never-die-cold/FPGA-Alittle-Design/data/logs/2026-10-09-collaboration-summary/README.md

# 2026-10-09 分模块协作记录来源与分支转移证据

- Codex来源：VS Code会话 `01a0bf1a-b25d-7093-a8ac-23aaf2c22a47`，项目cwd为本WSL仓库；当日模型元数据为gpt-6.1-sol。
- OpenCode来源：只读查询Windows `opencode.db` 的project／session／message／part，仅选择本项目会话，不复制数据库或auth。
- OpenCode原会话最后更新2026-10-06T12:36:33.449Z；[10条文本摘录](opencode-project-session.json)是Git使用讨论，不是本日RTL实现。
- [Codex理解题完整原答](codex-understanding-answers.json)包含已纠正的旧答；最终判定以SoC协作记录为准。
- 两份摘录的SHA256位于同名 `.sha256`；指纹针对归档文本，不承诺仍在更新的原始数据库／会话文件不变。
- [转移前状态](pre-switch-status.txt)、[读取HEAD](pre-switch-head.txt)、[WIP内容指纹](wip-file-hashes.json)、[恢复核对](branch-transfer.log)：191个原WIP文件恢复一致。
- 分支操作：stash -u→switch已有dev/rtl→merge --ff-only main→stash apply；main未改，未新建分支。
- 本地dev/rtl携带main已合入团队历史；原收口报告的main／未提交描述为前一阶段历史快照，不冒充当前分支状态。
- 本次用户另行授权本地提交代码＋记录；不自动push，上传见[指南](../../../docs/upload-rtl-code-and-logs.md)。
- 审核／验证结果追加到此目录；本次新增内容为文档与来源记录，未改变此前验证的RTL／tb／hex。
- [暂存区首次检查](staged-whitespace-first-check.json)发现两份raw diff空白上下文；[改名映射](diff-archive-renames.json)保留SHA，仅改为已有空白规则支持的.patch，不改.gitattributes或历史内容。
- [提交前验证](pre-commit-validation.json)：44项输入不变、all／arch证据保留、静态编译与语法exit=0、暂存区／工作区diff检查零输出；Windows待验证。
