never-die-cold/FPGA-Alittle-Design/report/llm_log/2026-10-20-cop-sim-driver.md

# 2026-10-20 COP_SIM PS 驱动、服务接入与异常矩阵

## 任务

用户本轮分工：WC 负责把计算能力接到服务和 EXE；先与 JL 对齐“怎么提交、怎么知道完成、
怎么拿结果、出错怎么恢复”；硬件未就绪时用模拟硬件跑通软件流程；确保超时、重复请求、
旧结果、运行失败不会在 UI 上显示成 CHECK_PASS；完成一轮服务+EXE 的展示/保存/追溯。

## 主要决策

1. **不另造协议**：PS 使用档只冻结 C03 §4/§5 的用法，寄存器语义、权限和固件判定
   仍以 C03 与 `cop_work_order.h` 为准；模拟硬件按 J04 读 0 的 VERSION/CAPABILITY/
   ERROR_CODE 建模（OPEN-9），不臆造错误码。
2. **模拟硬件的 seam**：驱动只依赖 `read32/write32` + DMA 面；`CopSim`/`SimDmaPlane`
   只用于离板。真实 `PynqDmaPlane` 故意 `NotImplementedError`，避免把占位实现说成已接入。
3. **安全闸**：结果必须通过 `RESULT_SEQ` 递增、索引窗双读、`FW_DECISION` 复算；
   PS verdict 严格度必须 ≥ 固件，计数必须相等。旧的 sticky 结果、不递增的 seq、
   更宽松的 PS 判定都直接 503，不生成报文。
4. **touch_border 是 PS 侧更严格 gate**：J04 固件 `cop_judge` 不读描述符；PS 仍提交
   border 目标，但在最终判定加 `touches_border`，并把它作为“允许 PS 更严格”的唯一理由。
5. **预启动门本地短路**：`ROI_COUNT=0`（OPEN-11）与 >10 不提交，避免固件只写
   `FW_DECISION` 而不置 DONE 导致的等待歧义；同时把“固件缺完成通知”登记为 JL 阻断项。
6. **重试语义**：服务按 C04 §2.4 草案保留 16 条 `trigger_ref→packet`；EXE 手动失败后
   复用同一 ref，失败期间 `manual_failed` 立即撤旧 PASS，不等 max_age。
7. **追溯链**：`cop_trace.json` 写帧像素哈希 + ROI 字节哈希 + cfg/result seq + FW/PS 判定；
   `round_artifacts` 能验证 capture→trace→ROI 的哈希链，ROI 篡改被拒。

## 证据

- `sim/scripts/run_inspection_python.sh`：19 组，exit 0；
- `sim/scripts/run_cop_sim_round.sh`：一轮 `CHECK_PASS`（1/1/1，3 target，cfg/result seq=1），
  截图、records、packet、trace、ROI 哈希链齐全；
- `data/logs/2026-10-20-cop-sim-round/README.md` 汇总命令、结果、异常矩阵与边界；
- 异常：stale 轮 503 且无 packet；同 ref 重试新 check 但只记一条；重复 ref 同 check；
  超时/CRC/ABORT/软复位/重复 JOB_ID 均 PASS。

## K1/K2 拉取与对齐（同日）

- 拉取 JL `5d2f867`（K1 `docs/coprocessor-wc-interface.md`、K2 `docs/coprocessor-storage-plan.md`），
  合并为 `f540a38`；K1 是 C03 摘录，K2 是 PLAN/UNVERIFIED，不改 WC 数据面接口。
- 按 K1/C03 §3.2 修正：正常轮 PS **不写 `CTRL`**，成功 DONE/RESULT_VALID 留给固件下一轮
  START 前清；PS 只在 ERROR/TIMEOUT/ABORT/进程重启遗留终态时写 `CTRL=0x18`。
- `PynqMmio` 移除 `0x8001_0000` 默认值，强制 Address Editor 的 PS AXI base（K1 mock 约束）。
- 补“旧 DONE 还在”的竞态：终态轮询只接受 `RESULT_SEQ` 已变化的 DONE；旧 DONE 持续
  超过宽限即报错，不把上一轮结果贴到新 bbox。
- 新增测试：正常第二笔任务无 `CTRL` 写；PynqMmio 缺 base 拒绝。两套 gate 仍为 exit 0。
- 两项待 JL 确认：K1 的 `CFG_APPLIED && READY` 窗口（PS 以 `CFG_APPLIED` 为硬回执）；
  “消费后 RISC-V 清 DONE”缺少 PS→FW 消费回执（当前固件在下一轮 START 前清）。

## 2026-10-21 拉取 JL A1/A2 并实现

- 合并 `origin/dev/riscv` `4a57ef4`（C03 §14 A1/A2、K1 新版、固件回执看门狗、K3 BRAM），
  合并提交 `17427ce`。
- A1：READY=`!BUSY` 仅建议；配置回执只认 `CFG_APPLIED`。A2：`CTRL[6]=CONSUME`、
  `STATUS[11]=ACCEPTED`、`[12]=UNCONSUMED`；终态互斥；`RESULT_SEQ` 每轮 +1；
  PS 两个软件看门狗（NO_ACK/HW_TIMEOUT）；落盘成功后才 CONSUME。
- 实现：sim 重写 ACCEPTED/UNCONSUMED/CONSUME/ERROR_CODE；driver 增加 ACCEPTED 等待、
  CONSUME、期望序号、STALE_RESULT；engine 在服务落盘后 `consume()` 并把 consume
  状态写回 trace；service 在 packet/latest 写成功后调用 consume。
- 验证：inspection 19 组、vision 21 组 exit 0；`decision_ab` T1–T7、`cop_top`、
  `bram_network` exit 0；新证据 `data/logs/2026-10-21-cop-a2-round/`。
- 发现：本机 MSYS 无 host `gcc`，`run_coprocessor_iverilog.sh firmware` 的主机规则测试
  无法执行（RISC-V ELF 构建成功）；A2 改了 `cop_job.c` 但 `cop_job.hex/dis` 仍是旧产物，
  需 JL 重建。固件重复作业/预启动完成通知仍是阻断项。

## 2026-10-21 board-gate 同步（K4/K5 + 固件 E2E）

- 合并 `origin/dev/riscv` `af53fe2`（合并 `d677c7a`）：K4 Vivado 门禁/检查清单、K5 NC 打包/
  交接、固件 E2E、`cop_job.hex` 按 A2 重建、K3 BRAM 延迟边界、工具链/Python 路径修复。
- 修正 `PynqMmio`：PYNQ `MMIO(base, len)` 的 read/write 参数是相对 offset，不再二次加 base；
  新增 `probe(transport)` / `CopDriver.probe()` 与 `sim/scripts/cop_board_preflight.py`
  只读板上预检；新增 `test_pynq_transport_round` 证明基址/offset 接缝。
- 验证：inspection 19、vision 21 exit 0；`firmware_e2e`、`decision_ab`(T1–T7)、`cop_top`、
  `bram_network`(K3-LATENCY) 均 exit 0；证据 `data/logs/2026-10-21-board-gate-sync/`。
- 仍缺：host gcc（firmware 主机规则测试未跑）、Vivado 40MHz/bitstream、物理 bank/结果 DMA、
  板上预检执行；数据面 `PynqDmaPlane` 仍故意未实现。

## 2026-10-22 board-top 同步（整机门禁/bit/hwh/NC 包）

- 合并 `origin/dev/riscv` `7c6cc40`（合并 `a315537`）：production PL top、AXI-Lite CDC、
  AXIS FIFO、payload adapter、shadow bank、16 ROI slots、manifest v1、Windows 整机
  40 MHz 门禁 PASS、bit/hwh 与 NC 包（`dist/cop-board-gate-f856d5861db0`，未入库）。
- WC 两套门禁仍 19/21 exit 0；新 JL 离板门禁复跑：
  `payload_adapter`/`activation_storage`/`axis_fifo_random`/`firmware_e2e` PASS；
  `manifest_v1`/`payload_network` 在 Windows 因 manifest CRLF/sidecar LF 哈希失败；
  `pynq_top`/`axi_lite_cdc` 在 Icarus 13 因 `w_ack/r_ack` 先用后声明失败。
- 未改 JL 的 `src/coprocessor/`、`src/riscv/`、`sim/coprocessor/` 文件；在
  `data/logs/2026-10-22-board-top-sync/` 留了原始日志、哈希对比和建议修复。
- 板上仍 UNVERIFIED：bit/hwh 已备但 NC 未下载；WC 的只读预检与数据面替换仍等实板/J08。

## 2026-10-23 跨平台门禁修复复验

- 合并 `origin/dev/riscv` `94af6f6`（合并 `a87610c`）：`23e8aef` 把 manifest 改为
  `write_bytes`、CDC 声明前移；NC 包从 `21c4e75` 重打（bit `7e1e3430…`）。
- 复跑 `manifest_v1/payload_adapter/payload_network/activation_storage/pynq_top/
  axi_lite_cdc/axis_fifo_random/firmware_e2e` → **8/8 exit 0**；WC 19/21 exit 0。
- 证据 `data/logs/2026-10-23-cross-platform-fix-verify/`；上轮两个缺口关闭。
- 本机仍无交接 tar 与板卡；board bring-up 仍 BLOCKED，硬件清单写进该记录。

## 2026-10-23 首次上板（包已到）

- 包 `cop-board-gate-21c4e751bbe8`：tar `d74189…e76046`、106/106、bit `7e1e3430…aa0b6c`、
  hwh `cba4d12c…d799d`；`VERSION` 与 EXPECTED 相符。
- JTAG（`xc7z020_1`）`PROGRAM PASSED` 两次；HWH 确认 `0x40000000=pl/S_AXI`。
- 只读预检：`IP_ID=0x434F5030`、`STATUS=0x1`（每组新命令首读偶发 `0x0`）、
  `ERROR_CODE=0`、`RESULT_SEQ=0`、无 UNCONSUMED；XADC 约 53.5–53.8 °C。
- 首次烧写后未复位就读 AXI，命令不返回、串口无响应；用 `xsdb rst -system` 恢复，
  重新 boot 后烧写再预检才成功。
- 关键阻塞：板卡 boot FSBL 给 **FCLK1=142.857 MHz**（设计门禁 40 MHz），JTAG 不应用
  bitstream 内 PS7 配置；包内无 PS payload/ROI loader，`PynqDmaPlane` 未实现。
  因此只有只读预检，没有 pattern/zero 推理，`BOARD=UNVERIFIED`。
- 证据：`data/logs/2026-10-23-board-bringup/`。

## 明确未做

- 未上板；未验证真实 MMIO/AXI/DataMover/CDC；未实现 `PynqDmaPlane`；
- 未使用正式 INT8 模型；`S_input=1/127` 是 sim-only，分类器为脚本/图像派生；
- 固件重复作业与预启动完成通知仍缺（JL 阻断项）；
- 真实 UVC/HDMI、整机时序/bitstream、PYNQ 服务部署仍由 NC/JL 接手。
