never-die-cold/FPGA-Alittle-Design/report/llm_log/2026-10-12-source-return-and-real-frame.md

# 2026-10-12 断源恢复与真实原图软件诊断

用户要求继续，保持“本次仅测试，距离/背景/光照不作最终标准”的约束。开工核对 workflow、主计划、核计划/契约、返场清单和 `dev/model@3e2e1c9`。保留原有改动，不修改代码、提交或推送；新增范围仅 data/logs 与本记录。

树莓派 SSH 可达但无免交互凭据。用户在自己 PowerShell 私密登录，代理先启动 PYNQ watch 并确认 VIDEO_OK 后，用户执行 Pi 的 sudo reboot，采集卡/HDMI 保持连接。监视记录两次断源与恢复，最后应答恢复至窗口结束，240.4 秒正常退出；PYNQ boot_id 未变，UVC 真画面恢复。Pi 自身 boot_id/服务日志未读取，不推断第二次短断源原因。完整原始结果见 [N02 本例](../../data/logs/2026-10-12-source-recovery-prep/README.md)。

等待用户登录期间，对前轮已经双哈希确认的四件测试原图运行现有 inspection_run 与文件回放。定位产生 36 候选、触发 target_limit，RECHECK，actual=null，没有执行分类推理。保存候选坐标和离线原型回放，不放宽上限、不改变阈值凑结果。四角背景估计对当前木纹/角落物体的适配仍须对照验证。见 [真实图失败证据](../../data/logs/2026-10-12-real-frame-prototype/README.md)。

后续恢复图已更换零件布局，与四件软件测试图分别保留。没有冻结采集参数、写正式数据或报告分类精度。完整 N02/N03、冷启动、物理拔插、真实定位/模型精度仍未验收；安全 custom DDR、CNN、核工业固件和真实 LIVE 闭环仍未实现/未接入。
