never-die-cold/FPGA-Alittle-Design/report/llm_log/2026-09-20-board-arrival-doc-sync.md

# [2026-09-20] 协作记录：PYNQ-Z2 到货并上板验证通过——全库"顺延"标记解除与共用板约定

> 标签：#hardware #仓库合规 #文档
> 平台：OpenCode ｜ 模型：opencode-go/deepseek-v4.1-flash
> 相关 commit：本条记录本身
> 用途：issue #1 闭环后的全库状态扫描与同步；全队共用 1 块板的排期约定；上板时钟方案新缺口记录

## 1. 任务与初始提示词

> "我们现在板子全部到货了，有什么事可以上板子去做的呢"
> "大家共用一块板子。这个issue可以去掉了，到货并上板验证完毕"

背景：issue #1（PYNQ-Z2 板子落实与到货跟踪）此前已 closed，但验收项与全库多处"顺延"标记仍停留在"等板"口径；板卡到货且上板验证完毕后需要一次全库状态同步。

## 2. 模型第一版方案

先盘点板卡到位解锁的上板任务（PYNQ 启动验证 / JTAG LED 冒烟 / HDMI base overlay 排雷 / v0 核上板冒烟 / ARM 软件基线 / pynq_host 骨架），并按优先级给到三人分工建议；同时追问板卡数量与 `board/` 归属。

## 3. 失败现象（真实偏差）

无仿真/上板失败——本条为阻塞解除类记录。但全库扫描发现 **7 处文档仍写"未到货 / 顺延（issue #1）"**，与实况不符：

| 文件 | 残留表述 |
|:---|:---|
| `src/riscv/plan.md` | §1.3 "上板类任务全部顺延"、§3.2 "⏸ 上板项待板卡到货回补"、§3.6 9/19 行、§4.1 验收与依赖 |
| `docs/prep_checklist.md` | 唯一🔴项"PYNQ 镜像烧录验证"未勾 |
| `docs/tasks/rtl_libjiang.md` | 状态图例含"⏸ 顺延"、SoC 外壳行 |
| `src/riscv/design_v0.md` | §10 "最小 SoC 外壳 + 上板（待 PYNQ-Z2 到货）" |
| `sim/README.md` | `soc_top` 观察点"空壳，待 PYNQ-Z2" |
| `docs/repo_structure.md` | `board/` 现状"到货前无实物" |
| `docs/resources.md` | §10 野火节"等板"状态、10.3 清单未勾 |

若不同步，9/27 出口检查会按旧口径误判，且新队员会以为上板仍被阻塞。

## 4. 纠错轨迹

| 轮次 | 喂回的信息 | 模型诊断 | 修改内容 | 验证结果 |
|:---|:---|:---|:---|:---|
| 1 | "到货并上板验证完毕，issue 可以去掉" | issue #1 已 closed；prep_checklist 唯一🔴项可按验收标准闭环 | 勾选镜像烧录验证项；7 处文件逐一改为"✅ 2026-09-20 到货并验证"口径（历史记录不改写，只加更新指针） | ✅ 全库 grep 无残留"未到货/顺延" |
| 2 | "大家共用一块板子" | 资源稀缺（1 块 3 人）需要显式使用约定，避免撞车；board/ 是约定落库位置 | `board/README.md` 增"板卡信息 + 共用约定"（上板前群内报备时段）；plan.md §1.3/§3.6 注明错峰 | ✅ |
| 3 | （模型自查：板载 PL 时钟 125 MHz vs v0 Fmax 86.8 MHz） | 原 `design_v0.md` §5.8"clk 来自板载晶振"与实际冲突；上板时钟方案是新待拍板项 | `design_v0.md` §10 增待办：MMCM 分频冒烟 或 Part B 提频后按 100 MHz 重测 | 🟡 待团队拍板 |

## 5. 最终结论

- issue #1 验收项（镜像 / 联网 / Jupyter / base overlay / 点灯）全部闭环；全库"等板/顺延"引用已同步，历史 llm_log 只加指针不改写
- 板卡 1 块全队共用：上板前群内报备时段；每次实测按 `board/README.md` 约定留记录（日期 / 接线 / bitstream commit hash / 结果，只追加）
- 上板任务恢复执行：JTAG LED 冒烟 → `soc_top` 上板冒烟（9/27 Part A 顺延项回补）→ HDMI base overlay 排雷；均需先过仿真
- 新待办：上板时钟方案（125 MHz 板载时钟 vs 86.8 MHz 当前 Fmax），写入 `design_v0.md` §10 待拍板

> 2026-09-20 补充：SD 卡烧录完毕，已建立校园网 SSH 远程访问（`ssh xilinx@10.50.216.93`，22 端口连通性实测可达），同步至 `board/README.md` / `README.md` / `src/pynq_host/README.md` / `docs/prep_checklist.md`

## 6. 经验沉淀

- 触发条件：长期阻塞项（缺件 / issue）解除后，仓库仍残留"顺延 / 等待"表述 #skill候选
- 排查步骤：
  1. 全库 grep 阻塞项编号与关键词（"未到货 / 顺延 / 待 XXX"），逐条判断是否仍成立
  2. 状态类文档（清单 / 排期 / 任务卡）改现状；历史记录（llm_log）只追加更新指针，不改写
  3. 资源稀缺（如 1 块板 3 人共用）时，把使用约定写进资源所属目录（`board/README.md`），不靠口头约定
- 适用范围（换题目 / 换板卡是否成立）：成立；任何"阻塞解除"类事件都适用

---

**审注（2026-10-10）**：文中"v0 Fmax 86.8 MHz / 86.8 MHz 当前 Fmax"均为外推值（非约束通过点），口径见 2026-09-14-vivado-2026-1-acceptance 审注。原文保留不改。
