never-die-cold/FPGA-Alittle-Design/report/llm_log/2026-10-09-exe-export-cjk.md

# 2026-10-09 协作记录：自主推进批次——CSV 记录导出 + 中文渲染能力（字体子集化）

> 标签：#vision #工具链 #skill候选
> 平台：ZCode ｜ 模型：GLM-5.3-Flash
> 相关 commit：本批（dev/exe：export_records + CJK 子集字体 + selftest 中文断言）

## 1. 任务与初始提示词

用户定稿 HUD v4 后指示："现在做不了实测、NC 也不在，你一路推进，把能做到的都做了。"
盘点可行项 → **CSV 记录导出**（M4「记录导出」）与**中文渲染**（M3 类别名/工单判定预置）。

## 2. 实现要点与决策

- CSV：UTF-8-**BOM**（Python csv 默认无 BOM，中文在 Excel 会乱码——显式 `utf-8-sig`）；
  targets 保留 JSON 单列（bbox 数组不适合摊进固定列）；记录文件缺失显式报错。
- CJK 字体：Noto Sans SC 变量字体全量 17.3MB 不适合入库 → **子集化**（fontTools
  pyftsubset）：GB2312 全集（一/二级汉字 6763）+ ASCII + 常用符号（× ≈ ≤ 等），
  17.3MB → **4.0MB**；生成脚本入库（下载源/字符集/命令全可复现，缺字补 EXTRA 重跑）。
- 引擎选字规则：文本含 CJK 码点（> 0x2E7F）→ 整串用 CJK 字体（混合文本如"螺栓 ×3"同字体，
  Noto 自带拉丁字形）；纯拉丁用 Inter。selftest 增加"字体在包内 + 中文渲染"断言
  （等效于每次构建做一次资源打包体检）。

## 3. 失败现象

无运行期失败；设计期拦截两点：① 全量 CJK 字体直入仓库（17MB）→ 子集化；② Excel
中文乱码是导出功能高频坑 → BOM 显式处理并在测试中断言 BOM 字节。

## 4. 纠错轨迹

| 轮次 | 喂回的信息 | 诊断 | 修改 | 验证 |
|:---|:---|:---|:---|:---|
| 1 | 全量字体 17.3MB | 仓库/打包体积不可接受 | pyftsubset 子集化至 4.0MB + 生成脚本入库 | ✅ 渲染样本无缺字（5 组中文文本） |
| 2 | 生成脚本 SyntaxWarning（文档串含 Windows 路径 `\s`） | 非 raw 文档串转义 | 改写避免反斜杠 | ✅ 无告警 |

## 5. 最终结论

CSV 导出（测试 + 真实样本）与中文渲染（引擎 + 子集字体 + 打包断言 + 渲染样本）全部落地；
打包三关 + 回归 **8/8 PASS**；证据 `data/logs/2026-10-09-exe-export-cjk/`。

## 6. 经验沉淀

#skill候选
- **Excel 中文 CSV 必须 UTF-8-BOM**（`utf-8-sig`）；导出功能的测试要断言 BOM 字节。
- **CJK 字体的工程做法是子集化**：按目标字符集（此例 GB2312 全集）裁剪变量字体，体积
  降 4 倍以上；生成脚本入库保证可复现；缺字时补字符重跑即可（可预测的维护路径）。
- 把"资源存在性 + 最小渲染"写进 selftest —— 每次构建自动完成一次打包资源体检，
  比人工核对目录可靠。
