never-die-cold/FPGA-Alittle-Design/docs/contracts/coprocessor-handoff-v0.md

# CNN 协处理器 v0 交接索引

> 2026-10-28 更新：板上验证已推进——10-26 edge-fix/trained 包、10-27 cdc/MMCM 共存包四例黄金、10-28 r6 多目标 12 轮/85 结果逐项一致（见 [plan §3.1](../../plan.md) 与 data/logs/2026-10-28-multitarget-board-r6/）。下文「BOARD UNVERIFIED」为 10-26 时点口径；结果 DMA/连续作业仍未验收。
> 给 JL、WC、NC 查找离板计算链的唯一入口；交接或复现前阅读。  
> 本页只指向权威契约和证据，不复制寄存器表、payload offset 或历史日志正文。

## 当前状态

- J03 离板计算链已收口：诊断整数参考、算子、Conv→GAP→FC 控制器和逐元素 TB 可复现。
- J04a（JL 侧实现/冒烟）已交接：`cop_top`、MMIO/CDC、AXI4-Lite、DMA loader、核接入门和工单固件均有仓库内 TB；J04b：manifest v1→影子 bank、16 ROI 槽与生产板顶（`pynq_cop_top`）已落地，整机 40 MHz 综合实现门禁 PASS；任务描述表、结果 DMA、CDC/AXI 深测收尾与板验未完成。详见[实现交接单](../runbooks/coprocessor-j04-handoff.md)；模块说明见 [src/coprocessor/README.md](../../src/coprocessor/README.md)。
- WC 侧 PS 驱动/模拟硬件/服务引擎已按 C03 §13 落库并跑通离板一轮（mock/脚本分类器，非板上）；提交/完成/取结果/恢复口径与 JL 待办见 [PS 驱动使用档](coprocessor-ps-driver-v0.md)。
- JL K1/K2 已并入；C03 §14 A1/A2（READY=!BUSY、ACCEPTED/UNCONSUMED/CONSUME、终态互斥、RESULT_SEQ 每轮递增、NO_ACK/HW_TIMEOUT 软件看门狗）已同步到 PS 驱动/mock/服务：有效结果落盘后 PS CONSUME，错误/超时读码后消费。固件重复作业与预启动完成通知仍是阻断项。
- JL K4/K5 与固件 E2E 已并入（`af53fe2`）：`firmware_e2e` 用真实 CPU/固件/MMIO 跑通 START→ACCEPTED→终态→结果/PSCONSUME；K3 BRAM 增加延迟边界。Vivado 40 MHz 门禁、bitstream、`.hwh` 与板上仍 UNVERIFIED（af53fe2 时点口径；后续门禁与上板进展见下方 10-22/10-23/10-25 条目）；WC 已加只读板上预检 `sim/scripts/cop_board_preflight.py`，数据面等 J08。
- JL 2026-10-22 board-top（`7c6cc40`）：Windows Vivado 2026.1 整机 40 MHz 门禁 **PASS**（WNS +2.498 ns），bit/hwh 与 NC 包已备；`BOARD` 仍 `UNVERIFIED_NEEDS_NC`。WC 复跑发现 Windows/Icarus 两个可复现性缺口：manifest CRLF/sidecar 哈希、`cop_axi_lite_cdc` 先用后声明；已登记给 JL，未改其 RTL/生成器。详见 [board-top 同步证据](../../data/logs/2026-10-22-board-top-sync/README.md)。
- 2026-10-23 首次上板：包 `21c4e751bbe8` tar/106/bit/hwh 全验，JTAG 烧写 **PROGRAM PASSED**；只读预检 `IP_ID=0x434F5030`、`ERROR_CODE=0`、`RESULT_SEQ=0`、无 UNCONSUMED。**阻塞**：板卡 boot FSBL 给 FCLK1=142.857 MHz（设计 40 MHz），且包内无 payload/ROI loader；未做推理，`BOARD` 仍 UNVERIFIED。详见 [首次上板记录](../../data/logs/2026-10-23-board-bringup/README.md)。
- 2026-10-25 DMA16 上板：新包 `759744b99891`（111/111、bit/hwh/xsa 全对）；**40 MHz 时钟门禁板上 PASS**（`measured_fclk1_mhz=40.000000` + 20 次首读 `0x1`；前提是改钟后重新配置 PL）；loader 预检/DMA 全过但 `NO_ACK`——时间序列证明 **CPU 未执行固件**（疑 IMEM `$readmemh` 相对路径在 Vivado 综合未命中），已交 JL。`BOARD` 仍 UNVERIFIED。详见 [DMA16 上板记录](../../data/logs/2026-10-25-dma16-board/README.md)。
- J05/J06 未完成：没有真实审计 ROI 上的正式 INT8 模型、阈值和发布黄金。
- J07/J08 未完成：J07 视频集成的综合实现与整机回归未做；J08 正式三批交付包未发布。已有核＋协处理器整机门禁位流与包（10-22 board-top；10-26 edge-fix bit `9341F7FA…` 与 trained 包，见 `data/logs/2026-10-26-build/`、`docs/coprocessor-nc-handoff.md`），BOARD 推理与连续作业 UNVERIFIED。

## 权威来源

| 内容 | 唯一来源 |
| --- | --- |
| 网络、整数算术、张量排布、payload | [C02](../../src/coprocessor/design_v0.md) |
| MMIO、状态、DMA、结果与 PS/核分工 | [C03](coprocessor-integration-v0.md) |
| PS 一页纸接口（K1 摘录，非契约） | WC 接口约定（git 历史 88ac1c4 前 docs/coprocessor-wc-interface.md） |
| 片上存储方案（K2 PLAN/UNVERIFIED） | 存储方案要点（git 历史 88ac1c4 前 docs/coprocessor-storage-plan.md） |
| 生产 payload manifest v1（PROVISIONAL） | [coprocessor-manifest-v1](coprocessor-manifest-v1.md) |
| K4 Windows Vivado 门禁清单（UNVERIFIED） | Vivado 检查单（git 历史 88ac1c4 前 docs/coprocessor-vivado-checklist.md） |
| K5 NC 下载/交接与失败恢复 | NC _OFFLINE 交接要点（git 历史 88ac1c4 前 docs/coprocessor-nc-handoff.md） |
| PS 提交/完成/取结果/恢复与 JL 待办 | [PS 驱动使用档](coprocessor-ps-driver-v0.md) |
| 核现役语义与待确认 SoC 回写 | [design_v1 §17](../../src/riscv/design_v1.md) |
| J 状态与收口边界 | 本单「当前状态」与[实现交接单](../runbooks/coprocessor-j04-handoff.md) |
| J04 实现交接与 OPEN-1..12 | [实现交接单](../runbooks/coprocessor-j04-handoff.md) |
| J03 本轮离板复验 | [验收索引](../../data/logs/2026-10-18-j03-closeout/README.md) |
| 10/13 CNN/DDR 历史接口与失败边界 | git 历史（88ac1c4 前）docs/archive/cnn-ddr-offline-handoff-2026-10-13.md |
| 交付签收 | 证据目录逐项核对，未验证项写入交付记录 |

若计划、README 或本页与 C02/C03 冲突，以 C02/C03 为准，并修正文档；不得反向改契约。

## JL 当前可交付给开发的内容

- 现役数据通路：`mac_array_pipeline` → `conv_engine` → `cnn_sequencer`；
- 两组诊断整网逐元素黄金，每组 73,795 个有效元素、472,593 个控制周期；
- 独立 runner、协处理器 `all` 与全仓 `all`；最终夜间复验均退出 0；
- 控制器 OOC 历史证据，但不包含实体 BRAM、DMA、SoC 或视频链。

J04a 控制面已在此基础上完成离板冒烟；J04b 完整验证仍未完成，这批内容仍不是正式模型包、整机包或板端验收包。

## WC 对接边界

- 驱动字段、权限、状态、目标结果和工单语义只按 C03；协议仍按 v1.2 决策单；
- 硬件能力 16 目标，检查 V0 策略最多 10 件；11–16 必须 RECHECK，不截断；
- J04a 寄存器/CDC/DMA/顶层层已离板冒烟，可开始驱动 review；J04b 完整验证、实体 BRAM/SoC/板端未完成，不能把离板 PASS 当硬件联调通过。

## NC 对接边界

- 片上存储需求与 10/13 历史 word 级接口可供规划，但正式 payload 字节数以模型 manifest 为准；
- OOC 正时序不代表完整 SoC 100 MHz；整机 40 MHz 综合实现门禁已 PASS（见本页「当前状态」最新条目与NC _OFFLINE 交接要点（git 历史 88ac1c4 前 docs/coprocessor-nc-handoff.md）），板上整网推理与连续作业 UNVERIFIED；
- J08 顺序保持“算子诊断包 → 首网包 → 整机包”，当前三包均未正式发布。

## 复现入口

```text
bash sim/scripts/run_coprocessor_python.sh manifests
bash sim/scripts/run_coprocessor_python.sh all
bash sim/scripts/run_coprocessor_iverilog.sh all
bash sim/scripts/run_iverilog.sh all
```

Linux 全仓 Python 回归需通过 `VISION_PYTHON`/`COPROCESSOR_PYTHON` 指向包含冻结依赖的解释器。
原始夜间执行、环境失败和最终退出码见[夜间日志](../../report/llm_log/2026-10-18-night-autonomous.md)。

## 下一门槛

J04a 已交接；J04b 的任务描述表/结果 DMA/CDC/AXI 深测收尾/板验、J05/J06 的真实审计 ROI 与正式 INT8 模型/阈值/黄金，以及 J07 视频集成的综合实现与整机回归仍是下一门槛。
