never-die-cold/FPGA-Alittle-Design/data/README.md

# data —— 测试数据、黄金参考与指标汇总

对齐指南 §3.3.5.4：`data/` 承载"测试数据与参考结果"；原顶层 `metrics/` 已于 2026-09-14 并入本目录。

## 内容

- `metrics.csv`：指标汇总表（指标名称 / 类别 / 数值 / 单位 / 测量条件 / 测试次数 / 证据文件）
- `logs/`：原始日志（一次运行一个目录；索引见 [`logs/README.md`](logs/README.md)）
- `scripts/`：可重跑的测试脚本（须可在提交环境中重跑）
- `evidence/`：源码/构建输入快照、bit 溯源、黄金参考（索引见 [`evidence/README.md`](evidence/README.md)）
- 测试图样：随 `golden/` 和相应 `evidence/` 归档；独立 `data/images/` 未建立
- 模型资料：见根目录 `models/` 及训练证据；独立 `data/models/` 未建立，演练不代表正式模型或网络硬件输出
- 结构例外：根目录 `models/`、`results/` 是外包交付拆分入口，并被 `evidence/2026-10-10-fastener-handoff/installed.csv` 的完整性校验引用；不要移动。
- `golden/`：已有核／视觉／定位软件黄金参考与生成入口

## 约定

- 「测量条件」必须写明：硬件型号、模型及数值精度、输入规格、软件版本、FPGA 时钟频率与功耗模式
- 禁止先写目标后凑数据：先测基线，再谈优化；数值与证据文件一一对应
- `metrics.csv` 使用 UTF-8 编码（Excel 打开时选 UTF-8 或走导入）
- 延迟与抖动报告分位数与最大值；吞吐采用持续运行结果，不用瞬时峰值
- 大文件（模型权重、视频）用下载脚本替代直接入库；报告中所有数据必须能追溯到本目录原始文件
- 演示级指标（直通对比/端到端帧延迟/动效帧率）随演示脚本一次采集，不单开测试轮次

> 模块一核＋最小 SoC 已完成收口，见[核报告](../report/module1-closure.md)；模块二 RTL＋已验证视频链路已完成（RTL／链路级），见[视频](logs/2026-10-03-vision-onboard/README.md)、[相机](logs/2026-10-07-pi-pynq/README.md)。全项目 M2 未完成。
> metrics 已有数值与证据；旧 25% FAIL／8.14%／失败 WNS 继续保留。本轮文档整理不改历史指标；仿真复跑日志另存 `logs/2026-10-09-module1-2-closeout/`，不新增硬件测量行。
