never-die-cold/FPGA-Alittle-Design/sim/README.md

# sim —— 仿真脚本与结果

各模块 testbench、仿真脚本与波形结果。**所有 RTL 模块必须先过仿真再上板。**

> 当前（2026-10-09）：模块一核＋最小 SoC 已完成收口，见[模块一报告](../report/module1-closure.md)。
> 模块二 HDMI RTL＋已验证视频链路已完成（RTL／链路级），见[视频证据](../data/logs/2026-10-03-vision-onboard/README.md)
> 与[真实相机链路](../data/logs/2026-10-07-pi-pynq/README.md)；全项目 M2 未完成。
> 原验收使用 Icarus 13.0；本轮本机为 11.0。XSim/Vivado 结论仅引用历史证据，本机不能复跑。

## 当前一键入口（同 RTL／tb／hex，只切参数）

```bash
bash sim/scripts/run_iverilog.sh all
bash sim/scripts/run_iverilog.sh v1_nofwd
bash sim/scripts/run_iverilog.sh v1_fwd
bash sim/scripts/run_iverilog.sh v1_fwd_bht1
bash sim/scripts/run_iverilog.sh v1_fwd_bht2
bash sim/scripts/run_arch_test_matrix.sh
```

四档默认负载为 CoreMark；benchmark、单元和边界专项由 `all` 纳入，完整入口见脚本。
arch 矩阵独立编译 11 项声明子集×4 档，不纳入源码 tb 的 `all`，也不代表上游全套认证。
v1 判据以[design_v1.md](../src/riscv/design_v1.md)为准；下方 v0 观察表和早期记录仅供历史对照。

## 规划结构

```
sim/
├── riscv/           # RISC-V 核各级、整核与 SoC 外壳 testbench
├── coprocessor/     # 协处理器 testbench
├── vision/          # 预处理流水线 testbench（含测试图样生成）
├── scripts/         # Icarus/XSim/arch-test/OOC 批处理入口
└── tools/           # 辅助工具（RV32I 编解码自测等）
```

辅助工具用法：`python sim/tools/verify_rv32i.py`（阶段 0 指令编码自测：22 组汇编→机器码 + 10 组反汇编双向校验，输出 `ALL OK` 即通过）

## 仿真工具（双工具复核对拍，2026-09-14 更新）

- **主力回归**：Icarus Verilog 13.0（MSYS2 ucrt64 包 `mingw-w64-ucrt-x86_64-iverilog`）——一键跑全部 tb
- **XSim 复核**（Vivado 2026.1 已装，issue #2）：同一套 tb 已复核对拍，**两工具结论一致**（2026-09-14；`xvlog → xelab → xsim -R`，从 `sim/` 目录运行以保证 `$readmemh` 相对路径正确）
- 用法（MSYS2 UCRT64 shell 中，产物在 `sim/build/`）：
  - 一键跑全部：`bash sim/scripts/run_iverilog.sh all`（含 CoreMark，约 2,100 万周期）；单档另含 `soc` / `soc_check` / `bench` / `coremark`
  - `tb_core_smoke.v`：加载 `src/riscv_fw/hello_v0.hex`，检查 `tohost==13 && tohost_exit==0`（程序级冒烟）
  - `tb_core_test.v`：加载 `src/riscv_fw/hello_test.hex`，检查 `tohost_exit==0`（RV32I 逐指令自检 38 用例；失败值为用例编号）
  - `tb_core_fwd.v`：加载 `riscv/fwd/fwd_test.hex`（转发专项，Part B 测试先行）——数据冒险零气泡 + taken 分支 1 拍契约，气泡/结果双自检
- v0 历史接口以 [`design_v0.md`](../src/riscv/design_v0.md) 为准；当前 v1 使用 [`design_v1.md`](../src/riscv/design_v1.md)

> 当前状态：v0 核（RV32I）两个 tb 均 PASS（2026-09-11 iverilog；2026-09-14 XSim 复核对拍一致），见 `report/llm_log/2026-09-14-vivado-2026-1-acceptance.md`

## v0 八模块验证观察点（仿真时看什么、怎么判对错）

**历史表适用边界**：下面 NOP 数据要求、load 当拍写回和气泡数是 v0 判据。
当前 v1 flush 只清 valid（不要求 instr=NOP）；load 在 MEM+WB 写回、load-use 停 1 拍；
BHT 正确预测零冲刷、误预测或 JAL/JALR 冲刷 1 槽。当前 SoC 实机证据见[模块一报告 §6](../report/module1-closure.md)。

> 这是给写 testbench 的人用的「看对错清单」：每个模块在仿真里**要看什么、什么算对、什么算错**。
> 判据以 [`src/riscv/design_v0.md`](../src/riscv/design_v0.md) 为唯一权威；已有整核级及 imem/dmem/muldiv 模块级 tb。
> `soc_top` 已接入 32KB IMEM/DMEM 双预载、计时计数器和 LED；`tb_soc_top` 与 `tb_soc_check` 分别覆盖复位重跑/分层检查和真实固件端到端路径。

| 模块 | 出处 | 观察点（看什么、怎么判对错） | 现有覆盖 |
|:---|:---|:---|:---|
| `pc` | §5.1 | 复位后 PC 从 `0x8000_0000` 起步；没跳转时每拍 +4，跳转时下一拍变成目标地址；`stall=1` 时即使来了跳转 PC 也保持不动。**判错**：跳转后停着不走，或一次跳两格（+8） | 整核 tb 间接覆盖 |
| `if_stage` | §5.2 | 复位后第一拍只输出空指令（`instr=NOP`）且 `instr_valid=0`，保证第一条指令不被执行两次；分支/跳转生效后，下一拍必须**恰好是 1 拍 NOP**——这就是从波形数气泡的锚点。**判错**：气泡 0 拍或 2 拍 | 整核 tb 间接覆盖 |
| `decode` | §5.3 / §6 | 拿各类代表指令对照真值表逐条查控制信号；重点：B/J 型立即数最低位有没有补 0、`lui` 时 ALU 的 a 端是不是固定为 0、`jal/jalr` 写回的是不是 PC+4、load 的符号/零扩展对不对、`fence/ecall/ebreak` 这类系统指令有没有被当 NOP。**判错**：`funct7[5]` 区分不出 ADD/SUB 或 SRL/SRA。RV32M 译码按 `funct3` 输出 3 位 `muldiv_op` | 整核 tb + `tb_muldiv` |
| `regfile` | §5.4 | 往 `x0` 写东西再读出来必须还是 0；寄存器堆是「组合读、时钟沿写」，所以一条指令在拍末写回，下一条紧跟着的指令当拍就能读到新值——这正是 v0 没有数据停顿的原因。注意：同一拍写读同一个寄存器读到的是旧值；寄存器没有复位，上电是未知值 X，测试程序必须先写后读 | 整核 tb 间接覆盖 |
| `alu` | §5.5 / §6.1 | 每种运算抽边界值查：负数的算术右移（SRA）、有符号与无符号比较（SLT vs SLTU）、移位只认 b 的低 5 位。`zero/lt/ltu` 三个标志由 a、b 直接比较得出，和结果同拍。**判错**：没定义的运算编码会被当 ADD 处理，而不是报错 | 整核 tb 间接覆盖 |
| `muldiv` | §5.6 | 8 种 RV32M 运算及除零、`INT_MIN/-1` 边界；检查 `start/busy/done` 握手、忙时停顿、完成拍单次写回 | `tb_muldiv` 模块级 + `tb_core_muldiv` 整核级 PASS |
| `core_top` | §5.7 / §2 | 第 k 拍给出的指令地址，第 k+1 拍才拿到对应指令（指令存储器延迟恰好 1 拍）；分支目标是「本指令的 PC + 立即数」；`jal/jalr` 无条件跳转、每次都**恰好 1 拍气泡**；`jalr` 目标地址末位清 0；`lw` 当拍就能写回、字节使能只在写的时候有效。**判错**：跳转没清气泡、`jalr` 末位没清、`lw` 多等一拍 | `tb_core_smoke` / `tb_core_test` / `tb_core_muldiv` / `tb_core_coremark` |
| `soc_top` | §5.8 | hex 双预载、同步 IMEM、异步读/字节写 DMEM、计时器读写屏蔽、软复位重跑与 LED | `tb_soc_top` + `tb_soc_check`；现行 BHT2/40 MHz 上板证据见上方报告 |

> `muldiv` 的接口缺口（`op` 只有 2 位、装不下 RV32IM 的 8 种运算等）详见 [`report/llm_log/2026-09-15-muldiv-interface-gap.md`](../report/llm_log/2026-09-15-muldiv-interface-gap.md)。

## 转发专项测试（Part B 测试先行，2026-09-20 建立）

- 被测程序：`riscv/fwd/fwd_test.S`（生成 `fwd_test.hex/.dis` 入库）；构建：`bash sim/scripts/build_fwd.sh`
- 判据（v0 对照档）：阶段 A（R 型连读）气泡 0、阶段 B（lw→运算）气泡 0、阶段 C（taken 分支/跳转）气泡 = 5、阶段 D（not-taken 分支）气泡 0；各阶段结果与期望常数逐一比对
- v1 接入：用 `+exp_a/+exp_b/+exp_c/+exp_d` 覆盖期望（如 v1 无预测档 `+exp_b=4`），机制演示见 `data/logs/2026-09-20-fwd-baseline/plusarg_override_demo.log`
- 证据与对照数据：`data/logs/2026-09-20-fwd-baseline/`；口径决策：`report/llm_log/2026-09-20-v0-no-stall-cpi-reframe.md`

## riscv-arch-test 接入（第三方「优化不改语义」判据，2026-09-20 建立）

- 套件：`riscv-non-isa/riscv-arch-test` `old-framework-2.x`（自带 `references/*.reference_output` 参考签名）；获取：`bash sim/scripts/fetch_arch_test.sh`（克隆到 `sim/arch_test/suite/`，不入库）
- 目标配置：`sim/arch_test/target/pynq_z2_v0/`（`model_test.h` + `env/link.ld` + 框架 Makefile 配置），编译经套件的 `make` 流程驱动
- 跑法：`bash sim/scripts/run_arch_test.sh <测试名>`（默认 `add-01`）——编译 → 统一镜像双预载 → 逐字签名比对 → PASS/FAIL；签名输出兼容框架 `make verify` 的文件约定
- 已纳入回归：`add-01` / `addi-01` / `and-01` 全 PASS；证据与边界：`data/logs/2026-09-20-arch-test/`
- 说明：arch-test 需要 ELF 编译流程，不并入 `run_iverilog.sh`（后者只跑源码级 tb）

## CoreMark 基准 tb（契约先行，2026-09-23 建立）

- 契约（判据/观测/接口唯一入口）：[`docs/contracts/coremark.md`](../docs/contracts/coremark.md)（§1–§7 契约主体 + 附录 A 计划；SoC 计时器与预载已于 2026-09-28 收口）
- 通用 tb：`riscv/tb_core_coremark.v`——8192×32 存储模型 + plusargs；`+hex` 默认 `../src/riscv_fw/coremark.hex`，支持 `+timer_addr` 计数器仿真
- 历史 v0：32 迭代 CoreMark/MHz=1.506，见 `data/logs/2026-09-23-coremark/`；当前 tb 按 `mem_valid` 退休，窗口止于首次 `tohost_exit`，四档 CRC/retired 与周期证据见[模块一报告 §2](../report/module1-closure.md)。
- 单档复跑：`bash sim/scripts/run_iverilog.sh coremark`（固定 2K/32 迭代、50M 看门狗与 golden 判据；约 2,100 万周期）
- 全档回归：`bash sim/scripts/run_iverilog.sh all`（同样含 CoreMark 长测）
- 记录：tb 落地 `report/llm_log/2026-09-23-coremark-tb.md`；契约起草 `report/llm_log/2026-09-23-coremark-tb-contract.md`

## SoC 收口与 benchmark v0.1（2026-09-28）

- `soc`：首跑 `tohost=13`/LED=`1101`，软复位后重跑 `tohost=65`/LED=`0001`，并检查计时器清零、递增和写屏蔽。
- `soc_check`：真实 RV32I 固件验证非零 `.data` 预载、计时器 `lw/sw` 路径及 DMEM[0] 不被别名写污染。
- `bench`：固定种子整数混合负载，golden checksum `0x1385CBD1`；`data/scripts/cpi_harness.py` 从日志提取 CPI。

## 约定

- 每个 testbench 输出 PASS/FAIL 自检结果，禁止只靠肉眼看波形
- 关键波形截图归档到 `report/`，供设计报告引用
- 黄金参考数据放 `data/`，仿真比对脚本引用相对路径

> 上述 9 月单项数据是历史基线；当前核与最小 SoC 收口见[模块一报告](../report/module1-closure.md)，CNN／工业应用仍未完成。
