never-die-cold/FPGA-Alittle-Design/src/vision/README.md

# 模块二：彩色视频直通与分析快照

正式目标为 PYNQ-Z2、1280×720@60、RGB888；224×224 是模块三输入的占位尺寸。
当前接口见 [design_v0.md](design_v0.md)，离板证据见
[本轮记录](../../data/logs/2026-10-02-vision-offboard/README.md)。

模块二 HDMI 视觉预处理 RTL＋已验证视频链路已完成（RTL／链路级），见[10/03 视频](../../data/logs/2026-10-03-vision-onboard/README.md)
和[10/07 真实相机恢复](../../data/logs/2026-10-07-pi-pynq/README.md)；全项目 M2 尚缺网络硬件输出，CNN／工业闭环未完成。

```text
HDMI IN → dvi2rgb → 彩色原图直通 → rgb2dvi → HDMI OUT → USB 采集卡 → 网页端
                   └→ 归一化 → 灰度 → 高斯/边缘 → 缩放 → 双帧缓冲 → cop_* / 调试 ILA
PS AXI-Lite → 暂存参数 → R11 提交 → 帧首整组生效 → R12 配置号确认
```

PYNQ-Z2 HDMI 直接连 PL，没有 ADV7611。物理工程固定 Digilent IP 提交
`f4613fff005b098065fd5d619a2b88e55720a423`，官方 PYNQ v3.0.1 引脚和 PS 配置经 SHA256 核对。
Digilent 并行视频字节顺序是 R,B,G，`vision_axi.v` 双向转换为内部 R,G,B。

## 已实现与验证

- 原 22 个 RTL tb 有 Icarus／XSim 同判据记录；增加 `tb_axi_lock_reset` 和两个 capture tb 后当前为25个，见[整合回归](../../data/logs/2026-10-12-pr-review/README.md)。历史视频 tb 含真实 720p 两帧，
  1,843,200 显示像素、100,352 快照像素、448 行及帧/配置号精确核对。
- AXI AW/W 独立握手、响应反压；整组配置请求/确认；不同频率时钟测试。
- 显示 RGB/原始同步波形恒延迟直通；分析使用内部单拍行尾/帧首标记。
- 双帧缓冲争用修复：读启动与写完成同拍也保护读银行；拥塞、覆盖、排空、复位测试。
- Sobel 增加一级流水；单元首像素延迟 gray=1、gauss=25、gray+sobel=26、gauss+sobel=50 拍。
  灰度诊断口延迟不能当作彩色 HDMI 延迟。
- `video_pipeline` 内部 post-route：WNS +0.330 ns / WHS +0.027 ns，像素周期13.468ns、
  AXI周期10ns；1985 LUT、1515 寄存器、38 BRAM tile、0 DSP。
- PS 配置绑定、定位/逐目标裁剪黄金参考；MOCK 与 FILE/LIVE HTTP 骨架、Windows LIVE 展示和记录已离板验证，替身/FILE 恒标来源。
- C01 增加原彩色捕获支路与状态监测，候选 bit/hwh/XSA、显示/状态实机诊断已有；DDR BGR 完整副本与帧槽所有权尚未实现/验收，见[C01 基线](../../docs/contracts/c01-capture-implementation-baseline.md)。

## 一键入口

在仓库根目录、MSYS2 UCRT64 shell 中运行：

```bash
bash sim/scripts/run_iverilog.sh all          # 核、CoreMark、门禁、视觉、Python 检查
bash sim/scripts/run_iverilog.sh vision all   # 当前25个视觉tb
bash sim/scripts/run_iverilog.sh vision_python
bash sim/scripts/run_vision_xsim.sh all
bash sim/scripts/run_vivado_vision_impl.sh    # 并行边界 OOC 布线
bash sim/scripts/fetch_hdmi_ip.sh             # 固定第三方源，首次需要网络
bash sim/scripts/run_vivado_hdmi.sh           # 全物理 HDMI 工程，离板生成 bitstream
```

`VISION_PYTHON` 可指定 Python 路径；`VISION_VIVADO_BIN` 可指定 Vivado bin 目录。
默认 Vivado 路径为 `/d/Vivado_downloads/2026.1/Vivado/bin`。
物理输出在 `sim/build/hdmi-project/`；脚本不会打开 Hardware Manager 或下载板卡。
网页端见 [src/web_client](../web_client/README.md)；记录/CSV 参考实现在 `src/pynq_host/`（`records.py`、`export_records.py`）。

## 验收边界

内部 OOC 正余量不证明 TMDS 引脚、电缆、相机和采集卡闭环。全物理工程状态与余量
以本轮证据记录为准，不能沿用历史综合值。

上板实测（2026-10-03，证据 [../../data/logs/2026-10-03-vision-onboard/README.md](../../data/logs/2026-10-03-vision-onboard/README.md)）：
实机 bit 下载、真实源锁定（笔记本 720p）、HDMI OUT→采集卡闭环彩色直通（色彩无
通道错乱）、PS 真实 MMIO 原子配置（65 次 commit 全帧首确认）、经采集卡端到端
延迟上界 125 ms（含采集卡缓冲，不计指标口径）经真实采集卡源验证——**已成立**。

断连实测暴露并修复一个真 bug：`video_locked` 曾连带复位 AXI 从机，源断开瞬间
PS 总线挂死（串口/网口同死）。修复为双复位拓扑（axi_rst_n 只随 s_axi_aresetn，
见 design_v0 §vision_axi 条目），tb_axi_lock_reset 定向覆盖，全量回归 48 PASS，
重建 bit 布线后 WNS +0.956。**该次修复配置的拔插复测已过**（[记录](../../data/logs/2026-10-03-vision-onboard/README.md)）：NO_VIDEO 干净检测 → pending
提交恢复后首帧应用 → 全程串口/网口在线零挂死。后续真实相机画面已有[10/07 证据](../../data/logs/2026-10-07-pi-pynq/README.md)；
不能写成相机从未验证。EDID 换源、DDR 对照与现用位流长期复验仍待补。

版本边界：10/06–10/07 记录的位流差异是历史事实；10/10 已把原板端 bit/hwh 与归档 XSA 配对，但未锚定构建源码，见[追溯记录](../../data/evidence/2026-10-10-onboard-bit-provenance/README.md)。C01 候选是另一套产物，不能混用验收结果。

灰度 `out_*` 的 OSD 是诊断能力；HDMI 主显示保留彩色原图。前端模拟框不是物体检测；
单独 UVC 预览标为 `UNASSOCIATED`；[轮次协议](../../docs/contracts/vision-sync-protocol-decisions.md) v1.2 支持 MOCK/LIVE，FILE/LIVE 原型恒标 PROTOTYPE，按年龄窗叠加不代表逐帧精确关联或硬件分类。

未实现 / 未接入：正式 INT8 模型与生产黄金、真实识别结果与采集卡画面关联、整机验收；实时全链（真实取帧定位误检）未闭环。
已接入：C01 原帧捕获 + PS 定位/ROI + 硬件 CNN（`cop_product_service`，10/27 真实帧，RECHECK 为实际判定）。整帧快照不代表逐目标硬件裁剪已经完成。
