never-die-cold/FPGA-Alittle-Design/data/logs/2026-10-08-exe-ui-design/README.md

# EXE HUD 设计提案（2026-10-08，草案待评审，未提交）

用户反馈：现有界面美观不足（比赛场景，第一印象重要）；方向 = 科技感 + 贴合工业检查实际
+ 关键信息醒目 + 不花哨（矫枉过正）。

## 调研结论（两路来源一致）

- **NASA HUD 军标 declutter 原则**："没有一个像素可以白亮——每个元素必须证明它值得出现在
  屏幕上"；关键信息大而持续，装饰性内容一律砍掉（正对应"不要花里胡哨"）。
- **硬科幻视觉设计参考**点名批评"小黑条 + 绿色等宽字体 + 孤立数字"的默认公式——正是现状
  （01_current.png）；推荐角括号、一致的字体层级（1 字体 × 3 号）、受控调色板。
- **工业视觉检测 UI 行业惯例**（多家检测软件界面拆解）：深色底 + 青/蓝主色 + 绿 OK / 红 NG；
  大字号适合远观；运行时界面少文字、高对比。
- **冗余编码**：关键状态不能只靠颜色（色差/色盲），需"颜色 + 形状 + 文字"多通道。

## 三张图（py render_ui_mockups.py 生成，1280×720）

| 文件 | 内容 |
|:---|:---|
| `01_current.png` | 现状（对照）：黑条一行字 + 实线绿框 + 小字 |
| `02_proposal_ok.png` | 提案-结果有效：徽标 + 四格指标面板 + 角括号框 |
| `03_proposal_waiting.png` | 提案-等待/过期：琥珀状态 + 红色新鲜度条 + 数值置 "--" |

## 设计要点

1. **模式徽标（左上，实心琥珀"MOCK ONLY"）**：任何界面状态下对比度最高——"mock 不得当板端
   识别"红线在视觉上不可忽视；LIVE 模式下换绿色徽标。
2. **信息框 = 半透明衬底 + 细边框**（v2 加边框，v3 去四角刻线）：左上状态框与右上指标面板
   都有明确边界；科技感来自"结构"（边框、留白）而非特效。
3. **指标面板（右上）**：ROUND / TARGETS / REC / AGE 四格大数字；面板下沿**新鲜度条**
   （青色按年龄收缩、过期转红）——仪表感 + 把"结果新鲜度"变成一眼可见的量。
4. **目标框 = 实线绿方框 + 序号片**（v3 定稿：实线方框比角括号"更有感觉"）：颜色 + 形状 +
   文字三重编码。
5. **状态语义色**：绿=有效 / 琥珀=等待 / 红=故障；等待状态同时"撤框 + 数值置 -- + 状态文字"
   （三重冗余）。
6. **等待文字用深琥珀 #F09600 且置于深色衬底框内**（用户反馈"亮琥珀落在浅底发虚"）：
   只调深文字在深色视频背景下会反向失效；衬底框保证亮底/暗底都可读。
7. **REC 常驻计数**保留（工程仪表化，操作反馈可见）。

## 实现映射（OpenCV，全部可落地，无新依赖）

- 半透明面板：仅面板 ROI 内 `addWeighted(base, α, roi, 1-α)`——不全屏混合，性能可控
- 角括号：每角两条 `cv2.line`
- 文字：`FONT_HERSHEY_DUPLEX` + `LINE_AA`；**仅支持 ASCII**
- ⚠ 字形陷阱（本次已踩）：`·` `×` `—` 等非 ASCII 字形在 Hershey 字体渲染为问号框
- 中文类别名（M3：螺栓/螺母/垫圈）：需 Pillow 用系统字体预渲染贴图（列为 M3 项，
  新增轻依赖 + 打包带字体文件）

## M3 预留（本提案不实现，留位置）

- 画面中上方：工单判定大徽标 PASS / FAIL / RECHECK（绿/红/琥珀）
- 目标序号片扩展为"类别 + 置信度"（T0 → 螺栓 0.98）

## 状态

**v3 定稿并已实装（2026-10-08 定稿 / 2026-10-09 实装）**：实线绿方框 + 信息框细边框
（无刻线）+ 深琥珀等待文字。实装证据与四模式出图见
`data/logs/2026-10-09-exe-hud-implementation/`；UVC-only 模式隐藏指标面板（用户拍板，2026-10-09）。
**v3.1（2026-10-09，实装后用户评审）**：AGE 数字格删除（与条信息重复、逐帧跳动抢注意力）；
新鲜度条移入面板下沿并加 `FRESHNESS` 小标签（方案 A），取消面板下方浮动条。
**已被 v4 取代（2026-10-09 定稿）**：应用外壳形态见 `data/logs/2026-10-09-exe-hud-v4/`。
01_current.png 仅为现状对照图（黑横幅即旧实现，已整体替换）。
