never-die-cold/FPGA-Alittle-Design/data/logs/2026-10-11-c01-hdmi-1791710185764742/README.md

# 2026-10-11-c01-hdmi-1791710185764742

> 状态：**PROVENANCE GAP**（整理时未找到该目录的原始 README；以下仅写可核实的目录事实，用途/结论/负责人待原执行人补充）。
> 日期：未知

## 目录事实

- 文件数：8
- 大小：744.9 KB
- 顶层条目（前 8 个）：
- `cdc.rpt`
- `drc.rpt`
- `timing.rpt`
- `utilization.rpt`

## 待补

- [ ] 这次运行要回答的问题
- [ ] 完整命令与工具版本
- [ ] 结论（PASS/FAIL/部分完成）与关键数字
- [ ] 能证明什么、不能证明什么
- [ ] 产物是否可重建、如何重建

> 补全后删除本目录的 `PROVENANCE GAP` 标记，并运行 `python sim/scripts/index_runs.py --write` 刷新索引。
