never-die-cold/FPGA-Alittle-Design/data/logs/c01-capture-e2a602d6e0da49a2b6da072abca47c70/README.md

# c01-capture-e2a602d6e0da49a2b6da072abca47c70

> 状态：**PROVENANCE GAP**（整理时未找到该目录的原始 README；以下仅写可核实的目录事实，用途/结论/负责人待原执行人补充）。
> 日期：未知
> 目录名中的 hash 是构建/运行标识，不是 commit；对应源码/输入清单见本目录 `manifest.json`。

## 目录事实

- 文件数：108
- 大小：4.2 MB
- 顶层条目（前 8 个）：
- `console.txt`
- `exit.txt`
- `inputs/`
- `manifest.json`
- `vivado.jou`
- `vivado.log`

- 基线 commit：`c292038b627a46becf7baa83008b1db7126509dc`
- 工作区是否含未提交输入：是
- manifest 记录文件：98 个

## 待补

- [ ] 这次运行要回答的问题
- [ ] 完整命令与工具版本
- [ ] 结论（PASS/FAIL/部分完成）与关键数字
- [ ] 能证明什么、不能证明什么
- [ ] 产物是否可重建、如何重建

> 补全后删除本目录的 `PROVENANCE GAP` 标记，并运行 `python sim/scripts/index_runs.py --write` 刷新索引。
