never-die-cold/FPGA-Alittle-Design/data/logs/cnn-ooc-106904d01e0045089b9d1688ddce6e85/README.md

# cnn-ooc-106904d01e0045089b9d1688ddce6e85

> 状态：**PROVENANCE GAP**（整理时未找到该目录的原始 README；以下仅写可核实的目录事实，用途/结论/负责人待原执行人补充）。
> 日期：未知
> 目录名中的 hash 是构建/运行标识，不是 commit；对应源码/输入清单见本目录 `manifest.json`。

## 目录事实

- 文件数：19
- 大小：33.9 KB
- 顶层条目（前 8 个）：
- `.gitattributes`
- `console.txt`
- `exit.txt`
- `inputs/`
- `manifest.json`

- 类型：CONTROLLER_ONLY_OOC_EXTERNAL_MEMORY_PORTS
- 时钟约束：10 ns
- 基线 commit：`891cba26bc294f157227e7dcd158d8ec81830f2e`
- 工作区是否含未提交输入：是
- manifest 记录文件：11 个

## 待补

- [ ] 这次运行要回答的问题
- [ ] 完整命令与工具版本
- [ ] 结论（PASS/FAIL/部分完成）与关键数字
- [ ] 能证明什么、不能证明什么
- [ ] 产物是否可重建、如何重建

> 补全后删除本目录的 `PROVENANCE GAP` 标记，并运行 `python sim/scripts/index_runs.py --write` 刷新索引。
