never-die-cold/FPGA-Alittle-Design/docs/project-overview.md

# 项目总览：边缘慧眼（EdgeSight）——RTL 组成与数据流

> 本文回答两个问题：这个项目是什么？RTL 代码怎么组织、数据怎么流动？
> **写作口径（ASD-STE100）**：本文按 ASD-STE100 简明技术英语规则的中文对应口径书写——
> 每句只写一个信息点；句子要短；用主动语态；用一般现在时；一个术语只指一个事物；
> 不用比喻和口语。模块名、信号名、寄存器名按代码原名写（STE 允许技术名）。
> **配图**：7 幅图由 [img/make_project_diagrams.py](img/make_project_diagrams.py) 生成，2026-10-28 已按网页端口径重绘；BHT 细节仍未入图。
> **状态口径**：2026-11-03；当前实现以正文、冻结契约和收口证据为准，逐项核对见git 历史（88ac1c4 前）docs/archive/implementation-document-audit-2026-10-12.md。更细的契约见 [design_v0.md](../src/riscv/design_v0.md)、
> [design_v1.md](../src/riscv/design_v1.md)、[vision design_v0.md](../src/vision/design_v0.md)。

---

## 1. 系统是什么（目标架构，未全链实现）

本项目做一台桌面紧固件检查仪。相机拍摄螺栓、螺母和垫圈。零件自由摆放，互不遮挡。
视频进入 PYNQ-Z2 板卡。板卡完成三件事：图像预处理、物体定位、CNN 分类。
板上的 RISC-V 核调度检查、汇总数量、对照工单做判定。
识别结果发给 HTML 网页端。网页端显示视频、矩形框、类别标签和工单判定结果。
有效检查结果为 CHECK_PASS、CHECK_FAIL 或 RECHECK；缺件、多余件、错料是差额原因。无结果/断联时等待新结果。异常时前端保存事件与截图，批次仅记录有效手动轮次。

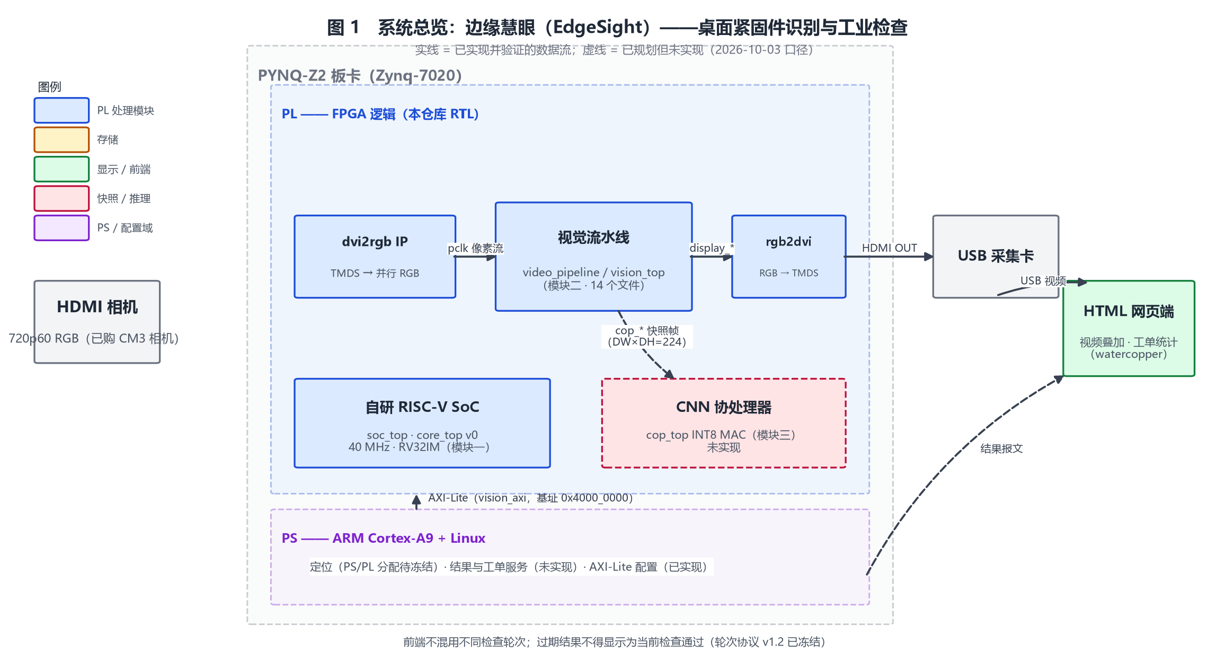
[picture p2: docs/img/fig1_system.png]
图 1 系统总览


数据走两条物理路径。视频路径：板卡 HDMI OUT → USB 采集卡 → 网页端。
结果路径：板卡 PS → 网口 → 网页端。[轮次级同步契约](contracts/vision-sync-protocol-decisions.md)已冻结；mock v1.1 有[落码证据](../data/logs/2026-10-06-vision-sync-schema/README.md)。
网页端已接入真实结果和本轮板端快照，并能在 UVC 视频上作轮次级叠加；过期结果撤框，逐帧精确对齐仍未实现。

## 2. 三个模块与当前状态

| 模块 | 内容 | 负责人 | 状态 |
|:---|:---|:---|:---|
| 模块一 | RISC-V 核＋最小 SoC | jianglibo | 已完成收口。[核收口报告](../report/module1-closure.md) |
| 模块二 | HDMI 视觉预处理 RTL＋已验证视频链路 | never-die-cold | 已完成（RTL／链路级）。[视频记录](../data/logs/2026-10-03-vision-onboard/README.md)、[真实相机记录](../data/logs/2026-10-07-pi-pynq/README.md) |
| 模块三 | INT8 CNN 推理协处理器 | jianglibo | r6 已有实板整数数值对照；正式精度及连续应用稳定性未完成，见主计划 |
| 网页端前端 | 视频/轮次、LIVE 展示、记录与回放 | — | 真实 API、UVC 和本轮快照已联调；本页手动记录和 CSV 已核对；持久记录及长期运行未完成 |

提交节点见根目录 [plan.md](../plan.md) §1.2（最终复验 11/3、作品提交 11/4 18:00 前）。

全项目工业整机验收未完成。CNN r6 有实板整数数值对照，但不等于分类精度与长期运行通过；验收范围以[主计划 §1.4](../plan.md)为准。

- ✅ **已实现并验证**
  - v0 保留 `partA-v0` 锚点；v1 三级、转发、Radix-4、BHT 三档及四档入口已收口。[核收口报告](../report/module1-closure.md)
  - v1：arch-test子集11个测试（3个I类+8个M类）×4档配置共44次签名运行、四档XSim对拍；不代表完整ISA认证。BHT2核OOC 11.520 ns实点WNS +0.538，40 MHz主档真实下载并观察LED，均见核收口报告。
  - 视觉：当前入口含 25 个 RTL tb，新增捕获几何/状态测试；[10/12 整合证据](../data/logs/2026-10-12-pr-review/README.md)与[10/03 特定配置实机记录](../data/logs/2026-10-03-vision-onboard/README.md)分开引用，原视频物理实现 WNS +0.956。
  - 相机：CM3 经 PYNQ 到采集卡取得真实画面，720p 连续 24 帧；[10/07 记录](../data/logs/2026-10-07-pi-pynq/README.md)保留原黑屏、恢复过程与用户确认。
  - v0/PicoRV32 OOC 对比已入档；83.8 MHz 等是 Slack 外推，不是该频率实点通过，见[对比记录](../data/logs/2026-10-03-picorv32-compare/README.md)。
- 🟡 **已实现但仍有验证／追溯缺口**
  - C01取帧、PS定位/ROI、PL CNN、核侧工单固件和真实LIVE均已有实板证据；10/28 r6整数数值对照、10/30网页联调的范围见[主计划](../plan.md#31-当前状态)。分类误差、纸边误检与连续检查TASK_ERROR/DMA故障仍未闭环。
  - 原 vision 的 bit/hwh 已与归档 XSA 配对，构建源码锚定仍缺；C01 捕获候选有独立构建输入和显示/状态实机诊断。完整 DDR 取帧、长测/冷启动/断源恢复未验收，见[C01 基线](contracts/c01-capture-implementation-baseline.md)。
  - 采集卡观测延迟上界 125 ms 已记录，不能当作 PL 本体延迟；PL／识别端到端延迟仍缺同口径实测。
- ⬜ **未实现 / 未接入**
  - 正式独立数据集与精度验收、网页工单下发、持久批次/异常截图、完整工业整机与目标环境发布验收。最新共存包的冷启动/长测/断源恢复仍待验证。

## 3. RTL 代码组成

RTL 有两棵树，加一处预留。核树在 `src/riscv/`，视觉树在 `src/vision/`。
`src/coprocessor/` 已有冻结的 C02 文档、INT8 标量/张量/卷积软件参考，以及 MAC/卷积/requant/GAP/FC、整网控制器和 J04 控制面 RTL（`cop_top`/MMIO/CDC/DMA/工单固件）；实体BRAM和SoC/视频共存已有实板数值对照，仍不等于整机稳定性与精度验收。旧图中的行数和实现标记只对应历史快照。

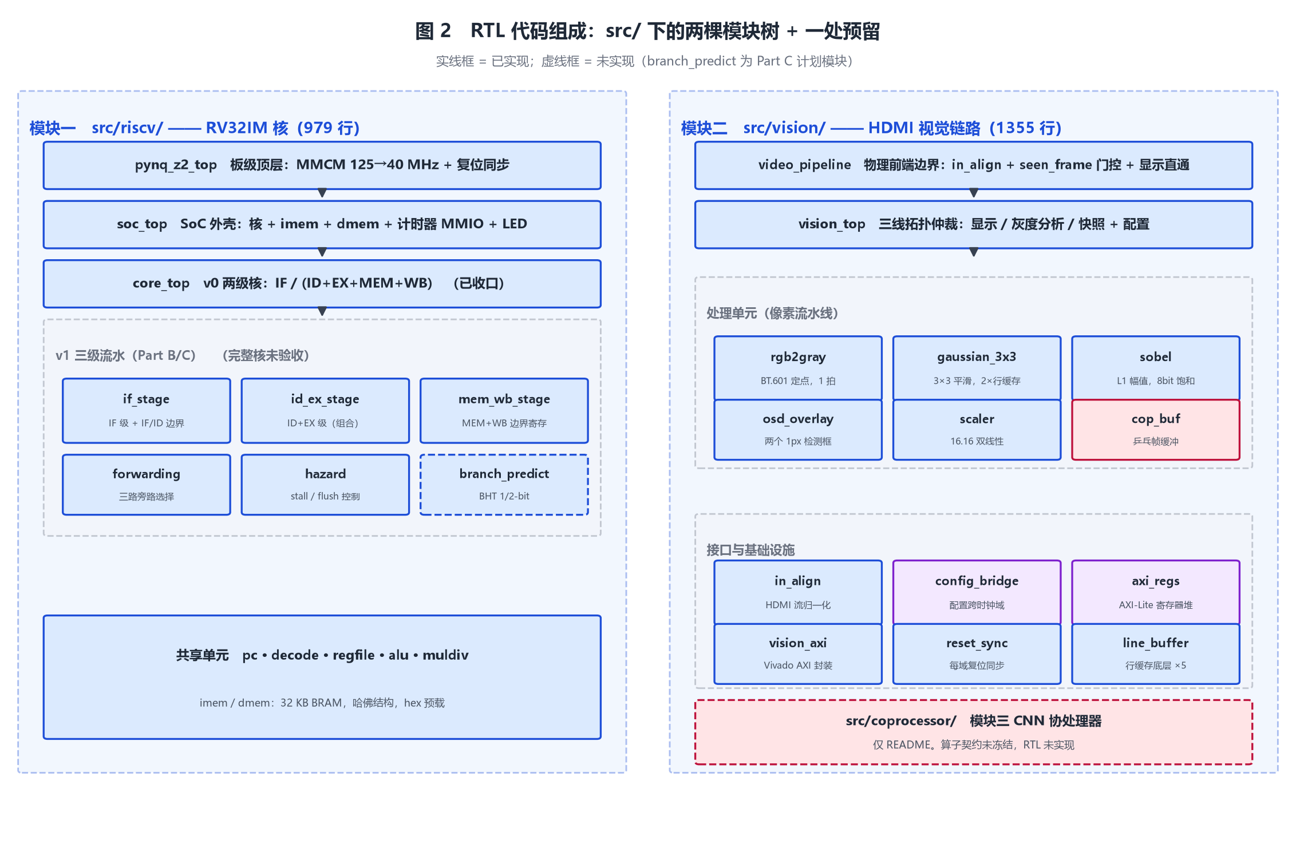
[picture p3: docs/img/fig2_rtl_tree.png]
图 2 RTL 组成树


核树分四层，从下往上集成：

- `pynq_z2_top`：板级顶层。它把 125 MHz 板钟降到 40 MHz。它同步释放复位。
- `soc_top`：SoC 外壳。它例化核、指令 BRAM、数据 RAM、计时器和 LED。
- `core_top`：当前 v1 三级核；v0 两级基线留存在 `partA-v0`。
- v1 模块组：`if_stage`、`id_ex_stage`、`mem_wb_stage`、`forwarding`、`hazard`、`branch_predict`。
  它们服务 v1 核的三级流水与分支预测。共享单元是 `pc`、`decode`、`regfile`、`alu`、`muldiv`、`imem`、`dmem`。

视觉树分四组：

- 顶层：`video_pipeline` 是物理前端边界。`vision_top` 仲裁三条像素通路。
- 处理单元：`rgb2gray`、`gaussian_3x3`、`sobel`、`osd_overlay`、`scaler`、`cop_buf`。
- 接口与基础设施：`in_align`、`config_bridge`、`axi_regs`、`vision_axi`、
  `reset_sync`、`line_buffer`（被窗口级和 scaler 复用，共 5 片）。
- C01 捕获旁路：`capture_stream_monitor`、`capture_fault_cdc`、`capture_status_axi`；与 Video In/VDMA 构成候选捕获支路。`stream_seq` 只证实 AXIS 完整几何，不能授权 PS 复制 DDR 槽。

## 4. 模块一：核的数据流

### 4.1 v0 两级核（图 3）

v0 只有两级。第一级是 IF。第二级把译码、执行、访存、写回合在同一拍组合完成。

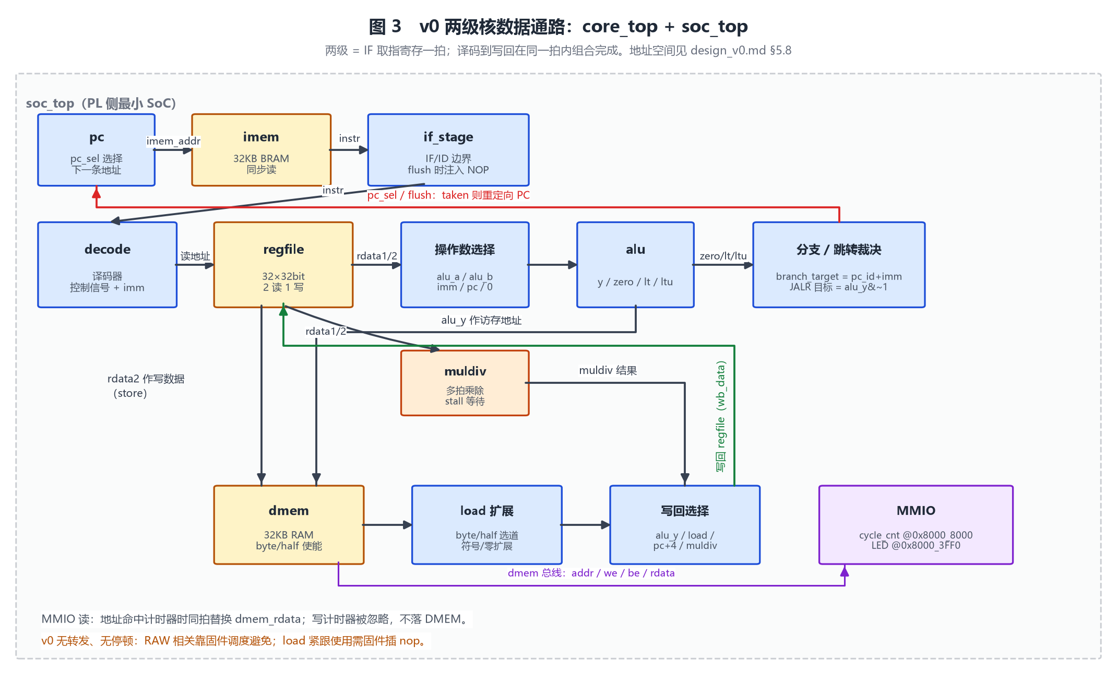
[picture p4: docs/img/fig3_core_v0.png]
图 3 v0 核数据通路


数据这样流动：

1. `pc` 给出取指地址。`imem` 同步读出一 条指令。
2. `if_stage` 锁存指令和 `pc_id`。遇到 flush 时，它下一拍注入 NOP。
3. `decode` 产出控制信号和立即数。`regfile` 读出两个源操作数。
4. 操作数选择器把立即数、`pc_id` 或 0 送给 `alu`。
5. `alu` 输出结果 `alu_y` 和三个标志：`zero`、`lt`、`ltu`。
6. 分支裁决用标志决定 taken。taken 时 `pc_sel` 切换 PC，并冲刷 IF。
7. 访存用 `alu_y` 作地址。store 数据来自 `rdata2`。字节/半字写有 lane 使能。
8. load 数据做符号扩展或零扩展。写回选择器四选一：`alu_y`、load 数据、`pc_id+4`、乘除结果。
9. `muldiv` 是多拍单元。核在它算完之前保持 stall。结果经写回选择器进寄存器堆。

v0 不设独立转发和 load-use interlock，异步 DMEM 支持同拍 load 写回；普通相关指令下一拍读取已更新的寄存器堆。
M 指令仍按 [v0 握手契约](../src/riscv/design_v0.md)停顿，不能把“无数据停顿”解释为所有指令都不停顿。

SoC 侧有两个 MMIO 地址。读 `0x8000_8000` 得到周期计数器。写 `0x8000_3FF0` 驱动 LED。
写计时器地址被忽略，不落 DMEM。

### 4.2 v1 三级流水（图 4）

v1 把两级拆成三级：IF、ID+EX、MEM+WB。无停顿的稳态路径每拍提交一条。

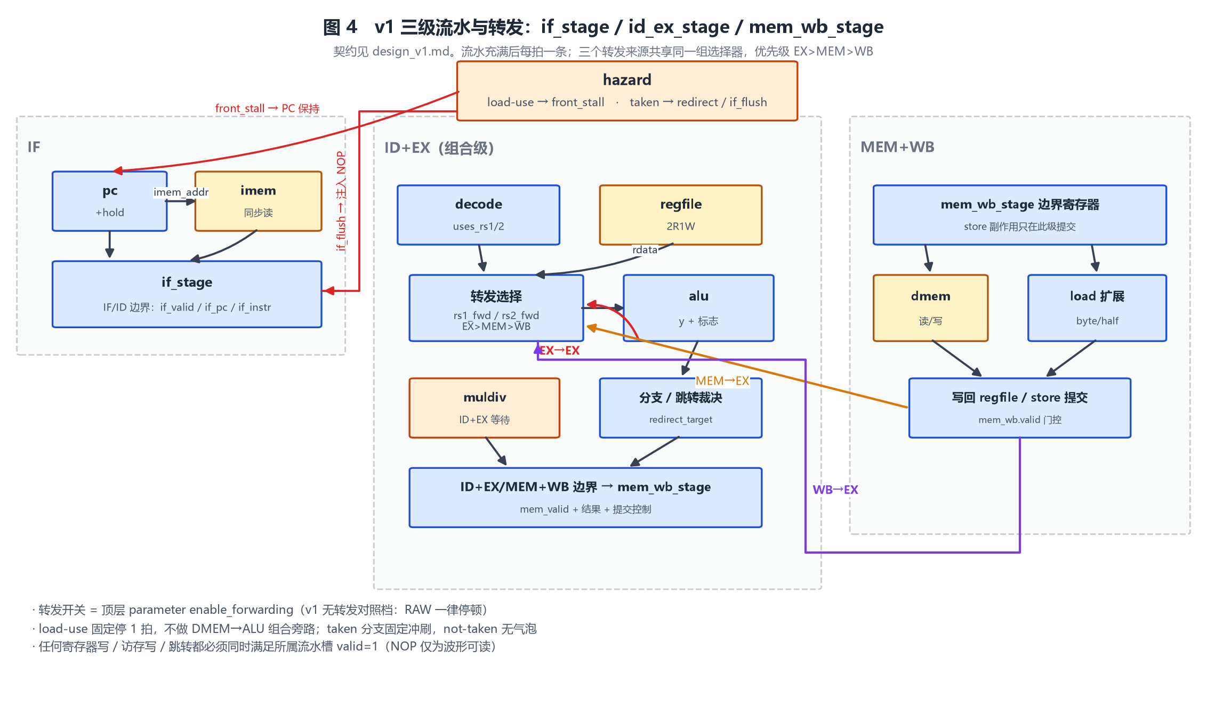
[picture p5: docs/img/fig4_core_v1.png]
图 4 v1 三级流水与转发


两个流水边界：

- IF/ID 边界由 `if_stage` 拥有。它携带 `if_valid`、`if_pc`、`if_instr`。
- ID+EX/MEM+WB 边界由 `mem_wb_stage` 拥有。store 副作用只在这一级提交。

通用 `forwarding` 的来源优先级为 EX > MEM > WB，来源类别不代表额外流水级。
当前核只启用来自 MEM+WB 的非 load `mem_result`，接到 EX 候选；MEM/WB 候选无效。
ALU、PC+4 和 M 结果均可旁路；load 先提交，消费者停 1 拍后重读寄存器堆。

冒险与控制处理包括以下动作：

- load-use：前一条是 load 且本条用它的目的寄存器。固定停 1 拍。没有 DMEM→ALU 组合旁路。
- 控制裁决以 `ex_accept` 门控；BHT 关闭时 taken 分支冲刷 1 槽，开启时预测正确零冲刷、误预测冲刷 1 槽；JAL/JALR 仍冲刷 1 槽。

顶层参数 `ENABLE_FORWARDING` 切转发，`BHT_MODE=0/1/2` 切关闭／1-bit／2-bit；同 RTL 四档由脚本传参。
所有副作用由槽位 `valid` 门控；当前 IF flush 只清有效位，不要求把指令 payload 改成 NOP。

## 5. 模块二：视觉流水线的数据流

### 5.1 像素流约定

全链在同一个像素时钟 `pclk` 域逐拍推进。没有 ready 反压。
`de=1` 表示当前像素有效。`vs` 是帧首单拍标记。`hs` 是行尾单拍标记。
像素是 24 位 RGB。灰度级是 8 位 Y。
`in_align` 负责把 dvi2rgb 的原始波形归一化到这套约定。

### 5.2 三条通路（图 5）

`vision_top` 把像素流分成三条。开关来自 `active_cfg`，帧内恒定。

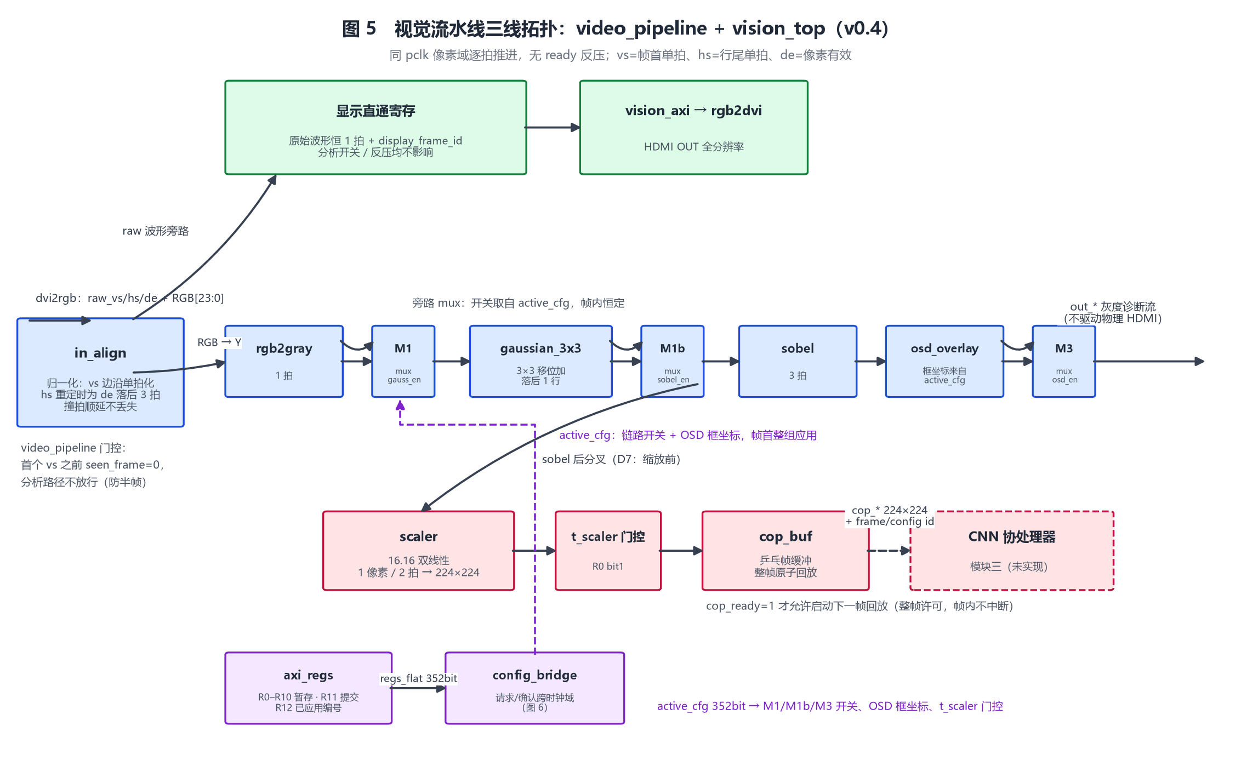
[picture p6: docs/img/fig5_vision_pipeline.png]
图 5 视觉三线拓扑


- **显示通路**：原始 RGB 波形恒 1 拍直通，附带 `display_frame_id`。
  分析开关、缩放和消费反压都不影响它。这是上屏的唯一来源。
- **分析通路**：`rgb2gray` → [gaussian] → [sobel] → [osd] → `out_*`。
  `out_*` 是灰度诊断流，不驱动物理 HDMI。OSD 的两个框坐标来自配置寄存器。
- **快照通路**：在 sobel 之后分叉（D7 决策：全分辨率上做边缘，缩放后信息已损失）。
  `scaler` 缩到 CNN 输入尺寸，`cop_buf` 存整帧，`cop_*` 交给模块三。

`video_pipeline` 还有一个门控：首个 `vs` 到来之前，分析路径不放行。这防止半帧进入流水线。

### 5.3 每一级做什么

- `rgb2gray`：BT.601 定点，`Y = (77R + 150G + 29B) >> 8`。延迟 1 拍。
- `gaussian_3x3`：核 `[1 2 1; 2 4 2; 1 2 1]/16`，全移位加，无乘除。
  双行缓存轮替，输出落后输入 1 行。末行在消隐期冲刷补出。
- `sobel`：Gx、Gy 取 L1 幅值 `|Gx|+|Gy|`，8 位饱和。窗口装配与冲刷和 gaussian 同构。
- `scaler`：16.16 定点双线性。1 像素 / 2 拍。目标尺寸即 CNN 输入尺寸（real 档 224×224）。
- `osd_overlay`：两个 1 像素描边框。参数帧首锁存，帧内改参数不影响当前帧。

### 5.4 配置如何跨时钟域生效（图 6）

PS 的配置时钟和像素时钟异步。直接写寄存器会撕裂配置。所以配置走整组原子提交。

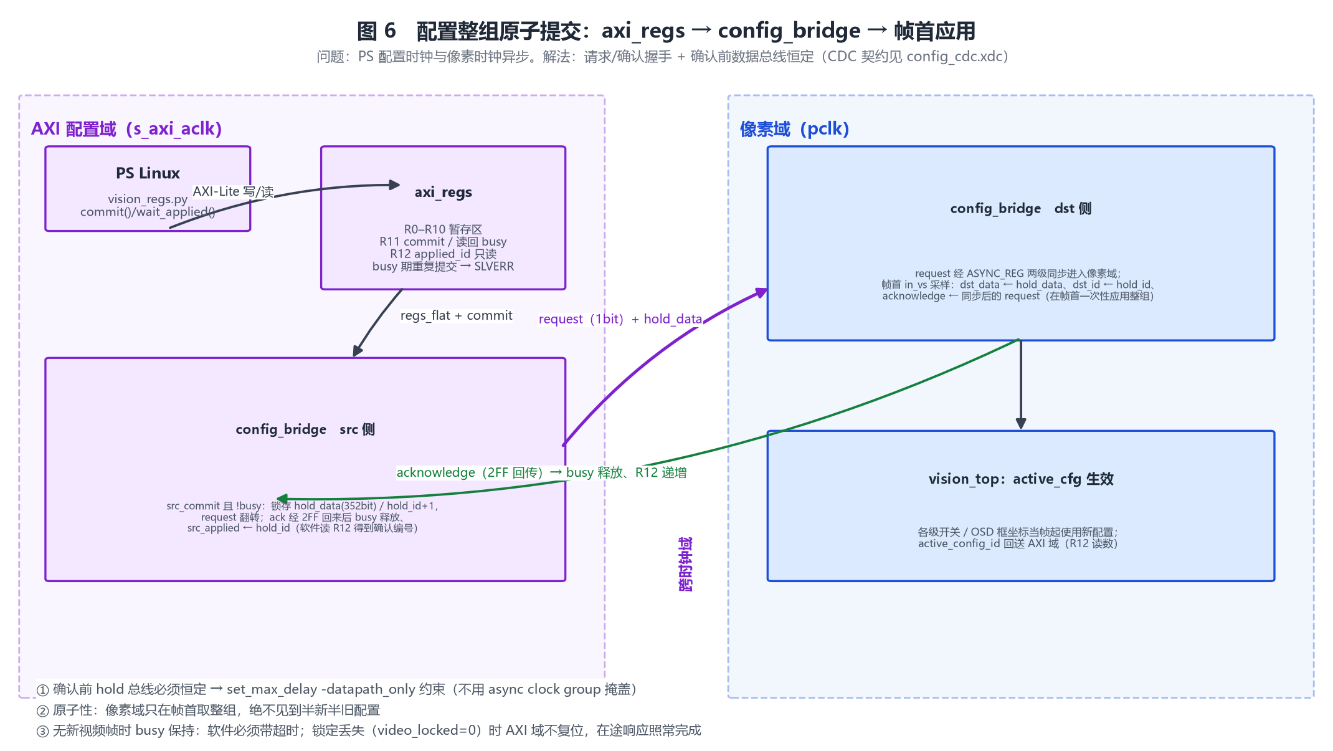
[picture p7: docs/img/fig6_config_cdc.png]
图 6 配置原子提交


流程有五步：

1. 软件写 R0–R10。这些写进暂存区，不立即生效。
2. 软件写 R11 提交。`config_bridge` 锁存整组 352 位数据和配置编号，翻转 request。
3. 像素域在帧首 `in_vs` 采样 request。整组落地为 `active_cfg`，当帧生效。
4. 像素域回送 acknowledge。AXI 域释放 busy。软件读 R12 得到确认编号。
5. busy 期间重复提交返回 SLVERR。无新帧时 busy 保持，软件必须带超时。

三条 CDC 纪律：确认前数据总线恒定（用 `set_max_delay -datapath_only` 约束，
不用异步 clock group 掩盖）；两级同步器全部加 `ASYNC_REG`；
锁定丢失时 AXI 域不复位，在途响应照常完成（2026-10-03 上板挂死 bug 的教训）。

### 5.5 分析快照回放接口（图 7）

`cop_buf`是已有的分析快照回放接口，目前仅作快照/诊断，未接CNN。它用两个存储银行做乒乓帧缓冲；银行数不等于BRAM块数。C02/C03的首网输入来自原图逐目标ROI，不能直接以整帧224×224快照替代。

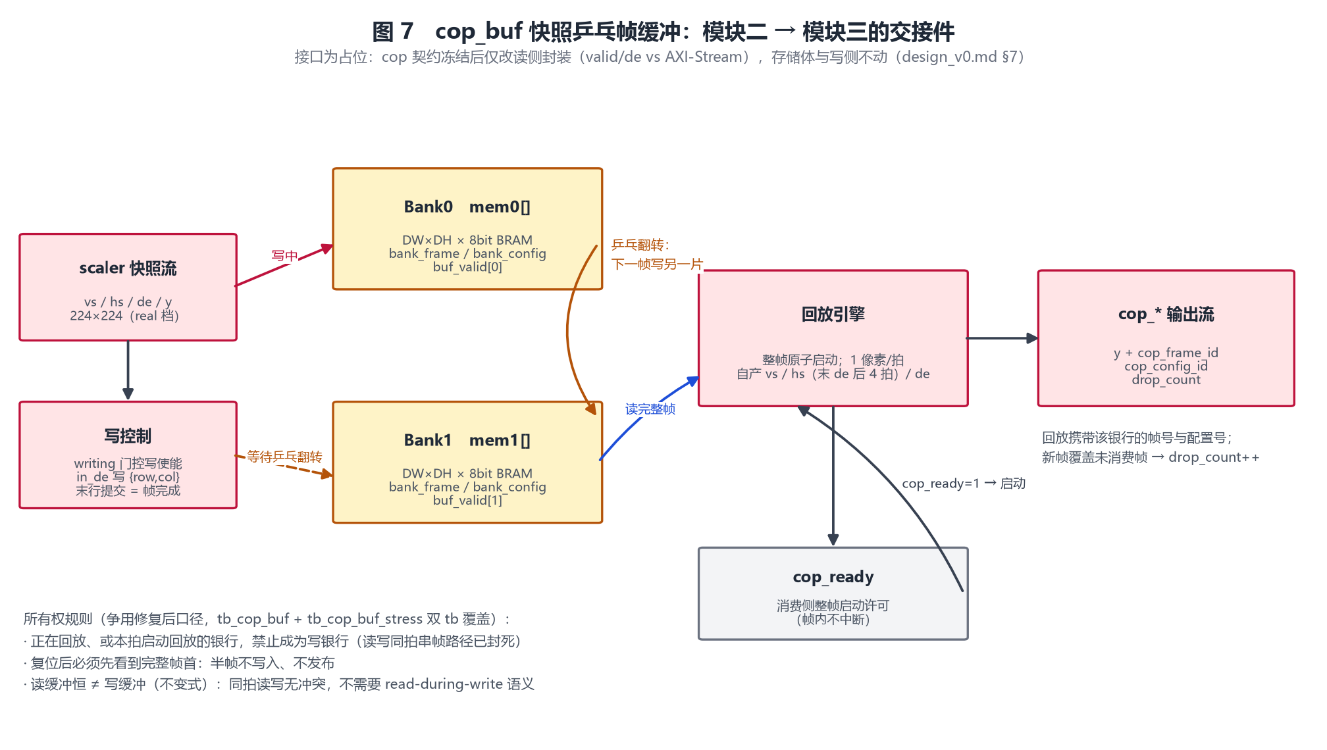
[picture p8: docs/img/fig7_copbuf.png]
图 7 cop_buf 乒乓帧缓冲


工作方式：

- 写侧逐像素写入当前银行。末行提交即帧完成。
- 读侧等 `cop_ready`。`cop_ready` 是整帧启动许可，不是逐像素反压。
  启动后以 1 像素/拍整帧原子回放，帧内不中断。
- 回放携带该银行的帧号和配置号。消费侧据此建立帧对应关系。

所有权规则有四条：正在回放或本拍启动回放的银行禁止当写银行；
复位后必须先看到完整帧首，半帧不写入也不发布；
新帧覆盖未消费帧时 `drop_count` 加一；
读缓冲恒不等于写缓冲，同拍读写无冲突。

接口保留现有快照语义；将来用途调整须明确版本并验证。C03已选DMA搬运PS生成的ROI，不据此假定只改读侧封装即可接入CNN。

## 6. 一帧数据的完整旅程

以一个真实像素为例，它走过这些站：

1. 相机发出 TMDS 串行信号。
2. `dvi2rgb` 把它转成并行 RGB 和 `vs/hs/de`。
3. `in_align` 归一化标记。`video_pipeline` 用 `seen_frame` 挡住半帧。
4. 显示通路：原始波形寄存 1 拍，`rgb2dvi` 串化，HDMI OUT 出图。
5. 分析通路：灰度化、平滑、边缘、OSD 叠加，出灰度诊断流。
6. 快照通路：缩放到 224×224，`cop_buf` 存成整帧。
7. 当前共存包由原彩色捕获支路写DDR，PS经C01 park后端取副本、定位、裁剪64×64灰度ROI并量化；DMA把小ROI送入`cop_top`。
8. `cop_top`返回INT8分类结果，RISC-V汇总数量/对照工单判定，PS合并本轮bbox并发报文；已有实板数值对照。
9. 前端按session/config/接收后年龄叠框、标签和判定；不校验采集卡帧号，不能称“对应帧精确叠加”。

第5–6步描述原视觉RTL的分析/快照诊断路径，当前共存包以原彩色捕获→PS定位/ROI→PL CNN作为应用路径；不能将诊断链全部算作当前推理输入。FILE原型用文件副本，C01/COP_HW真实后端执行第7–8步。显示与结果延迟不同，来源capture/check关联和轮次标识必须显式保存。

## 7. 验证体系

最终离板汇总入口：`bash sim/scripts/run_offboard.sh all`，环境与范围见[最终检查说明](runbooks/final-offboard-check.md)。它调用原 `run_iverilog.sh all`，补齐arch-test、检查链、网页、N03与发布工具检查；XSim与Vivado仍为专项入口。
测试集合以汇总脚本及其调用列表为准，避免在多份说明重复维护组数；历史全量结果与当前定向回归分别留痕。门禁故意注入的FAIL由自检判据处理，真正测试失败使整体失败。

- 每个视觉单元都有黄金参考。Python 生成输入和期望，tb 逐像素比对。数据在 `data/golden/vision/`。
- iverilog 全 PASS 后，XSim 用同一判据复跑（`bash sim/scripts/run_vision_xsim.sh all`）。
- 时序证据来自 Vivado OOC post-route 报告。关键数字见第 2 节状态清单。
- 原始日志在 `data/logs/`。每个结论都能靠仓库内脚本重放。

## 8. 未实现清单（明确标注）

- C01/PS 定位与 ROI、PL CNN、核侧工单固件及视频共存已有实板记录；连续检查的 TASK_ERROR/DMA 故障恢复仍待修复，最新结论见[主计划](../plan.md#31-当前状态)。
- 正式紧固件数据集与模型：未完成。采集规程已入库。
- 前端真实 API、UVC 和检查快照已接入；持久批次、异常截图、网页工单下发和目标环境完整发布未完成。本页记录不等于已退役 EXE 的记录 v2 持久存储。
- FILE 后端保持 PROTOTYPE；真实 C01/COP_HW 后端已接入。轮次级叠加不代表逐帧精确关联。
- PL 本体及识别闭环延迟、当前相机配置的长期运行／冷启动／断连恢复：待验证；已有采集卡观测上界不能替代。

## 9. 文档关系与复现入口

| 想了解 | 去哪里 |
|:---|:---|
| 全项目目标、分工、里程碑 | 根目录 [plan.md](../plan.md) |
| 核验收与演进 | [report/module1-closure.md](../report/module1-closure.md) |
| v0 核接口契约 | [src/riscv/design_v0.md](../src/riscv/design_v0.md) |
| v1 流水契约 | [src/riscv/design_v1.md](../src/riscv/design_v1.md) |
| 视觉接口与寄存器映射 | [src/vision/design_v0.md](../src/vision/design_v0.md) |
| 开工清单与理解门槛 | [docs/workflow.md](workflow.md) |

复现命令：

```bash
python docs/img/make_project_diagrams.py      # 旧图生成器；重绘须另批授权，本轮不执行
bash sim/scripts/run_iverilog.sh all          # 全量回归（核四档 + 视觉 25 tb）
bash sim/scripts/run_vision_xsim.sh all       # XSim 同判据复跑
bash sim/scripts/run_offboard.sh software    # 本次软件修复回归；不重跑RTL
bash sim/scripts/run_vision_python.sh        # VISION_PYTHON可指定真实解释器
bash sim/scripts/run_inspection_python.sh     # 检查链
bash sim/scripts/run_coprocessor_python.sh all # 10组INT8参考（含 manifests），需python3与NumPy
```

## 自测题（理解门槛演练）

1. v0 为什么不需要转发单元也能跑对？v1 打开转发后，哪一类相关仍然必须停顿？为什么？
2. 配置写入 R0 后为什么画面不立刻变？软件要怎么确认这组配置已经生效？
3. `cop_ready` 拉高期间，快照写侧正在写 Bank0。此刻 Bank1 刚好写完一帧。回放引擎会怎么选？

## 变更记录

| 日期 | 变更 |
|:---|:---|
| 2026-10-19 | 合并 dev/riscv：J04 控制面/`cop_top`/MMIO/CDC/DMA/工单固件纳入现状；INT8 入口更新为 10 组；实体 BRAM/SoC/视频/板端输出仍未验收 |
| 2026-10-19 | 按脚本校正 Python 组数（视觉 21 / 检查链 14 / INT8 9），校正模块三 RTL 现状；历史配图保持原样 |
| 2026-10-12 | 校正25 tb、捕获旁路、C02/C03、软件参考/服务/EXE实现及验收边界；历史配图保持原样 |
| 2026-10-09 | B02：同步三层状态与证据、当前核/转发/BHT 说明及 23 tb 入口；配图保留历史快照，未重绘。 |
