never-die-cold/FPGA-Alittle-Design/docs/proposal_upgrade.md

# 命题升级方案：借鉴往届国一/国二作品

> 当前执行以根目录 [项目主计划](../plan.md) 为准：自由分散且互不遮挡的紧固件，传统视觉定位 + CNN 分类，采集卡视频 + 网口结果进入 Windows EXE，前端由 watercopper 负责。本文保留早期升级依据；下文旧排期、Jupyter 主界面和板端 OSD 叠加方案不作为当前执行要求，跨帧跟踪仍为增强功能。
> 历史状态：📌 已采纳（2026-09-11），档位 = 组合阶梯 A+B；**2026-09-20 更新：报名未截止、题目可改，注册名定为《边缘慧眼（EdgeSight）——基于自研 RISC-V 的边缘智能视觉 SoC》，README 标题同步（决策见 `report/llm_log/2026-09-20-registration-rename.md`）；2026-09-21 裁撤原 C 档（EdgePilot 云台，赛后扩展，不进比赛范围）**
> 决策记录：`report/llm_log/2026-09-11-proposal-upgrade.md`、`report/llm_log/2026-09-20-registration-rename.md`
> 往届作品调研底稿：[`docs/track_research.md`](track_research.md)

---

## 1. 红线（先立规矩）

1. **注册名以最新提交为准**：原 2026-09-11 记录的"名称已提交锁定"作废——报名未截止、题目可改（2026-09-20 确认）；注册名定为《边缘慧眼（EdgeSight）——基于自研 RISC-V 的边缘智能视觉 SoC》，README 标题已同步；此后升级仍只发生在叙事、模块表述、指标与演示层。
2. **M1 主线技术内容零改动**：RISC-V 主线（三级流水 + 转发 + 分支预测）技术范围一字不动；2026-09-21 排期压缩后窗口为 9/21–10/1（日期前移，决策见 `report/llm_log/2026-09-21-schedule-compression.md`），升级内容一律不进 M1–M3 关键路径。
3. **阶梯可砍**：每一层升级都有明确的"砍法"，砍掉任何一层都仍有完整可交的下层作品。
4. 决赛 Verilog 上机考核与上述内容无关，照常每周刷题。

## 2. 升级依据（对着评分权重找缺口）

2026 AMD 自主选题赛道评分权重：**创新性与应用价值 30** / 性能与资源优化效果 20 / 功能正确性与设计完整性 20 / 大模型协作与技能包 15 / 文档质量与可复现性 15。

原命题（三模块并列）的短板：模块"拼盘感"偏强、应用故事泛化、演示形态偏静态。往届获奖作品验证的高分范式：**单点打透 + 全部指标可测 + 演示动效 + 闭环故事**。

## 3. 借鉴映射表（获奖作品 → 升级点）

| 获奖作品 | 被验证有效的元素 | 本项目升级点 |
|:---|:---|:---|
| [Ultra-Vision](https://github.com/Floatkyun/Ultra-Vision)（2024 易灵思 国一+创新杯） | 单点打透：1 像素步长无极缩放；全部指标可测（延时 16.7ms = 1 帧） | A1 参数化链路、A5 演示级指标 |
| 同上 | 架构级创新：算法直出 HDMI、免 DDR 回写 | A2 "行缓存直通 vs 帧缓存回写"架构对比 |
| 同上 | 演示动效（预设缩放动画、GUI 实时调参） | A4 OSD/ROI 动效 + Jupyter 调参面板 |
| [国一 hlstrack2025_40562](https://github.com/hongpengWu/hlstrack2025_40562)（2025 AMD） | 决赛延伸：算子 → YOLO+UKF **检测-跟踪闭环** | B 档（检测 → 轻量跟踪 → OSD 闭环） |
| 同上 | **软/硬件双版本同界面对比**（soft/hardware 双 notebook） | A3 软/硬推理一键切换同屏对比 |
| [国二 频谱仪 / 音频分析仪](https://github.com/VincentttWang/FPGA_SocChina_2025)（2025 AMD） | "仪器化"形态：PS 统一控制+显示+实时曲线 | A4 的 Jupyter 控制中心；协处理器补吞吐率指标 |
| [肺结节检测（国三）](https://github.com/paulgeorge66/fpgachina2025_49257) | 应用领域具体化 | README 应用场景收敛为一个具体场景 + 演示剧本 |

## 4. 升级后的命题定位（注册名 = 边缘慧眼，内部叙事 v2）

> EdgeSight：一颗把"看清 → 看懂 → 跟踪"装进片内的边缘视觉智能 SoC——
> **自研三级流水 RISC-V 核**统一调度，**参数化视觉直通流水线**零帧缓存依赖（逐像素延迟固定可测），**INT8 推理协处理器**与 ARM 软件基线**同屏一键切换对比**；
> PS 侧 Jupyter 作为控制中心：实时调参、指标实时曲线、OSD 动效演示——作品形态是"片上可交互视觉分析仪"，而不是三个模块的拼盘。

## 5. 组合阶梯

### A 档：叙事 + 演示级（必做，随 M2/M3 内嵌，复用既有硬件）

| 项 | 内容 | 借鉴来源 |
|:---:|:---|:---|
| A1 | 预处理链路**参数化**：AXI-Lite 动态组合灰度/滤波/缩放/边缘（含开关与参数） | Ultra-Vision"一套算法统一三种插值" |
| A2 | **直通 vs 帧缓存**架构对比：给延迟/带宽/资源三列实测数据 | Ultra-Vision 创新点 1（免 DDR 直出） |
| A3 | **软/硬推理一键切换**：同一网络 ARM 软件版 vs 协处理器版，同屏对比延迟 | 国一 40562 soft/hardware 双 notebook |
| A4 | **演示动效**：OSD/ROI 框动画、Jupyter 调参面板实时曲线 | Ultra-Vision 动画 + 国二 PyQt/Web 可视化 |
| A5 | 指标表补**演示级指标**：逐像素固定延迟、端到端帧延迟、动效帧率 | Ultra-Vision 指标颗粒度 |

### B 档：检测-跟踪闭环（stretch，10/27–11/3 窗口）

- 内容：CNN 检测 → **自研 RISC-V 核跑轻量跟踪**（质心/简化定点滤波）→ OSD 闭环显示
- 前提：L3 保底验收完成；**无新硬件**；随时可砍（issue 跟踪）
- 对标：国一 40562 的"检测→跟踪"决赛延伸结构
- 版本阶梯（在原 L1/L2/L3 之上扩展）：

| 版本 | 内容 | 状态 |
|:---|:---|:---|
| L1/L2/L3 | EdgeSight 原版三级降级策略（README） | 不变 |
| **L3.5（stretch）** | L3 + 检测-跟踪闭环演示 | B 档 |

## 6. 演示剧本（现场 3 分钟流程草案）

1. 开场：Jupyter 控制中心，指标实时曲线已在跑（先亮"仪器"形态）
2. 直通链路：面板实时调参（滤波核/缩放/ROI），画面即时响应 + OSD 动效
3. 软硬切换：同一网络"ARM 软件推理 ↔ 协处理器推理"一键切换，同屏延迟对比
4. 闭环（若 B 完成）：检测框 → 跟踪轨迹 → OSD 动效
5. 收尾：metrics 汇总表 + "先测基线再谈优化"的对照数据

## 7. 排期归属（红线对照）

| 任务 | 归属 | 是否关键路径 |
|:---|:---|:---|
| A1–A5 | M2/M3 内嵌（演示层，复用既有硬件） | 否 |
| B 检测-跟踪闭环 | 10/27–11/3 stretch 窗口 | 否 |
| M1 RISC-V 主线 | 9/21–10/1（2026-09-21 压缩前移，原 10/4） | **技术内容零改动** |

## 8. 风险与砍法

- **B 砍法**：退回 A（OSD 静态叠加），演示剧本第 4 步删去。
- **指标采集增量风险**：演示级指标随演示脚本一次性自动采集（`data/scripts/`），不单开测试轮次。
- 若 M3 进度滞后：先砍 B，A 档的 A2/A3 优先级最高（对应创新性与性能两项评分）。
