never-die-cold/FPGA-Alittle-Design/report/llm_log/2026-10-27-coprocessor-closeout-findings.md

# [2026-10-27] 协作记录：全仓只读收尾审计与 5 条 P0 阻断

> 标签：#coprocessor #审计 #收尾 #证据链 #OPEN
> 平台：Codex（VS Code 扩展）｜ 模型：GPT-5
> 相关产物：`report/llm_log/2026-10-27-closeout-audit.md`（审计基线 `dev/riscv@0430257`）

## 1. 任务与初始提示词

只读审计整个仓库（排除 `.git`、`sim/build`、`dist`、`build/run`），找出“收尾遗漏”和
“文档与事实不一致”：逐项核对 J04b/J05/J06/J07/J08/J09 状态、证据链、包与哈希、OPEN 台账、
runner 覆盖、测试强度、RTL 卫生、可复现性、文档索引与硬编码环境依赖。禁止改代码/文档、
禁止运行 Vivado、禁止“建议重构”这类不可验收意见。

## 2. 模型第一版方案

按 10 个维度逐项取证（文件:行或命令输出）；输出问题表（编号/类别/严重度/事实/证据/建议/责任人）、
文档错误原句清单、无证据结论清单、孤儿/死链清单，最后给 ≤5 条 P0 阻断。
写入口固定为 `report/llm_log/2026-10-27-closeout-audit.md`，不触碰其它文件。

## 3. 失败现象（审计发现）

1. 旧 J04 交接仍称由核写 CLEAR 位清终态，直接违反 A2（真阻断）。
2. A 变体整机门禁 2.078 ns 的原始 timing/util/CDC/DRC 报告未入 Git；干净 checkout 只有二手摘要。
3. 当前唯一有效 A 包 tar/sidecar 未跟踪，也没有 Release URL/上传回执，NC 无法取得对应产物。
4. `run_iverilog.sh` wrapper 先 `cd sim`，相对 venv 路径失效，最终 `python: command not found`。
5. 裸 `all` 仍因系统 Python 缺 NumPy 退出 1；OPEN-ENV-1 未关闭。
6. 20 个 Markdown 未挂 `docs/README.md` 或子索引；路径死链为 0。
7. Vivado 默认路径在文档与两个脚本间不一致（`D:\vivado\...` vs `D:\Vivado_downloads\...`）。

## 4. 纠错轨迹

| 轮次 | 喂回的信息 | 模型诊断 | 修改内容 | 验证结果 |
|:---|:---|:---|:---|:---|
| 1 | 只读边界 | 不能改代码/文档 | 只写一份审计报告 | 工作区仅新增该文件 |
| 2 | 回归重建 `cop_job.hex/.dis` | 测试副作用 | 恢复到 HEAD | 工作区干净 |
| 3 | 统计严重度 | 需可复核 | 问题表 24 条：阻断 5/高 9/中 7/低 3 | 计数一致 |
| 4 | 文档/源码冲突 | 以证据为准 | 逐句引用错误原句 | 可定位 |

## 5. 最终结论

审计报告共 238 行、24 个问题。关键结论：
- runner 26 个 TB 全部有入口，35 个模式无空模式，无孤儿 Verilog TB；
- 492 个本地链接 0 死链，但有 20 个未挂索引的 Markdown；
- BRAM pattern/zero 各 73,795 元素、472,594 cycles，CRC 与包表一致，不存在只比 argmax；
- P0 5 条：①修旧 CLEAR/W1C 语义；②归档 A 门禁原始报告与退出码；③上传 A tar+sidecar 并登记
  Release URL；④NC 验收当前 A 包；⑤完成 J05/J06 真实 ROI→RELEASE 模型/黄金链。

## 6. 经验沉淀

- 触发条件：准备收尾/答辩，文档与实现经过多轮并行修改。
- 排查步骤：先对齐权威计划，再逐条追“提交 + 产物哈希 + 命令/日志”；把“无证据结论”
  与“未验证”分开；审计只写证据，不给重构建议。
- 适用范围：任何多 Agent 并行仓库的收尾审计；换分支需重定基线。
#skill候选
