never-die-cold/FPGA-Alittle-Design/report/llm_log/2026-10-27-coprocessor-summary-poster.md

# [2026-10-27] 协作记录：≤500 字项目简介与成果海报溯源

> 标签：#docs #对外表达 #海报 #可追溯
> 平台：Codex（VS Code 扩展）｜ 模型：GPT-5
> 相关产物：`docs/project-summary-2026-10-27.md`、`docs/poster-content-map.md`

## 1. 任务与初始提示词

从 `origin/dev/riscv@0430257` 的事实写一份 ≤500 字中文简介：五段（是什么/到哪/证据/还差什么/
下一步），开头三行 TL;DR；必须写成“仿真 PASS / 整机综合实现 PASS(40MHz) / 板上 UNVERIFIED”，
模型是 PROVISIONAL，`score_q15` 不是概率，禁止“已完成/性能达标/实测识别率”。
随后用桌面模板做成果海报，只替换文字，产出“文案 ↔ 仓库来源”溯源表。

## 2. 模型第一版方案

简介：先读 `plan.md`、NC 交接、build variants、C03 §14、manifest v1、IMEM 门禁与审计报告，
压缩成 5 段 + 3 行 TL;DR，并用脚本统计汉字数与段落数。
海报：用 python-pptx 逐页体检模板，按“页 ↔ 内容”方案替换文字，保留版式/字号/颜色，
只新增 `docs/poster-content-map.md` 记录每段文案的来源路径:行。

## 3. 失败现象

1. 指定的只读 worktree `/home/jianglibo/cop-readonly` 起初不存在，第一轮无法取证。
2. 系统无 `python-pptx`；`python3 -m venv` 因缺 `ensurepip` 失败。
3. 桌面有三个 `.pptx`（含 Office 锁文件 `~$`），不能自动猜模板。
4. 海报若写精度百分比/板上时延/训练规模，仓库没有证据，必须禁止。

## 4. 纠错轨迹

| 轮次 | 喂回的信息 | 模型诊断 | 修改内容 | 验证结果 |
|:---|:---|:---|:---|:---|
| 1 | `cop-readonly` 不存在 | 不能读主仓库旧快照 | 等 worktree 恢复后重读 | 取证成功 |
| 2 | venv 缺 ensurepip | 系统环境不完整 | 用 `pip3 --target` 装到独立目录 | python-pptx 可用 |
| 3 | 三个 pptx | 不能猜模板 | 用户确认用 `嵌入式海报.pptx` | 模板锁定 |
| 4 | 可能写出无证据指标 | 口径越界 | 只写仿真/综合实现/板验三态与 2.078 ns | 文案可溯源 |

## 5. 最终结论

- `docs/project-summary-2026-10-27.md`：正文 308 个汉字，6 个段落（3 行 TL;DR + 5 段），
  明确板级未验证、正式模型未发布、视频整机未验证；当前唯一包哈希前 12 位 `e2eb5bd340f0`。
- `docs/poster-content-map.md`：海报每段文案对应仓库路径与行号；成品
  `嵌入式海报-FINAL.pptx` 保存在桌面，仅替换文字，不改版式。
- 海报不写精度百分比、板上时延、训练规模、量产/客户交付等无证据内容。

## 6. 经验沉淀

- 触发条件：需要把工程事实转成对外简介/海报。
- 排查步骤：先锁定唯一事实源与三态口径；数字必须能追到路径:行；无证据的指标直接省略；
  模板只替换文字，产物另存不覆盖。
- 适用范围：答辩/海报/汇报材料；换项目仍需重新建立溯源表。
#skill候选
