never-die-cold/FPGA-Alittle-Design/report/llm_log/2026-10-27-pynq-integration-handoff.md

# 2026-10-27 PYNQ 集成提交说明

## 用户范围与授权

用户要求快速模式、阻塞自行解决、答题最后进行；随后明确要求“分多个commit,push，开PR合并之后同步各个分支”。
本轮按该最新直接指令提交、推送和合并；未将理解门槛记为已经通过，未代答。
`skill/understand-gate/SKILL.md` 已阅读，逐段理解核验仍留后，不虚构人工复核人。

## 改动设计意图

1. AXI-Lite CDC：payload 两级采样，请求/ACK 三级，给并行数据一拍稳定余量；held bus 与 Gray 指针加明确延迟/偏斜约束，避免全异步时钟例外掩盖真实路径。
2. 多目标结果：消费者在下一时钟沿看到寄存的 result_write；COMMIT_RESULT 保持旧槽号到该沿，再推进下一 ROI，避免第 0 槽漏写及后续错位。
3. 固件：按新的 CFG_APPLIED 连续接单，等待上一单 PS CONSUME；同配置不重复执行，空闲不因软件等待预算退出。
4. 时钟/打包：从 HWH 判定直连或 MMCM，保持 142.857 MHz 输入并核对；包目录拒绝覆盖，记录完整哈希。
5. PS 驱动：硬件提交配置后重新装载模型，恢复被硬件清除的有效标志；等当前序号的固件判定再读取计数。真实捕获、模拟计算与硬件计算在 trace 中区分。
6. 启动：systemd 依赖 bootpy，不再依赖两个固定 sleep 的并发脚本抢 PL。EXE 连接和输出记录有证据，但手动按钮核验和 CSV 未完成。

## 留后的理解题（未作答、未判定通过）

1. 如果请求/ACK 与并行 payload 同拍到达，为什么可能读到上一个地址的数据？
2. 为什么不能在拉高 result_write 的同拍立即切换 result_index？
3. 每次 CFG_COMMIT 后，为什么缓存“权重上次已装载”会导致下一单不启动？

## 验证与缺口

验证入口见 data/logs/2026-10-27-git-integration/README.md；旧共存包与多目标修复版本的实板边界见
docs/runbooks/pynq-coexist-handoff-2026-10-27.md。新包构建失败没有改写成 PASS。
本地生成包、Vivado 中间文件和临时探针保留本地；精选源码、运行结果及必要原图可用于后续复现。
