never-die-cold/FPGA-Alittle-Design/report/llm_log/2026-10-17-exe-scope-table-redesign.md

# 2026-10-17 协作记录：EXE 识别范围表改版与两轮布局评审

> 标签：#vision #架构决策
> 平台：ZCode（DeepSeek Flash） ｜ 相关 commit：`7335008` `9ceb7e6`
> 上下文：owner 板端联调后反馈两个前端问题；明确要求表格形态与"美观很重要"；评审图定稿后归档。

## 1. 任务与初始提示词

「1) 右下角 RUN INSPECTION 按钮无法交互（按了没反应）且放置意义不明；
2) 右上角状态显示栏遮挡画面——改成可交互表格：左类别 / 中勾选框（勾选 = 希望识别该类工件）/
右数目，FRESHNESS 在下；设计要考虑美观。」

## 2. 模型第一版方案

- 先诊断按钮：点击链路实际可用，"没反应"是反馈缺失（板端一轮约 2 分钟 + 零反馈 + 孤悬位置）；
- 表格落地：三行类别 + 勾选框 + 计数、行悬停高亮、RUN 三态反馈、勾选=本地显示过滤、
  T 序号保留原始编号、面板收窄并轻透明以减遮挡；勾选态用品牌青（绿色专属目标框，防测试污染）。

## 3. 失败现象

1. 第一轮评审（面板浮动视频右上、340px、轻透明）：owner 回复"这样的话右上角不还是遮挡画面吗？
   把它移到右侧边栏"——收窄/透明只是缓解，未解决；
2. 窄栏适配暴露具体问题：侧栏 264px 下按钮文字上限 236px（QUEUED · WAITING SLOT 放不下）、
   ROUND/REC 注记与标题同排放不下。

## 4. 纠错轨迹

| 轮次 | 喂回的信息 | 模型诊断 | 修改内容 | 验证结果 |
|:---|:---|:---|:---|:---|
| 1 | "按了没反应" | 逻辑可用、反馈缺失 | 按钮并入表内三态反馈 + 行悬停 + `manual_in_flight` 数据源 | 六关 PASS |
| 2 | "移到右侧边栏" | 浮动面板遮挡内容区，移出才是解决 | SCOPE→侧栏顶部 (264×246)；列表压缩 3 卡 + `+N more`；注记移第二行；按钮文案缩短为 QUEUED · WAITING / RUNNING | 六关 PASS，画面零遮挡（原先被盖的 T3 框可见） |

## 5. 最终结论

识别范围表落位右侧栏顶部，交互（勾选过滤/悬停/按钮三态）与布局均经 owner 两轮评审定稿；
打包六关全 PASS；设计记录与一键复现脚本归档 `data/logs/2026-10-17-exe-scope-redesign/`。

## 6. 经验沉淀

- 触发条件：用户说"按了没反应"；UI 元素遮挡关键内容；固定版式搬进窄容器。
- 排查步骤：先分"逻辑坏"还是"反馈坏"（bug-fix-playbook 第 1 条的交互版）；浮动面板遮挡
  → **移出内容区**（收窄/透明只是缓解）；窄容器适配逐项核文案宽度与换行。
- 适用范围：换题目/换板卡仍成立（交互三态反馈、绿色专属内容标记防断言污染、版式评审收敛）。
- #skill候选：**"按了没反应 = 先分逻辑坏/反馈坏（交互版）"** 与 **"面板不进内容区"**
  （可并入 big-rewrite-playbook 的视觉评审条）。
