never-die-cold/FPGA-Alittle-Design/report/llm_log/2026-10-14-c04-nc-review.md

# 2026-10-14 协作记录：C04离板评审准备

> 标签：#vision #架构决策；平台：Codex；基线：`dev/model@5654eb5`。

## 1. 任务与初始提示词

NC处于离板状态，盘点待办后要求continue；本步推进C04的Q1/Q3/Q5评审准备。

## 2. 方案与核对

对照C03 §8、服务/FILE引擎/EXE/记录源码及既有tb，交付可审阅建议和责任人缺口；纯文档，无代码理解门槛或提交动作。

## 3. 发现与纠正

C04仍将10件策略写成候选，但C03已冻结；仅同步事实，不代签应用确认。FILE默认策略16且超限空targets被映射为零计数，EXE据此显示缺件差额；登记WC待修项，不称已解决。

## 4. 验证与最终结论

四项专项PASS且退出0。前两项本机回环被沙箱拦截，保留失败后重跑通过；原始输出和源码指纹见[证据](../../data/logs/2026-10-14-c04-nc-review/README.md)。
改动：C04主文档、新[评审单](../../docs/c04-nc-review-2026-10-14.md)及本记录；Q1/Q3/Q5待确认，C04整体/真实LIVE/实机验收保持未完成。

后续NC本人明确确认Q1软件采集序号、不承诺UVC同帧；Q3本轮capture权威原帧；Q5超10统一复检、未完整计数标注、映射零值不计实测，并要求继续与JL对齐及修复后验收。原话保存在评审单；Q1/Q3确认完成，Q5保留JL待对齐/实现待验收。
用户明确授权与JL对齐后，经Git提交作者及仓库权限核对，以GitHub issue [#75](https://github.com/never-die-cold/FPGA-Alittle-Design/issues/75)指派LibJiang；实际请求/返回见证据issue-75.json，尚无JL答复。未向身份不明的本地chat发送消息。

## 5. 经验沉淀

最新冻结契约与实际默认参数必须分别核对；RECHECK不使未知数量自动成为实测零件数。文档准备与continue授权不替代本人决定或实机验收。
