never-die-cold/FPGA-Alittle-Design/report/llm_log/2026-10-17-exe-ring.md

# 2026-10-17 EXE 环接通（PC↔PYNQ 网络上 LIVE 服务全链）

> 板子重启后 owner 授权代工。一天内连过三环：C01 park 驱动（10-16）、CNN 上板（10-16）、
> 今天 PS→EXE 环经真实以太网接通。RISC-V 环仍 **未接入**（C03 J02）。

## 网络层

板端 eth0 重启后 UP（cron 配 169.254.87.99 + 192.168.2.99），但 PC 在 192.168.50.1/24
（原树莓派段）。方案：板端加 192.168.50.99/24（sudo 重认证后一条命令）→ PC ping 0% 丢包。
PC 侧坑：4 个 link-local 虚拟接口 + sing-tun tun0 干扰路由（用户已关 tun）。

## 服务层（W05 骨架 + park 后端）

`park_live_server.py`（v1→v7）：ParkCaptures 真实采集后端（每轮 flock→候选位流→
保护复制→capture.png→恢复 vision）+ numpy 引擎（locate→crop 64×64→折叠 FP32 CNN→
judge）。C04 §2.2 超限映射（>16 截断+counts=None）、v1.2 字段严格化（touches_border
只进 reasons）、pynq HTTP 线程 asyncio loop、pkill 自匹配（字符类技巧）——七版迭代
日志全留 `data/logs/2026-10-17-exe-ring/`。

联调：GET /v1/status 秒回；POST /v1/check **121.6 s 返回合法 v1.2 LIVE 包**
（16 目标 class/score、decision 完整、RECHECK reasons=[target_limit, touches_border]）。
EXE REQUEST_TIMEOUT 2→300 s（owner 授权过渡，`src/vision_client/rounds.py` 注明）。

## EXE 代工验收（owner 执行）

```powershell
C:/Users/ASUS/AppData/Local/Programs/Python/Python312/python.exe src/vision_client/preview.py --source 1 --endpoint http://192.168.50.99:8765
```

预期：UVC 画面 + 每轮 ~2 min 叠加 LIVE 框/标签/判定。RECHECK 属实（场景未构图）。

## 全链状态

真实相机→采集→定位/ROI→CNN（板上 numpy，对拍 torch 一致）→判定（PS 侧 judge，
prototype 口径）→**PS→EXE（HTTP，经网）** ✓。剩：**RISC-V 环 = C03 J02 SoC 集成 +
工业固件**（未实现）；prototype=false 需正式 N03 盖章；场景构图与工单定标属 M3。
