never-die-cold/FPGA-Alittle-Design/report/llm_log/2026-10-12-collection-readiness.md

# 采集规程与模板续步

2026-10-12，dev/model@3e2e1c9；用户要求continue，沿用离板范围。

## 设计与范围

- 先读workflow/技能、核对Git与计划/接口；上一轮全量PASS有效，当前主线缺口仍是安全取帧、真实数据与硬件网络。
- 本步将前轮审查的采集旧口径同步到执行件：分工、64×64、base/custom、session/light、示例实物及A3工具边界。
- 不改变实测门限或报文字段；示例仍要求交付前删除，不把文档同步当N04/N05或W01验收。
- Spreadsheets技能用于CSV：bundled Artifact Tool、操作标记、原样导入、两单元格修改、检查/渲染及CSV导出；复核15列及其余值保持一致。
- bundled Python缺cv2，保留失败日志；仓库既有校验器/测试用上一轮已验证的本机环境通过。

## 验证与门槛

命令、原始结果及生成前后记录见[证据](../../data/logs/2026-10-12-collection-readiness/README.md)。
纯文档/示例CSV记录改动适用古法编程豁免；未新增生产代码或产品测试，不进行新的代码理解题，未提交/推送。
未实现：custom DDR适配、正式INT8整网/CNN、核工业固件、真实硬件LIVE；未验收：真实工位定标/采集、完整N02–N05、C04及工业闭环。
