never-die-cold/FPGA-Alittle-Design/report/llm_log/2026-10-12-nc-offline-readiness.md

# 2026-10-12 协作记录：NC离板准备、C01复位与构建证据恢复

> 标签：#vision #build #bug修复 #证据 #NC
> 平台：Codex；基线dev/model@3e2e1c9。当前未提交。

## 1. 任务与初始提示词

用户：“现在是离板状态，continue执行我的应做事项”。按最新三人分工，NC管实机与最终验收；离板优先C01缺陷/证据、返板N02–N05准备及C04审查。
用户选择：“本轮快速模式，免逐步出题；提交前仍确认理解”。不把该选择当作提交前理解门槛豁免。
先读AGENTS/workflow、主计划/核计划与契约、三人清单、交接及相关技能，核对分支/最近5提交/干净状态后开工。

## 2. 设计与小步

1. Tcl复位检查/负例与两行接线修复，约55行代码；真实Vivado BD验证，不模拟Vivado API。
2. 构建输入审计与精确CRLF恢复，单文件少于100行；默认严格拒绝，显式新目录恢复，SHA/长度双重匹配。
3. 证据工具负例tb与统一Python入口，单步少于100行；docs/data/日志按记录类豁免，不实现JL/WC负责的整网/真实驱动。

## 3. 失败与纠错

| 轮次 | 原始现象 | 修正/判断 | 证据 |
|---|---|---|---|
| 1 | 早期子系统aux_reset_in接low，旧BD验证可PASS | 加实际极性/常量/四路接线检查后正确拒绝 | reset-before exit=1 |
| 2 | 修好接线，负例把C_EXT_RESET_HIGH改1；IP报只读，注入未生效 | 不算负例通过；改实际外部复位错误接线 | reset-after exit=1保留 |
| 3 | 正常/辅助极性/高低常量/外部辅助调试错误网 | 六例均拒绝、正确连线复查PASS并保存BD | reset-final exit=0 |
| 4 | 构建输入严格核对报PS配置SHA/大小不符 | 查到原37925与归档37064差861CR，Git原归档已规范化 | build-input-audit exit=1与diagnostic |
| 5 | 显式恢复到新目录，每条必须匹配原清单SHA/长度 | 98条精确一致，其中68条恢复CRLF；旧归档不改 | recovery exit=0 |
| 6 | 对恢复包再次默认严格核对 | 98条全部通过，无再次恢复；当前96相同/2包装脚本改变 | strict-recheck exit=0 |

所有输出在data/logs/2026-10-12-nc-offline；完整恢复包在data/evidence/2026-10-12-c01-exact-build-inputs，定向-text保护原字节。

## 4. 逐段讲解

check_capture_reset_release.tcl先从实际BD读取外部/辅助低有效极性，检查high=1/low=0，再比较外部PS复位、辅助high、dcm_locked high、调试low的实际网络。只有存在且匹配的网络才通过。负例修改实际IP属性或连线，捕获预期拒绝后恢复；最后复查正确设计。外部极性只读，不能假装改值成功。

validate_capture_subsystem.tcl把辅助复位从low移到high，调试复位仍接low；BD基础验证之后再跑上述检查。reset_tests参数执行矩阵并保存恢复正确的BD，不打开硬件目标或生成bit。

audit_c01_build_inputs.py逐条校验归档路径、去重、字节数和SHA256。默认任何不匹配都失败。--recover-to只接受仓库内新目录，尝试CRLF恢复，但候选必须同时满足原清单SHA与大小；否则失败，不覆写旧证据。全部输入成功后才复制清单；失败的部分目录不能当完整包。当前源码漂移和归档完整性分别报告，不能把新包装器归因给旧构建。该工具不证明bit/源码映射或板上功能。

test_c01_build_inputs.py在sim/build内新夹具目录造已知CRLF/LF、篡改和路径负例，断言默认拒绝、显式恢复逐字节等于原文、再严格通过、旧目录拒覆盖、旧归档不改、当前漂移如实列出。接入run_vision_python.sh后14组通过。

所有权候选文档要求完成事件与稳定槽对应、写事务完成和复制窗口保护、cache同步、独立副本、唯一租约/幂等释放及代次失效。软件锁只能阻止软件竞争，不能阻止硬件环绕写槽。没有真实实现/实测之前不冻结或勾选N03。

## 5. 提交前理解题（待用户回答）

① aux_reset_in低有效时接0为何会持续复位？为什么检查必须读取实际BD的极性、常量和连线？
② 68个文件恢复CRLF后，必须同时满足哪些条件才能纳入证据包？这能否证明bit来自当前源码？
③ stream_seq增长、UVC画面正常为何都不能证明某个DDR槽可供PS安全复制？软件锁能否阻止VDMA环绕覆盖？

### 用户回答（2026-10-13）

**① 低有效复位接 0 会持续复位：** “低有效”就是 0 表示请求复位，1 才表示撤销复位；因此接常量 0 相当于一直按住复位键，时钟正常也不能解除这个请求。检查必须同时读取实际 BD 的三件事：极性（该输入究竟是低有效还是高有效）、常量值（连接的常量块实际输出多少）、连线（复位引脚实际连到了哪个输出）；只检查脚本文字或信号名字，可能漏掉工程参数或接线偏差。仓库记录的失败组合正是 C_AUX_RESET_HIGH=0、低有效输入接 0。

**② CRLF 恢复纳入证据包的条件：** 不能仅凭“恢复了 CRLF”纳入。必须满足：每个恢复文件的 SHA256 和字节数同时匹配原始构建清单；全部 98/98 项通过、命令正常结束，失败留下的部分目录不能算完整包；原清单逐字节保留，旧归档和失败记录保留，恢复写入新目录；无路径越界、重复条目或其他内容变化，并用定向 -text 防止 Git 再次转换行尾。这只能证明归档输入与原清单的字节一致，不能独立证明 bit 来自当前源码。当前记录中 96 项一致，两个构建包装脚本已有后续变化；还需要把实际构建输入、构建过程和产出的 bit 建立可追溯关联，bit/hwh/XSA 配对也不能单独替代这条关联。

**③ stream_seq / UVC 不能授权 PS 复制 DDR 槽：** stream_seq 说明监控到几何完整的流握手，没有证明 DDR 写事务完成，也没有原子绑定完成槽号；DMA 停止时仍可能握手后丢弃数据。UVC 正常说明显示支路工作，而显示支路独立于 DDR 捕获。PS 安全复制需要证明：确定的槽已完整写完、相关写事务已完成、整个缓存同步和复制期间不会再次被 DMA 写入；随后才能 invalidate 缓存，复制到独立 PS 内存供下游使用。软件锁不能阻止 VDMA 环绕覆盖——锁只约束遵守它的软件线程，VDMA 不读取 Python 锁；复制慢于一圈时可能前半帧来自旧图、后半帧来自新图，必须建立实际有效的 DMA 停写或槽保护机制。

### 判定（2026-10-13）

三题回答与仓库证据一致，引用复核通过：① 对应 c01-capture-implementation-baseline 的 C_AUX_RESET_HIGH=0、低有效接 0 记录；② 对应恢复包 README 的 98/98 严格复算与“不独立证明 bit 来源”边界；③ 对应 c01-ddr-frame-ownership-v0.md“Python 锁不能阻止 DMA 覆盖、先证明槽再复制”。判定 **3/3 通过**，理解门槛完成，解除“禁止 commit”；本轮离板内容于 2026-10-13 提交入库。

## 6. 结论与经验

实际复位缺陷已离板修复；正常+6负例、14组Python、98条输入严格复算、现存候选artifact配对通过。未改RTL，未重跑未变化核的CoreMark，未操作硬件。
状态/准备文档已更新；N02–N05实机、custom DDR/真实颜色动态长测、CNN/正式INT8/核工业固件/真实硬件LIVE均未完成。
证据文本的Git行尾策略必须与哈希承诺一致；恢复只能匹配既有摘要并写新副本，不能通过重算清单把损坏证据“变正确”。
