never-die-cold/FPGA-Alittle-Design/data/evidence/2026-10-10-offline-inspection/viewer-exe.png

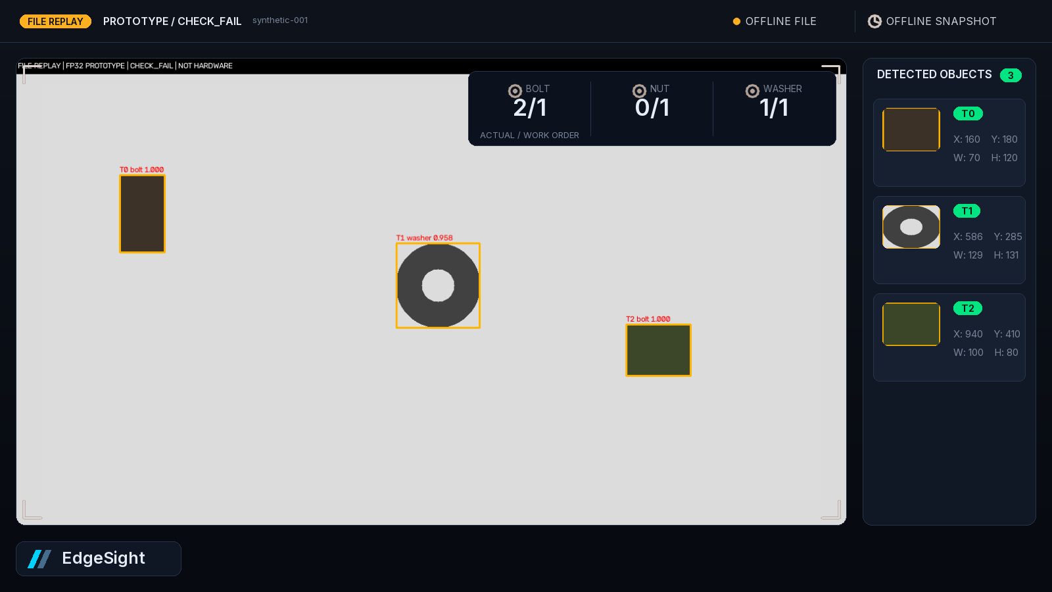
data/evidence/2026-10-10-offline-inspection/viewer-exe.png
