never-die-cold/FPGA-Alittle-Design/data/evidence/2026-10-28-web-hud-shots/02-run-queued.png

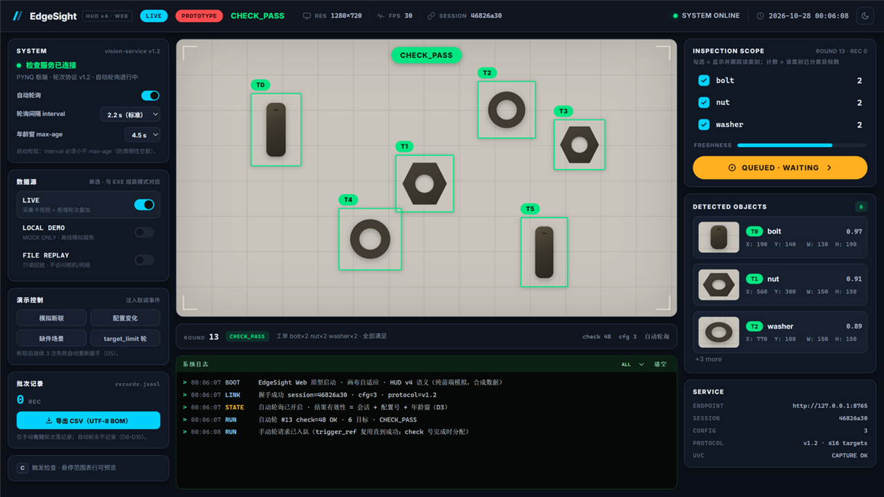
data/evidence/2026-10-28-web-hud-shots/02-run-queued.png
