never-die-cold/FPGA-Alittle-Design/data/evidence/2026-10-28-web-hud-shots/09-responsive-1366.png

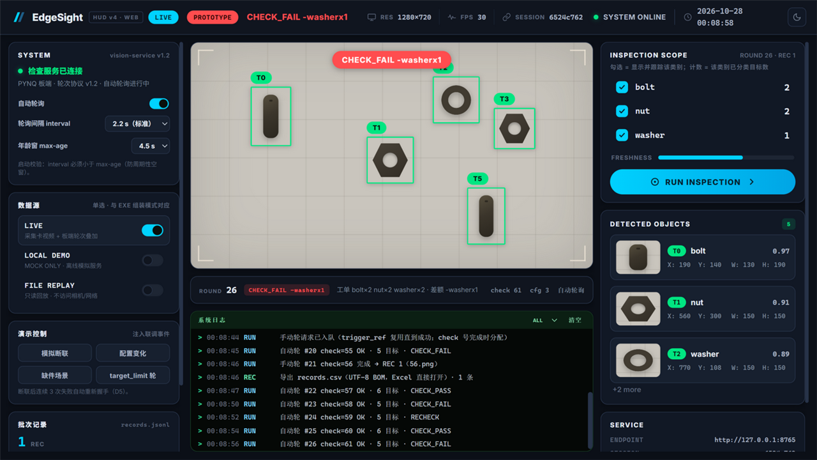
data/evidence/2026-10-28-web-hud-shots/09-responsive-1366.png
