never-die-cold/FPGA-Alittle-Design/data/logs/2026-10-02-vision-offboard/preview-mock.png

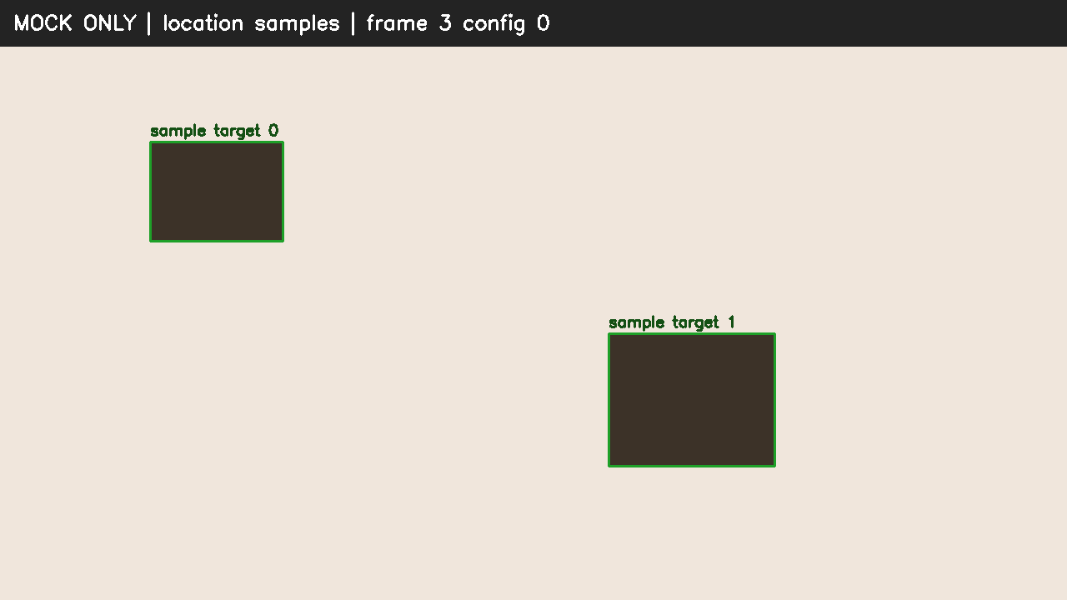
data/logs/2026-10-02-vision-offboard/preview-mock.png
