never-die-cold/FPGA-Alittle-Design/data/logs/2026-10-03-vision-onboard/capture_idx1_1.png

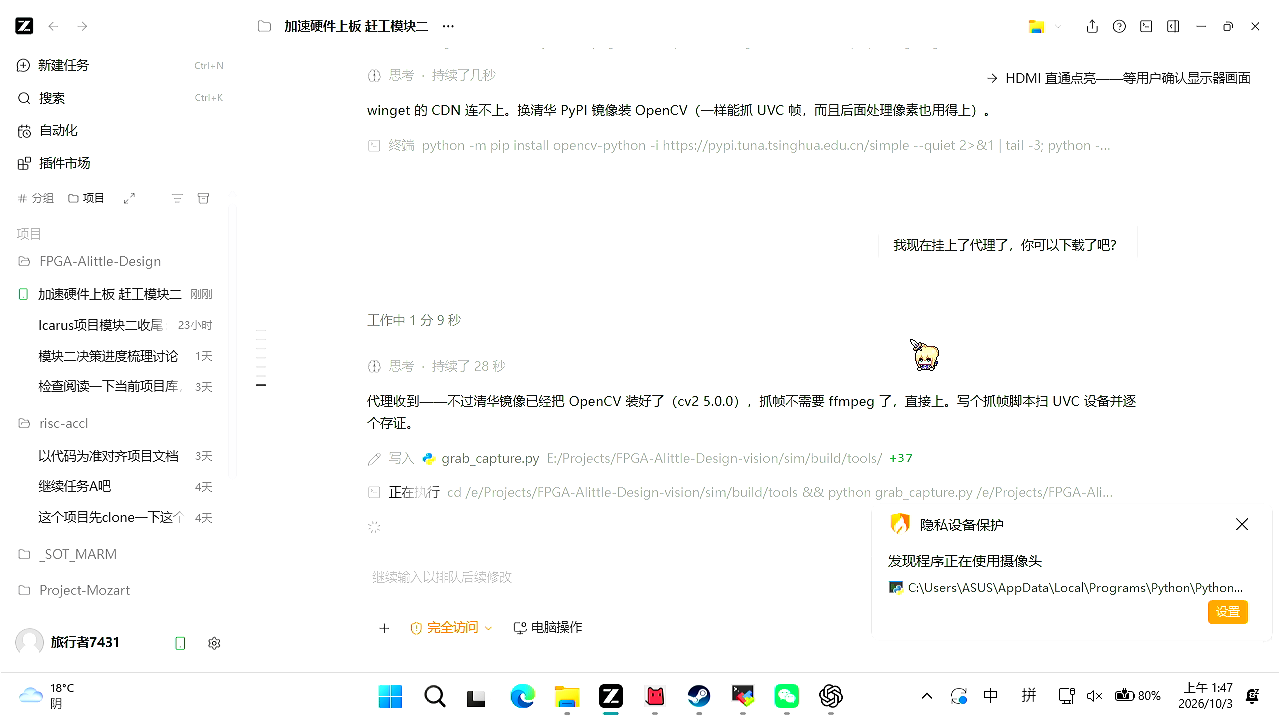
data/logs/2026-10-03-vision-onboard/capture_idx1_1.png
