never-die-cold/FPGA-Alittle-Design/data/logs/2026-10-03-vision-onboard/capture_postfix_0.png

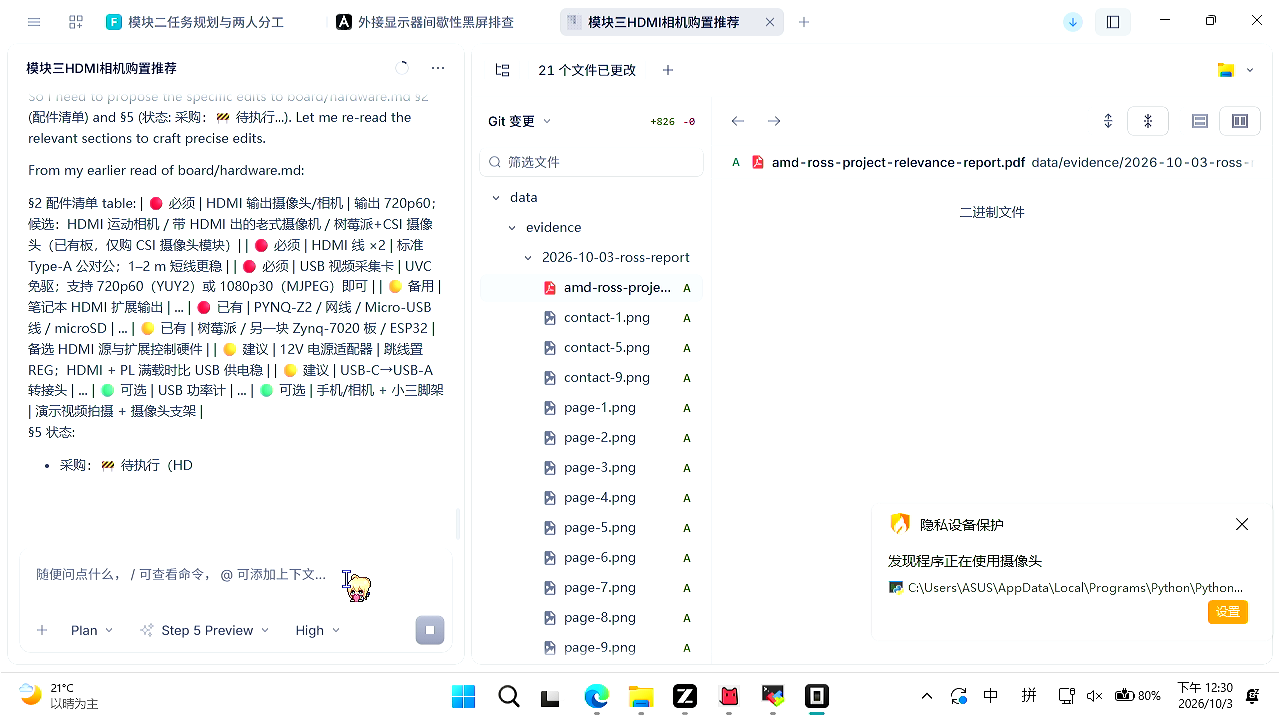
data/logs/2026-10-03-vision-onboard/capture_postfix_0.png
