never-die-cold/FPGA-Alittle-Design/data/logs/2026-10-03-vision-onboard/exe_preview.png

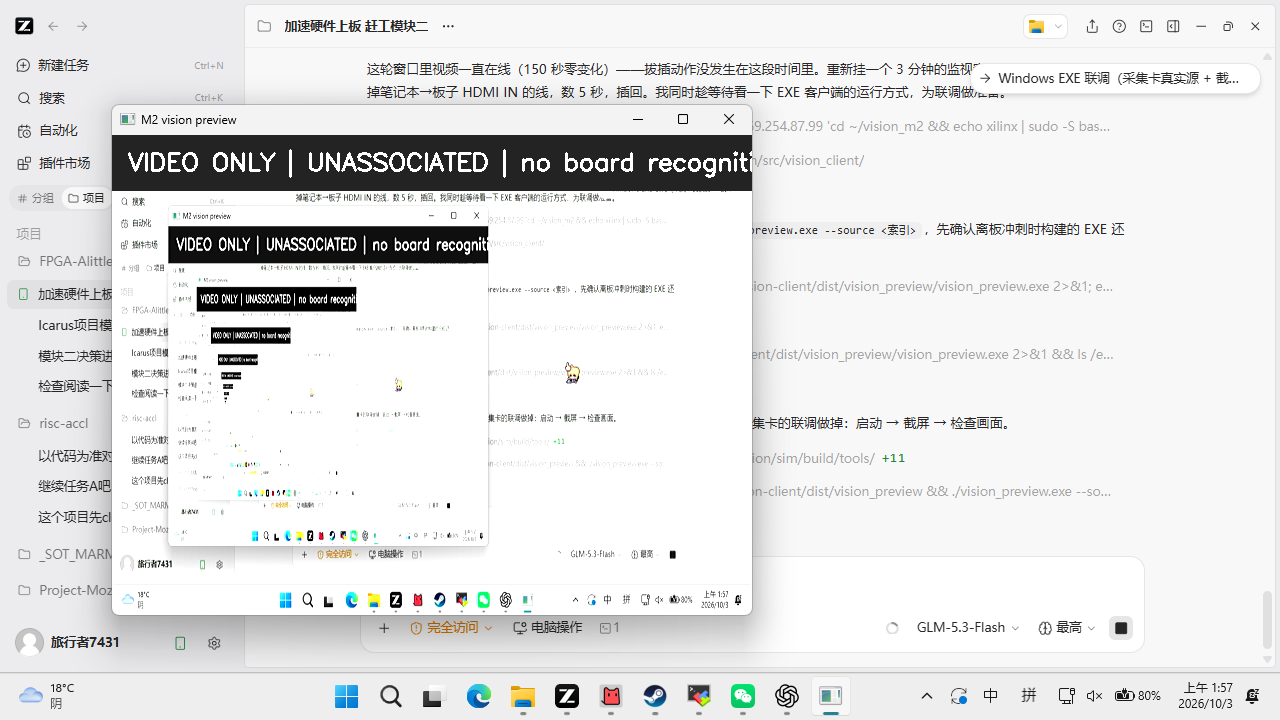
data/logs/2026-10-03-vision-onboard/exe_preview.png
