never-die-cold/FPGA-Alittle-Design/data/logs/2026-10-03-vision-onboard/probe/probe_0003.png

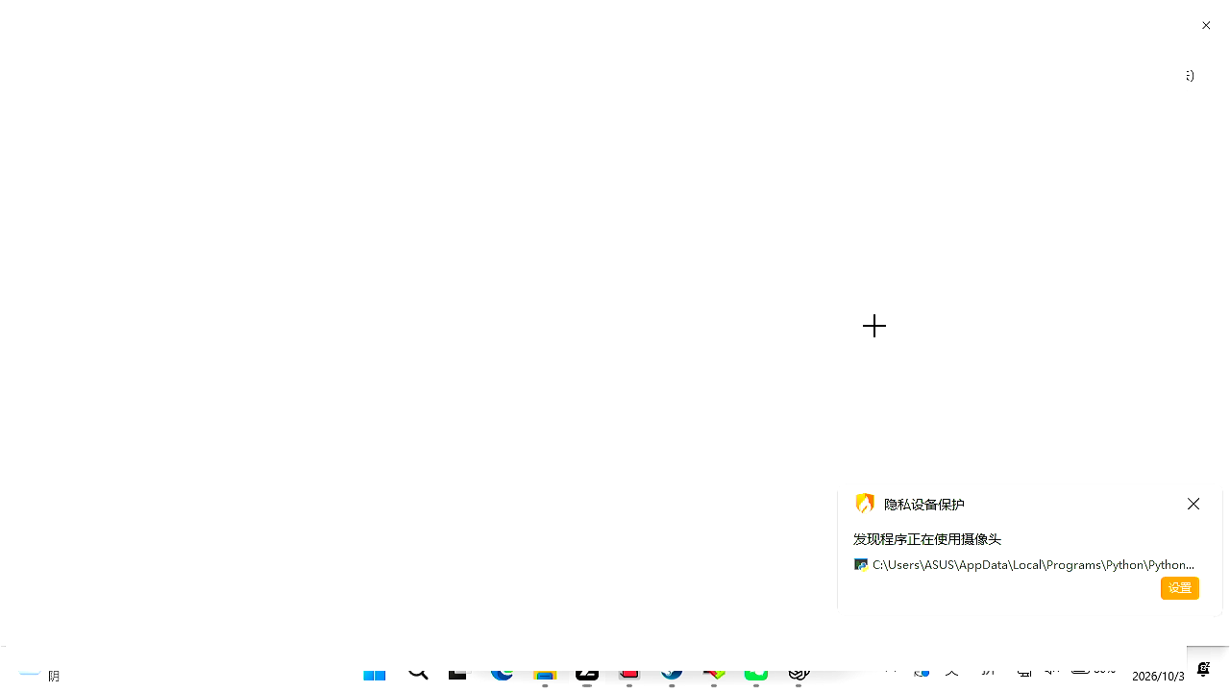
data/logs/2026-10-03-vision-onboard/probe/probe_0003.png
