never-die-cold/FPGA-Alittle-Design/data/logs/2026-10-06-pi-boot/camera-720p-corruption.png

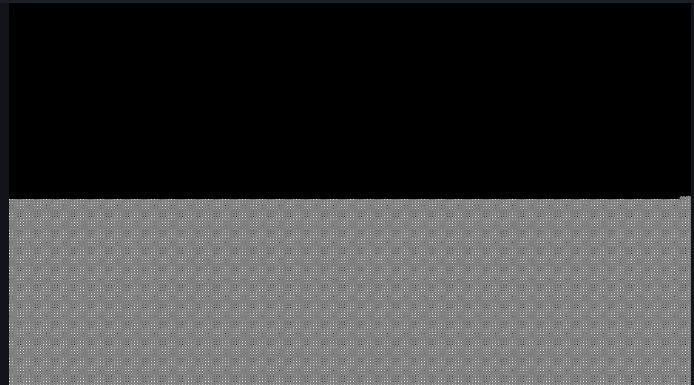
data/logs/2026-10-06-pi-boot/camera-720p-corruption.png
