never-die-cold/FPGA-Alittle-Design/data/logs/2026-10-06-pi-boot/camera-check-source0.png

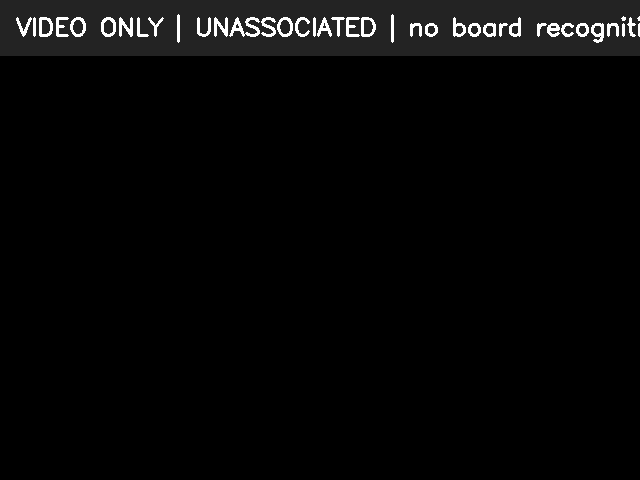
data/logs/2026-10-06-pi-boot/camera-check-source0.png
