never-die-cold/FPGA-Alittle-Design/data/logs/2026-10-06-pi-boot/hdmi-live-native.png

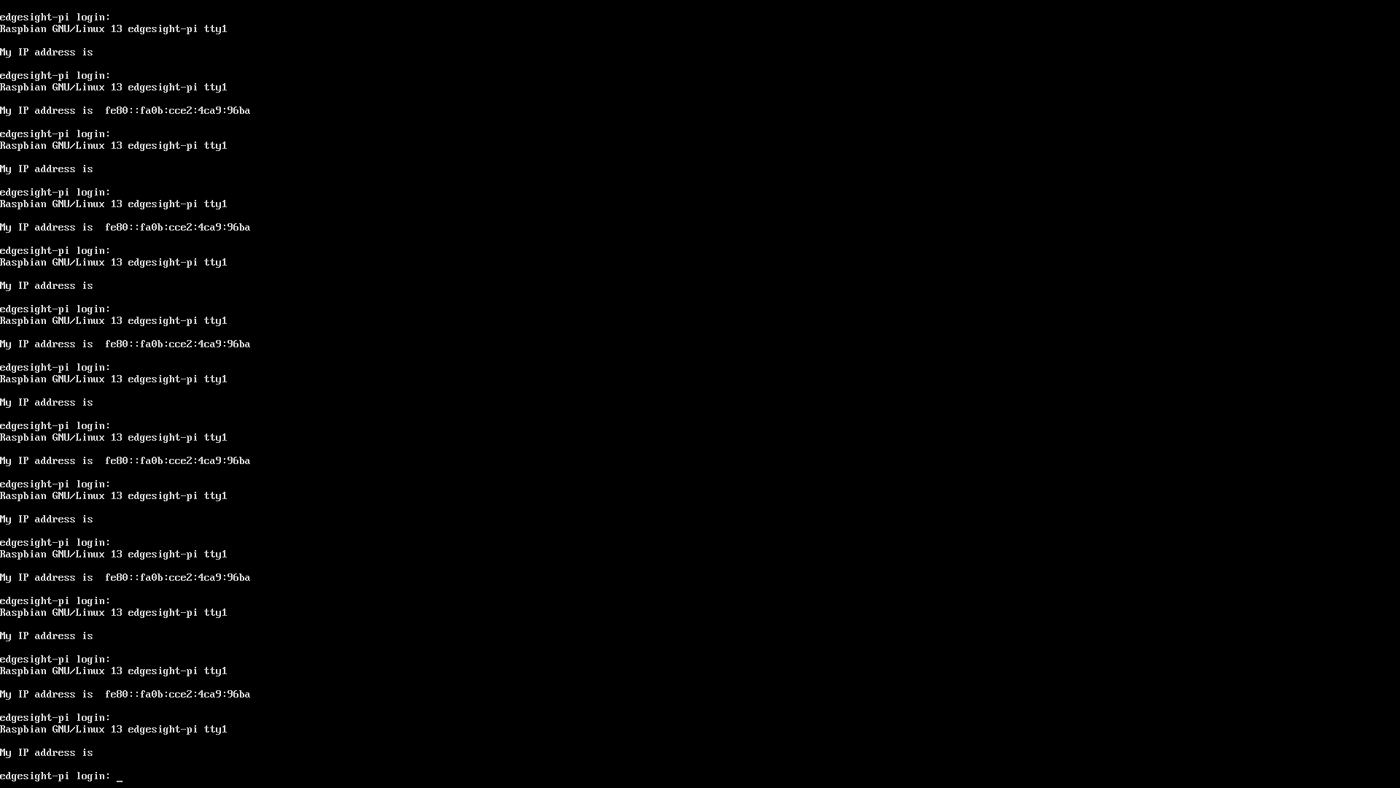
data/logs/2026-10-06-pi-boot/hdmi-live-native.png
