never-die-cold/FPGA-Alittle-Design/data/logs/2026-10-07-pi-pynq/capture-exclusive-720p-first.png

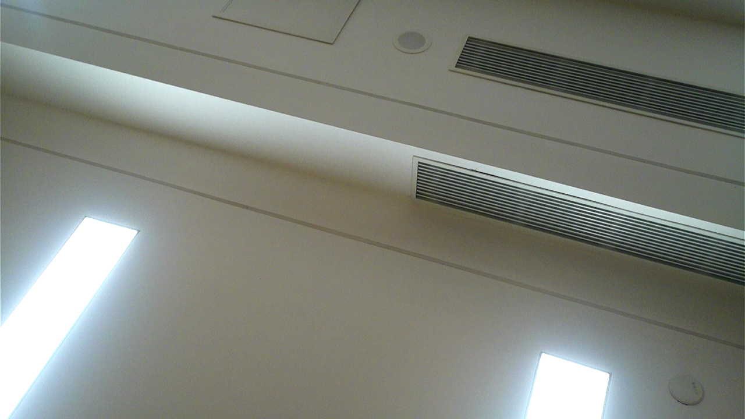
data/logs/2026-10-07-pi-pynq/capture-exclusive-720p-first.png
