never-die-cold/FPGA-Alittle-Design/data/logs/2026-10-08-exe-ui-design/03_proposal_waiting.png

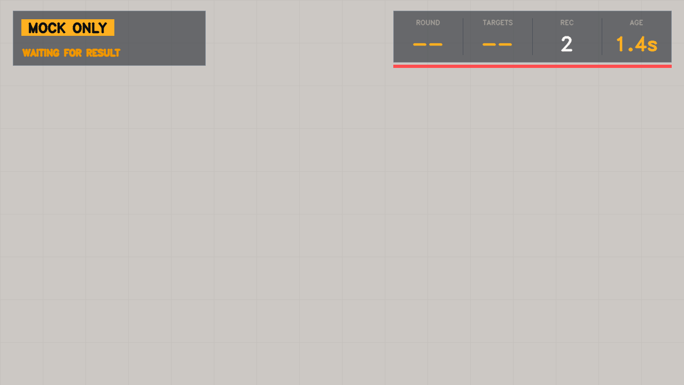
data/logs/2026-10-08-exe-ui-design/03_proposal_waiting.png
