never-die-cold/FPGA-Alittle-Design/data/logs/2026-10-09-exe-export-cjk/cjk_sample.png

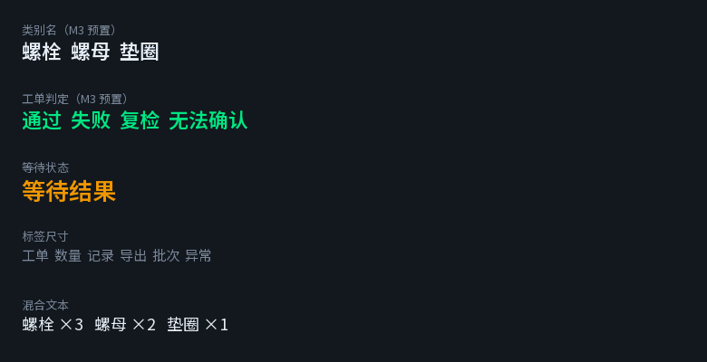
data/logs/2026-10-09-exe-export-cjk/cjk_sample.png
