never-die-cold/FPGA-Alittle-Design/data/logs/2026-10-09-exe-hud-implementation/04_waiting_state.png

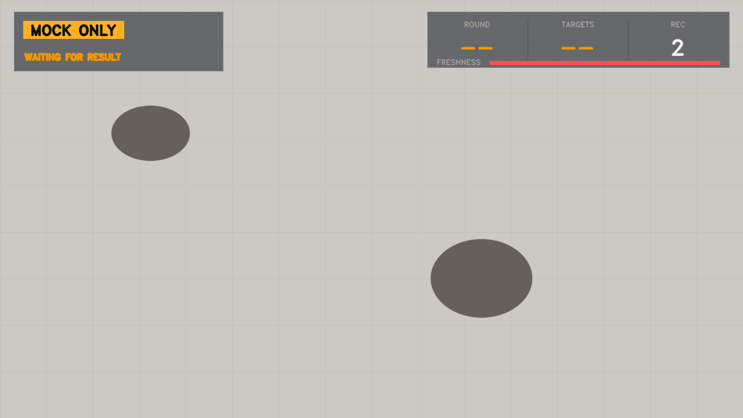
data/logs/2026-10-09-exe-hud-implementation/04_waiting_state.png
