never-die-cold/FPGA-Alittle-Design/data/logs/2026-10-09-exe-hud-v4/02_endpoint_ok.png

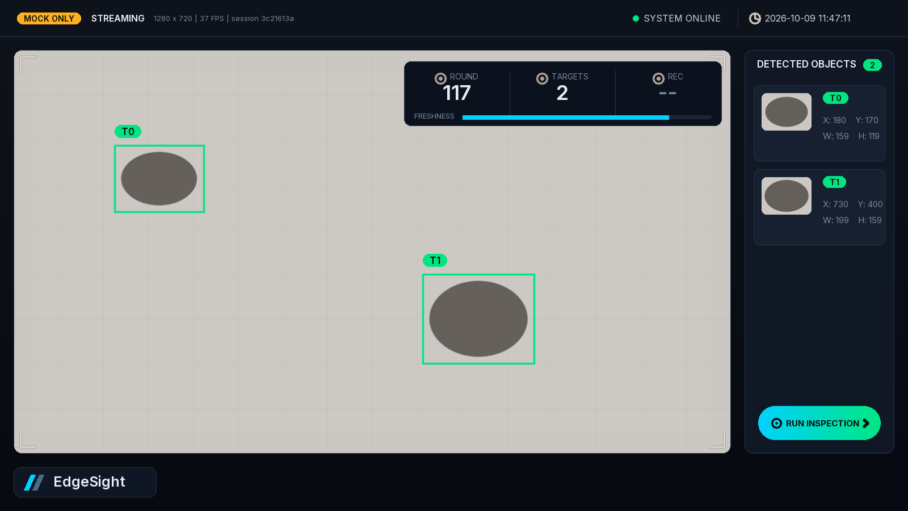
data/logs/2026-10-09-exe-hud-v4/02_endpoint_ok.png
