never-die-cold/FPGA-Alittle-Design/data/logs/2026-10-09-exe-hud-v4/05_uvc_only.png

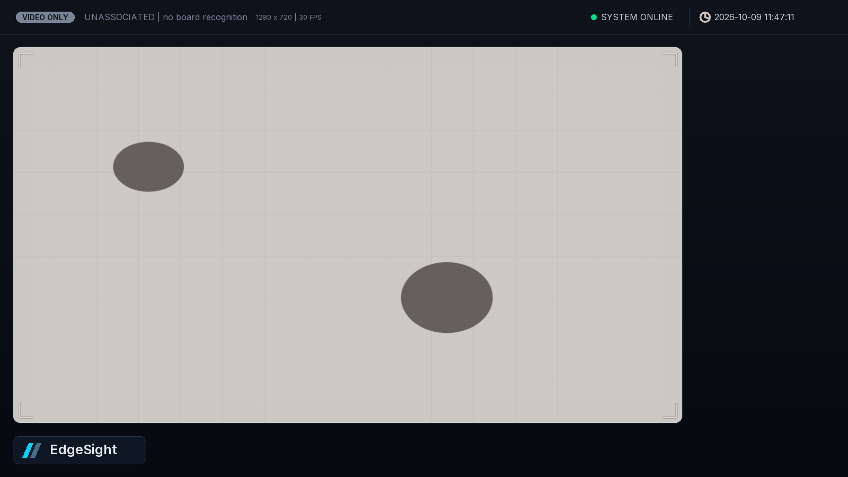
data/logs/2026-10-09-exe-hud-v4/05_uvc_only.png
