never-die-cold/FPGA-Alittle-Design/data/logs/2026-10-11-c01-capture-rtl/uvc-final-original-restored/raw.png

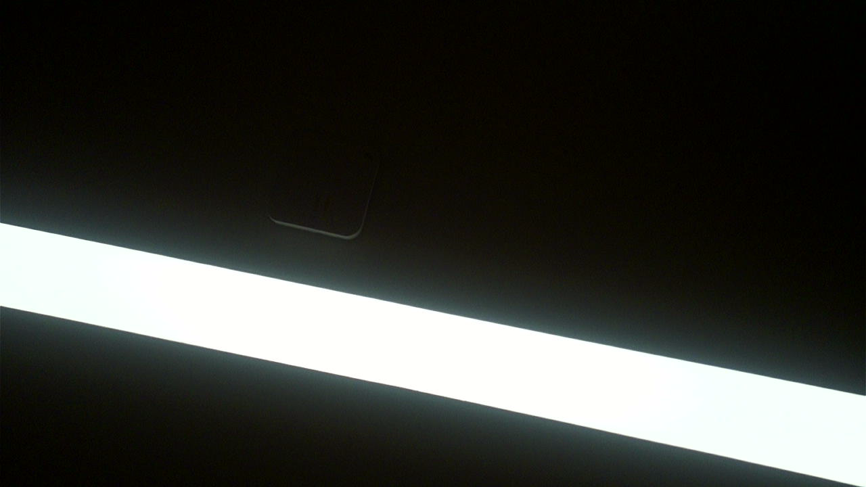
data/logs/2026-10-11-c01-capture-rtl/uvc-final-original-restored/raw.png
