never-die-cold/FPGA-Alittle-Design/data/logs/2026-10-11-c01-capture-rtl/uvc-recovery-original/raw.png

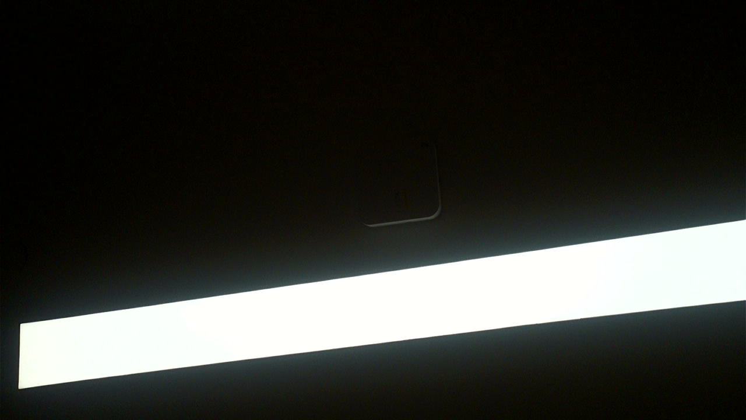
data/logs/2026-10-11-c01-capture-rtl/uvc-recovery-original/raw.png
