never-die-cold/FPGA-Alittle-Design/data/logs/2026-10-12-n02-extended/uvc-01/raw.png

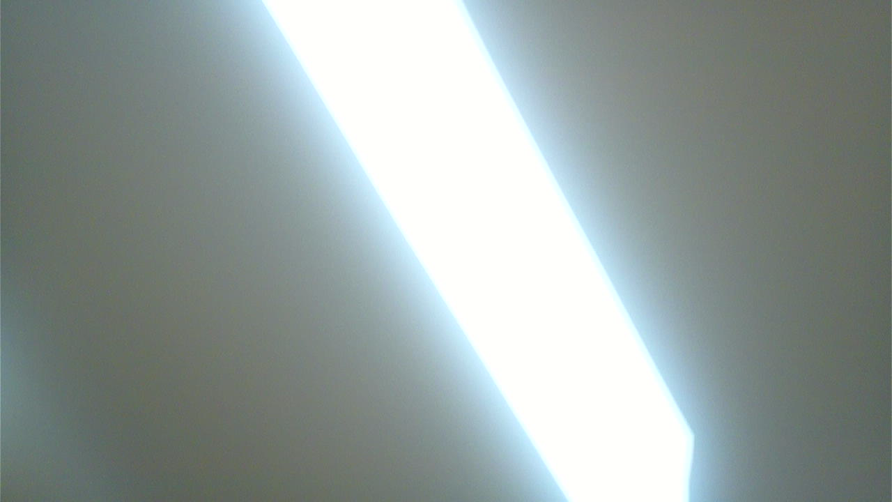
data/logs/2026-10-12-n02-extended/uvc-01/raw.png
