never-die-cold/FPGA-Alittle-Design/data/logs/2026-10-12-n03-base-return/board-raw.png

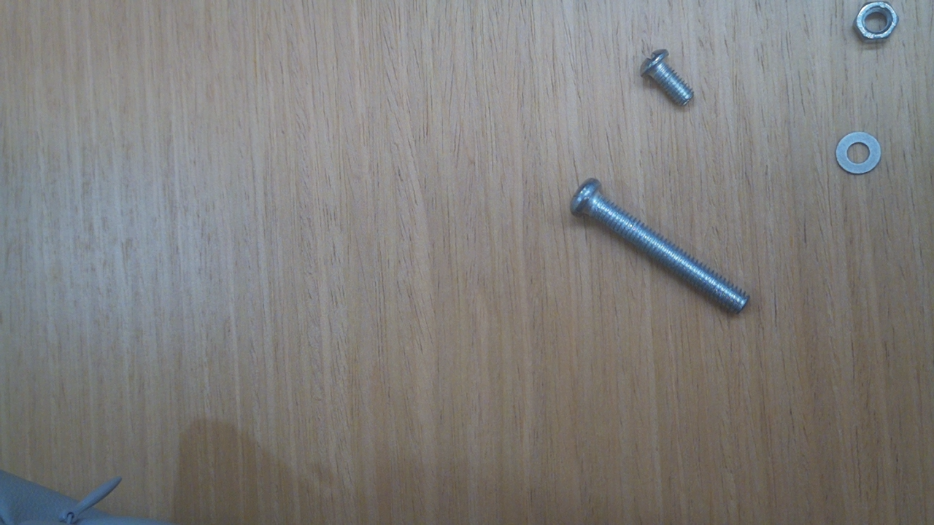
data/logs/2026-10-12-n03-base-return/board-raw.png
