never-die-cold/FPGA-Alittle-Design/data/logs/2026-10-12-real-frame-prototype/viewer.png

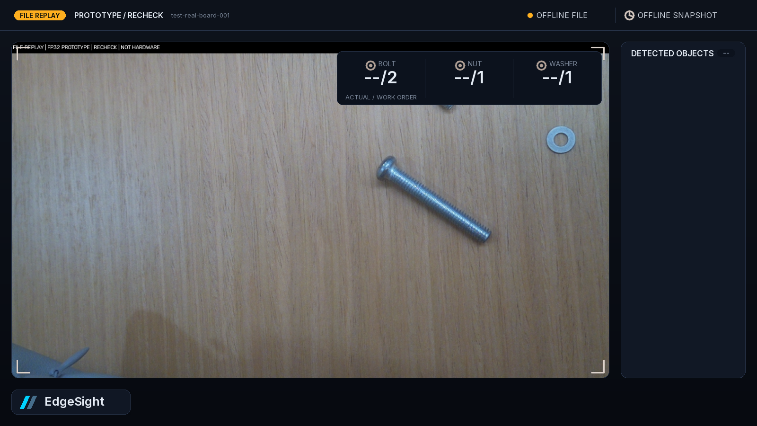
data/logs/2026-10-12-real-frame-prototype/viewer.png
