never-die-cold/FPGA-Alittle-Design/data/logs/2026-10-15-c01-direct-capture-stage/uvc-final-original/raw.png

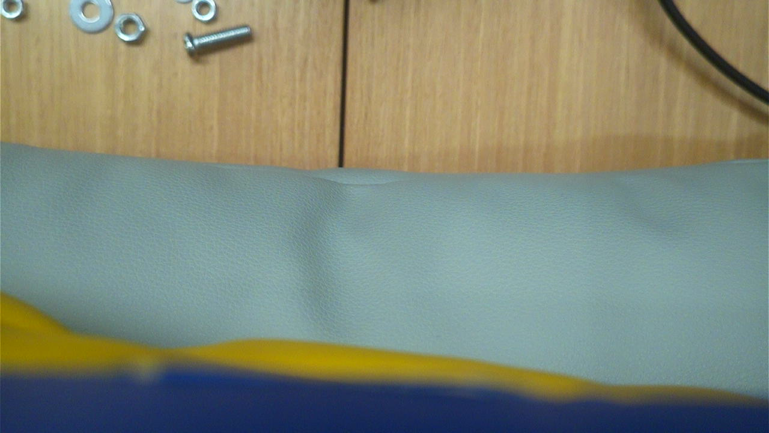
data/logs/2026-10-15-c01-direct-capture-stage/uvc-final-original/raw.png
