never-die-cold/FPGA-Alittle-Design/data/logs/2026-10-15-onboard-n02-n03/uvc-watch/raw.png

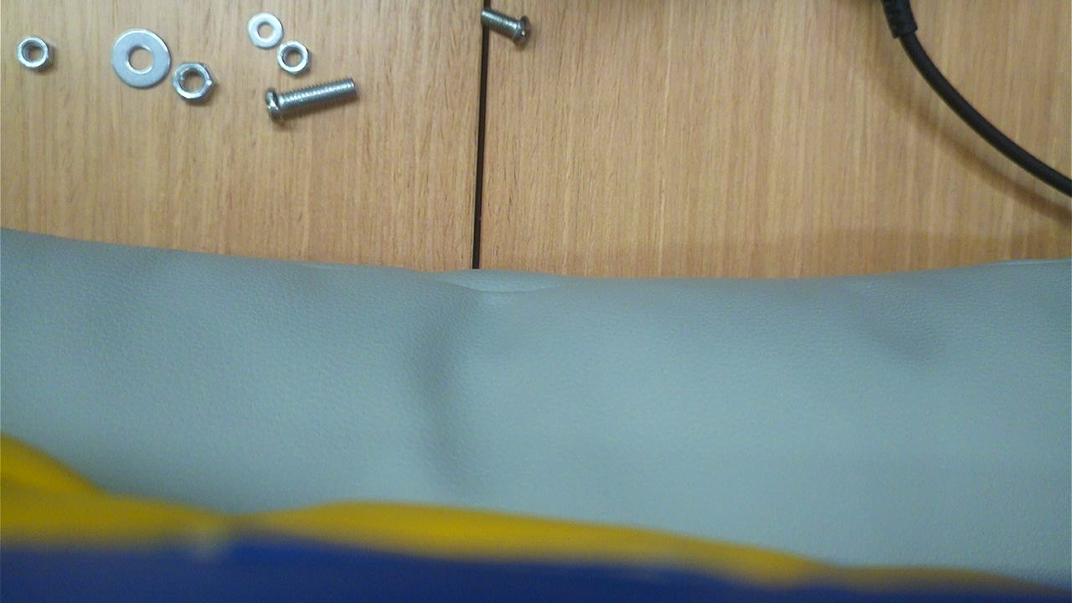
data/logs/2026-10-15-onboard-n02-n03/uvc-watch/raw.png
