never-die-cold/FPGA-Alittle-Design/data/logs/2026-10-16-c01-park-first-board/uvc-final-original/raw.png

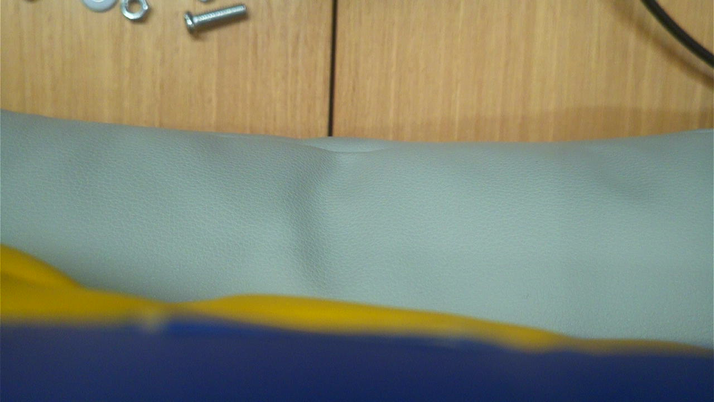
data/logs/2026-10-16-c01-park-first-board/uvc-final-original/raw.png
