never-die-cold/FPGA-Alittle-Design/data/logs/2026-10-17-exe-scope-redesign/scope-live-all.png

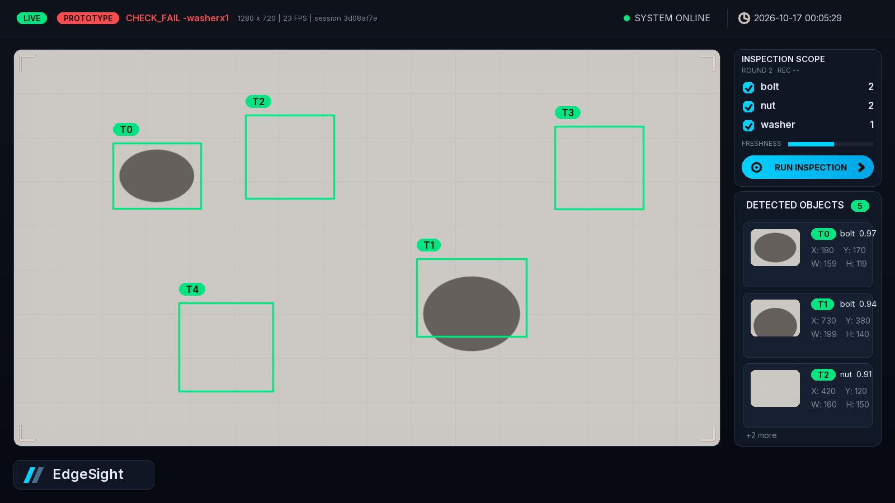
data/logs/2026-10-17-exe-scope-redesign/scope-live-all.png
