never-die-cold/FPGA-Alittle-Design/data/logs/2026-10-27-concurrent-agent-audit/uvc-pi-direct/raw.png

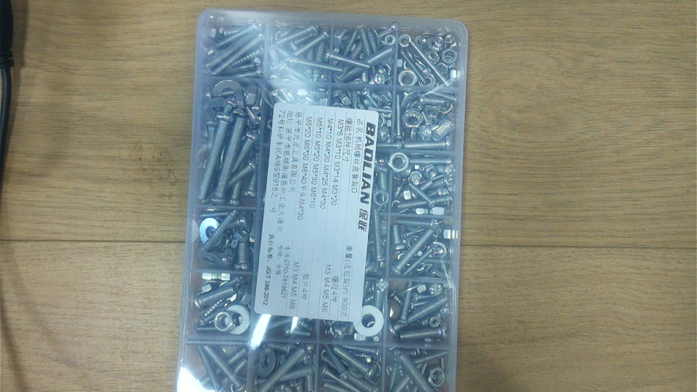
data/logs/2026-10-27-concurrent-agent-audit/uvc-pi-direct/raw.png
