never-die-cold/FPGA-Alittle-Design/data/logs/2026-10-27-fresh-board-start/model-comparison-r1/roi-grid.png

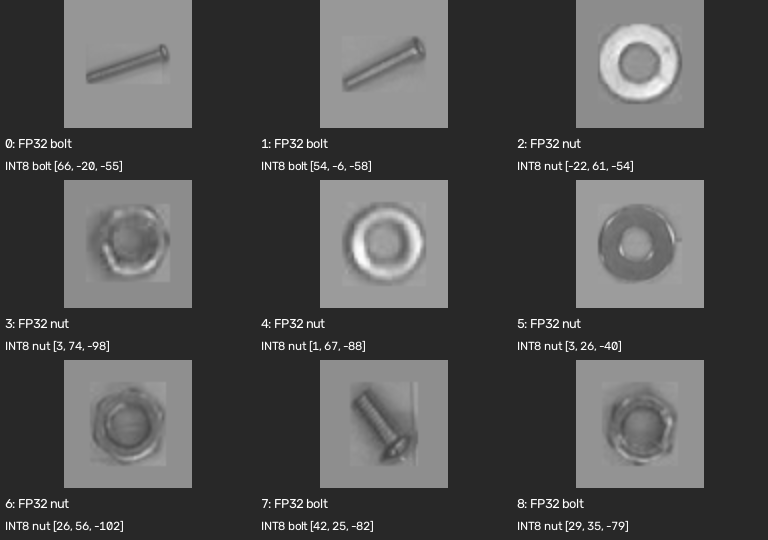
data/logs/2026-10-27-fresh-board-start/model-comparison-r1/roi-grid.png
