never-die-cold/FPGA-Alittle-Design/data/logs/2026-10-27-fresh-board-start/uvc-counts-333/raw.png

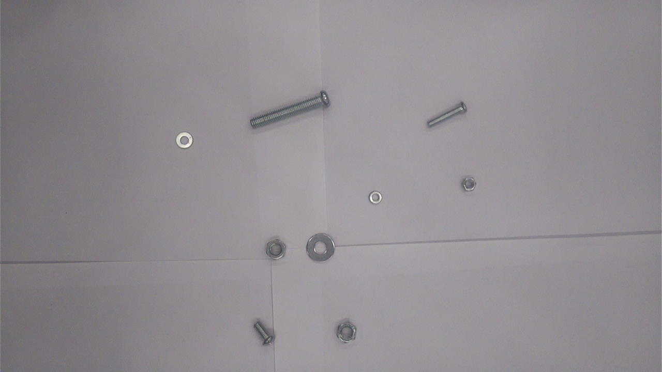
data/logs/2026-10-27-fresh-board-start/uvc-counts-333/raw.png
