never-die-cold/FPGA-Alittle-Design/data/logs/2026-10-27-product-coexist/board-rounds-r1/check-000001/capture.png

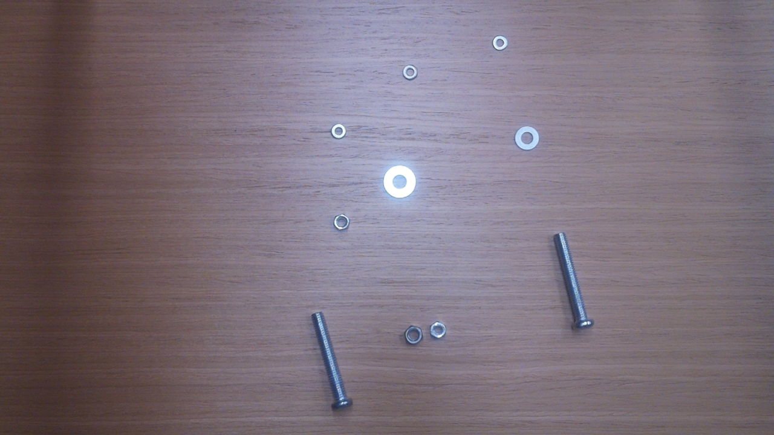
data/logs/2026-10-27-product-coexist/board-rounds-r1/check-000001/capture.png
