never-die-cold/FPGA-Alittle-Design/data/logs/2026-10-27-product-coexist/exe-r1-records/screenshots/anomaly_0001.png

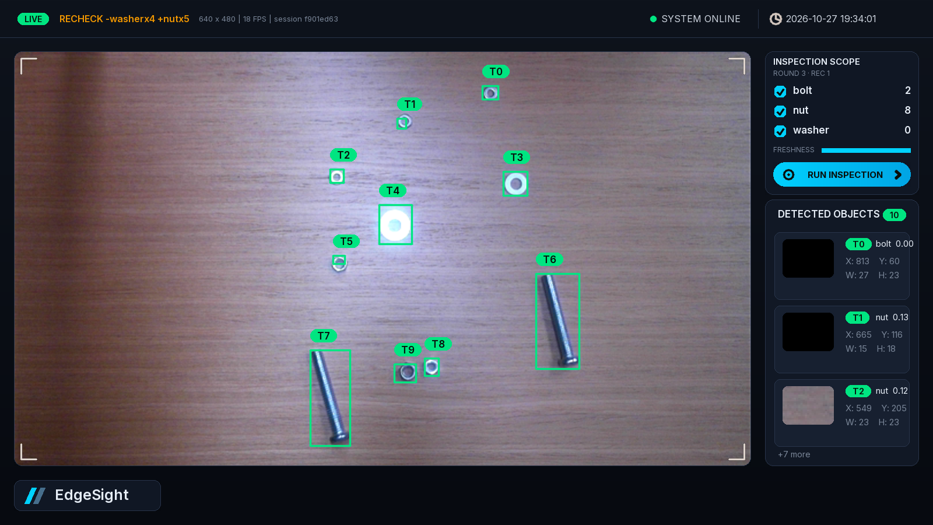
data/logs/2026-10-27-product-coexist/exe-r1-records/screenshots/anomaly_0001.png
