never-die-cold/FPGA-Alittle-Design/data/logs/2026-10-27-product-coexist/exe-r1-screen.png

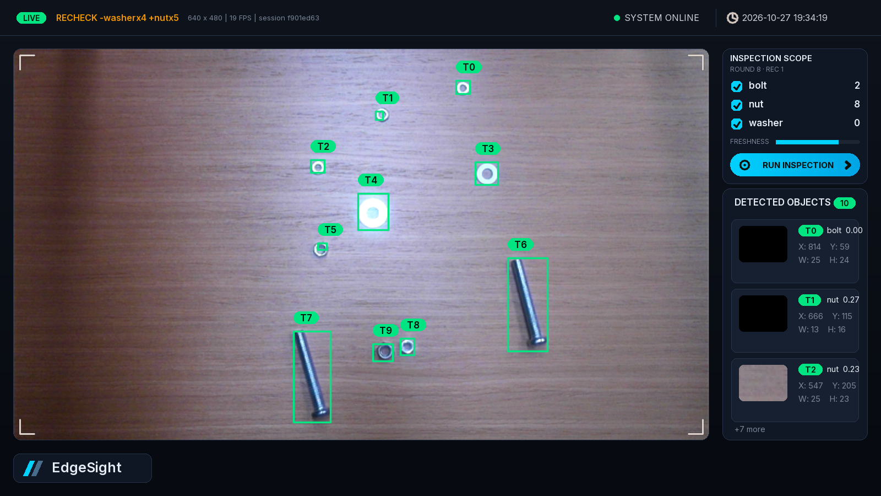
data/logs/2026-10-27-product-coexist/exe-r1-screen.png
