never-die-cold/FPGA-Alittle-Design/data/logs/2026-10-27-product-coexist/exe-r2-records/screenshots/anomaly_0002.png

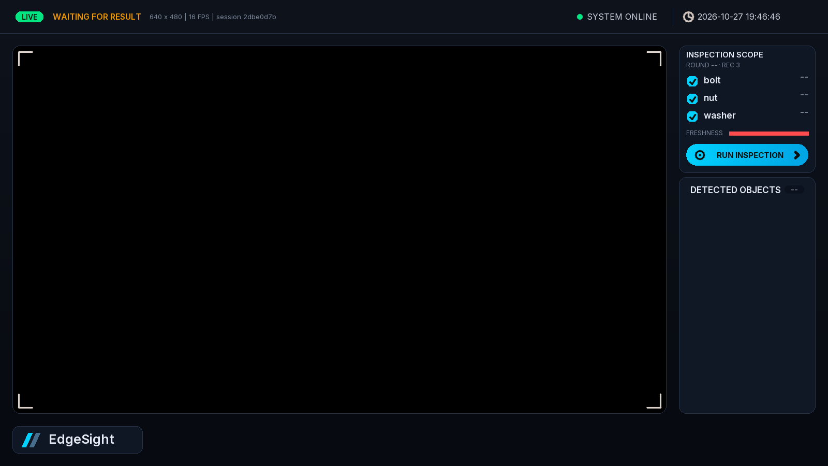
data/logs/2026-10-27-product-coexist/exe-r2-records/screenshots/anomaly_0002.png
