never-die-cold/FPGA-Alittle-Design/data/logs/2026-10-27-real-data-layout-03/adapted-complete/roi-grid.png

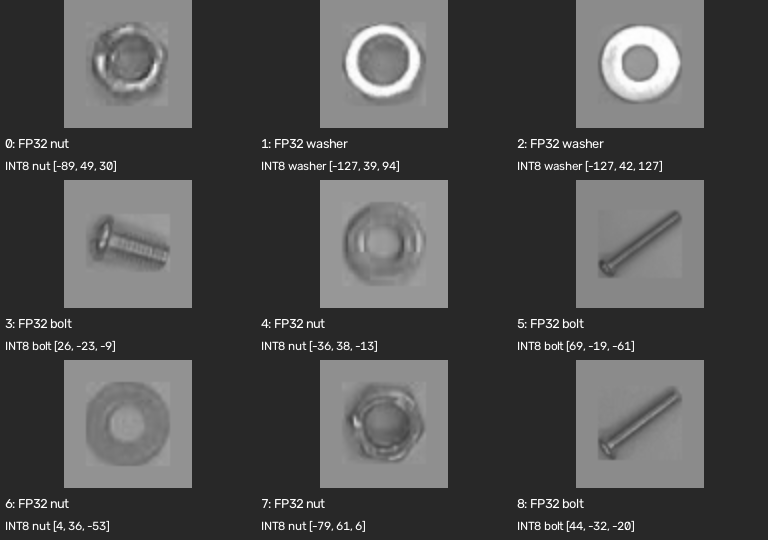
data/logs/2026-10-27-real-data-layout-03/adapted-complete/roi-grid.png
