never-die-cold/FPGA-Alittle-Design/data/logs/2026-10-27-real-data-layout-03/original-model/roi-grid.png

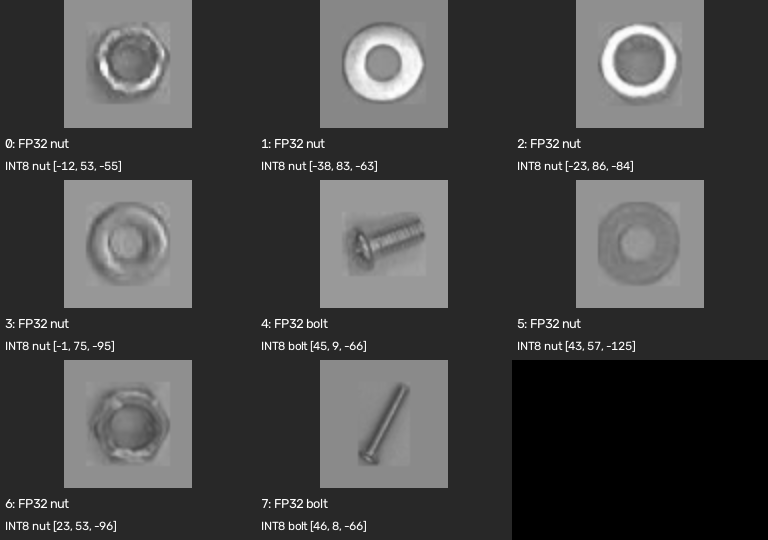
data/logs/2026-10-27-real-data-layout-03/original-model/roi-grid.png
