never-die-cold/FPGA-Alittle-Design/data/logs/2026-10-27-real-data-layout-03/uvc-complete/raw.png

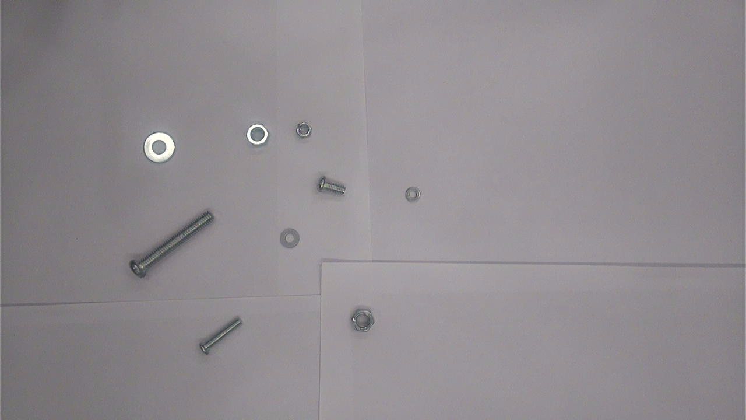
data/logs/2026-10-27-real-data-layout-03/uvc-complete/raw.png
