never-die-cold/FPGA-Alittle-Design/data/logs/2026-10-28-mixed-standing-r6/comparison/roi-grid.png

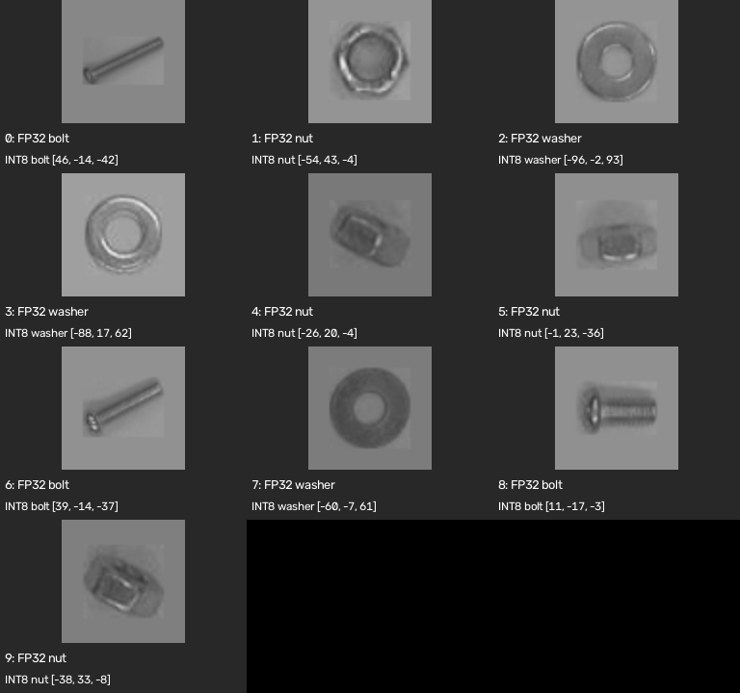
data/logs/2026-10-28-mixed-standing-r6/comparison/roi-grid.png
