never-die-cold/FPGA-Alittle-Design/data/logs/2026-10-28-multitarget-board-r6/board-evidence/live/1960f427/check-000002/capture.png

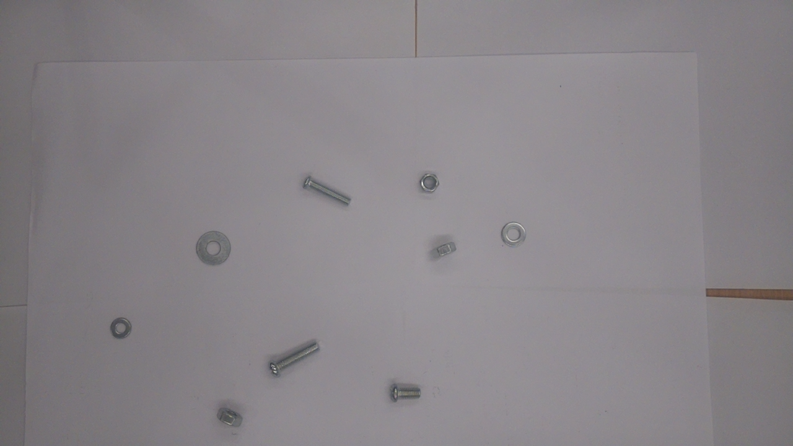
data/logs/2026-10-28-multitarget-board-r6/board-evidence/live/1960f427/check-000002/capture.png
