never-die-cold/FPGA-Alittle-Design/data/logs/2026-10-28-standing-nut/before-training/numbered.png

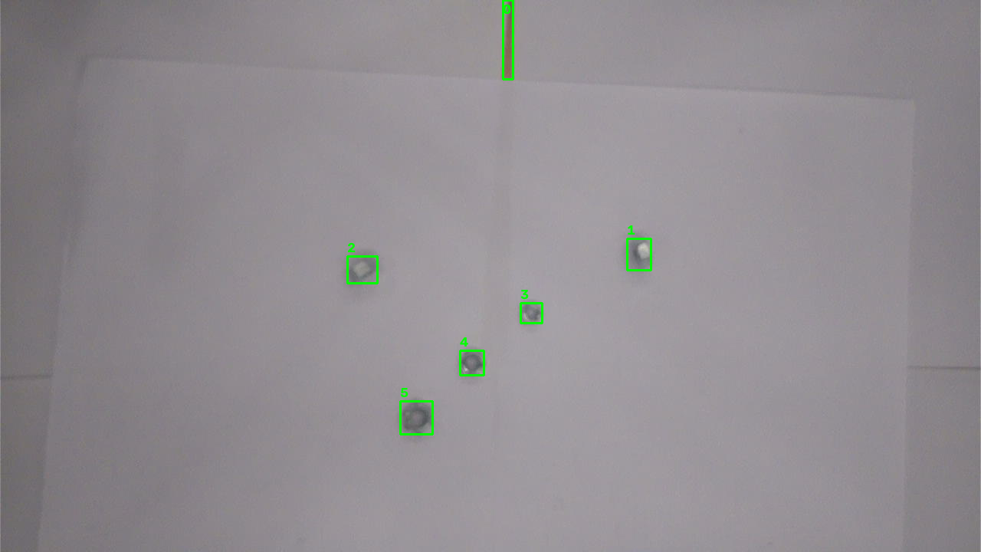
data/logs/2026-10-28-standing-nut/before-training/numbered.png
