never-die-cold/FPGA-Alittle-Design/data/logs/2026-10-28-standing-nut/focused-after-r5/roi-grid.png

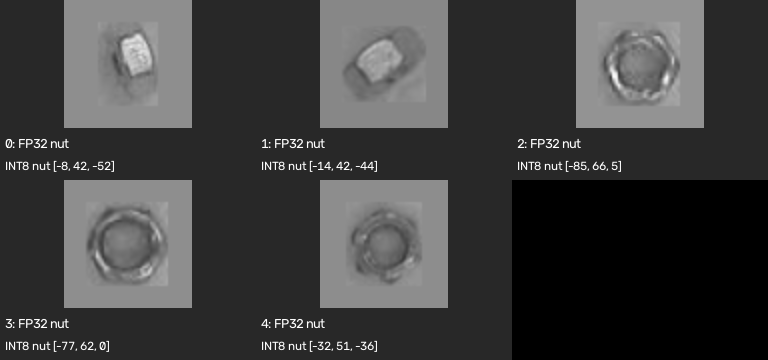
data/logs/2026-10-28-standing-nut/focused-after-r5/roi-grid.png
