never-die-cold/FPGA-Alittle-Design/data/logs/2026-10-30-web-live/capture.png

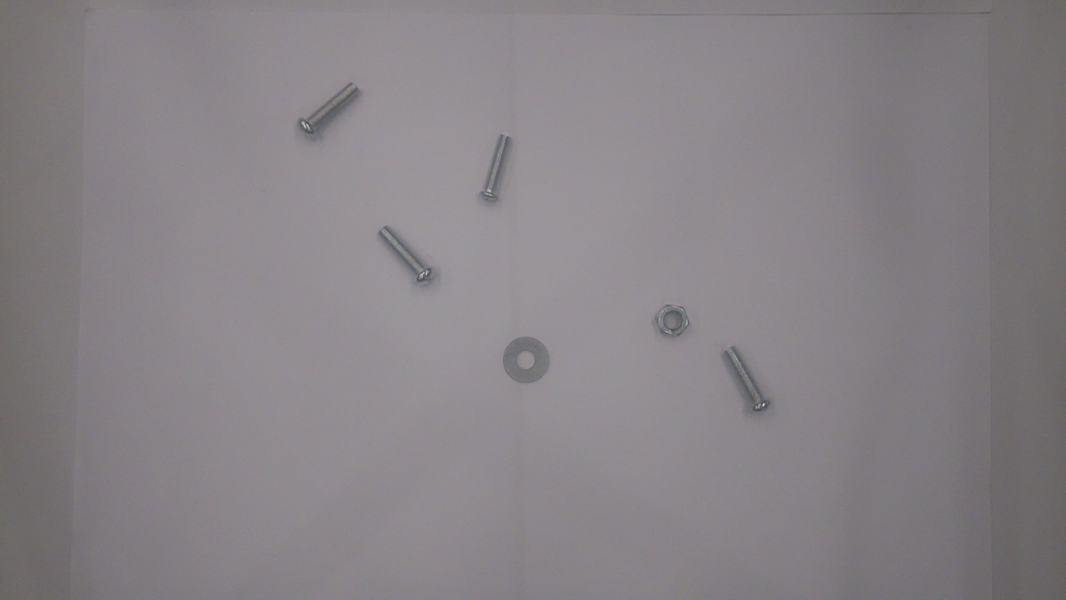
data/logs/2026-10-30-web-live/capture.png
