never-die-cold/FPGA-Alittle-Design/data/logs/2026-11-03-onboard-final/uvc-initial/raw.png

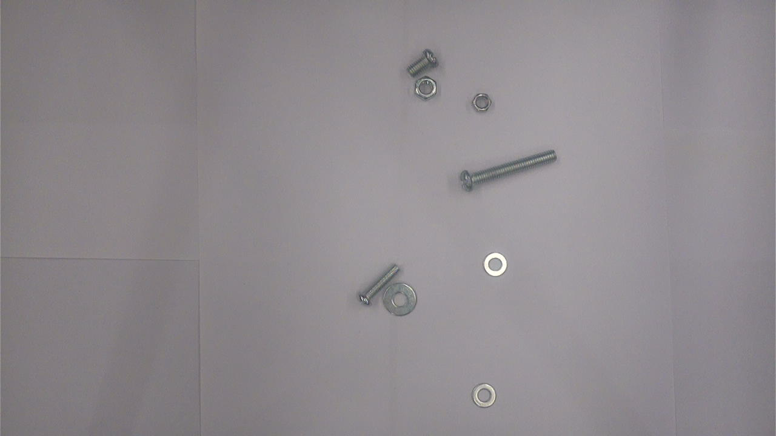
data/logs/2026-11-03-onboard-final/uvc-initial/raw.png
