never-die-cold/FPGA-Alittle-Design/docs/exe-web-hud/shots/06-theme-light.png

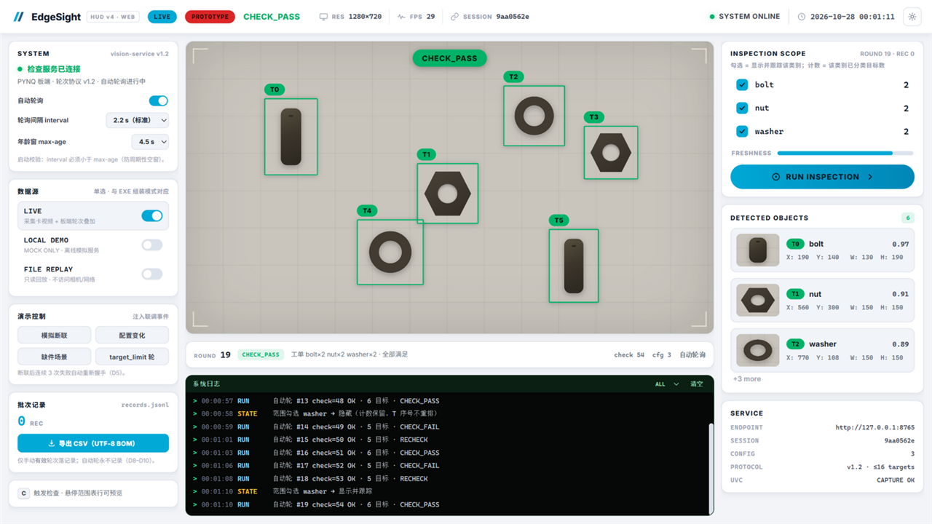
docs/exe-web-hud/shots/06-theme-light.png
