never-die-cold/FPGA-Alittle-Design/docs/poster/poster-preview.png

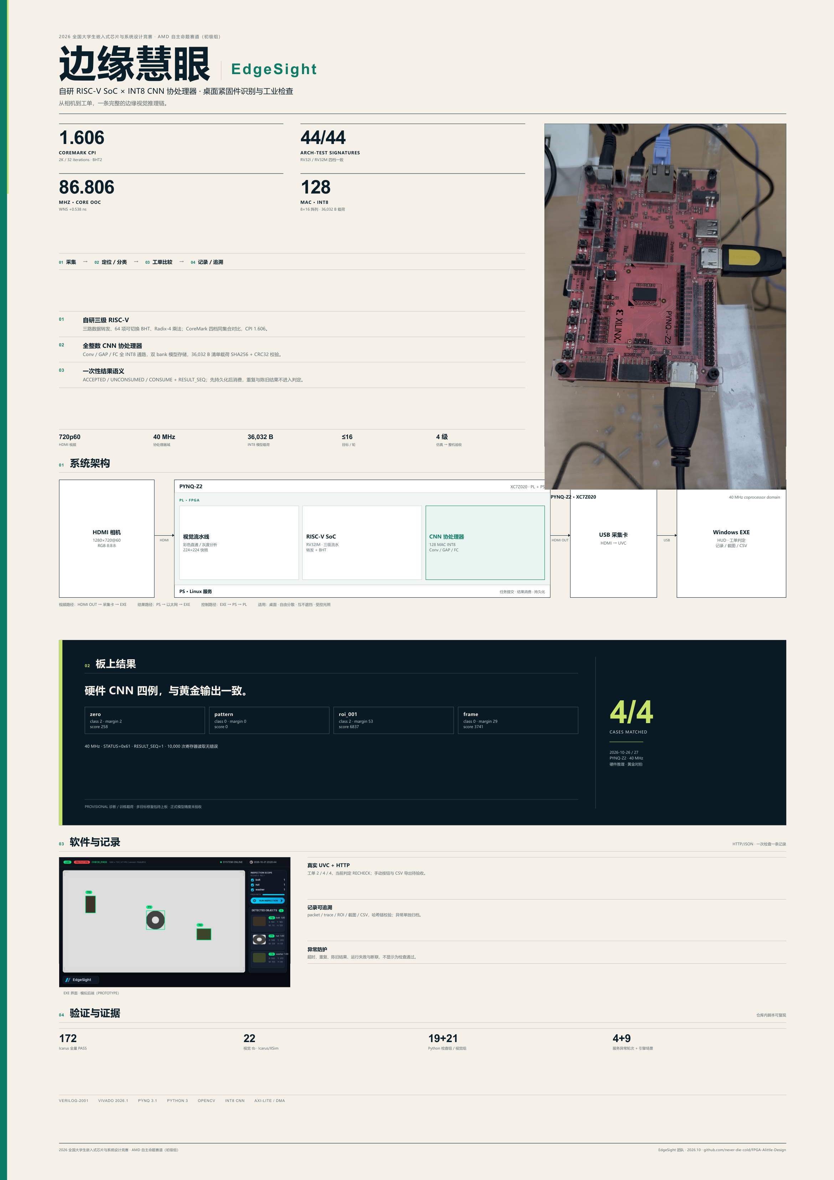
docs/poster/poster-preview.png
