never-die-cold/FPGA-Alittle-Design/docs/tech-report/figures/fig_sw.png

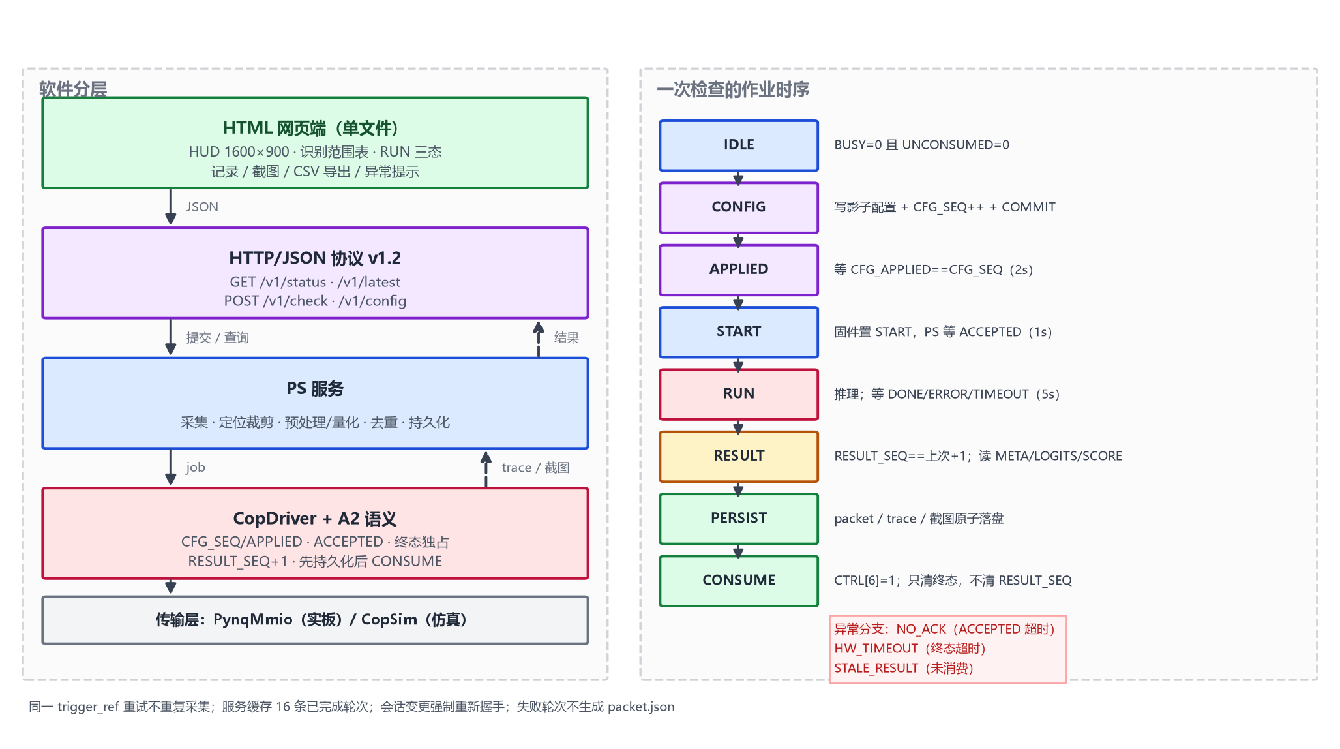
docs/tech-report/figures/fig_sw.png
