never-die-cold/FPGA-Alittle-Design/docs/tech-report/figures/fig_video.png

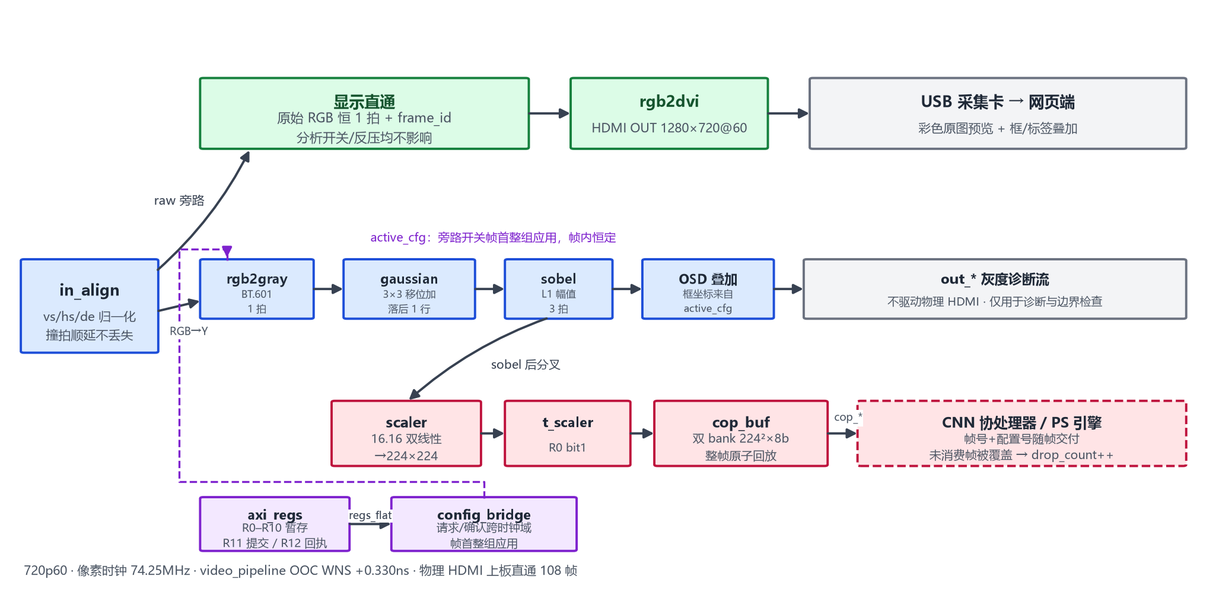
docs/tech-report/figures/fig_video.png
