never-die-cold/FPGA-Alittle-Design/docs/tech-report/figures/photo_board_pi.jpg

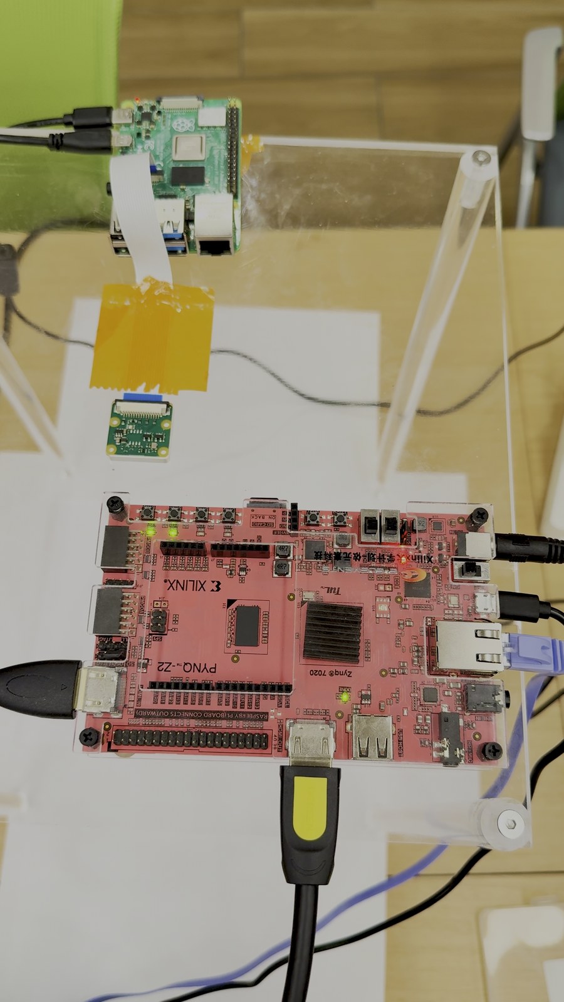
docs/tech-report/figures/photo_board_pi.jpg
