never-die-cold/FPGA-Alittle-Design/docs/tech-report/figures/photo_plate.jpg

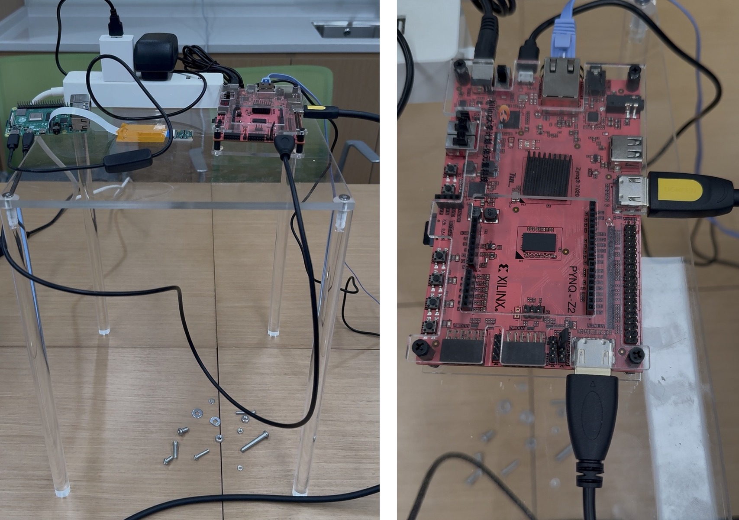
docs/tech-report/figures/photo_plate.jpg
