never-die-cold/FPGA-Alittle-Design/docs/tech-report/figures/photo_workstation.jpg

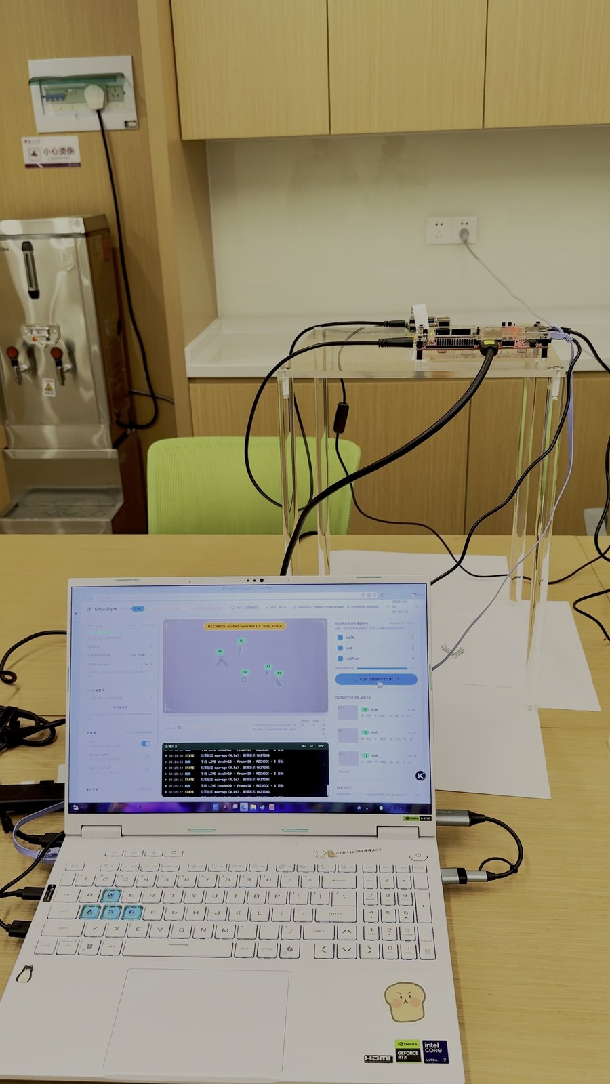
docs/tech-report/figures/photo_workstation.jpg
