never-die-cold/FPGA-Alittle-Design/docs/enclosure/enclosure-v1-measure-and-material-sheet.md

# 工位壳实测与物料检查单 v0

2026-10-17。配套[概念图 v1](acrylic-three-tier-concept-v1.md)；本单只列"量什么、怎么算、买什么"，
**全部数值留空待实测**，不预设尺寸。电气链路以 `board/hardware.md` 为准（[../../board/hardware.md](../../board/hardware.md)）。

## 1．先量实物（每个量一行，实测后回填）

| 项 | 量什么 | 实测值 |
|---|---|---|
| PYNQ-Z2 占地 | 长 × 宽（含最外突出件） | ____ × ____ mm |
| PYNQ-Z2 总高 | 底面到最高器件/跳线帽 | ____ mm |
| PYNQ 接口纵深 | 以太网/USB/SD/HDMI ×2 插上后向后伸出量 | ____ mm |
| Pi 4B 占地与总高 | 长 × 宽 × 高（含 GPIO 最高点） | ____ × ____ × ____ mm |
| CM3 镜头组件 | 镜筒外径、镜筒前端到承物面所需工作距离 D（对焦清晰且目标满幅） | 外径 ____ ；D ____ mm |
| CM3 FOV | 距离 D 处视野宽 × 高（标尺横竖各拍一张） | ____ × ____ mm |
| HDMI 线最小弯曲半径 | 按线材规格表或实测不能硬折的半径 | ____ mm |
| 电源插头空间 | 两个电源插头插入后占的深度 | ____ mm |
| 元件最大高度 | 三类垫圈/螺母/螺栓中最高的叠放口径 | ____ mm |

## 2．尺寸推导链（实测后代入，先算再下单）

- 中层高 H_mid = D（镜头工作距离）＋ 元件最大高度 ＋ 5 mm 裕量 ＝ ____ mm
- 识别区最小边距：FOV 除以 16 目标上限与最小间距档（档位见[采集规程](../fastener-data-collection-protocol.md)），
  取两者较严者反推承物板可用面积 ≥ ____ × ____ mm
- 上层高 = Pi 总高 ＋ CSI 排线弯折余量 ＋ 顶盖间隙 ＝ ____ mm
- 下层高 = PYNQ 总高 ＋ 绝缘支柱高 ＋ 插头纵深 ＝ ____ mm
- 承物板开孔 = 镜筒外径 ＋ 2×1 mm 定位公差 ＝ ____ mm
- 整壳总高 = 三层之和 ＋ 板厚（板厚 t 未选型，候选 3/5 mm，等刚度实测）＝ ____ mm

## 3．采购清单（数量可定，尺寸留空）

| 物料 | 数量 | 规格/口径 |
|---|---|---|
| 亚克力板（顶盖/上层隔板/承物板/底板/侧板） | 各 1，侧板按需 | 尺寸按 §2；板厚 3 或 5 mm 二选一待定 |
| M3 绝缘支柱＋螺丝螺母 | 底层 4 套（PYNQ）；如有需另配上层 | 支柱高 = 下层高实测值 |
| 可移除哑光底衬 | 1–2 张 | 颜色按背景候选（dark/gray/wood）各裁一块试 |
| 走线孔垫圈/护套 | 按孔数 | HDMI、网线、两路电源、CSI 排线各 1 孔起 |
| 激光切割 CAD | v2 才出 | 尺寸回填并复核后再画，不提前 |

## 4．风险与边界

- **壳内工作距离可能与采集规程的 40–80 cm 档位不符**：若 D 低于 40 cm，属采集条件变更，
  先报 WC/JL 评审再定标，不改既有契约；采集表的距离列填实测值。
- 概念图为随机生成示意，加工一律以回填后的 §1/§2 数值与 v2 图为据，不用概念图直接下料。
- 散热、结构刚度、插拔间隙是 §2 回填后的复核项，未验证前不认定工位可用。
