never-die-cold/FPGA-Alittle-Design/docs/file-guide/sections/board.md

# board：逐文件说明

19个文件；返回[主页](../README.md)，完整关系见[搜索页](../index.html)或[JSON](../files.json)。

| 文件 | 一两句话说明 | 关联文件（最多展示5项） |
| --- | --- | --- |
| **board** | | |
| [board/README.md](../../../board/README.md)<br>说明/计划/契约 · 已纳入Git（含暂存） | 说明《board —— 上板工程与实测输出》的规则、过程或结果；其引用文件见关联栏，日期/候选/冻结边界按正文保留。 | 所在目录说明：[README.md](../../../README.md)<br>文本引用：[data/logs/2026-10-03-vision-onboard/README.md](../../../data/logs/2026-10-03-vision-onboard/README.md)<br>文档链接：[data/logs/2026-10-03-vision-onboard/README.md](../../../data/logs/2026-10-03-vision-onboard/README.md)<br>文本引用：[data/logs/2026-10-07-pi-pynq/README.md](../../../data/logs/2026-10-07-pi-pynq/README.md)<br>文档链接：[data/logs/2026-10-07-pi-pynq/README.md](../../../data/logs/2026-10-07-pi-pynq/README.md)<br>另4项见搜索页 |
| [board/adv7611_init.py](../../../board/adv7611_init.py)<br>软件/脚本/项目入口 · 已纳入Git（含暂存） | 外接ADV7611接收器初始化示例；PYNQ-Z2本板HDMI直接接PL，不使用这份驱动。 | 所在目录说明：[board/README.md](../../../board/README.md)<br>文本引用：[docs/track_research.md](../../../docs/track_research.md) |
| [board/hardware.md](../../../board/hardware.md)<br>说明/计划/契约 · 已纳入Git（含暂存） | 说明《board/hardware —— 演示硬件与 HDMI 接线》的规则、过程或结果；其引用文件见关联栏，日期/候选/冻结边界按正文保留。 | 所在目录说明：[board/README.md](../../../board/README.md)<br>文档链接：[board/logs/README.md](../../../board/logs/README.md)<br>文档链接：[board/setup.md](../../../board/setup.md)<br>文本引用：[data/logs/2026-10-03-vision-onboard/README.md](../../../data/logs/2026-10-03-vision-onboard/README.md)<br>文档链接：[data/logs/2026-10-03-vision-onboard/README.md](../../../data/logs/2026-10-03-vision-onboard/README.md)<br>另9项见搜索页 |
| **board/logs/2026-09-20-pynq-z2-smoke** | | |
| [board/logs/2026-09-20-pynq-z2-smoke/README.md](../../../board/logs/2026-09-20-pynq-z2-smoke/README.md)<br>说明/计划/契约 · 已纳入Git（含暂存） | 说明《PYNQ-Z2 LED smoke test 上板实测记录（2026-09-20）》的规则、过程或结果；其引用文件见关联栏，日期/候选/冻结边界按正文保留。 | 文本引用：[board/README.md](../../../board/README.md)<br>所在目录说明：[board/logs/README.md](../../../board/logs/README.md)<br>文本引用：[board/smoke_test/README.md](../../../board/smoke_test/README.md)<br>文本引用：[board/smoke_test/scripts/build.tcl](../../../board/smoke_test/scripts/build.tcl)<br>文本引用：[data/logs/2026-09-20-pynq-z2-smoke-vivado/README.md](../../../data/logs/2026-09-20-pynq-z2-smoke-vivado/README.md)<br>另3项见搜索页 |
| **board/logs/2026-09-26-soc-onboard** | | |
| [board/logs/2026-09-26-soc-onboard/README.md](../../../board/logs/2026-09-26-soc-onboard/README.md)<br>说明/计划/契约 · 已纳入Git（含暂存） | 说明《Part A SoC 真实上板记录（2026-09-26）》的规则、过程或结果；其引用文件见关联栏，日期/候选/冻结边界按正文保留。 | 文本引用：[board/README.md](../../../board/README.md)<br>所在目录说明：[board/logs/README.md](../../../board/logs/README.md)<br>文本引用：[board/scripts/program_soc.tcl](../../../board/scripts/program_soc.tcl)<br>文本引用：[data/logs/2026-09-26-soc-onboard/README.md](../../../data/logs/2026-09-26-soc-onboard/README.md)<br>文档链接：[data/logs/2026-09-26-soc-onboard/README.md](../../../data/logs/2026-09-26-soc-onboard/README.md)<br>另4项见搜索页 |
| **board/logs/2026-10-05-partB-v1-onboard** | | |
| [board/logs/2026-10-05-partB-v1-onboard/README.md](../../../board/logs/2026-10-05-partB-v1-onboard/README.md)<br>说明/计划/契约 · 已纳入Git（含暂存） | 说明《Part B v1（三级流水 + 转发）真实上板记录（2026-10-05）》的规则、过程或结果；其引用文件见关联栏，日期/候选/冻结边界按正文保留。 | 文本引用：[board/README.md](../../../board/README.md)<br>所在目录说明：[board/logs/README.md](../../../board/logs/README.md)<br>文本引用：[board/scripts/program_soc.bat](../../../board/scripts/program_soc.bat)<br>文本引用：[data/logs/2026-10-05-partB-v1-onboard/README.md](../../../data/logs/2026-10-05-partB-v1-onboard/README.md)<br>文档链接：[data/logs/2026-10-05-partB-v1-onboard/README.md](../../../data/logs/2026-10-05-partB-v1-onboard/README.md)<br>另2项见搜索页 |
| **board/logs/2026-10-06-partB-t2-board** | | |
| [board/logs/2026-10-06-partB-t2-board/README.md](../../../board/logs/2026-10-06-partB-t2-board/README.md)<br>说明/计划/契约 · 已纳入Git（含暂存） | 说明《Part B T2 SoC 真实上板记录（2026-10-06）》的规则、过程或结果；其引用文件见关联栏，日期/候选/冻结边界按正文保留。 | 文本引用：[board/README.md](../../../board/README.md)<br>所在目录说明：[board/logs/README.md](../../../board/logs/README.md)<br>文本引用：[board/scripts/program_soc.bat](../../../board/scripts/program_soc.bat)<br>文本引用：[data/logs/2026-10-06-partB-t2-board/README.md](../../../data/logs/2026-10-06-partB-t2-board/README.md)<br>文档链接：[data/logs/2026-10-06-partB-t2-board/README.md](../../../data/logs/2026-10-06-partB-t2-board/README.md)<br>另1项见搜索页 |
| **board/logs/2026-10-06-partC-bht2-board** | | |
| [board/logs/2026-10-06-partC-bht2-board/README.md](../../../board/logs/2026-10-06-partC-bht2-board/README.md)<br>说明/计划/契约 · 已纳入Git（含暂存） | 说明《Part C 主档（v1_fwd+BHT2）真实上板记录（2026-10-06）》的规则、过程或结果；其引用文件见关联栏，日期/候选/冻结边界按正文保留。 | 文本引用：[board/README.md](../../../board/README.md)<br>所在目录说明：[board/logs/README.md](../../../board/logs/README.md)<br>文本引用：[board/scripts/program_soc.bat](../../../board/scripts/program_soc.bat)<br>文本引用：[data/logs/2026-10-06-partC-verify/README.md](../../../data/logs/2026-10-06-partC-verify/README.md)<br>文档链接：[data/logs/2026-10-06-partC-verify/README.md](../../../data/logs/2026-10-06-partC-verify/README.md)<br>另1项见搜索页 |
| **board/logs** | | |
| [board/logs/README.md](../../../board/logs/README.md)<br>说明/计划/契约 · 已纳入Git（含暂存） | 说明《board/logs —— 上板实测记录（只追加，不删改）》的规则、过程或结果；其引用文件见关联栏，日期/候选/冻结边界按正文保留。 | 所在目录说明：[board/README.md](../../../board/README.md)<br>文本引用：[board/README.md](../../../board/README.md) |
| **board/scripts** | | |
| [board/scripts/program_soc.bat](../../../board/scripts/program_soc.bat)<br>软件/脚本/项目入口 · 已纳入Git（含暂存） | Windows包装SoC位流下载Tcl；上板操作从它派发。 | 所在目录说明：[board/README.md](../../../board/README.md) |
| [board/scripts/program_soc.tcl](../../../board/scripts/program_soc.tcl)<br>软件/脚本/项目入口 · 已纳入Git（含暂存） | 使用Vivado Hardware Manager下载指定SoC位流；它是上板入口，需与对应固件和时序报告配对。 | 所在目录说明：[board/README.md](../../../board/README.md) |
| **board** | | |
| [board/setup.md](../../../board/setup.md)<br>说明/计划/契约 · 已纳入Git（含暂存） | 说明《PYNQ-Z2 从零复现指南（setup）》的规则、过程或结果；其引用文件见关联栏，日期/候选/冻结边界按正文保留。 | 所在目录说明：[board/README.md](../../../board/README.md)<br>文本引用：[board/README.md](../../../board/README.md)<br>文档链接：[board/hardware.md](../../../board/hardware.md)<br>文本引用：[board/logs/README.md](../../../board/logs/README.md) |
| **board/smoke_test** | | |
| [board/smoke_test/.gitignore](../../../board/smoke_test/.gitignore)<br>Git配置 · 已纳入Git（含暂存） | 规定本目录生成物的忽略范围；它与根.gitignore共同决定哪些文件进入项目版本库。 | 所在目录说明：[board/smoke_test/README.md](../../../board/smoke_test/README.md) |
| [board/smoke_test/README.md](../../../board/smoke_test/README.md)<br>说明/计划/契约 · 已纳入Git（含暂存） | 说明《PYNQ-Z2 最小流水灯上板测试》的规则、过程或结果；其引用文件见关联栏，日期/候选/冻结边界按正文保留。 | 所在目录说明：[board/README.md](../../../board/README.md)<br>文本引用：[board/smoke_test/scripts/build.tcl](../../../board/smoke_test/scripts/build.tcl)<br>文本引用：[board/smoke_test/sim/run_iverilog.sh](../../../board/smoke_test/sim/run_iverilog.sh) |
| **board/smoke_test/constraints** | | |
| [board/smoke_test/constraints/pynq_z2_smoke.xdc](../../../board/smoke_test/constraints/pynq_z2_smoke.xdc)<br>软件/脚本/项目入口 · 已纳入Git（含暂存） | 绑定早期LED冒烟顶层的板钟、复位和LED管脚；由该目录build.tcl加载。 | 所在目录说明：[board/smoke_test/README.md](../../../board/smoke_test/README.md) |
| **board/smoke_test/rtl** | | |
| [board/smoke_test/rtl/pynq_z2_smoke_top.v](../../../board/smoke_test/rtl/pynq_z2_smoke_top.v)<br>RTL实现 · 已纳入Git（含暂存） | 板卡最早期时钟/复位/LED冒烟顶层；不含后续自研核或视觉识别。 | 所在目录说明：[board/smoke_test/README.md](../../../board/smoke_test/README.md) |
| **board/smoke_test/scripts** | | |
| [board/smoke_test/scripts/build.tcl](../../../board/smoke_test/scripts/build.tcl)<br>软件/脚本/项目入口 · 已纳入Git（含暂存） | 构建早期PYNQ-Z2 LED冒烟工程并检查端口/时序；不同于完整SoC或HDMI位流构建。 | 所在目录说明：[board/smoke_test/README.md](../../../board/smoke_test/README.md) |
| **board/smoke_test/sim** | | |
| [board/smoke_test/sim/pynq_z2_smoke_tb.v](../../../board/smoke_test/sim/pynq_z2_smoke_tb.v)<br>RTL实现 · 已纳入Git（含暂存） | 验证早期板卡LED冒烟逻辑的测试台；与该目录顶层和Icarus入口配套。 | 所在目录说明：[board/smoke_test/README.md](../../../board/smoke_test/README.md) |
| [board/smoke_test/sim/run_iverilog.sh](../../../board/smoke_test/sim/run_iverilog.sh)<br>软件/脚本/项目入口 · 已纳入Git（含暂存） | 编译并运行该目录的最早期LED冒烟测试台；只验证板卡冒烟逻辑，不是全项目核回归入口。 | 所在目录说明：[board/smoke_test/README.md](../../../board/smoke_test/README.md) |
