never-die-cold/FPGA-Alittle-Design/docs/file-guide/sections/data-evidence.md

# data-evidence：逐文件说明

858个文件；返回[主页](../README.md)，完整关系见[搜索页](../index.html)或[JSON](../files.json)。

| 文件 | 一两句话说明 | 关联文件（最多展示5项） |
| --- | --- | --- |
| **data/evidence** | | |
| [data/evidence/.gitkeep](../../../data/evidence/.gitkeep)<br>目录占位 · 已纳入Git（含暂存） | 让Git保留尚无正式内容的目录；它不包含设计、数据或验收结果。 | 所在目录说明：[data/README.md](../../../data/README.md) |
| [data/evidence/2026-09-23-coremark-main-hook.patch](../../../data/evidence/2026-09-23-coremark-main-hook.patch)<br>源码补丁 · 已纳入Git（含暂存） | 保存2026-09-23-coremark-main-hook相关的源码补丁；使用方式和来源应与data/README.md及同目录文件对照。 | 所在目录说明：[data/README.md](../../../data/README.md)<br>文本引用：[src/riscv_fw/coremark/core_main.c](../../../src/riscv_fw/coremark/core_main.c)<br>文本引用：[src/riscv_fw/coremark/vendor/core_main.c](../../../src/riscv_fw/coremark/vendor/core_main.c) |
| [data/evidence/2026-09-23-coremark-source.md](../../../data/evidence/2026-09-23-coremark-source.md)<br>说明/计划/契约 · 已纳入Git（含暂存） | 说明《CoreMark 官方源码入库证据》的规则、过程或结果；其引用文件见关联栏，日期/候选/冻结边界按正文保留。 | 所在目录说明：[data/README.md](../../../data/README.md)<br>文本引用：[docs/coremark.md](../../../docs/coremark.md) |
| **data/evidence/2026-10-03-arm-localize-baseline** | | |
| [data/evidence/2026-10-03-arm-localize-baseline/.gitattributes](../../../data/evidence/2026-10-03-arm-localize-baseline/.gitattributes)<br>Git配置 · 已纳入Git（含暂存） | 对本目录证据的行尾/二进制和差异检查作局部约定；用于保留归档字节，与根Git属性叠加。 | 所在目录说明：[data/evidence/2026-10-03-arm-localize-baseline/README.md](../../../data/evidence/2026-10-03-arm-localize-baseline/README.md) |
| [data/evidence/2026-10-03-arm-localize-baseline/README.md](../../../data/evidence/2026-10-03-arm-localize-baseline/README.md)<br>说明/计划/契约 · 已纳入Git（含暂存） | 说明《ARM 文件输入定位/裁剪：证据索引》的规则、过程或结果；其引用文件见关联栏，日期/候选/冻结边界按正文保留。 | 所在目录说明：[data/README.md](../../../data/README.md)<br>文本引用：[docs/arm-localize-baseline-plan.md](../../../docs/arm-localize-baseline-plan.md)<br>文本引用：[docs/arm-localize-results.md](../../../docs/arm-localize-results.md) |
| **data/evidence/2026-10-03-arm-localize-baseline/arm-board-final/arm_localize** | | |
| [data/evidence/2026-10-03-arm-localize-baseline/arm-board-final/arm_localize/README.md](../../../data/evidence/2026-10-03-arm-localize-baseline/arm-board-final/arm_localize/README.md)<br>说明/计划/契约 · 已纳入Git（含暂存） | 说明《ARM 文件定位/裁剪便携包》的规则、过程或结果；其引用文件见关联栏，日期/候选/冻结边界按正文保留。 | 所在目录说明：[data/evidence/2026-10-03-arm-localize-baseline/README.md](../../../data/evidence/2026-10-03-arm-localize-baseline/README.md)<br>同目录输入/元数据：[data/evidence/2026-10-03-arm-localize-baseline/arm-board-final/arm_localize/manifest.json](../../../data/evidence/2026-10-03-arm-localize-baseline/arm-board-final/arm_localize/manifest.json)<br>文本引用：[sim/scripts/make_arm_localize_pkg.py](../../../sim/scripts/make_arm_localize_pkg.py) |
| [data/evidence/2026-10-03-arm-localize-baseline/arm-board-final/arm_localize/arm_localize.py](../../../data/evidence/2026-10-03-arm-localize-baseline/arm-board-final/arm_localize/arm_localize.py)<br>归档源码/输入副本 · 已纳入Git（含暂存） | 这是该轮保存的源码/配置副本：标准库文件定位/裁剪运行器，记录纯计算耗时；它不从实时HDMI取帧；所属实验与当前入口以关联栏区分。 | 所在目录说明：[data/evidence/2026-10-03-arm-localize-baseline/arm-board-final/arm_localize/README.md](../../../data/evidence/2026-10-03-arm-localize-baseline/arm-board-final/arm_localize/README.md)<br>同目录输入/元数据：[data/evidence/2026-10-03-arm-localize-baseline/arm-board-final/arm_localize/manifest.json](../../../data/evidence/2026-10-03-arm-localize-baseline/arm-board-final/arm_localize/manifest.json)<br>Python导入：[data/evidence/2026-10-03-arm-localize-baseline/arm-board-final/arm_localize/reference.py](../../../data/evidence/2026-10-03-arm-localize-baseline/arm-board-final/arm_localize/reference.py) |
| [data/evidence/2026-10-03-arm-localize-baseline/arm-board-final/arm_localize/arm_localize_bench.py](../../../data/evidence/2026-10-03-arm-localize-baseline/arm-board-final/arm_localize/arm_localize_bench.py)<br>归档源码/输入副本 · 已纳入Git（含暂存） | 这是该轮保存的源码/配置副本：在固定合成场景上重复测定位性能并保存每次结果；用于ARM与本机同负载对比；所属实验与当前入口以关联栏区分。 | 所在目录说明：[data/evidence/2026-10-03-arm-localize-baseline/arm-board-final/arm_localize/README.md](../../../data/evidence/2026-10-03-arm-localize-baseline/arm-board-final/arm_localize/README.md)<br>Python导入：[data/evidence/2026-10-03-arm-localize-baseline/arm-board-final/arm_localize/arm_localize.py](../../../data/evidence/2026-10-03-arm-localize-baseline/arm-board-final/arm_localize/arm_localize.py)<br>同目录输入/元数据：[data/evidence/2026-10-03-arm-localize-baseline/arm-board-final/arm_localize/manifest.json](../../../data/evidence/2026-10-03-arm-localize-baseline/arm-board-final/arm_localize/manifest.json)<br>文本引用：[data/evidence/2026-10-03-arm-localize-baseline/two_targets.json](../../../data/evidence/2026-10-03-arm-localize-baseline/two_targets.json) |
| [data/evidence/2026-10-03-arm-localize-baseline/arm-board-final/arm_localize/arm_localize_selftest.py](../../../data/evidence/2026-10-03-arm-localize-baseline/arm-board-final/arm_localize/arm_localize_selftest.py)<br>归档源码/输入副本 · 已纳入Git（含暂存） | 这是该轮保存的源码/配置副本：便携定位包自检，覆盖固定答案、非法输入、CLI和哈希；供打包/移交检查；所属实验与当前入口以关联栏区分。 | 所在目录说明：[data/evidence/2026-10-03-arm-localize-baseline/arm-board-final/arm_localize/README.md](../../../data/evidence/2026-10-03-arm-localize-baseline/arm-board-final/arm_localize/README.md)<br>Python导入：[data/evidence/2026-10-03-arm-localize-baseline/arm-board-final/arm_localize/arm_localize.py](../../../data/evidence/2026-10-03-arm-localize-baseline/arm-board-final/arm_localize/arm_localize.py)<br>同目录输入/元数据：[data/evidence/2026-10-03-arm-localize-baseline/arm-board-final/arm_localize/manifest.json](../../../data/evidence/2026-10-03-arm-localize-baseline/arm-board-final/arm_localize/manifest.json) |
| **data/evidence/2026-10-03-arm-localize-baseline/arm-board-final/arm_localize/benchmark/run-1p9nq39b/720p_empty** | | |
| [data/evidence/2026-10-03-arm-localize-baseline/arm-board-final/arm_localize/benchmark/run-1p9nq39b/720p_empty/input.json](../../../data/evidence/2026-10-03-arm-localize-baseline/arm-board-final/arm_localize/benchmark/run-1p9nq39b/720p_empty/input.json)<br>结构化结果/元数据 · 已纳入Git（含暂存） | 保存input的输入/设备/运行元数据，字段包括具体字段；与data/evidence/2026-10-03-arm-localize-baseline/arm-board-final/arm_localize/README.md中的生成/校验流程一起使用。 | 所在目录说明：[data/evidence/2026-10-03-arm-localize-baseline/arm-board-final/arm_localize/README.md](../../../data/evidence/2026-10-03-arm-localize-baseline/arm-board-final/arm_localize/README.md) |
| [data/evidence/2026-10-03-arm-localize-baseline/arm-board-final/arm_localize/benchmark/run-1p9nq39b/720p_empty/sample-00.json](../../../data/evidence/2026-10-03-arm-localize-baseline/arm-board-final/arm_localize/benchmark/run-1p9nq39b/720p_empty/sample-00.json)<br>结构化结果/元数据 · 已纳入Git（含暂存） | 保存sample-00的实验结果或检查产物，字段包括frame_id、config_id、width、height、status、targets、schema_version；与data/evidence/2026-10-03-arm-localize-baseline/arm-board-final/arm_localize/README.md中的生成/校验流程一起使用。 | 所在目录说明：[data/evidence/2026-10-03-arm-localize-baseline/arm-board-final/arm_localize/README.md](../../../data/evidence/2026-10-03-arm-localize-baseline/arm-board-final/arm_localize/README.md)<br>同目录输入/元数据：[data/evidence/2026-10-03-arm-localize-baseline/arm-board-final/arm_localize/benchmark/run-1p9nq39b/720p_empty/input.json](../../../data/evidence/2026-10-03-arm-localize-baseline/arm-board-final/arm_localize/benchmark/run-1p9nq39b/720p_empty/input.json) |
| [data/evidence/2026-10-03-arm-localize-baseline/arm-board-final/arm_localize/benchmark/run-1p9nq39b/720p_empty/sample-01.json](../../../data/evidence/2026-10-03-arm-localize-baseline/arm-board-final/arm_localize/benchmark/run-1p9nq39b/720p_empty/sample-01.json)<br>结构化结果/元数据 · 已纳入Git（含暂存） | 保存sample-01的实验结果或检查产物，字段包括frame_id、config_id、width、height、status、targets、schema_version；与data/evidence/2026-10-03-arm-localize-baseline/arm-board-final/arm_localize/README.md中的生成/校验流程一起使用。 | 所在目录说明：[data/evidence/2026-10-03-arm-localize-baseline/arm-board-final/arm_localize/README.md](../../../data/evidence/2026-10-03-arm-localize-baseline/arm-board-final/arm_localize/README.md)<br>同目录输入/元数据：[data/evidence/2026-10-03-arm-localize-baseline/arm-board-final/arm_localize/benchmark/run-1p9nq39b/720p_empty/input.json](../../../data/evidence/2026-10-03-arm-localize-baseline/arm-board-final/arm_localize/benchmark/run-1p9nq39b/720p_empty/input.json) |
| [data/evidence/2026-10-03-arm-localize-baseline/arm-board-final/arm_localize/benchmark/run-1p9nq39b/720p_empty/sample-02.json](../../../data/evidence/2026-10-03-arm-localize-baseline/arm-board-final/arm_localize/benchmark/run-1p9nq39b/720p_empty/sample-02.json)<br>结构化结果/元数据 · 已纳入Git（含暂存） | 保存sample-02的实验结果或检查产物，字段包括frame_id、config_id、width、height、status、targets、schema_version；与data/evidence/2026-10-03-arm-localize-baseline/arm-board-final/arm_localize/README.md中的生成/校验流程一起使用。 | 所在目录说明：[data/evidence/2026-10-03-arm-localize-baseline/arm-board-final/arm_localize/README.md](../../../data/evidence/2026-10-03-arm-localize-baseline/arm-board-final/arm_localize/README.md)<br>同目录输入/元数据：[data/evidence/2026-10-03-arm-localize-baseline/arm-board-final/arm_localize/benchmark/run-1p9nq39b/720p_empty/input.json](../../../data/evidence/2026-10-03-arm-localize-baseline/arm-board-final/arm_localize/benchmark/run-1p9nq39b/720p_empty/input.json) |
| [data/evidence/2026-10-03-arm-localize-baseline/arm-board-final/arm_localize/benchmark/run-1p9nq39b/720p_empty/sample-03.json](../../../data/evidence/2026-10-03-arm-localize-baseline/arm-board-final/arm_localize/benchmark/run-1p9nq39b/720p_empty/sample-03.json)<br>结构化结果/元数据 · 已纳入Git（含暂存） | 保存sample-03的实验结果或检查产物，字段包括frame_id、config_id、width、height、status、targets、schema_version；与data/evidence/2026-10-03-arm-localize-baseline/arm-board-final/arm_localize/README.md中的生成/校验流程一起使用。 | 所在目录说明：[data/evidence/2026-10-03-arm-localize-baseline/arm-board-final/arm_localize/README.md](../../../data/evidence/2026-10-03-arm-localize-baseline/arm-board-final/arm_localize/README.md)<br>同目录输入/元数据：[data/evidence/2026-10-03-arm-localize-baseline/arm-board-final/arm_localize/benchmark/run-1p9nq39b/720p_empty/input.json](../../../data/evidence/2026-10-03-arm-localize-baseline/arm-board-final/arm_localize/benchmark/run-1p9nq39b/720p_empty/input.json) |
| [data/evidence/2026-10-03-arm-localize-baseline/arm-board-final/arm_localize/benchmark/run-1p9nq39b/720p_empty/sample-04.json](../../../data/evidence/2026-10-03-arm-localize-baseline/arm-board-final/arm_localize/benchmark/run-1p9nq39b/720p_empty/sample-04.json)<br>结构化结果/元数据 · 已纳入Git（含暂存） | 保存sample-04的实验结果或检查产物，字段包括frame_id、config_id、width、height、status、targets、schema_version；与data/evidence/2026-10-03-arm-localize-baseline/arm-board-final/arm_localize/README.md中的生成/校验流程一起使用。 | 所在目录说明：[data/evidence/2026-10-03-arm-localize-baseline/arm-board-final/arm_localize/README.md](../../../data/evidence/2026-10-03-arm-localize-baseline/arm-board-final/arm_localize/README.md)<br>同目录输入/元数据：[data/evidence/2026-10-03-arm-localize-baseline/arm-board-final/arm_localize/benchmark/run-1p9nq39b/720p_empty/input.json](../../../data/evidence/2026-10-03-arm-localize-baseline/arm-board-final/arm_localize/benchmark/run-1p9nq39b/720p_empty/input.json) |
| [data/evidence/2026-10-03-arm-localize-baseline/arm-board-final/arm_localize/benchmark/run-1p9nq39b/720p_empty/warmup-00.json](../../../data/evidence/2026-10-03-arm-localize-baseline/arm-board-final/arm_localize/benchmark/run-1p9nq39b/720p_empty/warmup-00.json)<br>结构化结果/元数据 · 已纳入Git（含暂存） | 保存warmup-00的实验结果或检查产物，字段包括frame_id、config_id、width、height、status、targets、schema_version；与data/evidence/2026-10-03-arm-localize-baseline/arm-board-final/arm_localize/README.md中的生成/校验流程一起使用。 | 所在目录说明：[data/evidence/2026-10-03-arm-localize-baseline/arm-board-final/arm_localize/README.md](../../../data/evidence/2026-10-03-arm-localize-baseline/arm-board-final/arm_localize/README.md)<br>同目录输入/元数据：[data/evidence/2026-10-03-arm-localize-baseline/arm-board-final/arm_localize/benchmark/run-1p9nq39b/720p_empty/input.json](../../../data/evidence/2026-10-03-arm-localize-baseline/arm-board-final/arm_localize/benchmark/run-1p9nq39b/720p_empty/input.json) |
| **data/evidence/2026-10-03-arm-localize-baseline/arm-board-final/arm_localize/benchmark/run-1p9nq39b/720p_six** | | |
| [data/evidence/2026-10-03-arm-localize-baseline/arm-board-final/arm_localize/benchmark/run-1p9nq39b/720p_six/input.json](../../../data/evidence/2026-10-03-arm-localize-baseline/arm-board-final/arm_localize/benchmark/run-1p9nq39b/720p_six/input.json)<br>结构化结果/元数据 · 已纳入Git（含暂存） | 保存input的输入/设备/运行元数据，字段包括具体字段；与data/evidence/2026-10-03-arm-localize-baseline/arm-board-final/arm_localize/README.md中的生成/校验流程一起使用。 | 所在目录说明：[data/evidence/2026-10-03-arm-localize-baseline/arm-board-final/arm_localize/README.md](../../../data/evidence/2026-10-03-arm-localize-baseline/arm-board-final/arm_localize/README.md) |
| **data/evidence/2026-10-03-arm-localize-baseline/arm-board-final/arm_localize/benchmark/run-1p9nq39b/720p_six/sample-00-crops-wqxs0nc_** | | |
| [data/evidence/2026-10-03-arm-localize-baseline/arm-board-final/arm_localize/benchmark/run-1p9nq39b/720p_six/sample-00-crops-wqxs0nc_/target_000.hex](../../../data/evidence/2026-10-03-arm-localize-baseline/arm-board-final/arm_localize/benchmark/run-1p9nq39b/720p_six/sample-00-crops-wqxs0nc_/target_000.hex)<br>十六进制数据 · 已纳入Git（含暂存） | 以十六进制数据形式保存target_000的目标ROI像素；由对应加载器/testbench读取，位宽、排布和端序按data/evidence/2026-10-03-arm-localize-baseline/arm-board-final/arm_localize/README.md核对。 | 所在目录说明：[data/evidence/2026-10-03-arm-localize-baseline/arm-board-final/arm_localize/README.md](../../../data/evidence/2026-10-03-arm-localize-baseline/arm-board-final/arm_localize/README.md)<br>同名配套文件：[data/evidence/2026-10-03-arm-localize-baseline/arm-board-final/arm_localize/benchmark/run-1p9nq39b/720p_six/sample-00-crops-wqxs0nc_/target_000.pgm](../../../data/evidence/2026-10-03-arm-localize-baseline/arm-board-final/arm_localize/benchmark/run-1p9nq39b/720p_six/sample-00-crops-wqxs0nc_/target_000.pgm) |
| [data/evidence/2026-10-03-arm-localize-baseline/arm-board-final/arm_localize/benchmark/run-1p9nq39b/720p_six/sample-00-crops-wqxs0nc_/target_000.pgm](../../../data/evidence/2026-10-03-arm-localize-baseline/arm-board-final/arm_localize/benchmark/run-1p9nq39b/720p_six/sample-00-crops-wqxs0nc_/target_000.pgm)<br>灰度像素图 · 已纳入Git（含暂存） | 保存target_000的目标ROI裁剪；其合成/文件/实机来源及框/标签含义以data/evidence/2026-10-03-arm-localize-baseline/arm-board-final/arm_localize/README.md为准。 | 所在目录说明：[data/evidence/2026-10-03-arm-localize-baseline/arm-board-final/arm_localize/README.md](../../../data/evidence/2026-10-03-arm-localize-baseline/arm-board-final/arm_localize/README.md)<br>同名配套文件：[data/evidence/2026-10-03-arm-localize-baseline/arm-board-final/arm_localize/benchmark/run-1p9nq39b/720p_six/sample-00-crops-wqxs0nc_/target_000.hex](../../../data/evidence/2026-10-03-arm-localize-baseline/arm-board-final/arm_localize/benchmark/run-1p9nq39b/720p_six/sample-00-crops-wqxs0nc_/target_000.hex) |
| [data/evidence/2026-10-03-arm-localize-baseline/arm-board-final/arm_localize/benchmark/run-1p9nq39b/720p_six/sample-00-crops-wqxs0nc_/target_001.hex](../../../data/evidence/2026-10-03-arm-localize-baseline/arm-board-final/arm_localize/benchmark/run-1p9nq39b/720p_six/sample-00-crops-wqxs0nc_/target_001.hex)<br>十六进制数据 · 已纳入Git（含暂存） | 以十六进制数据形式保存target_001的目标ROI像素；由对应加载器/testbench读取，位宽、排布和端序按data/evidence/2026-10-03-arm-localize-baseline/arm-board-final/arm_localize/README.md核对。 | 所在目录说明：[data/evidence/2026-10-03-arm-localize-baseline/arm-board-final/arm_localize/README.md](../../../data/evidence/2026-10-03-arm-localize-baseline/arm-board-final/arm_localize/README.md)<br>同名配套文件：[data/evidence/2026-10-03-arm-localize-baseline/arm-board-final/arm_localize/benchmark/run-1p9nq39b/720p_six/sample-00-crops-wqxs0nc_/target_001.pgm](../../../data/evidence/2026-10-03-arm-localize-baseline/arm-board-final/arm_localize/benchmark/run-1p9nq39b/720p_six/sample-00-crops-wqxs0nc_/target_001.pgm) |
| [data/evidence/2026-10-03-arm-localize-baseline/arm-board-final/arm_localize/benchmark/run-1p9nq39b/720p_six/sample-00-crops-wqxs0nc_/target_001.pgm](../../../data/evidence/2026-10-03-arm-localize-baseline/arm-board-final/arm_localize/benchmark/run-1p9nq39b/720p_six/sample-00-crops-wqxs0nc_/target_001.pgm)<br>灰度像素图 · 已纳入Git（含暂存） | 保存target_001的目标ROI裁剪；其合成/文件/实机来源及框/标签含义以data/evidence/2026-10-03-arm-localize-baseline/arm-board-final/arm_localize/README.md为准。 | 所在目录说明：[data/evidence/2026-10-03-arm-localize-baseline/arm-board-final/arm_localize/README.md](../../../data/evidence/2026-10-03-arm-localize-baseline/arm-board-final/arm_localize/README.md)<br>同名配套文件：[data/evidence/2026-10-03-arm-localize-baseline/arm-board-final/arm_localize/benchmark/run-1p9nq39b/720p_six/sample-00-crops-wqxs0nc_/target_001.hex](../../../data/evidence/2026-10-03-arm-localize-baseline/arm-board-final/arm_localize/benchmark/run-1p9nq39b/720p_six/sample-00-crops-wqxs0nc_/target_001.hex) |
| [data/evidence/2026-10-03-arm-localize-baseline/arm-board-final/arm_localize/benchmark/run-1p9nq39b/720p_six/sample-00-crops-wqxs0nc_/target_002.hex](../../../data/evidence/2026-10-03-arm-localize-baseline/arm-board-final/arm_localize/benchmark/run-1p9nq39b/720p_six/sample-00-crops-wqxs0nc_/target_002.hex)<br>十六进制数据 · 已纳入Git（含暂存） | 以十六进制数据形式保存target_002的目标ROI像素；由对应加载器/testbench读取，位宽、排布和端序按data/evidence/2026-10-03-arm-localize-baseline/arm-board-final/arm_localize/README.md核对。 | 所在目录说明：[data/evidence/2026-10-03-arm-localize-baseline/arm-board-final/arm_localize/README.md](../../../data/evidence/2026-10-03-arm-localize-baseline/arm-board-final/arm_localize/README.md)<br>同名配套文件：[data/evidence/2026-10-03-arm-localize-baseline/arm-board-final/arm_localize/benchmark/run-1p9nq39b/720p_six/sample-00-crops-wqxs0nc_/target_002.pgm](../../../data/evidence/2026-10-03-arm-localize-baseline/arm-board-final/arm_localize/benchmark/run-1p9nq39b/720p_six/sample-00-crops-wqxs0nc_/target_002.pgm) |
| [data/evidence/2026-10-03-arm-localize-baseline/arm-board-final/arm_localize/benchmark/run-1p9nq39b/720p_six/sample-00-crops-wqxs0nc_/target_002.pgm](../../../data/evidence/2026-10-03-arm-localize-baseline/arm-board-final/arm_localize/benchmark/run-1p9nq39b/720p_six/sample-00-crops-wqxs0nc_/target_002.pgm)<br>灰度像素图 · 已纳入Git（含暂存） | 保存target_002的目标ROI裁剪；其合成/文件/实机来源及框/标签含义以data/evidence/2026-10-03-arm-localize-baseline/arm-board-final/arm_localize/README.md为准。 | 所在目录说明：[data/evidence/2026-10-03-arm-localize-baseline/arm-board-final/arm_localize/README.md](../../../data/evidence/2026-10-03-arm-localize-baseline/arm-board-final/arm_localize/README.md)<br>同名配套文件：[data/evidence/2026-10-03-arm-localize-baseline/arm-board-final/arm_localize/benchmark/run-1p9nq39b/720p_six/sample-00-crops-wqxs0nc_/target_002.hex](../../../data/evidence/2026-10-03-arm-localize-baseline/arm-board-final/arm_localize/benchmark/run-1p9nq39b/720p_six/sample-00-crops-wqxs0nc_/target_002.hex) |
| [data/evidence/2026-10-03-arm-localize-baseline/arm-board-final/arm_localize/benchmark/run-1p9nq39b/720p_six/sample-00-crops-wqxs0nc_/target_003.hex](../../../data/evidence/2026-10-03-arm-localize-baseline/arm-board-final/arm_localize/benchmark/run-1p9nq39b/720p_six/sample-00-crops-wqxs0nc_/target_003.hex)<br>十六进制数据 · 已纳入Git（含暂存） | 以十六进制数据形式保存target_003的目标ROI像素；由对应加载器/testbench读取，位宽、排布和端序按data/evidence/2026-10-03-arm-localize-baseline/arm-board-final/arm_localize/README.md核对。 | 所在目录说明：[data/evidence/2026-10-03-arm-localize-baseline/arm-board-final/arm_localize/README.md](../../../data/evidence/2026-10-03-arm-localize-baseline/arm-board-final/arm_localize/README.md)<br>同名配套文件：[data/evidence/2026-10-03-arm-localize-baseline/arm-board-final/arm_localize/benchmark/run-1p9nq39b/720p_six/sample-00-crops-wqxs0nc_/target_003.pgm](../../../data/evidence/2026-10-03-arm-localize-baseline/arm-board-final/arm_localize/benchmark/run-1p9nq39b/720p_six/sample-00-crops-wqxs0nc_/target_003.pgm) |
| [data/evidence/2026-10-03-arm-localize-baseline/arm-board-final/arm_localize/benchmark/run-1p9nq39b/720p_six/sample-00-crops-wqxs0nc_/target_003.pgm](../../../data/evidence/2026-10-03-arm-localize-baseline/arm-board-final/arm_localize/benchmark/run-1p9nq39b/720p_six/sample-00-crops-wqxs0nc_/target_003.pgm)<br>灰度像素图 · 已纳入Git（含暂存） | 保存target_003的目标ROI裁剪；其合成/文件/实机来源及框/标签含义以data/evidence/2026-10-03-arm-localize-baseline/arm-board-final/arm_localize/README.md为准。 | 所在目录说明：[data/evidence/2026-10-03-arm-localize-baseline/arm-board-final/arm_localize/README.md](../../../data/evidence/2026-10-03-arm-localize-baseline/arm-board-final/arm_localize/README.md)<br>同名配套文件：[data/evidence/2026-10-03-arm-localize-baseline/arm-board-final/arm_localize/benchmark/run-1p9nq39b/720p_six/sample-00-crops-wqxs0nc_/target_003.hex](../../../data/evidence/2026-10-03-arm-localize-baseline/arm-board-final/arm_localize/benchmark/run-1p9nq39b/720p_six/sample-00-crops-wqxs0nc_/target_003.hex) |
| [data/evidence/2026-10-03-arm-localize-baseline/arm-board-final/arm_localize/benchmark/run-1p9nq39b/720p_six/sample-00-crops-wqxs0nc_/target_004.hex](../../../data/evidence/2026-10-03-arm-localize-baseline/arm-board-final/arm_localize/benchmark/run-1p9nq39b/720p_six/sample-00-crops-wqxs0nc_/target_004.hex)<br>十六进制数据 · 已纳入Git（含暂存） | 以十六进制数据形式保存target_004的目标ROI像素；由对应加载器/testbench读取，位宽、排布和端序按data/evidence/2026-10-03-arm-localize-baseline/arm-board-final/arm_localize/README.md核对。 | 所在目录说明：[data/evidence/2026-10-03-arm-localize-baseline/arm-board-final/arm_localize/README.md](../../../data/evidence/2026-10-03-arm-localize-baseline/arm-board-final/arm_localize/README.md)<br>同名配套文件：[data/evidence/2026-10-03-arm-localize-baseline/arm-board-final/arm_localize/benchmark/run-1p9nq39b/720p_six/sample-00-crops-wqxs0nc_/target_004.pgm](../../../data/evidence/2026-10-03-arm-localize-baseline/arm-board-final/arm_localize/benchmark/run-1p9nq39b/720p_six/sample-00-crops-wqxs0nc_/target_004.pgm) |
| [data/evidence/2026-10-03-arm-localize-baseline/arm-board-final/arm_localize/benchmark/run-1p9nq39b/720p_six/sample-00-crops-wqxs0nc_/target_004.pgm](../../../data/evidence/2026-10-03-arm-localize-baseline/arm-board-final/arm_localize/benchmark/run-1p9nq39b/720p_six/sample-00-crops-wqxs0nc_/target_004.pgm)<br>灰度像素图 · 已纳入Git（含暂存） | 保存target_004的目标ROI裁剪；其合成/文件/实机来源及框/标签含义以data/evidence/2026-10-03-arm-localize-baseline/arm-board-final/arm_localize/README.md为准。 | 所在目录说明：[data/evidence/2026-10-03-arm-localize-baseline/arm-board-final/arm_localize/README.md](../../../data/evidence/2026-10-03-arm-localize-baseline/arm-board-final/arm_localize/README.md)<br>同名配套文件：[data/evidence/2026-10-03-arm-localize-baseline/arm-board-final/arm_localize/benchmark/run-1p9nq39b/720p_six/sample-00-crops-wqxs0nc_/target_004.hex](../../../data/evidence/2026-10-03-arm-localize-baseline/arm-board-final/arm_localize/benchmark/run-1p9nq39b/720p_six/sample-00-crops-wqxs0nc_/target_004.hex) |
| [data/evidence/2026-10-03-arm-localize-baseline/arm-board-final/arm_localize/benchmark/run-1p9nq39b/720p_six/sample-00-crops-wqxs0nc_/target_005.hex](../../../data/evidence/2026-10-03-arm-localize-baseline/arm-board-final/arm_localize/benchmark/run-1p9nq39b/720p_six/sample-00-crops-wqxs0nc_/target_005.hex)<br>十六进制数据 · 已纳入Git（含暂存） | 以十六进制数据形式保存target_005的目标ROI像素；由对应加载器/testbench读取，位宽、排布和端序按data/evidence/2026-10-03-arm-localize-baseline/arm-board-final/arm_localize/README.md核对。 | 所在目录说明：[data/evidence/2026-10-03-arm-localize-baseline/arm-board-final/arm_localize/README.md](../../../data/evidence/2026-10-03-arm-localize-baseline/arm-board-final/arm_localize/README.md)<br>同名配套文件：[data/evidence/2026-10-03-arm-localize-baseline/arm-board-final/arm_localize/benchmark/run-1p9nq39b/720p_six/sample-00-crops-wqxs0nc_/target_005.pgm](../../../data/evidence/2026-10-03-arm-localize-baseline/arm-board-final/arm_localize/benchmark/run-1p9nq39b/720p_six/sample-00-crops-wqxs0nc_/target_005.pgm) |
| [data/evidence/2026-10-03-arm-localize-baseline/arm-board-final/arm_localize/benchmark/run-1p9nq39b/720p_six/sample-00-crops-wqxs0nc_/target_005.pgm](../../../data/evidence/2026-10-03-arm-localize-baseline/arm-board-final/arm_localize/benchmark/run-1p9nq39b/720p_six/sample-00-crops-wqxs0nc_/target_005.pgm)<br>灰度像素图 · 已纳入Git（含暂存） | 保存target_005的目标ROI裁剪；其合成/文件/实机来源及框/标签含义以data/evidence/2026-10-03-arm-localize-baseline/arm-board-final/arm_localize/README.md为准。 | 所在目录说明：[data/evidence/2026-10-03-arm-localize-baseline/arm-board-final/arm_localize/README.md](../../../data/evidence/2026-10-03-arm-localize-baseline/arm-board-final/arm_localize/README.md)<br>同名配套文件：[data/evidence/2026-10-03-arm-localize-baseline/arm-board-final/arm_localize/benchmark/run-1p9nq39b/720p_six/sample-00-crops-wqxs0nc_/target_005.hex](../../../data/evidence/2026-10-03-arm-localize-baseline/arm-board-final/arm_localize/benchmark/run-1p9nq39b/720p_six/sample-00-crops-wqxs0nc_/target_005.hex) |
| **data/evidence/2026-10-03-arm-localize-baseline/arm-board-final/arm_localize/benchmark/run-1p9nq39b/720p_six** | | |
| [data/evidence/2026-10-03-arm-localize-baseline/arm-board-final/arm_localize/benchmark/run-1p9nq39b/720p_six/sample-00.json](../../../data/evidence/2026-10-03-arm-localize-baseline/arm-board-final/arm_localize/benchmark/run-1p9nq39b/720p_six/sample-00.json)<br>结构化结果/元数据 · 已纳入Git（含暂存） | 保存sample-00的实验结果或检查产物，字段包括frame_id、config_id、width、height、status、targets、schema_version；与data/evidence/2026-10-03-arm-localize-baseline/arm-board-final/arm_localize/README.md中的生成/校验流程一起使用。 | 所在目录说明：[data/evidence/2026-10-03-arm-localize-baseline/arm-board-final/arm_localize/README.md](../../../data/evidence/2026-10-03-arm-localize-baseline/arm-board-final/arm_localize/README.md)<br>同目录输入/元数据：[data/evidence/2026-10-03-arm-localize-baseline/arm-board-final/arm_localize/benchmark/run-1p9nq39b/720p_six/input.json](../../../data/evidence/2026-10-03-arm-localize-baseline/arm-board-final/arm_localize/benchmark/run-1p9nq39b/720p_six/input.json) |
| **data/evidence/2026-10-03-arm-localize-baseline/arm-board-final/arm_localize/benchmark/run-1p9nq39b/720p_six/sample-01-crops-cilds74r** | | |
| [data/evidence/2026-10-03-arm-localize-baseline/arm-board-final/arm_localize/benchmark/run-1p9nq39b/720p_six/sample-01-crops-cilds74r/target_000.hex](../../../data/evidence/2026-10-03-arm-localize-baseline/arm-board-final/arm_localize/benchmark/run-1p9nq39b/720p_six/sample-01-crops-cilds74r/target_000.hex)<br>十六进制数据 · 已纳入Git（含暂存） | 以十六进制数据形式保存target_000的目标ROI像素；由对应加载器/testbench读取，位宽、排布和端序按data/evidence/2026-10-03-arm-localize-baseline/arm-board-final/arm_localize/README.md核对。 | 所在目录说明：[data/evidence/2026-10-03-arm-localize-baseline/arm-board-final/arm_localize/README.md](../../../data/evidence/2026-10-03-arm-localize-baseline/arm-board-final/arm_localize/README.md)<br>同名配套文件：[data/evidence/2026-10-03-arm-localize-baseline/arm-board-final/arm_localize/benchmark/run-1p9nq39b/720p_six/sample-01-crops-cilds74r/target_000.pgm](../../../data/evidence/2026-10-03-arm-localize-baseline/arm-board-final/arm_localize/benchmark/run-1p9nq39b/720p_six/sample-01-crops-cilds74r/target_000.pgm) |
| [data/evidence/2026-10-03-arm-localize-baseline/arm-board-final/arm_localize/benchmark/run-1p9nq39b/720p_six/sample-01-crops-cilds74r/target_000.pgm](../../../data/evidence/2026-10-03-arm-localize-baseline/arm-board-final/arm_localize/benchmark/run-1p9nq39b/720p_six/sample-01-crops-cilds74r/target_000.pgm)<br>灰度像素图 · 已纳入Git（含暂存） | 保存target_000的目标ROI裁剪；其合成/文件/实机来源及框/标签含义以data/evidence/2026-10-03-arm-localize-baseline/arm-board-final/arm_localize/README.md为准。 | 所在目录说明：[data/evidence/2026-10-03-arm-localize-baseline/arm-board-final/arm_localize/README.md](../../../data/evidence/2026-10-03-arm-localize-baseline/arm-board-final/arm_localize/README.md)<br>同名配套文件：[data/evidence/2026-10-03-arm-localize-baseline/arm-board-final/arm_localize/benchmark/run-1p9nq39b/720p_six/sample-01-crops-cilds74r/target_000.hex](../../../data/evidence/2026-10-03-arm-localize-baseline/arm-board-final/arm_localize/benchmark/run-1p9nq39b/720p_six/sample-01-crops-cilds74r/target_000.hex) |
| [data/evidence/2026-10-03-arm-localize-baseline/arm-board-final/arm_localize/benchmark/run-1p9nq39b/720p_six/sample-01-crops-cilds74r/target_001.hex](../../../data/evidence/2026-10-03-arm-localize-baseline/arm-board-final/arm_localize/benchmark/run-1p9nq39b/720p_six/sample-01-crops-cilds74r/target_001.hex)<br>十六进制数据 · 已纳入Git（含暂存） | 以十六进制数据形式保存target_001的目标ROI像素；由对应加载器/testbench读取，位宽、排布和端序按data/evidence/2026-10-03-arm-localize-baseline/arm-board-final/arm_localize/README.md核对。 | 所在目录说明：[data/evidence/2026-10-03-arm-localize-baseline/arm-board-final/arm_localize/README.md](../../../data/evidence/2026-10-03-arm-localize-baseline/arm-board-final/arm_localize/README.md)<br>同名配套文件：[data/evidence/2026-10-03-arm-localize-baseline/arm-board-final/arm_localize/benchmark/run-1p9nq39b/720p_six/sample-01-crops-cilds74r/target_001.pgm](../../../data/evidence/2026-10-03-arm-localize-baseline/arm-board-final/arm_localize/benchmark/run-1p9nq39b/720p_six/sample-01-crops-cilds74r/target_001.pgm) |
| [data/evidence/2026-10-03-arm-localize-baseline/arm-board-final/arm_localize/benchmark/run-1p9nq39b/720p_six/sample-01-crops-cilds74r/target_001.pgm](../../../data/evidence/2026-10-03-arm-localize-baseline/arm-board-final/arm_localize/benchmark/run-1p9nq39b/720p_six/sample-01-crops-cilds74r/target_001.pgm)<br>灰度像素图 · 已纳入Git（含暂存） | 保存target_001的目标ROI裁剪；其合成/文件/实机来源及框/标签含义以data/evidence/2026-10-03-arm-localize-baseline/arm-board-final/arm_localize/README.md为准。 | 所在目录说明：[data/evidence/2026-10-03-arm-localize-baseline/arm-board-final/arm_localize/README.md](../../../data/evidence/2026-10-03-arm-localize-baseline/arm-board-final/arm_localize/README.md)<br>同名配套文件：[data/evidence/2026-10-03-arm-localize-baseline/arm-board-final/arm_localize/benchmark/run-1p9nq39b/720p_six/sample-01-crops-cilds74r/target_001.hex](../../../data/evidence/2026-10-03-arm-localize-baseline/arm-board-final/arm_localize/benchmark/run-1p9nq39b/720p_six/sample-01-crops-cilds74r/target_001.hex) |
| [data/evidence/2026-10-03-arm-localize-baseline/arm-board-final/arm_localize/benchmark/run-1p9nq39b/720p_six/sample-01-crops-cilds74r/target_002.hex](../../../data/evidence/2026-10-03-arm-localize-baseline/arm-board-final/arm_localize/benchmark/run-1p9nq39b/720p_six/sample-01-crops-cilds74r/target_002.hex)<br>十六进制数据 · 已纳入Git（含暂存） | 以十六进制数据形式保存target_002的目标ROI像素；由对应加载器/testbench读取，位宽、排布和端序按data/evidence/2026-10-03-arm-localize-baseline/arm-board-final/arm_localize/README.md核对。 | 所在目录说明：[data/evidence/2026-10-03-arm-localize-baseline/arm-board-final/arm_localize/README.md](../../../data/evidence/2026-10-03-arm-localize-baseline/arm-board-final/arm_localize/README.md)<br>同名配套文件：[data/evidence/2026-10-03-arm-localize-baseline/arm-board-final/arm_localize/benchmark/run-1p9nq39b/720p_six/sample-01-crops-cilds74r/target_002.pgm](../../../data/evidence/2026-10-03-arm-localize-baseline/arm-board-final/arm_localize/benchmark/run-1p9nq39b/720p_six/sample-01-crops-cilds74r/target_002.pgm) |
| [data/evidence/2026-10-03-arm-localize-baseline/arm-board-final/arm_localize/benchmark/run-1p9nq39b/720p_six/sample-01-crops-cilds74r/target_002.pgm](../../../data/evidence/2026-10-03-arm-localize-baseline/arm-board-final/arm_localize/benchmark/run-1p9nq39b/720p_six/sample-01-crops-cilds74r/target_002.pgm)<br>灰度像素图 · 已纳入Git（含暂存） | 保存target_002的目标ROI裁剪；其合成/文件/实机来源及框/标签含义以data/evidence/2026-10-03-arm-localize-baseline/arm-board-final/arm_localize/README.md为准。 | 所在目录说明：[data/evidence/2026-10-03-arm-localize-baseline/arm-board-final/arm_localize/README.md](../../../data/evidence/2026-10-03-arm-localize-baseline/arm-board-final/arm_localize/README.md)<br>同名配套文件：[data/evidence/2026-10-03-arm-localize-baseline/arm-board-final/arm_localize/benchmark/run-1p9nq39b/720p_six/sample-01-crops-cilds74r/target_002.hex](../../../data/evidence/2026-10-03-arm-localize-baseline/arm-board-final/arm_localize/benchmark/run-1p9nq39b/720p_six/sample-01-crops-cilds74r/target_002.hex) |
| [data/evidence/2026-10-03-arm-localize-baseline/arm-board-final/arm_localize/benchmark/run-1p9nq39b/720p_six/sample-01-crops-cilds74r/target_003.hex](../../../data/evidence/2026-10-03-arm-localize-baseline/arm-board-final/arm_localize/benchmark/run-1p9nq39b/720p_six/sample-01-crops-cilds74r/target_003.hex)<br>十六进制数据 · 已纳入Git（含暂存） | 以十六进制数据形式保存target_003的目标ROI像素；由对应加载器/testbench读取，位宽、排布和端序按data/evidence/2026-10-03-arm-localize-baseline/arm-board-final/arm_localize/README.md核对。 | 所在目录说明：[data/evidence/2026-10-03-arm-localize-baseline/arm-board-final/arm_localize/README.md](../../../data/evidence/2026-10-03-arm-localize-baseline/arm-board-final/arm_localize/README.md)<br>同名配套文件：[data/evidence/2026-10-03-arm-localize-baseline/arm-board-final/arm_localize/benchmark/run-1p9nq39b/720p_six/sample-01-crops-cilds74r/target_003.pgm](../../../data/evidence/2026-10-03-arm-localize-baseline/arm-board-final/arm_localize/benchmark/run-1p9nq39b/720p_six/sample-01-crops-cilds74r/target_003.pgm) |
| [data/evidence/2026-10-03-arm-localize-baseline/arm-board-final/arm_localize/benchmark/run-1p9nq39b/720p_six/sample-01-crops-cilds74r/target_003.pgm](../../../data/evidence/2026-10-03-arm-localize-baseline/arm-board-final/arm_localize/benchmark/run-1p9nq39b/720p_six/sample-01-crops-cilds74r/target_003.pgm)<br>灰度像素图 · 已纳入Git（含暂存） | 保存target_003的目标ROI裁剪；其合成/文件/实机来源及框/标签含义以data/evidence/2026-10-03-arm-localize-baseline/arm-board-final/arm_localize/README.md为准。 | 所在目录说明：[data/evidence/2026-10-03-arm-localize-baseline/arm-board-final/arm_localize/README.md](../../../data/evidence/2026-10-03-arm-localize-baseline/arm-board-final/arm_localize/README.md)<br>同名配套文件：[data/evidence/2026-10-03-arm-localize-baseline/arm-board-final/arm_localize/benchmark/run-1p9nq39b/720p_six/sample-01-crops-cilds74r/target_003.hex](../../../data/evidence/2026-10-03-arm-localize-baseline/arm-board-final/arm_localize/benchmark/run-1p9nq39b/720p_six/sample-01-crops-cilds74r/target_003.hex) |
| [data/evidence/2026-10-03-arm-localize-baseline/arm-board-final/arm_localize/benchmark/run-1p9nq39b/720p_six/sample-01-crops-cilds74r/target_004.hex](../../../data/evidence/2026-10-03-arm-localize-baseline/arm-board-final/arm_localize/benchmark/run-1p9nq39b/720p_six/sample-01-crops-cilds74r/target_004.hex)<br>十六进制数据 · 已纳入Git（含暂存） | 以十六进制数据形式保存target_004的目标ROI像素；由对应加载器/testbench读取，位宽、排布和端序按data/evidence/2026-10-03-arm-localize-baseline/arm-board-final/arm_localize/README.md核对。 | 所在目录说明：[data/evidence/2026-10-03-arm-localize-baseline/arm-board-final/arm_localize/README.md](../../../data/evidence/2026-10-03-arm-localize-baseline/arm-board-final/arm_localize/README.md)<br>同名配套文件：[data/evidence/2026-10-03-arm-localize-baseline/arm-board-final/arm_localize/benchmark/run-1p9nq39b/720p_six/sample-01-crops-cilds74r/target_004.pgm](../../../data/evidence/2026-10-03-arm-localize-baseline/arm-board-final/arm_localize/benchmark/run-1p9nq39b/720p_six/sample-01-crops-cilds74r/target_004.pgm) |
| [data/evidence/2026-10-03-arm-localize-baseline/arm-board-final/arm_localize/benchmark/run-1p9nq39b/720p_six/sample-01-crops-cilds74r/target_004.pgm](../../../data/evidence/2026-10-03-arm-localize-baseline/arm-board-final/arm_localize/benchmark/run-1p9nq39b/720p_six/sample-01-crops-cilds74r/target_004.pgm)<br>灰度像素图 · 已纳入Git（含暂存） | 保存target_004的目标ROI裁剪；其合成/文件/实机来源及框/标签含义以data/evidence/2026-10-03-arm-localize-baseline/arm-board-final/arm_localize/README.md为准。 | 所在目录说明：[data/evidence/2026-10-03-arm-localize-baseline/arm-board-final/arm_localize/README.md](../../../data/evidence/2026-10-03-arm-localize-baseline/arm-board-final/arm_localize/README.md)<br>同名配套文件：[data/evidence/2026-10-03-arm-localize-baseline/arm-board-final/arm_localize/benchmark/run-1p9nq39b/720p_six/sample-01-crops-cilds74r/target_004.hex](../../../data/evidence/2026-10-03-arm-localize-baseline/arm-board-final/arm_localize/benchmark/run-1p9nq39b/720p_six/sample-01-crops-cilds74r/target_004.hex) |
| [data/evidence/2026-10-03-arm-localize-baseline/arm-board-final/arm_localize/benchmark/run-1p9nq39b/720p_six/sample-01-crops-cilds74r/target_005.hex](../../../data/evidence/2026-10-03-arm-localize-baseline/arm-board-final/arm_localize/benchmark/run-1p9nq39b/720p_six/sample-01-crops-cilds74r/target_005.hex)<br>十六进制数据 · 已纳入Git（含暂存） | 以十六进制数据形式保存target_005的目标ROI像素；由对应加载器/testbench读取，位宽、排布和端序按data/evidence/2026-10-03-arm-localize-baseline/arm-board-final/arm_localize/README.md核对。 | 所在目录说明：[data/evidence/2026-10-03-arm-localize-baseline/arm-board-final/arm_localize/README.md](../../../data/evidence/2026-10-03-arm-localize-baseline/arm-board-final/arm_localize/README.md)<br>同名配套文件：[data/evidence/2026-10-03-arm-localize-baseline/arm-board-final/arm_localize/benchmark/run-1p9nq39b/720p_six/sample-01-crops-cilds74r/target_005.pgm](../../../data/evidence/2026-10-03-arm-localize-baseline/arm-board-final/arm_localize/benchmark/run-1p9nq39b/720p_six/sample-01-crops-cilds74r/target_005.pgm) |
| [data/evidence/2026-10-03-arm-localize-baseline/arm-board-final/arm_localize/benchmark/run-1p9nq39b/720p_six/sample-01-crops-cilds74r/target_005.pgm](../../../data/evidence/2026-10-03-arm-localize-baseline/arm-board-final/arm_localize/benchmark/run-1p9nq39b/720p_six/sample-01-crops-cilds74r/target_005.pgm)<br>灰度像素图 · 已纳入Git（含暂存） | 保存target_005的目标ROI裁剪；其合成/文件/实机来源及框/标签含义以data/evidence/2026-10-03-arm-localize-baseline/arm-board-final/arm_localize/README.md为准。 | 所在目录说明：[data/evidence/2026-10-03-arm-localize-baseline/arm-board-final/arm_localize/README.md](../../../data/evidence/2026-10-03-arm-localize-baseline/arm-board-final/arm_localize/README.md)<br>同名配套文件：[data/evidence/2026-10-03-arm-localize-baseline/arm-board-final/arm_localize/benchmark/run-1p9nq39b/720p_six/sample-01-crops-cilds74r/target_005.hex](../../../data/evidence/2026-10-03-arm-localize-baseline/arm-board-final/arm_localize/benchmark/run-1p9nq39b/720p_six/sample-01-crops-cilds74r/target_005.hex) |
| **data/evidence/2026-10-03-arm-localize-baseline/arm-board-final/arm_localize/benchmark/run-1p9nq39b/720p_six** | | |
| [data/evidence/2026-10-03-arm-localize-baseline/arm-board-final/arm_localize/benchmark/run-1p9nq39b/720p_six/sample-01.json](../../../data/evidence/2026-10-03-arm-localize-baseline/arm-board-final/arm_localize/benchmark/run-1p9nq39b/720p_six/sample-01.json)<br>结构化结果/元数据 · 已纳入Git（含暂存） | 保存sample-01的实验结果或检查产物，字段包括frame_id、config_id、width、height、status、targets、schema_version；与data/evidence/2026-10-03-arm-localize-baseline/arm-board-final/arm_localize/README.md中的生成/校验流程一起使用。 | 所在目录说明：[data/evidence/2026-10-03-arm-localize-baseline/arm-board-final/arm_localize/README.md](../../../data/evidence/2026-10-03-arm-localize-baseline/arm-board-final/arm_localize/README.md)<br>同目录输入/元数据：[data/evidence/2026-10-03-arm-localize-baseline/arm-board-final/arm_localize/benchmark/run-1p9nq39b/720p_six/input.json](../../../data/evidence/2026-10-03-arm-localize-baseline/arm-board-final/arm_localize/benchmark/run-1p9nq39b/720p_six/input.json) |
| **data/evidence/2026-10-03-arm-localize-baseline/arm-board-final/arm_localize/benchmark/run-1p9nq39b/720p_six/sample-02-crops-1fpbzr_6** | | |
| [data/evidence/2026-10-03-arm-localize-baseline/arm-board-final/arm_localize/benchmark/run-1p9nq39b/720p_six/sample-02-crops-1fpbzr_6/target_000.hex](../../../data/evidence/2026-10-03-arm-localize-baseline/arm-board-final/arm_localize/benchmark/run-1p9nq39b/720p_six/sample-02-crops-1fpbzr_6/target_000.hex)<br>十六进制数据 · 已纳入Git（含暂存） | 以十六进制数据形式保存target_000的目标ROI像素；由对应加载器/testbench读取，位宽、排布和端序按data/evidence/2026-10-03-arm-localize-baseline/arm-board-final/arm_localize/README.md核对。 | 所在目录说明：[data/evidence/2026-10-03-arm-localize-baseline/arm-board-final/arm_localize/README.md](../../../data/evidence/2026-10-03-arm-localize-baseline/arm-board-final/arm_localize/README.md)<br>同名配套文件：[data/evidence/2026-10-03-arm-localize-baseline/arm-board-final/arm_localize/benchmark/run-1p9nq39b/720p_six/sample-02-crops-1fpbzr_6/target_000.pgm](../../../data/evidence/2026-10-03-arm-localize-baseline/arm-board-final/arm_localize/benchmark/run-1p9nq39b/720p_six/sample-02-crops-1fpbzr_6/target_000.pgm) |
| [data/evidence/2026-10-03-arm-localize-baseline/arm-board-final/arm_localize/benchmark/run-1p9nq39b/720p_six/sample-02-crops-1fpbzr_6/target_000.pgm](../../../data/evidence/2026-10-03-arm-localize-baseline/arm-board-final/arm_localize/benchmark/run-1p9nq39b/720p_six/sample-02-crops-1fpbzr_6/target_000.pgm)<br>灰度像素图 · 已纳入Git（含暂存） | 保存target_000的目标ROI裁剪；其合成/文件/实机来源及框/标签含义以data/evidence/2026-10-03-arm-localize-baseline/arm-board-final/arm_localize/README.md为准。 | 所在目录说明：[data/evidence/2026-10-03-arm-localize-baseline/arm-board-final/arm_localize/README.md](../../../data/evidence/2026-10-03-arm-localize-baseline/arm-board-final/arm_localize/README.md)<br>同名配套文件：[data/evidence/2026-10-03-arm-localize-baseline/arm-board-final/arm_localize/benchmark/run-1p9nq39b/720p_six/sample-02-crops-1fpbzr_6/target_000.hex](../../../data/evidence/2026-10-03-arm-localize-baseline/arm-board-final/arm_localize/benchmark/run-1p9nq39b/720p_six/sample-02-crops-1fpbzr_6/target_000.hex) |
| [data/evidence/2026-10-03-arm-localize-baseline/arm-board-final/arm_localize/benchmark/run-1p9nq39b/720p_six/sample-02-crops-1fpbzr_6/target_001.hex](../../../data/evidence/2026-10-03-arm-localize-baseline/arm-board-final/arm_localize/benchmark/run-1p9nq39b/720p_six/sample-02-crops-1fpbzr_6/target_001.hex)<br>十六进制数据 · 已纳入Git（含暂存） | 以十六进制数据形式保存target_001的目标ROI像素；由对应加载器/testbench读取，位宽、排布和端序按data/evidence/2026-10-03-arm-localize-baseline/arm-board-final/arm_localize/README.md核对。 | 所在目录说明：[data/evidence/2026-10-03-arm-localize-baseline/arm-board-final/arm_localize/README.md](../../../data/evidence/2026-10-03-arm-localize-baseline/arm-board-final/arm_localize/README.md)<br>同名配套文件：[data/evidence/2026-10-03-arm-localize-baseline/arm-board-final/arm_localize/benchmark/run-1p9nq39b/720p_six/sample-02-crops-1fpbzr_6/target_001.pgm](../../../data/evidence/2026-10-03-arm-localize-baseline/arm-board-final/arm_localize/benchmark/run-1p9nq39b/720p_six/sample-02-crops-1fpbzr_6/target_001.pgm) |
| [data/evidence/2026-10-03-arm-localize-baseline/arm-board-final/arm_localize/benchmark/run-1p9nq39b/720p_six/sample-02-crops-1fpbzr_6/target_001.pgm](../../../data/evidence/2026-10-03-arm-localize-baseline/arm-board-final/arm_localize/benchmark/run-1p9nq39b/720p_six/sample-02-crops-1fpbzr_6/target_001.pgm)<br>灰度像素图 · 已纳入Git（含暂存） | 保存target_001的目标ROI裁剪；其合成/文件/实机来源及框/标签含义以data/evidence/2026-10-03-arm-localize-baseline/arm-board-final/arm_localize/README.md为准。 | 所在目录说明：[data/evidence/2026-10-03-arm-localize-baseline/arm-board-final/arm_localize/README.md](../../../data/evidence/2026-10-03-arm-localize-baseline/arm-board-final/arm_localize/README.md)<br>同名配套文件：[data/evidence/2026-10-03-arm-localize-baseline/arm-board-final/arm_localize/benchmark/run-1p9nq39b/720p_six/sample-02-crops-1fpbzr_6/target_001.hex](../../../data/evidence/2026-10-03-arm-localize-baseline/arm-board-final/arm_localize/benchmark/run-1p9nq39b/720p_six/sample-02-crops-1fpbzr_6/target_001.hex) |
| [data/evidence/2026-10-03-arm-localize-baseline/arm-board-final/arm_localize/benchmark/run-1p9nq39b/720p_six/sample-02-crops-1fpbzr_6/target_002.hex](../../../data/evidence/2026-10-03-arm-localize-baseline/arm-board-final/arm_localize/benchmark/run-1p9nq39b/720p_six/sample-02-crops-1fpbzr_6/target_002.hex)<br>十六进制数据 · 已纳入Git（含暂存） | 以十六进制数据形式保存target_002的目标ROI像素；由对应加载器/testbench读取，位宽、排布和端序按data/evidence/2026-10-03-arm-localize-baseline/arm-board-final/arm_localize/README.md核对。 | 所在目录说明：[data/evidence/2026-10-03-arm-localize-baseline/arm-board-final/arm_localize/README.md](../../../data/evidence/2026-10-03-arm-localize-baseline/arm-board-final/arm_localize/README.md)<br>同名配套文件：[data/evidence/2026-10-03-arm-localize-baseline/arm-board-final/arm_localize/benchmark/run-1p9nq39b/720p_six/sample-02-crops-1fpbzr_6/target_002.pgm](../../../data/evidence/2026-10-03-arm-localize-baseline/arm-board-final/arm_localize/benchmark/run-1p9nq39b/720p_six/sample-02-crops-1fpbzr_6/target_002.pgm) |
| [data/evidence/2026-10-03-arm-localize-baseline/arm-board-final/arm_localize/benchmark/run-1p9nq39b/720p_six/sample-02-crops-1fpbzr_6/target_002.pgm](../../../data/evidence/2026-10-03-arm-localize-baseline/arm-board-final/arm_localize/benchmark/run-1p9nq39b/720p_six/sample-02-crops-1fpbzr_6/target_002.pgm)<br>灰度像素图 · 已纳入Git（含暂存） | 保存target_002的目标ROI裁剪；其合成/文件/实机来源及框/标签含义以data/evidence/2026-10-03-arm-localize-baseline/arm-board-final/arm_localize/README.md为准。 | 所在目录说明：[data/evidence/2026-10-03-arm-localize-baseline/arm-board-final/arm_localize/README.md](../../../data/evidence/2026-10-03-arm-localize-baseline/arm-board-final/arm_localize/README.md)<br>同名配套文件：[data/evidence/2026-10-03-arm-localize-baseline/arm-board-final/arm_localize/benchmark/run-1p9nq39b/720p_six/sample-02-crops-1fpbzr_6/target_002.hex](../../../data/evidence/2026-10-03-arm-localize-baseline/arm-board-final/arm_localize/benchmark/run-1p9nq39b/720p_six/sample-02-crops-1fpbzr_6/target_002.hex) |
| [data/evidence/2026-10-03-arm-localize-baseline/arm-board-final/arm_localize/benchmark/run-1p9nq39b/720p_six/sample-02-crops-1fpbzr_6/target_003.hex](../../../data/evidence/2026-10-03-arm-localize-baseline/arm-board-final/arm_localize/benchmark/run-1p9nq39b/720p_six/sample-02-crops-1fpbzr_6/target_003.hex)<br>十六进制数据 · 已纳入Git（含暂存） | 以十六进制数据形式保存target_003的目标ROI像素；由对应加载器/testbench读取，位宽、排布和端序按data/evidence/2026-10-03-arm-localize-baseline/arm-board-final/arm_localize/README.md核对。 | 所在目录说明：[data/evidence/2026-10-03-arm-localize-baseline/arm-board-final/arm_localize/README.md](../../../data/evidence/2026-10-03-arm-localize-baseline/arm-board-final/arm_localize/README.md)<br>同名配套文件：[data/evidence/2026-10-03-arm-localize-baseline/arm-board-final/arm_localize/benchmark/run-1p9nq39b/720p_six/sample-02-crops-1fpbzr_6/target_003.pgm](../../../data/evidence/2026-10-03-arm-localize-baseline/arm-board-final/arm_localize/benchmark/run-1p9nq39b/720p_six/sample-02-crops-1fpbzr_6/target_003.pgm) |
| [data/evidence/2026-10-03-arm-localize-baseline/arm-board-final/arm_localize/benchmark/run-1p9nq39b/720p_six/sample-02-crops-1fpbzr_6/target_003.pgm](../../../data/evidence/2026-10-03-arm-localize-baseline/arm-board-final/arm_localize/benchmark/run-1p9nq39b/720p_six/sample-02-crops-1fpbzr_6/target_003.pgm)<br>灰度像素图 · 已纳入Git（含暂存） | 保存target_003的目标ROI裁剪；其合成/文件/实机来源及框/标签含义以data/evidence/2026-10-03-arm-localize-baseline/arm-board-final/arm_localize/README.md为准。 | 所在目录说明：[data/evidence/2026-10-03-arm-localize-baseline/arm-board-final/arm_localize/README.md](../../../data/evidence/2026-10-03-arm-localize-baseline/arm-board-final/arm_localize/README.md)<br>同名配套文件：[data/evidence/2026-10-03-arm-localize-baseline/arm-board-final/arm_localize/benchmark/run-1p9nq39b/720p_six/sample-02-crops-1fpbzr_6/target_003.hex](../../../data/evidence/2026-10-03-arm-localize-baseline/arm-board-final/arm_localize/benchmark/run-1p9nq39b/720p_six/sample-02-crops-1fpbzr_6/target_003.hex) |
| [data/evidence/2026-10-03-arm-localize-baseline/arm-board-final/arm_localize/benchmark/run-1p9nq39b/720p_six/sample-02-crops-1fpbzr_6/target_004.hex](../../../data/evidence/2026-10-03-arm-localize-baseline/arm-board-final/arm_localize/benchmark/run-1p9nq39b/720p_six/sample-02-crops-1fpbzr_6/target_004.hex)<br>十六进制数据 · 已纳入Git（含暂存） | 以十六进制数据形式保存target_004的目标ROI像素；由对应加载器/testbench读取，位宽、排布和端序按data/evidence/2026-10-03-arm-localize-baseline/arm-board-final/arm_localize/README.md核对。 | 所在目录说明：[data/evidence/2026-10-03-arm-localize-baseline/arm-board-final/arm_localize/README.md](../../../data/evidence/2026-10-03-arm-localize-baseline/arm-board-final/arm_localize/README.md)<br>同名配套文件：[data/evidence/2026-10-03-arm-localize-baseline/arm-board-final/arm_localize/benchmark/run-1p9nq39b/720p_six/sample-02-crops-1fpbzr_6/target_004.pgm](../../../data/evidence/2026-10-03-arm-localize-baseline/arm-board-final/arm_localize/benchmark/run-1p9nq39b/720p_six/sample-02-crops-1fpbzr_6/target_004.pgm) |
| [data/evidence/2026-10-03-arm-localize-baseline/arm-board-final/arm_localize/benchmark/run-1p9nq39b/720p_six/sample-02-crops-1fpbzr_6/target_004.pgm](../../../data/evidence/2026-10-03-arm-localize-baseline/arm-board-final/arm_localize/benchmark/run-1p9nq39b/720p_six/sample-02-crops-1fpbzr_6/target_004.pgm)<br>灰度像素图 · 已纳入Git（含暂存） | 保存target_004的目标ROI裁剪；其合成/文件/实机来源及框/标签含义以data/evidence/2026-10-03-arm-localize-baseline/arm-board-final/arm_localize/README.md为准。 | 所在目录说明：[data/evidence/2026-10-03-arm-localize-baseline/arm-board-final/arm_localize/README.md](../../../data/evidence/2026-10-03-arm-localize-baseline/arm-board-final/arm_localize/README.md)<br>同名配套文件：[data/evidence/2026-10-03-arm-localize-baseline/arm-board-final/arm_localize/benchmark/run-1p9nq39b/720p_six/sample-02-crops-1fpbzr_6/target_004.hex](../../../data/evidence/2026-10-03-arm-localize-baseline/arm-board-final/arm_localize/benchmark/run-1p9nq39b/720p_six/sample-02-crops-1fpbzr_6/target_004.hex) |
| [data/evidence/2026-10-03-arm-localize-baseline/arm-board-final/arm_localize/benchmark/run-1p9nq39b/720p_six/sample-02-crops-1fpbzr_6/target_005.hex](../../../data/evidence/2026-10-03-arm-localize-baseline/arm-board-final/arm_localize/benchmark/run-1p9nq39b/720p_six/sample-02-crops-1fpbzr_6/target_005.hex)<br>十六进制数据 · 已纳入Git（含暂存） | 以十六进制数据形式保存target_005的目标ROI像素；由对应加载器/testbench读取，位宽、排布和端序按data/evidence/2026-10-03-arm-localize-baseline/arm-board-final/arm_localize/README.md核对。 | 所在目录说明：[data/evidence/2026-10-03-arm-localize-baseline/arm-board-final/arm_localize/README.md](../../../data/evidence/2026-10-03-arm-localize-baseline/arm-board-final/arm_localize/README.md)<br>同名配套文件：[data/evidence/2026-10-03-arm-localize-baseline/arm-board-final/arm_localize/benchmark/run-1p9nq39b/720p_six/sample-02-crops-1fpbzr_6/target_005.pgm](../../../data/evidence/2026-10-03-arm-localize-baseline/arm-board-final/arm_localize/benchmark/run-1p9nq39b/720p_six/sample-02-crops-1fpbzr_6/target_005.pgm) |
| [data/evidence/2026-10-03-arm-localize-baseline/arm-board-final/arm_localize/benchmark/run-1p9nq39b/720p_six/sample-02-crops-1fpbzr_6/target_005.pgm](../../../data/evidence/2026-10-03-arm-localize-baseline/arm-board-final/arm_localize/benchmark/run-1p9nq39b/720p_six/sample-02-crops-1fpbzr_6/target_005.pgm)<br>灰度像素图 · 已纳入Git（含暂存） | 保存target_005的目标ROI裁剪；其合成/文件/实机来源及框/标签含义以data/evidence/2026-10-03-arm-localize-baseline/arm-board-final/arm_localize/README.md为准。 | 所在目录说明：[data/evidence/2026-10-03-arm-localize-baseline/arm-board-final/arm_localize/README.md](../../../data/evidence/2026-10-03-arm-localize-baseline/arm-board-final/arm_localize/README.md)<br>同名配套文件：[data/evidence/2026-10-03-arm-localize-baseline/arm-board-final/arm_localize/benchmark/run-1p9nq39b/720p_six/sample-02-crops-1fpbzr_6/target_005.hex](../../../data/evidence/2026-10-03-arm-localize-baseline/arm-board-final/arm_localize/benchmark/run-1p9nq39b/720p_six/sample-02-crops-1fpbzr_6/target_005.hex) |
| **data/evidence/2026-10-03-arm-localize-baseline/arm-board-final/arm_localize/benchmark/run-1p9nq39b/720p_six** | | |
| [data/evidence/2026-10-03-arm-localize-baseline/arm-board-final/arm_localize/benchmark/run-1p9nq39b/720p_six/sample-02.json](../../../data/evidence/2026-10-03-arm-localize-baseline/arm-board-final/arm_localize/benchmark/run-1p9nq39b/720p_six/sample-02.json)<br>结构化结果/元数据 · 已纳入Git（含暂存） | 保存sample-02的实验结果或检查产物，字段包括frame_id、config_id、width、height、status、targets、schema_version；与data/evidence/2026-10-03-arm-localize-baseline/arm-board-final/arm_localize/README.md中的生成/校验流程一起使用。 | 所在目录说明：[data/evidence/2026-10-03-arm-localize-baseline/arm-board-final/arm_localize/README.md](../../../data/evidence/2026-10-03-arm-localize-baseline/arm-board-final/arm_localize/README.md)<br>同目录输入/元数据：[data/evidence/2026-10-03-arm-localize-baseline/arm-board-final/arm_localize/benchmark/run-1p9nq39b/720p_six/input.json](../../../data/evidence/2026-10-03-arm-localize-baseline/arm-board-final/arm_localize/benchmark/run-1p9nq39b/720p_six/input.json) |
| **data/evidence/2026-10-03-arm-localize-baseline/arm-board-final/arm_localize/benchmark/run-1p9nq39b/720p_six/sample-03-crops-sf35kw5c** | | |
| [data/evidence/2026-10-03-arm-localize-baseline/arm-board-final/arm_localize/benchmark/run-1p9nq39b/720p_six/sample-03-crops-sf35kw5c/target_000.hex](../../../data/evidence/2026-10-03-arm-localize-baseline/arm-board-final/arm_localize/benchmark/run-1p9nq39b/720p_six/sample-03-crops-sf35kw5c/target_000.hex)<br>十六进制数据 · 已纳入Git（含暂存） | 以十六进制数据形式保存target_000的目标ROI像素；由对应加载器/testbench读取，位宽、排布和端序按data/evidence/2026-10-03-arm-localize-baseline/arm-board-final/arm_localize/README.md核对。 | 所在目录说明：[data/evidence/2026-10-03-arm-localize-baseline/arm-board-final/arm_localize/README.md](../../../data/evidence/2026-10-03-arm-localize-baseline/arm-board-final/arm_localize/README.md)<br>同名配套文件：[data/evidence/2026-10-03-arm-localize-baseline/arm-board-final/arm_localize/benchmark/run-1p9nq39b/720p_six/sample-03-crops-sf35kw5c/target_000.pgm](../../../data/evidence/2026-10-03-arm-localize-baseline/arm-board-final/arm_localize/benchmark/run-1p9nq39b/720p_six/sample-03-crops-sf35kw5c/target_000.pgm) |
| [data/evidence/2026-10-03-arm-localize-baseline/arm-board-final/arm_localize/benchmark/run-1p9nq39b/720p_six/sample-03-crops-sf35kw5c/target_000.pgm](../../../data/evidence/2026-10-03-arm-localize-baseline/arm-board-final/arm_localize/benchmark/run-1p9nq39b/720p_six/sample-03-crops-sf35kw5c/target_000.pgm)<br>灰度像素图 · 已纳入Git（含暂存） | 保存target_000的目标ROI裁剪；其合成/文件/实机来源及框/标签含义以data/evidence/2026-10-03-arm-localize-baseline/arm-board-final/arm_localize/README.md为准。 | 所在目录说明：[data/evidence/2026-10-03-arm-localize-baseline/arm-board-final/arm_localize/README.md](../../../data/evidence/2026-10-03-arm-localize-baseline/arm-board-final/arm_localize/README.md)<br>同名配套文件：[data/evidence/2026-10-03-arm-localize-baseline/arm-board-final/arm_localize/benchmark/run-1p9nq39b/720p_six/sample-03-crops-sf35kw5c/target_000.hex](../../../data/evidence/2026-10-03-arm-localize-baseline/arm-board-final/arm_localize/benchmark/run-1p9nq39b/720p_six/sample-03-crops-sf35kw5c/target_000.hex) |
| [data/evidence/2026-10-03-arm-localize-baseline/arm-board-final/arm_localize/benchmark/run-1p9nq39b/720p_six/sample-03-crops-sf35kw5c/target_001.hex](../../../data/evidence/2026-10-03-arm-localize-baseline/arm-board-final/arm_localize/benchmark/run-1p9nq39b/720p_six/sample-03-crops-sf35kw5c/target_001.hex)<br>十六进制数据 · 已纳入Git（含暂存） | 以十六进制数据形式保存target_001的目标ROI像素；由对应加载器/testbench读取，位宽、排布和端序按data/evidence/2026-10-03-arm-localize-baseline/arm-board-final/arm_localize/README.md核对。 | 所在目录说明：[data/evidence/2026-10-03-arm-localize-baseline/arm-board-final/arm_localize/README.md](../../../data/evidence/2026-10-03-arm-localize-baseline/arm-board-final/arm_localize/README.md)<br>同名配套文件：[data/evidence/2026-10-03-arm-localize-baseline/arm-board-final/arm_localize/benchmark/run-1p9nq39b/720p_six/sample-03-crops-sf35kw5c/target_001.pgm](../../../data/evidence/2026-10-03-arm-localize-baseline/arm-board-final/arm_localize/benchmark/run-1p9nq39b/720p_six/sample-03-crops-sf35kw5c/target_001.pgm) |
| [data/evidence/2026-10-03-arm-localize-baseline/arm-board-final/arm_localize/benchmark/run-1p9nq39b/720p_six/sample-03-crops-sf35kw5c/target_001.pgm](../../../data/evidence/2026-10-03-arm-localize-baseline/arm-board-final/arm_localize/benchmark/run-1p9nq39b/720p_six/sample-03-crops-sf35kw5c/target_001.pgm)<br>灰度像素图 · 已纳入Git（含暂存） | 保存target_001的目标ROI裁剪；其合成/文件/实机来源及框/标签含义以data/evidence/2026-10-03-arm-localize-baseline/arm-board-final/arm_localize/README.md为准。 | 所在目录说明：[data/evidence/2026-10-03-arm-localize-baseline/arm-board-final/arm_localize/README.md](../../../data/evidence/2026-10-03-arm-localize-baseline/arm-board-final/arm_localize/README.md)<br>同名配套文件：[data/evidence/2026-10-03-arm-localize-baseline/arm-board-final/arm_localize/benchmark/run-1p9nq39b/720p_six/sample-03-crops-sf35kw5c/target_001.hex](../../../data/evidence/2026-10-03-arm-localize-baseline/arm-board-final/arm_localize/benchmark/run-1p9nq39b/720p_six/sample-03-crops-sf35kw5c/target_001.hex) |
| [data/evidence/2026-10-03-arm-localize-baseline/arm-board-final/arm_localize/benchmark/run-1p9nq39b/720p_six/sample-03-crops-sf35kw5c/target_002.hex](../../../data/evidence/2026-10-03-arm-localize-baseline/arm-board-final/arm_localize/benchmark/run-1p9nq39b/720p_six/sample-03-crops-sf35kw5c/target_002.hex)<br>十六进制数据 · 已纳入Git（含暂存） | 以十六进制数据形式保存target_002的目标ROI像素；由对应加载器/testbench读取，位宽、排布和端序按data/evidence/2026-10-03-arm-localize-baseline/arm-board-final/arm_localize/README.md核对。 | 所在目录说明：[data/evidence/2026-10-03-arm-localize-baseline/arm-board-final/arm_localize/README.md](../../../data/evidence/2026-10-03-arm-localize-baseline/arm-board-final/arm_localize/README.md)<br>同名配套文件：[data/evidence/2026-10-03-arm-localize-baseline/arm-board-final/arm_localize/benchmark/run-1p9nq39b/720p_six/sample-03-crops-sf35kw5c/target_002.pgm](../../../data/evidence/2026-10-03-arm-localize-baseline/arm-board-final/arm_localize/benchmark/run-1p9nq39b/720p_six/sample-03-crops-sf35kw5c/target_002.pgm) |
| [data/evidence/2026-10-03-arm-localize-baseline/arm-board-final/arm_localize/benchmark/run-1p9nq39b/720p_six/sample-03-crops-sf35kw5c/target_002.pgm](../../../data/evidence/2026-10-03-arm-localize-baseline/arm-board-final/arm_localize/benchmark/run-1p9nq39b/720p_six/sample-03-crops-sf35kw5c/target_002.pgm)<br>灰度像素图 · 已纳入Git（含暂存） | 保存target_002的目标ROI裁剪；其合成/文件/实机来源及框/标签含义以data/evidence/2026-10-03-arm-localize-baseline/arm-board-final/arm_localize/README.md为准。 | 所在目录说明：[data/evidence/2026-10-03-arm-localize-baseline/arm-board-final/arm_localize/README.md](../../../data/evidence/2026-10-03-arm-localize-baseline/arm-board-final/arm_localize/README.md)<br>同名配套文件：[data/evidence/2026-10-03-arm-localize-baseline/arm-board-final/arm_localize/benchmark/run-1p9nq39b/720p_six/sample-03-crops-sf35kw5c/target_002.hex](../../../data/evidence/2026-10-03-arm-localize-baseline/arm-board-final/arm_localize/benchmark/run-1p9nq39b/720p_six/sample-03-crops-sf35kw5c/target_002.hex) |
| [data/evidence/2026-10-03-arm-localize-baseline/arm-board-final/arm_localize/benchmark/run-1p9nq39b/720p_six/sample-03-crops-sf35kw5c/target_003.hex](../../../data/evidence/2026-10-03-arm-localize-baseline/arm-board-final/arm_localize/benchmark/run-1p9nq39b/720p_six/sample-03-crops-sf35kw5c/target_003.hex)<br>十六进制数据 · 已纳入Git（含暂存） | 以十六进制数据形式保存target_003的目标ROI像素；由对应加载器/testbench读取，位宽、排布和端序按data/evidence/2026-10-03-arm-localize-baseline/arm-board-final/arm_localize/README.md核对。 | 所在目录说明：[data/evidence/2026-10-03-arm-localize-baseline/arm-board-final/arm_localize/README.md](../../../data/evidence/2026-10-03-arm-localize-baseline/arm-board-final/arm_localize/README.md)<br>同名配套文件：[data/evidence/2026-10-03-arm-localize-baseline/arm-board-final/arm_localize/benchmark/run-1p9nq39b/720p_six/sample-03-crops-sf35kw5c/target_003.pgm](../../../data/evidence/2026-10-03-arm-localize-baseline/arm-board-final/arm_localize/benchmark/run-1p9nq39b/720p_six/sample-03-crops-sf35kw5c/target_003.pgm) |
| [data/evidence/2026-10-03-arm-localize-baseline/arm-board-final/arm_localize/benchmark/run-1p9nq39b/720p_six/sample-03-crops-sf35kw5c/target_003.pgm](../../../data/evidence/2026-10-03-arm-localize-baseline/arm-board-final/arm_localize/benchmark/run-1p9nq39b/720p_six/sample-03-crops-sf35kw5c/target_003.pgm)<br>灰度像素图 · 已纳入Git（含暂存） | 保存target_003的目标ROI裁剪；其合成/文件/实机来源及框/标签含义以data/evidence/2026-10-03-arm-localize-baseline/arm-board-final/arm_localize/README.md为准。 | 所在目录说明：[data/evidence/2026-10-03-arm-localize-baseline/arm-board-final/arm_localize/README.md](../../../data/evidence/2026-10-03-arm-localize-baseline/arm-board-final/arm_localize/README.md)<br>同名配套文件：[data/evidence/2026-10-03-arm-localize-baseline/arm-board-final/arm_localize/benchmark/run-1p9nq39b/720p_six/sample-03-crops-sf35kw5c/target_003.hex](../../../data/evidence/2026-10-03-arm-localize-baseline/arm-board-final/arm_localize/benchmark/run-1p9nq39b/720p_six/sample-03-crops-sf35kw5c/target_003.hex) |
| [data/evidence/2026-10-03-arm-localize-baseline/arm-board-final/arm_localize/benchmark/run-1p9nq39b/720p_six/sample-03-crops-sf35kw5c/target_004.hex](../../../data/evidence/2026-10-03-arm-localize-baseline/arm-board-final/arm_localize/benchmark/run-1p9nq39b/720p_six/sample-03-crops-sf35kw5c/target_004.hex)<br>十六进制数据 · 已纳入Git（含暂存） | 以十六进制数据形式保存target_004的目标ROI像素；由对应加载器/testbench读取，位宽、排布和端序按data/evidence/2026-10-03-arm-localize-baseline/arm-board-final/arm_localize/README.md核对。 | 所在目录说明：[data/evidence/2026-10-03-arm-localize-baseline/arm-board-final/arm_localize/README.md](../../../data/evidence/2026-10-03-arm-localize-baseline/arm-board-final/arm_localize/README.md)<br>同名配套文件：[data/evidence/2026-10-03-arm-localize-baseline/arm-board-final/arm_localize/benchmark/run-1p9nq39b/720p_six/sample-03-crops-sf35kw5c/target_004.pgm](../../../data/evidence/2026-10-03-arm-localize-baseline/arm-board-final/arm_localize/benchmark/run-1p9nq39b/720p_six/sample-03-crops-sf35kw5c/target_004.pgm) |
| [data/evidence/2026-10-03-arm-localize-baseline/arm-board-final/arm_localize/benchmark/run-1p9nq39b/720p_six/sample-03-crops-sf35kw5c/target_004.pgm](../../../data/evidence/2026-10-03-arm-localize-baseline/arm-board-final/arm_localize/benchmark/run-1p9nq39b/720p_six/sample-03-crops-sf35kw5c/target_004.pgm)<br>灰度像素图 · 已纳入Git（含暂存） | 保存target_004的目标ROI裁剪；其合成/文件/实机来源及框/标签含义以data/evidence/2026-10-03-arm-localize-baseline/arm-board-final/arm_localize/README.md为准。 | 所在目录说明：[data/evidence/2026-10-03-arm-localize-baseline/arm-board-final/arm_localize/README.md](../../../data/evidence/2026-10-03-arm-localize-baseline/arm-board-final/arm_localize/README.md)<br>同名配套文件：[data/evidence/2026-10-03-arm-localize-baseline/arm-board-final/arm_localize/benchmark/run-1p9nq39b/720p_six/sample-03-crops-sf35kw5c/target_004.hex](../../../data/evidence/2026-10-03-arm-localize-baseline/arm-board-final/arm_localize/benchmark/run-1p9nq39b/720p_six/sample-03-crops-sf35kw5c/target_004.hex) |
| [data/evidence/2026-10-03-arm-localize-baseline/arm-board-final/arm_localize/benchmark/run-1p9nq39b/720p_six/sample-03-crops-sf35kw5c/target_005.hex](../../../data/evidence/2026-10-03-arm-localize-baseline/arm-board-final/arm_localize/benchmark/run-1p9nq39b/720p_six/sample-03-crops-sf35kw5c/target_005.hex)<br>十六进制数据 · 已纳入Git（含暂存） | 以十六进制数据形式保存target_005的目标ROI像素；由对应加载器/testbench读取，位宽、排布和端序按data/evidence/2026-10-03-arm-localize-baseline/arm-board-final/arm_localize/README.md核对。 | 所在目录说明：[data/evidence/2026-10-03-arm-localize-baseline/arm-board-final/arm_localize/README.md](../../../data/evidence/2026-10-03-arm-localize-baseline/arm-board-final/arm_localize/README.md)<br>同名配套文件：[data/evidence/2026-10-03-arm-localize-baseline/arm-board-final/arm_localize/benchmark/run-1p9nq39b/720p_six/sample-03-crops-sf35kw5c/target_005.pgm](../../../data/evidence/2026-10-03-arm-localize-baseline/arm-board-final/arm_localize/benchmark/run-1p9nq39b/720p_six/sample-03-crops-sf35kw5c/target_005.pgm) |
| [data/evidence/2026-10-03-arm-localize-baseline/arm-board-final/arm_localize/benchmark/run-1p9nq39b/720p_six/sample-03-crops-sf35kw5c/target_005.pgm](../../../data/evidence/2026-10-03-arm-localize-baseline/arm-board-final/arm_localize/benchmark/run-1p9nq39b/720p_six/sample-03-crops-sf35kw5c/target_005.pgm)<br>灰度像素图 · 已纳入Git（含暂存） | 保存target_005的目标ROI裁剪；其合成/文件/实机来源及框/标签含义以data/evidence/2026-10-03-arm-localize-baseline/arm-board-final/arm_localize/README.md为准。 | 所在目录说明：[data/evidence/2026-10-03-arm-localize-baseline/arm-board-final/arm_localize/README.md](../../../data/evidence/2026-10-03-arm-localize-baseline/arm-board-final/arm_localize/README.md)<br>同名配套文件：[data/evidence/2026-10-03-arm-localize-baseline/arm-board-final/arm_localize/benchmark/run-1p9nq39b/720p_six/sample-03-crops-sf35kw5c/target_005.hex](../../../data/evidence/2026-10-03-arm-localize-baseline/arm-board-final/arm_localize/benchmark/run-1p9nq39b/720p_six/sample-03-crops-sf35kw5c/target_005.hex) |
| **data/evidence/2026-10-03-arm-localize-baseline/arm-board-final/arm_localize/benchmark/run-1p9nq39b/720p_six** | | |
| [data/evidence/2026-10-03-arm-localize-baseline/arm-board-final/arm_localize/benchmark/run-1p9nq39b/720p_six/sample-03.json](../../../data/evidence/2026-10-03-arm-localize-baseline/arm-board-final/arm_localize/benchmark/run-1p9nq39b/720p_six/sample-03.json)<br>结构化结果/元数据 · 已纳入Git（含暂存） | 保存sample-03的实验结果或检查产物，字段包括frame_id、config_id、width、height、status、targets、schema_version；与data/evidence/2026-10-03-arm-localize-baseline/arm-board-final/arm_localize/README.md中的生成/校验流程一起使用。 | 所在目录说明：[data/evidence/2026-10-03-arm-localize-baseline/arm-board-final/arm_localize/README.md](../../../data/evidence/2026-10-03-arm-localize-baseline/arm-board-final/arm_localize/README.md)<br>同目录输入/元数据：[data/evidence/2026-10-03-arm-localize-baseline/arm-board-final/arm_localize/benchmark/run-1p9nq39b/720p_six/input.json](../../../data/evidence/2026-10-03-arm-localize-baseline/arm-board-final/arm_localize/benchmark/run-1p9nq39b/720p_six/input.json) |
| **data/evidence/2026-10-03-arm-localize-baseline/arm-board-final/arm_localize/benchmark/run-1p9nq39b/720p_six/sample-04-crops-avmbv2uo** | | |
| [data/evidence/2026-10-03-arm-localize-baseline/arm-board-final/arm_localize/benchmark/run-1p9nq39b/720p_six/sample-04-crops-avmbv2uo/target_000.hex](../../../data/evidence/2026-10-03-arm-localize-baseline/arm-board-final/arm_localize/benchmark/run-1p9nq39b/720p_six/sample-04-crops-avmbv2uo/target_000.hex)<br>十六进制数据 · 已纳入Git（含暂存） | 以十六进制数据形式保存target_000的目标ROI像素；由对应加载器/testbench读取，位宽、排布和端序按data/evidence/2026-10-03-arm-localize-baseline/arm-board-final/arm_localize/README.md核对。 | 所在目录说明：[data/evidence/2026-10-03-arm-localize-baseline/arm-board-final/arm_localize/README.md](../../../data/evidence/2026-10-03-arm-localize-baseline/arm-board-final/arm_localize/README.md)<br>同名配套文件：[data/evidence/2026-10-03-arm-localize-baseline/arm-board-final/arm_localize/benchmark/run-1p9nq39b/720p_six/sample-04-crops-avmbv2uo/target_000.pgm](../../../data/evidence/2026-10-03-arm-localize-baseline/arm-board-final/arm_localize/benchmark/run-1p9nq39b/720p_six/sample-04-crops-avmbv2uo/target_000.pgm) |
| [data/evidence/2026-10-03-arm-localize-baseline/arm-board-final/arm_localize/benchmark/run-1p9nq39b/720p_six/sample-04-crops-avmbv2uo/target_000.pgm](../../../data/evidence/2026-10-03-arm-localize-baseline/arm-board-final/arm_localize/benchmark/run-1p9nq39b/720p_six/sample-04-crops-avmbv2uo/target_000.pgm)<br>灰度像素图 · 已纳入Git（含暂存） | 保存target_000的目标ROI裁剪；其合成/文件/实机来源及框/标签含义以data/evidence/2026-10-03-arm-localize-baseline/arm-board-final/arm_localize/README.md为准。 | 所在目录说明：[data/evidence/2026-10-03-arm-localize-baseline/arm-board-final/arm_localize/README.md](../../../data/evidence/2026-10-03-arm-localize-baseline/arm-board-final/arm_localize/README.md)<br>同名配套文件：[data/evidence/2026-10-03-arm-localize-baseline/arm-board-final/arm_localize/benchmark/run-1p9nq39b/720p_six/sample-04-crops-avmbv2uo/target_000.hex](../../../data/evidence/2026-10-03-arm-localize-baseline/arm-board-final/arm_localize/benchmark/run-1p9nq39b/720p_six/sample-04-crops-avmbv2uo/target_000.hex) |
| [data/evidence/2026-10-03-arm-localize-baseline/arm-board-final/arm_localize/benchmark/run-1p9nq39b/720p_six/sample-04-crops-avmbv2uo/target_001.hex](../../../data/evidence/2026-10-03-arm-localize-baseline/arm-board-final/arm_localize/benchmark/run-1p9nq39b/720p_six/sample-04-crops-avmbv2uo/target_001.hex)<br>十六进制数据 · 已纳入Git（含暂存） | 以十六进制数据形式保存target_001的目标ROI像素；由对应加载器/testbench读取，位宽、排布和端序按data/evidence/2026-10-03-arm-localize-baseline/arm-board-final/arm_localize/README.md核对。 | 所在目录说明：[data/evidence/2026-10-03-arm-localize-baseline/arm-board-final/arm_localize/README.md](../../../data/evidence/2026-10-03-arm-localize-baseline/arm-board-final/arm_localize/README.md)<br>同名配套文件：[data/evidence/2026-10-03-arm-localize-baseline/arm-board-final/arm_localize/benchmark/run-1p9nq39b/720p_six/sample-04-crops-avmbv2uo/target_001.pgm](../../../data/evidence/2026-10-03-arm-localize-baseline/arm-board-final/arm_localize/benchmark/run-1p9nq39b/720p_six/sample-04-crops-avmbv2uo/target_001.pgm) |
| [data/evidence/2026-10-03-arm-localize-baseline/arm-board-final/arm_localize/benchmark/run-1p9nq39b/720p_six/sample-04-crops-avmbv2uo/target_001.pgm](../../../data/evidence/2026-10-03-arm-localize-baseline/arm-board-final/arm_localize/benchmark/run-1p9nq39b/720p_six/sample-04-crops-avmbv2uo/target_001.pgm)<br>灰度像素图 · 已纳入Git（含暂存） | 保存target_001的目标ROI裁剪；其合成/文件/实机来源及框/标签含义以data/evidence/2026-10-03-arm-localize-baseline/arm-board-final/arm_localize/README.md为准。 | 所在目录说明：[data/evidence/2026-10-03-arm-localize-baseline/arm-board-final/arm_localize/README.md](../../../data/evidence/2026-10-03-arm-localize-baseline/arm-board-final/arm_localize/README.md)<br>同名配套文件：[data/evidence/2026-10-03-arm-localize-baseline/arm-board-final/arm_localize/benchmark/run-1p9nq39b/720p_six/sample-04-crops-avmbv2uo/target_001.hex](../../../data/evidence/2026-10-03-arm-localize-baseline/arm-board-final/arm_localize/benchmark/run-1p9nq39b/720p_six/sample-04-crops-avmbv2uo/target_001.hex) |
| [data/evidence/2026-10-03-arm-localize-baseline/arm-board-final/arm_localize/benchmark/run-1p9nq39b/720p_six/sample-04-crops-avmbv2uo/target_002.hex](../../../data/evidence/2026-10-03-arm-localize-baseline/arm-board-final/arm_localize/benchmark/run-1p9nq39b/720p_six/sample-04-crops-avmbv2uo/target_002.hex)<br>十六进制数据 · 已纳入Git（含暂存） | 以十六进制数据形式保存target_002的目标ROI像素；由对应加载器/testbench读取，位宽、排布和端序按data/evidence/2026-10-03-arm-localize-baseline/arm-board-final/arm_localize/README.md核对。 | 所在目录说明：[data/evidence/2026-10-03-arm-localize-baseline/arm-board-final/arm_localize/README.md](../../../data/evidence/2026-10-03-arm-localize-baseline/arm-board-final/arm_localize/README.md)<br>同名配套文件：[data/evidence/2026-10-03-arm-localize-baseline/arm-board-final/arm_localize/benchmark/run-1p9nq39b/720p_six/sample-04-crops-avmbv2uo/target_002.pgm](../../../data/evidence/2026-10-03-arm-localize-baseline/arm-board-final/arm_localize/benchmark/run-1p9nq39b/720p_six/sample-04-crops-avmbv2uo/target_002.pgm) |
| [data/evidence/2026-10-03-arm-localize-baseline/arm-board-final/arm_localize/benchmark/run-1p9nq39b/720p_six/sample-04-crops-avmbv2uo/target_002.pgm](../../../data/evidence/2026-10-03-arm-localize-baseline/arm-board-final/arm_localize/benchmark/run-1p9nq39b/720p_six/sample-04-crops-avmbv2uo/target_002.pgm)<br>灰度像素图 · 已纳入Git（含暂存） | 保存target_002的目标ROI裁剪；其合成/文件/实机来源及框/标签含义以data/evidence/2026-10-03-arm-localize-baseline/arm-board-final/arm_localize/README.md为准。 | 所在目录说明：[data/evidence/2026-10-03-arm-localize-baseline/arm-board-final/arm_localize/README.md](../../../data/evidence/2026-10-03-arm-localize-baseline/arm-board-final/arm_localize/README.md)<br>同名配套文件：[data/evidence/2026-10-03-arm-localize-baseline/arm-board-final/arm_localize/benchmark/run-1p9nq39b/720p_six/sample-04-crops-avmbv2uo/target_002.hex](../../../data/evidence/2026-10-03-arm-localize-baseline/arm-board-final/arm_localize/benchmark/run-1p9nq39b/720p_six/sample-04-crops-avmbv2uo/target_002.hex) |
| [data/evidence/2026-10-03-arm-localize-baseline/arm-board-final/arm_localize/benchmark/run-1p9nq39b/720p_six/sample-04-crops-avmbv2uo/target_003.hex](../../../data/evidence/2026-10-03-arm-localize-baseline/arm-board-final/arm_localize/benchmark/run-1p9nq39b/720p_six/sample-04-crops-avmbv2uo/target_003.hex)<br>十六进制数据 · 已纳入Git（含暂存） | 以十六进制数据形式保存target_003的目标ROI像素；由对应加载器/testbench读取，位宽、排布和端序按data/evidence/2026-10-03-arm-localize-baseline/arm-board-final/arm_localize/README.md核对。 | 所在目录说明：[data/evidence/2026-10-03-arm-localize-baseline/arm-board-final/arm_localize/README.md](../../../data/evidence/2026-10-03-arm-localize-baseline/arm-board-final/arm_localize/README.md)<br>同名配套文件：[data/evidence/2026-10-03-arm-localize-baseline/arm-board-final/arm_localize/benchmark/run-1p9nq39b/720p_six/sample-04-crops-avmbv2uo/target_003.pgm](../../../data/evidence/2026-10-03-arm-localize-baseline/arm-board-final/arm_localize/benchmark/run-1p9nq39b/720p_six/sample-04-crops-avmbv2uo/target_003.pgm) |
| [data/evidence/2026-10-03-arm-localize-baseline/arm-board-final/arm_localize/benchmark/run-1p9nq39b/720p_six/sample-04-crops-avmbv2uo/target_003.pgm](../../../data/evidence/2026-10-03-arm-localize-baseline/arm-board-final/arm_localize/benchmark/run-1p9nq39b/720p_six/sample-04-crops-avmbv2uo/target_003.pgm)<br>灰度像素图 · 已纳入Git（含暂存） | 保存target_003的目标ROI裁剪；其合成/文件/实机来源及框/标签含义以data/evidence/2026-10-03-arm-localize-baseline/arm-board-final/arm_localize/README.md为准。 | 所在目录说明：[data/evidence/2026-10-03-arm-localize-baseline/arm-board-final/arm_localize/README.md](../../../data/evidence/2026-10-03-arm-localize-baseline/arm-board-final/arm_localize/README.md)<br>同名配套文件：[data/evidence/2026-10-03-arm-localize-baseline/arm-board-final/arm_localize/benchmark/run-1p9nq39b/720p_six/sample-04-crops-avmbv2uo/target_003.hex](../../../data/evidence/2026-10-03-arm-localize-baseline/arm-board-final/arm_localize/benchmark/run-1p9nq39b/720p_six/sample-04-crops-avmbv2uo/target_003.hex) |
| [data/evidence/2026-10-03-arm-localize-baseline/arm-board-final/arm_localize/benchmark/run-1p9nq39b/720p_six/sample-04-crops-avmbv2uo/target_004.hex](../../../data/evidence/2026-10-03-arm-localize-baseline/arm-board-final/arm_localize/benchmark/run-1p9nq39b/720p_six/sample-04-crops-avmbv2uo/target_004.hex)<br>十六进制数据 · 已纳入Git（含暂存） | 以十六进制数据形式保存target_004的目标ROI像素；由对应加载器/testbench读取，位宽、排布和端序按data/evidence/2026-10-03-arm-localize-baseline/arm-board-final/arm_localize/README.md核对。 | 所在目录说明：[data/evidence/2026-10-03-arm-localize-baseline/arm-board-final/arm_localize/README.md](../../../data/evidence/2026-10-03-arm-localize-baseline/arm-board-final/arm_localize/README.md)<br>同名配套文件：[data/evidence/2026-10-03-arm-localize-baseline/arm-board-final/arm_localize/benchmark/run-1p9nq39b/720p_six/sample-04-crops-avmbv2uo/target_004.pgm](../../../data/evidence/2026-10-03-arm-localize-baseline/arm-board-final/arm_localize/benchmark/run-1p9nq39b/720p_six/sample-04-crops-avmbv2uo/target_004.pgm) |
| [data/evidence/2026-10-03-arm-localize-baseline/arm-board-final/arm_localize/benchmark/run-1p9nq39b/720p_six/sample-04-crops-avmbv2uo/target_004.pgm](../../../data/evidence/2026-10-03-arm-localize-baseline/arm-board-final/arm_localize/benchmark/run-1p9nq39b/720p_six/sample-04-crops-avmbv2uo/target_004.pgm)<br>灰度像素图 · 已纳入Git（含暂存） | 保存target_004的目标ROI裁剪；其合成/文件/实机来源及框/标签含义以data/evidence/2026-10-03-arm-localize-baseline/arm-board-final/arm_localize/README.md为准。 | 所在目录说明：[data/evidence/2026-10-03-arm-localize-baseline/arm-board-final/arm_localize/README.md](../../../data/evidence/2026-10-03-arm-localize-baseline/arm-board-final/arm_localize/README.md)<br>同名配套文件：[data/evidence/2026-10-03-arm-localize-baseline/arm-board-final/arm_localize/benchmark/run-1p9nq39b/720p_six/sample-04-crops-avmbv2uo/target_004.hex](../../../data/evidence/2026-10-03-arm-localize-baseline/arm-board-final/arm_localize/benchmark/run-1p9nq39b/720p_six/sample-04-crops-avmbv2uo/target_004.hex) |
| [data/evidence/2026-10-03-arm-localize-baseline/arm-board-final/arm_localize/benchmark/run-1p9nq39b/720p_six/sample-04-crops-avmbv2uo/target_005.hex](../../../data/evidence/2026-10-03-arm-localize-baseline/arm-board-final/arm_localize/benchmark/run-1p9nq39b/720p_six/sample-04-crops-avmbv2uo/target_005.hex)<br>十六进制数据 · 已纳入Git（含暂存） | 以十六进制数据形式保存target_005的目标ROI像素；由对应加载器/testbench读取，位宽、排布和端序按data/evidence/2026-10-03-arm-localize-baseline/arm-board-final/arm_localize/README.md核对。 | 所在目录说明：[data/evidence/2026-10-03-arm-localize-baseline/arm-board-final/arm_localize/README.md](../../../data/evidence/2026-10-03-arm-localize-baseline/arm-board-final/arm_localize/README.md)<br>同名配套文件：[data/evidence/2026-10-03-arm-localize-baseline/arm-board-final/arm_localize/benchmark/run-1p9nq39b/720p_six/sample-04-crops-avmbv2uo/target_005.pgm](../../../data/evidence/2026-10-03-arm-localize-baseline/arm-board-final/arm_localize/benchmark/run-1p9nq39b/720p_six/sample-04-crops-avmbv2uo/target_005.pgm) |
| [data/evidence/2026-10-03-arm-localize-baseline/arm-board-final/arm_localize/benchmark/run-1p9nq39b/720p_six/sample-04-crops-avmbv2uo/target_005.pgm](../../../data/evidence/2026-10-03-arm-localize-baseline/arm-board-final/arm_localize/benchmark/run-1p9nq39b/720p_six/sample-04-crops-avmbv2uo/target_005.pgm)<br>灰度像素图 · 已纳入Git（含暂存） | 保存target_005的目标ROI裁剪；其合成/文件/实机来源及框/标签含义以data/evidence/2026-10-03-arm-localize-baseline/arm-board-final/arm_localize/README.md为准。 | 所在目录说明：[data/evidence/2026-10-03-arm-localize-baseline/arm-board-final/arm_localize/README.md](../../../data/evidence/2026-10-03-arm-localize-baseline/arm-board-final/arm_localize/README.md)<br>同名配套文件：[data/evidence/2026-10-03-arm-localize-baseline/arm-board-final/arm_localize/benchmark/run-1p9nq39b/720p_six/sample-04-crops-avmbv2uo/target_005.hex](../../../data/evidence/2026-10-03-arm-localize-baseline/arm-board-final/arm_localize/benchmark/run-1p9nq39b/720p_six/sample-04-crops-avmbv2uo/target_005.hex) |
| **data/evidence/2026-10-03-arm-localize-baseline/arm-board-final/arm_localize/benchmark/run-1p9nq39b/720p_six** | | |
| [data/evidence/2026-10-03-arm-localize-baseline/arm-board-final/arm_localize/benchmark/run-1p9nq39b/720p_six/sample-04.json](../../../data/evidence/2026-10-03-arm-localize-baseline/arm-board-final/arm_localize/benchmark/run-1p9nq39b/720p_six/sample-04.json)<br>结构化结果/元数据 · 已纳入Git（含暂存） | 保存sample-04的实验结果或检查产物，字段包括frame_id、config_id、width、height、status、targets、schema_version；与data/evidence/2026-10-03-arm-localize-baseline/arm-board-final/arm_localize/README.md中的生成/校验流程一起使用。 | 所在目录说明：[data/evidence/2026-10-03-arm-localize-baseline/arm-board-final/arm_localize/README.md](../../../data/evidence/2026-10-03-arm-localize-baseline/arm-board-final/arm_localize/README.md)<br>同目录输入/元数据：[data/evidence/2026-10-03-arm-localize-baseline/arm-board-final/arm_localize/benchmark/run-1p9nq39b/720p_six/input.json](../../../data/evidence/2026-10-03-arm-localize-baseline/arm-board-final/arm_localize/benchmark/run-1p9nq39b/720p_six/input.json) |
| **data/evidence/2026-10-03-arm-localize-baseline/arm-board-final/arm_localize/benchmark/run-1p9nq39b/720p_six/warmup-00-crops-ut4gj2zo** | | |
| [data/evidence/2026-10-03-arm-localize-baseline/arm-board-final/arm_localize/benchmark/run-1p9nq39b/720p_six/warmup-00-crops-ut4gj2zo/target_000.hex](../../../data/evidence/2026-10-03-arm-localize-baseline/arm-board-final/arm_localize/benchmark/run-1p9nq39b/720p_six/warmup-00-crops-ut4gj2zo/target_000.hex)<br>十六进制数据 · 已纳入Git（含暂存） | 以十六进制数据形式保存target_000的目标ROI像素；由对应加载器/testbench读取，位宽、排布和端序按data/evidence/2026-10-03-arm-localize-baseline/arm-board-final/arm_localize/README.md核对。 | 所在目录说明：[data/evidence/2026-10-03-arm-localize-baseline/arm-board-final/arm_localize/README.md](../../../data/evidence/2026-10-03-arm-localize-baseline/arm-board-final/arm_localize/README.md)<br>同名配套文件：[data/evidence/2026-10-03-arm-localize-baseline/arm-board-final/arm_localize/benchmark/run-1p9nq39b/720p_six/warmup-00-crops-ut4gj2zo/target_000.pgm](../../../data/evidence/2026-10-03-arm-localize-baseline/arm-board-final/arm_localize/benchmark/run-1p9nq39b/720p_six/warmup-00-crops-ut4gj2zo/target_000.pgm) |
| [data/evidence/2026-10-03-arm-localize-baseline/arm-board-final/arm_localize/benchmark/run-1p9nq39b/720p_six/warmup-00-crops-ut4gj2zo/target_000.pgm](../../../data/evidence/2026-10-03-arm-localize-baseline/arm-board-final/arm_localize/benchmark/run-1p9nq39b/720p_six/warmup-00-crops-ut4gj2zo/target_000.pgm)<br>灰度像素图 · 已纳入Git（含暂存） | 保存target_000的目标ROI裁剪；其合成/文件/实机来源及框/标签含义以data/evidence/2026-10-03-arm-localize-baseline/arm-board-final/arm_localize/README.md为准。 | 所在目录说明：[data/evidence/2026-10-03-arm-localize-baseline/arm-board-final/arm_localize/README.md](../../../data/evidence/2026-10-03-arm-localize-baseline/arm-board-final/arm_localize/README.md)<br>同名配套文件：[data/evidence/2026-10-03-arm-localize-baseline/arm-board-final/arm_localize/benchmark/run-1p9nq39b/720p_six/warmup-00-crops-ut4gj2zo/target_000.hex](../../../data/evidence/2026-10-03-arm-localize-baseline/arm-board-final/arm_localize/benchmark/run-1p9nq39b/720p_six/warmup-00-crops-ut4gj2zo/target_000.hex) |
| [data/evidence/2026-10-03-arm-localize-baseline/arm-board-final/arm_localize/benchmark/run-1p9nq39b/720p_six/warmup-00-crops-ut4gj2zo/target_001.hex](../../../data/evidence/2026-10-03-arm-localize-baseline/arm-board-final/arm_localize/benchmark/run-1p9nq39b/720p_six/warmup-00-crops-ut4gj2zo/target_001.hex)<br>十六进制数据 · 已纳入Git（含暂存） | 以十六进制数据形式保存target_001的目标ROI像素；由对应加载器/testbench读取，位宽、排布和端序按data/evidence/2026-10-03-arm-localize-baseline/arm-board-final/arm_localize/README.md核对。 | 所在目录说明：[data/evidence/2026-10-03-arm-localize-baseline/arm-board-final/arm_localize/README.md](../../../data/evidence/2026-10-03-arm-localize-baseline/arm-board-final/arm_localize/README.md)<br>同名配套文件：[data/evidence/2026-10-03-arm-localize-baseline/arm-board-final/arm_localize/benchmark/run-1p9nq39b/720p_six/warmup-00-crops-ut4gj2zo/target_001.pgm](../../../data/evidence/2026-10-03-arm-localize-baseline/arm-board-final/arm_localize/benchmark/run-1p9nq39b/720p_six/warmup-00-crops-ut4gj2zo/target_001.pgm) |
| [data/evidence/2026-10-03-arm-localize-baseline/arm-board-final/arm_localize/benchmark/run-1p9nq39b/720p_six/warmup-00-crops-ut4gj2zo/target_001.pgm](../../../data/evidence/2026-10-03-arm-localize-baseline/arm-board-final/arm_localize/benchmark/run-1p9nq39b/720p_six/warmup-00-crops-ut4gj2zo/target_001.pgm)<br>灰度像素图 · 已纳入Git（含暂存） | 保存target_001的目标ROI裁剪；其合成/文件/实机来源及框/标签含义以data/evidence/2026-10-03-arm-localize-baseline/arm-board-final/arm_localize/README.md为准。 | 所在目录说明：[data/evidence/2026-10-03-arm-localize-baseline/arm-board-final/arm_localize/README.md](../../../data/evidence/2026-10-03-arm-localize-baseline/arm-board-final/arm_localize/README.md)<br>同名配套文件：[data/evidence/2026-10-03-arm-localize-baseline/arm-board-final/arm_localize/benchmark/run-1p9nq39b/720p_six/warmup-00-crops-ut4gj2zo/target_001.hex](../../../data/evidence/2026-10-03-arm-localize-baseline/arm-board-final/arm_localize/benchmark/run-1p9nq39b/720p_six/warmup-00-crops-ut4gj2zo/target_001.hex) |
| [data/evidence/2026-10-03-arm-localize-baseline/arm-board-final/arm_localize/benchmark/run-1p9nq39b/720p_six/warmup-00-crops-ut4gj2zo/target_002.hex](../../../data/evidence/2026-10-03-arm-localize-baseline/arm-board-final/arm_localize/benchmark/run-1p9nq39b/720p_six/warmup-00-crops-ut4gj2zo/target_002.hex)<br>十六进制数据 · 已纳入Git（含暂存） | 以十六进制数据形式保存target_002的目标ROI像素；由对应加载器/testbench读取，位宽、排布和端序按data/evidence/2026-10-03-arm-localize-baseline/arm-board-final/arm_localize/README.md核对。 | 所在目录说明：[data/evidence/2026-10-03-arm-localize-baseline/arm-board-final/arm_localize/README.md](../../../data/evidence/2026-10-03-arm-localize-baseline/arm-board-final/arm_localize/README.md)<br>同名配套文件：[data/evidence/2026-10-03-arm-localize-baseline/arm-board-final/arm_localize/benchmark/run-1p9nq39b/720p_six/warmup-00-crops-ut4gj2zo/target_002.pgm](../../../data/evidence/2026-10-03-arm-localize-baseline/arm-board-final/arm_localize/benchmark/run-1p9nq39b/720p_six/warmup-00-crops-ut4gj2zo/target_002.pgm) |
| [data/evidence/2026-10-03-arm-localize-baseline/arm-board-final/arm_localize/benchmark/run-1p9nq39b/720p_six/warmup-00-crops-ut4gj2zo/target_002.pgm](../../../data/evidence/2026-10-03-arm-localize-baseline/arm-board-final/arm_localize/benchmark/run-1p9nq39b/720p_six/warmup-00-crops-ut4gj2zo/target_002.pgm)<br>灰度像素图 · 已纳入Git（含暂存） | 保存target_002的目标ROI裁剪；其合成/文件/实机来源及框/标签含义以data/evidence/2026-10-03-arm-localize-baseline/arm-board-final/arm_localize/README.md为准。 | 所在目录说明：[data/evidence/2026-10-03-arm-localize-baseline/arm-board-final/arm_localize/README.md](../../../data/evidence/2026-10-03-arm-localize-baseline/arm-board-final/arm_localize/README.md)<br>同名配套文件：[data/evidence/2026-10-03-arm-localize-baseline/arm-board-final/arm_localize/benchmark/run-1p9nq39b/720p_six/warmup-00-crops-ut4gj2zo/target_002.hex](../../../data/evidence/2026-10-03-arm-localize-baseline/arm-board-final/arm_localize/benchmark/run-1p9nq39b/720p_six/warmup-00-crops-ut4gj2zo/target_002.hex) |
| [data/evidence/2026-10-03-arm-localize-baseline/arm-board-final/arm_localize/benchmark/run-1p9nq39b/720p_six/warmup-00-crops-ut4gj2zo/target_003.hex](../../../data/evidence/2026-10-03-arm-localize-baseline/arm-board-final/arm_localize/benchmark/run-1p9nq39b/720p_six/warmup-00-crops-ut4gj2zo/target_003.hex)<br>十六进制数据 · 已纳入Git（含暂存） | 以十六进制数据形式保存target_003的目标ROI像素；由对应加载器/testbench读取，位宽、排布和端序按data/evidence/2026-10-03-arm-localize-baseline/arm-board-final/arm_localize/README.md核对。 | 所在目录说明：[data/evidence/2026-10-03-arm-localize-baseline/arm-board-final/arm_localize/README.md](../../../data/evidence/2026-10-03-arm-localize-baseline/arm-board-final/arm_localize/README.md)<br>同名配套文件：[data/evidence/2026-10-03-arm-localize-baseline/arm-board-final/arm_localize/benchmark/run-1p9nq39b/720p_six/warmup-00-crops-ut4gj2zo/target_003.pgm](../../../data/evidence/2026-10-03-arm-localize-baseline/arm-board-final/arm_localize/benchmark/run-1p9nq39b/720p_six/warmup-00-crops-ut4gj2zo/target_003.pgm) |
| [data/evidence/2026-10-03-arm-localize-baseline/arm-board-final/arm_localize/benchmark/run-1p9nq39b/720p_six/warmup-00-crops-ut4gj2zo/target_003.pgm](../../../data/evidence/2026-10-03-arm-localize-baseline/arm-board-final/arm_localize/benchmark/run-1p9nq39b/720p_six/warmup-00-crops-ut4gj2zo/target_003.pgm)<br>灰度像素图 · 已纳入Git（含暂存） | 保存target_003的目标ROI裁剪；其合成/文件/实机来源及框/标签含义以data/evidence/2026-10-03-arm-localize-baseline/arm-board-final/arm_localize/README.md为准。 | 所在目录说明：[data/evidence/2026-10-03-arm-localize-baseline/arm-board-final/arm_localize/README.md](../../../data/evidence/2026-10-03-arm-localize-baseline/arm-board-final/arm_localize/README.md)<br>同名配套文件：[data/evidence/2026-10-03-arm-localize-baseline/arm-board-final/arm_localize/benchmark/run-1p9nq39b/720p_six/warmup-00-crops-ut4gj2zo/target_003.hex](../../../data/evidence/2026-10-03-arm-localize-baseline/arm-board-final/arm_localize/benchmark/run-1p9nq39b/720p_six/warmup-00-crops-ut4gj2zo/target_003.hex) |
| [data/evidence/2026-10-03-arm-localize-baseline/arm-board-final/arm_localize/benchmark/run-1p9nq39b/720p_six/warmup-00-crops-ut4gj2zo/target_004.hex](../../../data/evidence/2026-10-03-arm-localize-baseline/arm-board-final/arm_localize/benchmark/run-1p9nq39b/720p_six/warmup-00-crops-ut4gj2zo/target_004.hex)<br>十六进制数据 · 已纳入Git（含暂存） | 以十六进制数据形式保存target_004的目标ROI像素；由对应加载器/testbench读取，位宽、排布和端序按data/evidence/2026-10-03-arm-localize-baseline/arm-board-final/arm_localize/README.md核对。 | 所在目录说明：[data/evidence/2026-10-03-arm-localize-baseline/arm-board-final/arm_localize/README.md](../../../data/evidence/2026-10-03-arm-localize-baseline/arm-board-final/arm_localize/README.md)<br>同名配套文件：[data/evidence/2026-10-03-arm-localize-baseline/arm-board-final/arm_localize/benchmark/run-1p9nq39b/720p_six/warmup-00-crops-ut4gj2zo/target_004.pgm](../../../data/evidence/2026-10-03-arm-localize-baseline/arm-board-final/arm_localize/benchmark/run-1p9nq39b/720p_six/warmup-00-crops-ut4gj2zo/target_004.pgm) |
| [data/evidence/2026-10-03-arm-localize-baseline/arm-board-final/arm_localize/benchmark/run-1p9nq39b/720p_six/warmup-00-crops-ut4gj2zo/target_004.pgm](../../../data/evidence/2026-10-03-arm-localize-baseline/arm-board-final/arm_localize/benchmark/run-1p9nq39b/720p_six/warmup-00-crops-ut4gj2zo/target_004.pgm)<br>灰度像素图 · 已纳入Git（含暂存） | 保存target_004的目标ROI裁剪；其合成/文件/实机来源及框/标签含义以data/evidence/2026-10-03-arm-localize-baseline/arm-board-final/arm_localize/README.md为准。 | 所在目录说明：[data/evidence/2026-10-03-arm-localize-baseline/arm-board-final/arm_localize/README.md](../../../data/evidence/2026-10-03-arm-localize-baseline/arm-board-final/arm_localize/README.md)<br>同名配套文件：[data/evidence/2026-10-03-arm-localize-baseline/arm-board-final/arm_localize/benchmark/run-1p9nq39b/720p_six/warmup-00-crops-ut4gj2zo/target_004.hex](../../../data/evidence/2026-10-03-arm-localize-baseline/arm-board-final/arm_localize/benchmark/run-1p9nq39b/720p_six/warmup-00-crops-ut4gj2zo/target_004.hex) |
| [data/evidence/2026-10-03-arm-localize-baseline/arm-board-final/arm_localize/benchmark/run-1p9nq39b/720p_six/warmup-00-crops-ut4gj2zo/target_005.hex](../../../data/evidence/2026-10-03-arm-localize-baseline/arm-board-final/arm_localize/benchmark/run-1p9nq39b/720p_six/warmup-00-crops-ut4gj2zo/target_005.hex)<br>十六进制数据 · 已纳入Git（含暂存） | 以十六进制数据形式保存target_005的目标ROI像素；由对应加载器/testbench读取，位宽、排布和端序按data/evidence/2026-10-03-arm-localize-baseline/arm-board-final/arm_localize/README.md核对。 | 所在目录说明：[data/evidence/2026-10-03-arm-localize-baseline/arm-board-final/arm_localize/README.md](../../../data/evidence/2026-10-03-arm-localize-baseline/arm-board-final/arm_localize/README.md)<br>同名配套文件：[data/evidence/2026-10-03-arm-localize-baseline/arm-board-final/arm_localize/benchmark/run-1p9nq39b/720p_six/warmup-00-crops-ut4gj2zo/target_005.pgm](../../../data/evidence/2026-10-03-arm-localize-baseline/arm-board-final/arm_localize/benchmark/run-1p9nq39b/720p_six/warmup-00-crops-ut4gj2zo/target_005.pgm) |
| [data/evidence/2026-10-03-arm-localize-baseline/arm-board-final/arm_localize/benchmark/run-1p9nq39b/720p_six/warmup-00-crops-ut4gj2zo/target_005.pgm](../../../data/evidence/2026-10-03-arm-localize-baseline/arm-board-final/arm_localize/benchmark/run-1p9nq39b/720p_six/warmup-00-crops-ut4gj2zo/target_005.pgm)<br>灰度像素图 · 已纳入Git（含暂存） | 保存target_005的目标ROI裁剪；其合成/文件/实机来源及框/标签含义以data/evidence/2026-10-03-arm-localize-baseline/arm-board-final/arm_localize/README.md为准。 | 所在目录说明：[data/evidence/2026-10-03-arm-localize-baseline/arm-board-final/arm_localize/README.md](../../../data/evidence/2026-10-03-arm-localize-baseline/arm-board-final/arm_localize/README.md)<br>同名配套文件：[data/evidence/2026-10-03-arm-localize-baseline/arm-board-final/arm_localize/benchmark/run-1p9nq39b/720p_six/warmup-00-crops-ut4gj2zo/target_005.hex](../../../data/evidence/2026-10-03-arm-localize-baseline/arm-board-final/arm_localize/benchmark/run-1p9nq39b/720p_six/warmup-00-crops-ut4gj2zo/target_005.hex) |
| **data/evidence/2026-10-03-arm-localize-baseline/arm-board-final/arm_localize/benchmark/run-1p9nq39b/720p_six** | | |
| [data/evidence/2026-10-03-arm-localize-baseline/arm-board-final/arm_localize/benchmark/run-1p9nq39b/720p_six/warmup-00.json](../../../data/evidence/2026-10-03-arm-localize-baseline/arm-board-final/arm_localize/benchmark/run-1p9nq39b/720p_six/warmup-00.json)<br>结构化结果/元数据 · 已纳入Git（含暂存） | 保存warmup-00的实验结果或检查产物，字段包括frame_id、config_id、width、height、status、targets、schema_version；与data/evidence/2026-10-03-arm-localize-baseline/arm-board-final/arm_localize/README.md中的生成/校验流程一起使用。 | 所在目录说明：[data/evidence/2026-10-03-arm-localize-baseline/arm-board-final/arm_localize/README.md](../../../data/evidence/2026-10-03-arm-localize-baseline/arm-board-final/arm_localize/README.md)<br>同目录输入/元数据：[data/evidence/2026-10-03-arm-localize-baseline/arm-board-final/arm_localize/benchmark/run-1p9nq39b/720p_six/input.json](../../../data/evidence/2026-10-03-arm-localize-baseline/arm-board-final/arm_localize/benchmark/run-1p9nq39b/720p_six/input.json) |
| **data/evidence/2026-10-03-arm-localize-baseline/arm-board-final/arm_localize/benchmark/run-1p9nq39b/tiny** | | |
| [data/evidence/2026-10-03-arm-localize-baseline/arm-board-final/arm_localize/benchmark/run-1p9nq39b/tiny/input.json](../../../data/evidence/2026-10-03-arm-localize-baseline/arm-board-final/arm_localize/benchmark/run-1p9nq39b/tiny/input.json)<br>结构化结果/元数据 · 已纳入Git（含暂存） | 保存input的输入/设备/运行元数据，字段包括pixels；与data/evidence/2026-10-03-arm-localize-baseline/arm-board-final/arm_localize/README.md中的生成/校验流程一起使用。 | 所在目录说明：[data/evidence/2026-10-03-arm-localize-baseline/arm-board-final/arm_localize/README.md](../../../data/evidence/2026-10-03-arm-localize-baseline/arm-board-final/arm_localize/README.md) |
| **data/evidence/2026-10-03-arm-localize-baseline/arm-board-final/arm_localize/benchmark/run-1p9nq39b/tiny/sample-00-crops-8dln4fze** | | |
| [data/evidence/2026-10-03-arm-localize-baseline/arm-board-final/arm_localize/benchmark/run-1p9nq39b/tiny/sample-00-crops-8dln4fze/target_000.hex](../../../data/evidence/2026-10-03-arm-localize-baseline/arm-board-final/arm_localize/benchmark/run-1p9nq39b/tiny/sample-00-crops-8dln4fze/target_000.hex)<br>十六进制数据 · 已纳入Git（含暂存） | 以十六进制数据形式保存target_000的目标ROI像素；由对应加载器/testbench读取，位宽、排布和端序按data/evidence/2026-10-03-arm-localize-baseline/arm-board-final/arm_localize/README.md核对。 | 所在目录说明：[data/evidence/2026-10-03-arm-localize-baseline/arm-board-final/arm_localize/README.md](../../../data/evidence/2026-10-03-arm-localize-baseline/arm-board-final/arm_localize/README.md)<br>同名配套文件：[data/evidence/2026-10-03-arm-localize-baseline/arm-board-final/arm_localize/benchmark/run-1p9nq39b/tiny/sample-00-crops-8dln4fze/target_000.pgm](../../../data/evidence/2026-10-03-arm-localize-baseline/arm-board-final/arm_localize/benchmark/run-1p9nq39b/tiny/sample-00-crops-8dln4fze/target_000.pgm) |
| [data/evidence/2026-10-03-arm-localize-baseline/arm-board-final/arm_localize/benchmark/run-1p9nq39b/tiny/sample-00-crops-8dln4fze/target_000.pgm](../../../data/evidence/2026-10-03-arm-localize-baseline/arm-board-final/arm_localize/benchmark/run-1p9nq39b/tiny/sample-00-crops-8dln4fze/target_000.pgm)<br>灰度像素图 · 已纳入Git（含暂存） | 保存target_000的目标ROI裁剪；其合成/文件/实机来源及框/标签含义以data/evidence/2026-10-03-arm-localize-baseline/arm-board-final/arm_localize/README.md为准。 | 所在目录说明：[data/evidence/2026-10-03-arm-localize-baseline/arm-board-final/arm_localize/README.md](../../../data/evidence/2026-10-03-arm-localize-baseline/arm-board-final/arm_localize/README.md)<br>同名配套文件：[data/evidence/2026-10-03-arm-localize-baseline/arm-board-final/arm_localize/benchmark/run-1p9nq39b/tiny/sample-00-crops-8dln4fze/target_000.hex](../../../data/evidence/2026-10-03-arm-localize-baseline/arm-board-final/arm_localize/benchmark/run-1p9nq39b/tiny/sample-00-crops-8dln4fze/target_000.hex) |
| [data/evidence/2026-10-03-arm-localize-baseline/arm-board-final/arm_localize/benchmark/run-1p9nq39b/tiny/sample-00-crops-8dln4fze/target_001.hex](../../../data/evidence/2026-10-03-arm-localize-baseline/arm-board-final/arm_localize/benchmark/run-1p9nq39b/tiny/sample-00-crops-8dln4fze/target_001.hex)<br>十六进制数据 · 已纳入Git（含暂存） | 以十六进制数据形式保存target_001的目标ROI像素；由对应加载器/testbench读取，位宽、排布和端序按data/evidence/2026-10-03-arm-localize-baseline/arm-board-final/arm_localize/README.md核对。 | 所在目录说明：[data/evidence/2026-10-03-arm-localize-baseline/arm-board-final/arm_localize/README.md](../../../data/evidence/2026-10-03-arm-localize-baseline/arm-board-final/arm_localize/README.md)<br>同名配套文件：[data/evidence/2026-10-03-arm-localize-baseline/arm-board-final/arm_localize/benchmark/run-1p9nq39b/tiny/sample-00-crops-8dln4fze/target_001.pgm](../../../data/evidence/2026-10-03-arm-localize-baseline/arm-board-final/arm_localize/benchmark/run-1p9nq39b/tiny/sample-00-crops-8dln4fze/target_001.pgm) |
| [data/evidence/2026-10-03-arm-localize-baseline/arm-board-final/arm_localize/benchmark/run-1p9nq39b/tiny/sample-00-crops-8dln4fze/target_001.pgm](../../../data/evidence/2026-10-03-arm-localize-baseline/arm-board-final/arm_localize/benchmark/run-1p9nq39b/tiny/sample-00-crops-8dln4fze/target_001.pgm)<br>灰度像素图 · 已纳入Git（含暂存） | 保存target_001的目标ROI裁剪；其合成/文件/实机来源及框/标签含义以data/evidence/2026-10-03-arm-localize-baseline/arm-board-final/arm_localize/README.md为准。 | 所在目录说明：[data/evidence/2026-10-03-arm-localize-baseline/arm-board-final/arm_localize/README.md](../../../data/evidence/2026-10-03-arm-localize-baseline/arm-board-final/arm_localize/README.md)<br>同名配套文件：[data/evidence/2026-10-03-arm-localize-baseline/arm-board-final/arm_localize/benchmark/run-1p9nq39b/tiny/sample-00-crops-8dln4fze/target_001.hex](../../../data/evidence/2026-10-03-arm-localize-baseline/arm-board-final/arm_localize/benchmark/run-1p9nq39b/tiny/sample-00-crops-8dln4fze/target_001.hex) |
| **data/evidence/2026-10-03-arm-localize-baseline/arm-board-final/arm_localize/benchmark/run-1p9nq39b/tiny** | | |
| [data/evidence/2026-10-03-arm-localize-baseline/arm-board-final/arm_localize/benchmark/run-1p9nq39b/tiny/sample-00.json](../../../data/evidence/2026-10-03-arm-localize-baseline/arm-board-final/arm_localize/benchmark/run-1p9nq39b/tiny/sample-00.json)<br>结构化结果/元数据 · 已纳入Git（含暂存） | 保存sample-00的实验结果或检查产物，字段包括frame_id、config_id、width、height、status、targets、schema_version；与data/evidence/2026-10-03-arm-localize-baseline/arm-board-final/arm_localize/README.md中的生成/校验流程一起使用。 | 所在目录说明：[data/evidence/2026-10-03-arm-localize-baseline/arm-board-final/arm_localize/README.md](../../../data/evidence/2026-10-03-arm-localize-baseline/arm-board-final/arm_localize/README.md)<br>同目录输入/元数据：[data/evidence/2026-10-03-arm-localize-baseline/arm-board-final/arm_localize/benchmark/run-1p9nq39b/tiny/input.json](../../../data/evidence/2026-10-03-arm-localize-baseline/arm-board-final/arm_localize/benchmark/run-1p9nq39b/tiny/input.json) |
| **data/evidence/2026-10-03-arm-localize-baseline/arm-board-final/arm_localize/benchmark/run-1p9nq39b/tiny/sample-01-crops-95bg95k4** | | |
| [data/evidence/2026-10-03-arm-localize-baseline/arm-board-final/arm_localize/benchmark/run-1p9nq39b/tiny/sample-01-crops-95bg95k4/target_000.hex](../../../data/evidence/2026-10-03-arm-localize-baseline/arm-board-final/arm_localize/benchmark/run-1p9nq39b/tiny/sample-01-crops-95bg95k4/target_000.hex)<br>十六进制数据 · 已纳入Git（含暂存） | 以十六进制数据形式保存target_000的目标ROI像素；由对应加载器/testbench读取，位宽、排布和端序按data/evidence/2026-10-03-arm-localize-baseline/arm-board-final/arm_localize/README.md核对。 | 所在目录说明：[data/evidence/2026-10-03-arm-localize-baseline/arm-board-final/arm_localize/README.md](../../../data/evidence/2026-10-03-arm-localize-baseline/arm-board-final/arm_localize/README.md)<br>同名配套文件：[data/evidence/2026-10-03-arm-localize-baseline/arm-board-final/arm_localize/benchmark/run-1p9nq39b/tiny/sample-01-crops-95bg95k4/target_000.pgm](../../../data/evidence/2026-10-03-arm-localize-baseline/arm-board-final/arm_localize/benchmark/run-1p9nq39b/tiny/sample-01-crops-95bg95k4/target_000.pgm) |
| [data/evidence/2026-10-03-arm-localize-baseline/arm-board-final/arm_localize/benchmark/run-1p9nq39b/tiny/sample-01-crops-95bg95k4/target_000.pgm](../../../data/evidence/2026-10-03-arm-localize-baseline/arm-board-final/arm_localize/benchmark/run-1p9nq39b/tiny/sample-01-crops-95bg95k4/target_000.pgm)<br>灰度像素图 · 已纳入Git（含暂存） | 保存target_000的目标ROI裁剪；其合成/文件/实机来源及框/标签含义以data/evidence/2026-10-03-arm-localize-baseline/arm-board-final/arm_localize/README.md为准。 | 所在目录说明：[data/evidence/2026-10-03-arm-localize-baseline/arm-board-final/arm_localize/README.md](../../../data/evidence/2026-10-03-arm-localize-baseline/arm-board-final/arm_localize/README.md)<br>同名配套文件：[data/evidence/2026-10-03-arm-localize-baseline/arm-board-final/arm_localize/benchmark/run-1p9nq39b/tiny/sample-01-crops-95bg95k4/target_000.hex](../../../data/evidence/2026-10-03-arm-localize-baseline/arm-board-final/arm_localize/benchmark/run-1p9nq39b/tiny/sample-01-crops-95bg95k4/target_000.hex) |
| [data/evidence/2026-10-03-arm-localize-baseline/arm-board-final/arm_localize/benchmark/run-1p9nq39b/tiny/sample-01-crops-95bg95k4/target_001.hex](../../../data/evidence/2026-10-03-arm-localize-baseline/arm-board-final/arm_localize/benchmark/run-1p9nq39b/tiny/sample-01-crops-95bg95k4/target_001.hex)<br>十六进制数据 · 已纳入Git（含暂存） | 以十六进制数据形式保存target_001的目标ROI像素；由对应加载器/testbench读取，位宽、排布和端序按data/evidence/2026-10-03-arm-localize-baseline/arm-board-final/arm_localize/README.md核对。 | 所在目录说明：[data/evidence/2026-10-03-arm-localize-baseline/arm-board-final/arm_localize/README.md](../../../data/evidence/2026-10-03-arm-localize-baseline/arm-board-final/arm_localize/README.md)<br>同名配套文件：[data/evidence/2026-10-03-arm-localize-baseline/arm-board-final/arm_localize/benchmark/run-1p9nq39b/tiny/sample-01-crops-95bg95k4/target_001.pgm](../../../data/evidence/2026-10-03-arm-localize-baseline/arm-board-final/arm_localize/benchmark/run-1p9nq39b/tiny/sample-01-crops-95bg95k4/target_001.pgm) |
| [data/evidence/2026-10-03-arm-localize-baseline/arm-board-final/arm_localize/benchmark/run-1p9nq39b/tiny/sample-01-crops-95bg95k4/target_001.pgm](../../../data/evidence/2026-10-03-arm-localize-baseline/arm-board-final/arm_localize/benchmark/run-1p9nq39b/tiny/sample-01-crops-95bg95k4/target_001.pgm)<br>灰度像素图 · 已纳入Git（含暂存） | 保存target_001的目标ROI裁剪；其合成/文件/实机来源及框/标签含义以data/evidence/2026-10-03-arm-localize-baseline/arm-board-final/arm_localize/README.md为准。 | 所在目录说明：[data/evidence/2026-10-03-arm-localize-baseline/arm-board-final/arm_localize/README.md](../../../data/evidence/2026-10-03-arm-localize-baseline/arm-board-final/arm_localize/README.md)<br>同名配套文件：[data/evidence/2026-10-03-arm-localize-baseline/arm-board-final/arm_localize/benchmark/run-1p9nq39b/tiny/sample-01-crops-95bg95k4/target_001.hex](../../../data/evidence/2026-10-03-arm-localize-baseline/arm-board-final/arm_localize/benchmark/run-1p9nq39b/tiny/sample-01-crops-95bg95k4/target_001.hex) |
| **data/evidence/2026-10-03-arm-localize-baseline/arm-board-final/arm_localize/benchmark/run-1p9nq39b/tiny** | | |
| [data/evidence/2026-10-03-arm-localize-baseline/arm-board-final/arm_localize/benchmark/run-1p9nq39b/tiny/sample-01.json](../../../data/evidence/2026-10-03-arm-localize-baseline/arm-board-final/arm_localize/benchmark/run-1p9nq39b/tiny/sample-01.json)<br>结构化结果/元数据 · 已纳入Git（含暂存） | 保存sample-01的实验结果或检查产物，字段包括frame_id、config_id、width、height、status、targets、schema_version；与data/evidence/2026-10-03-arm-localize-baseline/arm-board-final/arm_localize/README.md中的生成/校验流程一起使用。 | 所在目录说明：[data/evidence/2026-10-03-arm-localize-baseline/arm-board-final/arm_localize/README.md](../../../data/evidence/2026-10-03-arm-localize-baseline/arm-board-final/arm_localize/README.md)<br>同目录输入/元数据：[data/evidence/2026-10-03-arm-localize-baseline/arm-board-final/arm_localize/benchmark/run-1p9nq39b/tiny/input.json](../../../data/evidence/2026-10-03-arm-localize-baseline/arm-board-final/arm_localize/benchmark/run-1p9nq39b/tiny/input.json) |
| **data/evidence/2026-10-03-arm-localize-baseline/arm-board-final/arm_localize/benchmark/run-1p9nq39b/tiny/sample-02-crops-3hpsyevo** | | |
| [data/evidence/2026-10-03-arm-localize-baseline/arm-board-final/arm_localize/benchmark/run-1p9nq39b/tiny/sample-02-crops-3hpsyevo/target_000.hex](../../../data/evidence/2026-10-03-arm-localize-baseline/arm-board-final/arm_localize/benchmark/run-1p9nq39b/tiny/sample-02-crops-3hpsyevo/target_000.hex)<br>十六进制数据 · 已纳入Git（含暂存） | 以十六进制数据形式保存target_000的目标ROI像素；由对应加载器/testbench读取，位宽、排布和端序按data/evidence/2026-10-03-arm-localize-baseline/arm-board-final/arm_localize/README.md核对。 | 所在目录说明：[data/evidence/2026-10-03-arm-localize-baseline/arm-board-final/arm_localize/README.md](../../../data/evidence/2026-10-03-arm-localize-baseline/arm-board-final/arm_localize/README.md)<br>同名配套文件：[data/evidence/2026-10-03-arm-localize-baseline/arm-board-final/arm_localize/benchmark/run-1p9nq39b/tiny/sample-02-crops-3hpsyevo/target_000.pgm](../../../data/evidence/2026-10-03-arm-localize-baseline/arm-board-final/arm_localize/benchmark/run-1p9nq39b/tiny/sample-02-crops-3hpsyevo/target_000.pgm) |
| [data/evidence/2026-10-03-arm-localize-baseline/arm-board-final/arm_localize/benchmark/run-1p9nq39b/tiny/sample-02-crops-3hpsyevo/target_000.pgm](../../../data/evidence/2026-10-03-arm-localize-baseline/arm-board-final/arm_localize/benchmark/run-1p9nq39b/tiny/sample-02-crops-3hpsyevo/target_000.pgm)<br>灰度像素图 · 已纳入Git（含暂存） | 保存target_000的目标ROI裁剪；其合成/文件/实机来源及框/标签含义以data/evidence/2026-10-03-arm-localize-baseline/arm-board-final/arm_localize/README.md为准。 | 所在目录说明：[data/evidence/2026-10-03-arm-localize-baseline/arm-board-final/arm_localize/README.md](../../../data/evidence/2026-10-03-arm-localize-baseline/arm-board-final/arm_localize/README.md)<br>同名配套文件：[data/evidence/2026-10-03-arm-localize-baseline/arm-board-final/arm_localize/benchmark/run-1p9nq39b/tiny/sample-02-crops-3hpsyevo/target_000.hex](../../../data/evidence/2026-10-03-arm-localize-baseline/arm-board-final/arm_localize/benchmark/run-1p9nq39b/tiny/sample-02-crops-3hpsyevo/target_000.hex) |
| [data/evidence/2026-10-03-arm-localize-baseline/arm-board-final/arm_localize/benchmark/run-1p9nq39b/tiny/sample-02-crops-3hpsyevo/target_001.hex](../../../data/evidence/2026-10-03-arm-localize-baseline/arm-board-final/arm_localize/benchmark/run-1p9nq39b/tiny/sample-02-crops-3hpsyevo/target_001.hex)<br>十六进制数据 · 已纳入Git（含暂存） | 以十六进制数据形式保存target_001的目标ROI像素；由对应加载器/testbench读取，位宽、排布和端序按data/evidence/2026-10-03-arm-localize-baseline/arm-board-final/arm_localize/README.md核对。 | 所在目录说明：[data/evidence/2026-10-03-arm-localize-baseline/arm-board-final/arm_localize/README.md](../../../data/evidence/2026-10-03-arm-localize-baseline/arm-board-final/arm_localize/README.md)<br>同名配套文件：[data/evidence/2026-10-03-arm-localize-baseline/arm-board-final/arm_localize/benchmark/run-1p9nq39b/tiny/sample-02-crops-3hpsyevo/target_001.pgm](../../../data/evidence/2026-10-03-arm-localize-baseline/arm-board-final/arm_localize/benchmark/run-1p9nq39b/tiny/sample-02-crops-3hpsyevo/target_001.pgm) |
| [data/evidence/2026-10-03-arm-localize-baseline/arm-board-final/arm_localize/benchmark/run-1p9nq39b/tiny/sample-02-crops-3hpsyevo/target_001.pgm](../../../data/evidence/2026-10-03-arm-localize-baseline/arm-board-final/arm_localize/benchmark/run-1p9nq39b/tiny/sample-02-crops-3hpsyevo/target_001.pgm)<br>灰度像素图 · 已纳入Git（含暂存） | 保存target_001的目标ROI裁剪；其合成/文件/实机来源及框/标签含义以data/evidence/2026-10-03-arm-localize-baseline/arm-board-final/arm_localize/README.md为准。 | 所在目录说明：[data/evidence/2026-10-03-arm-localize-baseline/arm-board-final/arm_localize/README.md](../../../data/evidence/2026-10-03-arm-localize-baseline/arm-board-final/arm_localize/README.md)<br>同名配套文件：[data/evidence/2026-10-03-arm-localize-baseline/arm-board-final/arm_localize/benchmark/run-1p9nq39b/tiny/sample-02-crops-3hpsyevo/target_001.hex](../../../data/evidence/2026-10-03-arm-localize-baseline/arm-board-final/arm_localize/benchmark/run-1p9nq39b/tiny/sample-02-crops-3hpsyevo/target_001.hex) |
| **data/evidence/2026-10-03-arm-localize-baseline/arm-board-final/arm_localize/benchmark/run-1p9nq39b/tiny** | | |
| [data/evidence/2026-10-03-arm-localize-baseline/arm-board-final/arm_localize/benchmark/run-1p9nq39b/tiny/sample-02.json](../../../data/evidence/2026-10-03-arm-localize-baseline/arm-board-final/arm_localize/benchmark/run-1p9nq39b/tiny/sample-02.json)<br>结构化结果/元数据 · 已纳入Git（含暂存） | 保存sample-02的实验结果或检查产物，字段包括frame_id、config_id、width、height、status、targets、schema_version；与data/evidence/2026-10-03-arm-localize-baseline/arm-board-final/arm_localize/README.md中的生成/校验流程一起使用。 | 所在目录说明：[data/evidence/2026-10-03-arm-localize-baseline/arm-board-final/arm_localize/README.md](../../../data/evidence/2026-10-03-arm-localize-baseline/arm-board-final/arm_localize/README.md)<br>同目录输入/元数据：[data/evidence/2026-10-03-arm-localize-baseline/arm-board-final/arm_localize/benchmark/run-1p9nq39b/tiny/input.json](../../../data/evidence/2026-10-03-arm-localize-baseline/arm-board-final/arm_localize/benchmark/run-1p9nq39b/tiny/input.json) |
| **data/evidence/2026-10-03-arm-localize-baseline/arm-board-final/arm_localize/benchmark/run-1p9nq39b/tiny/sample-03-crops-laf5970y** | | |
| [data/evidence/2026-10-03-arm-localize-baseline/arm-board-final/arm_localize/benchmark/run-1p9nq39b/tiny/sample-03-crops-laf5970y/target_000.hex](../../../data/evidence/2026-10-03-arm-localize-baseline/arm-board-final/arm_localize/benchmark/run-1p9nq39b/tiny/sample-03-crops-laf5970y/target_000.hex)<br>十六进制数据 · 已纳入Git（含暂存） | 以十六进制数据形式保存target_000的目标ROI像素；由对应加载器/testbench读取，位宽、排布和端序按data/evidence/2026-10-03-arm-localize-baseline/arm-board-final/arm_localize/README.md核对。 | 所在目录说明：[data/evidence/2026-10-03-arm-localize-baseline/arm-board-final/arm_localize/README.md](../../../data/evidence/2026-10-03-arm-localize-baseline/arm-board-final/arm_localize/README.md)<br>同名配套文件：[data/evidence/2026-10-03-arm-localize-baseline/arm-board-final/arm_localize/benchmark/run-1p9nq39b/tiny/sample-03-crops-laf5970y/target_000.pgm](../../../data/evidence/2026-10-03-arm-localize-baseline/arm-board-final/arm_localize/benchmark/run-1p9nq39b/tiny/sample-03-crops-laf5970y/target_000.pgm) |
| [data/evidence/2026-10-03-arm-localize-baseline/arm-board-final/arm_localize/benchmark/run-1p9nq39b/tiny/sample-03-crops-laf5970y/target_000.pgm](../../../data/evidence/2026-10-03-arm-localize-baseline/arm-board-final/arm_localize/benchmark/run-1p9nq39b/tiny/sample-03-crops-laf5970y/target_000.pgm)<br>灰度像素图 · 已纳入Git（含暂存） | 保存target_000的目标ROI裁剪；其合成/文件/实机来源及框/标签含义以data/evidence/2026-10-03-arm-localize-baseline/arm-board-final/arm_localize/README.md为准。 | 所在目录说明：[data/evidence/2026-10-03-arm-localize-baseline/arm-board-final/arm_localize/README.md](../../../data/evidence/2026-10-03-arm-localize-baseline/arm-board-final/arm_localize/README.md)<br>同名配套文件：[data/evidence/2026-10-03-arm-localize-baseline/arm-board-final/arm_localize/benchmark/run-1p9nq39b/tiny/sample-03-crops-laf5970y/target_000.hex](../../../data/evidence/2026-10-03-arm-localize-baseline/arm-board-final/arm_localize/benchmark/run-1p9nq39b/tiny/sample-03-crops-laf5970y/target_000.hex) |
| [data/evidence/2026-10-03-arm-localize-baseline/arm-board-final/arm_localize/benchmark/run-1p9nq39b/tiny/sample-03-crops-laf5970y/target_001.hex](../../../data/evidence/2026-10-03-arm-localize-baseline/arm-board-final/arm_localize/benchmark/run-1p9nq39b/tiny/sample-03-crops-laf5970y/target_001.hex)<br>十六进制数据 · 已纳入Git（含暂存） | 以十六进制数据形式保存target_001的目标ROI像素；由对应加载器/testbench读取，位宽、排布和端序按data/evidence/2026-10-03-arm-localize-baseline/arm-board-final/arm_localize/README.md核对。 | 所在目录说明：[data/evidence/2026-10-03-arm-localize-baseline/arm-board-final/arm_localize/README.md](../../../data/evidence/2026-10-03-arm-localize-baseline/arm-board-final/arm_localize/README.md)<br>同名配套文件：[data/evidence/2026-10-03-arm-localize-baseline/arm-board-final/arm_localize/benchmark/run-1p9nq39b/tiny/sample-03-crops-laf5970y/target_001.pgm](../../../data/evidence/2026-10-03-arm-localize-baseline/arm-board-final/arm_localize/benchmark/run-1p9nq39b/tiny/sample-03-crops-laf5970y/target_001.pgm) |
| [data/evidence/2026-10-03-arm-localize-baseline/arm-board-final/arm_localize/benchmark/run-1p9nq39b/tiny/sample-03-crops-laf5970y/target_001.pgm](../../../data/evidence/2026-10-03-arm-localize-baseline/arm-board-final/arm_localize/benchmark/run-1p9nq39b/tiny/sample-03-crops-laf5970y/target_001.pgm)<br>灰度像素图 · 已纳入Git（含暂存） | 保存target_001的目标ROI裁剪；其合成/文件/实机来源及框/标签含义以data/evidence/2026-10-03-arm-localize-baseline/arm-board-final/arm_localize/README.md为准。 | 所在目录说明：[data/evidence/2026-10-03-arm-localize-baseline/arm-board-final/arm_localize/README.md](../../../data/evidence/2026-10-03-arm-localize-baseline/arm-board-final/arm_localize/README.md)<br>同名配套文件：[data/evidence/2026-10-03-arm-localize-baseline/arm-board-final/arm_localize/benchmark/run-1p9nq39b/tiny/sample-03-crops-laf5970y/target_001.hex](../../../data/evidence/2026-10-03-arm-localize-baseline/arm-board-final/arm_localize/benchmark/run-1p9nq39b/tiny/sample-03-crops-laf5970y/target_001.hex) |
| **data/evidence/2026-10-03-arm-localize-baseline/arm-board-final/arm_localize/benchmark/run-1p9nq39b/tiny** | | |
| [data/evidence/2026-10-03-arm-localize-baseline/arm-board-final/arm_localize/benchmark/run-1p9nq39b/tiny/sample-03.json](../../../data/evidence/2026-10-03-arm-localize-baseline/arm-board-final/arm_localize/benchmark/run-1p9nq39b/tiny/sample-03.json)<br>结构化结果/元数据 · 已纳入Git（含暂存） | 保存sample-03的实验结果或检查产物，字段包括frame_id、config_id、width、height、status、targets、schema_version；与data/evidence/2026-10-03-arm-localize-baseline/arm-board-final/arm_localize/README.md中的生成/校验流程一起使用。 | 所在目录说明：[data/evidence/2026-10-03-arm-localize-baseline/arm-board-final/arm_localize/README.md](../../../data/evidence/2026-10-03-arm-localize-baseline/arm-board-final/arm_localize/README.md)<br>同目录输入/元数据：[data/evidence/2026-10-03-arm-localize-baseline/arm-board-final/arm_localize/benchmark/run-1p9nq39b/tiny/input.json](../../../data/evidence/2026-10-03-arm-localize-baseline/arm-board-final/arm_localize/benchmark/run-1p9nq39b/tiny/input.json) |
| **data/evidence/2026-10-03-arm-localize-baseline/arm-board-final/arm_localize/benchmark/run-1p9nq39b/tiny/sample-04-crops-38ox1uka** | | |
| [data/evidence/2026-10-03-arm-localize-baseline/arm-board-final/arm_localize/benchmark/run-1p9nq39b/tiny/sample-04-crops-38ox1uka/target_000.hex](../../../data/evidence/2026-10-03-arm-localize-baseline/arm-board-final/arm_localize/benchmark/run-1p9nq39b/tiny/sample-04-crops-38ox1uka/target_000.hex)<br>十六进制数据 · 已纳入Git（含暂存） | 以十六进制数据形式保存target_000的目标ROI像素；由对应加载器/testbench读取，位宽、排布和端序按data/evidence/2026-10-03-arm-localize-baseline/arm-board-final/arm_localize/README.md核对。 | 所在目录说明：[data/evidence/2026-10-03-arm-localize-baseline/arm-board-final/arm_localize/README.md](../../../data/evidence/2026-10-03-arm-localize-baseline/arm-board-final/arm_localize/README.md)<br>同名配套文件：[data/evidence/2026-10-03-arm-localize-baseline/arm-board-final/arm_localize/benchmark/run-1p9nq39b/tiny/sample-04-crops-38ox1uka/target_000.pgm](../../../data/evidence/2026-10-03-arm-localize-baseline/arm-board-final/arm_localize/benchmark/run-1p9nq39b/tiny/sample-04-crops-38ox1uka/target_000.pgm) |
| [data/evidence/2026-10-03-arm-localize-baseline/arm-board-final/arm_localize/benchmark/run-1p9nq39b/tiny/sample-04-crops-38ox1uka/target_000.pgm](../../../data/evidence/2026-10-03-arm-localize-baseline/arm-board-final/arm_localize/benchmark/run-1p9nq39b/tiny/sample-04-crops-38ox1uka/target_000.pgm)<br>灰度像素图 · 已纳入Git（含暂存） | 保存target_000的目标ROI裁剪；其合成/文件/实机来源及框/标签含义以data/evidence/2026-10-03-arm-localize-baseline/arm-board-final/arm_localize/README.md为准。 | 所在目录说明：[data/evidence/2026-10-03-arm-localize-baseline/arm-board-final/arm_localize/README.md](../../../data/evidence/2026-10-03-arm-localize-baseline/arm-board-final/arm_localize/README.md)<br>同名配套文件：[data/evidence/2026-10-03-arm-localize-baseline/arm-board-final/arm_localize/benchmark/run-1p9nq39b/tiny/sample-04-crops-38ox1uka/target_000.hex](../../../data/evidence/2026-10-03-arm-localize-baseline/arm-board-final/arm_localize/benchmark/run-1p9nq39b/tiny/sample-04-crops-38ox1uka/target_000.hex) |
| [data/evidence/2026-10-03-arm-localize-baseline/arm-board-final/arm_localize/benchmark/run-1p9nq39b/tiny/sample-04-crops-38ox1uka/target_001.hex](../../../data/evidence/2026-10-03-arm-localize-baseline/arm-board-final/arm_localize/benchmark/run-1p9nq39b/tiny/sample-04-crops-38ox1uka/target_001.hex)<br>十六进制数据 · 已纳入Git（含暂存） | 以十六进制数据形式保存target_001的目标ROI像素；由对应加载器/testbench读取，位宽、排布和端序按data/evidence/2026-10-03-arm-localize-baseline/arm-board-final/arm_localize/README.md核对。 | 所在目录说明：[data/evidence/2026-10-03-arm-localize-baseline/arm-board-final/arm_localize/README.md](../../../data/evidence/2026-10-03-arm-localize-baseline/arm-board-final/arm_localize/README.md)<br>同名配套文件：[data/evidence/2026-10-03-arm-localize-baseline/arm-board-final/arm_localize/benchmark/run-1p9nq39b/tiny/sample-04-crops-38ox1uka/target_001.pgm](../../../data/evidence/2026-10-03-arm-localize-baseline/arm-board-final/arm_localize/benchmark/run-1p9nq39b/tiny/sample-04-crops-38ox1uka/target_001.pgm) |
| [data/evidence/2026-10-03-arm-localize-baseline/arm-board-final/arm_localize/benchmark/run-1p9nq39b/tiny/sample-04-crops-38ox1uka/target_001.pgm](../../../data/evidence/2026-10-03-arm-localize-baseline/arm-board-final/arm_localize/benchmark/run-1p9nq39b/tiny/sample-04-crops-38ox1uka/target_001.pgm)<br>灰度像素图 · 已纳入Git（含暂存） | 保存target_001的目标ROI裁剪；其合成/文件/实机来源及框/标签含义以data/evidence/2026-10-03-arm-localize-baseline/arm-board-final/arm_localize/README.md为准。 | 所在目录说明：[data/evidence/2026-10-03-arm-localize-baseline/arm-board-final/arm_localize/README.md](../../../data/evidence/2026-10-03-arm-localize-baseline/arm-board-final/arm_localize/README.md)<br>同名配套文件：[data/evidence/2026-10-03-arm-localize-baseline/arm-board-final/arm_localize/benchmark/run-1p9nq39b/tiny/sample-04-crops-38ox1uka/target_001.hex](../../../data/evidence/2026-10-03-arm-localize-baseline/arm-board-final/arm_localize/benchmark/run-1p9nq39b/tiny/sample-04-crops-38ox1uka/target_001.hex) |
| **data/evidence/2026-10-03-arm-localize-baseline/arm-board-final/arm_localize/benchmark/run-1p9nq39b/tiny** | | |
| [data/evidence/2026-10-03-arm-localize-baseline/arm-board-final/arm_localize/benchmark/run-1p9nq39b/tiny/sample-04.json](../../../data/evidence/2026-10-03-arm-localize-baseline/arm-board-final/arm_localize/benchmark/run-1p9nq39b/tiny/sample-04.json)<br>结构化结果/元数据 · 已纳入Git（含暂存） | 保存sample-04的实验结果或检查产物，字段包括frame_id、config_id、width、height、status、targets、schema_version；与data/evidence/2026-10-03-arm-localize-baseline/arm-board-final/arm_localize/README.md中的生成/校验流程一起使用。 | 所在目录说明：[data/evidence/2026-10-03-arm-localize-baseline/arm-board-final/arm_localize/README.md](../../../data/evidence/2026-10-03-arm-localize-baseline/arm-board-final/arm_localize/README.md)<br>同目录输入/元数据：[data/evidence/2026-10-03-arm-localize-baseline/arm-board-final/arm_localize/benchmark/run-1p9nq39b/tiny/input.json](../../../data/evidence/2026-10-03-arm-localize-baseline/arm-board-final/arm_localize/benchmark/run-1p9nq39b/tiny/input.json) |
| **data/evidence/2026-10-03-arm-localize-baseline/arm-board-final/arm_localize/benchmark/run-1p9nq39b/tiny/warmup-00-crops-1a0nfp8a** | | |
| [data/evidence/2026-10-03-arm-localize-baseline/arm-board-final/arm_localize/benchmark/run-1p9nq39b/tiny/warmup-00-crops-1a0nfp8a/target_000.hex](../../../data/evidence/2026-10-03-arm-localize-baseline/arm-board-final/arm_localize/benchmark/run-1p9nq39b/tiny/warmup-00-crops-1a0nfp8a/target_000.hex)<br>十六进制数据 · 已纳入Git（含暂存） | 以十六进制数据形式保存target_000的目标ROI像素；由对应加载器/testbench读取，位宽、排布和端序按data/evidence/2026-10-03-arm-localize-baseline/arm-board-final/arm_localize/README.md核对。 | 所在目录说明：[data/evidence/2026-10-03-arm-localize-baseline/arm-board-final/arm_localize/README.md](../../../data/evidence/2026-10-03-arm-localize-baseline/arm-board-final/arm_localize/README.md)<br>同名配套文件：[data/evidence/2026-10-03-arm-localize-baseline/arm-board-final/arm_localize/benchmark/run-1p9nq39b/tiny/warmup-00-crops-1a0nfp8a/target_000.pgm](../../../data/evidence/2026-10-03-arm-localize-baseline/arm-board-final/arm_localize/benchmark/run-1p9nq39b/tiny/warmup-00-crops-1a0nfp8a/target_000.pgm) |
| [data/evidence/2026-10-03-arm-localize-baseline/arm-board-final/arm_localize/benchmark/run-1p9nq39b/tiny/warmup-00-crops-1a0nfp8a/target_000.pgm](../../../data/evidence/2026-10-03-arm-localize-baseline/arm-board-final/arm_localize/benchmark/run-1p9nq39b/tiny/warmup-00-crops-1a0nfp8a/target_000.pgm)<br>灰度像素图 · 已纳入Git（含暂存） | 保存target_000的目标ROI裁剪；其合成/文件/实机来源及框/标签含义以data/evidence/2026-10-03-arm-localize-baseline/arm-board-final/arm_localize/README.md为准。 | 所在目录说明：[data/evidence/2026-10-03-arm-localize-baseline/arm-board-final/arm_localize/README.md](../../../data/evidence/2026-10-03-arm-localize-baseline/arm-board-final/arm_localize/README.md)<br>同名配套文件：[data/evidence/2026-10-03-arm-localize-baseline/arm-board-final/arm_localize/benchmark/run-1p9nq39b/tiny/warmup-00-crops-1a0nfp8a/target_000.hex](../../../data/evidence/2026-10-03-arm-localize-baseline/arm-board-final/arm_localize/benchmark/run-1p9nq39b/tiny/warmup-00-crops-1a0nfp8a/target_000.hex) |
| [data/evidence/2026-10-03-arm-localize-baseline/arm-board-final/arm_localize/benchmark/run-1p9nq39b/tiny/warmup-00-crops-1a0nfp8a/target_001.hex](../../../data/evidence/2026-10-03-arm-localize-baseline/arm-board-final/arm_localize/benchmark/run-1p9nq39b/tiny/warmup-00-crops-1a0nfp8a/target_001.hex)<br>十六进制数据 · 已纳入Git（含暂存） | 以十六进制数据形式保存target_001的目标ROI像素；由对应加载器/testbench读取，位宽、排布和端序按data/evidence/2026-10-03-arm-localize-baseline/arm-board-final/arm_localize/README.md核对。 | 所在目录说明：[data/evidence/2026-10-03-arm-localize-baseline/arm-board-final/arm_localize/README.md](../../../data/evidence/2026-10-03-arm-localize-baseline/arm-board-final/arm_localize/README.md)<br>同名配套文件：[data/evidence/2026-10-03-arm-localize-baseline/arm-board-final/arm_localize/benchmark/run-1p9nq39b/tiny/warmup-00-crops-1a0nfp8a/target_001.pgm](../../../data/evidence/2026-10-03-arm-localize-baseline/arm-board-final/arm_localize/benchmark/run-1p9nq39b/tiny/warmup-00-crops-1a0nfp8a/target_001.pgm) |
| [data/evidence/2026-10-03-arm-localize-baseline/arm-board-final/arm_localize/benchmark/run-1p9nq39b/tiny/warmup-00-crops-1a0nfp8a/target_001.pgm](../../../data/evidence/2026-10-03-arm-localize-baseline/arm-board-final/arm_localize/benchmark/run-1p9nq39b/tiny/warmup-00-crops-1a0nfp8a/target_001.pgm)<br>灰度像素图 · 已纳入Git（含暂存） | 保存target_001的目标ROI裁剪；其合成/文件/实机来源及框/标签含义以data/evidence/2026-10-03-arm-localize-baseline/arm-board-final/arm_localize/README.md为准。 | 所在目录说明：[data/evidence/2026-10-03-arm-localize-baseline/arm-board-final/arm_localize/README.md](../../../data/evidence/2026-10-03-arm-localize-baseline/arm-board-final/arm_localize/README.md)<br>同名配套文件：[data/evidence/2026-10-03-arm-localize-baseline/arm-board-final/arm_localize/benchmark/run-1p9nq39b/tiny/warmup-00-crops-1a0nfp8a/target_001.hex](../../../data/evidence/2026-10-03-arm-localize-baseline/arm-board-final/arm_localize/benchmark/run-1p9nq39b/tiny/warmup-00-crops-1a0nfp8a/target_001.hex) |
| **data/evidence/2026-10-03-arm-localize-baseline/arm-board-final/arm_localize/benchmark/run-1p9nq39b/tiny** | | |
| [data/evidence/2026-10-03-arm-localize-baseline/arm-board-final/arm_localize/benchmark/run-1p9nq39b/tiny/warmup-00.json](../../../data/evidence/2026-10-03-arm-localize-baseline/arm-board-final/arm_localize/benchmark/run-1p9nq39b/tiny/warmup-00.json)<br>结构化结果/元数据 · 已纳入Git（含暂存） | 保存warmup-00的实验结果或检查产物，字段包括frame_id、config_id、width、height、status、targets、schema_version；与data/evidence/2026-10-03-arm-localize-baseline/arm-board-final/arm_localize/README.md中的生成/校验流程一起使用。 | 所在目录说明：[data/evidence/2026-10-03-arm-localize-baseline/arm-board-final/arm_localize/README.md](../../../data/evidence/2026-10-03-arm-localize-baseline/arm-board-final/arm_localize/README.md)<br>同目录输入/元数据：[data/evidence/2026-10-03-arm-localize-baseline/arm-board-final/arm_localize/benchmark/run-1p9nq39b/tiny/input.json](../../../data/evidence/2026-10-03-arm-localize-baseline/arm-board-final/arm_localize/benchmark/run-1p9nq39b/tiny/input.json) |
| **data/evidence/2026-10-03-arm-localize-baseline/arm-board-final/arm_localize/benchmark** | | |
| [data/evidence/2026-10-03-arm-localize-baseline/arm-board-final/arm_localize/benchmark/summary.json](../../../data/evidence/2026-10-03-arm-localize-baseline/arm-board-final/arm_localize/benchmark/summary.json)<br>结构化结果/元数据 · 已纳入Git（含暂存） | 保存summary的实验结果或检查产物，字段包括schema_version、mode、utc、warmup、repeats、crop_size、p95_method；与data/evidence/2026-10-03-arm-localize-baseline/arm-board-final/arm_localize/README.md中的生成/校验流程一起使用。 | 所在目录说明：[data/evidence/2026-10-03-arm-localize-baseline/arm-board-final/arm_localize/README.md](../../../data/evidence/2026-10-03-arm-localize-baseline/arm-board-final/arm_localize/README.md) |
| **data/evidence/2026-10-03-arm-localize-baseline/arm-board-final/arm_localize/final-result-crops-qq101pl5** | | |
| [data/evidence/2026-10-03-arm-localize-baseline/arm-board-final/arm_localize/final-result-crops-qq101pl5/target_000.hex](../../../data/evidence/2026-10-03-arm-localize-baseline/arm-board-final/arm_localize/final-result-crops-qq101pl5/target_000.hex)<br>十六进制数据 · 已纳入Git（含暂存） | 以十六进制数据形式保存target_000的目标ROI像素；由对应加载器/testbench读取，位宽、排布和端序按data/evidence/2026-10-03-arm-localize-baseline/arm-board-final/arm_localize/README.md核对。 | 所在目录说明：[data/evidence/2026-10-03-arm-localize-baseline/arm-board-final/arm_localize/README.md](../../../data/evidence/2026-10-03-arm-localize-baseline/arm-board-final/arm_localize/README.md)<br>同名配套文件：[data/evidence/2026-10-03-arm-localize-baseline/arm-board-final/arm_localize/final-result-crops-qq101pl5/target_000.pgm](../../../data/evidence/2026-10-03-arm-localize-baseline/arm-board-final/arm_localize/final-result-crops-qq101pl5/target_000.pgm) |
| [data/evidence/2026-10-03-arm-localize-baseline/arm-board-final/arm_localize/final-result-crops-qq101pl5/target_000.pgm](../../../data/evidence/2026-10-03-arm-localize-baseline/arm-board-final/arm_localize/final-result-crops-qq101pl5/target_000.pgm)<br>灰度像素图 · 已纳入Git（含暂存） | 保存target_000的目标ROI裁剪；其合成/文件/实机来源及框/标签含义以data/evidence/2026-10-03-arm-localize-baseline/arm-board-final/arm_localize/README.md为准。 | 所在目录说明：[data/evidence/2026-10-03-arm-localize-baseline/arm-board-final/arm_localize/README.md](../../../data/evidence/2026-10-03-arm-localize-baseline/arm-board-final/arm_localize/README.md)<br>同名配套文件：[data/evidence/2026-10-03-arm-localize-baseline/arm-board-final/arm_localize/final-result-crops-qq101pl5/target_000.hex](../../../data/evidence/2026-10-03-arm-localize-baseline/arm-board-final/arm_localize/final-result-crops-qq101pl5/target_000.hex) |
| [data/evidence/2026-10-03-arm-localize-baseline/arm-board-final/arm_localize/final-result-crops-qq101pl5/target_001.hex](../../../data/evidence/2026-10-03-arm-localize-baseline/arm-board-final/arm_localize/final-result-crops-qq101pl5/target_001.hex)<br>十六进制数据 · 已纳入Git（含暂存） | 以十六进制数据形式保存target_001的目标ROI像素；由对应加载器/testbench读取，位宽、排布和端序按data/evidence/2026-10-03-arm-localize-baseline/arm-board-final/arm_localize/README.md核对。 | 所在目录说明：[data/evidence/2026-10-03-arm-localize-baseline/arm-board-final/arm_localize/README.md](../../../data/evidence/2026-10-03-arm-localize-baseline/arm-board-final/arm_localize/README.md)<br>同名配套文件：[data/evidence/2026-10-03-arm-localize-baseline/arm-board-final/arm_localize/final-result-crops-qq101pl5/target_001.pgm](../../../data/evidence/2026-10-03-arm-localize-baseline/arm-board-final/arm_localize/final-result-crops-qq101pl5/target_001.pgm) |
| [data/evidence/2026-10-03-arm-localize-baseline/arm-board-final/arm_localize/final-result-crops-qq101pl5/target_001.pgm](../../../data/evidence/2026-10-03-arm-localize-baseline/arm-board-final/arm_localize/final-result-crops-qq101pl5/target_001.pgm)<br>灰度像素图 · 已纳入Git（含暂存） | 保存target_001的目标ROI裁剪；其合成/文件/实机来源及框/标签含义以data/evidence/2026-10-03-arm-localize-baseline/arm-board-final/arm_localize/README.md为准。 | 所在目录说明：[data/evidence/2026-10-03-arm-localize-baseline/arm-board-final/arm_localize/README.md](../../../data/evidence/2026-10-03-arm-localize-baseline/arm-board-final/arm_localize/README.md)<br>同名配套文件：[data/evidence/2026-10-03-arm-localize-baseline/arm-board-final/arm_localize/final-result-crops-qq101pl5/target_001.hex](../../../data/evidence/2026-10-03-arm-localize-baseline/arm-board-final/arm_localize/final-result-crops-qq101pl5/target_001.hex) |
| **data/evidence/2026-10-03-arm-localize-baseline/arm-board-final/arm_localize** | | |
| [data/evidence/2026-10-03-arm-localize-baseline/arm-board-final/arm_localize/final-result.json](../../../data/evidence/2026-10-03-arm-localize-baseline/arm-board-final/arm_localize/final-result.json)<br>结构化结果/元数据 · 已纳入Git（含暂存） | 保存final-result的实验结果或检查产物，字段包括frame_id、config_id、width、height、status、targets、schema_version；与data/evidence/2026-10-03-arm-localize-baseline/arm-board-final/arm_localize/README.md中的生成/校验流程一起使用。 | 所在目录说明：[data/evidence/2026-10-03-arm-localize-baseline/arm-board-final/arm_localize/README.md](../../../data/evidence/2026-10-03-arm-localize-baseline/arm-board-final/arm_localize/README.md)<br>同目录输入/元数据：[data/evidence/2026-10-03-arm-localize-baseline/arm-board-final/arm_localize/manifest.json](../../../data/evidence/2026-10-03-arm-localize-baseline/arm-board-final/arm_localize/manifest.json) |
| [data/evidence/2026-10-03-arm-localize-baseline/arm-board-final/arm_localize/manifest.json](../../../data/evidence/2026-10-03-arm-localize-baseline/arm-board-final/arm_localize/manifest.json)<br>结构化结果/元数据 · 已纳入Git（含暂存） | 保存manifest的文件清单及完整性信息，字段包括schema_version、base_commit、files；与data/evidence/2026-10-03-arm-localize-baseline/arm-board-final/arm_localize/README.md中的生成/校验流程一起使用。 | 所在目录说明：[data/evidence/2026-10-03-arm-localize-baseline/arm-board-final/arm_localize/README.md](../../../data/evidence/2026-10-03-arm-localize-baseline/arm-board-final/arm_localize/README.md) |
| [data/evidence/2026-10-03-arm-localize-baseline/arm-board-final/arm_localize/reference.py](../../../data/evidence/2026-10-03-arm-localize-baseline/arm-board-final/arm_localize/reference.py)<br>归档源码/输入副本 · 已纳入Git（含暂存） | 这是该轮保存的源码/配置副本：实现/配置reference相关流程，定义locate、crop_resize、coord、prepare_targets；实际导入、例化和文本引用见关联栏，与data/evidence/2026-10-03-arm-localize-baseline/arm-board-final/arm_localize/README.md配套阅读；所属实验与当前入口以关联栏区分。 | 所在目录说明：[data/evidence/2026-10-03-arm-localize-baseline/arm-board-final/arm_localize/README.md](../../../data/evidence/2026-10-03-arm-localize-baseline/arm-board-final/arm_localize/README.md)<br>同目录输入/元数据：[data/evidence/2026-10-03-arm-localize-baseline/arm-board-final/arm_localize/manifest.json](../../../data/evidence/2026-10-03-arm-localize-baseline/arm-board-final/arm_localize/manifest.json) |
| **data/evidence/2026-10-03-arm-localize-baseline/arm-board-final/arm_localize/selftest-evidence/result-crops-txhvj155** | | |
| [data/evidence/2026-10-03-arm-localize-baseline/arm-board-final/arm_localize/selftest-evidence/result-crops-txhvj155/target_000.hex](../../../data/evidence/2026-10-03-arm-localize-baseline/arm-board-final/arm_localize/selftest-evidence/result-crops-txhvj155/target_000.hex)<br>十六进制数据 · 已纳入Git（含暂存） | 以十六进制数据形式保存target_000的目标ROI像素；由对应加载器/testbench读取，位宽、排布和端序按data/evidence/2026-10-03-arm-localize-baseline/arm-board-final/arm_localize/README.md核对。 | 所在目录说明：[data/evidence/2026-10-03-arm-localize-baseline/arm-board-final/arm_localize/README.md](../../../data/evidence/2026-10-03-arm-localize-baseline/arm-board-final/arm_localize/README.md)<br>同名配套文件：[data/evidence/2026-10-03-arm-localize-baseline/arm-board-final/arm_localize/selftest-evidence/result-crops-txhvj155/target_000.pgm](../../../data/evidence/2026-10-03-arm-localize-baseline/arm-board-final/arm_localize/selftest-evidence/result-crops-txhvj155/target_000.pgm) |
| [data/evidence/2026-10-03-arm-localize-baseline/arm-board-final/arm_localize/selftest-evidence/result-crops-txhvj155/target_000.pgm](../../../data/evidence/2026-10-03-arm-localize-baseline/arm-board-final/arm_localize/selftest-evidence/result-crops-txhvj155/target_000.pgm)<br>灰度像素图 · 已纳入Git（含暂存） | 保存target_000的目标ROI裁剪；其合成/文件/实机来源及框/标签含义以data/evidence/2026-10-03-arm-localize-baseline/arm-board-final/arm_localize/README.md为准。 | 所在目录说明：[data/evidence/2026-10-03-arm-localize-baseline/arm-board-final/arm_localize/README.md](../../../data/evidence/2026-10-03-arm-localize-baseline/arm-board-final/arm_localize/README.md)<br>同名配套文件：[data/evidence/2026-10-03-arm-localize-baseline/arm-board-final/arm_localize/selftest-evidence/result-crops-txhvj155/target_000.hex](../../../data/evidence/2026-10-03-arm-localize-baseline/arm-board-final/arm_localize/selftest-evidence/result-crops-txhvj155/target_000.hex) |
| [data/evidence/2026-10-03-arm-localize-baseline/arm-board-final/arm_localize/selftest-evidence/result-crops-txhvj155/target_001.hex](../../../data/evidence/2026-10-03-arm-localize-baseline/arm-board-final/arm_localize/selftest-evidence/result-crops-txhvj155/target_001.hex)<br>十六进制数据 · 已纳入Git（含暂存） | 以十六进制数据形式保存target_001的目标ROI像素；由对应加载器/testbench读取，位宽、排布和端序按data/evidence/2026-10-03-arm-localize-baseline/arm-board-final/arm_localize/README.md核对。 | 所在目录说明：[data/evidence/2026-10-03-arm-localize-baseline/arm-board-final/arm_localize/README.md](../../../data/evidence/2026-10-03-arm-localize-baseline/arm-board-final/arm_localize/README.md)<br>同名配套文件：[data/evidence/2026-10-03-arm-localize-baseline/arm-board-final/arm_localize/selftest-evidence/result-crops-txhvj155/target_001.pgm](../../../data/evidence/2026-10-03-arm-localize-baseline/arm-board-final/arm_localize/selftest-evidence/result-crops-txhvj155/target_001.pgm) |
| [data/evidence/2026-10-03-arm-localize-baseline/arm-board-final/arm_localize/selftest-evidence/result-crops-txhvj155/target_001.pgm](../../../data/evidence/2026-10-03-arm-localize-baseline/arm-board-final/arm_localize/selftest-evidence/result-crops-txhvj155/target_001.pgm)<br>灰度像素图 · 已纳入Git（含暂存） | 保存target_001的目标ROI裁剪；其合成/文件/实机来源及框/标签含义以data/evidence/2026-10-03-arm-localize-baseline/arm-board-final/arm_localize/README.md为准。 | 所在目录说明：[data/evidence/2026-10-03-arm-localize-baseline/arm-board-final/arm_localize/README.md](../../../data/evidence/2026-10-03-arm-localize-baseline/arm-board-final/arm_localize/README.md)<br>同名配套文件：[data/evidence/2026-10-03-arm-localize-baseline/arm-board-final/arm_localize/selftest-evidence/result-crops-txhvj155/target_001.hex](../../../data/evidence/2026-10-03-arm-localize-baseline/arm-board-final/arm_localize/selftest-evidence/result-crops-txhvj155/target_001.hex) |
| **data/evidence/2026-10-03-arm-localize-baseline/arm-board-final/arm_localize/selftest-evidence** | | |
| [data/evidence/2026-10-03-arm-localize-baseline/arm-board-final/arm_localize/selftest-evidence/result.json](../../../data/evidence/2026-10-03-arm-localize-baseline/arm-board-final/arm_localize/selftest-evidence/result.json)<br>结构化结果/元数据 · 已纳入Git（含暂存） | 保存result的实验结果或检查产物，字段包括frame_id、config_id、width、height、status、targets、schema_version；与data/evidence/2026-10-03-arm-localize-baseline/arm-board-final/arm_localize/README.md中的生成/校验流程一起使用。 | 所在目录说明：[data/evidence/2026-10-03-arm-localize-baseline/arm-board-final/arm_localize/README.md](../../../data/evidence/2026-10-03-arm-localize-baseline/arm-board-final/arm_localize/README.md) |
| **data/evidence/2026-10-03-arm-localize-baseline/arm-board-final/arm_localize** | | |
| [data/evidence/2026-10-03-arm-localize-baseline/arm-board-final/arm_localize/two_targets.json](../../../data/evidence/2026-10-03-arm-localize-baseline/arm-board-final/arm_localize/two_targets.json)<br>结构化结果/元数据 · 已纳入Git（含暂存） | 保存two_targets的实验结果或检查产物，字段包括pixels；与data/evidence/2026-10-03-arm-localize-baseline/arm-board-final/arm_localize/README.md中的生成/校验流程一起使用。 | 所在目录说明：[data/evidence/2026-10-03-arm-localize-baseline/arm-board-final/arm_localize/README.md](../../../data/evidence/2026-10-03-arm-localize-baseline/arm-board-final/arm_localize/README.md)<br>同目录输入/元数据：[data/evidence/2026-10-03-arm-localize-baseline/arm-board-final/arm_localize/manifest.json](../../../data/evidence/2026-10-03-arm-localize-baseline/arm-board-final/arm_localize/manifest.json) |
| **data/evidence/2026-10-03-arm-localize-baseline/arm-board/arm_localize** | | |
| [data/evidence/2026-10-03-arm-localize-baseline/arm-board/arm_localize/README.md](../../../data/evidence/2026-10-03-arm-localize-baseline/arm-board/arm_localize/README.md)<br>说明/计划/契约 · 已纳入Git（含暂存） | 说明《ARM 文件定位/裁剪便携包》的规则、过程或结果；其引用文件见关联栏，日期/候选/冻结边界按正文保留。 | 所在目录说明：[data/evidence/2026-10-03-arm-localize-baseline/README.md](../../../data/evidence/2026-10-03-arm-localize-baseline/README.md)<br>同目录输入/元数据：[data/evidence/2026-10-03-arm-localize-baseline/arm-board/arm_localize/manifest.json](../../../data/evidence/2026-10-03-arm-localize-baseline/arm-board/arm_localize/manifest.json)<br>文本引用：[sim/scripts/make_arm_localize_pkg.py](../../../sim/scripts/make_arm_localize_pkg.py) |
| [data/evidence/2026-10-03-arm-localize-baseline/arm-board/arm_localize/arm_localize.py](../../../data/evidence/2026-10-03-arm-localize-baseline/arm-board/arm_localize/arm_localize.py)<br>归档源码/输入副本 · 已纳入Git（含暂存） | 这是该轮保存的源码/配置副本：标准库文件定位/裁剪运行器，记录纯计算耗时；它不从实时HDMI取帧；所属实验与当前入口以关联栏区分。 | 所在目录说明：[data/evidence/2026-10-03-arm-localize-baseline/arm-board/arm_localize/README.md](../../../data/evidence/2026-10-03-arm-localize-baseline/arm-board/arm_localize/README.md)<br>同目录输入/元数据：[data/evidence/2026-10-03-arm-localize-baseline/arm-board/arm_localize/manifest.json](../../../data/evidence/2026-10-03-arm-localize-baseline/arm-board/arm_localize/manifest.json)<br>Python导入：[data/evidence/2026-10-03-arm-localize-baseline/arm-board/arm_localize/reference.py](../../../data/evidence/2026-10-03-arm-localize-baseline/arm-board/arm_localize/reference.py) |
| [data/evidence/2026-10-03-arm-localize-baseline/arm-board/arm_localize/arm_localize_bench.py](../../../data/evidence/2026-10-03-arm-localize-baseline/arm-board/arm_localize/arm_localize_bench.py)<br>归档源码/输入副本 · 已纳入Git（含暂存） | 这是该轮保存的源码/配置副本：在固定合成场景上重复测定位性能并保存每次结果；用于ARM与本机同负载对比；所属实验与当前入口以关联栏区分。 | 所在目录说明：[data/evidence/2026-10-03-arm-localize-baseline/arm-board/arm_localize/README.md](../../../data/evidence/2026-10-03-arm-localize-baseline/arm-board/arm_localize/README.md)<br>Python导入：[data/evidence/2026-10-03-arm-localize-baseline/arm-board/arm_localize/arm_localize.py](../../../data/evidence/2026-10-03-arm-localize-baseline/arm-board/arm_localize/arm_localize.py)<br>同目录输入/元数据：[data/evidence/2026-10-03-arm-localize-baseline/arm-board/arm_localize/manifest.json](../../../data/evidence/2026-10-03-arm-localize-baseline/arm-board/arm_localize/manifest.json)<br>文本引用：[data/evidence/2026-10-03-arm-localize-baseline/two_targets.json](../../../data/evidence/2026-10-03-arm-localize-baseline/two_targets.json) |
| [data/evidence/2026-10-03-arm-localize-baseline/arm-board/arm_localize/arm_localize_selftest.py](../../../data/evidence/2026-10-03-arm-localize-baseline/arm-board/arm_localize/arm_localize_selftest.py)<br>归档源码/输入副本 · 已纳入Git（含暂存） | 这是该轮保存的源码/配置副本：便携定位包自检，覆盖固定答案、非法输入、CLI和哈希；供打包/移交检查；所属实验与当前入口以关联栏区分。 | 所在目录说明：[data/evidence/2026-10-03-arm-localize-baseline/arm-board/arm_localize/README.md](../../../data/evidence/2026-10-03-arm-localize-baseline/arm-board/arm_localize/README.md)<br>Python导入：[data/evidence/2026-10-03-arm-localize-baseline/arm-board/arm_localize/arm_localize.py](../../../data/evidence/2026-10-03-arm-localize-baseline/arm-board/arm_localize/arm_localize.py)<br>同目录输入/元数据：[data/evidence/2026-10-03-arm-localize-baseline/arm-board/arm_localize/manifest.json](../../../data/evidence/2026-10-03-arm-localize-baseline/arm-board/arm_localize/manifest.json) |
| **data/evidence/2026-10-03-arm-localize-baseline/arm-board/arm_localize/benchmark/run-nph60lvw/720p_empty** | | |
| [data/evidence/2026-10-03-arm-localize-baseline/arm-board/arm_localize/benchmark/run-nph60lvw/720p_empty/input.json](../../../data/evidence/2026-10-03-arm-localize-baseline/arm-board/arm_localize/benchmark/run-nph60lvw/720p_empty/input.json)<br>结构化结果/元数据 · 已纳入Git（含暂存） | 保存input的输入/设备/运行元数据，字段包括具体字段；与data/evidence/2026-10-03-arm-localize-baseline/arm-board/arm_localize/README.md中的生成/校验流程一起使用。 | 所在目录说明：[data/evidence/2026-10-03-arm-localize-baseline/arm-board/arm_localize/README.md](../../../data/evidence/2026-10-03-arm-localize-baseline/arm-board/arm_localize/README.md) |
| [data/evidence/2026-10-03-arm-localize-baseline/arm-board/arm_localize/benchmark/run-nph60lvw/720p_empty/sample-00.json](../../../data/evidence/2026-10-03-arm-localize-baseline/arm-board/arm_localize/benchmark/run-nph60lvw/720p_empty/sample-00.json)<br>结构化结果/元数据 · 已纳入Git（含暂存） | 保存sample-00的实验结果或检查产物，字段包括frame_id、config_id、width、height、status、targets、schema_version；与data/evidence/2026-10-03-arm-localize-baseline/arm-board/arm_localize/README.md中的生成/校验流程一起使用。 | 所在目录说明：[data/evidence/2026-10-03-arm-localize-baseline/arm-board/arm_localize/README.md](../../../data/evidence/2026-10-03-arm-localize-baseline/arm-board/arm_localize/README.md)<br>同目录输入/元数据：[data/evidence/2026-10-03-arm-localize-baseline/arm-board/arm_localize/benchmark/run-nph60lvw/720p_empty/input.json](../../../data/evidence/2026-10-03-arm-localize-baseline/arm-board/arm_localize/benchmark/run-nph60lvw/720p_empty/input.json) |
| [data/evidence/2026-10-03-arm-localize-baseline/arm-board/arm_localize/benchmark/run-nph60lvw/720p_empty/sample-01.json](../../../data/evidence/2026-10-03-arm-localize-baseline/arm-board/arm_localize/benchmark/run-nph60lvw/720p_empty/sample-01.json)<br>结构化结果/元数据 · 已纳入Git（含暂存） | 保存sample-01的实验结果或检查产物，字段包括frame_id、config_id、width、height、status、targets、schema_version；与data/evidence/2026-10-03-arm-localize-baseline/arm-board/arm_localize/README.md中的生成/校验流程一起使用。 | 所在目录说明：[data/evidence/2026-10-03-arm-localize-baseline/arm-board/arm_localize/README.md](../../../data/evidence/2026-10-03-arm-localize-baseline/arm-board/arm_localize/README.md)<br>同目录输入/元数据：[data/evidence/2026-10-03-arm-localize-baseline/arm-board/arm_localize/benchmark/run-nph60lvw/720p_empty/input.json](../../../data/evidence/2026-10-03-arm-localize-baseline/arm-board/arm_localize/benchmark/run-nph60lvw/720p_empty/input.json) |
| [data/evidence/2026-10-03-arm-localize-baseline/arm-board/arm_localize/benchmark/run-nph60lvw/720p_empty/sample-02.json](../../../data/evidence/2026-10-03-arm-localize-baseline/arm-board/arm_localize/benchmark/run-nph60lvw/720p_empty/sample-02.json)<br>结构化结果/元数据 · 已纳入Git（含暂存） | 保存sample-02的实验结果或检查产物，字段包括frame_id、config_id、width、height、status、targets、schema_version；与data/evidence/2026-10-03-arm-localize-baseline/arm-board/arm_localize/README.md中的生成/校验流程一起使用。 | 所在目录说明：[data/evidence/2026-10-03-arm-localize-baseline/arm-board/arm_localize/README.md](../../../data/evidence/2026-10-03-arm-localize-baseline/arm-board/arm_localize/README.md)<br>同目录输入/元数据：[data/evidence/2026-10-03-arm-localize-baseline/arm-board/arm_localize/benchmark/run-nph60lvw/720p_empty/input.json](../../../data/evidence/2026-10-03-arm-localize-baseline/arm-board/arm_localize/benchmark/run-nph60lvw/720p_empty/input.json) |
| [data/evidence/2026-10-03-arm-localize-baseline/arm-board/arm_localize/benchmark/run-nph60lvw/720p_empty/sample-03.json](../../../data/evidence/2026-10-03-arm-localize-baseline/arm-board/arm_localize/benchmark/run-nph60lvw/720p_empty/sample-03.json)<br>结构化结果/元数据 · 已纳入Git（含暂存） | 保存sample-03的实验结果或检查产物，字段包括frame_id、config_id、width、height、status、targets、schema_version；与data/evidence/2026-10-03-arm-localize-baseline/arm-board/arm_localize/README.md中的生成/校验流程一起使用。 | 所在目录说明：[data/evidence/2026-10-03-arm-localize-baseline/arm-board/arm_localize/README.md](../../../data/evidence/2026-10-03-arm-localize-baseline/arm-board/arm_localize/README.md)<br>同目录输入/元数据：[data/evidence/2026-10-03-arm-localize-baseline/arm-board/arm_localize/benchmark/run-nph60lvw/720p_empty/input.json](../../../data/evidence/2026-10-03-arm-localize-baseline/arm-board/arm_localize/benchmark/run-nph60lvw/720p_empty/input.json) |
| [data/evidence/2026-10-03-arm-localize-baseline/arm-board/arm_localize/benchmark/run-nph60lvw/720p_empty/sample-04.json](../../../data/evidence/2026-10-03-arm-localize-baseline/arm-board/arm_localize/benchmark/run-nph60lvw/720p_empty/sample-04.json)<br>结构化结果/元数据 · 已纳入Git（含暂存） | 保存sample-04的实验结果或检查产物，字段包括frame_id、config_id、width、height、status、targets、schema_version；与data/evidence/2026-10-03-arm-localize-baseline/arm-board/arm_localize/README.md中的生成/校验流程一起使用。 | 所在目录说明：[data/evidence/2026-10-03-arm-localize-baseline/arm-board/arm_localize/README.md](../../../data/evidence/2026-10-03-arm-localize-baseline/arm-board/arm_localize/README.md)<br>同目录输入/元数据：[data/evidence/2026-10-03-arm-localize-baseline/arm-board/arm_localize/benchmark/run-nph60lvw/720p_empty/input.json](../../../data/evidence/2026-10-03-arm-localize-baseline/arm-board/arm_localize/benchmark/run-nph60lvw/720p_empty/input.json) |
| [data/evidence/2026-10-03-arm-localize-baseline/arm-board/arm_localize/benchmark/run-nph60lvw/720p_empty/warmup-00.json](../../../data/evidence/2026-10-03-arm-localize-baseline/arm-board/arm_localize/benchmark/run-nph60lvw/720p_empty/warmup-00.json)<br>结构化结果/元数据 · 已纳入Git（含暂存） | 保存warmup-00的实验结果或检查产物，字段包括frame_id、config_id、width、height、status、targets、schema_version；与data/evidence/2026-10-03-arm-localize-baseline/arm-board/arm_localize/README.md中的生成/校验流程一起使用。 | 所在目录说明：[data/evidence/2026-10-03-arm-localize-baseline/arm-board/arm_localize/README.md](../../../data/evidence/2026-10-03-arm-localize-baseline/arm-board/arm_localize/README.md)<br>同目录输入/元数据：[data/evidence/2026-10-03-arm-localize-baseline/arm-board/arm_localize/benchmark/run-nph60lvw/720p_empty/input.json](../../../data/evidence/2026-10-03-arm-localize-baseline/arm-board/arm_localize/benchmark/run-nph60lvw/720p_empty/input.json) |
| **data/evidence/2026-10-03-arm-localize-baseline/arm-board/arm_localize/benchmark/run-nph60lvw/720p_six** | | |
| [data/evidence/2026-10-03-arm-localize-baseline/arm-board/arm_localize/benchmark/run-nph60lvw/720p_six/input.json](../../../data/evidence/2026-10-03-arm-localize-baseline/arm-board/arm_localize/benchmark/run-nph60lvw/720p_six/input.json)<br>结构化结果/元数据 · 已纳入Git（含暂存） | 保存input的输入/设备/运行元数据，字段包括具体字段；与data/evidence/2026-10-03-arm-localize-baseline/arm-board/arm_localize/README.md中的生成/校验流程一起使用。 | 所在目录说明：[data/evidence/2026-10-03-arm-localize-baseline/arm-board/arm_localize/README.md](../../../data/evidence/2026-10-03-arm-localize-baseline/arm-board/arm_localize/README.md) |
| **data/evidence/2026-10-03-arm-localize-baseline/arm-board/arm_localize/benchmark/run-nph60lvw/720p_six/sample-00-crops-e1pwoeec** | | |
| [data/evidence/2026-10-03-arm-localize-baseline/arm-board/arm_localize/benchmark/run-nph60lvw/720p_six/sample-00-crops-e1pwoeec/target_000.hex](../../../data/evidence/2026-10-03-arm-localize-baseline/arm-board/arm_localize/benchmark/run-nph60lvw/720p_six/sample-00-crops-e1pwoeec/target_000.hex)<br>十六进制数据 · 已纳入Git（含暂存） | 以十六进制数据形式保存target_000的目标ROI像素；由对应加载器/testbench读取，位宽、排布和端序按data/evidence/2026-10-03-arm-localize-baseline/arm-board/arm_localize/README.md核对。 | 所在目录说明：[data/evidence/2026-10-03-arm-localize-baseline/arm-board/arm_localize/README.md](../../../data/evidence/2026-10-03-arm-localize-baseline/arm-board/arm_localize/README.md)<br>同名配套文件：[data/evidence/2026-10-03-arm-localize-baseline/arm-board/arm_localize/benchmark/run-nph60lvw/720p_six/sample-00-crops-e1pwoeec/target_000.pgm](../../../data/evidence/2026-10-03-arm-localize-baseline/arm-board/arm_localize/benchmark/run-nph60lvw/720p_six/sample-00-crops-e1pwoeec/target_000.pgm) |
| [data/evidence/2026-10-03-arm-localize-baseline/arm-board/arm_localize/benchmark/run-nph60lvw/720p_six/sample-00-crops-e1pwoeec/target_000.pgm](../../../data/evidence/2026-10-03-arm-localize-baseline/arm-board/arm_localize/benchmark/run-nph60lvw/720p_six/sample-00-crops-e1pwoeec/target_000.pgm)<br>灰度像素图 · 已纳入Git（含暂存） | 保存target_000的目标ROI裁剪；其合成/文件/实机来源及框/标签含义以data/evidence/2026-10-03-arm-localize-baseline/arm-board/arm_localize/README.md为准。 | 所在目录说明：[data/evidence/2026-10-03-arm-localize-baseline/arm-board/arm_localize/README.md](../../../data/evidence/2026-10-03-arm-localize-baseline/arm-board/arm_localize/README.md)<br>同名配套文件：[data/evidence/2026-10-03-arm-localize-baseline/arm-board/arm_localize/benchmark/run-nph60lvw/720p_six/sample-00-crops-e1pwoeec/target_000.hex](../../../data/evidence/2026-10-03-arm-localize-baseline/arm-board/arm_localize/benchmark/run-nph60lvw/720p_six/sample-00-crops-e1pwoeec/target_000.hex) |
| [data/evidence/2026-10-03-arm-localize-baseline/arm-board/arm_localize/benchmark/run-nph60lvw/720p_six/sample-00-crops-e1pwoeec/target_001.hex](../../../data/evidence/2026-10-03-arm-localize-baseline/arm-board/arm_localize/benchmark/run-nph60lvw/720p_six/sample-00-crops-e1pwoeec/target_001.hex)<br>十六进制数据 · 已纳入Git（含暂存） | 以十六进制数据形式保存target_001的目标ROI像素；由对应加载器/testbench读取，位宽、排布和端序按data/evidence/2026-10-03-arm-localize-baseline/arm-board/arm_localize/README.md核对。 | 所在目录说明：[data/evidence/2026-10-03-arm-localize-baseline/arm-board/arm_localize/README.md](../../../data/evidence/2026-10-03-arm-localize-baseline/arm-board/arm_localize/README.md)<br>同名配套文件：[data/evidence/2026-10-03-arm-localize-baseline/arm-board/arm_localize/benchmark/run-nph60lvw/720p_six/sample-00-crops-e1pwoeec/target_001.pgm](../../../data/evidence/2026-10-03-arm-localize-baseline/arm-board/arm_localize/benchmark/run-nph60lvw/720p_six/sample-00-crops-e1pwoeec/target_001.pgm) |
| [data/evidence/2026-10-03-arm-localize-baseline/arm-board/arm_localize/benchmark/run-nph60lvw/720p_six/sample-00-crops-e1pwoeec/target_001.pgm](../../../data/evidence/2026-10-03-arm-localize-baseline/arm-board/arm_localize/benchmark/run-nph60lvw/720p_six/sample-00-crops-e1pwoeec/target_001.pgm)<br>灰度像素图 · 已纳入Git（含暂存） | 保存target_001的目标ROI裁剪；其合成/文件/实机来源及框/标签含义以data/evidence/2026-10-03-arm-localize-baseline/arm-board/arm_localize/README.md为准。 | 所在目录说明：[data/evidence/2026-10-03-arm-localize-baseline/arm-board/arm_localize/README.md](../../../data/evidence/2026-10-03-arm-localize-baseline/arm-board/arm_localize/README.md)<br>同名配套文件：[data/evidence/2026-10-03-arm-localize-baseline/arm-board/arm_localize/benchmark/run-nph60lvw/720p_six/sample-00-crops-e1pwoeec/target_001.hex](../../../data/evidence/2026-10-03-arm-localize-baseline/arm-board/arm_localize/benchmark/run-nph60lvw/720p_six/sample-00-crops-e1pwoeec/target_001.hex) |
| [data/evidence/2026-10-03-arm-localize-baseline/arm-board/arm_localize/benchmark/run-nph60lvw/720p_six/sample-00-crops-e1pwoeec/target_002.hex](../../../data/evidence/2026-10-03-arm-localize-baseline/arm-board/arm_localize/benchmark/run-nph60lvw/720p_six/sample-00-crops-e1pwoeec/target_002.hex)<br>十六进制数据 · 已纳入Git（含暂存） | 以十六进制数据形式保存target_002的目标ROI像素；由对应加载器/testbench读取，位宽、排布和端序按data/evidence/2026-10-03-arm-localize-baseline/arm-board/arm_localize/README.md核对。 | 所在目录说明：[data/evidence/2026-10-03-arm-localize-baseline/arm-board/arm_localize/README.md](../../../data/evidence/2026-10-03-arm-localize-baseline/arm-board/arm_localize/README.md)<br>同名配套文件：[data/evidence/2026-10-03-arm-localize-baseline/arm-board/arm_localize/benchmark/run-nph60lvw/720p_six/sample-00-crops-e1pwoeec/target_002.pgm](../../../data/evidence/2026-10-03-arm-localize-baseline/arm-board/arm_localize/benchmark/run-nph60lvw/720p_six/sample-00-crops-e1pwoeec/target_002.pgm) |
| [data/evidence/2026-10-03-arm-localize-baseline/arm-board/arm_localize/benchmark/run-nph60lvw/720p_six/sample-00-crops-e1pwoeec/target_002.pgm](../../../data/evidence/2026-10-03-arm-localize-baseline/arm-board/arm_localize/benchmark/run-nph60lvw/720p_six/sample-00-crops-e1pwoeec/target_002.pgm)<br>灰度像素图 · 已纳入Git（含暂存） | 保存target_002的目标ROI裁剪；其合成/文件/实机来源及框/标签含义以data/evidence/2026-10-03-arm-localize-baseline/arm-board/arm_localize/README.md为准。 | 所在目录说明：[data/evidence/2026-10-03-arm-localize-baseline/arm-board/arm_localize/README.md](../../../data/evidence/2026-10-03-arm-localize-baseline/arm-board/arm_localize/README.md)<br>同名配套文件：[data/evidence/2026-10-03-arm-localize-baseline/arm-board/arm_localize/benchmark/run-nph60lvw/720p_six/sample-00-crops-e1pwoeec/target_002.hex](../../../data/evidence/2026-10-03-arm-localize-baseline/arm-board/arm_localize/benchmark/run-nph60lvw/720p_six/sample-00-crops-e1pwoeec/target_002.hex) |
| [data/evidence/2026-10-03-arm-localize-baseline/arm-board/arm_localize/benchmark/run-nph60lvw/720p_six/sample-00-crops-e1pwoeec/target_003.hex](../../../data/evidence/2026-10-03-arm-localize-baseline/arm-board/arm_localize/benchmark/run-nph60lvw/720p_six/sample-00-crops-e1pwoeec/target_003.hex)<br>十六进制数据 · 已纳入Git（含暂存） | 以十六进制数据形式保存target_003的目标ROI像素；由对应加载器/testbench读取，位宽、排布和端序按data/evidence/2026-10-03-arm-localize-baseline/arm-board/arm_localize/README.md核对。 | 所在目录说明：[data/evidence/2026-10-03-arm-localize-baseline/arm-board/arm_localize/README.md](../../../data/evidence/2026-10-03-arm-localize-baseline/arm-board/arm_localize/README.md)<br>同名配套文件：[data/evidence/2026-10-03-arm-localize-baseline/arm-board/arm_localize/benchmark/run-nph60lvw/720p_six/sample-00-crops-e1pwoeec/target_003.pgm](../../../data/evidence/2026-10-03-arm-localize-baseline/arm-board/arm_localize/benchmark/run-nph60lvw/720p_six/sample-00-crops-e1pwoeec/target_003.pgm) |
| [data/evidence/2026-10-03-arm-localize-baseline/arm-board/arm_localize/benchmark/run-nph60lvw/720p_six/sample-00-crops-e1pwoeec/target_003.pgm](../../../data/evidence/2026-10-03-arm-localize-baseline/arm-board/arm_localize/benchmark/run-nph60lvw/720p_six/sample-00-crops-e1pwoeec/target_003.pgm)<br>灰度像素图 · 已纳入Git（含暂存） | 保存target_003的目标ROI裁剪；其合成/文件/实机来源及框/标签含义以data/evidence/2026-10-03-arm-localize-baseline/arm-board/arm_localize/README.md为准。 | 所在目录说明：[data/evidence/2026-10-03-arm-localize-baseline/arm-board/arm_localize/README.md](../../../data/evidence/2026-10-03-arm-localize-baseline/arm-board/arm_localize/README.md)<br>同名配套文件：[data/evidence/2026-10-03-arm-localize-baseline/arm-board/arm_localize/benchmark/run-nph60lvw/720p_six/sample-00-crops-e1pwoeec/target_003.hex](../../../data/evidence/2026-10-03-arm-localize-baseline/arm-board/arm_localize/benchmark/run-nph60lvw/720p_six/sample-00-crops-e1pwoeec/target_003.hex) |
| [data/evidence/2026-10-03-arm-localize-baseline/arm-board/arm_localize/benchmark/run-nph60lvw/720p_six/sample-00-crops-e1pwoeec/target_004.hex](../../../data/evidence/2026-10-03-arm-localize-baseline/arm-board/arm_localize/benchmark/run-nph60lvw/720p_six/sample-00-crops-e1pwoeec/target_004.hex)<br>十六进制数据 · 已纳入Git（含暂存） | 以十六进制数据形式保存target_004的目标ROI像素；由对应加载器/testbench读取，位宽、排布和端序按data/evidence/2026-10-03-arm-localize-baseline/arm-board/arm_localize/README.md核对。 | 所在目录说明：[data/evidence/2026-10-03-arm-localize-baseline/arm-board/arm_localize/README.md](../../../data/evidence/2026-10-03-arm-localize-baseline/arm-board/arm_localize/README.md)<br>同名配套文件：[data/evidence/2026-10-03-arm-localize-baseline/arm-board/arm_localize/benchmark/run-nph60lvw/720p_six/sample-00-crops-e1pwoeec/target_004.pgm](../../../data/evidence/2026-10-03-arm-localize-baseline/arm-board/arm_localize/benchmark/run-nph60lvw/720p_six/sample-00-crops-e1pwoeec/target_004.pgm) |
| [data/evidence/2026-10-03-arm-localize-baseline/arm-board/arm_localize/benchmark/run-nph60lvw/720p_six/sample-00-crops-e1pwoeec/target_004.pgm](../../../data/evidence/2026-10-03-arm-localize-baseline/arm-board/arm_localize/benchmark/run-nph60lvw/720p_six/sample-00-crops-e1pwoeec/target_004.pgm)<br>灰度像素图 · 已纳入Git（含暂存） | 保存target_004的目标ROI裁剪；其合成/文件/实机来源及框/标签含义以data/evidence/2026-10-03-arm-localize-baseline/arm-board/arm_localize/README.md为准。 | 所在目录说明：[data/evidence/2026-10-03-arm-localize-baseline/arm-board/arm_localize/README.md](../../../data/evidence/2026-10-03-arm-localize-baseline/arm-board/arm_localize/README.md)<br>同名配套文件：[data/evidence/2026-10-03-arm-localize-baseline/arm-board/arm_localize/benchmark/run-nph60lvw/720p_six/sample-00-crops-e1pwoeec/target_004.hex](../../../data/evidence/2026-10-03-arm-localize-baseline/arm-board/arm_localize/benchmark/run-nph60lvw/720p_six/sample-00-crops-e1pwoeec/target_004.hex) |
| [data/evidence/2026-10-03-arm-localize-baseline/arm-board/arm_localize/benchmark/run-nph60lvw/720p_six/sample-00-crops-e1pwoeec/target_005.hex](../../../data/evidence/2026-10-03-arm-localize-baseline/arm-board/arm_localize/benchmark/run-nph60lvw/720p_six/sample-00-crops-e1pwoeec/target_005.hex)<br>十六进制数据 · 已纳入Git（含暂存） | 以十六进制数据形式保存target_005的目标ROI像素；由对应加载器/testbench读取，位宽、排布和端序按data/evidence/2026-10-03-arm-localize-baseline/arm-board/arm_localize/README.md核对。 | 所在目录说明：[data/evidence/2026-10-03-arm-localize-baseline/arm-board/arm_localize/README.md](../../../data/evidence/2026-10-03-arm-localize-baseline/arm-board/arm_localize/README.md)<br>同名配套文件：[data/evidence/2026-10-03-arm-localize-baseline/arm-board/arm_localize/benchmark/run-nph60lvw/720p_six/sample-00-crops-e1pwoeec/target_005.pgm](../../../data/evidence/2026-10-03-arm-localize-baseline/arm-board/arm_localize/benchmark/run-nph60lvw/720p_six/sample-00-crops-e1pwoeec/target_005.pgm) |
| [data/evidence/2026-10-03-arm-localize-baseline/arm-board/arm_localize/benchmark/run-nph60lvw/720p_six/sample-00-crops-e1pwoeec/target_005.pgm](../../../data/evidence/2026-10-03-arm-localize-baseline/arm-board/arm_localize/benchmark/run-nph60lvw/720p_six/sample-00-crops-e1pwoeec/target_005.pgm)<br>灰度像素图 · 已纳入Git（含暂存） | 保存target_005的目标ROI裁剪；其合成/文件/实机来源及框/标签含义以data/evidence/2026-10-03-arm-localize-baseline/arm-board/arm_localize/README.md为准。 | 所在目录说明：[data/evidence/2026-10-03-arm-localize-baseline/arm-board/arm_localize/README.md](../../../data/evidence/2026-10-03-arm-localize-baseline/arm-board/arm_localize/README.md)<br>同名配套文件：[data/evidence/2026-10-03-arm-localize-baseline/arm-board/arm_localize/benchmark/run-nph60lvw/720p_six/sample-00-crops-e1pwoeec/target_005.hex](../../../data/evidence/2026-10-03-arm-localize-baseline/arm-board/arm_localize/benchmark/run-nph60lvw/720p_six/sample-00-crops-e1pwoeec/target_005.hex) |
| **data/evidence/2026-10-03-arm-localize-baseline/arm-board/arm_localize/benchmark/run-nph60lvw/720p_six** | | |
| [data/evidence/2026-10-03-arm-localize-baseline/arm-board/arm_localize/benchmark/run-nph60lvw/720p_six/sample-00.json](../../../data/evidence/2026-10-03-arm-localize-baseline/arm-board/arm_localize/benchmark/run-nph60lvw/720p_six/sample-00.json)<br>结构化结果/元数据 · 已纳入Git（含暂存） | 保存sample-00的实验结果或检查产物，字段包括frame_id、config_id、width、height、status、targets、schema_version；与data/evidence/2026-10-03-arm-localize-baseline/arm-board/arm_localize/README.md中的生成/校验流程一起使用。 | 所在目录说明：[data/evidence/2026-10-03-arm-localize-baseline/arm-board/arm_localize/README.md](../../../data/evidence/2026-10-03-arm-localize-baseline/arm-board/arm_localize/README.md)<br>同目录输入/元数据：[data/evidence/2026-10-03-arm-localize-baseline/arm-board/arm_localize/benchmark/run-nph60lvw/720p_six/input.json](../../../data/evidence/2026-10-03-arm-localize-baseline/arm-board/arm_localize/benchmark/run-nph60lvw/720p_six/input.json) |
| **data/evidence/2026-10-03-arm-localize-baseline/arm-board/arm_localize/benchmark/run-nph60lvw/720p_six/sample-01-crops-opnj7fw1** | | |
| [data/evidence/2026-10-03-arm-localize-baseline/arm-board/arm_localize/benchmark/run-nph60lvw/720p_six/sample-01-crops-opnj7fw1/target_000.hex](../../../data/evidence/2026-10-03-arm-localize-baseline/arm-board/arm_localize/benchmark/run-nph60lvw/720p_six/sample-01-crops-opnj7fw1/target_000.hex)<br>十六进制数据 · 已纳入Git（含暂存） | 以十六进制数据形式保存target_000的目标ROI像素；由对应加载器/testbench读取，位宽、排布和端序按data/evidence/2026-10-03-arm-localize-baseline/arm-board/arm_localize/README.md核对。 | 所在目录说明：[data/evidence/2026-10-03-arm-localize-baseline/arm-board/arm_localize/README.md](../../../data/evidence/2026-10-03-arm-localize-baseline/arm-board/arm_localize/README.md)<br>同名配套文件：[data/evidence/2026-10-03-arm-localize-baseline/arm-board/arm_localize/benchmark/run-nph60lvw/720p_six/sample-01-crops-opnj7fw1/target_000.pgm](../../../data/evidence/2026-10-03-arm-localize-baseline/arm-board/arm_localize/benchmark/run-nph60lvw/720p_six/sample-01-crops-opnj7fw1/target_000.pgm) |
| [data/evidence/2026-10-03-arm-localize-baseline/arm-board/arm_localize/benchmark/run-nph60lvw/720p_six/sample-01-crops-opnj7fw1/target_000.pgm](../../../data/evidence/2026-10-03-arm-localize-baseline/arm-board/arm_localize/benchmark/run-nph60lvw/720p_six/sample-01-crops-opnj7fw1/target_000.pgm)<br>灰度像素图 · 已纳入Git（含暂存） | 保存target_000的目标ROI裁剪；其合成/文件/实机来源及框/标签含义以data/evidence/2026-10-03-arm-localize-baseline/arm-board/arm_localize/README.md为准。 | 所在目录说明：[data/evidence/2026-10-03-arm-localize-baseline/arm-board/arm_localize/README.md](../../../data/evidence/2026-10-03-arm-localize-baseline/arm-board/arm_localize/README.md)<br>同名配套文件：[data/evidence/2026-10-03-arm-localize-baseline/arm-board/arm_localize/benchmark/run-nph60lvw/720p_six/sample-01-crops-opnj7fw1/target_000.hex](../../../data/evidence/2026-10-03-arm-localize-baseline/arm-board/arm_localize/benchmark/run-nph60lvw/720p_six/sample-01-crops-opnj7fw1/target_000.hex) |
| [data/evidence/2026-10-03-arm-localize-baseline/arm-board/arm_localize/benchmark/run-nph60lvw/720p_six/sample-01-crops-opnj7fw1/target_001.hex](../../../data/evidence/2026-10-03-arm-localize-baseline/arm-board/arm_localize/benchmark/run-nph60lvw/720p_six/sample-01-crops-opnj7fw1/target_001.hex)<br>十六进制数据 · 已纳入Git（含暂存） | 以十六进制数据形式保存target_001的目标ROI像素；由对应加载器/testbench读取，位宽、排布和端序按data/evidence/2026-10-03-arm-localize-baseline/arm-board/arm_localize/README.md核对。 | 所在目录说明：[data/evidence/2026-10-03-arm-localize-baseline/arm-board/arm_localize/README.md](../../../data/evidence/2026-10-03-arm-localize-baseline/arm-board/arm_localize/README.md)<br>同名配套文件：[data/evidence/2026-10-03-arm-localize-baseline/arm-board/arm_localize/benchmark/run-nph60lvw/720p_six/sample-01-crops-opnj7fw1/target_001.pgm](../../../data/evidence/2026-10-03-arm-localize-baseline/arm-board/arm_localize/benchmark/run-nph60lvw/720p_six/sample-01-crops-opnj7fw1/target_001.pgm) |
| [data/evidence/2026-10-03-arm-localize-baseline/arm-board/arm_localize/benchmark/run-nph60lvw/720p_six/sample-01-crops-opnj7fw1/target_001.pgm](../../../data/evidence/2026-10-03-arm-localize-baseline/arm-board/arm_localize/benchmark/run-nph60lvw/720p_six/sample-01-crops-opnj7fw1/target_001.pgm)<br>灰度像素图 · 已纳入Git（含暂存） | 保存target_001的目标ROI裁剪；其合成/文件/实机来源及框/标签含义以data/evidence/2026-10-03-arm-localize-baseline/arm-board/arm_localize/README.md为准。 | 所在目录说明：[data/evidence/2026-10-03-arm-localize-baseline/arm-board/arm_localize/README.md](../../../data/evidence/2026-10-03-arm-localize-baseline/arm-board/arm_localize/README.md)<br>同名配套文件：[data/evidence/2026-10-03-arm-localize-baseline/arm-board/arm_localize/benchmark/run-nph60lvw/720p_six/sample-01-crops-opnj7fw1/target_001.hex](../../../data/evidence/2026-10-03-arm-localize-baseline/arm-board/arm_localize/benchmark/run-nph60lvw/720p_six/sample-01-crops-opnj7fw1/target_001.hex) |
| [data/evidence/2026-10-03-arm-localize-baseline/arm-board/arm_localize/benchmark/run-nph60lvw/720p_six/sample-01-crops-opnj7fw1/target_002.hex](../../../data/evidence/2026-10-03-arm-localize-baseline/arm-board/arm_localize/benchmark/run-nph60lvw/720p_six/sample-01-crops-opnj7fw1/target_002.hex)<br>十六进制数据 · 已纳入Git（含暂存） | 以十六进制数据形式保存target_002的目标ROI像素；由对应加载器/testbench读取，位宽、排布和端序按data/evidence/2026-10-03-arm-localize-baseline/arm-board/arm_localize/README.md核对。 | 所在目录说明：[data/evidence/2026-10-03-arm-localize-baseline/arm-board/arm_localize/README.md](../../../data/evidence/2026-10-03-arm-localize-baseline/arm-board/arm_localize/README.md)<br>同名配套文件：[data/evidence/2026-10-03-arm-localize-baseline/arm-board/arm_localize/benchmark/run-nph60lvw/720p_six/sample-01-crops-opnj7fw1/target_002.pgm](../../../data/evidence/2026-10-03-arm-localize-baseline/arm-board/arm_localize/benchmark/run-nph60lvw/720p_six/sample-01-crops-opnj7fw1/target_002.pgm) |
| [data/evidence/2026-10-03-arm-localize-baseline/arm-board/arm_localize/benchmark/run-nph60lvw/720p_six/sample-01-crops-opnj7fw1/target_002.pgm](../../../data/evidence/2026-10-03-arm-localize-baseline/arm-board/arm_localize/benchmark/run-nph60lvw/720p_six/sample-01-crops-opnj7fw1/target_002.pgm)<br>灰度像素图 · 已纳入Git（含暂存） | 保存target_002的目标ROI裁剪；其合成/文件/实机来源及框/标签含义以data/evidence/2026-10-03-arm-localize-baseline/arm-board/arm_localize/README.md为准。 | 所在目录说明：[data/evidence/2026-10-03-arm-localize-baseline/arm-board/arm_localize/README.md](../../../data/evidence/2026-10-03-arm-localize-baseline/arm-board/arm_localize/README.md)<br>同名配套文件：[data/evidence/2026-10-03-arm-localize-baseline/arm-board/arm_localize/benchmark/run-nph60lvw/720p_six/sample-01-crops-opnj7fw1/target_002.hex](../../../data/evidence/2026-10-03-arm-localize-baseline/arm-board/arm_localize/benchmark/run-nph60lvw/720p_six/sample-01-crops-opnj7fw1/target_002.hex) |
| [data/evidence/2026-10-03-arm-localize-baseline/arm-board/arm_localize/benchmark/run-nph60lvw/720p_six/sample-01-crops-opnj7fw1/target_003.hex](../../../data/evidence/2026-10-03-arm-localize-baseline/arm-board/arm_localize/benchmark/run-nph60lvw/720p_six/sample-01-crops-opnj7fw1/target_003.hex)<br>十六进制数据 · 已纳入Git（含暂存） | 以十六进制数据形式保存target_003的目标ROI像素；由对应加载器/testbench读取，位宽、排布和端序按data/evidence/2026-10-03-arm-localize-baseline/arm-board/arm_localize/README.md核对。 | 所在目录说明：[data/evidence/2026-10-03-arm-localize-baseline/arm-board/arm_localize/README.md](../../../data/evidence/2026-10-03-arm-localize-baseline/arm-board/arm_localize/README.md)<br>同名配套文件：[data/evidence/2026-10-03-arm-localize-baseline/arm-board/arm_localize/benchmark/run-nph60lvw/720p_six/sample-01-crops-opnj7fw1/target_003.pgm](../../../data/evidence/2026-10-03-arm-localize-baseline/arm-board/arm_localize/benchmark/run-nph60lvw/720p_six/sample-01-crops-opnj7fw1/target_003.pgm) |
| [data/evidence/2026-10-03-arm-localize-baseline/arm-board/arm_localize/benchmark/run-nph60lvw/720p_six/sample-01-crops-opnj7fw1/target_003.pgm](../../../data/evidence/2026-10-03-arm-localize-baseline/arm-board/arm_localize/benchmark/run-nph60lvw/720p_six/sample-01-crops-opnj7fw1/target_003.pgm)<br>灰度像素图 · 已纳入Git（含暂存） | 保存target_003的目标ROI裁剪；其合成/文件/实机来源及框/标签含义以data/evidence/2026-10-03-arm-localize-baseline/arm-board/arm_localize/README.md为准。 | 所在目录说明：[data/evidence/2026-10-03-arm-localize-baseline/arm-board/arm_localize/README.md](../../../data/evidence/2026-10-03-arm-localize-baseline/arm-board/arm_localize/README.md)<br>同名配套文件：[data/evidence/2026-10-03-arm-localize-baseline/arm-board/arm_localize/benchmark/run-nph60lvw/720p_six/sample-01-crops-opnj7fw1/target_003.hex](../../../data/evidence/2026-10-03-arm-localize-baseline/arm-board/arm_localize/benchmark/run-nph60lvw/720p_six/sample-01-crops-opnj7fw1/target_003.hex) |
| [data/evidence/2026-10-03-arm-localize-baseline/arm-board/arm_localize/benchmark/run-nph60lvw/720p_six/sample-01-crops-opnj7fw1/target_004.hex](../../../data/evidence/2026-10-03-arm-localize-baseline/arm-board/arm_localize/benchmark/run-nph60lvw/720p_six/sample-01-crops-opnj7fw1/target_004.hex)<br>十六进制数据 · 已纳入Git（含暂存） | 以十六进制数据形式保存target_004的目标ROI像素；由对应加载器/testbench读取，位宽、排布和端序按data/evidence/2026-10-03-arm-localize-baseline/arm-board/arm_localize/README.md核对。 | 所在目录说明：[data/evidence/2026-10-03-arm-localize-baseline/arm-board/arm_localize/README.md](../../../data/evidence/2026-10-03-arm-localize-baseline/arm-board/arm_localize/README.md)<br>同名配套文件：[data/evidence/2026-10-03-arm-localize-baseline/arm-board/arm_localize/benchmark/run-nph60lvw/720p_six/sample-01-crops-opnj7fw1/target_004.pgm](../../../data/evidence/2026-10-03-arm-localize-baseline/arm-board/arm_localize/benchmark/run-nph60lvw/720p_six/sample-01-crops-opnj7fw1/target_004.pgm) |
| [data/evidence/2026-10-03-arm-localize-baseline/arm-board/arm_localize/benchmark/run-nph60lvw/720p_six/sample-01-crops-opnj7fw1/target_004.pgm](../../../data/evidence/2026-10-03-arm-localize-baseline/arm-board/arm_localize/benchmark/run-nph60lvw/720p_six/sample-01-crops-opnj7fw1/target_004.pgm)<br>灰度像素图 · 已纳入Git（含暂存） | 保存target_004的目标ROI裁剪；其合成/文件/实机来源及框/标签含义以data/evidence/2026-10-03-arm-localize-baseline/arm-board/arm_localize/README.md为准。 | 所在目录说明：[data/evidence/2026-10-03-arm-localize-baseline/arm-board/arm_localize/README.md](../../../data/evidence/2026-10-03-arm-localize-baseline/arm-board/arm_localize/README.md)<br>同名配套文件：[data/evidence/2026-10-03-arm-localize-baseline/arm-board/arm_localize/benchmark/run-nph60lvw/720p_six/sample-01-crops-opnj7fw1/target_004.hex](../../../data/evidence/2026-10-03-arm-localize-baseline/arm-board/arm_localize/benchmark/run-nph60lvw/720p_six/sample-01-crops-opnj7fw1/target_004.hex) |
| [data/evidence/2026-10-03-arm-localize-baseline/arm-board/arm_localize/benchmark/run-nph60lvw/720p_six/sample-01-crops-opnj7fw1/target_005.hex](../../../data/evidence/2026-10-03-arm-localize-baseline/arm-board/arm_localize/benchmark/run-nph60lvw/720p_six/sample-01-crops-opnj7fw1/target_005.hex)<br>十六进制数据 · 已纳入Git（含暂存） | 以十六进制数据形式保存target_005的目标ROI像素；由对应加载器/testbench读取，位宽、排布和端序按data/evidence/2026-10-03-arm-localize-baseline/arm-board/arm_localize/README.md核对。 | 所在目录说明：[data/evidence/2026-10-03-arm-localize-baseline/arm-board/arm_localize/README.md](../../../data/evidence/2026-10-03-arm-localize-baseline/arm-board/arm_localize/README.md)<br>同名配套文件：[data/evidence/2026-10-03-arm-localize-baseline/arm-board/arm_localize/benchmark/run-nph60lvw/720p_six/sample-01-crops-opnj7fw1/target_005.pgm](../../../data/evidence/2026-10-03-arm-localize-baseline/arm-board/arm_localize/benchmark/run-nph60lvw/720p_six/sample-01-crops-opnj7fw1/target_005.pgm) |
| [data/evidence/2026-10-03-arm-localize-baseline/arm-board/arm_localize/benchmark/run-nph60lvw/720p_six/sample-01-crops-opnj7fw1/target_005.pgm](../../../data/evidence/2026-10-03-arm-localize-baseline/arm-board/arm_localize/benchmark/run-nph60lvw/720p_six/sample-01-crops-opnj7fw1/target_005.pgm)<br>灰度像素图 · 已纳入Git（含暂存） | 保存target_005的目标ROI裁剪；其合成/文件/实机来源及框/标签含义以data/evidence/2026-10-03-arm-localize-baseline/arm-board/arm_localize/README.md为准。 | 所在目录说明：[data/evidence/2026-10-03-arm-localize-baseline/arm-board/arm_localize/README.md](../../../data/evidence/2026-10-03-arm-localize-baseline/arm-board/arm_localize/README.md)<br>同名配套文件：[data/evidence/2026-10-03-arm-localize-baseline/arm-board/arm_localize/benchmark/run-nph60lvw/720p_six/sample-01-crops-opnj7fw1/target_005.hex](../../../data/evidence/2026-10-03-arm-localize-baseline/arm-board/arm_localize/benchmark/run-nph60lvw/720p_six/sample-01-crops-opnj7fw1/target_005.hex) |
| **data/evidence/2026-10-03-arm-localize-baseline/arm-board/arm_localize/benchmark/run-nph60lvw/720p_six** | | |
| [data/evidence/2026-10-03-arm-localize-baseline/arm-board/arm_localize/benchmark/run-nph60lvw/720p_six/sample-01.json](../../../data/evidence/2026-10-03-arm-localize-baseline/arm-board/arm_localize/benchmark/run-nph60lvw/720p_six/sample-01.json)<br>结构化结果/元数据 · 已纳入Git（含暂存） | 保存sample-01的实验结果或检查产物，字段包括frame_id、config_id、width、height、status、targets、schema_version；与data/evidence/2026-10-03-arm-localize-baseline/arm-board/arm_localize/README.md中的生成/校验流程一起使用。 | 所在目录说明：[data/evidence/2026-10-03-arm-localize-baseline/arm-board/arm_localize/README.md](../../../data/evidence/2026-10-03-arm-localize-baseline/arm-board/arm_localize/README.md)<br>同目录输入/元数据：[data/evidence/2026-10-03-arm-localize-baseline/arm-board/arm_localize/benchmark/run-nph60lvw/720p_six/input.json](../../../data/evidence/2026-10-03-arm-localize-baseline/arm-board/arm_localize/benchmark/run-nph60lvw/720p_six/input.json) |
| **data/evidence/2026-10-03-arm-localize-baseline/arm-board/arm_localize/benchmark/run-nph60lvw/720p_six/sample-02-crops-6kj5yp92** | | |
| [data/evidence/2026-10-03-arm-localize-baseline/arm-board/arm_localize/benchmark/run-nph60lvw/720p_six/sample-02-crops-6kj5yp92/target_000.hex](../../../data/evidence/2026-10-03-arm-localize-baseline/arm-board/arm_localize/benchmark/run-nph60lvw/720p_six/sample-02-crops-6kj5yp92/target_000.hex)<br>十六进制数据 · 已纳入Git（含暂存） | 以十六进制数据形式保存target_000的目标ROI像素；由对应加载器/testbench读取，位宽、排布和端序按data/evidence/2026-10-03-arm-localize-baseline/arm-board/arm_localize/README.md核对。 | 所在目录说明：[data/evidence/2026-10-03-arm-localize-baseline/arm-board/arm_localize/README.md](../../../data/evidence/2026-10-03-arm-localize-baseline/arm-board/arm_localize/README.md)<br>同名配套文件：[data/evidence/2026-10-03-arm-localize-baseline/arm-board/arm_localize/benchmark/run-nph60lvw/720p_six/sample-02-crops-6kj5yp92/target_000.pgm](../../../data/evidence/2026-10-03-arm-localize-baseline/arm-board/arm_localize/benchmark/run-nph60lvw/720p_six/sample-02-crops-6kj5yp92/target_000.pgm) |
| [data/evidence/2026-10-03-arm-localize-baseline/arm-board/arm_localize/benchmark/run-nph60lvw/720p_six/sample-02-crops-6kj5yp92/target_000.pgm](../../../data/evidence/2026-10-03-arm-localize-baseline/arm-board/arm_localize/benchmark/run-nph60lvw/720p_six/sample-02-crops-6kj5yp92/target_000.pgm)<br>灰度像素图 · 已纳入Git（含暂存） | 保存target_000的目标ROI裁剪；其合成/文件/实机来源及框/标签含义以data/evidence/2026-10-03-arm-localize-baseline/arm-board/arm_localize/README.md为准。 | 所在目录说明：[data/evidence/2026-10-03-arm-localize-baseline/arm-board/arm_localize/README.md](../../../data/evidence/2026-10-03-arm-localize-baseline/arm-board/arm_localize/README.md)<br>同名配套文件：[data/evidence/2026-10-03-arm-localize-baseline/arm-board/arm_localize/benchmark/run-nph60lvw/720p_six/sample-02-crops-6kj5yp92/target_000.hex](../../../data/evidence/2026-10-03-arm-localize-baseline/arm-board/arm_localize/benchmark/run-nph60lvw/720p_six/sample-02-crops-6kj5yp92/target_000.hex) |
| [data/evidence/2026-10-03-arm-localize-baseline/arm-board/arm_localize/benchmark/run-nph60lvw/720p_six/sample-02-crops-6kj5yp92/target_001.hex](../../../data/evidence/2026-10-03-arm-localize-baseline/arm-board/arm_localize/benchmark/run-nph60lvw/720p_six/sample-02-crops-6kj5yp92/target_001.hex)<br>十六进制数据 · 已纳入Git（含暂存） | 以十六进制数据形式保存target_001的目标ROI像素；由对应加载器/testbench读取，位宽、排布和端序按data/evidence/2026-10-03-arm-localize-baseline/arm-board/arm_localize/README.md核对。 | 所在目录说明：[data/evidence/2026-10-03-arm-localize-baseline/arm-board/arm_localize/README.md](../../../data/evidence/2026-10-03-arm-localize-baseline/arm-board/arm_localize/README.md)<br>同名配套文件：[data/evidence/2026-10-03-arm-localize-baseline/arm-board/arm_localize/benchmark/run-nph60lvw/720p_six/sample-02-crops-6kj5yp92/target_001.pgm](../../../data/evidence/2026-10-03-arm-localize-baseline/arm-board/arm_localize/benchmark/run-nph60lvw/720p_six/sample-02-crops-6kj5yp92/target_001.pgm) |
| [data/evidence/2026-10-03-arm-localize-baseline/arm-board/arm_localize/benchmark/run-nph60lvw/720p_six/sample-02-crops-6kj5yp92/target_001.pgm](../../../data/evidence/2026-10-03-arm-localize-baseline/arm-board/arm_localize/benchmark/run-nph60lvw/720p_six/sample-02-crops-6kj5yp92/target_001.pgm)<br>灰度像素图 · 已纳入Git（含暂存） | 保存target_001的目标ROI裁剪；其合成/文件/实机来源及框/标签含义以data/evidence/2026-10-03-arm-localize-baseline/arm-board/arm_localize/README.md为准。 | 所在目录说明：[data/evidence/2026-10-03-arm-localize-baseline/arm-board/arm_localize/README.md](../../../data/evidence/2026-10-03-arm-localize-baseline/arm-board/arm_localize/README.md)<br>同名配套文件：[data/evidence/2026-10-03-arm-localize-baseline/arm-board/arm_localize/benchmark/run-nph60lvw/720p_six/sample-02-crops-6kj5yp92/target_001.hex](../../../data/evidence/2026-10-03-arm-localize-baseline/arm-board/arm_localize/benchmark/run-nph60lvw/720p_six/sample-02-crops-6kj5yp92/target_001.hex) |
| [data/evidence/2026-10-03-arm-localize-baseline/arm-board/arm_localize/benchmark/run-nph60lvw/720p_six/sample-02-crops-6kj5yp92/target_002.hex](../../../data/evidence/2026-10-03-arm-localize-baseline/arm-board/arm_localize/benchmark/run-nph60lvw/720p_six/sample-02-crops-6kj5yp92/target_002.hex)<br>十六进制数据 · 已纳入Git（含暂存） | 以十六进制数据形式保存target_002的目标ROI像素；由对应加载器/testbench读取，位宽、排布和端序按data/evidence/2026-10-03-arm-localize-baseline/arm-board/arm_localize/README.md核对。 | 所在目录说明：[data/evidence/2026-10-03-arm-localize-baseline/arm-board/arm_localize/README.md](../../../data/evidence/2026-10-03-arm-localize-baseline/arm-board/arm_localize/README.md)<br>同名配套文件：[data/evidence/2026-10-03-arm-localize-baseline/arm-board/arm_localize/benchmark/run-nph60lvw/720p_six/sample-02-crops-6kj5yp92/target_002.pgm](../../../data/evidence/2026-10-03-arm-localize-baseline/arm-board/arm_localize/benchmark/run-nph60lvw/720p_six/sample-02-crops-6kj5yp92/target_002.pgm) |
| [data/evidence/2026-10-03-arm-localize-baseline/arm-board/arm_localize/benchmark/run-nph60lvw/720p_six/sample-02-crops-6kj5yp92/target_002.pgm](../../../data/evidence/2026-10-03-arm-localize-baseline/arm-board/arm_localize/benchmark/run-nph60lvw/720p_six/sample-02-crops-6kj5yp92/target_002.pgm)<br>灰度像素图 · 已纳入Git（含暂存） | 保存target_002的目标ROI裁剪；其合成/文件/实机来源及框/标签含义以data/evidence/2026-10-03-arm-localize-baseline/arm-board/arm_localize/README.md为准。 | 所在目录说明：[data/evidence/2026-10-03-arm-localize-baseline/arm-board/arm_localize/README.md](../../../data/evidence/2026-10-03-arm-localize-baseline/arm-board/arm_localize/README.md)<br>同名配套文件：[data/evidence/2026-10-03-arm-localize-baseline/arm-board/arm_localize/benchmark/run-nph60lvw/720p_six/sample-02-crops-6kj5yp92/target_002.hex](../../../data/evidence/2026-10-03-arm-localize-baseline/arm-board/arm_localize/benchmark/run-nph60lvw/720p_six/sample-02-crops-6kj5yp92/target_002.hex) |
| [data/evidence/2026-10-03-arm-localize-baseline/arm-board/arm_localize/benchmark/run-nph60lvw/720p_six/sample-02-crops-6kj5yp92/target_003.hex](../../../data/evidence/2026-10-03-arm-localize-baseline/arm-board/arm_localize/benchmark/run-nph60lvw/720p_six/sample-02-crops-6kj5yp92/target_003.hex)<br>十六进制数据 · 已纳入Git（含暂存） | 以十六进制数据形式保存target_003的目标ROI像素；由对应加载器/testbench读取，位宽、排布和端序按data/evidence/2026-10-03-arm-localize-baseline/arm-board/arm_localize/README.md核对。 | 所在目录说明：[data/evidence/2026-10-03-arm-localize-baseline/arm-board/arm_localize/README.md](../../../data/evidence/2026-10-03-arm-localize-baseline/arm-board/arm_localize/README.md)<br>同名配套文件：[data/evidence/2026-10-03-arm-localize-baseline/arm-board/arm_localize/benchmark/run-nph60lvw/720p_six/sample-02-crops-6kj5yp92/target_003.pgm](../../../data/evidence/2026-10-03-arm-localize-baseline/arm-board/arm_localize/benchmark/run-nph60lvw/720p_six/sample-02-crops-6kj5yp92/target_003.pgm) |
| [data/evidence/2026-10-03-arm-localize-baseline/arm-board/arm_localize/benchmark/run-nph60lvw/720p_six/sample-02-crops-6kj5yp92/target_003.pgm](../../../data/evidence/2026-10-03-arm-localize-baseline/arm-board/arm_localize/benchmark/run-nph60lvw/720p_six/sample-02-crops-6kj5yp92/target_003.pgm)<br>灰度像素图 · 已纳入Git（含暂存） | 保存target_003的目标ROI裁剪；其合成/文件/实机来源及框/标签含义以data/evidence/2026-10-03-arm-localize-baseline/arm-board/arm_localize/README.md为准。 | 所在目录说明：[data/evidence/2026-10-03-arm-localize-baseline/arm-board/arm_localize/README.md](../../../data/evidence/2026-10-03-arm-localize-baseline/arm-board/arm_localize/README.md)<br>同名配套文件：[data/evidence/2026-10-03-arm-localize-baseline/arm-board/arm_localize/benchmark/run-nph60lvw/720p_six/sample-02-crops-6kj5yp92/target_003.hex](../../../data/evidence/2026-10-03-arm-localize-baseline/arm-board/arm_localize/benchmark/run-nph60lvw/720p_six/sample-02-crops-6kj5yp92/target_003.hex) |
| [data/evidence/2026-10-03-arm-localize-baseline/arm-board/arm_localize/benchmark/run-nph60lvw/720p_six/sample-02-crops-6kj5yp92/target_004.hex](../../../data/evidence/2026-10-03-arm-localize-baseline/arm-board/arm_localize/benchmark/run-nph60lvw/720p_six/sample-02-crops-6kj5yp92/target_004.hex)<br>十六进制数据 · 已纳入Git（含暂存） | 以十六进制数据形式保存target_004的目标ROI像素；由对应加载器/testbench读取，位宽、排布和端序按data/evidence/2026-10-03-arm-localize-baseline/arm-board/arm_localize/README.md核对。 | 所在目录说明：[data/evidence/2026-10-03-arm-localize-baseline/arm-board/arm_localize/README.md](../../../data/evidence/2026-10-03-arm-localize-baseline/arm-board/arm_localize/README.md)<br>同名配套文件：[data/evidence/2026-10-03-arm-localize-baseline/arm-board/arm_localize/benchmark/run-nph60lvw/720p_six/sample-02-crops-6kj5yp92/target_004.pgm](../../../data/evidence/2026-10-03-arm-localize-baseline/arm-board/arm_localize/benchmark/run-nph60lvw/720p_six/sample-02-crops-6kj5yp92/target_004.pgm) |
| [data/evidence/2026-10-03-arm-localize-baseline/arm-board/arm_localize/benchmark/run-nph60lvw/720p_six/sample-02-crops-6kj5yp92/target_004.pgm](../../../data/evidence/2026-10-03-arm-localize-baseline/arm-board/arm_localize/benchmark/run-nph60lvw/720p_six/sample-02-crops-6kj5yp92/target_004.pgm)<br>灰度像素图 · 已纳入Git（含暂存） | 保存target_004的目标ROI裁剪；其合成/文件/实机来源及框/标签含义以data/evidence/2026-10-03-arm-localize-baseline/arm-board/arm_localize/README.md为准。 | 所在目录说明：[data/evidence/2026-10-03-arm-localize-baseline/arm-board/arm_localize/README.md](../../../data/evidence/2026-10-03-arm-localize-baseline/arm-board/arm_localize/README.md)<br>同名配套文件：[data/evidence/2026-10-03-arm-localize-baseline/arm-board/arm_localize/benchmark/run-nph60lvw/720p_six/sample-02-crops-6kj5yp92/target_004.hex](../../../data/evidence/2026-10-03-arm-localize-baseline/arm-board/arm_localize/benchmark/run-nph60lvw/720p_six/sample-02-crops-6kj5yp92/target_004.hex) |
| [data/evidence/2026-10-03-arm-localize-baseline/arm-board/arm_localize/benchmark/run-nph60lvw/720p_six/sample-02-crops-6kj5yp92/target_005.hex](../../../data/evidence/2026-10-03-arm-localize-baseline/arm-board/arm_localize/benchmark/run-nph60lvw/720p_six/sample-02-crops-6kj5yp92/target_005.hex)<br>十六进制数据 · 已纳入Git（含暂存） | 以十六进制数据形式保存target_005的目标ROI像素；由对应加载器/testbench读取，位宽、排布和端序按data/evidence/2026-10-03-arm-localize-baseline/arm-board/arm_localize/README.md核对。 | 所在目录说明：[data/evidence/2026-10-03-arm-localize-baseline/arm-board/arm_localize/README.md](../../../data/evidence/2026-10-03-arm-localize-baseline/arm-board/arm_localize/README.md)<br>同名配套文件：[data/evidence/2026-10-03-arm-localize-baseline/arm-board/arm_localize/benchmark/run-nph60lvw/720p_six/sample-02-crops-6kj5yp92/target_005.pgm](../../../data/evidence/2026-10-03-arm-localize-baseline/arm-board/arm_localize/benchmark/run-nph60lvw/720p_six/sample-02-crops-6kj5yp92/target_005.pgm) |
| [data/evidence/2026-10-03-arm-localize-baseline/arm-board/arm_localize/benchmark/run-nph60lvw/720p_six/sample-02-crops-6kj5yp92/target_005.pgm](../../../data/evidence/2026-10-03-arm-localize-baseline/arm-board/arm_localize/benchmark/run-nph60lvw/720p_six/sample-02-crops-6kj5yp92/target_005.pgm)<br>灰度像素图 · 已纳入Git（含暂存） | 保存target_005的目标ROI裁剪；其合成/文件/实机来源及框/标签含义以data/evidence/2026-10-03-arm-localize-baseline/arm-board/arm_localize/README.md为准。 | 所在目录说明：[data/evidence/2026-10-03-arm-localize-baseline/arm-board/arm_localize/README.md](../../../data/evidence/2026-10-03-arm-localize-baseline/arm-board/arm_localize/README.md)<br>同名配套文件：[data/evidence/2026-10-03-arm-localize-baseline/arm-board/arm_localize/benchmark/run-nph60lvw/720p_six/sample-02-crops-6kj5yp92/target_005.hex](../../../data/evidence/2026-10-03-arm-localize-baseline/arm-board/arm_localize/benchmark/run-nph60lvw/720p_six/sample-02-crops-6kj5yp92/target_005.hex) |
| **data/evidence/2026-10-03-arm-localize-baseline/arm-board/arm_localize/benchmark/run-nph60lvw/720p_six** | | |
| [data/evidence/2026-10-03-arm-localize-baseline/arm-board/arm_localize/benchmark/run-nph60lvw/720p_six/sample-02.json](../../../data/evidence/2026-10-03-arm-localize-baseline/arm-board/arm_localize/benchmark/run-nph60lvw/720p_six/sample-02.json)<br>结构化结果/元数据 · 已纳入Git（含暂存） | 保存sample-02的实验结果或检查产物，字段包括frame_id、config_id、width、height、status、targets、schema_version；与data/evidence/2026-10-03-arm-localize-baseline/arm-board/arm_localize/README.md中的生成/校验流程一起使用。 | 所在目录说明：[data/evidence/2026-10-03-arm-localize-baseline/arm-board/arm_localize/README.md](../../../data/evidence/2026-10-03-arm-localize-baseline/arm-board/arm_localize/README.md)<br>同目录输入/元数据：[data/evidence/2026-10-03-arm-localize-baseline/arm-board/arm_localize/benchmark/run-nph60lvw/720p_six/input.json](../../../data/evidence/2026-10-03-arm-localize-baseline/arm-board/arm_localize/benchmark/run-nph60lvw/720p_six/input.json) |
| **data/evidence/2026-10-03-arm-localize-baseline/arm-board/arm_localize/benchmark/run-nph60lvw/720p_six/sample-03-crops-1284icb5** | | |
| [data/evidence/2026-10-03-arm-localize-baseline/arm-board/arm_localize/benchmark/run-nph60lvw/720p_six/sample-03-crops-1284icb5/target_000.hex](../../../data/evidence/2026-10-03-arm-localize-baseline/arm-board/arm_localize/benchmark/run-nph60lvw/720p_six/sample-03-crops-1284icb5/target_000.hex)<br>十六进制数据 · 已纳入Git（含暂存） | 以十六进制数据形式保存target_000的目标ROI像素；由对应加载器/testbench读取，位宽、排布和端序按data/evidence/2026-10-03-arm-localize-baseline/arm-board/arm_localize/README.md核对。 | 所在目录说明：[data/evidence/2026-10-03-arm-localize-baseline/arm-board/arm_localize/README.md](../../../data/evidence/2026-10-03-arm-localize-baseline/arm-board/arm_localize/README.md)<br>同名配套文件：[data/evidence/2026-10-03-arm-localize-baseline/arm-board/arm_localize/benchmark/run-nph60lvw/720p_six/sample-03-crops-1284icb5/target_000.pgm](../../../data/evidence/2026-10-03-arm-localize-baseline/arm-board/arm_localize/benchmark/run-nph60lvw/720p_six/sample-03-crops-1284icb5/target_000.pgm) |
| [data/evidence/2026-10-03-arm-localize-baseline/arm-board/arm_localize/benchmark/run-nph60lvw/720p_six/sample-03-crops-1284icb5/target_000.pgm](../../../data/evidence/2026-10-03-arm-localize-baseline/arm-board/arm_localize/benchmark/run-nph60lvw/720p_six/sample-03-crops-1284icb5/target_000.pgm)<br>灰度像素图 · 已纳入Git（含暂存） | 保存target_000的目标ROI裁剪；其合成/文件/实机来源及框/标签含义以data/evidence/2026-10-03-arm-localize-baseline/arm-board/arm_localize/README.md为准。 | 所在目录说明：[data/evidence/2026-10-03-arm-localize-baseline/arm-board/arm_localize/README.md](../../../data/evidence/2026-10-03-arm-localize-baseline/arm-board/arm_localize/README.md)<br>同名配套文件：[data/evidence/2026-10-03-arm-localize-baseline/arm-board/arm_localize/benchmark/run-nph60lvw/720p_six/sample-03-crops-1284icb5/target_000.hex](../../../data/evidence/2026-10-03-arm-localize-baseline/arm-board/arm_localize/benchmark/run-nph60lvw/720p_six/sample-03-crops-1284icb5/target_000.hex) |
| [data/evidence/2026-10-03-arm-localize-baseline/arm-board/arm_localize/benchmark/run-nph60lvw/720p_six/sample-03-crops-1284icb5/target_001.hex](../../../data/evidence/2026-10-03-arm-localize-baseline/arm-board/arm_localize/benchmark/run-nph60lvw/720p_six/sample-03-crops-1284icb5/target_001.hex)<br>十六进制数据 · 已纳入Git（含暂存） | 以十六进制数据形式保存target_001的目标ROI像素；由对应加载器/testbench读取，位宽、排布和端序按data/evidence/2026-10-03-arm-localize-baseline/arm-board/arm_localize/README.md核对。 | 所在目录说明：[data/evidence/2026-10-03-arm-localize-baseline/arm-board/arm_localize/README.md](../../../data/evidence/2026-10-03-arm-localize-baseline/arm-board/arm_localize/README.md)<br>同名配套文件：[data/evidence/2026-10-03-arm-localize-baseline/arm-board/arm_localize/benchmark/run-nph60lvw/720p_six/sample-03-crops-1284icb5/target_001.pgm](../../../data/evidence/2026-10-03-arm-localize-baseline/arm-board/arm_localize/benchmark/run-nph60lvw/720p_six/sample-03-crops-1284icb5/target_001.pgm) |
| [data/evidence/2026-10-03-arm-localize-baseline/arm-board/arm_localize/benchmark/run-nph60lvw/720p_six/sample-03-crops-1284icb5/target_001.pgm](../../../data/evidence/2026-10-03-arm-localize-baseline/arm-board/arm_localize/benchmark/run-nph60lvw/720p_six/sample-03-crops-1284icb5/target_001.pgm)<br>灰度像素图 · 已纳入Git（含暂存） | 保存target_001的目标ROI裁剪；其合成/文件/实机来源及框/标签含义以data/evidence/2026-10-03-arm-localize-baseline/arm-board/arm_localize/README.md为准。 | 所在目录说明：[data/evidence/2026-10-03-arm-localize-baseline/arm-board/arm_localize/README.md](../../../data/evidence/2026-10-03-arm-localize-baseline/arm-board/arm_localize/README.md)<br>同名配套文件：[data/evidence/2026-10-03-arm-localize-baseline/arm-board/arm_localize/benchmark/run-nph60lvw/720p_six/sample-03-crops-1284icb5/target_001.hex](../../../data/evidence/2026-10-03-arm-localize-baseline/arm-board/arm_localize/benchmark/run-nph60lvw/720p_six/sample-03-crops-1284icb5/target_001.hex) |
| [data/evidence/2026-10-03-arm-localize-baseline/arm-board/arm_localize/benchmark/run-nph60lvw/720p_six/sample-03-crops-1284icb5/target_002.hex](../../../data/evidence/2026-10-03-arm-localize-baseline/arm-board/arm_localize/benchmark/run-nph60lvw/720p_six/sample-03-crops-1284icb5/target_002.hex)<br>十六进制数据 · 已纳入Git（含暂存） | 以十六进制数据形式保存target_002的目标ROI像素；由对应加载器/testbench读取，位宽、排布和端序按data/evidence/2026-10-03-arm-localize-baseline/arm-board/arm_localize/README.md核对。 | 所在目录说明：[data/evidence/2026-10-03-arm-localize-baseline/arm-board/arm_localize/README.md](../../../data/evidence/2026-10-03-arm-localize-baseline/arm-board/arm_localize/README.md)<br>同名配套文件：[data/evidence/2026-10-03-arm-localize-baseline/arm-board/arm_localize/benchmark/run-nph60lvw/720p_six/sample-03-crops-1284icb5/target_002.pgm](../../../data/evidence/2026-10-03-arm-localize-baseline/arm-board/arm_localize/benchmark/run-nph60lvw/720p_six/sample-03-crops-1284icb5/target_002.pgm) |
| [data/evidence/2026-10-03-arm-localize-baseline/arm-board/arm_localize/benchmark/run-nph60lvw/720p_six/sample-03-crops-1284icb5/target_002.pgm](../../../data/evidence/2026-10-03-arm-localize-baseline/arm-board/arm_localize/benchmark/run-nph60lvw/720p_six/sample-03-crops-1284icb5/target_002.pgm)<br>灰度像素图 · 已纳入Git（含暂存） | 保存target_002的目标ROI裁剪；其合成/文件/实机来源及框/标签含义以data/evidence/2026-10-03-arm-localize-baseline/arm-board/arm_localize/README.md为准。 | 所在目录说明：[data/evidence/2026-10-03-arm-localize-baseline/arm-board/arm_localize/README.md](../../../data/evidence/2026-10-03-arm-localize-baseline/arm-board/arm_localize/README.md)<br>同名配套文件：[data/evidence/2026-10-03-arm-localize-baseline/arm-board/arm_localize/benchmark/run-nph60lvw/720p_six/sample-03-crops-1284icb5/target_002.hex](../../../data/evidence/2026-10-03-arm-localize-baseline/arm-board/arm_localize/benchmark/run-nph60lvw/720p_six/sample-03-crops-1284icb5/target_002.hex) |
| [data/evidence/2026-10-03-arm-localize-baseline/arm-board/arm_localize/benchmark/run-nph60lvw/720p_six/sample-03-crops-1284icb5/target_003.hex](../../../data/evidence/2026-10-03-arm-localize-baseline/arm-board/arm_localize/benchmark/run-nph60lvw/720p_six/sample-03-crops-1284icb5/target_003.hex)<br>十六进制数据 · 已纳入Git（含暂存） | 以十六进制数据形式保存target_003的目标ROI像素；由对应加载器/testbench读取，位宽、排布和端序按data/evidence/2026-10-03-arm-localize-baseline/arm-board/arm_localize/README.md核对。 | 所在目录说明：[data/evidence/2026-10-03-arm-localize-baseline/arm-board/arm_localize/README.md](../../../data/evidence/2026-10-03-arm-localize-baseline/arm-board/arm_localize/README.md)<br>同名配套文件：[data/evidence/2026-10-03-arm-localize-baseline/arm-board/arm_localize/benchmark/run-nph60lvw/720p_six/sample-03-crops-1284icb5/target_003.pgm](../../../data/evidence/2026-10-03-arm-localize-baseline/arm-board/arm_localize/benchmark/run-nph60lvw/720p_six/sample-03-crops-1284icb5/target_003.pgm) |
| [data/evidence/2026-10-03-arm-localize-baseline/arm-board/arm_localize/benchmark/run-nph60lvw/720p_six/sample-03-crops-1284icb5/target_003.pgm](../../../data/evidence/2026-10-03-arm-localize-baseline/arm-board/arm_localize/benchmark/run-nph60lvw/720p_six/sample-03-crops-1284icb5/target_003.pgm)<br>灰度像素图 · 已纳入Git（含暂存） | 保存target_003的目标ROI裁剪；其合成/文件/实机来源及框/标签含义以data/evidence/2026-10-03-arm-localize-baseline/arm-board/arm_localize/README.md为准。 | 所在目录说明：[data/evidence/2026-10-03-arm-localize-baseline/arm-board/arm_localize/README.md](../../../data/evidence/2026-10-03-arm-localize-baseline/arm-board/arm_localize/README.md)<br>同名配套文件：[data/evidence/2026-10-03-arm-localize-baseline/arm-board/arm_localize/benchmark/run-nph60lvw/720p_six/sample-03-crops-1284icb5/target_003.hex](../../../data/evidence/2026-10-03-arm-localize-baseline/arm-board/arm_localize/benchmark/run-nph60lvw/720p_six/sample-03-crops-1284icb5/target_003.hex) |
| [data/evidence/2026-10-03-arm-localize-baseline/arm-board/arm_localize/benchmark/run-nph60lvw/720p_six/sample-03-crops-1284icb5/target_004.hex](../../../data/evidence/2026-10-03-arm-localize-baseline/arm-board/arm_localize/benchmark/run-nph60lvw/720p_six/sample-03-crops-1284icb5/target_004.hex)<br>十六进制数据 · 已纳入Git（含暂存） | 以十六进制数据形式保存target_004的目标ROI像素；由对应加载器/testbench读取，位宽、排布和端序按data/evidence/2026-10-03-arm-localize-baseline/arm-board/arm_localize/README.md核对。 | 所在目录说明：[data/evidence/2026-10-03-arm-localize-baseline/arm-board/arm_localize/README.md](../../../data/evidence/2026-10-03-arm-localize-baseline/arm-board/arm_localize/README.md)<br>同名配套文件：[data/evidence/2026-10-03-arm-localize-baseline/arm-board/arm_localize/benchmark/run-nph60lvw/720p_six/sample-03-crops-1284icb5/target_004.pgm](../../../data/evidence/2026-10-03-arm-localize-baseline/arm-board/arm_localize/benchmark/run-nph60lvw/720p_six/sample-03-crops-1284icb5/target_004.pgm) |
| [data/evidence/2026-10-03-arm-localize-baseline/arm-board/arm_localize/benchmark/run-nph60lvw/720p_six/sample-03-crops-1284icb5/target_004.pgm](../../../data/evidence/2026-10-03-arm-localize-baseline/arm-board/arm_localize/benchmark/run-nph60lvw/720p_six/sample-03-crops-1284icb5/target_004.pgm)<br>灰度像素图 · 已纳入Git（含暂存） | 保存target_004的目标ROI裁剪；其合成/文件/实机来源及框/标签含义以data/evidence/2026-10-03-arm-localize-baseline/arm-board/arm_localize/README.md为准。 | 所在目录说明：[data/evidence/2026-10-03-arm-localize-baseline/arm-board/arm_localize/README.md](../../../data/evidence/2026-10-03-arm-localize-baseline/arm-board/arm_localize/README.md)<br>同名配套文件：[data/evidence/2026-10-03-arm-localize-baseline/arm-board/arm_localize/benchmark/run-nph60lvw/720p_six/sample-03-crops-1284icb5/target_004.hex](../../../data/evidence/2026-10-03-arm-localize-baseline/arm-board/arm_localize/benchmark/run-nph60lvw/720p_six/sample-03-crops-1284icb5/target_004.hex) |
| [data/evidence/2026-10-03-arm-localize-baseline/arm-board/arm_localize/benchmark/run-nph60lvw/720p_six/sample-03-crops-1284icb5/target_005.hex](../../../data/evidence/2026-10-03-arm-localize-baseline/arm-board/arm_localize/benchmark/run-nph60lvw/720p_six/sample-03-crops-1284icb5/target_005.hex)<br>十六进制数据 · 已纳入Git（含暂存） | 以十六进制数据形式保存target_005的目标ROI像素；由对应加载器/testbench读取，位宽、排布和端序按data/evidence/2026-10-03-arm-localize-baseline/arm-board/arm_localize/README.md核对。 | 所在目录说明：[data/evidence/2026-10-03-arm-localize-baseline/arm-board/arm_localize/README.md](../../../data/evidence/2026-10-03-arm-localize-baseline/arm-board/arm_localize/README.md)<br>同名配套文件：[data/evidence/2026-10-03-arm-localize-baseline/arm-board/arm_localize/benchmark/run-nph60lvw/720p_six/sample-03-crops-1284icb5/target_005.pgm](../../../data/evidence/2026-10-03-arm-localize-baseline/arm-board/arm_localize/benchmark/run-nph60lvw/720p_six/sample-03-crops-1284icb5/target_005.pgm) |
| [data/evidence/2026-10-03-arm-localize-baseline/arm-board/arm_localize/benchmark/run-nph60lvw/720p_six/sample-03-crops-1284icb5/target_005.pgm](../../../data/evidence/2026-10-03-arm-localize-baseline/arm-board/arm_localize/benchmark/run-nph60lvw/720p_six/sample-03-crops-1284icb5/target_005.pgm)<br>灰度像素图 · 已纳入Git（含暂存） | 保存target_005的目标ROI裁剪；其合成/文件/实机来源及框/标签含义以data/evidence/2026-10-03-arm-localize-baseline/arm-board/arm_localize/README.md为准。 | 所在目录说明：[data/evidence/2026-10-03-arm-localize-baseline/arm-board/arm_localize/README.md](../../../data/evidence/2026-10-03-arm-localize-baseline/arm-board/arm_localize/README.md)<br>同名配套文件：[data/evidence/2026-10-03-arm-localize-baseline/arm-board/arm_localize/benchmark/run-nph60lvw/720p_six/sample-03-crops-1284icb5/target_005.hex](../../../data/evidence/2026-10-03-arm-localize-baseline/arm-board/arm_localize/benchmark/run-nph60lvw/720p_six/sample-03-crops-1284icb5/target_005.hex) |
| **data/evidence/2026-10-03-arm-localize-baseline/arm-board/arm_localize/benchmark/run-nph60lvw/720p_six** | | |
| [data/evidence/2026-10-03-arm-localize-baseline/arm-board/arm_localize/benchmark/run-nph60lvw/720p_six/sample-03.json](../../../data/evidence/2026-10-03-arm-localize-baseline/arm-board/arm_localize/benchmark/run-nph60lvw/720p_six/sample-03.json)<br>结构化结果/元数据 · 已纳入Git（含暂存） | 保存sample-03的实验结果或检查产物，字段包括frame_id、config_id、width、height、status、targets、schema_version；与data/evidence/2026-10-03-arm-localize-baseline/arm-board/arm_localize/README.md中的生成/校验流程一起使用。 | 所在目录说明：[data/evidence/2026-10-03-arm-localize-baseline/arm-board/arm_localize/README.md](../../../data/evidence/2026-10-03-arm-localize-baseline/arm-board/arm_localize/README.md)<br>同目录输入/元数据：[data/evidence/2026-10-03-arm-localize-baseline/arm-board/arm_localize/benchmark/run-nph60lvw/720p_six/input.json](../../../data/evidence/2026-10-03-arm-localize-baseline/arm-board/arm_localize/benchmark/run-nph60lvw/720p_six/input.json) |
| **data/evidence/2026-10-03-arm-localize-baseline/arm-board/arm_localize/benchmark/run-nph60lvw/720p_six/sample-04-crops-gqdpxo9z** | | |
| [data/evidence/2026-10-03-arm-localize-baseline/arm-board/arm_localize/benchmark/run-nph60lvw/720p_six/sample-04-crops-gqdpxo9z/target_000.hex](../../../data/evidence/2026-10-03-arm-localize-baseline/arm-board/arm_localize/benchmark/run-nph60lvw/720p_six/sample-04-crops-gqdpxo9z/target_000.hex)<br>十六进制数据 · 已纳入Git（含暂存） | 以十六进制数据形式保存target_000的目标ROI像素；由对应加载器/testbench读取，位宽、排布和端序按data/evidence/2026-10-03-arm-localize-baseline/arm-board/arm_localize/README.md核对。 | 所在目录说明：[data/evidence/2026-10-03-arm-localize-baseline/arm-board/arm_localize/README.md](../../../data/evidence/2026-10-03-arm-localize-baseline/arm-board/arm_localize/README.md)<br>同名配套文件：[data/evidence/2026-10-03-arm-localize-baseline/arm-board/arm_localize/benchmark/run-nph60lvw/720p_six/sample-04-crops-gqdpxo9z/target_000.pgm](../../../data/evidence/2026-10-03-arm-localize-baseline/arm-board/arm_localize/benchmark/run-nph60lvw/720p_six/sample-04-crops-gqdpxo9z/target_000.pgm) |
| [data/evidence/2026-10-03-arm-localize-baseline/arm-board/arm_localize/benchmark/run-nph60lvw/720p_six/sample-04-crops-gqdpxo9z/target_000.pgm](../../../data/evidence/2026-10-03-arm-localize-baseline/arm-board/arm_localize/benchmark/run-nph60lvw/720p_six/sample-04-crops-gqdpxo9z/target_000.pgm)<br>灰度像素图 · 已纳入Git（含暂存） | 保存target_000的目标ROI裁剪；其合成/文件/实机来源及框/标签含义以data/evidence/2026-10-03-arm-localize-baseline/arm-board/arm_localize/README.md为准。 | 所在目录说明：[data/evidence/2026-10-03-arm-localize-baseline/arm-board/arm_localize/README.md](../../../data/evidence/2026-10-03-arm-localize-baseline/arm-board/arm_localize/README.md)<br>同名配套文件：[data/evidence/2026-10-03-arm-localize-baseline/arm-board/arm_localize/benchmark/run-nph60lvw/720p_six/sample-04-crops-gqdpxo9z/target_000.hex](../../../data/evidence/2026-10-03-arm-localize-baseline/arm-board/arm_localize/benchmark/run-nph60lvw/720p_six/sample-04-crops-gqdpxo9z/target_000.hex) |
| [data/evidence/2026-10-03-arm-localize-baseline/arm-board/arm_localize/benchmark/run-nph60lvw/720p_six/sample-04-crops-gqdpxo9z/target_001.hex](../../../data/evidence/2026-10-03-arm-localize-baseline/arm-board/arm_localize/benchmark/run-nph60lvw/720p_six/sample-04-crops-gqdpxo9z/target_001.hex)<br>十六进制数据 · 已纳入Git（含暂存） | 以十六进制数据形式保存target_001的目标ROI像素；由对应加载器/testbench读取，位宽、排布和端序按data/evidence/2026-10-03-arm-localize-baseline/arm-board/arm_localize/README.md核对。 | 所在目录说明：[data/evidence/2026-10-03-arm-localize-baseline/arm-board/arm_localize/README.md](../../../data/evidence/2026-10-03-arm-localize-baseline/arm-board/arm_localize/README.md)<br>同名配套文件：[data/evidence/2026-10-03-arm-localize-baseline/arm-board/arm_localize/benchmark/run-nph60lvw/720p_six/sample-04-crops-gqdpxo9z/target_001.pgm](../../../data/evidence/2026-10-03-arm-localize-baseline/arm-board/arm_localize/benchmark/run-nph60lvw/720p_six/sample-04-crops-gqdpxo9z/target_001.pgm) |
| [data/evidence/2026-10-03-arm-localize-baseline/arm-board/arm_localize/benchmark/run-nph60lvw/720p_six/sample-04-crops-gqdpxo9z/target_001.pgm](../../../data/evidence/2026-10-03-arm-localize-baseline/arm-board/arm_localize/benchmark/run-nph60lvw/720p_six/sample-04-crops-gqdpxo9z/target_001.pgm)<br>灰度像素图 · 已纳入Git（含暂存） | 保存target_001的目标ROI裁剪；其合成/文件/实机来源及框/标签含义以data/evidence/2026-10-03-arm-localize-baseline/arm-board/arm_localize/README.md为准。 | 所在目录说明：[data/evidence/2026-10-03-arm-localize-baseline/arm-board/arm_localize/README.md](../../../data/evidence/2026-10-03-arm-localize-baseline/arm-board/arm_localize/README.md)<br>同名配套文件：[data/evidence/2026-10-03-arm-localize-baseline/arm-board/arm_localize/benchmark/run-nph60lvw/720p_six/sample-04-crops-gqdpxo9z/target_001.hex](../../../data/evidence/2026-10-03-arm-localize-baseline/arm-board/arm_localize/benchmark/run-nph60lvw/720p_six/sample-04-crops-gqdpxo9z/target_001.hex) |
| [data/evidence/2026-10-03-arm-localize-baseline/arm-board/arm_localize/benchmark/run-nph60lvw/720p_six/sample-04-crops-gqdpxo9z/target_002.hex](../../../data/evidence/2026-10-03-arm-localize-baseline/arm-board/arm_localize/benchmark/run-nph60lvw/720p_six/sample-04-crops-gqdpxo9z/target_002.hex)<br>十六进制数据 · 已纳入Git（含暂存） | 以十六进制数据形式保存target_002的目标ROI像素；由对应加载器/testbench读取，位宽、排布和端序按data/evidence/2026-10-03-arm-localize-baseline/arm-board/arm_localize/README.md核对。 | 所在目录说明：[data/evidence/2026-10-03-arm-localize-baseline/arm-board/arm_localize/README.md](../../../data/evidence/2026-10-03-arm-localize-baseline/arm-board/arm_localize/README.md)<br>同名配套文件：[data/evidence/2026-10-03-arm-localize-baseline/arm-board/arm_localize/benchmark/run-nph60lvw/720p_six/sample-04-crops-gqdpxo9z/target_002.pgm](../../../data/evidence/2026-10-03-arm-localize-baseline/arm-board/arm_localize/benchmark/run-nph60lvw/720p_six/sample-04-crops-gqdpxo9z/target_002.pgm) |
| [data/evidence/2026-10-03-arm-localize-baseline/arm-board/arm_localize/benchmark/run-nph60lvw/720p_six/sample-04-crops-gqdpxo9z/target_002.pgm](../../../data/evidence/2026-10-03-arm-localize-baseline/arm-board/arm_localize/benchmark/run-nph60lvw/720p_six/sample-04-crops-gqdpxo9z/target_002.pgm)<br>灰度像素图 · 已纳入Git（含暂存） | 保存target_002的目标ROI裁剪；其合成/文件/实机来源及框/标签含义以data/evidence/2026-10-03-arm-localize-baseline/arm-board/arm_localize/README.md为准。 | 所在目录说明：[data/evidence/2026-10-03-arm-localize-baseline/arm-board/arm_localize/README.md](../../../data/evidence/2026-10-03-arm-localize-baseline/arm-board/arm_localize/README.md)<br>同名配套文件：[data/evidence/2026-10-03-arm-localize-baseline/arm-board/arm_localize/benchmark/run-nph60lvw/720p_six/sample-04-crops-gqdpxo9z/target_002.hex](../../../data/evidence/2026-10-03-arm-localize-baseline/arm-board/arm_localize/benchmark/run-nph60lvw/720p_six/sample-04-crops-gqdpxo9z/target_002.hex) |
| [data/evidence/2026-10-03-arm-localize-baseline/arm-board/arm_localize/benchmark/run-nph60lvw/720p_six/sample-04-crops-gqdpxo9z/target_003.hex](../../../data/evidence/2026-10-03-arm-localize-baseline/arm-board/arm_localize/benchmark/run-nph60lvw/720p_six/sample-04-crops-gqdpxo9z/target_003.hex)<br>十六进制数据 · 已纳入Git（含暂存） | 以十六进制数据形式保存target_003的目标ROI像素；由对应加载器/testbench读取，位宽、排布和端序按data/evidence/2026-10-03-arm-localize-baseline/arm-board/arm_localize/README.md核对。 | 所在目录说明：[data/evidence/2026-10-03-arm-localize-baseline/arm-board/arm_localize/README.md](../../../data/evidence/2026-10-03-arm-localize-baseline/arm-board/arm_localize/README.md)<br>同名配套文件：[data/evidence/2026-10-03-arm-localize-baseline/arm-board/arm_localize/benchmark/run-nph60lvw/720p_six/sample-04-crops-gqdpxo9z/target_003.pgm](../../../data/evidence/2026-10-03-arm-localize-baseline/arm-board/arm_localize/benchmark/run-nph60lvw/720p_six/sample-04-crops-gqdpxo9z/target_003.pgm) |
| [data/evidence/2026-10-03-arm-localize-baseline/arm-board/arm_localize/benchmark/run-nph60lvw/720p_six/sample-04-crops-gqdpxo9z/target_003.pgm](../../../data/evidence/2026-10-03-arm-localize-baseline/arm-board/arm_localize/benchmark/run-nph60lvw/720p_six/sample-04-crops-gqdpxo9z/target_003.pgm)<br>灰度像素图 · 已纳入Git（含暂存） | 保存target_003的目标ROI裁剪；其合成/文件/实机来源及框/标签含义以data/evidence/2026-10-03-arm-localize-baseline/arm-board/arm_localize/README.md为准。 | 所在目录说明：[data/evidence/2026-10-03-arm-localize-baseline/arm-board/arm_localize/README.md](../../../data/evidence/2026-10-03-arm-localize-baseline/arm-board/arm_localize/README.md)<br>同名配套文件：[data/evidence/2026-10-03-arm-localize-baseline/arm-board/arm_localize/benchmark/run-nph60lvw/720p_six/sample-04-crops-gqdpxo9z/target_003.hex](../../../data/evidence/2026-10-03-arm-localize-baseline/arm-board/arm_localize/benchmark/run-nph60lvw/720p_six/sample-04-crops-gqdpxo9z/target_003.hex) |
| [data/evidence/2026-10-03-arm-localize-baseline/arm-board/arm_localize/benchmark/run-nph60lvw/720p_six/sample-04-crops-gqdpxo9z/target_004.hex](../../../data/evidence/2026-10-03-arm-localize-baseline/arm-board/arm_localize/benchmark/run-nph60lvw/720p_six/sample-04-crops-gqdpxo9z/target_004.hex)<br>十六进制数据 · 已纳入Git（含暂存） | 以十六进制数据形式保存target_004的目标ROI像素；由对应加载器/testbench读取，位宽、排布和端序按data/evidence/2026-10-03-arm-localize-baseline/arm-board/arm_localize/README.md核对。 | 所在目录说明：[data/evidence/2026-10-03-arm-localize-baseline/arm-board/arm_localize/README.md](../../../data/evidence/2026-10-03-arm-localize-baseline/arm-board/arm_localize/README.md)<br>同名配套文件：[data/evidence/2026-10-03-arm-localize-baseline/arm-board/arm_localize/benchmark/run-nph60lvw/720p_six/sample-04-crops-gqdpxo9z/target_004.pgm](../../../data/evidence/2026-10-03-arm-localize-baseline/arm-board/arm_localize/benchmark/run-nph60lvw/720p_six/sample-04-crops-gqdpxo9z/target_004.pgm) |
| [data/evidence/2026-10-03-arm-localize-baseline/arm-board/arm_localize/benchmark/run-nph60lvw/720p_six/sample-04-crops-gqdpxo9z/target_004.pgm](../../../data/evidence/2026-10-03-arm-localize-baseline/arm-board/arm_localize/benchmark/run-nph60lvw/720p_six/sample-04-crops-gqdpxo9z/target_004.pgm)<br>灰度像素图 · 已纳入Git（含暂存） | 保存target_004的目标ROI裁剪；其合成/文件/实机来源及框/标签含义以data/evidence/2026-10-03-arm-localize-baseline/arm-board/arm_localize/README.md为准。 | 所在目录说明：[data/evidence/2026-10-03-arm-localize-baseline/arm-board/arm_localize/README.md](../../../data/evidence/2026-10-03-arm-localize-baseline/arm-board/arm_localize/README.md)<br>同名配套文件：[data/evidence/2026-10-03-arm-localize-baseline/arm-board/arm_localize/benchmark/run-nph60lvw/720p_six/sample-04-crops-gqdpxo9z/target_004.hex](../../../data/evidence/2026-10-03-arm-localize-baseline/arm-board/arm_localize/benchmark/run-nph60lvw/720p_six/sample-04-crops-gqdpxo9z/target_004.hex) |
| [data/evidence/2026-10-03-arm-localize-baseline/arm-board/arm_localize/benchmark/run-nph60lvw/720p_six/sample-04-crops-gqdpxo9z/target_005.hex](../../../data/evidence/2026-10-03-arm-localize-baseline/arm-board/arm_localize/benchmark/run-nph60lvw/720p_six/sample-04-crops-gqdpxo9z/target_005.hex)<br>十六进制数据 · 已纳入Git（含暂存） | 以十六进制数据形式保存target_005的目标ROI像素；由对应加载器/testbench读取，位宽、排布和端序按data/evidence/2026-10-03-arm-localize-baseline/arm-board/arm_localize/README.md核对。 | 所在目录说明：[data/evidence/2026-10-03-arm-localize-baseline/arm-board/arm_localize/README.md](../../../data/evidence/2026-10-03-arm-localize-baseline/arm-board/arm_localize/README.md)<br>同名配套文件：[data/evidence/2026-10-03-arm-localize-baseline/arm-board/arm_localize/benchmark/run-nph60lvw/720p_six/sample-04-crops-gqdpxo9z/target_005.pgm](../../../data/evidence/2026-10-03-arm-localize-baseline/arm-board/arm_localize/benchmark/run-nph60lvw/720p_six/sample-04-crops-gqdpxo9z/target_005.pgm) |
| [data/evidence/2026-10-03-arm-localize-baseline/arm-board/arm_localize/benchmark/run-nph60lvw/720p_six/sample-04-crops-gqdpxo9z/target_005.pgm](../../../data/evidence/2026-10-03-arm-localize-baseline/arm-board/arm_localize/benchmark/run-nph60lvw/720p_six/sample-04-crops-gqdpxo9z/target_005.pgm)<br>灰度像素图 · 已纳入Git（含暂存） | 保存target_005的目标ROI裁剪；其合成/文件/实机来源及框/标签含义以data/evidence/2026-10-03-arm-localize-baseline/arm-board/arm_localize/README.md为准。 | 所在目录说明：[data/evidence/2026-10-03-arm-localize-baseline/arm-board/arm_localize/README.md](../../../data/evidence/2026-10-03-arm-localize-baseline/arm-board/arm_localize/README.md)<br>同名配套文件：[data/evidence/2026-10-03-arm-localize-baseline/arm-board/arm_localize/benchmark/run-nph60lvw/720p_six/sample-04-crops-gqdpxo9z/target_005.hex](../../../data/evidence/2026-10-03-arm-localize-baseline/arm-board/arm_localize/benchmark/run-nph60lvw/720p_six/sample-04-crops-gqdpxo9z/target_005.hex) |
| **data/evidence/2026-10-03-arm-localize-baseline/arm-board/arm_localize/benchmark/run-nph60lvw/720p_six** | | |
| [data/evidence/2026-10-03-arm-localize-baseline/arm-board/arm_localize/benchmark/run-nph60lvw/720p_six/sample-04.json](../../../data/evidence/2026-10-03-arm-localize-baseline/arm-board/arm_localize/benchmark/run-nph60lvw/720p_six/sample-04.json)<br>结构化结果/元数据 · 已纳入Git（含暂存） | 保存sample-04的实验结果或检查产物，字段包括frame_id、config_id、width、height、status、targets、schema_version；与data/evidence/2026-10-03-arm-localize-baseline/arm-board/arm_localize/README.md中的生成/校验流程一起使用。 | 所在目录说明：[data/evidence/2026-10-03-arm-localize-baseline/arm-board/arm_localize/README.md](../../../data/evidence/2026-10-03-arm-localize-baseline/arm-board/arm_localize/README.md)<br>同目录输入/元数据：[data/evidence/2026-10-03-arm-localize-baseline/arm-board/arm_localize/benchmark/run-nph60lvw/720p_six/input.json](../../../data/evidence/2026-10-03-arm-localize-baseline/arm-board/arm_localize/benchmark/run-nph60lvw/720p_six/input.json) |
| **data/evidence/2026-10-03-arm-localize-baseline/arm-board/arm_localize/benchmark/run-nph60lvw/720p_six/warmup-00-crops-kqb046pn** | | |
| [data/evidence/2026-10-03-arm-localize-baseline/arm-board/arm_localize/benchmark/run-nph60lvw/720p_six/warmup-00-crops-kqb046pn/target_000.hex](../../../data/evidence/2026-10-03-arm-localize-baseline/arm-board/arm_localize/benchmark/run-nph60lvw/720p_six/warmup-00-crops-kqb046pn/target_000.hex)<br>十六进制数据 · 已纳入Git（含暂存） | 以十六进制数据形式保存target_000的目标ROI像素；由对应加载器/testbench读取，位宽、排布和端序按data/evidence/2026-10-03-arm-localize-baseline/arm-board/arm_localize/README.md核对。 | 所在目录说明：[data/evidence/2026-10-03-arm-localize-baseline/arm-board/arm_localize/README.md](../../../data/evidence/2026-10-03-arm-localize-baseline/arm-board/arm_localize/README.md)<br>同名配套文件：[data/evidence/2026-10-03-arm-localize-baseline/arm-board/arm_localize/benchmark/run-nph60lvw/720p_six/warmup-00-crops-kqb046pn/target_000.pgm](../../../data/evidence/2026-10-03-arm-localize-baseline/arm-board/arm_localize/benchmark/run-nph60lvw/720p_six/warmup-00-crops-kqb046pn/target_000.pgm) |
| [data/evidence/2026-10-03-arm-localize-baseline/arm-board/arm_localize/benchmark/run-nph60lvw/720p_six/warmup-00-crops-kqb046pn/target_000.pgm](../../../data/evidence/2026-10-03-arm-localize-baseline/arm-board/arm_localize/benchmark/run-nph60lvw/720p_six/warmup-00-crops-kqb046pn/target_000.pgm)<br>灰度像素图 · 已纳入Git（含暂存） | 保存target_000的目标ROI裁剪；其合成/文件/实机来源及框/标签含义以data/evidence/2026-10-03-arm-localize-baseline/arm-board/arm_localize/README.md为准。 | 所在目录说明：[data/evidence/2026-10-03-arm-localize-baseline/arm-board/arm_localize/README.md](../../../data/evidence/2026-10-03-arm-localize-baseline/arm-board/arm_localize/README.md)<br>同名配套文件：[data/evidence/2026-10-03-arm-localize-baseline/arm-board/arm_localize/benchmark/run-nph60lvw/720p_six/warmup-00-crops-kqb046pn/target_000.hex](../../../data/evidence/2026-10-03-arm-localize-baseline/arm-board/arm_localize/benchmark/run-nph60lvw/720p_six/warmup-00-crops-kqb046pn/target_000.hex) |
| [data/evidence/2026-10-03-arm-localize-baseline/arm-board/arm_localize/benchmark/run-nph60lvw/720p_six/warmup-00-crops-kqb046pn/target_001.hex](../../../data/evidence/2026-10-03-arm-localize-baseline/arm-board/arm_localize/benchmark/run-nph60lvw/720p_six/warmup-00-crops-kqb046pn/target_001.hex)<br>十六进制数据 · 已纳入Git（含暂存） | 以十六进制数据形式保存target_001的目标ROI像素；由对应加载器/testbench读取，位宽、排布和端序按data/evidence/2026-10-03-arm-localize-baseline/arm-board/arm_localize/README.md核对。 | 所在目录说明：[data/evidence/2026-10-03-arm-localize-baseline/arm-board/arm_localize/README.md](../../../data/evidence/2026-10-03-arm-localize-baseline/arm-board/arm_localize/README.md)<br>同名配套文件：[data/evidence/2026-10-03-arm-localize-baseline/arm-board/arm_localize/benchmark/run-nph60lvw/720p_six/warmup-00-crops-kqb046pn/target_001.pgm](../../../data/evidence/2026-10-03-arm-localize-baseline/arm-board/arm_localize/benchmark/run-nph60lvw/720p_six/warmup-00-crops-kqb046pn/target_001.pgm) |
| [data/evidence/2026-10-03-arm-localize-baseline/arm-board/arm_localize/benchmark/run-nph60lvw/720p_six/warmup-00-crops-kqb046pn/target_001.pgm](../../../data/evidence/2026-10-03-arm-localize-baseline/arm-board/arm_localize/benchmark/run-nph60lvw/720p_six/warmup-00-crops-kqb046pn/target_001.pgm)<br>灰度像素图 · 已纳入Git（含暂存） | 保存target_001的目标ROI裁剪；其合成/文件/实机来源及框/标签含义以data/evidence/2026-10-03-arm-localize-baseline/arm-board/arm_localize/README.md为准。 | 所在目录说明：[data/evidence/2026-10-03-arm-localize-baseline/arm-board/arm_localize/README.md](../../../data/evidence/2026-10-03-arm-localize-baseline/arm-board/arm_localize/README.md)<br>同名配套文件：[data/evidence/2026-10-03-arm-localize-baseline/arm-board/arm_localize/benchmark/run-nph60lvw/720p_six/warmup-00-crops-kqb046pn/target_001.hex](../../../data/evidence/2026-10-03-arm-localize-baseline/arm-board/arm_localize/benchmark/run-nph60lvw/720p_six/warmup-00-crops-kqb046pn/target_001.hex) |
| [data/evidence/2026-10-03-arm-localize-baseline/arm-board/arm_localize/benchmark/run-nph60lvw/720p_six/warmup-00-crops-kqb046pn/target_002.hex](../../../data/evidence/2026-10-03-arm-localize-baseline/arm-board/arm_localize/benchmark/run-nph60lvw/720p_six/warmup-00-crops-kqb046pn/target_002.hex)<br>十六进制数据 · 已纳入Git（含暂存） | 以十六进制数据形式保存target_002的目标ROI像素；由对应加载器/testbench读取，位宽、排布和端序按data/evidence/2026-10-03-arm-localize-baseline/arm-board/arm_localize/README.md核对。 | 所在目录说明：[data/evidence/2026-10-03-arm-localize-baseline/arm-board/arm_localize/README.md](../../../data/evidence/2026-10-03-arm-localize-baseline/arm-board/arm_localize/README.md)<br>同名配套文件：[data/evidence/2026-10-03-arm-localize-baseline/arm-board/arm_localize/benchmark/run-nph60lvw/720p_six/warmup-00-crops-kqb046pn/target_002.pgm](../../../data/evidence/2026-10-03-arm-localize-baseline/arm-board/arm_localize/benchmark/run-nph60lvw/720p_six/warmup-00-crops-kqb046pn/target_002.pgm) |
| [data/evidence/2026-10-03-arm-localize-baseline/arm-board/arm_localize/benchmark/run-nph60lvw/720p_six/warmup-00-crops-kqb046pn/target_002.pgm](../../../data/evidence/2026-10-03-arm-localize-baseline/arm-board/arm_localize/benchmark/run-nph60lvw/720p_six/warmup-00-crops-kqb046pn/target_002.pgm)<br>灰度像素图 · 已纳入Git（含暂存） | 保存target_002的目标ROI裁剪；其合成/文件/实机来源及框/标签含义以data/evidence/2026-10-03-arm-localize-baseline/arm-board/arm_localize/README.md为准。 | 所在目录说明：[data/evidence/2026-10-03-arm-localize-baseline/arm-board/arm_localize/README.md](../../../data/evidence/2026-10-03-arm-localize-baseline/arm-board/arm_localize/README.md)<br>同名配套文件：[data/evidence/2026-10-03-arm-localize-baseline/arm-board/arm_localize/benchmark/run-nph60lvw/720p_six/warmup-00-crops-kqb046pn/target_002.hex](../../../data/evidence/2026-10-03-arm-localize-baseline/arm-board/arm_localize/benchmark/run-nph60lvw/720p_six/warmup-00-crops-kqb046pn/target_002.hex) |
| [data/evidence/2026-10-03-arm-localize-baseline/arm-board/arm_localize/benchmark/run-nph60lvw/720p_six/warmup-00-crops-kqb046pn/target_003.hex](../../../data/evidence/2026-10-03-arm-localize-baseline/arm-board/arm_localize/benchmark/run-nph60lvw/720p_six/warmup-00-crops-kqb046pn/target_003.hex)<br>十六进制数据 · 已纳入Git（含暂存） | 以十六进制数据形式保存target_003的目标ROI像素；由对应加载器/testbench读取，位宽、排布和端序按data/evidence/2026-10-03-arm-localize-baseline/arm-board/arm_localize/README.md核对。 | 所在目录说明：[data/evidence/2026-10-03-arm-localize-baseline/arm-board/arm_localize/README.md](../../../data/evidence/2026-10-03-arm-localize-baseline/arm-board/arm_localize/README.md)<br>同名配套文件：[data/evidence/2026-10-03-arm-localize-baseline/arm-board/arm_localize/benchmark/run-nph60lvw/720p_six/warmup-00-crops-kqb046pn/target_003.pgm](../../../data/evidence/2026-10-03-arm-localize-baseline/arm-board/arm_localize/benchmark/run-nph60lvw/720p_six/warmup-00-crops-kqb046pn/target_003.pgm) |
| [data/evidence/2026-10-03-arm-localize-baseline/arm-board/arm_localize/benchmark/run-nph60lvw/720p_six/warmup-00-crops-kqb046pn/target_003.pgm](../../../data/evidence/2026-10-03-arm-localize-baseline/arm-board/arm_localize/benchmark/run-nph60lvw/720p_six/warmup-00-crops-kqb046pn/target_003.pgm)<br>灰度像素图 · 已纳入Git（含暂存） | 保存target_003的目标ROI裁剪；其合成/文件/实机来源及框/标签含义以data/evidence/2026-10-03-arm-localize-baseline/arm-board/arm_localize/README.md为准。 | 所在目录说明：[data/evidence/2026-10-03-arm-localize-baseline/arm-board/arm_localize/README.md](../../../data/evidence/2026-10-03-arm-localize-baseline/arm-board/arm_localize/README.md)<br>同名配套文件：[data/evidence/2026-10-03-arm-localize-baseline/arm-board/arm_localize/benchmark/run-nph60lvw/720p_six/warmup-00-crops-kqb046pn/target_003.hex](../../../data/evidence/2026-10-03-arm-localize-baseline/arm-board/arm_localize/benchmark/run-nph60lvw/720p_six/warmup-00-crops-kqb046pn/target_003.hex) |
| [data/evidence/2026-10-03-arm-localize-baseline/arm-board/arm_localize/benchmark/run-nph60lvw/720p_six/warmup-00-crops-kqb046pn/target_004.hex](../../../data/evidence/2026-10-03-arm-localize-baseline/arm-board/arm_localize/benchmark/run-nph60lvw/720p_six/warmup-00-crops-kqb046pn/target_004.hex)<br>十六进制数据 · 已纳入Git（含暂存） | 以十六进制数据形式保存target_004的目标ROI像素；由对应加载器/testbench读取，位宽、排布和端序按data/evidence/2026-10-03-arm-localize-baseline/arm-board/arm_localize/README.md核对。 | 所在目录说明：[data/evidence/2026-10-03-arm-localize-baseline/arm-board/arm_localize/README.md](../../../data/evidence/2026-10-03-arm-localize-baseline/arm-board/arm_localize/README.md)<br>同名配套文件：[data/evidence/2026-10-03-arm-localize-baseline/arm-board/arm_localize/benchmark/run-nph60lvw/720p_six/warmup-00-crops-kqb046pn/target_004.pgm](../../../data/evidence/2026-10-03-arm-localize-baseline/arm-board/arm_localize/benchmark/run-nph60lvw/720p_six/warmup-00-crops-kqb046pn/target_004.pgm) |
| [data/evidence/2026-10-03-arm-localize-baseline/arm-board/arm_localize/benchmark/run-nph60lvw/720p_six/warmup-00-crops-kqb046pn/target_004.pgm](../../../data/evidence/2026-10-03-arm-localize-baseline/arm-board/arm_localize/benchmark/run-nph60lvw/720p_six/warmup-00-crops-kqb046pn/target_004.pgm)<br>灰度像素图 · 已纳入Git（含暂存） | 保存target_004的目标ROI裁剪；其合成/文件/实机来源及框/标签含义以data/evidence/2026-10-03-arm-localize-baseline/arm-board/arm_localize/README.md为准。 | 所在目录说明：[data/evidence/2026-10-03-arm-localize-baseline/arm-board/arm_localize/README.md](../../../data/evidence/2026-10-03-arm-localize-baseline/arm-board/arm_localize/README.md)<br>同名配套文件：[data/evidence/2026-10-03-arm-localize-baseline/arm-board/arm_localize/benchmark/run-nph60lvw/720p_six/warmup-00-crops-kqb046pn/target_004.hex](../../../data/evidence/2026-10-03-arm-localize-baseline/arm-board/arm_localize/benchmark/run-nph60lvw/720p_six/warmup-00-crops-kqb046pn/target_004.hex) |
| [data/evidence/2026-10-03-arm-localize-baseline/arm-board/arm_localize/benchmark/run-nph60lvw/720p_six/warmup-00-crops-kqb046pn/target_005.hex](../../../data/evidence/2026-10-03-arm-localize-baseline/arm-board/arm_localize/benchmark/run-nph60lvw/720p_six/warmup-00-crops-kqb046pn/target_005.hex)<br>十六进制数据 · 已纳入Git（含暂存） | 以十六进制数据形式保存target_005的目标ROI像素；由对应加载器/testbench读取，位宽、排布和端序按data/evidence/2026-10-03-arm-localize-baseline/arm-board/arm_localize/README.md核对。 | 所在目录说明：[data/evidence/2026-10-03-arm-localize-baseline/arm-board/arm_localize/README.md](../../../data/evidence/2026-10-03-arm-localize-baseline/arm-board/arm_localize/README.md)<br>同名配套文件：[data/evidence/2026-10-03-arm-localize-baseline/arm-board/arm_localize/benchmark/run-nph60lvw/720p_six/warmup-00-crops-kqb046pn/target_005.pgm](../../../data/evidence/2026-10-03-arm-localize-baseline/arm-board/arm_localize/benchmark/run-nph60lvw/720p_six/warmup-00-crops-kqb046pn/target_005.pgm) |
| [data/evidence/2026-10-03-arm-localize-baseline/arm-board/arm_localize/benchmark/run-nph60lvw/720p_six/warmup-00-crops-kqb046pn/target_005.pgm](../../../data/evidence/2026-10-03-arm-localize-baseline/arm-board/arm_localize/benchmark/run-nph60lvw/720p_six/warmup-00-crops-kqb046pn/target_005.pgm)<br>灰度像素图 · 已纳入Git（含暂存） | 保存target_005的目标ROI裁剪；其合成/文件/实机来源及框/标签含义以data/evidence/2026-10-03-arm-localize-baseline/arm-board/arm_localize/README.md为准。 | 所在目录说明：[data/evidence/2026-10-03-arm-localize-baseline/arm-board/arm_localize/README.md](../../../data/evidence/2026-10-03-arm-localize-baseline/arm-board/arm_localize/README.md)<br>同名配套文件：[data/evidence/2026-10-03-arm-localize-baseline/arm-board/arm_localize/benchmark/run-nph60lvw/720p_six/warmup-00-crops-kqb046pn/target_005.hex](../../../data/evidence/2026-10-03-arm-localize-baseline/arm-board/arm_localize/benchmark/run-nph60lvw/720p_six/warmup-00-crops-kqb046pn/target_005.hex) |
| **data/evidence/2026-10-03-arm-localize-baseline/arm-board/arm_localize/benchmark/run-nph60lvw/720p_six** | | |
| [data/evidence/2026-10-03-arm-localize-baseline/arm-board/arm_localize/benchmark/run-nph60lvw/720p_six/warmup-00.json](../../../data/evidence/2026-10-03-arm-localize-baseline/arm-board/arm_localize/benchmark/run-nph60lvw/720p_six/warmup-00.json)<br>结构化结果/元数据 · 已纳入Git（含暂存） | 保存warmup-00的实验结果或检查产物，字段包括frame_id、config_id、width、height、status、targets、schema_version；与data/evidence/2026-10-03-arm-localize-baseline/arm-board/arm_localize/README.md中的生成/校验流程一起使用。 | 所在目录说明：[data/evidence/2026-10-03-arm-localize-baseline/arm-board/arm_localize/README.md](../../../data/evidence/2026-10-03-arm-localize-baseline/arm-board/arm_localize/README.md)<br>同目录输入/元数据：[data/evidence/2026-10-03-arm-localize-baseline/arm-board/arm_localize/benchmark/run-nph60lvw/720p_six/input.json](../../../data/evidence/2026-10-03-arm-localize-baseline/arm-board/arm_localize/benchmark/run-nph60lvw/720p_six/input.json) |
| **data/evidence/2026-10-03-arm-localize-baseline/arm-board/arm_localize/benchmark/run-nph60lvw/tiny** | | |
| [data/evidence/2026-10-03-arm-localize-baseline/arm-board/arm_localize/benchmark/run-nph60lvw/tiny/input.json](../../../data/evidence/2026-10-03-arm-localize-baseline/arm-board/arm_localize/benchmark/run-nph60lvw/tiny/input.json)<br>结构化结果/元数据 · 已纳入Git（含暂存） | 保存input的输入/设备/运行元数据，字段包括pixels；与data/evidence/2026-10-03-arm-localize-baseline/arm-board/arm_localize/README.md中的生成/校验流程一起使用。 | 所在目录说明：[data/evidence/2026-10-03-arm-localize-baseline/arm-board/arm_localize/README.md](../../../data/evidence/2026-10-03-arm-localize-baseline/arm-board/arm_localize/README.md) |
| **data/evidence/2026-10-03-arm-localize-baseline/arm-board/arm_localize/benchmark/run-nph60lvw/tiny/sample-00-crops-8ap1c6i1** | | |
| [data/evidence/2026-10-03-arm-localize-baseline/arm-board/arm_localize/benchmark/run-nph60lvw/tiny/sample-00-crops-8ap1c6i1/target_000.hex](../../../data/evidence/2026-10-03-arm-localize-baseline/arm-board/arm_localize/benchmark/run-nph60lvw/tiny/sample-00-crops-8ap1c6i1/target_000.hex)<br>十六进制数据 · 已纳入Git（含暂存） | 以十六进制数据形式保存target_000的目标ROI像素；由对应加载器/testbench读取，位宽、排布和端序按data/evidence/2026-10-03-arm-localize-baseline/arm-board/arm_localize/README.md核对。 | 所在目录说明：[data/evidence/2026-10-03-arm-localize-baseline/arm-board/arm_localize/README.md](../../../data/evidence/2026-10-03-arm-localize-baseline/arm-board/arm_localize/README.md)<br>同名配套文件：[data/evidence/2026-10-03-arm-localize-baseline/arm-board/arm_localize/benchmark/run-nph60lvw/tiny/sample-00-crops-8ap1c6i1/target_000.pgm](../../../data/evidence/2026-10-03-arm-localize-baseline/arm-board/arm_localize/benchmark/run-nph60lvw/tiny/sample-00-crops-8ap1c6i1/target_000.pgm) |
| [data/evidence/2026-10-03-arm-localize-baseline/arm-board/arm_localize/benchmark/run-nph60lvw/tiny/sample-00-crops-8ap1c6i1/target_000.pgm](../../../data/evidence/2026-10-03-arm-localize-baseline/arm-board/arm_localize/benchmark/run-nph60lvw/tiny/sample-00-crops-8ap1c6i1/target_000.pgm)<br>灰度像素图 · 已纳入Git（含暂存） | 保存target_000的目标ROI裁剪；其合成/文件/实机来源及框/标签含义以data/evidence/2026-10-03-arm-localize-baseline/arm-board/arm_localize/README.md为准。 | 所在目录说明：[data/evidence/2026-10-03-arm-localize-baseline/arm-board/arm_localize/README.md](../../../data/evidence/2026-10-03-arm-localize-baseline/arm-board/arm_localize/README.md)<br>同名配套文件：[data/evidence/2026-10-03-arm-localize-baseline/arm-board/arm_localize/benchmark/run-nph60lvw/tiny/sample-00-crops-8ap1c6i1/target_000.hex](../../../data/evidence/2026-10-03-arm-localize-baseline/arm-board/arm_localize/benchmark/run-nph60lvw/tiny/sample-00-crops-8ap1c6i1/target_000.hex) |
| [data/evidence/2026-10-03-arm-localize-baseline/arm-board/arm_localize/benchmark/run-nph60lvw/tiny/sample-00-crops-8ap1c6i1/target_001.hex](../../../data/evidence/2026-10-03-arm-localize-baseline/arm-board/arm_localize/benchmark/run-nph60lvw/tiny/sample-00-crops-8ap1c6i1/target_001.hex)<br>十六进制数据 · 已纳入Git（含暂存） | 以十六进制数据形式保存target_001的目标ROI像素；由对应加载器/testbench读取，位宽、排布和端序按data/evidence/2026-10-03-arm-localize-baseline/arm-board/arm_localize/README.md核对。 | 所在目录说明：[data/evidence/2026-10-03-arm-localize-baseline/arm-board/arm_localize/README.md](../../../data/evidence/2026-10-03-arm-localize-baseline/arm-board/arm_localize/README.md)<br>同名配套文件：[data/evidence/2026-10-03-arm-localize-baseline/arm-board/arm_localize/benchmark/run-nph60lvw/tiny/sample-00-crops-8ap1c6i1/target_001.pgm](../../../data/evidence/2026-10-03-arm-localize-baseline/arm-board/arm_localize/benchmark/run-nph60lvw/tiny/sample-00-crops-8ap1c6i1/target_001.pgm) |
| [data/evidence/2026-10-03-arm-localize-baseline/arm-board/arm_localize/benchmark/run-nph60lvw/tiny/sample-00-crops-8ap1c6i1/target_001.pgm](../../../data/evidence/2026-10-03-arm-localize-baseline/arm-board/arm_localize/benchmark/run-nph60lvw/tiny/sample-00-crops-8ap1c6i1/target_001.pgm)<br>灰度像素图 · 已纳入Git（含暂存） | 保存target_001的目标ROI裁剪；其合成/文件/实机来源及框/标签含义以data/evidence/2026-10-03-arm-localize-baseline/arm-board/arm_localize/README.md为准。 | 所在目录说明：[data/evidence/2026-10-03-arm-localize-baseline/arm-board/arm_localize/README.md](../../../data/evidence/2026-10-03-arm-localize-baseline/arm-board/arm_localize/README.md)<br>同名配套文件：[data/evidence/2026-10-03-arm-localize-baseline/arm-board/arm_localize/benchmark/run-nph60lvw/tiny/sample-00-crops-8ap1c6i1/target_001.hex](../../../data/evidence/2026-10-03-arm-localize-baseline/arm-board/arm_localize/benchmark/run-nph60lvw/tiny/sample-00-crops-8ap1c6i1/target_001.hex) |
| **data/evidence/2026-10-03-arm-localize-baseline/arm-board/arm_localize/benchmark/run-nph60lvw/tiny** | | |
| [data/evidence/2026-10-03-arm-localize-baseline/arm-board/arm_localize/benchmark/run-nph60lvw/tiny/sample-00.json](../../../data/evidence/2026-10-03-arm-localize-baseline/arm-board/arm_localize/benchmark/run-nph60lvw/tiny/sample-00.json)<br>结构化结果/元数据 · 已纳入Git（含暂存） | 保存sample-00的实验结果或检查产物，字段包括frame_id、config_id、width、height、status、targets、schema_version；与data/evidence/2026-10-03-arm-localize-baseline/arm-board/arm_localize/README.md中的生成/校验流程一起使用。 | 所在目录说明：[data/evidence/2026-10-03-arm-localize-baseline/arm-board/arm_localize/README.md](../../../data/evidence/2026-10-03-arm-localize-baseline/arm-board/arm_localize/README.md)<br>同目录输入/元数据：[data/evidence/2026-10-03-arm-localize-baseline/arm-board/arm_localize/benchmark/run-nph60lvw/tiny/input.json](../../../data/evidence/2026-10-03-arm-localize-baseline/arm-board/arm_localize/benchmark/run-nph60lvw/tiny/input.json) |
| **data/evidence/2026-10-03-arm-localize-baseline/arm-board/arm_localize/benchmark/run-nph60lvw/tiny/sample-01-crops-rnwxox_j** | | |
| [data/evidence/2026-10-03-arm-localize-baseline/arm-board/arm_localize/benchmark/run-nph60lvw/tiny/sample-01-crops-rnwxox_j/target_000.hex](../../../data/evidence/2026-10-03-arm-localize-baseline/arm-board/arm_localize/benchmark/run-nph60lvw/tiny/sample-01-crops-rnwxox_j/target_000.hex)<br>十六进制数据 · 已纳入Git（含暂存） | 以十六进制数据形式保存target_000的目标ROI像素；由对应加载器/testbench读取，位宽、排布和端序按data/evidence/2026-10-03-arm-localize-baseline/arm-board/arm_localize/README.md核对。 | 所在目录说明：[data/evidence/2026-10-03-arm-localize-baseline/arm-board/arm_localize/README.md](../../../data/evidence/2026-10-03-arm-localize-baseline/arm-board/arm_localize/README.md)<br>同名配套文件：[data/evidence/2026-10-03-arm-localize-baseline/arm-board/arm_localize/benchmark/run-nph60lvw/tiny/sample-01-crops-rnwxox_j/target_000.pgm](../../../data/evidence/2026-10-03-arm-localize-baseline/arm-board/arm_localize/benchmark/run-nph60lvw/tiny/sample-01-crops-rnwxox_j/target_000.pgm) |
| [data/evidence/2026-10-03-arm-localize-baseline/arm-board/arm_localize/benchmark/run-nph60lvw/tiny/sample-01-crops-rnwxox_j/target_000.pgm](../../../data/evidence/2026-10-03-arm-localize-baseline/arm-board/arm_localize/benchmark/run-nph60lvw/tiny/sample-01-crops-rnwxox_j/target_000.pgm)<br>灰度像素图 · 已纳入Git（含暂存） | 保存target_000的目标ROI裁剪；其合成/文件/实机来源及框/标签含义以data/evidence/2026-10-03-arm-localize-baseline/arm-board/arm_localize/README.md为准。 | 所在目录说明：[data/evidence/2026-10-03-arm-localize-baseline/arm-board/arm_localize/README.md](../../../data/evidence/2026-10-03-arm-localize-baseline/arm-board/arm_localize/README.md)<br>同名配套文件：[data/evidence/2026-10-03-arm-localize-baseline/arm-board/arm_localize/benchmark/run-nph60lvw/tiny/sample-01-crops-rnwxox_j/target_000.hex](../../../data/evidence/2026-10-03-arm-localize-baseline/arm-board/arm_localize/benchmark/run-nph60lvw/tiny/sample-01-crops-rnwxox_j/target_000.hex) |
| [data/evidence/2026-10-03-arm-localize-baseline/arm-board/arm_localize/benchmark/run-nph60lvw/tiny/sample-01-crops-rnwxox_j/target_001.hex](../../../data/evidence/2026-10-03-arm-localize-baseline/arm-board/arm_localize/benchmark/run-nph60lvw/tiny/sample-01-crops-rnwxox_j/target_001.hex)<br>十六进制数据 · 已纳入Git（含暂存） | 以十六进制数据形式保存target_001的目标ROI像素；由对应加载器/testbench读取，位宽、排布和端序按data/evidence/2026-10-03-arm-localize-baseline/arm-board/arm_localize/README.md核对。 | 所在目录说明：[data/evidence/2026-10-03-arm-localize-baseline/arm-board/arm_localize/README.md](../../../data/evidence/2026-10-03-arm-localize-baseline/arm-board/arm_localize/README.md)<br>同名配套文件：[data/evidence/2026-10-03-arm-localize-baseline/arm-board/arm_localize/benchmark/run-nph60lvw/tiny/sample-01-crops-rnwxox_j/target_001.pgm](../../../data/evidence/2026-10-03-arm-localize-baseline/arm-board/arm_localize/benchmark/run-nph60lvw/tiny/sample-01-crops-rnwxox_j/target_001.pgm) |
| [data/evidence/2026-10-03-arm-localize-baseline/arm-board/arm_localize/benchmark/run-nph60lvw/tiny/sample-01-crops-rnwxox_j/target_001.pgm](../../../data/evidence/2026-10-03-arm-localize-baseline/arm-board/arm_localize/benchmark/run-nph60lvw/tiny/sample-01-crops-rnwxox_j/target_001.pgm)<br>灰度像素图 · 已纳入Git（含暂存） | 保存target_001的目标ROI裁剪；其合成/文件/实机来源及框/标签含义以data/evidence/2026-10-03-arm-localize-baseline/arm-board/arm_localize/README.md为准。 | 所在目录说明：[data/evidence/2026-10-03-arm-localize-baseline/arm-board/arm_localize/README.md](../../../data/evidence/2026-10-03-arm-localize-baseline/arm-board/arm_localize/README.md)<br>同名配套文件：[data/evidence/2026-10-03-arm-localize-baseline/arm-board/arm_localize/benchmark/run-nph60lvw/tiny/sample-01-crops-rnwxox_j/target_001.hex](../../../data/evidence/2026-10-03-arm-localize-baseline/arm-board/arm_localize/benchmark/run-nph60lvw/tiny/sample-01-crops-rnwxox_j/target_001.hex) |
| **data/evidence/2026-10-03-arm-localize-baseline/arm-board/arm_localize/benchmark/run-nph60lvw/tiny** | | |
| [data/evidence/2026-10-03-arm-localize-baseline/arm-board/arm_localize/benchmark/run-nph60lvw/tiny/sample-01.json](../../../data/evidence/2026-10-03-arm-localize-baseline/arm-board/arm_localize/benchmark/run-nph60lvw/tiny/sample-01.json)<br>结构化结果/元数据 · 已纳入Git（含暂存） | 保存sample-01的实验结果或检查产物，字段包括frame_id、config_id、width、height、status、targets、schema_version；与data/evidence/2026-10-03-arm-localize-baseline/arm-board/arm_localize/README.md中的生成/校验流程一起使用。 | 所在目录说明：[data/evidence/2026-10-03-arm-localize-baseline/arm-board/arm_localize/README.md](../../../data/evidence/2026-10-03-arm-localize-baseline/arm-board/arm_localize/README.md)<br>同目录输入/元数据：[data/evidence/2026-10-03-arm-localize-baseline/arm-board/arm_localize/benchmark/run-nph60lvw/tiny/input.json](../../../data/evidence/2026-10-03-arm-localize-baseline/arm-board/arm_localize/benchmark/run-nph60lvw/tiny/input.json) |
| **data/evidence/2026-10-03-arm-localize-baseline/arm-board/arm_localize/benchmark/run-nph60lvw/tiny/sample-02-crops-q0lvcy0q** | | |
| [data/evidence/2026-10-03-arm-localize-baseline/arm-board/arm_localize/benchmark/run-nph60lvw/tiny/sample-02-crops-q0lvcy0q/target_000.hex](../../../data/evidence/2026-10-03-arm-localize-baseline/arm-board/arm_localize/benchmark/run-nph60lvw/tiny/sample-02-crops-q0lvcy0q/target_000.hex)<br>十六进制数据 · 已纳入Git（含暂存） | 以十六进制数据形式保存target_000的目标ROI像素；由对应加载器/testbench读取，位宽、排布和端序按data/evidence/2026-10-03-arm-localize-baseline/arm-board/arm_localize/README.md核对。 | 所在目录说明：[data/evidence/2026-10-03-arm-localize-baseline/arm-board/arm_localize/README.md](../../../data/evidence/2026-10-03-arm-localize-baseline/arm-board/arm_localize/README.md)<br>同名配套文件：[data/evidence/2026-10-03-arm-localize-baseline/arm-board/arm_localize/benchmark/run-nph60lvw/tiny/sample-02-crops-q0lvcy0q/target_000.pgm](../../../data/evidence/2026-10-03-arm-localize-baseline/arm-board/arm_localize/benchmark/run-nph60lvw/tiny/sample-02-crops-q0lvcy0q/target_000.pgm) |
| [data/evidence/2026-10-03-arm-localize-baseline/arm-board/arm_localize/benchmark/run-nph60lvw/tiny/sample-02-crops-q0lvcy0q/target_000.pgm](../../../data/evidence/2026-10-03-arm-localize-baseline/arm-board/arm_localize/benchmark/run-nph60lvw/tiny/sample-02-crops-q0lvcy0q/target_000.pgm)<br>灰度像素图 · 已纳入Git（含暂存） | 保存target_000的目标ROI裁剪；其合成/文件/实机来源及框/标签含义以data/evidence/2026-10-03-arm-localize-baseline/arm-board/arm_localize/README.md为准。 | 所在目录说明：[data/evidence/2026-10-03-arm-localize-baseline/arm-board/arm_localize/README.md](../../../data/evidence/2026-10-03-arm-localize-baseline/arm-board/arm_localize/README.md)<br>同名配套文件：[data/evidence/2026-10-03-arm-localize-baseline/arm-board/arm_localize/benchmark/run-nph60lvw/tiny/sample-02-crops-q0lvcy0q/target_000.hex](../../../data/evidence/2026-10-03-arm-localize-baseline/arm-board/arm_localize/benchmark/run-nph60lvw/tiny/sample-02-crops-q0lvcy0q/target_000.hex) |
| [data/evidence/2026-10-03-arm-localize-baseline/arm-board/arm_localize/benchmark/run-nph60lvw/tiny/sample-02-crops-q0lvcy0q/target_001.hex](../../../data/evidence/2026-10-03-arm-localize-baseline/arm-board/arm_localize/benchmark/run-nph60lvw/tiny/sample-02-crops-q0lvcy0q/target_001.hex)<br>十六进制数据 · 已纳入Git（含暂存） | 以十六进制数据形式保存target_001的目标ROI像素；由对应加载器/testbench读取，位宽、排布和端序按data/evidence/2026-10-03-arm-localize-baseline/arm-board/arm_localize/README.md核对。 | 所在目录说明：[data/evidence/2026-10-03-arm-localize-baseline/arm-board/arm_localize/README.md](../../../data/evidence/2026-10-03-arm-localize-baseline/arm-board/arm_localize/README.md)<br>同名配套文件：[data/evidence/2026-10-03-arm-localize-baseline/arm-board/arm_localize/benchmark/run-nph60lvw/tiny/sample-02-crops-q0lvcy0q/target_001.pgm](../../../data/evidence/2026-10-03-arm-localize-baseline/arm-board/arm_localize/benchmark/run-nph60lvw/tiny/sample-02-crops-q0lvcy0q/target_001.pgm) |
| [data/evidence/2026-10-03-arm-localize-baseline/arm-board/arm_localize/benchmark/run-nph60lvw/tiny/sample-02-crops-q0lvcy0q/target_001.pgm](../../../data/evidence/2026-10-03-arm-localize-baseline/arm-board/arm_localize/benchmark/run-nph60lvw/tiny/sample-02-crops-q0lvcy0q/target_001.pgm)<br>灰度像素图 · 已纳入Git（含暂存） | 保存target_001的目标ROI裁剪；其合成/文件/实机来源及框/标签含义以data/evidence/2026-10-03-arm-localize-baseline/arm-board/arm_localize/README.md为准。 | 所在目录说明：[data/evidence/2026-10-03-arm-localize-baseline/arm-board/arm_localize/README.md](../../../data/evidence/2026-10-03-arm-localize-baseline/arm-board/arm_localize/README.md)<br>同名配套文件：[data/evidence/2026-10-03-arm-localize-baseline/arm-board/arm_localize/benchmark/run-nph60lvw/tiny/sample-02-crops-q0lvcy0q/target_001.hex](../../../data/evidence/2026-10-03-arm-localize-baseline/arm-board/arm_localize/benchmark/run-nph60lvw/tiny/sample-02-crops-q0lvcy0q/target_001.hex) |
| **data/evidence/2026-10-03-arm-localize-baseline/arm-board/arm_localize/benchmark/run-nph60lvw/tiny** | | |
| [data/evidence/2026-10-03-arm-localize-baseline/arm-board/arm_localize/benchmark/run-nph60lvw/tiny/sample-02.json](../../../data/evidence/2026-10-03-arm-localize-baseline/arm-board/arm_localize/benchmark/run-nph60lvw/tiny/sample-02.json)<br>结构化结果/元数据 · 已纳入Git（含暂存） | 保存sample-02的实验结果或检查产物，字段包括frame_id、config_id、width、height、status、targets、schema_version；与data/evidence/2026-10-03-arm-localize-baseline/arm-board/arm_localize/README.md中的生成/校验流程一起使用。 | 所在目录说明：[data/evidence/2026-10-03-arm-localize-baseline/arm-board/arm_localize/README.md](../../../data/evidence/2026-10-03-arm-localize-baseline/arm-board/arm_localize/README.md)<br>同目录输入/元数据：[data/evidence/2026-10-03-arm-localize-baseline/arm-board/arm_localize/benchmark/run-nph60lvw/tiny/input.json](../../../data/evidence/2026-10-03-arm-localize-baseline/arm-board/arm_localize/benchmark/run-nph60lvw/tiny/input.json) |
| **data/evidence/2026-10-03-arm-localize-baseline/arm-board/arm_localize/benchmark/run-nph60lvw/tiny/sample-03-crops-yw_p377k** | | |
| [data/evidence/2026-10-03-arm-localize-baseline/arm-board/arm_localize/benchmark/run-nph60lvw/tiny/sample-03-crops-yw_p377k/target_000.hex](../../../data/evidence/2026-10-03-arm-localize-baseline/arm-board/arm_localize/benchmark/run-nph60lvw/tiny/sample-03-crops-yw_p377k/target_000.hex)<br>十六进制数据 · 已纳入Git（含暂存） | 以十六进制数据形式保存target_000的目标ROI像素；由对应加载器/testbench读取，位宽、排布和端序按data/evidence/2026-10-03-arm-localize-baseline/arm-board/arm_localize/README.md核对。 | 所在目录说明：[data/evidence/2026-10-03-arm-localize-baseline/arm-board/arm_localize/README.md](../../../data/evidence/2026-10-03-arm-localize-baseline/arm-board/arm_localize/README.md)<br>同名配套文件：[data/evidence/2026-10-03-arm-localize-baseline/arm-board/arm_localize/benchmark/run-nph60lvw/tiny/sample-03-crops-yw_p377k/target_000.pgm](../../../data/evidence/2026-10-03-arm-localize-baseline/arm-board/arm_localize/benchmark/run-nph60lvw/tiny/sample-03-crops-yw_p377k/target_000.pgm) |
| [data/evidence/2026-10-03-arm-localize-baseline/arm-board/arm_localize/benchmark/run-nph60lvw/tiny/sample-03-crops-yw_p377k/target_000.pgm](../../../data/evidence/2026-10-03-arm-localize-baseline/arm-board/arm_localize/benchmark/run-nph60lvw/tiny/sample-03-crops-yw_p377k/target_000.pgm)<br>灰度像素图 · 已纳入Git（含暂存） | 保存target_000的目标ROI裁剪；其合成/文件/实机来源及框/标签含义以data/evidence/2026-10-03-arm-localize-baseline/arm-board/arm_localize/README.md为准。 | 所在目录说明：[data/evidence/2026-10-03-arm-localize-baseline/arm-board/arm_localize/README.md](../../../data/evidence/2026-10-03-arm-localize-baseline/arm-board/arm_localize/README.md)<br>同名配套文件：[data/evidence/2026-10-03-arm-localize-baseline/arm-board/arm_localize/benchmark/run-nph60lvw/tiny/sample-03-crops-yw_p377k/target_000.hex](../../../data/evidence/2026-10-03-arm-localize-baseline/arm-board/arm_localize/benchmark/run-nph60lvw/tiny/sample-03-crops-yw_p377k/target_000.hex) |
| [data/evidence/2026-10-03-arm-localize-baseline/arm-board/arm_localize/benchmark/run-nph60lvw/tiny/sample-03-crops-yw_p377k/target_001.hex](../../../data/evidence/2026-10-03-arm-localize-baseline/arm-board/arm_localize/benchmark/run-nph60lvw/tiny/sample-03-crops-yw_p377k/target_001.hex)<br>十六进制数据 · 已纳入Git（含暂存） | 以十六进制数据形式保存target_001的目标ROI像素；由对应加载器/testbench读取，位宽、排布和端序按data/evidence/2026-10-03-arm-localize-baseline/arm-board/arm_localize/README.md核对。 | 所在目录说明：[data/evidence/2026-10-03-arm-localize-baseline/arm-board/arm_localize/README.md](../../../data/evidence/2026-10-03-arm-localize-baseline/arm-board/arm_localize/README.md)<br>同名配套文件：[data/evidence/2026-10-03-arm-localize-baseline/arm-board/arm_localize/benchmark/run-nph60lvw/tiny/sample-03-crops-yw_p377k/target_001.pgm](../../../data/evidence/2026-10-03-arm-localize-baseline/arm-board/arm_localize/benchmark/run-nph60lvw/tiny/sample-03-crops-yw_p377k/target_001.pgm) |
| [data/evidence/2026-10-03-arm-localize-baseline/arm-board/arm_localize/benchmark/run-nph60lvw/tiny/sample-03-crops-yw_p377k/target_001.pgm](../../../data/evidence/2026-10-03-arm-localize-baseline/arm-board/arm_localize/benchmark/run-nph60lvw/tiny/sample-03-crops-yw_p377k/target_001.pgm)<br>灰度像素图 · 已纳入Git（含暂存） | 保存target_001的目标ROI裁剪；其合成/文件/实机来源及框/标签含义以data/evidence/2026-10-03-arm-localize-baseline/arm-board/arm_localize/README.md为准。 | 所在目录说明：[data/evidence/2026-10-03-arm-localize-baseline/arm-board/arm_localize/README.md](../../../data/evidence/2026-10-03-arm-localize-baseline/arm-board/arm_localize/README.md)<br>同名配套文件：[data/evidence/2026-10-03-arm-localize-baseline/arm-board/arm_localize/benchmark/run-nph60lvw/tiny/sample-03-crops-yw_p377k/target_001.hex](../../../data/evidence/2026-10-03-arm-localize-baseline/arm-board/arm_localize/benchmark/run-nph60lvw/tiny/sample-03-crops-yw_p377k/target_001.hex) |
| **data/evidence/2026-10-03-arm-localize-baseline/arm-board/arm_localize/benchmark/run-nph60lvw/tiny** | | |
| [data/evidence/2026-10-03-arm-localize-baseline/arm-board/arm_localize/benchmark/run-nph60lvw/tiny/sample-03.json](../../../data/evidence/2026-10-03-arm-localize-baseline/arm-board/arm_localize/benchmark/run-nph60lvw/tiny/sample-03.json)<br>结构化结果/元数据 · 已纳入Git（含暂存） | 保存sample-03的实验结果或检查产物，字段包括frame_id、config_id、width、height、status、targets、schema_version；与data/evidence/2026-10-03-arm-localize-baseline/arm-board/arm_localize/README.md中的生成/校验流程一起使用。 | 所在目录说明：[data/evidence/2026-10-03-arm-localize-baseline/arm-board/arm_localize/README.md](../../../data/evidence/2026-10-03-arm-localize-baseline/arm-board/arm_localize/README.md)<br>同目录输入/元数据：[data/evidence/2026-10-03-arm-localize-baseline/arm-board/arm_localize/benchmark/run-nph60lvw/tiny/input.json](../../../data/evidence/2026-10-03-arm-localize-baseline/arm-board/arm_localize/benchmark/run-nph60lvw/tiny/input.json) |
| **data/evidence/2026-10-03-arm-localize-baseline/arm-board/arm_localize/benchmark/run-nph60lvw/tiny/sample-04-crops-a2wo0usy** | | |
| [data/evidence/2026-10-03-arm-localize-baseline/arm-board/arm_localize/benchmark/run-nph60lvw/tiny/sample-04-crops-a2wo0usy/target_000.hex](../../../data/evidence/2026-10-03-arm-localize-baseline/arm-board/arm_localize/benchmark/run-nph60lvw/tiny/sample-04-crops-a2wo0usy/target_000.hex)<br>十六进制数据 · 已纳入Git（含暂存） | 以十六进制数据形式保存target_000的目标ROI像素；由对应加载器/testbench读取，位宽、排布和端序按data/evidence/2026-10-03-arm-localize-baseline/arm-board/arm_localize/README.md核对。 | 所在目录说明：[data/evidence/2026-10-03-arm-localize-baseline/arm-board/arm_localize/README.md](../../../data/evidence/2026-10-03-arm-localize-baseline/arm-board/arm_localize/README.md)<br>同名配套文件：[data/evidence/2026-10-03-arm-localize-baseline/arm-board/arm_localize/benchmark/run-nph60lvw/tiny/sample-04-crops-a2wo0usy/target_000.pgm](../../../data/evidence/2026-10-03-arm-localize-baseline/arm-board/arm_localize/benchmark/run-nph60lvw/tiny/sample-04-crops-a2wo0usy/target_000.pgm) |
| [data/evidence/2026-10-03-arm-localize-baseline/arm-board/arm_localize/benchmark/run-nph60lvw/tiny/sample-04-crops-a2wo0usy/target_000.pgm](../../../data/evidence/2026-10-03-arm-localize-baseline/arm-board/arm_localize/benchmark/run-nph60lvw/tiny/sample-04-crops-a2wo0usy/target_000.pgm)<br>灰度像素图 · 已纳入Git（含暂存） | 保存target_000的目标ROI裁剪；其合成/文件/实机来源及框/标签含义以data/evidence/2026-10-03-arm-localize-baseline/arm-board/arm_localize/README.md为准。 | 所在目录说明：[data/evidence/2026-10-03-arm-localize-baseline/arm-board/arm_localize/README.md](../../../data/evidence/2026-10-03-arm-localize-baseline/arm-board/arm_localize/README.md)<br>同名配套文件：[data/evidence/2026-10-03-arm-localize-baseline/arm-board/arm_localize/benchmark/run-nph60lvw/tiny/sample-04-crops-a2wo0usy/target_000.hex](../../../data/evidence/2026-10-03-arm-localize-baseline/arm-board/arm_localize/benchmark/run-nph60lvw/tiny/sample-04-crops-a2wo0usy/target_000.hex) |
| [data/evidence/2026-10-03-arm-localize-baseline/arm-board/arm_localize/benchmark/run-nph60lvw/tiny/sample-04-crops-a2wo0usy/target_001.hex](../../../data/evidence/2026-10-03-arm-localize-baseline/arm-board/arm_localize/benchmark/run-nph60lvw/tiny/sample-04-crops-a2wo0usy/target_001.hex)<br>十六进制数据 · 已纳入Git（含暂存） | 以十六进制数据形式保存target_001的目标ROI像素；由对应加载器/testbench读取，位宽、排布和端序按data/evidence/2026-10-03-arm-localize-baseline/arm-board/arm_localize/README.md核对。 | 所在目录说明：[data/evidence/2026-10-03-arm-localize-baseline/arm-board/arm_localize/README.md](../../../data/evidence/2026-10-03-arm-localize-baseline/arm-board/arm_localize/README.md)<br>同名配套文件：[data/evidence/2026-10-03-arm-localize-baseline/arm-board/arm_localize/benchmark/run-nph60lvw/tiny/sample-04-crops-a2wo0usy/target_001.pgm](../../../data/evidence/2026-10-03-arm-localize-baseline/arm-board/arm_localize/benchmark/run-nph60lvw/tiny/sample-04-crops-a2wo0usy/target_001.pgm) |
| [data/evidence/2026-10-03-arm-localize-baseline/arm-board/arm_localize/benchmark/run-nph60lvw/tiny/sample-04-crops-a2wo0usy/target_001.pgm](../../../data/evidence/2026-10-03-arm-localize-baseline/arm-board/arm_localize/benchmark/run-nph60lvw/tiny/sample-04-crops-a2wo0usy/target_001.pgm)<br>灰度像素图 · 已纳入Git（含暂存） | 保存target_001的目标ROI裁剪；其合成/文件/实机来源及框/标签含义以data/evidence/2026-10-03-arm-localize-baseline/arm-board/arm_localize/README.md为准。 | 所在目录说明：[data/evidence/2026-10-03-arm-localize-baseline/arm-board/arm_localize/README.md](../../../data/evidence/2026-10-03-arm-localize-baseline/arm-board/arm_localize/README.md)<br>同名配套文件：[data/evidence/2026-10-03-arm-localize-baseline/arm-board/arm_localize/benchmark/run-nph60lvw/tiny/sample-04-crops-a2wo0usy/target_001.hex](../../../data/evidence/2026-10-03-arm-localize-baseline/arm-board/arm_localize/benchmark/run-nph60lvw/tiny/sample-04-crops-a2wo0usy/target_001.hex) |
| **data/evidence/2026-10-03-arm-localize-baseline/arm-board/arm_localize/benchmark/run-nph60lvw/tiny** | | |
| [data/evidence/2026-10-03-arm-localize-baseline/arm-board/arm_localize/benchmark/run-nph60lvw/tiny/sample-04.json](../../../data/evidence/2026-10-03-arm-localize-baseline/arm-board/arm_localize/benchmark/run-nph60lvw/tiny/sample-04.json)<br>结构化结果/元数据 · 已纳入Git（含暂存） | 保存sample-04的实验结果或检查产物，字段包括frame_id、config_id、width、height、status、targets、schema_version；与data/evidence/2026-10-03-arm-localize-baseline/arm-board/arm_localize/README.md中的生成/校验流程一起使用。 | 所在目录说明：[data/evidence/2026-10-03-arm-localize-baseline/arm-board/arm_localize/README.md](../../../data/evidence/2026-10-03-arm-localize-baseline/arm-board/arm_localize/README.md)<br>同目录输入/元数据：[data/evidence/2026-10-03-arm-localize-baseline/arm-board/arm_localize/benchmark/run-nph60lvw/tiny/input.json](../../../data/evidence/2026-10-03-arm-localize-baseline/arm-board/arm_localize/benchmark/run-nph60lvw/tiny/input.json) |
| **data/evidence/2026-10-03-arm-localize-baseline/arm-board/arm_localize/benchmark/run-nph60lvw/tiny/warmup-00-crops-axhz7dfm** | | |
| [data/evidence/2026-10-03-arm-localize-baseline/arm-board/arm_localize/benchmark/run-nph60lvw/tiny/warmup-00-crops-axhz7dfm/target_000.hex](../../../data/evidence/2026-10-03-arm-localize-baseline/arm-board/arm_localize/benchmark/run-nph60lvw/tiny/warmup-00-crops-axhz7dfm/target_000.hex)<br>十六进制数据 · 已纳入Git（含暂存） | 以十六进制数据形式保存target_000的目标ROI像素；由对应加载器/testbench读取，位宽、排布和端序按data/evidence/2026-10-03-arm-localize-baseline/arm-board/arm_localize/README.md核对。 | 所在目录说明：[data/evidence/2026-10-03-arm-localize-baseline/arm-board/arm_localize/README.md](../../../data/evidence/2026-10-03-arm-localize-baseline/arm-board/arm_localize/README.md)<br>同名配套文件：[data/evidence/2026-10-03-arm-localize-baseline/arm-board/arm_localize/benchmark/run-nph60lvw/tiny/warmup-00-crops-axhz7dfm/target_000.pgm](../../../data/evidence/2026-10-03-arm-localize-baseline/arm-board/arm_localize/benchmark/run-nph60lvw/tiny/warmup-00-crops-axhz7dfm/target_000.pgm) |
| [data/evidence/2026-10-03-arm-localize-baseline/arm-board/arm_localize/benchmark/run-nph60lvw/tiny/warmup-00-crops-axhz7dfm/target_000.pgm](../../../data/evidence/2026-10-03-arm-localize-baseline/arm-board/arm_localize/benchmark/run-nph60lvw/tiny/warmup-00-crops-axhz7dfm/target_000.pgm)<br>灰度像素图 · 已纳入Git（含暂存） | 保存target_000的目标ROI裁剪；其合成/文件/实机来源及框/标签含义以data/evidence/2026-10-03-arm-localize-baseline/arm-board/arm_localize/README.md为准。 | 所在目录说明：[data/evidence/2026-10-03-arm-localize-baseline/arm-board/arm_localize/README.md](../../../data/evidence/2026-10-03-arm-localize-baseline/arm-board/arm_localize/README.md)<br>同名配套文件：[data/evidence/2026-10-03-arm-localize-baseline/arm-board/arm_localize/benchmark/run-nph60lvw/tiny/warmup-00-crops-axhz7dfm/target_000.hex](../../../data/evidence/2026-10-03-arm-localize-baseline/arm-board/arm_localize/benchmark/run-nph60lvw/tiny/warmup-00-crops-axhz7dfm/target_000.hex) |
| [data/evidence/2026-10-03-arm-localize-baseline/arm-board/arm_localize/benchmark/run-nph60lvw/tiny/warmup-00-crops-axhz7dfm/target_001.hex](../../../data/evidence/2026-10-03-arm-localize-baseline/arm-board/arm_localize/benchmark/run-nph60lvw/tiny/warmup-00-crops-axhz7dfm/target_001.hex)<br>十六进制数据 · 已纳入Git（含暂存） | 以十六进制数据形式保存target_001的目标ROI像素；由对应加载器/testbench读取，位宽、排布和端序按data/evidence/2026-10-03-arm-localize-baseline/arm-board/arm_localize/README.md核对。 | 所在目录说明：[data/evidence/2026-10-03-arm-localize-baseline/arm-board/arm_localize/README.md](../../../data/evidence/2026-10-03-arm-localize-baseline/arm-board/arm_localize/README.md)<br>同名配套文件：[data/evidence/2026-10-03-arm-localize-baseline/arm-board/arm_localize/benchmark/run-nph60lvw/tiny/warmup-00-crops-axhz7dfm/target_001.pgm](../../../data/evidence/2026-10-03-arm-localize-baseline/arm-board/arm_localize/benchmark/run-nph60lvw/tiny/warmup-00-crops-axhz7dfm/target_001.pgm) |
| [data/evidence/2026-10-03-arm-localize-baseline/arm-board/arm_localize/benchmark/run-nph60lvw/tiny/warmup-00-crops-axhz7dfm/target_001.pgm](../../../data/evidence/2026-10-03-arm-localize-baseline/arm-board/arm_localize/benchmark/run-nph60lvw/tiny/warmup-00-crops-axhz7dfm/target_001.pgm)<br>灰度像素图 · 已纳入Git（含暂存） | 保存target_001的目标ROI裁剪；其合成/文件/实机来源及框/标签含义以data/evidence/2026-10-03-arm-localize-baseline/arm-board/arm_localize/README.md为准。 | 所在目录说明：[data/evidence/2026-10-03-arm-localize-baseline/arm-board/arm_localize/README.md](../../../data/evidence/2026-10-03-arm-localize-baseline/arm-board/arm_localize/README.md)<br>同名配套文件：[data/evidence/2026-10-03-arm-localize-baseline/arm-board/arm_localize/benchmark/run-nph60lvw/tiny/warmup-00-crops-axhz7dfm/target_001.hex](../../../data/evidence/2026-10-03-arm-localize-baseline/arm-board/arm_localize/benchmark/run-nph60lvw/tiny/warmup-00-crops-axhz7dfm/target_001.hex) |
| **data/evidence/2026-10-03-arm-localize-baseline/arm-board/arm_localize/benchmark/run-nph60lvw/tiny** | | |
| [data/evidence/2026-10-03-arm-localize-baseline/arm-board/arm_localize/benchmark/run-nph60lvw/tiny/warmup-00.json](../../../data/evidence/2026-10-03-arm-localize-baseline/arm-board/arm_localize/benchmark/run-nph60lvw/tiny/warmup-00.json)<br>结构化结果/元数据 · 已纳入Git（含暂存） | 保存warmup-00的实验结果或检查产物，字段包括frame_id、config_id、width、height、status、targets、schema_version；与data/evidence/2026-10-03-arm-localize-baseline/arm-board/arm_localize/README.md中的生成/校验流程一起使用。 | 所在目录说明：[data/evidence/2026-10-03-arm-localize-baseline/arm-board/arm_localize/README.md](../../../data/evidence/2026-10-03-arm-localize-baseline/arm-board/arm_localize/README.md)<br>同目录输入/元数据：[data/evidence/2026-10-03-arm-localize-baseline/arm-board/arm_localize/benchmark/run-nph60lvw/tiny/input.json](../../../data/evidence/2026-10-03-arm-localize-baseline/arm-board/arm_localize/benchmark/run-nph60lvw/tiny/input.json) |
| **data/evidence/2026-10-03-arm-localize-baseline/arm-board/arm_localize/benchmark** | | |
| [data/evidence/2026-10-03-arm-localize-baseline/arm-board/arm_localize/benchmark/summary.json](../../../data/evidence/2026-10-03-arm-localize-baseline/arm-board/arm_localize/benchmark/summary.json)<br>结构化结果/元数据 · 已纳入Git（含暂存） | 保存summary的实验结果或检查产物，字段包括schema_version、mode、utc、warmup、repeats、crop_size、p95_method；与data/evidence/2026-10-03-arm-localize-baseline/arm-board/arm_localize/README.md中的生成/校验流程一起使用。 | 所在目录说明：[data/evidence/2026-10-03-arm-localize-baseline/arm-board/arm_localize/README.md](../../../data/evidence/2026-10-03-arm-localize-baseline/arm-board/arm_localize/README.md) |
| **data/evidence/2026-10-03-arm-localize-baseline/arm-board/arm_localize/final-result-crops-d7m8oat_** | | |
| [data/evidence/2026-10-03-arm-localize-baseline/arm-board/arm_localize/final-result-crops-d7m8oat_/target_000.hex](../../../data/evidence/2026-10-03-arm-localize-baseline/arm-board/arm_localize/final-result-crops-d7m8oat_/target_000.hex)<br>十六进制数据 · 已纳入Git（含暂存） | 以十六进制数据形式保存target_000的目标ROI像素；由对应加载器/testbench读取，位宽、排布和端序按data/evidence/2026-10-03-arm-localize-baseline/arm-board/arm_localize/README.md核对。 | 所在目录说明：[data/evidence/2026-10-03-arm-localize-baseline/arm-board/arm_localize/README.md](../../../data/evidence/2026-10-03-arm-localize-baseline/arm-board/arm_localize/README.md)<br>同名配套文件：[data/evidence/2026-10-03-arm-localize-baseline/arm-board/arm_localize/final-result-crops-d7m8oat_/target_000.pgm](../../../data/evidence/2026-10-03-arm-localize-baseline/arm-board/arm_localize/final-result-crops-d7m8oat_/target_000.pgm) |
| [data/evidence/2026-10-03-arm-localize-baseline/arm-board/arm_localize/final-result-crops-d7m8oat_/target_000.pgm](../../../data/evidence/2026-10-03-arm-localize-baseline/arm-board/arm_localize/final-result-crops-d7m8oat_/target_000.pgm)<br>灰度像素图 · 已纳入Git（含暂存） | 保存target_000的目标ROI裁剪；其合成/文件/实机来源及框/标签含义以data/evidence/2026-10-03-arm-localize-baseline/arm-board/arm_localize/README.md为准。 | 所在目录说明：[data/evidence/2026-10-03-arm-localize-baseline/arm-board/arm_localize/README.md](../../../data/evidence/2026-10-03-arm-localize-baseline/arm-board/arm_localize/README.md)<br>同名配套文件：[data/evidence/2026-10-03-arm-localize-baseline/arm-board/arm_localize/final-result-crops-d7m8oat_/target_000.hex](../../../data/evidence/2026-10-03-arm-localize-baseline/arm-board/arm_localize/final-result-crops-d7m8oat_/target_000.hex) |
| [data/evidence/2026-10-03-arm-localize-baseline/arm-board/arm_localize/final-result-crops-d7m8oat_/target_001.hex](../../../data/evidence/2026-10-03-arm-localize-baseline/arm-board/arm_localize/final-result-crops-d7m8oat_/target_001.hex)<br>十六进制数据 · 已纳入Git（含暂存） | 以十六进制数据形式保存target_001的目标ROI像素；由对应加载器/testbench读取，位宽、排布和端序按data/evidence/2026-10-03-arm-localize-baseline/arm-board/arm_localize/README.md核对。 | 所在目录说明：[data/evidence/2026-10-03-arm-localize-baseline/arm-board/arm_localize/README.md](../../../data/evidence/2026-10-03-arm-localize-baseline/arm-board/arm_localize/README.md)<br>同名配套文件：[data/evidence/2026-10-03-arm-localize-baseline/arm-board/arm_localize/final-result-crops-d7m8oat_/target_001.pgm](../../../data/evidence/2026-10-03-arm-localize-baseline/arm-board/arm_localize/final-result-crops-d7m8oat_/target_001.pgm) |
| [data/evidence/2026-10-03-arm-localize-baseline/arm-board/arm_localize/final-result-crops-d7m8oat_/target_001.pgm](../../../data/evidence/2026-10-03-arm-localize-baseline/arm-board/arm_localize/final-result-crops-d7m8oat_/target_001.pgm)<br>灰度像素图 · 已纳入Git（含暂存） | 保存target_001的目标ROI裁剪；其合成/文件/实机来源及框/标签含义以data/evidence/2026-10-03-arm-localize-baseline/arm-board/arm_localize/README.md为准。 | 所在目录说明：[data/evidence/2026-10-03-arm-localize-baseline/arm-board/arm_localize/README.md](../../../data/evidence/2026-10-03-arm-localize-baseline/arm-board/arm_localize/README.md)<br>同名配套文件：[data/evidence/2026-10-03-arm-localize-baseline/arm-board/arm_localize/final-result-crops-d7m8oat_/target_001.hex](../../../data/evidence/2026-10-03-arm-localize-baseline/arm-board/arm_localize/final-result-crops-d7m8oat_/target_001.hex) |
| **data/evidence/2026-10-03-arm-localize-baseline/arm-board/arm_localize** | | |
| [data/evidence/2026-10-03-arm-localize-baseline/arm-board/arm_localize/final-result.json](../../../data/evidence/2026-10-03-arm-localize-baseline/arm-board/arm_localize/final-result.json)<br>结构化结果/元数据 · 已纳入Git（含暂存） | 保存final-result的实验结果或检查产物，字段包括frame_id、config_id、width、height、status、targets、schema_version；与data/evidence/2026-10-03-arm-localize-baseline/arm-board/arm_localize/README.md中的生成/校验流程一起使用。 | 所在目录说明：[data/evidence/2026-10-03-arm-localize-baseline/arm-board/arm_localize/README.md](../../../data/evidence/2026-10-03-arm-localize-baseline/arm-board/arm_localize/README.md)<br>同目录输入/元数据：[data/evidence/2026-10-03-arm-localize-baseline/arm-board/arm_localize/manifest.json](../../../data/evidence/2026-10-03-arm-localize-baseline/arm-board/arm_localize/manifest.json) |
| [data/evidence/2026-10-03-arm-localize-baseline/arm-board/arm_localize/manifest.json](../../../data/evidence/2026-10-03-arm-localize-baseline/arm-board/arm_localize/manifest.json)<br>结构化结果/元数据 · 已纳入Git（含暂存） | 保存manifest的文件清单及完整性信息，字段包括schema_version、base_commit、files；与data/evidence/2026-10-03-arm-localize-baseline/arm-board/arm_localize/README.md中的生成/校验流程一起使用。 | 所在目录说明：[data/evidence/2026-10-03-arm-localize-baseline/arm-board/arm_localize/README.md](../../../data/evidence/2026-10-03-arm-localize-baseline/arm-board/arm_localize/README.md) |
| [data/evidence/2026-10-03-arm-localize-baseline/arm-board/arm_localize/reference.py](../../../data/evidence/2026-10-03-arm-localize-baseline/arm-board/arm_localize/reference.py)<br>归档源码/输入副本 · 已纳入Git（含暂存） | 这是该轮保存的源码/配置副本：实现/配置reference相关流程，定义locate、crop_resize、coord、prepare_targets；实际导入、例化和文本引用见关联栏，与data/evidence/2026-10-03-arm-localize-baseline/arm-board/arm_localize/README.md配套阅读；所属实验与当前入口以关联栏区分。 | 所在目录说明：[data/evidence/2026-10-03-arm-localize-baseline/arm-board/arm_localize/README.md](../../../data/evidence/2026-10-03-arm-localize-baseline/arm-board/arm_localize/README.md)<br>同目录输入/元数据：[data/evidence/2026-10-03-arm-localize-baseline/arm-board/arm_localize/manifest.json](../../../data/evidence/2026-10-03-arm-localize-baseline/arm-board/arm_localize/manifest.json) |
| **data/evidence/2026-10-03-arm-localize-baseline/arm-board/arm_localize/selftest-evidence/result-crops-sraz2dul** | | |
| [data/evidence/2026-10-03-arm-localize-baseline/arm-board/arm_localize/selftest-evidence/result-crops-sraz2dul/target_000.hex](../../../data/evidence/2026-10-03-arm-localize-baseline/arm-board/arm_localize/selftest-evidence/result-crops-sraz2dul/target_000.hex)<br>十六进制数据 · 已纳入Git（含暂存） | 以十六进制数据形式保存target_000的目标ROI像素；由对应加载器/testbench读取，位宽、排布和端序按data/evidence/2026-10-03-arm-localize-baseline/arm-board/arm_localize/README.md核对。 | 所在目录说明：[data/evidence/2026-10-03-arm-localize-baseline/arm-board/arm_localize/README.md](../../../data/evidence/2026-10-03-arm-localize-baseline/arm-board/arm_localize/README.md)<br>同名配套文件：[data/evidence/2026-10-03-arm-localize-baseline/arm-board/arm_localize/selftest-evidence/result-crops-sraz2dul/target_000.pgm](../../../data/evidence/2026-10-03-arm-localize-baseline/arm-board/arm_localize/selftest-evidence/result-crops-sraz2dul/target_000.pgm) |
| [data/evidence/2026-10-03-arm-localize-baseline/arm-board/arm_localize/selftest-evidence/result-crops-sraz2dul/target_000.pgm](../../../data/evidence/2026-10-03-arm-localize-baseline/arm-board/arm_localize/selftest-evidence/result-crops-sraz2dul/target_000.pgm)<br>灰度像素图 · 已纳入Git（含暂存） | 保存target_000的目标ROI裁剪；其合成/文件/实机来源及框/标签含义以data/evidence/2026-10-03-arm-localize-baseline/arm-board/arm_localize/README.md为准。 | 所在目录说明：[data/evidence/2026-10-03-arm-localize-baseline/arm-board/arm_localize/README.md](../../../data/evidence/2026-10-03-arm-localize-baseline/arm-board/arm_localize/README.md)<br>同名配套文件：[data/evidence/2026-10-03-arm-localize-baseline/arm-board/arm_localize/selftest-evidence/result-crops-sraz2dul/target_000.hex](../../../data/evidence/2026-10-03-arm-localize-baseline/arm-board/arm_localize/selftest-evidence/result-crops-sraz2dul/target_000.hex) |
| [data/evidence/2026-10-03-arm-localize-baseline/arm-board/arm_localize/selftest-evidence/result-crops-sraz2dul/target_001.hex](../../../data/evidence/2026-10-03-arm-localize-baseline/arm-board/arm_localize/selftest-evidence/result-crops-sraz2dul/target_001.hex)<br>十六进制数据 · 已纳入Git（含暂存） | 以十六进制数据形式保存target_001的目标ROI像素；由对应加载器/testbench读取，位宽、排布和端序按data/evidence/2026-10-03-arm-localize-baseline/arm-board/arm_localize/README.md核对。 | 所在目录说明：[data/evidence/2026-10-03-arm-localize-baseline/arm-board/arm_localize/README.md](../../../data/evidence/2026-10-03-arm-localize-baseline/arm-board/arm_localize/README.md)<br>同名配套文件：[data/evidence/2026-10-03-arm-localize-baseline/arm-board/arm_localize/selftest-evidence/result-crops-sraz2dul/target_001.pgm](../../../data/evidence/2026-10-03-arm-localize-baseline/arm-board/arm_localize/selftest-evidence/result-crops-sraz2dul/target_001.pgm) |
| [data/evidence/2026-10-03-arm-localize-baseline/arm-board/arm_localize/selftest-evidence/result-crops-sraz2dul/target_001.pgm](../../../data/evidence/2026-10-03-arm-localize-baseline/arm-board/arm_localize/selftest-evidence/result-crops-sraz2dul/target_001.pgm)<br>灰度像素图 · 已纳入Git（含暂存） | 保存target_001的目标ROI裁剪；其合成/文件/实机来源及框/标签含义以data/evidence/2026-10-03-arm-localize-baseline/arm-board/arm_localize/README.md为准。 | 所在目录说明：[data/evidence/2026-10-03-arm-localize-baseline/arm-board/arm_localize/README.md](../../../data/evidence/2026-10-03-arm-localize-baseline/arm-board/arm_localize/README.md)<br>同名配套文件：[data/evidence/2026-10-03-arm-localize-baseline/arm-board/arm_localize/selftest-evidence/result-crops-sraz2dul/target_001.hex](../../../data/evidence/2026-10-03-arm-localize-baseline/arm-board/arm_localize/selftest-evidence/result-crops-sraz2dul/target_001.hex) |
| **data/evidence/2026-10-03-arm-localize-baseline/arm-board/arm_localize/selftest-evidence** | | |
| [data/evidence/2026-10-03-arm-localize-baseline/arm-board/arm_localize/selftest-evidence/result.json](../../../data/evidence/2026-10-03-arm-localize-baseline/arm-board/arm_localize/selftest-evidence/result.json)<br>结构化结果/元数据 · 已纳入Git（含暂存） | 保存result的实验结果或检查产物，字段包括frame_id、config_id、width、height、status、targets、schema_version；与data/evidence/2026-10-03-arm-localize-baseline/arm-board/arm_localize/README.md中的生成/校验流程一起使用。 | 所在目录说明：[data/evidence/2026-10-03-arm-localize-baseline/arm-board/arm_localize/README.md](../../../data/evidence/2026-10-03-arm-localize-baseline/arm-board/arm_localize/README.md) |
| **data/evidence/2026-10-03-arm-localize-baseline/arm-board/arm_localize** | | |
| [data/evidence/2026-10-03-arm-localize-baseline/arm-board/arm_localize/two_targets.json](../../../data/evidence/2026-10-03-arm-localize-baseline/arm-board/arm_localize/two_targets.json)<br>结构化结果/元数据 · 已纳入Git（含暂存） | 保存two_targets的实验结果或检查产物，字段包括pixels；与data/evidence/2026-10-03-arm-localize-baseline/arm-board/arm_localize/README.md中的生成/校验流程一起使用。 | 所在目录说明：[data/evidence/2026-10-03-arm-localize-baseline/arm-board/arm_localize/README.md](../../../data/evidence/2026-10-03-arm-localize-baseline/arm-board/arm_localize/README.md)<br>同目录输入/元数据：[data/evidence/2026-10-03-arm-localize-baseline/arm-board/arm_localize/manifest.json](../../../data/evidence/2026-10-03-arm-localize-baseline/arm-board/arm_localize/manifest.json) |
| **data/evidence/2026-10-03-arm-localize-baseline** | | |
| [data/evidence/2026-10-03-arm-localize-baseline/arm-localize-package.tar.gz](../../../data/evidence/2026-10-03-arm-localize-baseline/arm-localize-package.tar.gz)<br>压缩交接包 · 已纳入Git（含暂存） | 把arm-localize-package相关源码/数据/结果集合打成gzip tar包；与data/evidence/2026-10-03-arm-localize-baseline/README.md的移交/哈希记录配套，不需当作单个源文件编辑。 | 所在目录说明：[data/evidence/2026-10-03-arm-localize-baseline/README.md](../../../data/evidence/2026-10-03-arm-localize-baseline/README.md) |
| [data/evidence/2026-10-03-arm-localize-baseline/arm-result.json](../../../data/evidence/2026-10-03-arm-localize-baseline/arm-result.json)<br>结构化结果/元数据 · 已纳入Git（含暂存） | 保存arm-result的实验结果或检查产物，字段包括frame_id、config_id、width、height、status、targets、schema_version；与data/evidence/2026-10-03-arm-localize-baseline/README.md中的生成/校验流程一起使用。 | 所在目录说明：[data/evidence/2026-10-03-arm-localize-baseline/README.md](../../../data/evidence/2026-10-03-arm-localize-baseline/README.md) |
| [data/evidence/2026-10-03-arm-localize-baseline/arm-results-final.tar.gz](../../../data/evidence/2026-10-03-arm-localize-baseline/arm-results-final.tar.gz)<br>压缩交接包 · 已纳入Git（含暂存） | 把arm-results-final相关源码/数据/结果集合打成gzip tar包；与data/evidence/2026-10-03-arm-localize-baseline/README.md的移交/哈希记录配套，不需当作单个源文件编辑。 | 所在目录说明：[data/evidence/2026-10-03-arm-localize-baseline/README.md](../../../data/evidence/2026-10-03-arm-localize-baseline/README.md) |
| [data/evidence/2026-10-03-arm-localize-baseline/arm-results.tar.gz](../../../data/evidence/2026-10-03-arm-localize-baseline/arm-results.tar.gz)<br>压缩交接包 · 已纳入Git（含暂存） | 把arm-results相关源码/数据/结果集合打成gzip tar包；与data/evidence/2026-10-03-arm-localize-baseline/README.md的移交/哈希记录配套，不需当作单个源文件编辑。 | 所在目录说明：[data/evidence/2026-10-03-arm-localize-baseline/README.md](../../../data/evidence/2026-10-03-arm-localize-baseline/README.md) |
| [data/evidence/2026-10-03-arm-localize-baseline/final-package-manifest.json](../../../data/evidence/2026-10-03-arm-localize-baseline/final-package-manifest.json)<br>结构化结果/元数据 · 已纳入Git（含暂存） | 保存final-package-manifest的文件清单及完整性信息，字段包括schema_version、base_commit、files；与data/evidence/2026-10-03-arm-localize-baseline/README.md中的生成/校验流程一起使用。 | 所在目录说明：[data/evidence/2026-10-03-arm-localize-baseline/README.md](../../../data/evidence/2026-10-03-arm-localize-baseline/README.md) |
| **data/evidence/2026-10-03-arm-localize-baseline/final-pc-result-crops-anpbx_ov** | | |
| [data/evidence/2026-10-03-arm-localize-baseline/final-pc-result-crops-anpbx_ov/target_000.pgm](../../../data/evidence/2026-10-03-arm-localize-baseline/final-pc-result-crops-anpbx_ov/target_000.pgm)<br>灰度像素图 · 已纳入Git（含暂存） | 保存target_000的目标ROI裁剪；其合成/文件/实机来源及框/标签含义以data/evidence/2026-10-03-arm-localize-baseline/README.md为准。 | 所在目录说明：[data/evidence/2026-10-03-arm-localize-baseline/README.md](../../../data/evidence/2026-10-03-arm-localize-baseline/README.md) |
| **data/evidence/2026-10-03-arm-localize-baseline/final-pc-result-crops-spvvpr5t** | | |
| [data/evidence/2026-10-03-arm-localize-baseline/final-pc-result-crops-spvvpr5t/target_000.hex](../../../data/evidence/2026-10-03-arm-localize-baseline/final-pc-result-crops-spvvpr5t/target_000.hex)<br>十六进制数据 · 已纳入Git（含暂存） | 以十六进制数据形式保存target_000的目标ROI像素；由对应加载器/testbench读取，位宽、排布和端序按data/evidence/2026-10-03-arm-localize-baseline/README.md核对。 | 所在目录说明：[data/evidence/2026-10-03-arm-localize-baseline/README.md](../../../data/evidence/2026-10-03-arm-localize-baseline/README.md)<br>同名配套文件：[data/evidence/2026-10-03-arm-localize-baseline/final-pc-result-crops-spvvpr5t/target_000.pgm](../../../data/evidence/2026-10-03-arm-localize-baseline/final-pc-result-crops-spvvpr5t/target_000.pgm) |
| [data/evidence/2026-10-03-arm-localize-baseline/final-pc-result-crops-spvvpr5t/target_000.pgm](../../../data/evidence/2026-10-03-arm-localize-baseline/final-pc-result-crops-spvvpr5t/target_000.pgm)<br>灰度像素图 · 已纳入Git（含暂存） | 保存target_000的目标ROI裁剪；其合成/文件/实机来源及框/标签含义以data/evidence/2026-10-03-arm-localize-baseline/README.md为准。 | 所在目录说明：[data/evidence/2026-10-03-arm-localize-baseline/README.md](../../../data/evidence/2026-10-03-arm-localize-baseline/README.md)<br>同名配套文件：[data/evidence/2026-10-03-arm-localize-baseline/final-pc-result-crops-spvvpr5t/target_000.hex](../../../data/evidence/2026-10-03-arm-localize-baseline/final-pc-result-crops-spvvpr5t/target_000.hex) |
| [data/evidence/2026-10-03-arm-localize-baseline/final-pc-result-crops-spvvpr5t/target_001.hex](../../../data/evidence/2026-10-03-arm-localize-baseline/final-pc-result-crops-spvvpr5t/target_001.hex)<br>十六进制数据 · 已纳入Git（含暂存） | 以十六进制数据形式保存target_001的目标ROI像素；由对应加载器/testbench读取，位宽、排布和端序按data/evidence/2026-10-03-arm-localize-baseline/README.md核对。 | 所在目录说明：[data/evidence/2026-10-03-arm-localize-baseline/README.md](../../../data/evidence/2026-10-03-arm-localize-baseline/README.md)<br>同名配套文件：[data/evidence/2026-10-03-arm-localize-baseline/final-pc-result-crops-spvvpr5t/target_001.pgm](../../../data/evidence/2026-10-03-arm-localize-baseline/final-pc-result-crops-spvvpr5t/target_001.pgm) |
| [data/evidence/2026-10-03-arm-localize-baseline/final-pc-result-crops-spvvpr5t/target_001.pgm](../../../data/evidence/2026-10-03-arm-localize-baseline/final-pc-result-crops-spvvpr5t/target_001.pgm)<br>灰度像素图 · 已纳入Git（含暂存） | 保存target_001的目标ROI裁剪；其合成/文件/实机来源及框/标签含义以data/evidence/2026-10-03-arm-localize-baseline/README.md为准。 | 所在目录说明：[data/evidence/2026-10-03-arm-localize-baseline/README.md](../../../data/evidence/2026-10-03-arm-localize-baseline/README.md)<br>同名配套文件：[data/evidence/2026-10-03-arm-localize-baseline/final-pc-result-crops-spvvpr5t/target_001.hex](../../../data/evidence/2026-10-03-arm-localize-baseline/final-pc-result-crops-spvvpr5t/target_001.hex) |
| **data/evidence/2026-10-03-arm-localize-baseline** | | |
| [data/evidence/2026-10-03-arm-localize-baseline/final-pc-result.json](../../../data/evidence/2026-10-03-arm-localize-baseline/final-pc-result.json)<br>结构化结果/元数据 · 已纳入Git（含暂存） | 保存final-pc-result的实验结果或检查产物，字段包括frame_id、config_id、width、height、status、targets、schema_version；与data/evidence/2026-10-03-arm-localize-baseline/README.md中的生成/校验流程一起使用。 | 所在目录说明：[data/evidence/2026-10-03-arm-localize-baseline/README.md](../../../data/evidence/2026-10-03-arm-localize-baseline/README.md) |
| **data/evidence/2026-10-03-arm-localize-baseline/pc-benchmark/run-15c1q9l_/720p_empty** | | |
| [data/evidence/2026-10-03-arm-localize-baseline/pc-benchmark/run-15c1q9l_/720p_empty/input.json](../../../data/evidence/2026-10-03-arm-localize-baseline/pc-benchmark/run-15c1q9l_/720p_empty/input.json)<br>结构化结果/元数据 · 已纳入Git（含暂存） | 保存input的输入/设备/运行元数据，字段包括具体字段；与data/evidence/2026-10-03-arm-localize-baseline/README.md中的生成/校验流程一起使用。 | 所在目录说明：[data/evidence/2026-10-03-arm-localize-baseline/README.md](../../../data/evidence/2026-10-03-arm-localize-baseline/README.md) |
| [data/evidence/2026-10-03-arm-localize-baseline/pc-benchmark/run-15c1q9l_/720p_empty/sample-00.json](../../../data/evidence/2026-10-03-arm-localize-baseline/pc-benchmark/run-15c1q9l_/720p_empty/sample-00.json)<br>结构化结果/元数据 · 已纳入Git（含暂存） | 保存sample-00的实验结果或检查产物，字段包括frame_id、config_id、width、height、status、targets、schema_version；与data/evidence/2026-10-03-arm-localize-baseline/README.md中的生成/校验流程一起使用。 | 所在目录说明：[data/evidence/2026-10-03-arm-localize-baseline/README.md](../../../data/evidence/2026-10-03-arm-localize-baseline/README.md)<br>同目录输入/元数据：[data/evidence/2026-10-03-arm-localize-baseline/pc-benchmark/run-15c1q9l_/720p_empty/input.json](../../../data/evidence/2026-10-03-arm-localize-baseline/pc-benchmark/run-15c1q9l_/720p_empty/input.json) |
| [data/evidence/2026-10-03-arm-localize-baseline/pc-benchmark/run-15c1q9l_/720p_empty/sample-01.json](../../../data/evidence/2026-10-03-arm-localize-baseline/pc-benchmark/run-15c1q9l_/720p_empty/sample-01.json)<br>结构化结果/元数据 · 已纳入Git（含暂存） | 保存sample-01的实验结果或检查产物，字段包括frame_id、config_id、width、height、status、targets、schema_version；与data/evidence/2026-10-03-arm-localize-baseline/README.md中的生成/校验流程一起使用。 | 所在目录说明：[data/evidence/2026-10-03-arm-localize-baseline/README.md](../../../data/evidence/2026-10-03-arm-localize-baseline/README.md)<br>同目录输入/元数据：[data/evidence/2026-10-03-arm-localize-baseline/pc-benchmark/run-15c1q9l_/720p_empty/input.json](../../../data/evidence/2026-10-03-arm-localize-baseline/pc-benchmark/run-15c1q9l_/720p_empty/input.json) |
| [data/evidence/2026-10-03-arm-localize-baseline/pc-benchmark/run-15c1q9l_/720p_empty/sample-02.json](../../../data/evidence/2026-10-03-arm-localize-baseline/pc-benchmark/run-15c1q9l_/720p_empty/sample-02.json)<br>结构化结果/元数据 · 已纳入Git（含暂存） | 保存sample-02的实验结果或检查产物，字段包括frame_id、config_id、width、height、status、targets、schema_version；与data/evidence/2026-10-03-arm-localize-baseline/README.md中的生成/校验流程一起使用。 | 所在目录说明：[data/evidence/2026-10-03-arm-localize-baseline/README.md](../../../data/evidence/2026-10-03-arm-localize-baseline/README.md)<br>同目录输入/元数据：[data/evidence/2026-10-03-arm-localize-baseline/pc-benchmark/run-15c1q9l_/720p_empty/input.json](../../../data/evidence/2026-10-03-arm-localize-baseline/pc-benchmark/run-15c1q9l_/720p_empty/input.json) |
| [data/evidence/2026-10-03-arm-localize-baseline/pc-benchmark/run-15c1q9l_/720p_empty/sample-03.json](../../../data/evidence/2026-10-03-arm-localize-baseline/pc-benchmark/run-15c1q9l_/720p_empty/sample-03.json)<br>结构化结果/元数据 · 已纳入Git（含暂存） | 保存sample-03的实验结果或检查产物，字段包括frame_id、config_id、width、height、status、targets、schema_version；与data/evidence/2026-10-03-arm-localize-baseline/README.md中的生成/校验流程一起使用。 | 所在目录说明：[data/evidence/2026-10-03-arm-localize-baseline/README.md](../../../data/evidence/2026-10-03-arm-localize-baseline/README.md)<br>同目录输入/元数据：[data/evidence/2026-10-03-arm-localize-baseline/pc-benchmark/run-15c1q9l_/720p_empty/input.json](../../../data/evidence/2026-10-03-arm-localize-baseline/pc-benchmark/run-15c1q9l_/720p_empty/input.json) |
| [data/evidence/2026-10-03-arm-localize-baseline/pc-benchmark/run-15c1q9l_/720p_empty/sample-04.json](../../../data/evidence/2026-10-03-arm-localize-baseline/pc-benchmark/run-15c1q9l_/720p_empty/sample-04.json)<br>结构化结果/元数据 · 已纳入Git（含暂存） | 保存sample-04的实验结果或检查产物，字段包括frame_id、config_id、width、height、status、targets、schema_version；与data/evidence/2026-10-03-arm-localize-baseline/README.md中的生成/校验流程一起使用。 | 所在目录说明：[data/evidence/2026-10-03-arm-localize-baseline/README.md](../../../data/evidence/2026-10-03-arm-localize-baseline/README.md)<br>同目录输入/元数据：[data/evidence/2026-10-03-arm-localize-baseline/pc-benchmark/run-15c1q9l_/720p_empty/input.json](../../../data/evidence/2026-10-03-arm-localize-baseline/pc-benchmark/run-15c1q9l_/720p_empty/input.json) |
| [data/evidence/2026-10-03-arm-localize-baseline/pc-benchmark/run-15c1q9l_/720p_empty/warmup-00.json](../../../data/evidence/2026-10-03-arm-localize-baseline/pc-benchmark/run-15c1q9l_/720p_empty/warmup-00.json)<br>结构化结果/元数据 · 已纳入Git（含暂存） | 保存warmup-00的实验结果或检查产物，字段包括frame_id、config_id、width、height、status、targets、schema_version；与data/evidence/2026-10-03-arm-localize-baseline/README.md中的生成/校验流程一起使用。 | 所在目录说明：[data/evidence/2026-10-03-arm-localize-baseline/README.md](../../../data/evidence/2026-10-03-arm-localize-baseline/README.md)<br>同目录输入/元数据：[data/evidence/2026-10-03-arm-localize-baseline/pc-benchmark/run-15c1q9l_/720p_empty/input.json](../../../data/evidence/2026-10-03-arm-localize-baseline/pc-benchmark/run-15c1q9l_/720p_empty/input.json) |
| **data/evidence/2026-10-03-arm-localize-baseline/pc-benchmark/run-15c1q9l_/720p_six** | | |
| [data/evidence/2026-10-03-arm-localize-baseline/pc-benchmark/run-15c1q9l_/720p_six/input.json](../../../data/evidence/2026-10-03-arm-localize-baseline/pc-benchmark/run-15c1q9l_/720p_six/input.json)<br>结构化结果/元数据 · 已纳入Git（含暂存） | 保存input的输入/设备/运行元数据，字段包括具体字段；与data/evidence/2026-10-03-arm-localize-baseline/README.md中的生成/校验流程一起使用。 | 所在目录说明：[data/evidence/2026-10-03-arm-localize-baseline/README.md](../../../data/evidence/2026-10-03-arm-localize-baseline/README.md) |
| **data/evidence/2026-10-03-arm-localize-baseline/pc-benchmark/run-15c1q9l_/720p_six/sample-00-crops-zz8wxgpb** | | |
| [data/evidence/2026-10-03-arm-localize-baseline/pc-benchmark/run-15c1q9l_/720p_six/sample-00-crops-zz8wxgpb/target_000.hex](../../../data/evidence/2026-10-03-arm-localize-baseline/pc-benchmark/run-15c1q9l_/720p_six/sample-00-crops-zz8wxgpb/target_000.hex)<br>十六进制数据 · 已纳入Git（含暂存） | 以十六进制数据形式保存target_000的目标ROI像素；由对应加载器/testbench读取，位宽、排布和端序按data/evidence/2026-10-03-arm-localize-baseline/README.md核对。 | 所在目录说明：[data/evidence/2026-10-03-arm-localize-baseline/README.md](../../../data/evidence/2026-10-03-arm-localize-baseline/README.md)<br>同名配套文件：[data/evidence/2026-10-03-arm-localize-baseline/pc-benchmark/run-15c1q9l_/720p_six/sample-00-crops-zz8wxgpb/target_000.pgm](../../../data/evidence/2026-10-03-arm-localize-baseline/pc-benchmark/run-15c1q9l_/720p_six/sample-00-crops-zz8wxgpb/target_000.pgm) |
| [data/evidence/2026-10-03-arm-localize-baseline/pc-benchmark/run-15c1q9l_/720p_six/sample-00-crops-zz8wxgpb/target_000.pgm](../../../data/evidence/2026-10-03-arm-localize-baseline/pc-benchmark/run-15c1q9l_/720p_six/sample-00-crops-zz8wxgpb/target_000.pgm)<br>灰度像素图 · 已纳入Git（含暂存） | 保存target_000的目标ROI裁剪；其合成/文件/实机来源及框/标签含义以data/evidence/2026-10-03-arm-localize-baseline/README.md为准。 | 所在目录说明：[data/evidence/2026-10-03-arm-localize-baseline/README.md](../../../data/evidence/2026-10-03-arm-localize-baseline/README.md)<br>同名配套文件：[data/evidence/2026-10-03-arm-localize-baseline/pc-benchmark/run-15c1q9l_/720p_six/sample-00-crops-zz8wxgpb/target_000.hex](../../../data/evidence/2026-10-03-arm-localize-baseline/pc-benchmark/run-15c1q9l_/720p_six/sample-00-crops-zz8wxgpb/target_000.hex) |
| [data/evidence/2026-10-03-arm-localize-baseline/pc-benchmark/run-15c1q9l_/720p_six/sample-00-crops-zz8wxgpb/target_001.hex](../../../data/evidence/2026-10-03-arm-localize-baseline/pc-benchmark/run-15c1q9l_/720p_six/sample-00-crops-zz8wxgpb/target_001.hex)<br>十六进制数据 · 已纳入Git（含暂存） | 以十六进制数据形式保存target_001的目标ROI像素；由对应加载器/testbench读取，位宽、排布和端序按data/evidence/2026-10-03-arm-localize-baseline/README.md核对。 | 所在目录说明：[data/evidence/2026-10-03-arm-localize-baseline/README.md](../../../data/evidence/2026-10-03-arm-localize-baseline/README.md)<br>同名配套文件：[data/evidence/2026-10-03-arm-localize-baseline/pc-benchmark/run-15c1q9l_/720p_six/sample-00-crops-zz8wxgpb/target_001.pgm](../../../data/evidence/2026-10-03-arm-localize-baseline/pc-benchmark/run-15c1q9l_/720p_six/sample-00-crops-zz8wxgpb/target_001.pgm) |
| [data/evidence/2026-10-03-arm-localize-baseline/pc-benchmark/run-15c1q9l_/720p_six/sample-00-crops-zz8wxgpb/target_001.pgm](../../../data/evidence/2026-10-03-arm-localize-baseline/pc-benchmark/run-15c1q9l_/720p_six/sample-00-crops-zz8wxgpb/target_001.pgm)<br>灰度像素图 · 已纳入Git（含暂存） | 保存target_001的目标ROI裁剪；其合成/文件/实机来源及框/标签含义以data/evidence/2026-10-03-arm-localize-baseline/README.md为准。 | 所在目录说明：[data/evidence/2026-10-03-arm-localize-baseline/README.md](../../../data/evidence/2026-10-03-arm-localize-baseline/README.md)<br>同名配套文件：[data/evidence/2026-10-03-arm-localize-baseline/pc-benchmark/run-15c1q9l_/720p_six/sample-00-crops-zz8wxgpb/target_001.hex](../../../data/evidence/2026-10-03-arm-localize-baseline/pc-benchmark/run-15c1q9l_/720p_six/sample-00-crops-zz8wxgpb/target_001.hex) |
| [data/evidence/2026-10-03-arm-localize-baseline/pc-benchmark/run-15c1q9l_/720p_six/sample-00-crops-zz8wxgpb/target_002.hex](../../../data/evidence/2026-10-03-arm-localize-baseline/pc-benchmark/run-15c1q9l_/720p_six/sample-00-crops-zz8wxgpb/target_002.hex)<br>十六进制数据 · 已纳入Git（含暂存） | 以十六进制数据形式保存target_002的目标ROI像素；由对应加载器/testbench读取，位宽、排布和端序按data/evidence/2026-10-03-arm-localize-baseline/README.md核对。 | 所在目录说明：[data/evidence/2026-10-03-arm-localize-baseline/README.md](../../../data/evidence/2026-10-03-arm-localize-baseline/README.md)<br>同名配套文件：[data/evidence/2026-10-03-arm-localize-baseline/pc-benchmark/run-15c1q9l_/720p_six/sample-00-crops-zz8wxgpb/target_002.pgm](../../../data/evidence/2026-10-03-arm-localize-baseline/pc-benchmark/run-15c1q9l_/720p_six/sample-00-crops-zz8wxgpb/target_002.pgm) |
| [data/evidence/2026-10-03-arm-localize-baseline/pc-benchmark/run-15c1q9l_/720p_six/sample-00-crops-zz8wxgpb/target_002.pgm](../../../data/evidence/2026-10-03-arm-localize-baseline/pc-benchmark/run-15c1q9l_/720p_six/sample-00-crops-zz8wxgpb/target_002.pgm)<br>灰度像素图 · 已纳入Git（含暂存） | 保存target_002的目标ROI裁剪；其合成/文件/实机来源及框/标签含义以data/evidence/2026-10-03-arm-localize-baseline/README.md为准。 | 所在目录说明：[data/evidence/2026-10-03-arm-localize-baseline/README.md](../../../data/evidence/2026-10-03-arm-localize-baseline/README.md)<br>同名配套文件：[data/evidence/2026-10-03-arm-localize-baseline/pc-benchmark/run-15c1q9l_/720p_six/sample-00-crops-zz8wxgpb/target_002.hex](../../../data/evidence/2026-10-03-arm-localize-baseline/pc-benchmark/run-15c1q9l_/720p_six/sample-00-crops-zz8wxgpb/target_002.hex) |
| [data/evidence/2026-10-03-arm-localize-baseline/pc-benchmark/run-15c1q9l_/720p_six/sample-00-crops-zz8wxgpb/target_003.hex](../../../data/evidence/2026-10-03-arm-localize-baseline/pc-benchmark/run-15c1q9l_/720p_six/sample-00-crops-zz8wxgpb/target_003.hex)<br>十六进制数据 · 已纳入Git（含暂存） | 以十六进制数据形式保存target_003的目标ROI像素；由对应加载器/testbench读取，位宽、排布和端序按data/evidence/2026-10-03-arm-localize-baseline/README.md核对。 | 所在目录说明：[data/evidence/2026-10-03-arm-localize-baseline/README.md](../../../data/evidence/2026-10-03-arm-localize-baseline/README.md)<br>同名配套文件：[data/evidence/2026-10-03-arm-localize-baseline/pc-benchmark/run-15c1q9l_/720p_six/sample-00-crops-zz8wxgpb/target_003.pgm](../../../data/evidence/2026-10-03-arm-localize-baseline/pc-benchmark/run-15c1q9l_/720p_six/sample-00-crops-zz8wxgpb/target_003.pgm) |
| [data/evidence/2026-10-03-arm-localize-baseline/pc-benchmark/run-15c1q9l_/720p_six/sample-00-crops-zz8wxgpb/target_003.pgm](../../../data/evidence/2026-10-03-arm-localize-baseline/pc-benchmark/run-15c1q9l_/720p_six/sample-00-crops-zz8wxgpb/target_003.pgm)<br>灰度像素图 · 已纳入Git（含暂存） | 保存target_003的目标ROI裁剪；其合成/文件/实机来源及框/标签含义以data/evidence/2026-10-03-arm-localize-baseline/README.md为准。 | 所在目录说明：[data/evidence/2026-10-03-arm-localize-baseline/README.md](../../../data/evidence/2026-10-03-arm-localize-baseline/README.md)<br>同名配套文件：[data/evidence/2026-10-03-arm-localize-baseline/pc-benchmark/run-15c1q9l_/720p_six/sample-00-crops-zz8wxgpb/target_003.hex](../../../data/evidence/2026-10-03-arm-localize-baseline/pc-benchmark/run-15c1q9l_/720p_six/sample-00-crops-zz8wxgpb/target_003.hex) |
| [data/evidence/2026-10-03-arm-localize-baseline/pc-benchmark/run-15c1q9l_/720p_six/sample-00-crops-zz8wxgpb/target_004.hex](../../../data/evidence/2026-10-03-arm-localize-baseline/pc-benchmark/run-15c1q9l_/720p_six/sample-00-crops-zz8wxgpb/target_004.hex)<br>十六进制数据 · 已纳入Git（含暂存） | 以十六进制数据形式保存target_004的目标ROI像素；由对应加载器/testbench读取，位宽、排布和端序按data/evidence/2026-10-03-arm-localize-baseline/README.md核对。 | 所在目录说明：[data/evidence/2026-10-03-arm-localize-baseline/README.md](../../../data/evidence/2026-10-03-arm-localize-baseline/README.md)<br>同名配套文件：[data/evidence/2026-10-03-arm-localize-baseline/pc-benchmark/run-15c1q9l_/720p_six/sample-00-crops-zz8wxgpb/target_004.pgm](../../../data/evidence/2026-10-03-arm-localize-baseline/pc-benchmark/run-15c1q9l_/720p_six/sample-00-crops-zz8wxgpb/target_004.pgm) |
| [data/evidence/2026-10-03-arm-localize-baseline/pc-benchmark/run-15c1q9l_/720p_six/sample-00-crops-zz8wxgpb/target_004.pgm](../../../data/evidence/2026-10-03-arm-localize-baseline/pc-benchmark/run-15c1q9l_/720p_six/sample-00-crops-zz8wxgpb/target_004.pgm)<br>灰度像素图 · 已纳入Git（含暂存） | 保存target_004的目标ROI裁剪；其合成/文件/实机来源及框/标签含义以data/evidence/2026-10-03-arm-localize-baseline/README.md为准。 | 所在目录说明：[data/evidence/2026-10-03-arm-localize-baseline/README.md](../../../data/evidence/2026-10-03-arm-localize-baseline/README.md)<br>同名配套文件：[data/evidence/2026-10-03-arm-localize-baseline/pc-benchmark/run-15c1q9l_/720p_six/sample-00-crops-zz8wxgpb/target_004.hex](../../../data/evidence/2026-10-03-arm-localize-baseline/pc-benchmark/run-15c1q9l_/720p_six/sample-00-crops-zz8wxgpb/target_004.hex) |
| [data/evidence/2026-10-03-arm-localize-baseline/pc-benchmark/run-15c1q9l_/720p_six/sample-00-crops-zz8wxgpb/target_005.hex](../../../data/evidence/2026-10-03-arm-localize-baseline/pc-benchmark/run-15c1q9l_/720p_six/sample-00-crops-zz8wxgpb/target_005.hex)<br>十六进制数据 · 已纳入Git（含暂存） | 以十六进制数据形式保存target_005的目标ROI像素；由对应加载器/testbench读取，位宽、排布和端序按data/evidence/2026-10-03-arm-localize-baseline/README.md核对。 | 所在目录说明：[data/evidence/2026-10-03-arm-localize-baseline/README.md](../../../data/evidence/2026-10-03-arm-localize-baseline/README.md)<br>同名配套文件：[data/evidence/2026-10-03-arm-localize-baseline/pc-benchmark/run-15c1q9l_/720p_six/sample-00-crops-zz8wxgpb/target_005.pgm](../../../data/evidence/2026-10-03-arm-localize-baseline/pc-benchmark/run-15c1q9l_/720p_six/sample-00-crops-zz8wxgpb/target_005.pgm) |
| [data/evidence/2026-10-03-arm-localize-baseline/pc-benchmark/run-15c1q9l_/720p_six/sample-00-crops-zz8wxgpb/target_005.pgm](../../../data/evidence/2026-10-03-arm-localize-baseline/pc-benchmark/run-15c1q9l_/720p_six/sample-00-crops-zz8wxgpb/target_005.pgm)<br>灰度像素图 · 已纳入Git（含暂存） | 保存target_005的目标ROI裁剪；其合成/文件/实机来源及框/标签含义以data/evidence/2026-10-03-arm-localize-baseline/README.md为准。 | 所在目录说明：[data/evidence/2026-10-03-arm-localize-baseline/README.md](../../../data/evidence/2026-10-03-arm-localize-baseline/README.md)<br>同名配套文件：[data/evidence/2026-10-03-arm-localize-baseline/pc-benchmark/run-15c1q9l_/720p_six/sample-00-crops-zz8wxgpb/target_005.hex](../../../data/evidence/2026-10-03-arm-localize-baseline/pc-benchmark/run-15c1q9l_/720p_six/sample-00-crops-zz8wxgpb/target_005.hex) |
| **data/evidence/2026-10-03-arm-localize-baseline/pc-benchmark/run-15c1q9l_/720p_six** | | |
| [data/evidence/2026-10-03-arm-localize-baseline/pc-benchmark/run-15c1q9l_/720p_six/sample-00.json](../../../data/evidence/2026-10-03-arm-localize-baseline/pc-benchmark/run-15c1q9l_/720p_six/sample-00.json)<br>结构化结果/元数据 · 已纳入Git（含暂存） | 保存sample-00的实验结果或检查产物，字段包括frame_id、config_id、width、height、status、targets、schema_version；与data/evidence/2026-10-03-arm-localize-baseline/README.md中的生成/校验流程一起使用。 | 所在目录说明：[data/evidence/2026-10-03-arm-localize-baseline/README.md](../../../data/evidence/2026-10-03-arm-localize-baseline/README.md)<br>同目录输入/元数据：[data/evidence/2026-10-03-arm-localize-baseline/pc-benchmark/run-15c1q9l_/720p_six/input.json](../../../data/evidence/2026-10-03-arm-localize-baseline/pc-benchmark/run-15c1q9l_/720p_six/input.json) |
| **data/evidence/2026-10-03-arm-localize-baseline/pc-benchmark/run-15c1q9l_/720p_six/sample-01-crops-njiti5tk** | | |
| [data/evidence/2026-10-03-arm-localize-baseline/pc-benchmark/run-15c1q9l_/720p_six/sample-01-crops-njiti5tk/target_000.hex](../../../data/evidence/2026-10-03-arm-localize-baseline/pc-benchmark/run-15c1q9l_/720p_six/sample-01-crops-njiti5tk/target_000.hex)<br>十六进制数据 · 已纳入Git（含暂存） | 以十六进制数据形式保存target_000的目标ROI像素；由对应加载器/testbench读取，位宽、排布和端序按data/evidence/2026-10-03-arm-localize-baseline/README.md核对。 | 所在目录说明：[data/evidence/2026-10-03-arm-localize-baseline/README.md](../../../data/evidence/2026-10-03-arm-localize-baseline/README.md)<br>同名配套文件：[data/evidence/2026-10-03-arm-localize-baseline/pc-benchmark/run-15c1q9l_/720p_six/sample-01-crops-njiti5tk/target_000.pgm](../../../data/evidence/2026-10-03-arm-localize-baseline/pc-benchmark/run-15c1q9l_/720p_six/sample-01-crops-njiti5tk/target_000.pgm) |
| [data/evidence/2026-10-03-arm-localize-baseline/pc-benchmark/run-15c1q9l_/720p_six/sample-01-crops-njiti5tk/target_000.pgm](../../../data/evidence/2026-10-03-arm-localize-baseline/pc-benchmark/run-15c1q9l_/720p_six/sample-01-crops-njiti5tk/target_000.pgm)<br>灰度像素图 · 已纳入Git（含暂存） | 保存target_000的目标ROI裁剪；其合成/文件/实机来源及框/标签含义以data/evidence/2026-10-03-arm-localize-baseline/README.md为准。 | 所在目录说明：[data/evidence/2026-10-03-arm-localize-baseline/README.md](../../../data/evidence/2026-10-03-arm-localize-baseline/README.md)<br>同名配套文件：[data/evidence/2026-10-03-arm-localize-baseline/pc-benchmark/run-15c1q9l_/720p_six/sample-01-crops-njiti5tk/target_000.hex](../../../data/evidence/2026-10-03-arm-localize-baseline/pc-benchmark/run-15c1q9l_/720p_six/sample-01-crops-njiti5tk/target_000.hex) |
| [data/evidence/2026-10-03-arm-localize-baseline/pc-benchmark/run-15c1q9l_/720p_six/sample-01-crops-njiti5tk/target_001.hex](../../../data/evidence/2026-10-03-arm-localize-baseline/pc-benchmark/run-15c1q9l_/720p_six/sample-01-crops-njiti5tk/target_001.hex)<br>十六进制数据 · 已纳入Git（含暂存） | 以十六进制数据形式保存target_001的目标ROI像素；由对应加载器/testbench读取，位宽、排布和端序按data/evidence/2026-10-03-arm-localize-baseline/README.md核对。 | 所在目录说明：[data/evidence/2026-10-03-arm-localize-baseline/README.md](../../../data/evidence/2026-10-03-arm-localize-baseline/README.md)<br>同名配套文件：[data/evidence/2026-10-03-arm-localize-baseline/pc-benchmark/run-15c1q9l_/720p_six/sample-01-crops-njiti5tk/target_001.pgm](../../../data/evidence/2026-10-03-arm-localize-baseline/pc-benchmark/run-15c1q9l_/720p_six/sample-01-crops-njiti5tk/target_001.pgm) |
| [data/evidence/2026-10-03-arm-localize-baseline/pc-benchmark/run-15c1q9l_/720p_six/sample-01-crops-njiti5tk/target_001.pgm](../../../data/evidence/2026-10-03-arm-localize-baseline/pc-benchmark/run-15c1q9l_/720p_six/sample-01-crops-njiti5tk/target_001.pgm)<br>灰度像素图 · 已纳入Git（含暂存） | 保存target_001的目标ROI裁剪；其合成/文件/实机来源及框/标签含义以data/evidence/2026-10-03-arm-localize-baseline/README.md为准。 | 所在目录说明：[data/evidence/2026-10-03-arm-localize-baseline/README.md](../../../data/evidence/2026-10-03-arm-localize-baseline/README.md)<br>同名配套文件：[data/evidence/2026-10-03-arm-localize-baseline/pc-benchmark/run-15c1q9l_/720p_six/sample-01-crops-njiti5tk/target_001.hex](../../../data/evidence/2026-10-03-arm-localize-baseline/pc-benchmark/run-15c1q9l_/720p_six/sample-01-crops-njiti5tk/target_001.hex) |
| [data/evidence/2026-10-03-arm-localize-baseline/pc-benchmark/run-15c1q9l_/720p_six/sample-01-crops-njiti5tk/target_002.hex](../../../data/evidence/2026-10-03-arm-localize-baseline/pc-benchmark/run-15c1q9l_/720p_six/sample-01-crops-njiti5tk/target_002.hex)<br>十六进制数据 · 已纳入Git（含暂存） | 以十六进制数据形式保存target_002的目标ROI像素；由对应加载器/testbench读取，位宽、排布和端序按data/evidence/2026-10-03-arm-localize-baseline/README.md核对。 | 所在目录说明：[data/evidence/2026-10-03-arm-localize-baseline/README.md](../../../data/evidence/2026-10-03-arm-localize-baseline/README.md)<br>同名配套文件：[data/evidence/2026-10-03-arm-localize-baseline/pc-benchmark/run-15c1q9l_/720p_six/sample-01-crops-njiti5tk/target_002.pgm](../../../data/evidence/2026-10-03-arm-localize-baseline/pc-benchmark/run-15c1q9l_/720p_six/sample-01-crops-njiti5tk/target_002.pgm) |
| [data/evidence/2026-10-03-arm-localize-baseline/pc-benchmark/run-15c1q9l_/720p_six/sample-01-crops-njiti5tk/target_002.pgm](../../../data/evidence/2026-10-03-arm-localize-baseline/pc-benchmark/run-15c1q9l_/720p_six/sample-01-crops-njiti5tk/target_002.pgm)<br>灰度像素图 · 已纳入Git（含暂存） | 保存target_002的目标ROI裁剪；其合成/文件/实机来源及框/标签含义以data/evidence/2026-10-03-arm-localize-baseline/README.md为准。 | 所在目录说明：[data/evidence/2026-10-03-arm-localize-baseline/README.md](../../../data/evidence/2026-10-03-arm-localize-baseline/README.md)<br>同名配套文件：[data/evidence/2026-10-03-arm-localize-baseline/pc-benchmark/run-15c1q9l_/720p_six/sample-01-crops-njiti5tk/target_002.hex](../../../data/evidence/2026-10-03-arm-localize-baseline/pc-benchmark/run-15c1q9l_/720p_six/sample-01-crops-njiti5tk/target_002.hex) |
| [data/evidence/2026-10-03-arm-localize-baseline/pc-benchmark/run-15c1q9l_/720p_six/sample-01-crops-njiti5tk/target_003.hex](../../../data/evidence/2026-10-03-arm-localize-baseline/pc-benchmark/run-15c1q9l_/720p_six/sample-01-crops-njiti5tk/target_003.hex)<br>十六进制数据 · 已纳入Git（含暂存） | 以十六进制数据形式保存target_003的目标ROI像素；由对应加载器/testbench读取，位宽、排布和端序按data/evidence/2026-10-03-arm-localize-baseline/README.md核对。 | 所在目录说明：[data/evidence/2026-10-03-arm-localize-baseline/README.md](../../../data/evidence/2026-10-03-arm-localize-baseline/README.md)<br>同名配套文件：[data/evidence/2026-10-03-arm-localize-baseline/pc-benchmark/run-15c1q9l_/720p_six/sample-01-crops-njiti5tk/target_003.pgm](../../../data/evidence/2026-10-03-arm-localize-baseline/pc-benchmark/run-15c1q9l_/720p_six/sample-01-crops-njiti5tk/target_003.pgm) |
| [data/evidence/2026-10-03-arm-localize-baseline/pc-benchmark/run-15c1q9l_/720p_six/sample-01-crops-njiti5tk/target_003.pgm](../../../data/evidence/2026-10-03-arm-localize-baseline/pc-benchmark/run-15c1q9l_/720p_six/sample-01-crops-njiti5tk/target_003.pgm)<br>灰度像素图 · 已纳入Git（含暂存） | 保存target_003的目标ROI裁剪；其合成/文件/实机来源及框/标签含义以data/evidence/2026-10-03-arm-localize-baseline/README.md为准。 | 所在目录说明：[data/evidence/2026-10-03-arm-localize-baseline/README.md](../../../data/evidence/2026-10-03-arm-localize-baseline/README.md)<br>同名配套文件：[data/evidence/2026-10-03-arm-localize-baseline/pc-benchmark/run-15c1q9l_/720p_six/sample-01-crops-njiti5tk/target_003.hex](../../../data/evidence/2026-10-03-arm-localize-baseline/pc-benchmark/run-15c1q9l_/720p_six/sample-01-crops-njiti5tk/target_003.hex) |
| [data/evidence/2026-10-03-arm-localize-baseline/pc-benchmark/run-15c1q9l_/720p_six/sample-01-crops-njiti5tk/target_004.hex](../../../data/evidence/2026-10-03-arm-localize-baseline/pc-benchmark/run-15c1q9l_/720p_six/sample-01-crops-njiti5tk/target_004.hex)<br>十六进制数据 · 已纳入Git（含暂存） | 以十六进制数据形式保存target_004的目标ROI像素；由对应加载器/testbench读取，位宽、排布和端序按data/evidence/2026-10-03-arm-localize-baseline/README.md核对。 | 所在目录说明：[data/evidence/2026-10-03-arm-localize-baseline/README.md](../../../data/evidence/2026-10-03-arm-localize-baseline/README.md)<br>同名配套文件：[data/evidence/2026-10-03-arm-localize-baseline/pc-benchmark/run-15c1q9l_/720p_six/sample-01-crops-njiti5tk/target_004.pgm](../../../data/evidence/2026-10-03-arm-localize-baseline/pc-benchmark/run-15c1q9l_/720p_six/sample-01-crops-njiti5tk/target_004.pgm) |
| [data/evidence/2026-10-03-arm-localize-baseline/pc-benchmark/run-15c1q9l_/720p_six/sample-01-crops-njiti5tk/target_004.pgm](../../../data/evidence/2026-10-03-arm-localize-baseline/pc-benchmark/run-15c1q9l_/720p_six/sample-01-crops-njiti5tk/target_004.pgm)<br>灰度像素图 · 已纳入Git（含暂存） | 保存target_004的目标ROI裁剪；其合成/文件/实机来源及框/标签含义以data/evidence/2026-10-03-arm-localize-baseline/README.md为准。 | 所在目录说明：[data/evidence/2026-10-03-arm-localize-baseline/README.md](../../../data/evidence/2026-10-03-arm-localize-baseline/README.md)<br>同名配套文件：[data/evidence/2026-10-03-arm-localize-baseline/pc-benchmark/run-15c1q9l_/720p_six/sample-01-crops-njiti5tk/target_004.hex](../../../data/evidence/2026-10-03-arm-localize-baseline/pc-benchmark/run-15c1q9l_/720p_six/sample-01-crops-njiti5tk/target_004.hex) |
| [data/evidence/2026-10-03-arm-localize-baseline/pc-benchmark/run-15c1q9l_/720p_six/sample-01-crops-njiti5tk/target_005.hex](../../../data/evidence/2026-10-03-arm-localize-baseline/pc-benchmark/run-15c1q9l_/720p_six/sample-01-crops-njiti5tk/target_005.hex)<br>十六进制数据 · 已纳入Git（含暂存） | 以十六进制数据形式保存target_005的目标ROI像素；由对应加载器/testbench读取，位宽、排布和端序按data/evidence/2026-10-03-arm-localize-baseline/README.md核对。 | 所在目录说明：[data/evidence/2026-10-03-arm-localize-baseline/README.md](../../../data/evidence/2026-10-03-arm-localize-baseline/README.md)<br>同名配套文件：[data/evidence/2026-10-03-arm-localize-baseline/pc-benchmark/run-15c1q9l_/720p_six/sample-01-crops-njiti5tk/target_005.pgm](../../../data/evidence/2026-10-03-arm-localize-baseline/pc-benchmark/run-15c1q9l_/720p_six/sample-01-crops-njiti5tk/target_005.pgm) |
| [data/evidence/2026-10-03-arm-localize-baseline/pc-benchmark/run-15c1q9l_/720p_six/sample-01-crops-njiti5tk/target_005.pgm](../../../data/evidence/2026-10-03-arm-localize-baseline/pc-benchmark/run-15c1q9l_/720p_six/sample-01-crops-njiti5tk/target_005.pgm)<br>灰度像素图 · 已纳入Git（含暂存） | 保存target_005的目标ROI裁剪；其合成/文件/实机来源及框/标签含义以data/evidence/2026-10-03-arm-localize-baseline/README.md为准。 | 所在目录说明：[data/evidence/2026-10-03-arm-localize-baseline/README.md](../../../data/evidence/2026-10-03-arm-localize-baseline/README.md)<br>同名配套文件：[data/evidence/2026-10-03-arm-localize-baseline/pc-benchmark/run-15c1q9l_/720p_six/sample-01-crops-njiti5tk/target_005.hex](../../../data/evidence/2026-10-03-arm-localize-baseline/pc-benchmark/run-15c1q9l_/720p_six/sample-01-crops-njiti5tk/target_005.hex) |
| **data/evidence/2026-10-03-arm-localize-baseline/pc-benchmark/run-15c1q9l_/720p_six** | | |
| [data/evidence/2026-10-03-arm-localize-baseline/pc-benchmark/run-15c1q9l_/720p_six/sample-01.json](../../../data/evidence/2026-10-03-arm-localize-baseline/pc-benchmark/run-15c1q9l_/720p_six/sample-01.json)<br>结构化结果/元数据 · 已纳入Git（含暂存） | 保存sample-01的实验结果或检查产物，字段包括frame_id、config_id、width、height、status、targets、schema_version；与data/evidence/2026-10-03-arm-localize-baseline/README.md中的生成/校验流程一起使用。 | 所在目录说明：[data/evidence/2026-10-03-arm-localize-baseline/README.md](../../../data/evidence/2026-10-03-arm-localize-baseline/README.md)<br>同目录输入/元数据：[data/evidence/2026-10-03-arm-localize-baseline/pc-benchmark/run-15c1q9l_/720p_six/input.json](../../../data/evidence/2026-10-03-arm-localize-baseline/pc-benchmark/run-15c1q9l_/720p_six/input.json) |
| **data/evidence/2026-10-03-arm-localize-baseline/pc-benchmark/run-15c1q9l_/720p_six/sample-02-crops-xiy6b709** | | |
| [data/evidence/2026-10-03-arm-localize-baseline/pc-benchmark/run-15c1q9l_/720p_six/sample-02-crops-xiy6b709/target_000.hex](../../../data/evidence/2026-10-03-arm-localize-baseline/pc-benchmark/run-15c1q9l_/720p_six/sample-02-crops-xiy6b709/target_000.hex)<br>十六进制数据 · 已纳入Git（含暂存） | 以十六进制数据形式保存target_000的目标ROI像素；由对应加载器/testbench读取，位宽、排布和端序按data/evidence/2026-10-03-arm-localize-baseline/README.md核对。 | 所在目录说明：[data/evidence/2026-10-03-arm-localize-baseline/README.md](../../../data/evidence/2026-10-03-arm-localize-baseline/README.md)<br>同名配套文件：[data/evidence/2026-10-03-arm-localize-baseline/pc-benchmark/run-15c1q9l_/720p_six/sample-02-crops-xiy6b709/target_000.pgm](../../../data/evidence/2026-10-03-arm-localize-baseline/pc-benchmark/run-15c1q9l_/720p_six/sample-02-crops-xiy6b709/target_000.pgm) |
| [data/evidence/2026-10-03-arm-localize-baseline/pc-benchmark/run-15c1q9l_/720p_six/sample-02-crops-xiy6b709/target_000.pgm](../../../data/evidence/2026-10-03-arm-localize-baseline/pc-benchmark/run-15c1q9l_/720p_six/sample-02-crops-xiy6b709/target_000.pgm)<br>灰度像素图 · 已纳入Git（含暂存） | 保存target_000的目标ROI裁剪；其合成/文件/实机来源及框/标签含义以data/evidence/2026-10-03-arm-localize-baseline/README.md为准。 | 所在目录说明：[data/evidence/2026-10-03-arm-localize-baseline/README.md](../../../data/evidence/2026-10-03-arm-localize-baseline/README.md)<br>同名配套文件：[data/evidence/2026-10-03-arm-localize-baseline/pc-benchmark/run-15c1q9l_/720p_six/sample-02-crops-xiy6b709/target_000.hex](../../../data/evidence/2026-10-03-arm-localize-baseline/pc-benchmark/run-15c1q9l_/720p_six/sample-02-crops-xiy6b709/target_000.hex) |
| [data/evidence/2026-10-03-arm-localize-baseline/pc-benchmark/run-15c1q9l_/720p_six/sample-02-crops-xiy6b709/target_001.hex](../../../data/evidence/2026-10-03-arm-localize-baseline/pc-benchmark/run-15c1q9l_/720p_six/sample-02-crops-xiy6b709/target_001.hex)<br>十六进制数据 · 已纳入Git（含暂存） | 以十六进制数据形式保存target_001的目标ROI像素；由对应加载器/testbench读取，位宽、排布和端序按data/evidence/2026-10-03-arm-localize-baseline/README.md核对。 | 所在目录说明：[data/evidence/2026-10-03-arm-localize-baseline/README.md](../../../data/evidence/2026-10-03-arm-localize-baseline/README.md)<br>同名配套文件：[data/evidence/2026-10-03-arm-localize-baseline/pc-benchmark/run-15c1q9l_/720p_six/sample-02-crops-xiy6b709/target_001.pgm](../../../data/evidence/2026-10-03-arm-localize-baseline/pc-benchmark/run-15c1q9l_/720p_six/sample-02-crops-xiy6b709/target_001.pgm) |
| [data/evidence/2026-10-03-arm-localize-baseline/pc-benchmark/run-15c1q9l_/720p_six/sample-02-crops-xiy6b709/target_001.pgm](../../../data/evidence/2026-10-03-arm-localize-baseline/pc-benchmark/run-15c1q9l_/720p_six/sample-02-crops-xiy6b709/target_001.pgm)<br>灰度像素图 · 已纳入Git（含暂存） | 保存target_001的目标ROI裁剪；其合成/文件/实机来源及框/标签含义以data/evidence/2026-10-03-arm-localize-baseline/README.md为准。 | 所在目录说明：[data/evidence/2026-10-03-arm-localize-baseline/README.md](../../../data/evidence/2026-10-03-arm-localize-baseline/README.md)<br>同名配套文件：[data/evidence/2026-10-03-arm-localize-baseline/pc-benchmark/run-15c1q9l_/720p_six/sample-02-crops-xiy6b709/target_001.hex](../../../data/evidence/2026-10-03-arm-localize-baseline/pc-benchmark/run-15c1q9l_/720p_six/sample-02-crops-xiy6b709/target_001.hex) |
| [data/evidence/2026-10-03-arm-localize-baseline/pc-benchmark/run-15c1q9l_/720p_six/sample-02-crops-xiy6b709/target_002.hex](../../../data/evidence/2026-10-03-arm-localize-baseline/pc-benchmark/run-15c1q9l_/720p_six/sample-02-crops-xiy6b709/target_002.hex)<br>十六进制数据 · 已纳入Git（含暂存） | 以十六进制数据形式保存target_002的目标ROI像素；由对应加载器/testbench读取，位宽、排布和端序按data/evidence/2026-10-03-arm-localize-baseline/README.md核对。 | 所在目录说明：[data/evidence/2026-10-03-arm-localize-baseline/README.md](../../../data/evidence/2026-10-03-arm-localize-baseline/README.md)<br>同名配套文件：[data/evidence/2026-10-03-arm-localize-baseline/pc-benchmark/run-15c1q9l_/720p_six/sample-02-crops-xiy6b709/target_002.pgm](../../../data/evidence/2026-10-03-arm-localize-baseline/pc-benchmark/run-15c1q9l_/720p_six/sample-02-crops-xiy6b709/target_002.pgm) |
| [data/evidence/2026-10-03-arm-localize-baseline/pc-benchmark/run-15c1q9l_/720p_six/sample-02-crops-xiy6b709/target_002.pgm](../../../data/evidence/2026-10-03-arm-localize-baseline/pc-benchmark/run-15c1q9l_/720p_six/sample-02-crops-xiy6b709/target_002.pgm)<br>灰度像素图 · 已纳入Git（含暂存） | 保存target_002的目标ROI裁剪；其合成/文件/实机来源及框/标签含义以data/evidence/2026-10-03-arm-localize-baseline/README.md为准。 | 所在目录说明：[data/evidence/2026-10-03-arm-localize-baseline/README.md](../../../data/evidence/2026-10-03-arm-localize-baseline/README.md)<br>同名配套文件：[data/evidence/2026-10-03-arm-localize-baseline/pc-benchmark/run-15c1q9l_/720p_six/sample-02-crops-xiy6b709/target_002.hex](../../../data/evidence/2026-10-03-arm-localize-baseline/pc-benchmark/run-15c1q9l_/720p_six/sample-02-crops-xiy6b709/target_002.hex) |
| [data/evidence/2026-10-03-arm-localize-baseline/pc-benchmark/run-15c1q9l_/720p_six/sample-02-crops-xiy6b709/target_003.hex](../../../data/evidence/2026-10-03-arm-localize-baseline/pc-benchmark/run-15c1q9l_/720p_six/sample-02-crops-xiy6b709/target_003.hex)<br>十六进制数据 · 已纳入Git（含暂存） | 以十六进制数据形式保存target_003的目标ROI像素；由对应加载器/testbench读取，位宽、排布和端序按data/evidence/2026-10-03-arm-localize-baseline/README.md核对。 | 所在目录说明：[data/evidence/2026-10-03-arm-localize-baseline/README.md](../../../data/evidence/2026-10-03-arm-localize-baseline/README.md)<br>同名配套文件：[data/evidence/2026-10-03-arm-localize-baseline/pc-benchmark/run-15c1q9l_/720p_six/sample-02-crops-xiy6b709/target_003.pgm](../../../data/evidence/2026-10-03-arm-localize-baseline/pc-benchmark/run-15c1q9l_/720p_six/sample-02-crops-xiy6b709/target_003.pgm) |
| [data/evidence/2026-10-03-arm-localize-baseline/pc-benchmark/run-15c1q9l_/720p_six/sample-02-crops-xiy6b709/target_003.pgm](../../../data/evidence/2026-10-03-arm-localize-baseline/pc-benchmark/run-15c1q9l_/720p_six/sample-02-crops-xiy6b709/target_003.pgm)<br>灰度像素图 · 已纳入Git（含暂存） | 保存target_003的目标ROI裁剪；其合成/文件/实机来源及框/标签含义以data/evidence/2026-10-03-arm-localize-baseline/README.md为准。 | 所在目录说明：[data/evidence/2026-10-03-arm-localize-baseline/README.md](../../../data/evidence/2026-10-03-arm-localize-baseline/README.md)<br>同名配套文件：[data/evidence/2026-10-03-arm-localize-baseline/pc-benchmark/run-15c1q9l_/720p_six/sample-02-crops-xiy6b709/target_003.hex](../../../data/evidence/2026-10-03-arm-localize-baseline/pc-benchmark/run-15c1q9l_/720p_six/sample-02-crops-xiy6b709/target_003.hex) |
| [data/evidence/2026-10-03-arm-localize-baseline/pc-benchmark/run-15c1q9l_/720p_six/sample-02-crops-xiy6b709/target_004.hex](../../../data/evidence/2026-10-03-arm-localize-baseline/pc-benchmark/run-15c1q9l_/720p_six/sample-02-crops-xiy6b709/target_004.hex)<br>十六进制数据 · 已纳入Git（含暂存） | 以十六进制数据形式保存target_004的目标ROI像素；由对应加载器/testbench读取，位宽、排布和端序按data/evidence/2026-10-03-arm-localize-baseline/README.md核对。 | 所在目录说明：[data/evidence/2026-10-03-arm-localize-baseline/README.md](../../../data/evidence/2026-10-03-arm-localize-baseline/README.md)<br>同名配套文件：[data/evidence/2026-10-03-arm-localize-baseline/pc-benchmark/run-15c1q9l_/720p_six/sample-02-crops-xiy6b709/target_004.pgm](../../../data/evidence/2026-10-03-arm-localize-baseline/pc-benchmark/run-15c1q9l_/720p_six/sample-02-crops-xiy6b709/target_004.pgm) |
| [data/evidence/2026-10-03-arm-localize-baseline/pc-benchmark/run-15c1q9l_/720p_six/sample-02-crops-xiy6b709/target_004.pgm](../../../data/evidence/2026-10-03-arm-localize-baseline/pc-benchmark/run-15c1q9l_/720p_six/sample-02-crops-xiy6b709/target_004.pgm)<br>灰度像素图 · 已纳入Git（含暂存） | 保存target_004的目标ROI裁剪；其合成/文件/实机来源及框/标签含义以data/evidence/2026-10-03-arm-localize-baseline/README.md为准。 | 所在目录说明：[data/evidence/2026-10-03-arm-localize-baseline/README.md](../../../data/evidence/2026-10-03-arm-localize-baseline/README.md)<br>同名配套文件：[data/evidence/2026-10-03-arm-localize-baseline/pc-benchmark/run-15c1q9l_/720p_six/sample-02-crops-xiy6b709/target_004.hex](../../../data/evidence/2026-10-03-arm-localize-baseline/pc-benchmark/run-15c1q9l_/720p_six/sample-02-crops-xiy6b709/target_004.hex) |
| [data/evidence/2026-10-03-arm-localize-baseline/pc-benchmark/run-15c1q9l_/720p_six/sample-02-crops-xiy6b709/target_005.hex](../../../data/evidence/2026-10-03-arm-localize-baseline/pc-benchmark/run-15c1q9l_/720p_six/sample-02-crops-xiy6b709/target_005.hex)<br>十六进制数据 · 已纳入Git（含暂存） | 以十六进制数据形式保存target_005的目标ROI像素；由对应加载器/testbench读取，位宽、排布和端序按data/evidence/2026-10-03-arm-localize-baseline/README.md核对。 | 所在目录说明：[data/evidence/2026-10-03-arm-localize-baseline/README.md](../../../data/evidence/2026-10-03-arm-localize-baseline/README.md)<br>同名配套文件：[data/evidence/2026-10-03-arm-localize-baseline/pc-benchmark/run-15c1q9l_/720p_six/sample-02-crops-xiy6b709/target_005.pgm](../../../data/evidence/2026-10-03-arm-localize-baseline/pc-benchmark/run-15c1q9l_/720p_six/sample-02-crops-xiy6b709/target_005.pgm) |
| [data/evidence/2026-10-03-arm-localize-baseline/pc-benchmark/run-15c1q9l_/720p_six/sample-02-crops-xiy6b709/target_005.pgm](../../../data/evidence/2026-10-03-arm-localize-baseline/pc-benchmark/run-15c1q9l_/720p_six/sample-02-crops-xiy6b709/target_005.pgm)<br>灰度像素图 · 已纳入Git（含暂存） | 保存target_005的目标ROI裁剪；其合成/文件/实机来源及框/标签含义以data/evidence/2026-10-03-arm-localize-baseline/README.md为准。 | 所在目录说明：[data/evidence/2026-10-03-arm-localize-baseline/README.md](../../../data/evidence/2026-10-03-arm-localize-baseline/README.md)<br>同名配套文件：[data/evidence/2026-10-03-arm-localize-baseline/pc-benchmark/run-15c1q9l_/720p_six/sample-02-crops-xiy6b709/target_005.hex](../../../data/evidence/2026-10-03-arm-localize-baseline/pc-benchmark/run-15c1q9l_/720p_six/sample-02-crops-xiy6b709/target_005.hex) |
| **data/evidence/2026-10-03-arm-localize-baseline/pc-benchmark/run-15c1q9l_/720p_six** | | |
| [data/evidence/2026-10-03-arm-localize-baseline/pc-benchmark/run-15c1q9l_/720p_six/sample-02.json](../../../data/evidence/2026-10-03-arm-localize-baseline/pc-benchmark/run-15c1q9l_/720p_six/sample-02.json)<br>结构化结果/元数据 · 已纳入Git（含暂存） | 保存sample-02的实验结果或检查产物，字段包括frame_id、config_id、width、height、status、targets、schema_version；与data/evidence/2026-10-03-arm-localize-baseline/README.md中的生成/校验流程一起使用。 | 所在目录说明：[data/evidence/2026-10-03-arm-localize-baseline/README.md](../../../data/evidence/2026-10-03-arm-localize-baseline/README.md)<br>同目录输入/元数据：[data/evidence/2026-10-03-arm-localize-baseline/pc-benchmark/run-15c1q9l_/720p_six/input.json](../../../data/evidence/2026-10-03-arm-localize-baseline/pc-benchmark/run-15c1q9l_/720p_six/input.json) |
| **data/evidence/2026-10-03-arm-localize-baseline/pc-benchmark/run-15c1q9l_/720p_six/sample-03-crops-3zpx97jn** | | |
| [data/evidence/2026-10-03-arm-localize-baseline/pc-benchmark/run-15c1q9l_/720p_six/sample-03-crops-3zpx97jn/target_000.hex](../../../data/evidence/2026-10-03-arm-localize-baseline/pc-benchmark/run-15c1q9l_/720p_six/sample-03-crops-3zpx97jn/target_000.hex)<br>十六进制数据 · 已纳入Git（含暂存） | 以十六进制数据形式保存target_000的目标ROI像素；由对应加载器/testbench读取，位宽、排布和端序按data/evidence/2026-10-03-arm-localize-baseline/README.md核对。 | 所在目录说明：[data/evidence/2026-10-03-arm-localize-baseline/README.md](../../../data/evidence/2026-10-03-arm-localize-baseline/README.md)<br>同名配套文件：[data/evidence/2026-10-03-arm-localize-baseline/pc-benchmark/run-15c1q9l_/720p_six/sample-03-crops-3zpx97jn/target_000.pgm](../../../data/evidence/2026-10-03-arm-localize-baseline/pc-benchmark/run-15c1q9l_/720p_six/sample-03-crops-3zpx97jn/target_000.pgm) |
| [data/evidence/2026-10-03-arm-localize-baseline/pc-benchmark/run-15c1q9l_/720p_six/sample-03-crops-3zpx97jn/target_000.pgm](../../../data/evidence/2026-10-03-arm-localize-baseline/pc-benchmark/run-15c1q9l_/720p_six/sample-03-crops-3zpx97jn/target_000.pgm)<br>灰度像素图 · 已纳入Git（含暂存） | 保存target_000的目标ROI裁剪；其合成/文件/实机来源及框/标签含义以data/evidence/2026-10-03-arm-localize-baseline/README.md为准。 | 所在目录说明：[data/evidence/2026-10-03-arm-localize-baseline/README.md](../../../data/evidence/2026-10-03-arm-localize-baseline/README.md)<br>同名配套文件：[data/evidence/2026-10-03-arm-localize-baseline/pc-benchmark/run-15c1q9l_/720p_six/sample-03-crops-3zpx97jn/target_000.hex](../../../data/evidence/2026-10-03-arm-localize-baseline/pc-benchmark/run-15c1q9l_/720p_six/sample-03-crops-3zpx97jn/target_000.hex) |
| [data/evidence/2026-10-03-arm-localize-baseline/pc-benchmark/run-15c1q9l_/720p_six/sample-03-crops-3zpx97jn/target_001.hex](../../../data/evidence/2026-10-03-arm-localize-baseline/pc-benchmark/run-15c1q9l_/720p_six/sample-03-crops-3zpx97jn/target_001.hex)<br>十六进制数据 · 已纳入Git（含暂存） | 以十六进制数据形式保存target_001的目标ROI像素；由对应加载器/testbench读取，位宽、排布和端序按data/evidence/2026-10-03-arm-localize-baseline/README.md核对。 | 所在目录说明：[data/evidence/2026-10-03-arm-localize-baseline/README.md](../../../data/evidence/2026-10-03-arm-localize-baseline/README.md)<br>同名配套文件：[data/evidence/2026-10-03-arm-localize-baseline/pc-benchmark/run-15c1q9l_/720p_six/sample-03-crops-3zpx97jn/target_001.pgm](../../../data/evidence/2026-10-03-arm-localize-baseline/pc-benchmark/run-15c1q9l_/720p_six/sample-03-crops-3zpx97jn/target_001.pgm) |
| [data/evidence/2026-10-03-arm-localize-baseline/pc-benchmark/run-15c1q9l_/720p_six/sample-03-crops-3zpx97jn/target_001.pgm](../../../data/evidence/2026-10-03-arm-localize-baseline/pc-benchmark/run-15c1q9l_/720p_six/sample-03-crops-3zpx97jn/target_001.pgm)<br>灰度像素图 · 已纳入Git（含暂存） | 保存target_001的目标ROI裁剪；其合成/文件/实机来源及框/标签含义以data/evidence/2026-10-03-arm-localize-baseline/README.md为准。 | 所在目录说明：[data/evidence/2026-10-03-arm-localize-baseline/README.md](../../../data/evidence/2026-10-03-arm-localize-baseline/README.md)<br>同名配套文件：[data/evidence/2026-10-03-arm-localize-baseline/pc-benchmark/run-15c1q9l_/720p_six/sample-03-crops-3zpx97jn/target_001.hex](../../../data/evidence/2026-10-03-arm-localize-baseline/pc-benchmark/run-15c1q9l_/720p_six/sample-03-crops-3zpx97jn/target_001.hex) |
| [data/evidence/2026-10-03-arm-localize-baseline/pc-benchmark/run-15c1q9l_/720p_six/sample-03-crops-3zpx97jn/target_002.hex](../../../data/evidence/2026-10-03-arm-localize-baseline/pc-benchmark/run-15c1q9l_/720p_six/sample-03-crops-3zpx97jn/target_002.hex)<br>十六进制数据 · 已纳入Git（含暂存） | 以十六进制数据形式保存target_002的目标ROI像素；由对应加载器/testbench读取，位宽、排布和端序按data/evidence/2026-10-03-arm-localize-baseline/README.md核对。 | 所在目录说明：[data/evidence/2026-10-03-arm-localize-baseline/README.md](../../../data/evidence/2026-10-03-arm-localize-baseline/README.md)<br>同名配套文件：[data/evidence/2026-10-03-arm-localize-baseline/pc-benchmark/run-15c1q9l_/720p_six/sample-03-crops-3zpx97jn/target_002.pgm](../../../data/evidence/2026-10-03-arm-localize-baseline/pc-benchmark/run-15c1q9l_/720p_six/sample-03-crops-3zpx97jn/target_002.pgm) |
| [data/evidence/2026-10-03-arm-localize-baseline/pc-benchmark/run-15c1q9l_/720p_six/sample-03-crops-3zpx97jn/target_002.pgm](../../../data/evidence/2026-10-03-arm-localize-baseline/pc-benchmark/run-15c1q9l_/720p_six/sample-03-crops-3zpx97jn/target_002.pgm)<br>灰度像素图 · 已纳入Git（含暂存） | 保存target_002的目标ROI裁剪；其合成/文件/实机来源及框/标签含义以data/evidence/2026-10-03-arm-localize-baseline/README.md为准。 | 所在目录说明：[data/evidence/2026-10-03-arm-localize-baseline/README.md](../../../data/evidence/2026-10-03-arm-localize-baseline/README.md)<br>同名配套文件：[data/evidence/2026-10-03-arm-localize-baseline/pc-benchmark/run-15c1q9l_/720p_six/sample-03-crops-3zpx97jn/target_002.hex](../../../data/evidence/2026-10-03-arm-localize-baseline/pc-benchmark/run-15c1q9l_/720p_six/sample-03-crops-3zpx97jn/target_002.hex) |
| [data/evidence/2026-10-03-arm-localize-baseline/pc-benchmark/run-15c1q9l_/720p_six/sample-03-crops-3zpx97jn/target_003.hex](../../../data/evidence/2026-10-03-arm-localize-baseline/pc-benchmark/run-15c1q9l_/720p_six/sample-03-crops-3zpx97jn/target_003.hex)<br>十六进制数据 · 已纳入Git（含暂存） | 以十六进制数据形式保存target_003的目标ROI像素；由对应加载器/testbench读取，位宽、排布和端序按data/evidence/2026-10-03-arm-localize-baseline/README.md核对。 | 所在目录说明：[data/evidence/2026-10-03-arm-localize-baseline/README.md](../../../data/evidence/2026-10-03-arm-localize-baseline/README.md)<br>同名配套文件：[data/evidence/2026-10-03-arm-localize-baseline/pc-benchmark/run-15c1q9l_/720p_six/sample-03-crops-3zpx97jn/target_003.pgm](../../../data/evidence/2026-10-03-arm-localize-baseline/pc-benchmark/run-15c1q9l_/720p_six/sample-03-crops-3zpx97jn/target_003.pgm) |
| [data/evidence/2026-10-03-arm-localize-baseline/pc-benchmark/run-15c1q9l_/720p_six/sample-03-crops-3zpx97jn/target_003.pgm](../../../data/evidence/2026-10-03-arm-localize-baseline/pc-benchmark/run-15c1q9l_/720p_six/sample-03-crops-3zpx97jn/target_003.pgm)<br>灰度像素图 · 已纳入Git（含暂存） | 保存target_003的目标ROI裁剪；其合成/文件/实机来源及框/标签含义以data/evidence/2026-10-03-arm-localize-baseline/README.md为准。 | 所在目录说明：[data/evidence/2026-10-03-arm-localize-baseline/README.md](../../../data/evidence/2026-10-03-arm-localize-baseline/README.md)<br>同名配套文件：[data/evidence/2026-10-03-arm-localize-baseline/pc-benchmark/run-15c1q9l_/720p_six/sample-03-crops-3zpx97jn/target_003.hex](../../../data/evidence/2026-10-03-arm-localize-baseline/pc-benchmark/run-15c1q9l_/720p_six/sample-03-crops-3zpx97jn/target_003.hex) |
| [data/evidence/2026-10-03-arm-localize-baseline/pc-benchmark/run-15c1q9l_/720p_six/sample-03-crops-3zpx97jn/target_004.hex](../../../data/evidence/2026-10-03-arm-localize-baseline/pc-benchmark/run-15c1q9l_/720p_six/sample-03-crops-3zpx97jn/target_004.hex)<br>十六进制数据 · 已纳入Git（含暂存） | 以十六进制数据形式保存target_004的目标ROI像素；由对应加载器/testbench读取，位宽、排布和端序按data/evidence/2026-10-03-arm-localize-baseline/README.md核对。 | 所在目录说明：[data/evidence/2026-10-03-arm-localize-baseline/README.md](../../../data/evidence/2026-10-03-arm-localize-baseline/README.md)<br>同名配套文件：[data/evidence/2026-10-03-arm-localize-baseline/pc-benchmark/run-15c1q9l_/720p_six/sample-03-crops-3zpx97jn/target_004.pgm](../../../data/evidence/2026-10-03-arm-localize-baseline/pc-benchmark/run-15c1q9l_/720p_six/sample-03-crops-3zpx97jn/target_004.pgm) |
| [data/evidence/2026-10-03-arm-localize-baseline/pc-benchmark/run-15c1q9l_/720p_six/sample-03-crops-3zpx97jn/target_004.pgm](../../../data/evidence/2026-10-03-arm-localize-baseline/pc-benchmark/run-15c1q9l_/720p_six/sample-03-crops-3zpx97jn/target_004.pgm)<br>灰度像素图 · 已纳入Git（含暂存） | 保存target_004的目标ROI裁剪；其合成/文件/实机来源及框/标签含义以data/evidence/2026-10-03-arm-localize-baseline/README.md为准。 | 所在目录说明：[data/evidence/2026-10-03-arm-localize-baseline/README.md](../../../data/evidence/2026-10-03-arm-localize-baseline/README.md)<br>同名配套文件：[data/evidence/2026-10-03-arm-localize-baseline/pc-benchmark/run-15c1q9l_/720p_six/sample-03-crops-3zpx97jn/target_004.hex](../../../data/evidence/2026-10-03-arm-localize-baseline/pc-benchmark/run-15c1q9l_/720p_six/sample-03-crops-3zpx97jn/target_004.hex) |
| [data/evidence/2026-10-03-arm-localize-baseline/pc-benchmark/run-15c1q9l_/720p_six/sample-03-crops-3zpx97jn/target_005.hex](../../../data/evidence/2026-10-03-arm-localize-baseline/pc-benchmark/run-15c1q9l_/720p_six/sample-03-crops-3zpx97jn/target_005.hex)<br>十六进制数据 · 已纳入Git（含暂存） | 以十六进制数据形式保存target_005的目标ROI像素；由对应加载器/testbench读取，位宽、排布和端序按data/evidence/2026-10-03-arm-localize-baseline/README.md核对。 | 所在目录说明：[data/evidence/2026-10-03-arm-localize-baseline/README.md](../../../data/evidence/2026-10-03-arm-localize-baseline/README.md)<br>同名配套文件：[data/evidence/2026-10-03-arm-localize-baseline/pc-benchmark/run-15c1q9l_/720p_six/sample-03-crops-3zpx97jn/target_005.pgm](../../../data/evidence/2026-10-03-arm-localize-baseline/pc-benchmark/run-15c1q9l_/720p_six/sample-03-crops-3zpx97jn/target_005.pgm) |
| [data/evidence/2026-10-03-arm-localize-baseline/pc-benchmark/run-15c1q9l_/720p_six/sample-03-crops-3zpx97jn/target_005.pgm](../../../data/evidence/2026-10-03-arm-localize-baseline/pc-benchmark/run-15c1q9l_/720p_six/sample-03-crops-3zpx97jn/target_005.pgm)<br>灰度像素图 · 已纳入Git（含暂存） | 保存target_005的目标ROI裁剪；其合成/文件/实机来源及框/标签含义以data/evidence/2026-10-03-arm-localize-baseline/README.md为准。 | 所在目录说明：[data/evidence/2026-10-03-arm-localize-baseline/README.md](../../../data/evidence/2026-10-03-arm-localize-baseline/README.md)<br>同名配套文件：[data/evidence/2026-10-03-arm-localize-baseline/pc-benchmark/run-15c1q9l_/720p_six/sample-03-crops-3zpx97jn/target_005.hex](../../../data/evidence/2026-10-03-arm-localize-baseline/pc-benchmark/run-15c1q9l_/720p_six/sample-03-crops-3zpx97jn/target_005.hex) |
| **data/evidence/2026-10-03-arm-localize-baseline/pc-benchmark/run-15c1q9l_/720p_six** | | |
| [data/evidence/2026-10-03-arm-localize-baseline/pc-benchmark/run-15c1q9l_/720p_six/sample-03.json](../../../data/evidence/2026-10-03-arm-localize-baseline/pc-benchmark/run-15c1q9l_/720p_six/sample-03.json)<br>结构化结果/元数据 · 已纳入Git（含暂存） | 保存sample-03的实验结果或检查产物，字段包括frame_id、config_id、width、height、status、targets、schema_version；与data/evidence/2026-10-03-arm-localize-baseline/README.md中的生成/校验流程一起使用。 | 所在目录说明：[data/evidence/2026-10-03-arm-localize-baseline/README.md](../../../data/evidence/2026-10-03-arm-localize-baseline/README.md)<br>同目录输入/元数据：[data/evidence/2026-10-03-arm-localize-baseline/pc-benchmark/run-15c1q9l_/720p_six/input.json](../../../data/evidence/2026-10-03-arm-localize-baseline/pc-benchmark/run-15c1q9l_/720p_six/input.json) |
| **data/evidence/2026-10-03-arm-localize-baseline/pc-benchmark/run-15c1q9l_/720p_six/sample-04-crops-7giyf_eo** | | |
| [data/evidence/2026-10-03-arm-localize-baseline/pc-benchmark/run-15c1q9l_/720p_six/sample-04-crops-7giyf_eo/target_000.hex](../../../data/evidence/2026-10-03-arm-localize-baseline/pc-benchmark/run-15c1q9l_/720p_six/sample-04-crops-7giyf_eo/target_000.hex)<br>十六进制数据 · 已纳入Git（含暂存） | 以十六进制数据形式保存target_000的目标ROI像素；由对应加载器/testbench读取，位宽、排布和端序按data/evidence/2026-10-03-arm-localize-baseline/README.md核对。 | 所在目录说明：[data/evidence/2026-10-03-arm-localize-baseline/README.md](../../../data/evidence/2026-10-03-arm-localize-baseline/README.md)<br>同名配套文件：[data/evidence/2026-10-03-arm-localize-baseline/pc-benchmark/run-15c1q9l_/720p_six/sample-04-crops-7giyf_eo/target_000.pgm](../../../data/evidence/2026-10-03-arm-localize-baseline/pc-benchmark/run-15c1q9l_/720p_six/sample-04-crops-7giyf_eo/target_000.pgm) |
| [data/evidence/2026-10-03-arm-localize-baseline/pc-benchmark/run-15c1q9l_/720p_six/sample-04-crops-7giyf_eo/target_000.pgm](../../../data/evidence/2026-10-03-arm-localize-baseline/pc-benchmark/run-15c1q9l_/720p_six/sample-04-crops-7giyf_eo/target_000.pgm)<br>灰度像素图 · 已纳入Git（含暂存） | 保存target_000的目标ROI裁剪；其合成/文件/实机来源及框/标签含义以data/evidence/2026-10-03-arm-localize-baseline/README.md为准。 | 所在目录说明：[data/evidence/2026-10-03-arm-localize-baseline/README.md](../../../data/evidence/2026-10-03-arm-localize-baseline/README.md)<br>同名配套文件：[data/evidence/2026-10-03-arm-localize-baseline/pc-benchmark/run-15c1q9l_/720p_six/sample-04-crops-7giyf_eo/target_000.hex](../../../data/evidence/2026-10-03-arm-localize-baseline/pc-benchmark/run-15c1q9l_/720p_six/sample-04-crops-7giyf_eo/target_000.hex) |
| [data/evidence/2026-10-03-arm-localize-baseline/pc-benchmark/run-15c1q9l_/720p_six/sample-04-crops-7giyf_eo/target_001.hex](../../../data/evidence/2026-10-03-arm-localize-baseline/pc-benchmark/run-15c1q9l_/720p_six/sample-04-crops-7giyf_eo/target_001.hex)<br>十六进制数据 · 已纳入Git（含暂存） | 以十六进制数据形式保存target_001的目标ROI像素；由对应加载器/testbench读取，位宽、排布和端序按data/evidence/2026-10-03-arm-localize-baseline/README.md核对。 | 所在目录说明：[data/evidence/2026-10-03-arm-localize-baseline/README.md](../../../data/evidence/2026-10-03-arm-localize-baseline/README.md)<br>同名配套文件：[data/evidence/2026-10-03-arm-localize-baseline/pc-benchmark/run-15c1q9l_/720p_six/sample-04-crops-7giyf_eo/target_001.pgm](../../../data/evidence/2026-10-03-arm-localize-baseline/pc-benchmark/run-15c1q9l_/720p_six/sample-04-crops-7giyf_eo/target_001.pgm) |
| [data/evidence/2026-10-03-arm-localize-baseline/pc-benchmark/run-15c1q9l_/720p_six/sample-04-crops-7giyf_eo/target_001.pgm](../../../data/evidence/2026-10-03-arm-localize-baseline/pc-benchmark/run-15c1q9l_/720p_six/sample-04-crops-7giyf_eo/target_001.pgm)<br>灰度像素图 · 已纳入Git（含暂存） | 保存target_001的目标ROI裁剪；其合成/文件/实机来源及框/标签含义以data/evidence/2026-10-03-arm-localize-baseline/README.md为准。 | 所在目录说明：[data/evidence/2026-10-03-arm-localize-baseline/README.md](../../../data/evidence/2026-10-03-arm-localize-baseline/README.md)<br>同名配套文件：[data/evidence/2026-10-03-arm-localize-baseline/pc-benchmark/run-15c1q9l_/720p_six/sample-04-crops-7giyf_eo/target_001.hex](../../../data/evidence/2026-10-03-arm-localize-baseline/pc-benchmark/run-15c1q9l_/720p_six/sample-04-crops-7giyf_eo/target_001.hex) |
| [data/evidence/2026-10-03-arm-localize-baseline/pc-benchmark/run-15c1q9l_/720p_six/sample-04-crops-7giyf_eo/target_002.hex](../../../data/evidence/2026-10-03-arm-localize-baseline/pc-benchmark/run-15c1q9l_/720p_six/sample-04-crops-7giyf_eo/target_002.hex)<br>十六进制数据 · 已纳入Git（含暂存） | 以十六进制数据形式保存target_002的目标ROI像素；由对应加载器/testbench读取，位宽、排布和端序按data/evidence/2026-10-03-arm-localize-baseline/README.md核对。 | 所在目录说明：[data/evidence/2026-10-03-arm-localize-baseline/README.md](../../../data/evidence/2026-10-03-arm-localize-baseline/README.md)<br>同名配套文件：[data/evidence/2026-10-03-arm-localize-baseline/pc-benchmark/run-15c1q9l_/720p_six/sample-04-crops-7giyf_eo/target_002.pgm](../../../data/evidence/2026-10-03-arm-localize-baseline/pc-benchmark/run-15c1q9l_/720p_six/sample-04-crops-7giyf_eo/target_002.pgm) |
| [data/evidence/2026-10-03-arm-localize-baseline/pc-benchmark/run-15c1q9l_/720p_six/sample-04-crops-7giyf_eo/target_002.pgm](../../../data/evidence/2026-10-03-arm-localize-baseline/pc-benchmark/run-15c1q9l_/720p_six/sample-04-crops-7giyf_eo/target_002.pgm)<br>灰度像素图 · 已纳入Git（含暂存） | 保存target_002的目标ROI裁剪；其合成/文件/实机来源及框/标签含义以data/evidence/2026-10-03-arm-localize-baseline/README.md为准。 | 所在目录说明：[data/evidence/2026-10-03-arm-localize-baseline/README.md](../../../data/evidence/2026-10-03-arm-localize-baseline/README.md)<br>同名配套文件：[data/evidence/2026-10-03-arm-localize-baseline/pc-benchmark/run-15c1q9l_/720p_six/sample-04-crops-7giyf_eo/target_002.hex](../../../data/evidence/2026-10-03-arm-localize-baseline/pc-benchmark/run-15c1q9l_/720p_six/sample-04-crops-7giyf_eo/target_002.hex) |
| [data/evidence/2026-10-03-arm-localize-baseline/pc-benchmark/run-15c1q9l_/720p_six/sample-04-crops-7giyf_eo/target_003.hex](../../../data/evidence/2026-10-03-arm-localize-baseline/pc-benchmark/run-15c1q9l_/720p_six/sample-04-crops-7giyf_eo/target_003.hex)<br>十六进制数据 · 已纳入Git（含暂存） | 以十六进制数据形式保存target_003的目标ROI像素；由对应加载器/testbench读取，位宽、排布和端序按data/evidence/2026-10-03-arm-localize-baseline/README.md核对。 | 所在目录说明：[data/evidence/2026-10-03-arm-localize-baseline/README.md](../../../data/evidence/2026-10-03-arm-localize-baseline/README.md)<br>同名配套文件：[data/evidence/2026-10-03-arm-localize-baseline/pc-benchmark/run-15c1q9l_/720p_six/sample-04-crops-7giyf_eo/target_003.pgm](../../../data/evidence/2026-10-03-arm-localize-baseline/pc-benchmark/run-15c1q9l_/720p_six/sample-04-crops-7giyf_eo/target_003.pgm) |
| [data/evidence/2026-10-03-arm-localize-baseline/pc-benchmark/run-15c1q9l_/720p_six/sample-04-crops-7giyf_eo/target_003.pgm](../../../data/evidence/2026-10-03-arm-localize-baseline/pc-benchmark/run-15c1q9l_/720p_six/sample-04-crops-7giyf_eo/target_003.pgm)<br>灰度像素图 · 已纳入Git（含暂存） | 保存target_003的目标ROI裁剪；其合成/文件/实机来源及框/标签含义以data/evidence/2026-10-03-arm-localize-baseline/README.md为准。 | 所在目录说明：[data/evidence/2026-10-03-arm-localize-baseline/README.md](../../../data/evidence/2026-10-03-arm-localize-baseline/README.md)<br>同名配套文件：[data/evidence/2026-10-03-arm-localize-baseline/pc-benchmark/run-15c1q9l_/720p_six/sample-04-crops-7giyf_eo/target_003.hex](../../../data/evidence/2026-10-03-arm-localize-baseline/pc-benchmark/run-15c1q9l_/720p_six/sample-04-crops-7giyf_eo/target_003.hex) |
| [data/evidence/2026-10-03-arm-localize-baseline/pc-benchmark/run-15c1q9l_/720p_six/sample-04-crops-7giyf_eo/target_004.hex](../../../data/evidence/2026-10-03-arm-localize-baseline/pc-benchmark/run-15c1q9l_/720p_six/sample-04-crops-7giyf_eo/target_004.hex)<br>十六进制数据 · 已纳入Git（含暂存） | 以十六进制数据形式保存target_004的目标ROI像素；由对应加载器/testbench读取，位宽、排布和端序按data/evidence/2026-10-03-arm-localize-baseline/README.md核对。 | 所在目录说明：[data/evidence/2026-10-03-arm-localize-baseline/README.md](../../../data/evidence/2026-10-03-arm-localize-baseline/README.md)<br>同名配套文件：[data/evidence/2026-10-03-arm-localize-baseline/pc-benchmark/run-15c1q9l_/720p_six/sample-04-crops-7giyf_eo/target_004.pgm](../../../data/evidence/2026-10-03-arm-localize-baseline/pc-benchmark/run-15c1q9l_/720p_six/sample-04-crops-7giyf_eo/target_004.pgm) |
| [data/evidence/2026-10-03-arm-localize-baseline/pc-benchmark/run-15c1q9l_/720p_six/sample-04-crops-7giyf_eo/target_004.pgm](../../../data/evidence/2026-10-03-arm-localize-baseline/pc-benchmark/run-15c1q9l_/720p_six/sample-04-crops-7giyf_eo/target_004.pgm)<br>灰度像素图 · 已纳入Git（含暂存） | 保存target_004的目标ROI裁剪；其合成/文件/实机来源及框/标签含义以data/evidence/2026-10-03-arm-localize-baseline/README.md为准。 | 所在目录说明：[data/evidence/2026-10-03-arm-localize-baseline/README.md](../../../data/evidence/2026-10-03-arm-localize-baseline/README.md)<br>同名配套文件：[data/evidence/2026-10-03-arm-localize-baseline/pc-benchmark/run-15c1q9l_/720p_six/sample-04-crops-7giyf_eo/target_004.hex](../../../data/evidence/2026-10-03-arm-localize-baseline/pc-benchmark/run-15c1q9l_/720p_six/sample-04-crops-7giyf_eo/target_004.hex) |
| [data/evidence/2026-10-03-arm-localize-baseline/pc-benchmark/run-15c1q9l_/720p_six/sample-04-crops-7giyf_eo/target_005.hex](../../../data/evidence/2026-10-03-arm-localize-baseline/pc-benchmark/run-15c1q9l_/720p_six/sample-04-crops-7giyf_eo/target_005.hex)<br>十六进制数据 · 已纳入Git（含暂存） | 以十六进制数据形式保存target_005的目标ROI像素；由对应加载器/testbench读取，位宽、排布和端序按data/evidence/2026-10-03-arm-localize-baseline/README.md核对。 | 所在目录说明：[data/evidence/2026-10-03-arm-localize-baseline/README.md](../../../data/evidence/2026-10-03-arm-localize-baseline/README.md)<br>同名配套文件：[data/evidence/2026-10-03-arm-localize-baseline/pc-benchmark/run-15c1q9l_/720p_six/sample-04-crops-7giyf_eo/target_005.pgm](../../../data/evidence/2026-10-03-arm-localize-baseline/pc-benchmark/run-15c1q9l_/720p_six/sample-04-crops-7giyf_eo/target_005.pgm) |
| [data/evidence/2026-10-03-arm-localize-baseline/pc-benchmark/run-15c1q9l_/720p_six/sample-04-crops-7giyf_eo/target_005.pgm](../../../data/evidence/2026-10-03-arm-localize-baseline/pc-benchmark/run-15c1q9l_/720p_six/sample-04-crops-7giyf_eo/target_005.pgm)<br>灰度像素图 · 已纳入Git（含暂存） | 保存target_005的目标ROI裁剪；其合成/文件/实机来源及框/标签含义以data/evidence/2026-10-03-arm-localize-baseline/README.md为准。 | 所在目录说明：[data/evidence/2026-10-03-arm-localize-baseline/README.md](../../../data/evidence/2026-10-03-arm-localize-baseline/README.md)<br>同名配套文件：[data/evidence/2026-10-03-arm-localize-baseline/pc-benchmark/run-15c1q9l_/720p_six/sample-04-crops-7giyf_eo/target_005.hex](../../../data/evidence/2026-10-03-arm-localize-baseline/pc-benchmark/run-15c1q9l_/720p_six/sample-04-crops-7giyf_eo/target_005.hex) |
| **data/evidence/2026-10-03-arm-localize-baseline/pc-benchmark/run-15c1q9l_/720p_six** | | |
| [data/evidence/2026-10-03-arm-localize-baseline/pc-benchmark/run-15c1q9l_/720p_six/sample-04.json](../../../data/evidence/2026-10-03-arm-localize-baseline/pc-benchmark/run-15c1q9l_/720p_six/sample-04.json)<br>结构化结果/元数据 · 已纳入Git（含暂存） | 保存sample-04的实验结果或检查产物，字段包括frame_id、config_id、width、height、status、targets、schema_version；与data/evidence/2026-10-03-arm-localize-baseline/README.md中的生成/校验流程一起使用。 | 所在目录说明：[data/evidence/2026-10-03-arm-localize-baseline/README.md](../../../data/evidence/2026-10-03-arm-localize-baseline/README.md)<br>同目录输入/元数据：[data/evidence/2026-10-03-arm-localize-baseline/pc-benchmark/run-15c1q9l_/720p_six/input.json](../../../data/evidence/2026-10-03-arm-localize-baseline/pc-benchmark/run-15c1q9l_/720p_six/input.json) |
| **data/evidence/2026-10-03-arm-localize-baseline/pc-benchmark/run-15c1q9l_/720p_six/warmup-00-crops-tv5b95n9** | | |
| [data/evidence/2026-10-03-arm-localize-baseline/pc-benchmark/run-15c1q9l_/720p_six/warmup-00-crops-tv5b95n9/target_000.hex](../../../data/evidence/2026-10-03-arm-localize-baseline/pc-benchmark/run-15c1q9l_/720p_six/warmup-00-crops-tv5b95n9/target_000.hex)<br>十六进制数据 · 已纳入Git（含暂存） | 以十六进制数据形式保存target_000的目标ROI像素；由对应加载器/testbench读取，位宽、排布和端序按data/evidence/2026-10-03-arm-localize-baseline/README.md核对。 | 所在目录说明：[data/evidence/2026-10-03-arm-localize-baseline/README.md](../../../data/evidence/2026-10-03-arm-localize-baseline/README.md)<br>同名配套文件：[data/evidence/2026-10-03-arm-localize-baseline/pc-benchmark/run-15c1q9l_/720p_six/warmup-00-crops-tv5b95n9/target_000.pgm](../../../data/evidence/2026-10-03-arm-localize-baseline/pc-benchmark/run-15c1q9l_/720p_six/warmup-00-crops-tv5b95n9/target_000.pgm) |
| [data/evidence/2026-10-03-arm-localize-baseline/pc-benchmark/run-15c1q9l_/720p_six/warmup-00-crops-tv5b95n9/target_000.pgm](../../../data/evidence/2026-10-03-arm-localize-baseline/pc-benchmark/run-15c1q9l_/720p_six/warmup-00-crops-tv5b95n9/target_000.pgm)<br>灰度像素图 · 已纳入Git（含暂存） | 保存target_000的目标ROI裁剪；其合成/文件/实机来源及框/标签含义以data/evidence/2026-10-03-arm-localize-baseline/README.md为准。 | 所在目录说明：[data/evidence/2026-10-03-arm-localize-baseline/README.md](../../../data/evidence/2026-10-03-arm-localize-baseline/README.md)<br>同名配套文件：[data/evidence/2026-10-03-arm-localize-baseline/pc-benchmark/run-15c1q9l_/720p_six/warmup-00-crops-tv5b95n9/target_000.hex](../../../data/evidence/2026-10-03-arm-localize-baseline/pc-benchmark/run-15c1q9l_/720p_six/warmup-00-crops-tv5b95n9/target_000.hex) |
| [data/evidence/2026-10-03-arm-localize-baseline/pc-benchmark/run-15c1q9l_/720p_six/warmup-00-crops-tv5b95n9/target_001.hex](../../../data/evidence/2026-10-03-arm-localize-baseline/pc-benchmark/run-15c1q9l_/720p_six/warmup-00-crops-tv5b95n9/target_001.hex)<br>十六进制数据 · 已纳入Git（含暂存） | 以十六进制数据形式保存target_001的目标ROI像素；由对应加载器/testbench读取，位宽、排布和端序按data/evidence/2026-10-03-arm-localize-baseline/README.md核对。 | 所在目录说明：[data/evidence/2026-10-03-arm-localize-baseline/README.md](../../../data/evidence/2026-10-03-arm-localize-baseline/README.md)<br>同名配套文件：[data/evidence/2026-10-03-arm-localize-baseline/pc-benchmark/run-15c1q9l_/720p_six/warmup-00-crops-tv5b95n9/target_001.pgm](../../../data/evidence/2026-10-03-arm-localize-baseline/pc-benchmark/run-15c1q9l_/720p_six/warmup-00-crops-tv5b95n9/target_001.pgm) |
| [data/evidence/2026-10-03-arm-localize-baseline/pc-benchmark/run-15c1q9l_/720p_six/warmup-00-crops-tv5b95n9/target_001.pgm](../../../data/evidence/2026-10-03-arm-localize-baseline/pc-benchmark/run-15c1q9l_/720p_six/warmup-00-crops-tv5b95n9/target_001.pgm)<br>灰度像素图 · 已纳入Git（含暂存） | 保存target_001的目标ROI裁剪；其合成/文件/实机来源及框/标签含义以data/evidence/2026-10-03-arm-localize-baseline/README.md为准。 | 所在目录说明：[data/evidence/2026-10-03-arm-localize-baseline/README.md](../../../data/evidence/2026-10-03-arm-localize-baseline/README.md)<br>同名配套文件：[data/evidence/2026-10-03-arm-localize-baseline/pc-benchmark/run-15c1q9l_/720p_six/warmup-00-crops-tv5b95n9/target_001.hex](../../../data/evidence/2026-10-03-arm-localize-baseline/pc-benchmark/run-15c1q9l_/720p_six/warmup-00-crops-tv5b95n9/target_001.hex) |
| [data/evidence/2026-10-03-arm-localize-baseline/pc-benchmark/run-15c1q9l_/720p_six/warmup-00-crops-tv5b95n9/target_002.hex](../../../data/evidence/2026-10-03-arm-localize-baseline/pc-benchmark/run-15c1q9l_/720p_six/warmup-00-crops-tv5b95n9/target_002.hex)<br>十六进制数据 · 已纳入Git（含暂存） | 以十六进制数据形式保存target_002的目标ROI像素；由对应加载器/testbench读取，位宽、排布和端序按data/evidence/2026-10-03-arm-localize-baseline/README.md核对。 | 所在目录说明：[data/evidence/2026-10-03-arm-localize-baseline/README.md](../../../data/evidence/2026-10-03-arm-localize-baseline/README.md)<br>同名配套文件：[data/evidence/2026-10-03-arm-localize-baseline/pc-benchmark/run-15c1q9l_/720p_six/warmup-00-crops-tv5b95n9/target_002.pgm](../../../data/evidence/2026-10-03-arm-localize-baseline/pc-benchmark/run-15c1q9l_/720p_six/warmup-00-crops-tv5b95n9/target_002.pgm) |
| [data/evidence/2026-10-03-arm-localize-baseline/pc-benchmark/run-15c1q9l_/720p_six/warmup-00-crops-tv5b95n9/target_002.pgm](../../../data/evidence/2026-10-03-arm-localize-baseline/pc-benchmark/run-15c1q9l_/720p_six/warmup-00-crops-tv5b95n9/target_002.pgm)<br>灰度像素图 · 已纳入Git（含暂存） | 保存target_002的目标ROI裁剪；其合成/文件/实机来源及框/标签含义以data/evidence/2026-10-03-arm-localize-baseline/README.md为准。 | 所在目录说明：[data/evidence/2026-10-03-arm-localize-baseline/README.md](../../../data/evidence/2026-10-03-arm-localize-baseline/README.md)<br>同名配套文件：[data/evidence/2026-10-03-arm-localize-baseline/pc-benchmark/run-15c1q9l_/720p_six/warmup-00-crops-tv5b95n9/target_002.hex](../../../data/evidence/2026-10-03-arm-localize-baseline/pc-benchmark/run-15c1q9l_/720p_six/warmup-00-crops-tv5b95n9/target_002.hex) |
| [data/evidence/2026-10-03-arm-localize-baseline/pc-benchmark/run-15c1q9l_/720p_six/warmup-00-crops-tv5b95n9/target_003.hex](../../../data/evidence/2026-10-03-arm-localize-baseline/pc-benchmark/run-15c1q9l_/720p_six/warmup-00-crops-tv5b95n9/target_003.hex)<br>十六进制数据 · 已纳入Git（含暂存） | 以十六进制数据形式保存target_003的目标ROI像素；由对应加载器/testbench读取，位宽、排布和端序按data/evidence/2026-10-03-arm-localize-baseline/README.md核对。 | 所在目录说明：[data/evidence/2026-10-03-arm-localize-baseline/README.md](../../../data/evidence/2026-10-03-arm-localize-baseline/README.md)<br>同名配套文件：[data/evidence/2026-10-03-arm-localize-baseline/pc-benchmark/run-15c1q9l_/720p_six/warmup-00-crops-tv5b95n9/target_003.pgm](../../../data/evidence/2026-10-03-arm-localize-baseline/pc-benchmark/run-15c1q9l_/720p_six/warmup-00-crops-tv5b95n9/target_003.pgm) |
| [data/evidence/2026-10-03-arm-localize-baseline/pc-benchmark/run-15c1q9l_/720p_six/warmup-00-crops-tv5b95n9/target_003.pgm](../../../data/evidence/2026-10-03-arm-localize-baseline/pc-benchmark/run-15c1q9l_/720p_six/warmup-00-crops-tv5b95n9/target_003.pgm)<br>灰度像素图 · 已纳入Git（含暂存） | 保存target_003的目标ROI裁剪；其合成/文件/实机来源及框/标签含义以data/evidence/2026-10-03-arm-localize-baseline/README.md为准。 | 所在目录说明：[data/evidence/2026-10-03-arm-localize-baseline/README.md](../../../data/evidence/2026-10-03-arm-localize-baseline/README.md)<br>同名配套文件：[data/evidence/2026-10-03-arm-localize-baseline/pc-benchmark/run-15c1q9l_/720p_six/warmup-00-crops-tv5b95n9/target_003.hex](../../../data/evidence/2026-10-03-arm-localize-baseline/pc-benchmark/run-15c1q9l_/720p_six/warmup-00-crops-tv5b95n9/target_003.hex) |
| [data/evidence/2026-10-03-arm-localize-baseline/pc-benchmark/run-15c1q9l_/720p_six/warmup-00-crops-tv5b95n9/target_004.hex](../../../data/evidence/2026-10-03-arm-localize-baseline/pc-benchmark/run-15c1q9l_/720p_six/warmup-00-crops-tv5b95n9/target_004.hex)<br>十六进制数据 · 已纳入Git（含暂存） | 以十六进制数据形式保存target_004的目标ROI像素；由对应加载器/testbench读取，位宽、排布和端序按data/evidence/2026-10-03-arm-localize-baseline/README.md核对。 | 所在目录说明：[data/evidence/2026-10-03-arm-localize-baseline/README.md](../../../data/evidence/2026-10-03-arm-localize-baseline/README.md)<br>同名配套文件：[data/evidence/2026-10-03-arm-localize-baseline/pc-benchmark/run-15c1q9l_/720p_six/warmup-00-crops-tv5b95n9/target_004.pgm](../../../data/evidence/2026-10-03-arm-localize-baseline/pc-benchmark/run-15c1q9l_/720p_six/warmup-00-crops-tv5b95n9/target_004.pgm) |
| [data/evidence/2026-10-03-arm-localize-baseline/pc-benchmark/run-15c1q9l_/720p_six/warmup-00-crops-tv5b95n9/target_004.pgm](../../../data/evidence/2026-10-03-arm-localize-baseline/pc-benchmark/run-15c1q9l_/720p_six/warmup-00-crops-tv5b95n9/target_004.pgm)<br>灰度像素图 · 已纳入Git（含暂存） | 保存target_004的目标ROI裁剪；其合成/文件/实机来源及框/标签含义以data/evidence/2026-10-03-arm-localize-baseline/README.md为准。 | 所在目录说明：[data/evidence/2026-10-03-arm-localize-baseline/README.md](../../../data/evidence/2026-10-03-arm-localize-baseline/README.md)<br>同名配套文件：[data/evidence/2026-10-03-arm-localize-baseline/pc-benchmark/run-15c1q9l_/720p_six/warmup-00-crops-tv5b95n9/target_004.hex](../../../data/evidence/2026-10-03-arm-localize-baseline/pc-benchmark/run-15c1q9l_/720p_six/warmup-00-crops-tv5b95n9/target_004.hex) |
| [data/evidence/2026-10-03-arm-localize-baseline/pc-benchmark/run-15c1q9l_/720p_six/warmup-00-crops-tv5b95n9/target_005.hex](../../../data/evidence/2026-10-03-arm-localize-baseline/pc-benchmark/run-15c1q9l_/720p_six/warmup-00-crops-tv5b95n9/target_005.hex)<br>十六进制数据 · 已纳入Git（含暂存） | 以十六进制数据形式保存target_005的目标ROI像素；由对应加载器/testbench读取，位宽、排布和端序按data/evidence/2026-10-03-arm-localize-baseline/README.md核对。 | 所在目录说明：[data/evidence/2026-10-03-arm-localize-baseline/README.md](../../../data/evidence/2026-10-03-arm-localize-baseline/README.md)<br>同名配套文件：[data/evidence/2026-10-03-arm-localize-baseline/pc-benchmark/run-15c1q9l_/720p_six/warmup-00-crops-tv5b95n9/target_005.pgm](../../../data/evidence/2026-10-03-arm-localize-baseline/pc-benchmark/run-15c1q9l_/720p_six/warmup-00-crops-tv5b95n9/target_005.pgm) |
| [data/evidence/2026-10-03-arm-localize-baseline/pc-benchmark/run-15c1q9l_/720p_six/warmup-00-crops-tv5b95n9/target_005.pgm](../../../data/evidence/2026-10-03-arm-localize-baseline/pc-benchmark/run-15c1q9l_/720p_six/warmup-00-crops-tv5b95n9/target_005.pgm)<br>灰度像素图 · 已纳入Git（含暂存） | 保存target_005的目标ROI裁剪；其合成/文件/实机来源及框/标签含义以data/evidence/2026-10-03-arm-localize-baseline/README.md为准。 | 所在目录说明：[data/evidence/2026-10-03-arm-localize-baseline/README.md](../../../data/evidence/2026-10-03-arm-localize-baseline/README.md)<br>同名配套文件：[data/evidence/2026-10-03-arm-localize-baseline/pc-benchmark/run-15c1q9l_/720p_six/warmup-00-crops-tv5b95n9/target_005.hex](../../../data/evidence/2026-10-03-arm-localize-baseline/pc-benchmark/run-15c1q9l_/720p_six/warmup-00-crops-tv5b95n9/target_005.hex) |
| **data/evidence/2026-10-03-arm-localize-baseline/pc-benchmark/run-15c1q9l_/720p_six** | | |
| [data/evidence/2026-10-03-arm-localize-baseline/pc-benchmark/run-15c1q9l_/720p_six/warmup-00.json](../../../data/evidence/2026-10-03-arm-localize-baseline/pc-benchmark/run-15c1q9l_/720p_six/warmup-00.json)<br>结构化结果/元数据 · 已纳入Git（含暂存） | 保存warmup-00的实验结果或检查产物，字段包括frame_id、config_id、width、height、status、targets、schema_version；与data/evidence/2026-10-03-arm-localize-baseline/README.md中的生成/校验流程一起使用。 | 所在目录说明：[data/evidence/2026-10-03-arm-localize-baseline/README.md](../../../data/evidence/2026-10-03-arm-localize-baseline/README.md)<br>同目录输入/元数据：[data/evidence/2026-10-03-arm-localize-baseline/pc-benchmark/run-15c1q9l_/720p_six/input.json](../../../data/evidence/2026-10-03-arm-localize-baseline/pc-benchmark/run-15c1q9l_/720p_six/input.json) |
| **data/evidence/2026-10-03-arm-localize-baseline/pc-benchmark/run-15c1q9l_/tiny** | | |
| [data/evidence/2026-10-03-arm-localize-baseline/pc-benchmark/run-15c1q9l_/tiny/input.json](../../../data/evidence/2026-10-03-arm-localize-baseline/pc-benchmark/run-15c1q9l_/tiny/input.json)<br>结构化结果/元数据 · 已纳入Git（含暂存） | 保存input的输入/设备/运行元数据，字段包括pixels；与data/evidence/2026-10-03-arm-localize-baseline/README.md中的生成/校验流程一起使用。 | 所在目录说明：[data/evidence/2026-10-03-arm-localize-baseline/README.md](../../../data/evidence/2026-10-03-arm-localize-baseline/README.md) |
| **data/evidence/2026-10-03-arm-localize-baseline/pc-benchmark/run-15c1q9l_/tiny/sample-00-crops-hb5i19gx** | | |
| [data/evidence/2026-10-03-arm-localize-baseline/pc-benchmark/run-15c1q9l_/tiny/sample-00-crops-hb5i19gx/target_000.hex](../../../data/evidence/2026-10-03-arm-localize-baseline/pc-benchmark/run-15c1q9l_/tiny/sample-00-crops-hb5i19gx/target_000.hex)<br>十六进制数据 · 已纳入Git（含暂存） | 以十六进制数据形式保存target_000的目标ROI像素；由对应加载器/testbench读取，位宽、排布和端序按data/evidence/2026-10-03-arm-localize-baseline/README.md核对。 | 所在目录说明：[data/evidence/2026-10-03-arm-localize-baseline/README.md](../../../data/evidence/2026-10-03-arm-localize-baseline/README.md)<br>同名配套文件：[data/evidence/2026-10-03-arm-localize-baseline/pc-benchmark/run-15c1q9l_/tiny/sample-00-crops-hb5i19gx/target_000.pgm](../../../data/evidence/2026-10-03-arm-localize-baseline/pc-benchmark/run-15c1q9l_/tiny/sample-00-crops-hb5i19gx/target_000.pgm) |
| [data/evidence/2026-10-03-arm-localize-baseline/pc-benchmark/run-15c1q9l_/tiny/sample-00-crops-hb5i19gx/target_000.pgm](../../../data/evidence/2026-10-03-arm-localize-baseline/pc-benchmark/run-15c1q9l_/tiny/sample-00-crops-hb5i19gx/target_000.pgm)<br>灰度像素图 · 已纳入Git（含暂存） | 保存target_000的目标ROI裁剪；其合成/文件/实机来源及框/标签含义以data/evidence/2026-10-03-arm-localize-baseline/README.md为准。 | 所在目录说明：[data/evidence/2026-10-03-arm-localize-baseline/README.md](../../../data/evidence/2026-10-03-arm-localize-baseline/README.md)<br>同名配套文件：[data/evidence/2026-10-03-arm-localize-baseline/pc-benchmark/run-15c1q9l_/tiny/sample-00-crops-hb5i19gx/target_000.hex](../../../data/evidence/2026-10-03-arm-localize-baseline/pc-benchmark/run-15c1q9l_/tiny/sample-00-crops-hb5i19gx/target_000.hex) |
| [data/evidence/2026-10-03-arm-localize-baseline/pc-benchmark/run-15c1q9l_/tiny/sample-00-crops-hb5i19gx/target_001.hex](../../../data/evidence/2026-10-03-arm-localize-baseline/pc-benchmark/run-15c1q9l_/tiny/sample-00-crops-hb5i19gx/target_001.hex)<br>十六进制数据 · 已纳入Git（含暂存） | 以十六进制数据形式保存target_001的目标ROI像素；由对应加载器/testbench读取，位宽、排布和端序按data/evidence/2026-10-03-arm-localize-baseline/README.md核对。 | 所在目录说明：[data/evidence/2026-10-03-arm-localize-baseline/README.md](../../../data/evidence/2026-10-03-arm-localize-baseline/README.md)<br>同名配套文件：[data/evidence/2026-10-03-arm-localize-baseline/pc-benchmark/run-15c1q9l_/tiny/sample-00-crops-hb5i19gx/target_001.pgm](../../../data/evidence/2026-10-03-arm-localize-baseline/pc-benchmark/run-15c1q9l_/tiny/sample-00-crops-hb5i19gx/target_001.pgm) |
| [data/evidence/2026-10-03-arm-localize-baseline/pc-benchmark/run-15c1q9l_/tiny/sample-00-crops-hb5i19gx/target_001.pgm](../../../data/evidence/2026-10-03-arm-localize-baseline/pc-benchmark/run-15c1q9l_/tiny/sample-00-crops-hb5i19gx/target_001.pgm)<br>灰度像素图 · 已纳入Git（含暂存） | 保存target_001的目标ROI裁剪；其合成/文件/实机来源及框/标签含义以data/evidence/2026-10-03-arm-localize-baseline/README.md为准。 | 所在目录说明：[data/evidence/2026-10-03-arm-localize-baseline/README.md](../../../data/evidence/2026-10-03-arm-localize-baseline/README.md)<br>同名配套文件：[data/evidence/2026-10-03-arm-localize-baseline/pc-benchmark/run-15c1q9l_/tiny/sample-00-crops-hb5i19gx/target_001.hex](../../../data/evidence/2026-10-03-arm-localize-baseline/pc-benchmark/run-15c1q9l_/tiny/sample-00-crops-hb5i19gx/target_001.hex) |
| **data/evidence/2026-10-03-arm-localize-baseline/pc-benchmark/run-15c1q9l_/tiny** | | |
| [data/evidence/2026-10-03-arm-localize-baseline/pc-benchmark/run-15c1q9l_/tiny/sample-00.json](../../../data/evidence/2026-10-03-arm-localize-baseline/pc-benchmark/run-15c1q9l_/tiny/sample-00.json)<br>结构化结果/元数据 · 已纳入Git（含暂存） | 保存sample-00的实验结果或检查产物，字段包括frame_id、config_id、width、height、status、targets、schema_version；与data/evidence/2026-10-03-arm-localize-baseline/README.md中的生成/校验流程一起使用。 | 所在目录说明：[data/evidence/2026-10-03-arm-localize-baseline/README.md](../../../data/evidence/2026-10-03-arm-localize-baseline/README.md)<br>同目录输入/元数据：[data/evidence/2026-10-03-arm-localize-baseline/pc-benchmark/run-15c1q9l_/tiny/input.json](../../../data/evidence/2026-10-03-arm-localize-baseline/pc-benchmark/run-15c1q9l_/tiny/input.json) |
| **data/evidence/2026-10-03-arm-localize-baseline/pc-benchmark/run-15c1q9l_/tiny/sample-01-crops-96h6andm** | | |
| [data/evidence/2026-10-03-arm-localize-baseline/pc-benchmark/run-15c1q9l_/tiny/sample-01-crops-96h6andm/target_000.hex](../../../data/evidence/2026-10-03-arm-localize-baseline/pc-benchmark/run-15c1q9l_/tiny/sample-01-crops-96h6andm/target_000.hex)<br>十六进制数据 · 已纳入Git（含暂存） | 以十六进制数据形式保存target_000的目标ROI像素；由对应加载器/testbench读取，位宽、排布和端序按data/evidence/2026-10-03-arm-localize-baseline/README.md核对。 | 所在目录说明：[data/evidence/2026-10-03-arm-localize-baseline/README.md](../../../data/evidence/2026-10-03-arm-localize-baseline/README.md)<br>同名配套文件：[data/evidence/2026-10-03-arm-localize-baseline/pc-benchmark/run-15c1q9l_/tiny/sample-01-crops-96h6andm/target_000.pgm](../../../data/evidence/2026-10-03-arm-localize-baseline/pc-benchmark/run-15c1q9l_/tiny/sample-01-crops-96h6andm/target_000.pgm) |
| [data/evidence/2026-10-03-arm-localize-baseline/pc-benchmark/run-15c1q9l_/tiny/sample-01-crops-96h6andm/target_000.pgm](../../../data/evidence/2026-10-03-arm-localize-baseline/pc-benchmark/run-15c1q9l_/tiny/sample-01-crops-96h6andm/target_000.pgm)<br>灰度像素图 · 已纳入Git（含暂存） | 保存target_000的目标ROI裁剪；其合成/文件/实机来源及框/标签含义以data/evidence/2026-10-03-arm-localize-baseline/README.md为准。 | 所在目录说明：[data/evidence/2026-10-03-arm-localize-baseline/README.md](../../../data/evidence/2026-10-03-arm-localize-baseline/README.md)<br>同名配套文件：[data/evidence/2026-10-03-arm-localize-baseline/pc-benchmark/run-15c1q9l_/tiny/sample-01-crops-96h6andm/target_000.hex](../../../data/evidence/2026-10-03-arm-localize-baseline/pc-benchmark/run-15c1q9l_/tiny/sample-01-crops-96h6andm/target_000.hex) |
| [data/evidence/2026-10-03-arm-localize-baseline/pc-benchmark/run-15c1q9l_/tiny/sample-01-crops-96h6andm/target_001.hex](../../../data/evidence/2026-10-03-arm-localize-baseline/pc-benchmark/run-15c1q9l_/tiny/sample-01-crops-96h6andm/target_001.hex)<br>十六进制数据 · 已纳入Git（含暂存） | 以十六进制数据形式保存target_001的目标ROI像素；由对应加载器/testbench读取，位宽、排布和端序按data/evidence/2026-10-03-arm-localize-baseline/README.md核对。 | 所在目录说明：[data/evidence/2026-10-03-arm-localize-baseline/README.md](../../../data/evidence/2026-10-03-arm-localize-baseline/README.md)<br>同名配套文件：[data/evidence/2026-10-03-arm-localize-baseline/pc-benchmark/run-15c1q9l_/tiny/sample-01-crops-96h6andm/target_001.pgm](../../../data/evidence/2026-10-03-arm-localize-baseline/pc-benchmark/run-15c1q9l_/tiny/sample-01-crops-96h6andm/target_001.pgm) |
| [data/evidence/2026-10-03-arm-localize-baseline/pc-benchmark/run-15c1q9l_/tiny/sample-01-crops-96h6andm/target_001.pgm](../../../data/evidence/2026-10-03-arm-localize-baseline/pc-benchmark/run-15c1q9l_/tiny/sample-01-crops-96h6andm/target_001.pgm)<br>灰度像素图 · 已纳入Git（含暂存） | 保存target_001的目标ROI裁剪；其合成/文件/实机来源及框/标签含义以data/evidence/2026-10-03-arm-localize-baseline/README.md为准。 | 所在目录说明：[data/evidence/2026-10-03-arm-localize-baseline/README.md](../../../data/evidence/2026-10-03-arm-localize-baseline/README.md)<br>同名配套文件：[data/evidence/2026-10-03-arm-localize-baseline/pc-benchmark/run-15c1q9l_/tiny/sample-01-crops-96h6andm/target_001.hex](../../../data/evidence/2026-10-03-arm-localize-baseline/pc-benchmark/run-15c1q9l_/tiny/sample-01-crops-96h6andm/target_001.hex) |
| **data/evidence/2026-10-03-arm-localize-baseline/pc-benchmark/run-15c1q9l_/tiny** | | |
| [data/evidence/2026-10-03-arm-localize-baseline/pc-benchmark/run-15c1q9l_/tiny/sample-01.json](../../../data/evidence/2026-10-03-arm-localize-baseline/pc-benchmark/run-15c1q9l_/tiny/sample-01.json)<br>结构化结果/元数据 · 已纳入Git（含暂存） | 保存sample-01的实验结果或检查产物，字段包括frame_id、config_id、width、height、status、targets、schema_version；与data/evidence/2026-10-03-arm-localize-baseline/README.md中的生成/校验流程一起使用。 | 所在目录说明：[data/evidence/2026-10-03-arm-localize-baseline/README.md](../../../data/evidence/2026-10-03-arm-localize-baseline/README.md)<br>同目录输入/元数据：[data/evidence/2026-10-03-arm-localize-baseline/pc-benchmark/run-15c1q9l_/tiny/input.json](../../../data/evidence/2026-10-03-arm-localize-baseline/pc-benchmark/run-15c1q9l_/tiny/input.json) |
| **data/evidence/2026-10-03-arm-localize-baseline/pc-benchmark/run-15c1q9l_/tiny/sample-02-crops-vpte4cjo** | | |
| [data/evidence/2026-10-03-arm-localize-baseline/pc-benchmark/run-15c1q9l_/tiny/sample-02-crops-vpte4cjo/target_000.hex](../../../data/evidence/2026-10-03-arm-localize-baseline/pc-benchmark/run-15c1q9l_/tiny/sample-02-crops-vpte4cjo/target_000.hex)<br>十六进制数据 · 已纳入Git（含暂存） | 以十六进制数据形式保存target_000的目标ROI像素；由对应加载器/testbench读取，位宽、排布和端序按data/evidence/2026-10-03-arm-localize-baseline/README.md核对。 | 所在目录说明：[data/evidence/2026-10-03-arm-localize-baseline/README.md](../../../data/evidence/2026-10-03-arm-localize-baseline/README.md)<br>同名配套文件：[data/evidence/2026-10-03-arm-localize-baseline/pc-benchmark/run-15c1q9l_/tiny/sample-02-crops-vpte4cjo/target_000.pgm](../../../data/evidence/2026-10-03-arm-localize-baseline/pc-benchmark/run-15c1q9l_/tiny/sample-02-crops-vpte4cjo/target_000.pgm) |
| [data/evidence/2026-10-03-arm-localize-baseline/pc-benchmark/run-15c1q9l_/tiny/sample-02-crops-vpte4cjo/target_000.pgm](../../../data/evidence/2026-10-03-arm-localize-baseline/pc-benchmark/run-15c1q9l_/tiny/sample-02-crops-vpte4cjo/target_000.pgm)<br>灰度像素图 · 已纳入Git（含暂存） | 保存target_000的目标ROI裁剪；其合成/文件/实机来源及框/标签含义以data/evidence/2026-10-03-arm-localize-baseline/README.md为准。 | 所在目录说明：[data/evidence/2026-10-03-arm-localize-baseline/README.md](../../../data/evidence/2026-10-03-arm-localize-baseline/README.md)<br>同名配套文件：[data/evidence/2026-10-03-arm-localize-baseline/pc-benchmark/run-15c1q9l_/tiny/sample-02-crops-vpte4cjo/target_000.hex](../../../data/evidence/2026-10-03-arm-localize-baseline/pc-benchmark/run-15c1q9l_/tiny/sample-02-crops-vpte4cjo/target_000.hex) |
| [data/evidence/2026-10-03-arm-localize-baseline/pc-benchmark/run-15c1q9l_/tiny/sample-02-crops-vpte4cjo/target_001.hex](../../../data/evidence/2026-10-03-arm-localize-baseline/pc-benchmark/run-15c1q9l_/tiny/sample-02-crops-vpte4cjo/target_001.hex)<br>十六进制数据 · 已纳入Git（含暂存） | 以十六进制数据形式保存target_001的目标ROI像素；由对应加载器/testbench读取，位宽、排布和端序按data/evidence/2026-10-03-arm-localize-baseline/README.md核对。 | 所在目录说明：[data/evidence/2026-10-03-arm-localize-baseline/README.md](../../../data/evidence/2026-10-03-arm-localize-baseline/README.md)<br>同名配套文件：[data/evidence/2026-10-03-arm-localize-baseline/pc-benchmark/run-15c1q9l_/tiny/sample-02-crops-vpte4cjo/target_001.pgm](../../../data/evidence/2026-10-03-arm-localize-baseline/pc-benchmark/run-15c1q9l_/tiny/sample-02-crops-vpte4cjo/target_001.pgm) |
| [data/evidence/2026-10-03-arm-localize-baseline/pc-benchmark/run-15c1q9l_/tiny/sample-02-crops-vpte4cjo/target_001.pgm](../../../data/evidence/2026-10-03-arm-localize-baseline/pc-benchmark/run-15c1q9l_/tiny/sample-02-crops-vpte4cjo/target_001.pgm)<br>灰度像素图 · 已纳入Git（含暂存） | 保存target_001的目标ROI裁剪；其合成/文件/实机来源及框/标签含义以data/evidence/2026-10-03-arm-localize-baseline/README.md为准。 | 所在目录说明：[data/evidence/2026-10-03-arm-localize-baseline/README.md](../../../data/evidence/2026-10-03-arm-localize-baseline/README.md)<br>同名配套文件：[data/evidence/2026-10-03-arm-localize-baseline/pc-benchmark/run-15c1q9l_/tiny/sample-02-crops-vpte4cjo/target_001.hex](../../../data/evidence/2026-10-03-arm-localize-baseline/pc-benchmark/run-15c1q9l_/tiny/sample-02-crops-vpte4cjo/target_001.hex) |
| **data/evidence/2026-10-03-arm-localize-baseline/pc-benchmark/run-15c1q9l_/tiny** | | |
| [data/evidence/2026-10-03-arm-localize-baseline/pc-benchmark/run-15c1q9l_/tiny/sample-02.json](../../../data/evidence/2026-10-03-arm-localize-baseline/pc-benchmark/run-15c1q9l_/tiny/sample-02.json)<br>结构化结果/元数据 · 已纳入Git（含暂存） | 保存sample-02的实验结果或检查产物，字段包括frame_id、config_id、width、height、status、targets、schema_version；与data/evidence/2026-10-03-arm-localize-baseline/README.md中的生成/校验流程一起使用。 | 所在目录说明：[data/evidence/2026-10-03-arm-localize-baseline/README.md](../../../data/evidence/2026-10-03-arm-localize-baseline/README.md)<br>同目录输入/元数据：[data/evidence/2026-10-03-arm-localize-baseline/pc-benchmark/run-15c1q9l_/tiny/input.json](../../../data/evidence/2026-10-03-arm-localize-baseline/pc-benchmark/run-15c1q9l_/tiny/input.json) |
| **data/evidence/2026-10-03-arm-localize-baseline/pc-benchmark/run-15c1q9l_/tiny/sample-03-crops-l0nd6bdm** | | |
| [data/evidence/2026-10-03-arm-localize-baseline/pc-benchmark/run-15c1q9l_/tiny/sample-03-crops-l0nd6bdm/target_000.hex](../../../data/evidence/2026-10-03-arm-localize-baseline/pc-benchmark/run-15c1q9l_/tiny/sample-03-crops-l0nd6bdm/target_000.hex)<br>十六进制数据 · 已纳入Git（含暂存） | 以十六进制数据形式保存target_000的目标ROI像素；由对应加载器/testbench读取，位宽、排布和端序按data/evidence/2026-10-03-arm-localize-baseline/README.md核对。 | 所在目录说明：[data/evidence/2026-10-03-arm-localize-baseline/README.md](../../../data/evidence/2026-10-03-arm-localize-baseline/README.md)<br>同名配套文件：[data/evidence/2026-10-03-arm-localize-baseline/pc-benchmark/run-15c1q9l_/tiny/sample-03-crops-l0nd6bdm/target_000.pgm](../../../data/evidence/2026-10-03-arm-localize-baseline/pc-benchmark/run-15c1q9l_/tiny/sample-03-crops-l0nd6bdm/target_000.pgm) |
| [data/evidence/2026-10-03-arm-localize-baseline/pc-benchmark/run-15c1q9l_/tiny/sample-03-crops-l0nd6bdm/target_000.pgm](../../../data/evidence/2026-10-03-arm-localize-baseline/pc-benchmark/run-15c1q9l_/tiny/sample-03-crops-l0nd6bdm/target_000.pgm)<br>灰度像素图 · 已纳入Git（含暂存） | 保存target_000的目标ROI裁剪；其合成/文件/实机来源及框/标签含义以data/evidence/2026-10-03-arm-localize-baseline/README.md为准。 | 所在目录说明：[data/evidence/2026-10-03-arm-localize-baseline/README.md](../../../data/evidence/2026-10-03-arm-localize-baseline/README.md)<br>同名配套文件：[data/evidence/2026-10-03-arm-localize-baseline/pc-benchmark/run-15c1q9l_/tiny/sample-03-crops-l0nd6bdm/target_000.hex](../../../data/evidence/2026-10-03-arm-localize-baseline/pc-benchmark/run-15c1q9l_/tiny/sample-03-crops-l0nd6bdm/target_000.hex) |
| [data/evidence/2026-10-03-arm-localize-baseline/pc-benchmark/run-15c1q9l_/tiny/sample-03-crops-l0nd6bdm/target_001.hex](../../../data/evidence/2026-10-03-arm-localize-baseline/pc-benchmark/run-15c1q9l_/tiny/sample-03-crops-l0nd6bdm/target_001.hex)<br>十六进制数据 · 已纳入Git（含暂存） | 以十六进制数据形式保存target_001的目标ROI像素；由对应加载器/testbench读取，位宽、排布和端序按data/evidence/2026-10-03-arm-localize-baseline/README.md核对。 | 所在目录说明：[data/evidence/2026-10-03-arm-localize-baseline/README.md](../../../data/evidence/2026-10-03-arm-localize-baseline/README.md)<br>同名配套文件：[data/evidence/2026-10-03-arm-localize-baseline/pc-benchmark/run-15c1q9l_/tiny/sample-03-crops-l0nd6bdm/target_001.pgm](../../../data/evidence/2026-10-03-arm-localize-baseline/pc-benchmark/run-15c1q9l_/tiny/sample-03-crops-l0nd6bdm/target_001.pgm) |
| [data/evidence/2026-10-03-arm-localize-baseline/pc-benchmark/run-15c1q9l_/tiny/sample-03-crops-l0nd6bdm/target_001.pgm](../../../data/evidence/2026-10-03-arm-localize-baseline/pc-benchmark/run-15c1q9l_/tiny/sample-03-crops-l0nd6bdm/target_001.pgm)<br>灰度像素图 · 已纳入Git（含暂存） | 保存target_001的目标ROI裁剪；其合成/文件/实机来源及框/标签含义以data/evidence/2026-10-03-arm-localize-baseline/README.md为准。 | 所在目录说明：[data/evidence/2026-10-03-arm-localize-baseline/README.md](../../../data/evidence/2026-10-03-arm-localize-baseline/README.md)<br>同名配套文件：[data/evidence/2026-10-03-arm-localize-baseline/pc-benchmark/run-15c1q9l_/tiny/sample-03-crops-l0nd6bdm/target_001.hex](../../../data/evidence/2026-10-03-arm-localize-baseline/pc-benchmark/run-15c1q9l_/tiny/sample-03-crops-l0nd6bdm/target_001.hex) |
| **data/evidence/2026-10-03-arm-localize-baseline/pc-benchmark/run-15c1q9l_/tiny** | | |
| [data/evidence/2026-10-03-arm-localize-baseline/pc-benchmark/run-15c1q9l_/tiny/sample-03.json](../../../data/evidence/2026-10-03-arm-localize-baseline/pc-benchmark/run-15c1q9l_/tiny/sample-03.json)<br>结构化结果/元数据 · 已纳入Git（含暂存） | 保存sample-03的实验结果或检查产物，字段包括frame_id、config_id、width、height、status、targets、schema_version；与data/evidence/2026-10-03-arm-localize-baseline/README.md中的生成/校验流程一起使用。 | 所在目录说明：[data/evidence/2026-10-03-arm-localize-baseline/README.md](../../../data/evidence/2026-10-03-arm-localize-baseline/README.md)<br>同目录输入/元数据：[data/evidence/2026-10-03-arm-localize-baseline/pc-benchmark/run-15c1q9l_/tiny/input.json](../../../data/evidence/2026-10-03-arm-localize-baseline/pc-benchmark/run-15c1q9l_/tiny/input.json) |
| **data/evidence/2026-10-03-arm-localize-baseline/pc-benchmark/run-15c1q9l_/tiny/sample-04-crops-lg6_o8li** | | |
| [data/evidence/2026-10-03-arm-localize-baseline/pc-benchmark/run-15c1q9l_/tiny/sample-04-crops-lg6_o8li/target_000.hex](../../../data/evidence/2026-10-03-arm-localize-baseline/pc-benchmark/run-15c1q9l_/tiny/sample-04-crops-lg6_o8li/target_000.hex)<br>十六进制数据 · 已纳入Git（含暂存） | 以十六进制数据形式保存target_000的目标ROI像素；由对应加载器/testbench读取，位宽、排布和端序按data/evidence/2026-10-03-arm-localize-baseline/README.md核对。 | 所在目录说明：[data/evidence/2026-10-03-arm-localize-baseline/README.md](../../../data/evidence/2026-10-03-arm-localize-baseline/README.md)<br>同名配套文件：[data/evidence/2026-10-03-arm-localize-baseline/pc-benchmark/run-15c1q9l_/tiny/sample-04-crops-lg6_o8li/target_000.pgm](../../../data/evidence/2026-10-03-arm-localize-baseline/pc-benchmark/run-15c1q9l_/tiny/sample-04-crops-lg6_o8li/target_000.pgm) |
| [data/evidence/2026-10-03-arm-localize-baseline/pc-benchmark/run-15c1q9l_/tiny/sample-04-crops-lg6_o8li/target_000.pgm](../../../data/evidence/2026-10-03-arm-localize-baseline/pc-benchmark/run-15c1q9l_/tiny/sample-04-crops-lg6_o8li/target_000.pgm)<br>灰度像素图 · 已纳入Git（含暂存） | 保存target_000的目标ROI裁剪；其合成/文件/实机来源及框/标签含义以data/evidence/2026-10-03-arm-localize-baseline/README.md为准。 | 所在目录说明：[data/evidence/2026-10-03-arm-localize-baseline/README.md](../../../data/evidence/2026-10-03-arm-localize-baseline/README.md)<br>同名配套文件：[data/evidence/2026-10-03-arm-localize-baseline/pc-benchmark/run-15c1q9l_/tiny/sample-04-crops-lg6_o8li/target_000.hex](../../../data/evidence/2026-10-03-arm-localize-baseline/pc-benchmark/run-15c1q9l_/tiny/sample-04-crops-lg6_o8li/target_000.hex) |
| [data/evidence/2026-10-03-arm-localize-baseline/pc-benchmark/run-15c1q9l_/tiny/sample-04-crops-lg6_o8li/target_001.hex](../../../data/evidence/2026-10-03-arm-localize-baseline/pc-benchmark/run-15c1q9l_/tiny/sample-04-crops-lg6_o8li/target_001.hex)<br>十六进制数据 · 已纳入Git（含暂存） | 以十六进制数据形式保存target_001的目标ROI像素；由对应加载器/testbench读取，位宽、排布和端序按data/evidence/2026-10-03-arm-localize-baseline/README.md核对。 | 所在目录说明：[data/evidence/2026-10-03-arm-localize-baseline/README.md](../../../data/evidence/2026-10-03-arm-localize-baseline/README.md)<br>同名配套文件：[data/evidence/2026-10-03-arm-localize-baseline/pc-benchmark/run-15c1q9l_/tiny/sample-04-crops-lg6_o8li/target_001.pgm](../../../data/evidence/2026-10-03-arm-localize-baseline/pc-benchmark/run-15c1q9l_/tiny/sample-04-crops-lg6_o8li/target_001.pgm) |
| [data/evidence/2026-10-03-arm-localize-baseline/pc-benchmark/run-15c1q9l_/tiny/sample-04-crops-lg6_o8li/target_001.pgm](../../../data/evidence/2026-10-03-arm-localize-baseline/pc-benchmark/run-15c1q9l_/tiny/sample-04-crops-lg6_o8li/target_001.pgm)<br>灰度像素图 · 已纳入Git（含暂存） | 保存target_001的目标ROI裁剪；其合成/文件/实机来源及框/标签含义以data/evidence/2026-10-03-arm-localize-baseline/README.md为准。 | 所在目录说明：[data/evidence/2026-10-03-arm-localize-baseline/README.md](../../../data/evidence/2026-10-03-arm-localize-baseline/README.md)<br>同名配套文件：[data/evidence/2026-10-03-arm-localize-baseline/pc-benchmark/run-15c1q9l_/tiny/sample-04-crops-lg6_o8li/target_001.hex](../../../data/evidence/2026-10-03-arm-localize-baseline/pc-benchmark/run-15c1q9l_/tiny/sample-04-crops-lg6_o8li/target_001.hex) |
| **data/evidence/2026-10-03-arm-localize-baseline/pc-benchmark/run-15c1q9l_/tiny** | | |
| [data/evidence/2026-10-03-arm-localize-baseline/pc-benchmark/run-15c1q9l_/tiny/sample-04.json](../../../data/evidence/2026-10-03-arm-localize-baseline/pc-benchmark/run-15c1q9l_/tiny/sample-04.json)<br>结构化结果/元数据 · 已纳入Git（含暂存） | 保存sample-04的实验结果或检查产物，字段包括frame_id、config_id、width、height、status、targets、schema_version；与data/evidence/2026-10-03-arm-localize-baseline/README.md中的生成/校验流程一起使用。 | 所在目录说明：[data/evidence/2026-10-03-arm-localize-baseline/README.md](../../../data/evidence/2026-10-03-arm-localize-baseline/README.md)<br>同目录输入/元数据：[data/evidence/2026-10-03-arm-localize-baseline/pc-benchmark/run-15c1q9l_/tiny/input.json](../../../data/evidence/2026-10-03-arm-localize-baseline/pc-benchmark/run-15c1q9l_/tiny/input.json) |
| **data/evidence/2026-10-03-arm-localize-baseline/pc-benchmark/run-15c1q9l_/tiny/warmup-00-crops-mobizs9t** | | |
| [data/evidence/2026-10-03-arm-localize-baseline/pc-benchmark/run-15c1q9l_/tiny/warmup-00-crops-mobizs9t/target_000.hex](../../../data/evidence/2026-10-03-arm-localize-baseline/pc-benchmark/run-15c1q9l_/tiny/warmup-00-crops-mobizs9t/target_000.hex)<br>十六进制数据 · 已纳入Git（含暂存） | 以十六进制数据形式保存target_000的目标ROI像素；由对应加载器/testbench读取，位宽、排布和端序按data/evidence/2026-10-03-arm-localize-baseline/README.md核对。 | 所在目录说明：[data/evidence/2026-10-03-arm-localize-baseline/README.md](../../../data/evidence/2026-10-03-arm-localize-baseline/README.md)<br>同名配套文件：[data/evidence/2026-10-03-arm-localize-baseline/pc-benchmark/run-15c1q9l_/tiny/warmup-00-crops-mobizs9t/target_000.pgm](../../../data/evidence/2026-10-03-arm-localize-baseline/pc-benchmark/run-15c1q9l_/tiny/warmup-00-crops-mobizs9t/target_000.pgm) |
| [data/evidence/2026-10-03-arm-localize-baseline/pc-benchmark/run-15c1q9l_/tiny/warmup-00-crops-mobizs9t/target_000.pgm](../../../data/evidence/2026-10-03-arm-localize-baseline/pc-benchmark/run-15c1q9l_/tiny/warmup-00-crops-mobizs9t/target_000.pgm)<br>灰度像素图 · 已纳入Git（含暂存） | 保存target_000的目标ROI裁剪；其合成/文件/实机来源及框/标签含义以data/evidence/2026-10-03-arm-localize-baseline/README.md为准。 | 所在目录说明：[data/evidence/2026-10-03-arm-localize-baseline/README.md](../../../data/evidence/2026-10-03-arm-localize-baseline/README.md)<br>同名配套文件：[data/evidence/2026-10-03-arm-localize-baseline/pc-benchmark/run-15c1q9l_/tiny/warmup-00-crops-mobizs9t/target_000.hex](../../../data/evidence/2026-10-03-arm-localize-baseline/pc-benchmark/run-15c1q9l_/tiny/warmup-00-crops-mobizs9t/target_000.hex) |
| [data/evidence/2026-10-03-arm-localize-baseline/pc-benchmark/run-15c1q9l_/tiny/warmup-00-crops-mobizs9t/target_001.hex](../../../data/evidence/2026-10-03-arm-localize-baseline/pc-benchmark/run-15c1q9l_/tiny/warmup-00-crops-mobizs9t/target_001.hex)<br>十六进制数据 · 已纳入Git（含暂存） | 以十六进制数据形式保存target_001的目标ROI像素；由对应加载器/testbench读取，位宽、排布和端序按data/evidence/2026-10-03-arm-localize-baseline/README.md核对。 | 所在目录说明：[data/evidence/2026-10-03-arm-localize-baseline/README.md](../../../data/evidence/2026-10-03-arm-localize-baseline/README.md)<br>同名配套文件：[data/evidence/2026-10-03-arm-localize-baseline/pc-benchmark/run-15c1q9l_/tiny/warmup-00-crops-mobizs9t/target_001.pgm](../../../data/evidence/2026-10-03-arm-localize-baseline/pc-benchmark/run-15c1q9l_/tiny/warmup-00-crops-mobizs9t/target_001.pgm) |
| [data/evidence/2026-10-03-arm-localize-baseline/pc-benchmark/run-15c1q9l_/tiny/warmup-00-crops-mobizs9t/target_001.pgm](../../../data/evidence/2026-10-03-arm-localize-baseline/pc-benchmark/run-15c1q9l_/tiny/warmup-00-crops-mobizs9t/target_001.pgm)<br>灰度像素图 · 已纳入Git（含暂存） | 保存target_001的目标ROI裁剪；其合成/文件/实机来源及框/标签含义以data/evidence/2026-10-03-arm-localize-baseline/README.md为准。 | 所在目录说明：[data/evidence/2026-10-03-arm-localize-baseline/README.md](../../../data/evidence/2026-10-03-arm-localize-baseline/README.md)<br>同名配套文件：[data/evidence/2026-10-03-arm-localize-baseline/pc-benchmark/run-15c1q9l_/tiny/warmup-00-crops-mobizs9t/target_001.hex](../../../data/evidence/2026-10-03-arm-localize-baseline/pc-benchmark/run-15c1q9l_/tiny/warmup-00-crops-mobizs9t/target_001.hex) |
| **data/evidence/2026-10-03-arm-localize-baseline/pc-benchmark/run-15c1q9l_/tiny** | | |
| [data/evidence/2026-10-03-arm-localize-baseline/pc-benchmark/run-15c1q9l_/tiny/warmup-00.json](../../../data/evidence/2026-10-03-arm-localize-baseline/pc-benchmark/run-15c1q9l_/tiny/warmup-00.json)<br>结构化结果/元数据 · 已纳入Git（含暂存） | 保存warmup-00的实验结果或检查产物，字段包括frame_id、config_id、width、height、status、targets、schema_version；与data/evidence/2026-10-03-arm-localize-baseline/README.md中的生成/校验流程一起使用。 | 所在目录说明：[data/evidence/2026-10-03-arm-localize-baseline/README.md](../../../data/evidence/2026-10-03-arm-localize-baseline/README.md)<br>同目录输入/元数据：[data/evidence/2026-10-03-arm-localize-baseline/pc-benchmark/run-15c1q9l_/tiny/input.json](../../../data/evidence/2026-10-03-arm-localize-baseline/pc-benchmark/run-15c1q9l_/tiny/input.json) |
| **data/evidence/2026-10-03-arm-localize-baseline/pc-benchmark/run-joaab7my/tiny** | | |
| [data/evidence/2026-10-03-arm-localize-baseline/pc-benchmark/run-joaab7my/tiny/input.json](../../../data/evidence/2026-10-03-arm-localize-baseline/pc-benchmark/run-joaab7my/tiny/input.json)<br>结构化结果/元数据 · 已纳入Git（含暂存） | 保存input的输入/设备/运行元数据，字段包括pixels；与data/evidence/2026-10-03-arm-localize-baseline/README.md中的生成/校验流程一起使用。 | 所在目录说明：[data/evidence/2026-10-03-arm-localize-baseline/README.md](../../../data/evidence/2026-10-03-arm-localize-baseline/README.md) |
| **data/evidence/2026-10-03-arm-localize-baseline/pc-benchmark/run-joaab7my/tiny/sample-00-crops-e_krzgsg** | | |
| [data/evidence/2026-10-03-arm-localize-baseline/pc-benchmark/run-joaab7my/tiny/sample-00-crops-e_krzgsg/target_000.hex](../../../data/evidence/2026-10-03-arm-localize-baseline/pc-benchmark/run-joaab7my/tiny/sample-00-crops-e_krzgsg/target_000.hex)<br>十六进制数据 · 已纳入Git（含暂存） | 以十六进制数据形式保存target_000的目标ROI像素；由对应加载器/testbench读取，位宽、排布和端序按data/evidence/2026-10-03-arm-localize-baseline/README.md核对。 | 所在目录说明：[data/evidence/2026-10-03-arm-localize-baseline/README.md](../../../data/evidence/2026-10-03-arm-localize-baseline/README.md)<br>同名配套文件：[data/evidence/2026-10-03-arm-localize-baseline/pc-benchmark/run-joaab7my/tiny/sample-00-crops-e_krzgsg/target_000.pgm](../../../data/evidence/2026-10-03-arm-localize-baseline/pc-benchmark/run-joaab7my/tiny/sample-00-crops-e_krzgsg/target_000.pgm) |
| [data/evidence/2026-10-03-arm-localize-baseline/pc-benchmark/run-joaab7my/tiny/sample-00-crops-e_krzgsg/target_000.pgm](../../../data/evidence/2026-10-03-arm-localize-baseline/pc-benchmark/run-joaab7my/tiny/sample-00-crops-e_krzgsg/target_000.pgm)<br>灰度像素图 · 已纳入Git（含暂存） | 保存target_000的目标ROI裁剪；其合成/文件/实机来源及框/标签含义以data/evidence/2026-10-03-arm-localize-baseline/README.md为准。 | 所在目录说明：[data/evidence/2026-10-03-arm-localize-baseline/README.md](../../../data/evidence/2026-10-03-arm-localize-baseline/README.md)<br>同名配套文件：[data/evidence/2026-10-03-arm-localize-baseline/pc-benchmark/run-joaab7my/tiny/sample-00-crops-e_krzgsg/target_000.hex](../../../data/evidence/2026-10-03-arm-localize-baseline/pc-benchmark/run-joaab7my/tiny/sample-00-crops-e_krzgsg/target_000.hex) |
| [data/evidence/2026-10-03-arm-localize-baseline/pc-benchmark/run-joaab7my/tiny/sample-00-crops-e_krzgsg/target_001.hex](../../../data/evidence/2026-10-03-arm-localize-baseline/pc-benchmark/run-joaab7my/tiny/sample-00-crops-e_krzgsg/target_001.hex)<br>十六进制数据 · 已纳入Git（含暂存） | 以十六进制数据形式保存target_001的目标ROI像素；由对应加载器/testbench读取，位宽、排布和端序按data/evidence/2026-10-03-arm-localize-baseline/README.md核对。 | 所在目录说明：[data/evidence/2026-10-03-arm-localize-baseline/README.md](../../../data/evidence/2026-10-03-arm-localize-baseline/README.md)<br>同名配套文件：[data/evidence/2026-10-03-arm-localize-baseline/pc-benchmark/run-joaab7my/tiny/sample-00-crops-e_krzgsg/target_001.pgm](../../../data/evidence/2026-10-03-arm-localize-baseline/pc-benchmark/run-joaab7my/tiny/sample-00-crops-e_krzgsg/target_001.pgm) |
| [data/evidence/2026-10-03-arm-localize-baseline/pc-benchmark/run-joaab7my/tiny/sample-00-crops-e_krzgsg/target_001.pgm](../../../data/evidence/2026-10-03-arm-localize-baseline/pc-benchmark/run-joaab7my/tiny/sample-00-crops-e_krzgsg/target_001.pgm)<br>灰度像素图 · 已纳入Git（含暂存） | 保存target_001的目标ROI裁剪；其合成/文件/实机来源及框/标签含义以data/evidence/2026-10-03-arm-localize-baseline/README.md为准。 | 所在目录说明：[data/evidence/2026-10-03-arm-localize-baseline/README.md](../../../data/evidence/2026-10-03-arm-localize-baseline/README.md)<br>同名配套文件：[data/evidence/2026-10-03-arm-localize-baseline/pc-benchmark/run-joaab7my/tiny/sample-00-crops-e_krzgsg/target_001.hex](../../../data/evidence/2026-10-03-arm-localize-baseline/pc-benchmark/run-joaab7my/tiny/sample-00-crops-e_krzgsg/target_001.hex) |
| **data/evidence/2026-10-03-arm-localize-baseline/pc-benchmark/run-joaab7my/tiny** | | |
| [data/evidence/2026-10-03-arm-localize-baseline/pc-benchmark/run-joaab7my/tiny/sample-00.json](../../../data/evidence/2026-10-03-arm-localize-baseline/pc-benchmark/run-joaab7my/tiny/sample-00.json)<br>结构化结果/元数据 · 已纳入Git（含暂存） | 保存sample-00的实验结果或检查产物，字段包括frame_id、config_id、width、height、status、targets、schema_version；与data/evidence/2026-10-03-arm-localize-baseline/README.md中的生成/校验流程一起使用。 | 所在目录说明：[data/evidence/2026-10-03-arm-localize-baseline/README.md](../../../data/evidence/2026-10-03-arm-localize-baseline/README.md)<br>同目录输入/元数据：[data/evidence/2026-10-03-arm-localize-baseline/pc-benchmark/run-joaab7my/tiny/input.json](../../../data/evidence/2026-10-03-arm-localize-baseline/pc-benchmark/run-joaab7my/tiny/input.json) |
| **data/evidence/2026-10-03-arm-localize-baseline/pc-benchmark/run-joaab7my/tiny/warmup-00-crops-hgchfi_r** | | |
| [data/evidence/2026-10-03-arm-localize-baseline/pc-benchmark/run-joaab7my/tiny/warmup-00-crops-hgchfi_r/target_000.hex](../../../data/evidence/2026-10-03-arm-localize-baseline/pc-benchmark/run-joaab7my/tiny/warmup-00-crops-hgchfi_r/target_000.hex)<br>十六进制数据 · 已纳入Git（含暂存） | 以十六进制数据形式保存target_000的目标ROI像素；由对应加载器/testbench读取，位宽、排布和端序按data/evidence/2026-10-03-arm-localize-baseline/README.md核对。 | 所在目录说明：[data/evidence/2026-10-03-arm-localize-baseline/README.md](../../../data/evidence/2026-10-03-arm-localize-baseline/README.md)<br>同名配套文件：[data/evidence/2026-10-03-arm-localize-baseline/pc-benchmark/run-joaab7my/tiny/warmup-00-crops-hgchfi_r/target_000.pgm](../../../data/evidence/2026-10-03-arm-localize-baseline/pc-benchmark/run-joaab7my/tiny/warmup-00-crops-hgchfi_r/target_000.pgm) |
| [data/evidence/2026-10-03-arm-localize-baseline/pc-benchmark/run-joaab7my/tiny/warmup-00-crops-hgchfi_r/target_000.pgm](../../../data/evidence/2026-10-03-arm-localize-baseline/pc-benchmark/run-joaab7my/tiny/warmup-00-crops-hgchfi_r/target_000.pgm)<br>灰度像素图 · 已纳入Git（含暂存） | 保存target_000的目标ROI裁剪；其合成/文件/实机来源及框/标签含义以data/evidence/2026-10-03-arm-localize-baseline/README.md为准。 | 所在目录说明：[data/evidence/2026-10-03-arm-localize-baseline/README.md](../../../data/evidence/2026-10-03-arm-localize-baseline/README.md)<br>同名配套文件：[data/evidence/2026-10-03-arm-localize-baseline/pc-benchmark/run-joaab7my/tiny/warmup-00-crops-hgchfi_r/target_000.hex](../../../data/evidence/2026-10-03-arm-localize-baseline/pc-benchmark/run-joaab7my/tiny/warmup-00-crops-hgchfi_r/target_000.hex) |
| [data/evidence/2026-10-03-arm-localize-baseline/pc-benchmark/run-joaab7my/tiny/warmup-00-crops-hgchfi_r/target_001.hex](../../../data/evidence/2026-10-03-arm-localize-baseline/pc-benchmark/run-joaab7my/tiny/warmup-00-crops-hgchfi_r/target_001.hex)<br>十六进制数据 · 已纳入Git（含暂存） | 以十六进制数据形式保存target_001的目标ROI像素；由对应加载器/testbench读取，位宽、排布和端序按data/evidence/2026-10-03-arm-localize-baseline/README.md核对。 | 所在目录说明：[data/evidence/2026-10-03-arm-localize-baseline/README.md](../../../data/evidence/2026-10-03-arm-localize-baseline/README.md)<br>同名配套文件：[data/evidence/2026-10-03-arm-localize-baseline/pc-benchmark/run-joaab7my/tiny/warmup-00-crops-hgchfi_r/target_001.pgm](../../../data/evidence/2026-10-03-arm-localize-baseline/pc-benchmark/run-joaab7my/tiny/warmup-00-crops-hgchfi_r/target_001.pgm) |
| [data/evidence/2026-10-03-arm-localize-baseline/pc-benchmark/run-joaab7my/tiny/warmup-00-crops-hgchfi_r/target_001.pgm](../../../data/evidence/2026-10-03-arm-localize-baseline/pc-benchmark/run-joaab7my/tiny/warmup-00-crops-hgchfi_r/target_001.pgm)<br>灰度像素图 · 已纳入Git（含暂存） | 保存target_001的目标ROI裁剪；其合成/文件/实机来源及框/标签含义以data/evidence/2026-10-03-arm-localize-baseline/README.md为准。 | 所在目录说明：[data/evidence/2026-10-03-arm-localize-baseline/README.md](../../../data/evidence/2026-10-03-arm-localize-baseline/README.md)<br>同名配套文件：[data/evidence/2026-10-03-arm-localize-baseline/pc-benchmark/run-joaab7my/tiny/warmup-00-crops-hgchfi_r/target_001.hex](../../../data/evidence/2026-10-03-arm-localize-baseline/pc-benchmark/run-joaab7my/tiny/warmup-00-crops-hgchfi_r/target_001.hex) |
| **data/evidence/2026-10-03-arm-localize-baseline/pc-benchmark/run-joaab7my/tiny** | | |
| [data/evidence/2026-10-03-arm-localize-baseline/pc-benchmark/run-joaab7my/tiny/warmup-00.json](../../../data/evidence/2026-10-03-arm-localize-baseline/pc-benchmark/run-joaab7my/tiny/warmup-00.json)<br>结构化结果/元数据 · 已纳入Git（含暂存） | 保存warmup-00的实验结果或检查产物，字段包括frame_id、config_id、width、height、status、targets、schema_version；与data/evidence/2026-10-03-arm-localize-baseline/README.md中的生成/校验流程一起使用。 | 所在目录说明：[data/evidence/2026-10-03-arm-localize-baseline/README.md](../../../data/evidence/2026-10-03-arm-localize-baseline/README.md)<br>同目录输入/元数据：[data/evidence/2026-10-03-arm-localize-baseline/pc-benchmark/run-joaab7my/tiny/input.json](../../../data/evidence/2026-10-03-arm-localize-baseline/pc-benchmark/run-joaab7my/tiny/input.json) |
| **data/evidence/2026-10-03-arm-localize-baseline/pc-benchmark/run-v45cu259/720p_empty** | | |
| [data/evidence/2026-10-03-arm-localize-baseline/pc-benchmark/run-v45cu259/720p_empty/input.json](../../../data/evidence/2026-10-03-arm-localize-baseline/pc-benchmark/run-v45cu259/720p_empty/input.json)<br>结构化结果/元数据 · 已纳入Git（含暂存） | 保存input的输入/设备/运行元数据，字段包括具体字段；与data/evidence/2026-10-03-arm-localize-baseline/README.md中的生成/校验流程一起使用。 | 所在目录说明：[data/evidence/2026-10-03-arm-localize-baseline/README.md](../../../data/evidence/2026-10-03-arm-localize-baseline/README.md) |
| [data/evidence/2026-10-03-arm-localize-baseline/pc-benchmark/run-v45cu259/720p_empty/sample-00.json](../../../data/evidence/2026-10-03-arm-localize-baseline/pc-benchmark/run-v45cu259/720p_empty/sample-00.json)<br>结构化结果/元数据 · 已纳入Git（含暂存） | 保存sample-00的实验结果或检查产物，字段包括frame_id、config_id、width、height、status、targets、schema_version；与data/evidence/2026-10-03-arm-localize-baseline/README.md中的生成/校验流程一起使用。 | 所在目录说明：[data/evidence/2026-10-03-arm-localize-baseline/README.md](../../../data/evidence/2026-10-03-arm-localize-baseline/README.md)<br>同目录输入/元数据：[data/evidence/2026-10-03-arm-localize-baseline/pc-benchmark/run-v45cu259/720p_empty/input.json](../../../data/evidence/2026-10-03-arm-localize-baseline/pc-benchmark/run-v45cu259/720p_empty/input.json) |
| [data/evidence/2026-10-03-arm-localize-baseline/pc-benchmark/run-v45cu259/720p_empty/sample-01.json](../../../data/evidence/2026-10-03-arm-localize-baseline/pc-benchmark/run-v45cu259/720p_empty/sample-01.json)<br>结构化结果/元数据 · 已纳入Git（含暂存） | 保存sample-01的实验结果或检查产物，字段包括frame_id、config_id、width、height、status、targets、schema_version；与data/evidence/2026-10-03-arm-localize-baseline/README.md中的生成/校验流程一起使用。 | 所在目录说明：[data/evidence/2026-10-03-arm-localize-baseline/README.md](../../../data/evidence/2026-10-03-arm-localize-baseline/README.md)<br>同目录输入/元数据：[data/evidence/2026-10-03-arm-localize-baseline/pc-benchmark/run-v45cu259/720p_empty/input.json](../../../data/evidence/2026-10-03-arm-localize-baseline/pc-benchmark/run-v45cu259/720p_empty/input.json) |
| [data/evidence/2026-10-03-arm-localize-baseline/pc-benchmark/run-v45cu259/720p_empty/sample-02.json](../../../data/evidence/2026-10-03-arm-localize-baseline/pc-benchmark/run-v45cu259/720p_empty/sample-02.json)<br>结构化结果/元数据 · 已纳入Git（含暂存） | 保存sample-02的实验结果或检查产物，字段包括frame_id、config_id、width、height、status、targets、schema_version；与data/evidence/2026-10-03-arm-localize-baseline/README.md中的生成/校验流程一起使用。 | 所在目录说明：[data/evidence/2026-10-03-arm-localize-baseline/README.md](../../../data/evidence/2026-10-03-arm-localize-baseline/README.md)<br>同目录输入/元数据：[data/evidence/2026-10-03-arm-localize-baseline/pc-benchmark/run-v45cu259/720p_empty/input.json](../../../data/evidence/2026-10-03-arm-localize-baseline/pc-benchmark/run-v45cu259/720p_empty/input.json) |
| [data/evidence/2026-10-03-arm-localize-baseline/pc-benchmark/run-v45cu259/720p_empty/sample-03.json](../../../data/evidence/2026-10-03-arm-localize-baseline/pc-benchmark/run-v45cu259/720p_empty/sample-03.json)<br>结构化结果/元数据 · 已纳入Git（含暂存） | 保存sample-03的实验结果或检查产物，字段包括frame_id、config_id、width、height、status、targets、schema_version；与data/evidence/2026-10-03-arm-localize-baseline/README.md中的生成/校验流程一起使用。 | 所在目录说明：[data/evidence/2026-10-03-arm-localize-baseline/README.md](../../../data/evidence/2026-10-03-arm-localize-baseline/README.md)<br>同目录输入/元数据：[data/evidence/2026-10-03-arm-localize-baseline/pc-benchmark/run-v45cu259/720p_empty/input.json](../../../data/evidence/2026-10-03-arm-localize-baseline/pc-benchmark/run-v45cu259/720p_empty/input.json) |
| [data/evidence/2026-10-03-arm-localize-baseline/pc-benchmark/run-v45cu259/720p_empty/sample-04.json](../../../data/evidence/2026-10-03-arm-localize-baseline/pc-benchmark/run-v45cu259/720p_empty/sample-04.json)<br>结构化结果/元数据 · 已纳入Git（含暂存） | 保存sample-04的实验结果或检查产物，字段包括frame_id、config_id、width、height、status、targets、schema_version；与data/evidence/2026-10-03-arm-localize-baseline/README.md中的生成/校验流程一起使用。 | 所在目录说明：[data/evidence/2026-10-03-arm-localize-baseline/README.md](../../../data/evidence/2026-10-03-arm-localize-baseline/README.md)<br>同目录输入/元数据：[data/evidence/2026-10-03-arm-localize-baseline/pc-benchmark/run-v45cu259/720p_empty/input.json](../../../data/evidence/2026-10-03-arm-localize-baseline/pc-benchmark/run-v45cu259/720p_empty/input.json) |
| [data/evidence/2026-10-03-arm-localize-baseline/pc-benchmark/run-v45cu259/720p_empty/warmup-00.json](../../../data/evidence/2026-10-03-arm-localize-baseline/pc-benchmark/run-v45cu259/720p_empty/warmup-00.json)<br>结构化结果/元数据 · 已纳入Git（含暂存） | 保存warmup-00的实验结果或检查产物，字段包括frame_id、config_id、width、height、status、targets、schema_version；与data/evidence/2026-10-03-arm-localize-baseline/README.md中的生成/校验流程一起使用。 | 所在目录说明：[data/evidence/2026-10-03-arm-localize-baseline/README.md](../../../data/evidence/2026-10-03-arm-localize-baseline/README.md)<br>同目录输入/元数据：[data/evidence/2026-10-03-arm-localize-baseline/pc-benchmark/run-v45cu259/720p_empty/input.json](../../../data/evidence/2026-10-03-arm-localize-baseline/pc-benchmark/run-v45cu259/720p_empty/input.json) |
| **data/evidence/2026-10-03-arm-localize-baseline/pc-benchmark/run-v45cu259/720p_six** | | |
| [data/evidence/2026-10-03-arm-localize-baseline/pc-benchmark/run-v45cu259/720p_six/input.json](../../../data/evidence/2026-10-03-arm-localize-baseline/pc-benchmark/run-v45cu259/720p_six/input.json)<br>结构化结果/元数据 · 已纳入Git（含暂存） | 保存input的输入/设备/运行元数据，字段包括具体字段；与data/evidence/2026-10-03-arm-localize-baseline/README.md中的生成/校验流程一起使用。 | 所在目录说明：[data/evidence/2026-10-03-arm-localize-baseline/README.md](../../../data/evidence/2026-10-03-arm-localize-baseline/README.md) |
| **data/evidence/2026-10-03-arm-localize-baseline/pc-benchmark/run-v45cu259/720p_six/sample-00-crops-37kqoub1** | | |
| [data/evidence/2026-10-03-arm-localize-baseline/pc-benchmark/run-v45cu259/720p_six/sample-00-crops-37kqoub1/target_000.hex](../../../data/evidence/2026-10-03-arm-localize-baseline/pc-benchmark/run-v45cu259/720p_six/sample-00-crops-37kqoub1/target_000.hex)<br>十六进制数据 · 已纳入Git（含暂存） | 以十六进制数据形式保存target_000的目标ROI像素；由对应加载器/testbench读取，位宽、排布和端序按data/evidence/2026-10-03-arm-localize-baseline/README.md核对。 | 所在目录说明：[data/evidence/2026-10-03-arm-localize-baseline/README.md](../../../data/evidence/2026-10-03-arm-localize-baseline/README.md)<br>同名配套文件：[data/evidence/2026-10-03-arm-localize-baseline/pc-benchmark/run-v45cu259/720p_six/sample-00-crops-37kqoub1/target_000.pgm](../../../data/evidence/2026-10-03-arm-localize-baseline/pc-benchmark/run-v45cu259/720p_six/sample-00-crops-37kqoub1/target_000.pgm) |
| [data/evidence/2026-10-03-arm-localize-baseline/pc-benchmark/run-v45cu259/720p_six/sample-00-crops-37kqoub1/target_000.pgm](../../../data/evidence/2026-10-03-arm-localize-baseline/pc-benchmark/run-v45cu259/720p_six/sample-00-crops-37kqoub1/target_000.pgm)<br>灰度像素图 · 已纳入Git（含暂存） | 保存target_000的目标ROI裁剪；其合成/文件/实机来源及框/标签含义以data/evidence/2026-10-03-arm-localize-baseline/README.md为准。 | 所在目录说明：[data/evidence/2026-10-03-arm-localize-baseline/README.md](../../../data/evidence/2026-10-03-arm-localize-baseline/README.md)<br>同名配套文件：[data/evidence/2026-10-03-arm-localize-baseline/pc-benchmark/run-v45cu259/720p_six/sample-00-crops-37kqoub1/target_000.hex](../../../data/evidence/2026-10-03-arm-localize-baseline/pc-benchmark/run-v45cu259/720p_six/sample-00-crops-37kqoub1/target_000.hex) |
| [data/evidence/2026-10-03-arm-localize-baseline/pc-benchmark/run-v45cu259/720p_six/sample-00-crops-37kqoub1/target_001.hex](../../../data/evidence/2026-10-03-arm-localize-baseline/pc-benchmark/run-v45cu259/720p_six/sample-00-crops-37kqoub1/target_001.hex)<br>十六进制数据 · 已纳入Git（含暂存） | 以十六进制数据形式保存target_001的目标ROI像素；由对应加载器/testbench读取，位宽、排布和端序按data/evidence/2026-10-03-arm-localize-baseline/README.md核对。 | 所在目录说明：[data/evidence/2026-10-03-arm-localize-baseline/README.md](../../../data/evidence/2026-10-03-arm-localize-baseline/README.md)<br>同名配套文件：[data/evidence/2026-10-03-arm-localize-baseline/pc-benchmark/run-v45cu259/720p_six/sample-00-crops-37kqoub1/target_001.pgm](../../../data/evidence/2026-10-03-arm-localize-baseline/pc-benchmark/run-v45cu259/720p_six/sample-00-crops-37kqoub1/target_001.pgm) |
| [data/evidence/2026-10-03-arm-localize-baseline/pc-benchmark/run-v45cu259/720p_six/sample-00-crops-37kqoub1/target_001.pgm](../../../data/evidence/2026-10-03-arm-localize-baseline/pc-benchmark/run-v45cu259/720p_six/sample-00-crops-37kqoub1/target_001.pgm)<br>灰度像素图 · 已纳入Git（含暂存） | 保存target_001的目标ROI裁剪；其合成/文件/实机来源及框/标签含义以data/evidence/2026-10-03-arm-localize-baseline/README.md为准。 | 所在目录说明：[data/evidence/2026-10-03-arm-localize-baseline/README.md](../../../data/evidence/2026-10-03-arm-localize-baseline/README.md)<br>同名配套文件：[data/evidence/2026-10-03-arm-localize-baseline/pc-benchmark/run-v45cu259/720p_six/sample-00-crops-37kqoub1/target_001.hex](../../../data/evidence/2026-10-03-arm-localize-baseline/pc-benchmark/run-v45cu259/720p_six/sample-00-crops-37kqoub1/target_001.hex) |
| [data/evidence/2026-10-03-arm-localize-baseline/pc-benchmark/run-v45cu259/720p_six/sample-00-crops-37kqoub1/target_002.hex](../../../data/evidence/2026-10-03-arm-localize-baseline/pc-benchmark/run-v45cu259/720p_six/sample-00-crops-37kqoub1/target_002.hex)<br>十六进制数据 · 已纳入Git（含暂存） | 以十六进制数据形式保存target_002的目标ROI像素；由对应加载器/testbench读取，位宽、排布和端序按data/evidence/2026-10-03-arm-localize-baseline/README.md核对。 | 所在目录说明：[data/evidence/2026-10-03-arm-localize-baseline/README.md](../../../data/evidence/2026-10-03-arm-localize-baseline/README.md)<br>同名配套文件：[data/evidence/2026-10-03-arm-localize-baseline/pc-benchmark/run-v45cu259/720p_six/sample-00-crops-37kqoub1/target_002.pgm](../../../data/evidence/2026-10-03-arm-localize-baseline/pc-benchmark/run-v45cu259/720p_six/sample-00-crops-37kqoub1/target_002.pgm) |
| [data/evidence/2026-10-03-arm-localize-baseline/pc-benchmark/run-v45cu259/720p_six/sample-00-crops-37kqoub1/target_002.pgm](../../../data/evidence/2026-10-03-arm-localize-baseline/pc-benchmark/run-v45cu259/720p_six/sample-00-crops-37kqoub1/target_002.pgm)<br>灰度像素图 · 已纳入Git（含暂存） | 保存target_002的目标ROI裁剪；其合成/文件/实机来源及框/标签含义以data/evidence/2026-10-03-arm-localize-baseline/README.md为准。 | 所在目录说明：[data/evidence/2026-10-03-arm-localize-baseline/README.md](../../../data/evidence/2026-10-03-arm-localize-baseline/README.md)<br>同名配套文件：[data/evidence/2026-10-03-arm-localize-baseline/pc-benchmark/run-v45cu259/720p_six/sample-00-crops-37kqoub1/target_002.hex](../../../data/evidence/2026-10-03-arm-localize-baseline/pc-benchmark/run-v45cu259/720p_six/sample-00-crops-37kqoub1/target_002.hex) |
| [data/evidence/2026-10-03-arm-localize-baseline/pc-benchmark/run-v45cu259/720p_six/sample-00-crops-37kqoub1/target_003.hex](../../../data/evidence/2026-10-03-arm-localize-baseline/pc-benchmark/run-v45cu259/720p_six/sample-00-crops-37kqoub1/target_003.hex)<br>十六进制数据 · 已纳入Git（含暂存） | 以十六进制数据形式保存target_003的目标ROI像素；由对应加载器/testbench读取，位宽、排布和端序按data/evidence/2026-10-03-arm-localize-baseline/README.md核对。 | 所在目录说明：[data/evidence/2026-10-03-arm-localize-baseline/README.md](../../../data/evidence/2026-10-03-arm-localize-baseline/README.md)<br>同名配套文件：[data/evidence/2026-10-03-arm-localize-baseline/pc-benchmark/run-v45cu259/720p_six/sample-00-crops-37kqoub1/target_003.pgm](../../../data/evidence/2026-10-03-arm-localize-baseline/pc-benchmark/run-v45cu259/720p_six/sample-00-crops-37kqoub1/target_003.pgm) |
| [data/evidence/2026-10-03-arm-localize-baseline/pc-benchmark/run-v45cu259/720p_six/sample-00-crops-37kqoub1/target_003.pgm](../../../data/evidence/2026-10-03-arm-localize-baseline/pc-benchmark/run-v45cu259/720p_six/sample-00-crops-37kqoub1/target_003.pgm)<br>灰度像素图 · 已纳入Git（含暂存） | 保存target_003的目标ROI裁剪；其合成/文件/实机来源及框/标签含义以data/evidence/2026-10-03-arm-localize-baseline/README.md为准。 | 所在目录说明：[data/evidence/2026-10-03-arm-localize-baseline/README.md](../../../data/evidence/2026-10-03-arm-localize-baseline/README.md)<br>同名配套文件：[data/evidence/2026-10-03-arm-localize-baseline/pc-benchmark/run-v45cu259/720p_six/sample-00-crops-37kqoub1/target_003.hex](../../../data/evidence/2026-10-03-arm-localize-baseline/pc-benchmark/run-v45cu259/720p_six/sample-00-crops-37kqoub1/target_003.hex) |
| [data/evidence/2026-10-03-arm-localize-baseline/pc-benchmark/run-v45cu259/720p_six/sample-00-crops-37kqoub1/target_004.hex](../../../data/evidence/2026-10-03-arm-localize-baseline/pc-benchmark/run-v45cu259/720p_six/sample-00-crops-37kqoub1/target_004.hex)<br>十六进制数据 · 已纳入Git（含暂存） | 以十六进制数据形式保存target_004的目标ROI像素；由对应加载器/testbench读取，位宽、排布和端序按data/evidence/2026-10-03-arm-localize-baseline/README.md核对。 | 所在目录说明：[data/evidence/2026-10-03-arm-localize-baseline/README.md](../../../data/evidence/2026-10-03-arm-localize-baseline/README.md)<br>同名配套文件：[data/evidence/2026-10-03-arm-localize-baseline/pc-benchmark/run-v45cu259/720p_six/sample-00-crops-37kqoub1/target_004.pgm](../../../data/evidence/2026-10-03-arm-localize-baseline/pc-benchmark/run-v45cu259/720p_six/sample-00-crops-37kqoub1/target_004.pgm) |
| [data/evidence/2026-10-03-arm-localize-baseline/pc-benchmark/run-v45cu259/720p_six/sample-00-crops-37kqoub1/target_004.pgm](../../../data/evidence/2026-10-03-arm-localize-baseline/pc-benchmark/run-v45cu259/720p_six/sample-00-crops-37kqoub1/target_004.pgm)<br>灰度像素图 · 已纳入Git（含暂存） | 保存target_004的目标ROI裁剪；其合成/文件/实机来源及框/标签含义以data/evidence/2026-10-03-arm-localize-baseline/README.md为准。 | 所在目录说明：[data/evidence/2026-10-03-arm-localize-baseline/README.md](../../../data/evidence/2026-10-03-arm-localize-baseline/README.md)<br>同名配套文件：[data/evidence/2026-10-03-arm-localize-baseline/pc-benchmark/run-v45cu259/720p_six/sample-00-crops-37kqoub1/target_004.hex](../../../data/evidence/2026-10-03-arm-localize-baseline/pc-benchmark/run-v45cu259/720p_six/sample-00-crops-37kqoub1/target_004.hex) |
| [data/evidence/2026-10-03-arm-localize-baseline/pc-benchmark/run-v45cu259/720p_six/sample-00-crops-37kqoub1/target_005.hex](../../../data/evidence/2026-10-03-arm-localize-baseline/pc-benchmark/run-v45cu259/720p_six/sample-00-crops-37kqoub1/target_005.hex)<br>十六进制数据 · 已纳入Git（含暂存） | 以十六进制数据形式保存target_005的目标ROI像素；由对应加载器/testbench读取，位宽、排布和端序按data/evidence/2026-10-03-arm-localize-baseline/README.md核对。 | 所在目录说明：[data/evidence/2026-10-03-arm-localize-baseline/README.md](../../../data/evidence/2026-10-03-arm-localize-baseline/README.md)<br>同名配套文件：[data/evidence/2026-10-03-arm-localize-baseline/pc-benchmark/run-v45cu259/720p_six/sample-00-crops-37kqoub1/target_005.pgm](../../../data/evidence/2026-10-03-arm-localize-baseline/pc-benchmark/run-v45cu259/720p_six/sample-00-crops-37kqoub1/target_005.pgm) |
| [data/evidence/2026-10-03-arm-localize-baseline/pc-benchmark/run-v45cu259/720p_six/sample-00-crops-37kqoub1/target_005.pgm](../../../data/evidence/2026-10-03-arm-localize-baseline/pc-benchmark/run-v45cu259/720p_six/sample-00-crops-37kqoub1/target_005.pgm)<br>灰度像素图 · 已纳入Git（含暂存） | 保存target_005的目标ROI裁剪；其合成/文件/实机来源及框/标签含义以data/evidence/2026-10-03-arm-localize-baseline/README.md为准。 | 所在目录说明：[data/evidence/2026-10-03-arm-localize-baseline/README.md](../../../data/evidence/2026-10-03-arm-localize-baseline/README.md)<br>同名配套文件：[data/evidence/2026-10-03-arm-localize-baseline/pc-benchmark/run-v45cu259/720p_six/sample-00-crops-37kqoub1/target_005.hex](../../../data/evidence/2026-10-03-arm-localize-baseline/pc-benchmark/run-v45cu259/720p_six/sample-00-crops-37kqoub1/target_005.hex) |
| **data/evidence/2026-10-03-arm-localize-baseline/pc-benchmark/run-v45cu259/720p_six** | | |
| [data/evidence/2026-10-03-arm-localize-baseline/pc-benchmark/run-v45cu259/720p_six/sample-00.json](../../../data/evidence/2026-10-03-arm-localize-baseline/pc-benchmark/run-v45cu259/720p_six/sample-00.json)<br>结构化结果/元数据 · 已纳入Git（含暂存） | 保存sample-00的实验结果或检查产物，字段包括frame_id、config_id、width、height、status、targets、schema_version；与data/evidence/2026-10-03-arm-localize-baseline/README.md中的生成/校验流程一起使用。 | 所在目录说明：[data/evidence/2026-10-03-arm-localize-baseline/README.md](../../../data/evidence/2026-10-03-arm-localize-baseline/README.md)<br>同目录输入/元数据：[data/evidence/2026-10-03-arm-localize-baseline/pc-benchmark/run-v45cu259/720p_six/input.json](../../../data/evidence/2026-10-03-arm-localize-baseline/pc-benchmark/run-v45cu259/720p_six/input.json) |
| **data/evidence/2026-10-03-arm-localize-baseline/pc-benchmark/run-v45cu259/720p_six/sample-01-crops-6behhbgu** | | |
| [data/evidence/2026-10-03-arm-localize-baseline/pc-benchmark/run-v45cu259/720p_six/sample-01-crops-6behhbgu/target_000.hex](../../../data/evidence/2026-10-03-arm-localize-baseline/pc-benchmark/run-v45cu259/720p_six/sample-01-crops-6behhbgu/target_000.hex)<br>十六进制数据 · 已纳入Git（含暂存） | 以十六进制数据形式保存target_000的目标ROI像素；由对应加载器/testbench读取，位宽、排布和端序按data/evidence/2026-10-03-arm-localize-baseline/README.md核对。 | 所在目录说明：[data/evidence/2026-10-03-arm-localize-baseline/README.md](../../../data/evidence/2026-10-03-arm-localize-baseline/README.md)<br>同名配套文件：[data/evidence/2026-10-03-arm-localize-baseline/pc-benchmark/run-v45cu259/720p_six/sample-01-crops-6behhbgu/target_000.pgm](../../../data/evidence/2026-10-03-arm-localize-baseline/pc-benchmark/run-v45cu259/720p_six/sample-01-crops-6behhbgu/target_000.pgm) |
| [data/evidence/2026-10-03-arm-localize-baseline/pc-benchmark/run-v45cu259/720p_six/sample-01-crops-6behhbgu/target_000.pgm](../../../data/evidence/2026-10-03-arm-localize-baseline/pc-benchmark/run-v45cu259/720p_six/sample-01-crops-6behhbgu/target_000.pgm)<br>灰度像素图 · 已纳入Git（含暂存） | 保存target_000的目标ROI裁剪；其合成/文件/实机来源及框/标签含义以data/evidence/2026-10-03-arm-localize-baseline/README.md为准。 | 所在目录说明：[data/evidence/2026-10-03-arm-localize-baseline/README.md](../../../data/evidence/2026-10-03-arm-localize-baseline/README.md)<br>同名配套文件：[data/evidence/2026-10-03-arm-localize-baseline/pc-benchmark/run-v45cu259/720p_six/sample-01-crops-6behhbgu/target_000.hex](../../../data/evidence/2026-10-03-arm-localize-baseline/pc-benchmark/run-v45cu259/720p_six/sample-01-crops-6behhbgu/target_000.hex) |
| [data/evidence/2026-10-03-arm-localize-baseline/pc-benchmark/run-v45cu259/720p_six/sample-01-crops-6behhbgu/target_001.hex](../../../data/evidence/2026-10-03-arm-localize-baseline/pc-benchmark/run-v45cu259/720p_six/sample-01-crops-6behhbgu/target_001.hex)<br>十六进制数据 · 已纳入Git（含暂存） | 以十六进制数据形式保存target_001的目标ROI像素；由对应加载器/testbench读取，位宽、排布和端序按data/evidence/2026-10-03-arm-localize-baseline/README.md核对。 | 所在目录说明：[data/evidence/2026-10-03-arm-localize-baseline/README.md](../../../data/evidence/2026-10-03-arm-localize-baseline/README.md)<br>同名配套文件：[data/evidence/2026-10-03-arm-localize-baseline/pc-benchmark/run-v45cu259/720p_six/sample-01-crops-6behhbgu/target_001.pgm](../../../data/evidence/2026-10-03-arm-localize-baseline/pc-benchmark/run-v45cu259/720p_six/sample-01-crops-6behhbgu/target_001.pgm) |
| [data/evidence/2026-10-03-arm-localize-baseline/pc-benchmark/run-v45cu259/720p_six/sample-01-crops-6behhbgu/target_001.pgm](../../../data/evidence/2026-10-03-arm-localize-baseline/pc-benchmark/run-v45cu259/720p_six/sample-01-crops-6behhbgu/target_001.pgm)<br>灰度像素图 · 已纳入Git（含暂存） | 保存target_001的目标ROI裁剪；其合成/文件/实机来源及框/标签含义以data/evidence/2026-10-03-arm-localize-baseline/README.md为准。 | 所在目录说明：[data/evidence/2026-10-03-arm-localize-baseline/README.md](../../../data/evidence/2026-10-03-arm-localize-baseline/README.md)<br>同名配套文件：[data/evidence/2026-10-03-arm-localize-baseline/pc-benchmark/run-v45cu259/720p_six/sample-01-crops-6behhbgu/target_001.hex](../../../data/evidence/2026-10-03-arm-localize-baseline/pc-benchmark/run-v45cu259/720p_six/sample-01-crops-6behhbgu/target_001.hex) |
| [data/evidence/2026-10-03-arm-localize-baseline/pc-benchmark/run-v45cu259/720p_six/sample-01-crops-6behhbgu/target_002.hex](../../../data/evidence/2026-10-03-arm-localize-baseline/pc-benchmark/run-v45cu259/720p_six/sample-01-crops-6behhbgu/target_002.hex)<br>十六进制数据 · 已纳入Git（含暂存） | 以十六进制数据形式保存target_002的目标ROI像素；由对应加载器/testbench读取，位宽、排布和端序按data/evidence/2026-10-03-arm-localize-baseline/README.md核对。 | 所在目录说明：[data/evidence/2026-10-03-arm-localize-baseline/README.md](../../../data/evidence/2026-10-03-arm-localize-baseline/README.md)<br>同名配套文件：[data/evidence/2026-10-03-arm-localize-baseline/pc-benchmark/run-v45cu259/720p_six/sample-01-crops-6behhbgu/target_002.pgm](../../../data/evidence/2026-10-03-arm-localize-baseline/pc-benchmark/run-v45cu259/720p_six/sample-01-crops-6behhbgu/target_002.pgm) |
| [data/evidence/2026-10-03-arm-localize-baseline/pc-benchmark/run-v45cu259/720p_six/sample-01-crops-6behhbgu/target_002.pgm](../../../data/evidence/2026-10-03-arm-localize-baseline/pc-benchmark/run-v45cu259/720p_six/sample-01-crops-6behhbgu/target_002.pgm)<br>灰度像素图 · 已纳入Git（含暂存） | 保存target_002的目标ROI裁剪；其合成/文件/实机来源及框/标签含义以data/evidence/2026-10-03-arm-localize-baseline/README.md为准。 | 所在目录说明：[data/evidence/2026-10-03-arm-localize-baseline/README.md](../../../data/evidence/2026-10-03-arm-localize-baseline/README.md)<br>同名配套文件：[data/evidence/2026-10-03-arm-localize-baseline/pc-benchmark/run-v45cu259/720p_six/sample-01-crops-6behhbgu/target_002.hex](../../../data/evidence/2026-10-03-arm-localize-baseline/pc-benchmark/run-v45cu259/720p_six/sample-01-crops-6behhbgu/target_002.hex) |
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
