never-die-cold/FPGA-Alittle-Design/docs/file-guide/files.csv

文件路径 | 目录组 | 类型 | 版本状态 | 一两句话说明 | 说明依据 | 关联总数 | 关联文件（最多20项，完整关系见JSON）
.gitattributes | root | 软件/脚本/项目入口 | 已纳入Git（含暂存） | 配置Git行尾、二进制和差异处理；它影响证据快照是否仍保持原始字节。 | 人工核对角色说明 | 2 | 所在目录说明：README.md 文本引用：data/logs/2026-10-10-model-reference/numpy-parity-before.log
.github/ISSUE_TEMPLATE/bug_report.md | root | 软件/脚本/项目入口 | 已纳入Git（含暂存） | 新建缺陷Issue时的填写模板，要求说明复现步骤、现象和环境；与工作流中的问题留痕配套。 | 人工核对角色说明 | 1 | 所在目录说明：README.md
.github/ISSUE_TEMPLATE/task.md | root | 软件/脚本/项目入口 | 已纳入Git（含暂存） | 新建任务Issue时的填写模板；用于把工作范围、验收与依赖说清楚。 | 人工核对角色说明 | 1 | 所在目录说明：README.md
.github/PULL_REQUEST_TEMPLATE.md | root | 软件/脚本/项目入口 | 已纳入Git（含暂存） | 提交PR时的说明模板，提醒作者给出改动、验证和理解门槛；服务于main合入流程。 | 人工核对角色说明 | 4 | 所在目录说明：README.md 文本引用：sim/scripts/run_iverilog.sh 文本引用：skill/understand-gate/SKILL.md 文本引用：src/riscv/plan.md
.gitignore | root | 软件/脚本/项目入口 | 已纳入Git（含暂存） | 规定哪些构建产物、缓存和依赖不入Git；本索引按它排除本地生成目录，但保留已经纳入Git的证据。 | 人工核对角色说明 | 2 | 所在目录说明：README.md 文本引用：sim/scripts/fetch_arch_test.sh
AGENTS.md | root | 软件/脚本/项目入口 | 已纳入Git（含暂存） | 本仓库给开发者和AI的开工、目录边界、验证与提交纪律；执行细节指向 docs/workflow.md 和 skill/。 | 人工核对角色说明 | 7 | 所在目录说明：README.md 文本引用：docs/workflow.md 文本引用：sim/scripts/run_iverilog.sh 文本引用：skill/gufa-programming/SKILL.md 文本引用：skill/understand-gate/SKILL.md 文本引用：src/riscv/design_v0.md 文本引用：src/riscv/plan.md
LICENSE | root | 软件/脚本/项目入口 | 已纳入Git（含暂存） | 本项目代码的许可证文本；第三方IP、字体和CoreMark各自另有许可证。 | 人工核对角色说明 | 1 | 所在目录说明：README.md
README.md | root | 软件/脚本/项目入口 | 已纳入Git（含暂存） | 项目总入口，说明作品目标、模块、当前进度与复现方式；后续任务由根 plan.md 细化。 | 人工核对角色说明 | 46 | 文档链接：LICENSE 文本引用：board/README.md 文档链接：board/README.md 文本引用：data/README.md 文档链接：data/README.md 文本引用：data/logs/2026-10-03-vision-onboard/README.md 文档链接：data/logs/2026-10-03-vision-onboard/README.md 文本引用：data/logs/2026-10-07-pi-pynq/README.md 文档链接：data/logs/2026-10-07-pi-pynq/README.md 文本引用：data/logs/2026-10-13-cnn-arithmetic/README.md 文档链接：data/logs/2026-10-13-cnn-arithmetic/README.md 文本引用：data/metrics.csv 文档链接：data/metrics.csv 文本引用：docs/README.md 文档链接：docs/README.md 文本引用：docs/c01-capture-implementation-baseline.md 文档链接：docs/c01-capture-implementation-baseline.md 文本引用：docs/coprocessor-integration-v0.md 文档链接：docs/coprocessor-integration-v0.md 文本引用：docs/onboarding.md
board/README.md | board | 说明/计划/契约 | 已纳入Git（含暂存） | 说明《board —— 上板工程与实测输出》的规则、过程或结果；其引用文件见关联栏，日期/候选/冻结边界按正文保留。 | 读取Markdown标题与链接 | 9 | 所在目录说明：README.md 文本引用：data/logs/2026-10-03-vision-onboard/README.md 文档链接：data/logs/2026-10-03-vision-onboard/README.md 文本引用：data/logs/2026-10-07-pi-pynq/README.md 文档链接：data/logs/2026-10-07-pi-pynq/README.md 文本引用：report/module1-closure.md 文档链接：report/module1-closure.md 文本引用：src/pynq_host/ONBOARD.md 文档链接：src/pynq_host/ONBOARD.md
board/adv7611_init.py | board | 软件/脚本/项目入口 | 已纳入Git（含暂存） | 外接ADV7611接收器初始化示例；PYNQ-Z2本板HDMI直接接PL，不使用这份驱动。 | 人工核对角色说明 | 2 | 所在目录说明：board/README.md 文本引用：docs/track_research.md
board/hardware.md | board | 说明/计划/契约 | 已纳入Git（含暂存） | 说明《board/hardware —— 演示硬件与 HDMI 接线》的规则、过程或结果；其引用文件见关联栏，日期/候选/冻结边界按正文保留。 | 读取Markdown标题与链接 | 14 | 所在目录说明：board/README.md 文档链接：board/logs/README.md 文档链接：board/setup.md 文本引用：data/logs/2026-10-03-vision-onboard/README.md 文档链接：data/logs/2026-10-03-vision-onboard/README.md 文本引用：data/logs/2026-10-07-pi-pynq/README.md 文档链接：data/logs/2026-10-07-pi-pynq/README.md 文本引用：data/metrics.csv 文本引用：docs/pi-dev-roles.md 文档链接：docs/pi-dev-roles.md 文本引用：report/llm_log/2026-09-20-demo-hardware-chain.md 文档链接：report/llm_log/2026-09-20-demo-hardware-chain.md 文本引用：report/llm_log/2026-09-21-narrative-architecture-fix.md 文档链接：report/llm_log/2026-09-21-narrative-architecture-fix.md
board/logs/2026-09-20-pynq-z2-smoke/README.md | board | 说明/计划/契约 | 已纳入Git（含暂存） | 说明《PYNQ-Z2 LED smoke test 上板实测记录（2026-09-20）》的规则、过程或结果；其引用文件见关联栏，日期/候选/冻结边界按正文保留。 | 读取Markdown标题与链接 | 8 | 文本引用：board/README.md 所在目录说明：board/logs/README.md 文本引用：board/smoke_test/README.md 文本引用：board/smoke_test/scripts/build.tcl 文本引用：data/logs/2026-09-20-pynq-z2-smoke-vivado/README.md 文档链接：data/logs/2026-09-20-pynq-z2-smoke-vivado/README.md 文本引用：report/llm_log/2026-09-20-pynq-z2-smoke-verification.md 文本引用：src/riscv/design_v0.md
board/logs/2026-09-26-soc-onboard/README.md | board | 说明/计划/契约 | 已纳入Git（含暂存） | 说明《Part A SoC 真实上板记录（2026-09-26）》的规则、过程或结果；其引用文件见关联栏，日期/候选/冻结边界按正文保留。 | 读取Markdown标题与链接 | 9 | 文本引用：board/README.md 所在目录说明：board/logs/README.md 文本引用：board/scripts/program_soc.tcl 文本引用：data/logs/2026-09-26-soc-onboard/README.md 文档链接：data/logs/2026-09-26-soc-onboard/README.md 文本引用：report/llm_log/2026-09-23-partA-soc-onboard.md 文本引用：report/llm_log/2026-09-26-partA-soc-onboard-verify.md 文本引用：src/riscv/pynq_z2_top.v 文本引用：src/riscv/soc_top.v
board/logs/2026-10-05-partB-v1-onboard/README.md | board | 说明/计划/契约 | 已纳入Git（含暂存） | 说明《Part B v1（三级流水 + 转发）真实上板记录（2026-10-05）》的规则、过程或结果；其引用文件见关联栏，日期/候选/冻结边界按正文保留。 | 读取Markdown标题与链接 | 7 | 文本引用：board/README.md 所在目录说明：board/logs/README.md 文本引用：board/scripts/program_soc.bat 文本引用：data/logs/2026-10-05-partB-v1-onboard/README.md 文档链接：data/logs/2026-10-05-partB-v1-onboard/README.md 文本引用：docs/partB-rtl-handoff.md 文本引用：report/llm_log/2026-10-05-partB-v1-onboard-verify.md
board/logs/2026-10-06-partB-t2-board/README.md | board | 说明/计划/契约 | 已纳入Git（含暂存） | 说明《Part B T2 SoC 真实上板记录（2026-10-06）》的规则、过程或结果；其引用文件见关联栏，日期/候选/冻结边界按正文保留。 | 读取Markdown标题与链接 | 6 | 文本引用：board/README.md 所在目录说明：board/logs/README.md 文本引用：board/scripts/program_soc.bat 文本引用：data/logs/2026-10-06-partB-t2-board/README.md 文档链接：data/logs/2026-10-06-partB-t2-board/README.md 文本引用：report/llm_log/2026-10-06-partB-t2-onboard-verify.md
board/logs/2026-10-06-partC-bht2-board/README.md | board | 说明/计划/契约 | 已纳入Git（含暂存） | 说明《Part C 主档（v1_fwd+BHT2）真实上板记录（2026-10-06）》的规则、过程或结果；其引用文件见关联栏，日期/候选/冻结边界按正文保留。 | 读取Markdown标题与链接 | 6 | 文本引用：board/README.md 所在目录说明：board/logs/README.md 文本引用：board/scripts/program_soc.bat 文本引用：data/logs/2026-10-06-partC-verify/README.md 文档链接：data/logs/2026-10-06-partC-verify/README.md 文本引用：report/llm_log/2026-10-06-partC-verify.md
board/logs/README.md | board | 说明/计划/契约 | 已纳入Git（含暂存） | 说明《board/logs —— 上板实测记录（只追加，不删改）》的规则、过程或结果；其引用文件见关联栏，日期/候选/冻结边界按正文保留。 | 读取Markdown标题与链接 | 2 | 所在目录说明：board/README.md 文本引用：board/README.md
board/scripts/program_soc.bat | board | 软件/脚本/项目入口 | 已纳入Git（含暂存） | Windows包装SoC位流下载Tcl；上板操作从它派发。 | 人工核对角色说明 | 1 | 所在目录说明：board/README.md
board/scripts/program_soc.tcl | board | 软件/脚本/项目入口 | 已纳入Git（含暂存） | 使用Vivado Hardware Manager下载指定SoC位流；它是上板入口，需与对应固件和时序报告配对。 | 人工核对角色说明 | 1 | 所在目录说明：board/README.md
board/setup.md | board | 说明/计划/契约 | 已纳入Git（含暂存） | 说明《PYNQ-Z2 从零复现指南（setup）》的规则、过程或结果；其引用文件见关联栏，日期/候选/冻结边界按正文保留。 | 读取Markdown标题与链接 | 4 | 所在目录说明：board/README.md 文本引用：board/README.md 文档链接：board/hardware.md 文本引用：board/logs/README.md
board/smoke_test/.gitignore | board | Git配置 | 已纳入Git（含暂存） | 规定本目录生成物的忽略范围；它与根.gitignore共同决定哪些文件进入项目版本库。 | 目录/格式与邻接文件 | 1 | 所在目录说明：board/smoke_test/README.md
board/smoke_test/README.md | board | 说明/计划/契约 | 已纳入Git（含暂存） | 说明《PYNQ-Z2 最小流水灯上板测试》的规则、过程或结果；其引用文件见关联栏，日期/候选/冻结边界按正文保留。 | 读取Markdown标题与链接 | 3 | 所在目录说明：board/README.md 文本引用：board/smoke_test/scripts/build.tcl 文本引用：board/smoke_test/sim/run_iverilog.sh
board/smoke_test/constraints/pynq_z2_smoke.xdc | board | 软件/脚本/项目入口 | 已纳入Git（含暂存） | 绑定早期LED冒烟顶层的板钟、复位和LED管脚；由该目录build.tcl加载。 | 人工核对角色说明 | 1 | 所在目录说明：board/smoke_test/README.md
board/smoke_test/rtl/pynq_z2_smoke_top.v | board | RTL实现 | 已纳入Git（含暂存） | 板卡最早期时钟/复位/LED冒烟顶层；不含后续自研核或视觉识别。 | 人工核对角色说明 | 1 | 所在目录说明：board/smoke_test/README.md
board/smoke_test/scripts/build.tcl | board | 软件/脚本/项目入口 | 已纳入Git（含暂存） | 构建早期PYNQ-Z2 LED冒烟工程并检查端口/时序；不同于完整SoC或HDMI位流构建。 | 人工核对角色说明 | 1 | 所在目录说明：board/smoke_test/README.md
board/smoke_test/sim/pynq_z2_smoke_tb.v | board | RTL实现 | 已纳入Git（含暂存） | 验证早期板卡LED冒烟逻辑的测试台；与该目录顶层和Icarus入口配套。 | 人工核对角色说明 | 1 | 所在目录说明：board/smoke_test/README.md
board/smoke_test/sim/run_iverilog.sh | board | 软件/脚本/项目入口 | 已纳入Git（含暂存） | 编译并运行该目录的最早期LED冒烟测试台；只验证板卡冒烟逻辑，不是全项目核回归入口。 | 人工核对角色说明 | 1 | 所在目录说明：board/smoke_test/README.md
build/README.md | build | 说明/计划/契约 | 已纳入Git（含暂存） | 说明《build —— 可复现构建》的规则、过程或结果；其引用文件见关联栏，日期/候选/冻结边界按正文保留。 | 读取Markdown标题与链接 | 14 | 所在目录说明：README.md 文本引用：build/build.tcl 文本引用：build/build_fmax.tcl 文本引用：build/build_soc.tcl 文档链接：build/reports/timing_impl.rpt 文档链接：build/reports/timing_worst_paths.rpt 文档链接：build/reports/utilization_impl.rpt 文本引用：data/logs/2026-10-07-partC-postopt/README.md 文档链接：data/logs/2026-10-07-partC-postopt/README.md 文本引用：data/metrics.csv 文本引用：report/llm_log/2026-09-14-vivado-2026-1-acceptance.md 文档链接：report/llm_log/2026-09-14-vivado-2026-1-acceptance.md 文本引用：report/module1-closure.md 文档链接：report/module1-closure.md
build/build.tcl | build | 软件/脚本/项目入口 | 已纳入Git（含暂存） | 核独立综合/时序构建入口；资源和频率按该脚本的器件/约束口径解释。 | 人工核对角色说明 | 1 | 所在目录说明：build/README.md
build/build_fmax.tcl | build | 软件/脚本/项目入口 | 已纳入Git（含暂存） | 执行核频率/OOC比较构建；报告按参数档保存，不能把slack外推当该频率实点通过。 | 人工核对角色说明 | 4 | 所在目录说明：build/README.md 文本引用：build/build.tcl 文本引用：build/constraints/core_top.xdc 文本引用：docs/core_comparison.md
build/build_soc.tcl | build | 软件/脚本/项目入口 | 已纳入Git（含暂存） | 构建最小SoC板级实现及报告；位流由board/scripts下载，软件镜像按参数预载。 | 人工核对角色说明 | 1 | 所在目录说明：build/README.md
build/constraints/core_top.xdc | build | 软件/脚本/项目入口 | 已纳入Git（含暂存） | 规定核独立综合/实现时的时钟约束；与build脚本一起解释OOC频率口径。 | 人工核对角色说明 | 1 | 所在目录说明：build/README.md
build/constraints/pynq_z2_soc.xdc | build | 软件/脚本/项目入口 | 已纳入Git（含暂存） | 绑定PYNQ-Z2最小SoC的板钟/复位/LED及相应时序；与pynq_z2_top和build_soc配套。 | 人工核对角色说明 | 1 | 所在目录说明：build/README.md
build/reports/design_analysis_impl.rpt | build | Vivado报告 | 已纳入Git（含暂存） | 保存该轮设计分析报告，供build/README.md复查；它是工具输出，不是待编辑的RTL。 | 目录/格式与邻接文件 | 1 | 所在目录说明：build/README.md
build/reports/soc_40mhz_bht2/soc_check_timing.rpt | build | Vivado报告 | 已纳入Git（含暂存） | 保存时序路径和slack报告，供build/README.md复查；它是工具输出，不是待编辑的RTL。 | 目录/格式与邻接文件 | 1 | 所在目录说明：build/README.md
build/reports/soc_40mhz_bht2/soc_clock_utilization_impl.rpt | build | Vivado报告 | 已纳入Git（含暂存） | 保存资源占用报告，供build/README.md复查；它是工具输出，不是待编辑的RTL。 | 目录/格式与邻接文件 | 1 | 所在目录说明：build/README.md
build/reports/soc_40mhz_bht2/soc_clock_utilization_synth.rpt | build | Vivado报告 | 已纳入Git（含暂存） | 保存资源占用报告，供build/README.md复查；它是工具输出，不是待编辑的RTL。 | 目录/格式与邻接文件 | 1 | 所在目录说明：build/README.md
build/reports/soc_40mhz_bht2/soc_drc_impl.rpt | build | Vivado报告 | 已纳入Git（含暂存） | 保存设计规则检查报告，供build/README.md复查；它是工具输出，不是待编辑的RTL。 | 目录/格式与邻接文件 | 1 | 所在目录说明：build/README.md
build/reports/soc_40mhz_bht2/soc_timing_impl.rpt | build | Vivado报告 | 已纳入Git（含暂存） | 保存时序路径和slack报告，供build/README.md复查；它是工具输出，不是待编辑的RTL。 | 目录/格式与邻接文件 | 1 | 所在目录说明：build/README.md
build/reports/soc_40mhz_bht2/soc_timing_worst_paths.rpt | build | Vivado报告 | 已纳入Git（含暂存） | 保存时序路径和slack报告，供build/README.md复查；它是工具输出，不是待编辑的RTL。 | 目录/格式与邻接文件 | 1 | 所在目录说明：build/README.md
build/reports/soc_40mhz_bht2/soc_utilization_impl.rpt | build | Vivado报告 | 已纳入Git（含暂存） | 保存资源占用报告，供build/README.md复查；它是工具输出，不是待编辑的RTL。 | 目录/格式与邻接文件 | 1 | 所在目录说明：build/README.md
build/reports/soc_40mhz_bht2/soc_utilization_synth.rpt | build | Vivado报告 | 已纳入Git（含暂存） | 保存资源占用报告，供build/README.md复查；它是工具输出，不是待编辑的RTL。 | 目录/格式与邻接文件 | 1 | 所在目录说明：build/README.md
build/reports/soc_40mhz_bht2/soc_vivado_version.txt | build | 文本记录 | 已纳入Git（含暂存） | 保存soc_vivado_version的文本记录或工具读回；用于build/README.md中对应步骤的对照，不从文件名推断PASS。 | 目录/格式与邻接文件 | 1 | 所在目录说明：build/README.md
build/reports/soc_check_timing.rpt | build | Vivado报告 | 已纳入Git（含暂存） | 保存时序路径和slack报告，供build/README.md复查；它是工具输出，不是待编辑的RTL。 | 目录/格式与邻接文件 | 1 | 所在目录说明：build/README.md
build/reports/soc_clock_utilization_impl.rpt | build | Vivado报告 | 已纳入Git（含暂存） | 保存资源占用报告，供build/README.md复查；它是工具输出，不是待编辑的RTL。 | 目录/格式与邻接文件 | 1 | 所在目录说明：build/README.md
build/reports/soc_clock_utilization_synth.rpt | build | Vivado报告 | 已纳入Git（含暂存） | 保存资源占用报告，供build/README.md复查；它是工具输出，不是待编辑的RTL。 | 目录/格式与邻接文件 | 1 | 所在目录说明：build/README.md
build/reports/soc_drc_impl.rpt | build | Vivado报告 | 已纳入Git（含暂存） | 保存设计规则检查报告，供build/README.md复查；它是工具输出，不是待编辑的RTL。 | 目录/格式与邻接文件 | 1 | 所在目录说明：build/README.md
build/reports/soc_timing_impl.rpt | build | Vivado报告 | 已纳入Git（含暂存） | 保存时序路径和slack报告，供build/README.md复查；它是工具输出，不是待编辑的RTL。 | 目录/格式与邻接文件 | 1 | 所在目录说明：build/README.md
build/reports/soc_timing_worst_paths.rpt | build | Vivado报告 | 已纳入Git（含暂存） | 保存时序路径和slack报告，供build/README.md复查；它是工具输出，不是待编辑的RTL。 | 目录/格式与邻接文件 | 1 | 所在目录说明：build/README.md
build/reports/soc_utilization_impl.rpt | build | Vivado报告 | 已纳入Git（含暂存） | 保存资源占用报告，供build/README.md复查；它是工具输出，不是待编辑的RTL。 | 目录/格式与邻接文件 | 1 | 所在目录说明：build/README.md
build/reports/soc_utilization_synth.rpt | build | Vivado报告 | 已纳入Git（含暂存） | 保存资源占用报告，供build/README.md复查；它是工具输出，不是待编辑的RTL。 | 目录/格式与邻接文件 | 1 | 所在目录说明：build/README.md
build/reports/soc_vivado_version.txt | build | 文本记录 | 已纳入Git（含暂存） | 保存soc_vivado_version的文本记录或工具读回；用于build/README.md中对应步骤的对照，不从文件名推断PASS。 | 目录/格式与邻接文件 | 1 | 所在目录说明：build/README.md
build/reports/timing_impl.rpt | build | Vivado报告 | 已纳入Git（含暂存） | 保存时序路径和slack报告，供build/README.md复查；它是工具输出，不是待编辑的RTL。 | 目录/格式与邻接文件 | 1 | 所在目录说明：build/README.md
build/reports/timing_synth.rpt | build | Vivado报告 | 已纳入Git（含暂存） | 保存时序路径和slack报告，供build/README.md复查；它是工具输出，不是待编辑的RTL。 | 目录/格式与邻接文件 | 1 | 所在目录说明：build/README.md
build/reports/timing_worst_paths.rpt | build | Vivado报告 | 已纳入Git（含暂存） | 保存时序路径和slack报告，供build/README.md复查；它是工具输出，不是待编辑的RTL。 | 目录/格式与邻接文件 | 1 | 所在目录说明：build/README.md
build/reports/utilization_impl.rpt | build | Vivado报告 | 已纳入Git（含暂存） | 保存资源占用报告，供build/README.md复查；它是工具输出，不是待编辑的RTL。 | 目录/格式与邻接文件 | 1 | 所在目录说明：build/README.md
build/reports/utilization_synth.rpt | build | Vivado报告 | 已纳入Git（含暂存） | 保存资源占用报告，供build/README.md复查；它是工具输出，不是待编辑的RTL。 | 目录/格式与邻接文件 | 1 | 所在目录说明：build/README.md
data/README.md | data-README.md | 说明/计划/契约 | 已纳入Git（含暂存） | 说明《data —— 测试数据、黄金参考与指标汇总》的规则、过程或结果；其引用文件见关联栏，日期/候选/冻结边界按正文保留。 | 读取Markdown标题与链接 | 6 | 所在目录说明：README.md 文本引用：board/README.md 文档链接：data/logs/2026-10-03-vision-onboard/README.md 文档链接：data/logs/2026-10-07-pi-pynq/README.md 文本引用：report/module1-closure.md 文档链接：report/module1-closure.md
data/evidence/.gitkeep | data-evidence | 目录占位 | 已纳入Git（含暂存） | 让Git保留尚无正式内容的目录；它不包含设计、数据或验收结果。 | 目录/格式与邻接文件 | 1 | 所在目录说明：data/README.md
data/evidence/2026-09-23-coremark-main-hook.patch | data-evidence | 源码补丁 | 已纳入Git（含暂存） | 保存2026-09-23-coremark-main-hook相关的源码补丁；使用方式和来源应与data/README.md及同目录文件对照。 | 目录/格式与邻接文件 | 3 | 所在目录说明：data/README.md 文本引用：src/riscv_fw/coremark/core_main.c 文本引用：src/riscv_fw/coremark/vendor/core_main.c
data/evidence/2026-09-23-coremark-source.md | data-evidence | 说明/计划/契约 | 已纳入Git（含暂存） | 说明《CoreMark 官方源码入库证据》的规则、过程或结果；其引用文件见关联栏，日期/候选/冻结边界按正文保留。 | 读取Markdown标题与链接 | 2 | 所在目录说明：data/README.md 文本引用：docs/coremark.md
data/evidence/2026-10-03-arm-localize-baseline/.gitattributes | data-evidence | Git配置 | 已纳入Git（含暂存） | 对本目录证据的行尾/二进制和差异检查作局部约定；用于保留归档字节，与根Git属性叠加。 | 目录/格式与邻接文件 | 1 | 所在目录说明：data/evidence/2026-10-03-arm-localize-baseline/README.md
data/evidence/2026-10-03-arm-localize-baseline/README.md | data-evidence | 说明/计划/契约 | 已纳入Git（含暂存） | 说明《ARM 文件输入定位/裁剪：证据索引》的规则、过程或结果；其引用文件见关联栏，日期/候选/冻结边界按正文保留。 | 读取Markdown标题与链接 | 3 | 所在目录说明：data/README.md 文本引用：docs/arm-localize-baseline-plan.md 文本引用：docs/arm-localize-results.md
data/evidence/2026-10-03-arm-localize-baseline/arm-board-final/arm_localize/README.md | data-evidence | 说明/计划/契约 | 已纳入Git（含暂存） | 说明《ARM 文件定位/裁剪便携包》的规则、过程或结果；其引用文件见关联栏，日期/候选/冻结边界按正文保留。 | 读取Markdown标题与链接 | 3 | 所在目录说明：data/evidence/2026-10-03-arm-localize-baseline/README.md 同目录输入/元数据：data/evidence/2026-10-03-arm-localize-baseline/arm-board-final/arm_localize/manifest.json 文本引用：sim/scripts/make_arm_localize_pkg.py
data/evidence/2026-10-03-arm-localize-baseline/arm-board-final/arm_localize/arm_localize.py | data-evidence | 归档源码/输入副本 | 已纳入Git（含暂存） | 这是该轮保存的源码/配置副本：标准库文件定位/裁剪运行器，记录纯计算耗时；它不从实时HDMI取帧；所属实验与当前入口以关联栏区分。 | 快照路径＋对应源码角色 | 3 | 所在目录说明：data/evidence/2026-10-03-arm-localize-baseline/arm-board-final/arm_localize/README.md 同目录输入/元数据：data/evidence/2026-10-03-arm-localize-baseline/arm-board-final/arm_localize/manifest.json Python导入：data/evidence/2026-10-03-arm-localize-baseline/arm-board-final/arm_localize/reference.py
data/evidence/2026-10-03-arm-localize-baseline/arm-board-final/arm_localize/arm_localize_bench.py | data-evidence | 归档源码/输入副本 | 已纳入Git（含暂存） | 这是该轮保存的源码/配置副本：在固定合成场景上重复测定位性能并保存每次结果；用于ARM与本机同负载对比；所属实验与当前入口以关联栏区分。 | 快照路径＋对应源码角色 | 4 | 所在目录说明：data/evidence/2026-10-03-arm-localize-baseline/arm-board-final/arm_localize/README.md Python导入：data/evidence/2026-10-03-arm-localize-baseline/arm-board-final/arm_localize/arm_localize.py 同目录输入/元数据：data/evidence/2026-10-03-arm-localize-baseline/arm-board-final/arm_localize/manifest.json 文本引用：data/evidence/2026-10-03-arm-localize-baseline/two_targets.json
data/evidence/2026-10-03-arm-localize-baseline/arm-board-final/arm_localize/arm_localize_selftest.py | data-evidence | 归档源码/输入副本 | 已纳入Git（含暂存） | 这是该轮保存的源码/配置副本：便携定位包自检，覆盖固定答案、非法输入、CLI和哈希；供打包/移交检查；所属实验与当前入口以关联栏区分。 | 快照路径＋对应源码角色 | 3 | 所在目录说明：data/evidence/2026-10-03-arm-localize-baseline/arm-board-final/arm_localize/README.md Python导入：data/evidence/2026-10-03-arm-localize-baseline/arm-board-final/arm_localize/arm_localize.py 同目录输入/元数据：data/evidence/2026-10-03-arm-localize-baseline/arm-board-final/arm_localize/manifest.json
data/evidence/2026-10-03-arm-localize-baseline/arm-board-final/arm_localize/benchmark/run-1p9nq39b/720p_empty/input.json | data-evidence | 结构化结果/元数据 | 已纳入Git（含暂存） | 保存input的输入/设备/运行元数据，字段包括具体字段；与data/evidence/2026-10-03-arm-localize-baseline/arm-board-final/arm_localize/README.md中的生成/校验流程一起使用。 | 目录/格式与邻接文件 | 1 | 所在目录说明：data/evidence/2026-10-03-arm-localize-baseline/arm-board-final/arm_localize/README.md
data/evidence/2026-10-03-arm-localize-baseline/arm-board-final/arm_localize/benchmark/run-1p9nq39b/720p_empty/sample-00.json | data-evidence | 结构化结果/元数据 | 已纳入Git（含暂存） | 保存sample-00的实验结果或检查产物，字段包括frame_id、config_id、width、height、status、targets、schema_version；与data/evidence/2026-10-03-arm-localize-baseline/arm-board-final/arm_localize/README.md中的生成/校验流程一起使用。 | 目录/格式与邻接文件 | 2 | 所在目录说明：data/evidence/2026-10-03-arm-localize-baseline/arm-board-final/arm_localize/README.md 同目录输入/元数据：data/evidence/2026-10-03-arm-localize-baseline/arm-board-final/arm_localize/benchmark/run-1p9nq39b/720p_empty/input.json
data/evidence/2026-10-03-arm-localize-baseline/arm-board-final/arm_localize/benchmark/run-1p9nq39b/720p_empty/sample-01.json | data-evidence | 结构化结果/元数据 | 已纳入Git（含暂存） | 保存sample-01的实验结果或检查产物，字段包括frame_id、config_id、width、height、status、targets、schema_version；与data/evidence/2026-10-03-arm-localize-baseline/arm-board-final/arm_localize/README.md中的生成/校验流程一起使用。 | 目录/格式与邻接文件 | 2 | 所在目录说明：data/evidence/2026-10-03-arm-localize-baseline/arm-board-final/arm_localize/README.md 同目录输入/元数据：data/evidence/2026-10-03-arm-localize-baseline/arm-board-final/arm_localize/benchmark/run-1p9nq39b/720p_empty/input.json
data/evidence/2026-10-03-arm-localize-baseline/arm-board-final/arm_localize/benchmark/run-1p9nq39b/720p_empty/sample-02.json | data-evidence | 结构化结果/元数据 | 已纳入Git（含暂存） | 保存sample-02的实验结果或检查产物，字段包括frame_id、config_id、width、height、status、targets、schema_version；与data/evidence/2026-10-03-arm-localize-baseline/arm-board-final/arm_localize/README.md中的生成/校验流程一起使用。 | 目录/格式与邻接文件 | 2 | 所在目录说明：data/evidence/2026-10-03-arm-localize-baseline/arm-board-final/arm_localize/README.md 同目录输入/元数据：data/evidence/2026-10-03-arm-localize-baseline/arm-board-final/arm_localize/benchmark/run-1p9nq39b/720p_empty/input.json
data/evidence/2026-10-03-arm-localize-baseline/arm-board-final/arm_localize/benchmark/run-1p9nq39b/720p_empty/sample-03.json | data-evidence | 结构化结果/元数据 | 已纳入Git（含暂存） | 保存sample-03的实验结果或检查产物，字段包括frame_id、config_id、width、height、status、targets、schema_version；与data/evidence/2026-10-03-arm-localize-baseline/arm-board-final/arm_localize/README.md中的生成/校验流程一起使用。 | 目录/格式与邻接文件 | 2 | 所在目录说明：data/evidence/2026-10-03-arm-localize-baseline/arm-board-final/arm_localize/README.md 同目录输入/元数据：data/evidence/2026-10-03-arm-localize-baseline/arm-board-final/arm_localize/benchmark/run-1p9nq39b/720p_empty/input.json
data/evidence/2026-10-03-arm-localize-baseline/arm-board-final/arm_localize/benchmark/run-1p9nq39b/720p_empty/sample-04.json | data-evidence | 结构化结果/元数据 | 已纳入Git（含暂存） | 保存sample-04的实验结果或检查产物，字段包括frame_id、config_id、width、height、status、targets、schema_version；与data/evidence/2026-10-03-arm-localize-baseline/arm-board-final/arm_localize/README.md中的生成/校验流程一起使用。 | 目录/格式与邻接文件 | 2 | 所在目录说明：data/evidence/2026-10-03-arm-localize-baseline/arm-board-final/arm_localize/README.md 同目录输入/元数据：data/evidence/2026-10-03-arm-localize-baseline/arm-board-final/arm_localize/benchmark/run-1p9nq39b/720p_empty/input.json
data/evidence/2026-10-03-arm-localize-baseline/arm-board-final/arm_localize/benchmark/run-1p9nq39b/720p_empty/warmup-00.json | data-evidence | 结构化结果/元数据 | 已纳入Git（含暂存） | 保存warmup-00的实验结果或检查产物，字段包括frame_id、config_id、width、height、status、targets、schema_version；与data/evidence/2026-10-03-arm-localize-baseline/arm-board-final/arm_localize/README.md中的生成/校验流程一起使用。 | 目录/格式与邻接文件 | 2 | 所在目录说明：data/evidence/2026-10-03-arm-localize-baseline/arm-board-final/arm_localize/README.md 同目录输入/元数据：data/evidence/2026-10-03-arm-localize-baseline/arm-board-final/arm_localize/benchmark/run-1p9nq39b/720p_empty/input.json
data/evidence/2026-10-03-arm-localize-baseline/arm-board-final/arm_localize/benchmark/run-1p9nq39b/720p_six/input.json | data-evidence | 结构化结果/元数据 | 已纳入Git（含暂存） | 保存input的输入/设备/运行元数据，字段包括具体字段；与data/evidence/2026-10-03-arm-localize-baseline/arm-board-final/arm_localize/README.md中的生成/校验流程一起使用。 | 目录/格式与邻接文件 | 1 | 所在目录说明：data/evidence/2026-10-03-arm-localize-baseline/arm-board-final/arm_localize/README.md
data/evidence/2026-10-03-arm-localize-baseline/arm-board-final/arm_localize/benchmark/run-1p9nq39b/720p_six/sample-00-crops-wqxs0nc_/target_000.hex | data-evidence | 十六进制数据 | 已纳入Git（含暂存） | 以十六进制数据形式保存target_000的目标ROI像素；由对应加载器/testbench读取，位宽、排布和端序按data/evidence/2026-10-03-arm-localize-baseline/arm-board-final/arm_localize/README.md核对。 | 目录/格式与邻接文件 | 2 | 所在目录说明：data/evidence/2026-10-03-arm-localize-baseline/arm-board-final/arm_localize/README.md 同名配套文件：data/evidence/2026-10-03-arm-localize-baseline/arm-board-final/arm_localize/benchmark/run-1p9nq39b/720p_six/sample-00-crops-wqxs0nc_/target_000.pgm
data/evidence/2026-10-03-arm-localize-baseline/arm-board-final/arm_localize/benchmark/run-1p9nq39b/720p_six/sample-00-crops-wqxs0nc_/target_000.pgm | data-evidence | 灰度像素图 | 已纳入Git（含暂存） | 保存target_000的目标ROI裁剪；其合成/文件/实机来源及框/标签含义以data/evidence/2026-10-03-arm-localize-baseline/arm-board-final/arm_localize/README.md为准。 | 目录/格式与邻接文件 | 2 | 所在目录说明：data/evidence/2026-10-03-arm-localize-baseline/arm-board-final/arm_localize/README.md 同名配套文件：data/evidence/2026-10-03-arm-localize-baseline/arm-board-final/arm_localize/benchmark/run-1p9nq39b/720p_six/sample-00-crops-wqxs0nc_/target_000.hex
data/evidence/2026-10-03-arm-localize-baseline/arm-board-final/arm_localize/benchmark/run-1p9nq39b/720p_six/sample-00-crops-wqxs0nc_/target_001.hex | data-evidence | 十六进制数据 | 已纳入Git（含暂存） | 以十六进制数据形式保存target_001的目标ROI像素；由对应加载器/testbench读取，位宽、排布和端序按data/evidence/2026-10-03-arm-localize-baseline/arm-board-final/arm_localize/README.md核对。 | 目录/格式与邻接文件 | 2 | 所在目录说明：data/evidence/2026-10-03-arm-localize-baseline/arm-board-final/arm_localize/README.md 同名配套文件：data/evidence/2026-10-03-arm-localize-baseline/arm-board-final/arm_localize/benchmark/run-1p9nq39b/720p_six/sample-00-crops-wqxs0nc_/target_001.pgm
data/evidence/2026-10-03-arm-localize-baseline/arm-board-final/arm_localize/benchmark/run-1p9nq39b/720p_six/sample-00-crops-wqxs0nc_/target_001.pgm | data-evidence | 灰度像素图 | 已纳入Git（含暂存） | 保存target_001的目标ROI裁剪；其合成/文件/实机来源及框/标签含义以data/evidence/2026-10-03-arm-localize-baseline/arm-board-final/arm_localize/README.md为准。 | 目录/格式与邻接文件 | 2 | 所在目录说明：data/evidence/2026-10-03-arm-localize-baseline/arm-board-final/arm_localize/README.md 同名配套文件：data/evidence/2026-10-03-arm-localize-baseline/arm-board-final/arm_localize/benchmark/run-1p9nq39b/720p_six/sample-00-crops-wqxs0nc_/target_001.hex
data/evidence/2026-10-03-arm-localize-baseline/arm-board-final/arm_localize/benchmark/run-1p9nq39b/720p_six/sample-00-crops-wqxs0nc_/target_002.hex | data-evidence | 十六进制数据 | 已纳入Git（含暂存） | 以十六进制数据形式保存target_002的目标ROI像素；由对应加载器/testbench读取，位宽、排布和端序按data/evidence/2026-10-03-arm-localize-baseline/arm-board-final/arm_localize/README.md核对。 | 目录/格式与邻接文件 | 2 | 所在目录说明：data/evidence/2026-10-03-arm-localize-baseline/arm-board-final/arm_localize/README.md 同名配套文件：data/evidence/2026-10-03-arm-localize-baseline/arm-board-final/arm_localize/benchmark/run-1p9nq39b/720p_six/sample-00-crops-wqxs0nc_/target_002.pgm
data/evidence/2026-10-03-arm-localize-baseline/arm-board-final/arm_localize/benchmark/run-1p9nq39b/720p_six/sample-00-crops-wqxs0nc_/target_002.pgm | data-evidence | 灰度像素图 | 已纳入Git（含暂存） | 保存target_002的目标ROI裁剪；其合成/文件/实机来源及框/标签含义以data/evidence/2026-10-03-arm-localize-baseline/arm-board-final/arm_localize/README.md为准。 | 目录/格式与邻接文件 | 2 | 所在目录说明：data/evidence/2026-10-03-arm-localize-baseline/arm-board-final/arm_localize/README.md 同名配套文件：data/evidence/2026-10-03-arm-localize-baseline/arm-board-final/arm_localize/benchmark/run-1p9nq39b/720p_six/sample-00-crops-wqxs0nc_/target_002.hex
data/evidence/2026-10-03-arm-localize-baseline/arm-board-final/arm_localize/benchmark/run-1p9nq39b/720p_six/sample-00-crops-wqxs0nc_/target_003.hex | data-evidence | 十六进制数据 | 已纳入Git（含暂存） | 以十六进制数据形式保存target_003的目标ROI像素；由对应加载器/testbench读取，位宽、排布和端序按data/evidence/2026-10-03-arm-localize-baseline/arm-board-final/arm_localize/README.md核对。 | 目录/格式与邻接文件 | 2 | 所在目录说明：data/evidence/2026-10-03-arm-localize-baseline/arm-board-final/arm_localize/README.md 同名配套文件：data/evidence/2026-10-03-arm-localize-baseline/arm-board-final/arm_localize/benchmark/run-1p9nq39b/720p_six/sample-00-crops-wqxs0nc_/target_003.pgm
data/evidence/2026-10-03-arm-localize-baseline/arm-board-final/arm_localize/benchmark/run-1p9nq39b/720p_six/sample-00-crops-wqxs0nc_/target_003.pgm | data-evidence | 灰度像素图 | 已纳入Git（含暂存） | 保存target_003的目标ROI裁剪；其合成/文件/实机来源及框/标签含义以data/evidence/2026-10-03-arm-localize-baseline/arm-board-final/arm_localize/README.md为准。 | 目录/格式与邻接文件 | 2 | 所在目录说明：data/evidence/2026-10-03-arm-localize-baseline/arm-board-final/arm_localize/README.md 同名配套文件：data/evidence/2026-10-03-arm-localize-baseline/arm-board-final/arm_localize/benchmark/run-1p9nq39b/720p_six/sample-00-crops-wqxs0nc_/target_003.hex
data/evidence/2026-10-03-arm-localize-baseline/arm-board-final/arm_localize/benchmark/run-1p9nq39b/720p_six/sample-00-crops-wqxs0nc_/target_004.hex | data-evidence | 十六进制数据 | 已纳入Git（含暂存） | 以十六进制数据形式保存target_004的目标ROI像素；由对应加载器/testbench读取，位宽、排布和端序按data/evidence/2026-10-03-arm-localize-baseline/arm-board-final/arm_localize/README.md核对。 | 目录/格式与邻接文件 | 2 | 所在目录说明：data/evidence/2026-10-03-arm-localize-baseline/arm-board-final/arm_localize/README.md 同名配套文件：data/evidence/2026-10-03-arm-localize-baseline/arm-board-final/arm_localize/benchmark/run-1p9nq39b/720p_six/sample-00-crops-wqxs0nc_/target_004.pgm
data/evidence/2026-10-03-arm-localize-baseline/arm-board-final/arm_localize/benchmark/run-1p9nq39b/720p_six/sample-00-crops-wqxs0nc_/target_004.pgm | data-evidence | 灰度像素图 | 已纳入Git（含暂存） | 保存target_004的目标ROI裁剪；其合成/文件/实机来源及框/标签含义以data/evidence/2026-10-03-arm-localize-baseline/arm-board-final/arm_localize/README.md为准。 | 目录/格式与邻接文件 | 2 | 所在目录说明：data/evidence/2026-10-03-arm-localize-baseline/arm-board-final/arm_localize/README.md 同名配套文件：data/evidence/2026-10-03-arm-localize-baseline/arm-board-final/arm_localize/benchmark/run-1p9nq39b/720p_six/sample-00-crops-wqxs0nc_/target_004.hex
data/evidence/2026-10-03-arm-localize-baseline/arm-board-final/arm_localize/benchmark/run-1p9nq39b/720p_six/sample-00-crops-wqxs0nc_/target_005.hex | data-evidence | 十六进制数据 | 已纳入Git（含暂存） | 以十六进制数据形式保存target_005的目标ROI像素；由对应加载器/testbench读取，位宽、排布和端序按data/evidence/2026-10-03-arm-localize-baseline/arm-board-final/arm_localize/README.md核对。 | 目录/格式与邻接文件 | 2 | 所在目录说明：data/evidence/2026-10-03-arm-localize-baseline/arm-board-final/arm_localize/README.md 同名配套文件：data/evidence/2026-10-03-arm-localize-baseline/arm-board-final/arm_localize/benchmark/run-1p9nq39b/720p_six/sample-00-crops-wqxs0nc_/target_005.pgm
data/evidence/2026-10-03-arm-localize-baseline/arm-board-final/arm_localize/benchmark/run-1p9nq39b/720p_six/sample-00-crops-wqxs0nc_/target_005.pgm | data-evidence | 灰度像素图 | 已纳入Git（含暂存） | 保存target_005的目标ROI裁剪；其合成/文件/实机来源及框/标签含义以data/evidence/2026-10-03-arm-localize-baseline/arm-board-final/arm_localize/README.md为准。 | 目录/格式与邻接文件 | 2 | 所在目录说明：data/evidence/2026-10-03-arm-localize-baseline/arm-board-final/arm_localize/README.md 同名配套文件：data/evidence/2026-10-03-arm-localize-baseline/arm-board-final/arm_localize/benchmark/run-1p9nq39b/720p_six/sample-00-crops-wqxs0nc_/target_005.hex
data/evidence/2026-10-03-arm-localize-baseline/arm-board-final/arm_localize/benchmark/run-1p9nq39b/720p_six/sample-00.json | data-evidence | 结构化结果/元数据 | 已纳入Git（含暂存） | 保存sample-00的实验结果或检查产物，字段包括frame_id、config_id、width、height、status、targets、schema_version；与data/evidence/2026-10-03-arm-localize-baseline/arm-board-final/arm_localize/README.md中的生成/校验流程一起使用。 | 目录/格式与邻接文件 | 2 | 所在目录说明：data/evidence/2026-10-03-arm-localize-baseline/arm-board-final/arm_localize/README.md 同目录输入/元数据：data/evidence/2026-10-03-arm-localize-baseline/arm-board-final/arm_localize/benchmark/run-1p9nq39b/720p_six/input.json
data/evidence/2026-10-03-arm-localize-baseline/arm-board-final/arm_localize/benchmark/run-1p9nq39b/720p_six/sample-01-crops-cilds74r/target_000.hex | data-evidence | 十六进制数据 | 已纳入Git（含暂存） | 以十六进制数据形式保存target_000的目标ROI像素；由对应加载器/testbench读取，位宽、排布和端序按data/evidence/2026-10-03-arm-localize-baseline/arm-board-final/arm_localize/README.md核对。 | 目录/格式与邻接文件 | 2 | 所在目录说明：data/evidence/2026-10-03-arm-localize-baseline/arm-board-final/arm_localize/README.md 同名配套文件：data/evidence/2026-10-03-arm-localize-baseline/arm-board-final/arm_localize/benchmark/run-1p9nq39b/720p_six/sample-01-crops-cilds74r/target_000.pgm
data/evidence/2026-10-03-arm-localize-baseline/arm-board-final/arm_localize/benchmark/run-1p9nq39b/720p_six/sample-01-crops-cilds74r/target_000.pgm | data-evidence | 灰度像素图 | 已纳入Git（含暂存） | 保存target_000的目标ROI裁剪；其合成/文件/实机来源及框/标签含义以data/evidence/2026-10-03-arm-localize-baseline/arm-board-final/arm_localize/README.md为准。 | 目录/格式与邻接文件 | 2 | 所在目录说明：data/evidence/2026-10-03-arm-localize-baseline/arm-board-final/arm_localize/README.md 同名配套文件：data/evidence/2026-10-03-arm-localize-baseline/arm-board-final/arm_localize/benchmark/run-1p9nq39b/720p_six/sample-01-crops-cilds74r/target_000.hex
data/evidence/2026-10-03-arm-localize-baseline/arm-board-final/arm_localize/benchmark/run-1p9nq39b/720p_six/sample-01-crops-cilds74r/target_001.hex | data-evidence | 十六进制数据 | 已纳入Git（含暂存） | 以十六进制数据形式保存target_001的目标ROI像素；由对应加载器/testbench读取，位宽、排布和端序按data/evidence/2026-10-03-arm-localize-baseline/arm-board-final/arm_localize/README.md核对。 | 目录/格式与邻接文件 | 2 | 所在目录说明：data/evidence/2026-10-03-arm-localize-baseline/arm-board-final/arm_localize/README.md 同名配套文件：data/evidence/2026-10-03-arm-localize-baseline/arm-board-final/arm_localize/benchmark/run-1p9nq39b/720p_six/sample-01-crops-cilds74r/target_001.pgm
data/evidence/2026-10-03-arm-localize-baseline/arm-board-final/arm_localize/benchmark/run-1p9nq39b/720p_six/sample-01-crops-cilds74r/target_001.pgm | data-evidence | 灰度像素图 | 已纳入Git（含暂存） | 保存target_001的目标ROI裁剪；其合成/文件/实机来源及框/标签含义以data/evidence/2026-10-03-arm-localize-baseline/arm-board-final/arm_localize/README.md为准。 | 目录/格式与邻接文件 | 2 | 所在目录说明：data/evidence/2026-10-03-arm-localize-baseline/arm-board-final/arm_localize/README.md 同名配套文件：data/evidence/2026-10-03-arm-localize-baseline/arm-board-final/arm_localize/benchmark/run-1p9nq39b/720p_six/sample-01-crops-cilds74r/target_001.hex
data/evidence/2026-10-03-arm-localize-baseline/arm-board-final/arm_localize/benchmark/run-1p9nq39b/720p_six/sample-01-crops-cilds74r/target_002.hex | data-evidence | 十六进制数据 | 已纳入Git（含暂存） | 以十六进制数据形式保存target_002的目标ROI像素；由对应加载器/testbench读取，位宽、排布和端序按data/evidence/2026-10-03-arm-localize-baseline/arm-board-final/arm_localize/README.md核对。 | 目录/格式与邻接文件 | 2 | 所在目录说明：data/evidence/2026-10-03-arm-localize-baseline/arm-board-final/arm_localize/README.md 同名配套文件：data/evidence/2026-10-03-arm-localize-baseline/arm-board-final/arm_localize/benchmark/run-1p9nq39b/720p_six/sample-01-crops-cilds74r/target_002.pgm
data/evidence/2026-10-03-arm-localize-baseline/arm-board-final/arm_localize/benchmark/run-1p9nq39b/720p_six/sample-01-crops-cilds74r/target_002.pgm | data-evidence | 灰度像素图 | 已纳入Git（含暂存） | 保存target_002的目标ROI裁剪；其合成/文件/实机来源及框/标签含义以data/evidence/2026-10-03-arm-localize-baseline/arm-board-final/arm_localize/README.md为准。 | 目录/格式与邻接文件 | 2 | 所在目录说明：data/evidence/2026-10-03-arm-localize-baseline/arm-board-final/arm_localize/README.md 同名配套文件：data/evidence/2026-10-03-arm-localize-baseline/arm-board-final/arm_localize/benchmark/run-1p9nq39b/720p_six/sample-01-crops-cilds74r/target_002.hex
data/evidence/2026-10-03-arm-localize-baseline/arm-board-final/arm_localize/benchmark/run-1p9nq39b/720p_six/sample-01-crops-cilds74r/target_003.hex | data-evidence | 十六进制数据 | 已纳入Git（含暂存） | 以十六进制数据形式保存target_003的目标ROI像素；由对应加载器/testbench读取，位宽、排布和端序按data/evidence/2026-10-03-arm-localize-baseline/arm-board-final/arm_localize/README.md核对。 | 目录/格式与邻接文件 | 2 | 所在目录说明：data/evidence/2026-10-03-arm-localize-baseline/arm-board-final/arm_localize/README.md 同名配套文件：data/evidence/2026-10-03-arm-localize-baseline/arm-board-final/arm_localize/benchmark/run-1p9nq39b/720p_six/sample-01-crops-cilds74r/target_003.pgm
data/evidence/2026-10-03-arm-localize-baseline/arm-board-final/arm_localize/benchmark/run-1p9nq39b/720p_six/sample-01-crops-cilds74r/target_003.pgm | data-evidence | 灰度像素图 | 已纳入Git（含暂存） | 保存target_003的目标ROI裁剪；其合成/文件/实机来源及框/标签含义以data/evidence/2026-10-03-arm-localize-baseline/arm-board-final/arm_localize/README.md为准。 | 目录/格式与邻接文件 | 2 | 所在目录说明：data/evidence/2026-10-03-arm-localize-baseline/arm-board-final/arm_localize/README.md 同名配套文件：data/evidence/2026-10-03-arm-localize-baseline/arm-board-final/arm_localize/benchmark/run-1p9nq39b/720p_six/sample-01-crops-cilds74r/target_003.hex
data/evidence/2026-10-03-arm-localize-baseline/arm-board-final/arm_localize/benchmark/run-1p9nq39b/720p_six/sample-01-crops-cilds74r/target_004.hex | data-evidence | 十六进制数据 | 已纳入Git（含暂存） | 以十六进制数据形式保存target_004的目标ROI像素；由对应加载器/testbench读取，位宽、排布和端序按data/evidence/2026-10-03-arm-localize-baseline/arm-board-final/arm_localize/README.md核对。 | 目录/格式与邻接文件 | 2 | 所在目录说明：data/evidence/2026-10-03-arm-localize-baseline/arm-board-final/arm_localize/README.md 同名配套文件：data/evidence/2026-10-03-arm-localize-baseline/arm-board-final/arm_localize/benchmark/run-1p9nq39b/720p_six/sample-01-crops-cilds74r/target_004.pgm
data/evidence/2026-10-03-arm-localize-baseline/arm-board-final/arm_localize/benchmark/run-1p9nq39b/720p_six/sample-01-crops-cilds74r/target_004.pgm | data-evidence | 灰度像素图 | 已纳入Git（含暂存） | 保存target_004的目标ROI裁剪；其合成/文件/实机来源及框/标签含义以data/evidence/2026-10-03-arm-localize-baseline/arm-board-final/arm_localize/README.md为准。 | 目录/格式与邻接文件 | 2 | 所在目录说明：data/evidence/2026-10-03-arm-localize-baseline/arm-board-final/arm_localize/README.md 同名配套文件：data/evidence/2026-10-03-arm-localize-baseline/arm-board-final/arm_localize/benchmark/run-1p9nq39b/720p_six/sample-01-crops-cilds74r/target_004.hex
data/evidence/2026-10-03-arm-localize-baseline/arm-board-final/arm_localize/benchmark/run-1p9nq39b/720p_six/sample-01-crops-cilds74r/target_005.hex | data-evidence | 十六进制数据 | 已纳入Git（含暂存） | 以十六进制数据形式保存target_005的目标ROI像素；由对应加载器/testbench读取，位宽、排布和端序按data/evidence/2026-10-03-arm-localize-baseline/arm-board-final/arm_localize/README.md核对。 | 目录/格式与邻接文件 | 2 | 所在目录说明：data/evidence/2026-10-03-arm-localize-baseline/arm-board-final/arm_localize/README.md 同名配套文件：data/evidence/2026-10-03-arm-localize-baseline/arm-board-final/arm_localize/benchmark/run-1p9nq39b/720p_six/sample-01-crops-cilds74r/target_005.pgm
data/evidence/2026-10-03-arm-localize-baseline/arm-board-final/arm_localize/benchmark/run-1p9nq39b/720p_six/sample-01-crops-cilds74r/target_005.pgm | data-evidence | 灰度像素图 | 已纳入Git（含暂存） | 保存target_005的目标ROI裁剪；其合成/文件/实机来源及框/标签含义以data/evidence/2026-10-03-arm-localize-baseline/arm-board-final/arm_localize/README.md为准。 | 目录/格式与邻接文件 | 2 | 所在目录说明：data/evidence/2026-10-03-arm-localize-baseline/arm-board-final/arm_localize/README.md 同名配套文件：data/evidence/2026-10-03-arm-localize-baseline/arm-board-final/arm_localize/benchmark/run-1p9nq39b/720p_six/sample-01-crops-cilds74r/target_005.hex
data/evidence/2026-10-03-arm-localize-baseline/arm-board-final/arm_localize/benchmark/run-1p9nq39b/720p_six/sample-01.json | data-evidence | 结构化结果/元数据 | 已纳入Git（含暂存） | 保存sample-01的实验结果或检查产物，字段包括frame_id、config_id、width、height、status、targets、schema_version；与data/evidence/2026-10-03-arm-localize-baseline/arm-board-final/arm_localize/README.md中的生成/校验流程一起使用。 | 目录/格式与邻接文件 | 2 | 所在目录说明：data/evidence/2026-10-03-arm-localize-baseline/arm-board-final/arm_localize/README.md 同目录输入/元数据：data/evidence/2026-10-03-arm-localize-baseline/arm-board-final/arm_localize/benchmark/run-1p9nq39b/720p_six/input.json
data/evidence/2026-10-03-arm-localize-baseline/arm-board-final/arm_localize/benchmark/run-1p9nq39b/720p_six/sample-02-crops-1fpbzr_6/target_000.hex | data-evidence | 十六进制数据 | 已纳入Git（含暂存） | 以十六进制数据形式保存target_000的目标ROI像素；由对应加载器/testbench读取，位宽、排布和端序按data/evidence/2026-10-03-arm-localize-baseline/arm-board-final/arm_localize/README.md核对。 | 目录/格式与邻接文件 | 2 | 所在目录说明：data/evidence/2026-10-03-arm-localize-baseline/arm-board-final/arm_localize/README.md 同名配套文件：data/evidence/2026-10-03-arm-localize-baseline/arm-board-final/arm_localize/benchmark/run-1p9nq39b/720p_six/sample-02-crops-1fpbzr_6/target_000.pgm
data/evidence/2026-10-03-arm-localize-baseline/arm-board-final/arm_localize/benchmark/run-1p9nq39b/720p_six/sample-02-crops-1fpbzr_6/target_000.pgm | data-evidence | 灰度像素图 | 已纳入Git（含暂存） | 保存target_000的目标ROI裁剪；其合成/文件/实机来源及框/标签含义以data/evidence/2026-10-03-arm-localize-baseline/arm-board-final/arm_localize/README.md为准。 | 目录/格式与邻接文件 | 2 | 所在目录说明：data/evidence/2026-10-03-arm-localize-baseline/arm-board-final/arm_localize/README.md 同名配套文件：data/evidence/2026-10-03-arm-localize-baseline/arm-board-final/arm_localize/benchmark/run-1p9nq39b/720p_six/sample-02-crops-1fpbzr_6/target_000.hex
data/evidence/2026-10-03-arm-localize-baseline/arm-board-final/arm_localize/benchmark/run-1p9nq39b/720p_six/sample-02-crops-1fpbzr_6/target_001.hex | data-evidence | 十六进制数据 | 已纳入Git（含暂存） | 以十六进制数据形式保存target_001的目标ROI像素；由对应加载器/testbench读取，位宽、排布和端序按data/evidence/2026-10-03-arm-localize-baseline/arm-board-final/arm_localize/README.md核对。 | 目录/格式与邻接文件 | 2 | 所在目录说明：data/evidence/2026-10-03-arm-localize-baseline/arm-board-final/arm_localize/README.md 同名配套文件：data/evidence/2026-10-03-arm-localize-baseline/arm-board-final/arm_localize/benchmark/run-1p9nq39b/720p_six/sample-02-crops-1fpbzr_6/target_001.pgm
data/evidence/2026-10-03-arm-localize-baseline/arm-board-final/arm_localize/benchmark/run-1p9nq39b/720p_six/sample-02-crops-1fpbzr_6/target_001.pgm | data-evidence | 灰度像素图 | 已纳入Git（含暂存） | 保存target_001的目标ROI裁剪；其合成/文件/实机来源及框/标签含义以data/evidence/2026-10-03-arm-localize-baseline/arm-board-final/arm_localize/README.md为准。 | 目录/格式与邻接文件 | 2 | 所在目录说明：data/evidence/2026-10-03-arm-localize-baseline/arm-board-final/arm_localize/README.md 同名配套文件：data/evidence/2026-10-03-arm-localize-baseline/arm-board-final/arm_localize/benchmark/run-1p9nq39b/720p_six/sample-02-crops-1fpbzr_6/target_001.hex
data/evidence/2026-10-03-arm-localize-baseline/arm-board-final/arm_localize/benchmark/run-1p9nq39b/720p_six/sample-02-crops-1fpbzr_6/target_002.hex | data-evidence | 十六进制数据 | 已纳入Git（含暂存） | 以十六进制数据形式保存target_002的目标ROI像素；由对应加载器/testbench读取，位宽、排布和端序按data/evidence/2026-10-03-arm-localize-baseline/arm-board-final/arm_localize/README.md核对。 | 目录/格式与邻接文件 | 2 | 所在目录说明：data/evidence/2026-10-03-arm-localize-baseline/arm-board-final/arm_localize/README.md 同名配套文件：data/evidence/2026-10-03-arm-localize-baseline/arm-board-final/arm_localize/benchmark/run-1p9nq39b/720p_six/sample-02-crops-1fpbzr_6/target_002.pgm
data/evidence/2026-10-03-arm-localize-baseline/arm-board-final/arm_localize/benchmark/run-1p9nq39b/720p_six/sample-02-crops-1fpbzr_6/target_002.pgm | data-evidence | 灰度像素图 | 已纳入Git（含暂存） | 保存target_002的目标ROI裁剪；其合成/文件/实机来源及框/标签含义以data/evidence/2026-10-03-arm-localize-baseline/arm-board-final/arm_localize/README.md为准。 | 目录/格式与邻接文件 | 2 | 所在目录说明：data/evidence/2026-10-03-arm-localize-baseline/arm-board-final/arm_localize/README.md 同名配套文件：data/evidence/2026-10-03-arm-localize-baseline/arm-board-final/arm_localize/benchmark/run-1p9nq39b/720p_six/sample-02-crops-1fpbzr_6/target_002.hex
data/evidence/2026-10-03-arm-localize-baseline/arm-board-final/arm_localize/benchmark/run-1p9nq39b/720p_six/sample-02-crops-1fpbzr_6/target_003.hex | data-evidence | 十六进制数据 | 已纳入Git（含暂存） | 以十六进制数据形式保存target_003的目标ROI像素；由对应加载器/testbench读取，位宽、排布和端序按data/evidence/2026-10-03-arm-localize-baseline/arm-board-final/arm_localize/README.md核对。 | 目录/格式与邻接文件 | 2 | 所在目录说明：data/evidence/2026-10-03-arm-localize-baseline/arm-board-final/arm_localize/README.md 同名配套文件：data/evidence/2026-10-03-arm-localize-baseline/arm-board-final/arm_localize/benchmark/run-1p9nq39b/720p_six/sample-02-crops-1fpbzr_6/target_003.pgm
data/evidence/2026-10-03-arm-localize-baseline/arm-board-final/arm_localize/benchmark/run-1p9nq39b/720p_six/sample-02-crops-1fpbzr_6/target_003.pgm | data-evidence | 灰度像素图 | 已纳入Git（含暂存） | 保存target_003的目标ROI裁剪；其合成/文件/实机来源及框/标签含义以data/evidence/2026-10-03-arm-localize-baseline/arm-board-final/arm_localize/README.md为准。 | 目录/格式与邻接文件 | 2 | 所在目录说明：data/evidence/2026-10-03-arm-localize-baseline/arm-board-final/arm_localize/README.md 同名配套文件：data/evidence/2026-10-03-arm-localize-baseline/arm-board-final/arm_localize/benchmark/run-1p9nq39b/720p_six/sample-02-crops-1fpbzr_6/target_003.hex
data/evidence/2026-10-03-arm-localize-baseline/arm-board-final/arm_localize/benchmark/run-1p9nq39b/720p_six/sample-02-crops-1fpbzr_6/target_004.hex | data-evidence | 十六进制数据 | 已纳入Git（含暂存） | 以十六进制数据形式保存target_004的目标ROI像素；由对应加载器/testbench读取，位宽、排布和端序按data/evidence/2026-10-03-arm-localize-baseline/arm-board-final/arm_localize/README.md核对。 | 目录/格式与邻接文件 | 2 | 所在目录说明：data/evidence/2026-10-03-arm-localize-baseline/arm-board-final/arm_localize/README.md 同名配套文件：data/evidence/2026-10-03-arm-localize-baseline/arm-board-final/arm_localize/benchmark/run-1p9nq39b/720p_six/sample-02-crops-1fpbzr_6/target_004.pgm
data/evidence/2026-10-03-arm-localize-baseline/arm-board-final/arm_localize/benchmark/run-1p9nq39b/720p_six/sample-02-crops-1fpbzr_6/target_004.pgm | data-evidence | 灰度像素图 | 已纳入Git（含暂存） | 保存target_004的目标ROI裁剪；其合成/文件/实机来源及框/标签含义以data/evidence/2026-10-03-arm-localize-baseline/arm-board-final/arm_localize/README.md为准。 | 目录/格式与邻接文件 | 2 | 所在目录说明：data/evidence/2026-10-03-arm-localize-baseline/arm-board-final/arm_localize/README.md 同名配套文件：data/evidence/2026-10-03-arm-localize-baseline/arm-board-final/arm_localize/benchmark/run-1p9nq39b/720p_six/sample-02-crops-1fpbzr_6/target_004.hex
data/evidence/2026-10-03-arm-localize-baseline/arm-board-final/arm_localize/benchmark/run-1p9nq39b/720p_six/sample-02-crops-1fpbzr_6/target_005.hex | data-evidence | 十六进制数据 | 已纳入Git（含暂存） | 以十六进制数据形式保存target_005的目标ROI像素；由对应加载器/testbench读取，位宽、排布和端序按data/evidence/2026-10-03-arm-localize-baseline/arm-board-final/arm_localize/README.md核对。 | 目录/格式与邻接文件 | 2 | 所在目录说明：data/evidence/2026-10-03-arm-localize-baseline/arm-board-final/arm_localize/README.md 同名配套文件：data/evidence/2026-10-03-arm-localize-baseline/arm-board-final/arm_localize/benchmark/run-1p9nq39b/720p_six/sample-02-crops-1fpbzr_6/target_005.pgm
data/evidence/2026-10-03-arm-localize-baseline/arm-board-final/arm_localize/benchmark/run-1p9nq39b/720p_six/sample-02-crops-1fpbzr_6/target_005.pgm | data-evidence | 灰度像素图 | 已纳入Git（含暂存） | 保存target_005的目标ROI裁剪；其合成/文件/实机来源及框/标签含义以data/evidence/2026-10-03-arm-localize-baseline/arm-board-final/arm_localize/README.md为准。 | 目录/格式与邻接文件 | 2 | 所在目录说明：data/evidence/2026-10-03-arm-localize-baseline/arm-board-final/arm_localize/README.md 同名配套文件：data/evidence/2026-10-03-arm-localize-baseline/arm-board-final/arm_localize/benchmark/run-1p9nq39b/720p_six/sample-02-crops-1fpbzr_6/target_005.hex
data/evidence/2026-10-03-arm-localize-baseline/arm-board-final/arm_localize/benchmark/run-1p9nq39b/720p_six/sample-02.json | data-evidence | 结构化结果/元数据 | 已纳入Git（含暂存） | 保存sample-02的实验结果或检查产物，字段包括frame_id、config_id、width、height、status、targets、schema_version；与data/evidence/2026-10-03-arm-localize-baseline/arm-board-final/arm_localize/README.md中的生成/校验流程一起使用。 | 目录/格式与邻接文件 | 2 | 所在目录说明：data/evidence/2026-10-03-arm-localize-baseline/arm-board-final/arm_localize/README.md 同目录输入/元数据：data/evidence/2026-10-03-arm-localize-baseline/arm-board-final/arm_localize/benchmark/run-1p9nq39b/720p_six/input.json
data/evidence/2026-10-03-arm-localize-baseline/arm-board-final/arm_localize/benchmark/run-1p9nq39b/720p_six/sample-03-crops-sf35kw5c/target_000.hex | data-evidence | 十六进制数据 | 已纳入Git（含暂存） | 以十六进制数据形式保存target_000的目标ROI像素；由对应加载器/testbench读取，位宽、排布和端序按data/evidence/2026-10-03-arm-localize-baseline/arm-board-final/arm_localize/README.md核对。 | 目录/格式与邻接文件 | 2 | 所在目录说明：data/evidence/2026-10-03-arm-localize-baseline/arm-board-final/arm_localize/README.md 同名配套文件：data/evidence/2026-10-03-arm-localize-baseline/arm-board-final/arm_localize/benchmark/run-1p9nq39b/720p_six/sample-03-crops-sf35kw5c/target_000.pgm
data/evidence/2026-10-03-arm-localize-baseline/arm-board-final/arm_localize/benchmark/run-1p9nq39b/720p_six/sample-03-crops-sf35kw5c/target_000.pgm | data-evidence | 灰度像素图 | 已纳入Git（含暂存） | 保存target_000的目标ROI裁剪；其合成/文件/实机来源及框/标签含义以data/evidence/2026-10-03-arm-localize-baseline/arm-board-final/arm_localize/README.md为准。 | 目录/格式与邻接文件 | 2 | 所在目录说明：data/evidence/2026-10-03-arm-localize-baseline/arm-board-final/arm_localize/README.md 同名配套文件：data/evidence/2026-10-03-arm-localize-baseline/arm-board-final/arm_localize/benchmark/run-1p9nq39b/720p_six/sample-03-crops-sf35kw5c/target_000.hex
data/evidence/2026-10-03-arm-localize-baseline/arm-board-final/arm_localize/benchmark/run-1p9nq39b/720p_six/sample-03-crops-sf35kw5c/target_001.hex | data-evidence | 十六进制数据 | 已纳入Git（含暂存） | 以十六进制数据形式保存target_001的目标ROI像素；由对应加载器/testbench读取，位宽、排布和端序按data/evidence/2026-10-03-arm-localize-baseline/arm-board-final/arm_localize/README.md核对。 | 目录/格式与邻接文件 | 2 | 所在目录说明：data/evidence/2026-10-03-arm-localize-baseline/arm-board-final/arm_localize/README.md 同名配套文件：data/evidence/2026-10-03-arm-localize-baseline/arm-board-final/arm_localize/benchmark/run-1p9nq39b/720p_six/sample-03-crops-sf35kw5c/target_001.pgm
data/evidence/2026-10-03-arm-localize-baseline/arm-board-final/arm_localize/benchmark/run-1p9nq39b/720p_six/sample-03-crops-sf35kw5c/target_001.pgm | data-evidence | 灰度像素图 | 已纳入Git（含暂存） | 保存target_001的目标ROI裁剪；其合成/文件/实机来源及框/标签含义以data/evidence/2026-10-03-arm-localize-baseline/arm-board-final/arm_localize/README.md为准。 | 目录/格式与邻接文件 | 2 | 所在目录说明：data/evidence/2026-10-03-arm-localize-baseline/arm-board-final/arm_localize/README.md 同名配套文件：data/evidence/2026-10-03-arm-localize-baseline/arm-board-final/arm_localize/benchmark/run-1p9nq39b/720p_six/sample-03-crops-sf35kw5c/target_001.hex
data/evidence/2026-10-03-arm-localize-baseline/arm-board-final/arm_localize/benchmark/run-1p9nq39b/720p_six/sample-03-crops-sf35kw5c/target_002.hex | data-evidence | 十六进制数据 | 已纳入Git（含暂存） | 以十六进制数据形式保存target_002的目标ROI像素；由对应加载器/testbench读取，位宽、排布和端序按data/evidence/2026-10-03-arm-localize-baseline/arm-board-final/arm_localize/README.md核对。 | 目录/格式与邻接文件 | 2 | 所在目录说明：data/evidence/2026-10-03-arm-localize-baseline/arm-board-final/arm_localize/README.md 同名配套文件：data/evidence/2026-10-03-arm-localize-baseline/arm-board-final/arm_localize/benchmark/run-1p9nq39b/720p_six/sample-03-crops-sf35kw5c/target_002.pgm
data/evidence/2026-10-03-arm-localize-baseline/arm-board-final/arm_localize/benchmark/run-1p9nq39b/720p_six/sample-03-crops-sf35kw5c/target_002.pgm | data-evidence | 灰度像素图 | 已纳入Git（含暂存） | 保存target_002的目标ROI裁剪；其合成/文件/实机来源及框/标签含义以data/evidence/2026-10-03-arm-localize-baseline/arm-board-final/arm_localize/README.md为准。 | 目录/格式与邻接文件 | 2 | 所在目录说明：data/evidence/2026-10-03-arm-localize-baseline/arm-board-final/arm_localize/README.md 同名配套文件：data/evidence/2026-10-03-arm-localize-baseline/arm-board-final/arm_localize/benchmark/run-1p9nq39b/720p_six/sample-03-crops-sf35kw5c/target_002.hex
data/evidence/2026-10-03-arm-localize-baseline/arm-board-final/arm_localize/benchmark/run-1p9nq39b/720p_six/sample-03-crops-sf35kw5c/target_003.hex | data-evidence | 十六进制数据 | 已纳入Git（含暂存） | 以十六进制数据形式保存target_003的目标ROI像素；由对应加载器/testbench读取，位宽、排布和端序按data/evidence/2026-10-03-arm-localize-baseline/arm-board-final/arm_localize/README.md核对。 | 目录/格式与邻接文件 | 2 | 所在目录说明：data/evidence/2026-10-03-arm-localize-baseline/arm-board-final/arm_localize/README.md 同名配套文件：data/evidence/2026-10-03-arm-localize-baseline/arm-board-final/arm_localize/benchmark/run-1p9nq39b/720p_six/sample-03-crops-sf35kw5c/target_003.pgm
data/evidence/2026-10-03-arm-localize-baseline/arm-board-final/arm_localize/benchmark/run-1p9nq39b/720p_six/sample-03-crops-sf35kw5c/target_003.pgm | data-evidence | 灰度像素图 | 已纳入Git（含暂存） | 保存target_003的目标ROI裁剪；其合成/文件/实机来源及框/标签含义以data/evidence/2026-10-03-arm-localize-baseline/arm-board-final/arm_localize/README.md为准。 | 目录/格式与邻接文件 | 2 | 所在目录说明：data/evidence/2026-10-03-arm-localize-baseline/arm-board-final/arm_localize/README.md 同名配套文件：data/evidence/2026-10-03-arm-localize-baseline/arm-board-final/arm_localize/benchmark/run-1p9nq39b/720p_six/sample-03-crops-sf35kw5c/target_003.hex
data/evidence/2026-10-03-arm-localize-baseline/arm-board-final/arm_localize/benchmark/run-1p9nq39b/720p_six/sample-03-crops-sf35kw5c/target_004.hex | data-evidence | 十六进制数据 | 已纳入Git（含暂存） | 以十六进制数据形式保存target_004的目标ROI像素；由对应加载器/testbench读取，位宽、排布和端序按data/evidence/2026-10-03-arm-localize-baseline/arm-board-final/arm_localize/README.md核对。 | 目录/格式与邻接文件 | 2 | 所在目录说明：data/evidence/2026-10-03-arm-localize-baseline/arm-board-final/arm_localize/README.md 同名配套文件：data/evidence/2026-10-03-arm-localize-baseline/arm-board-final/arm_localize/benchmark/run-1p9nq39b/720p_six/sample-03-crops-sf35kw5c/target_004.pgm
data/evidence/2026-10-03-arm-localize-baseline/arm-board-final/arm_localize/benchmark/run-1p9nq39b/720p_six/sample-03-crops-sf35kw5c/target_004.pgm | data-evidence | 灰度像素图 | 已纳入Git（含暂存） | 保存target_004的目标ROI裁剪；其合成/文件/实机来源及框/标签含义以data/evidence/2026-10-03-arm-localize-baseline/arm-board-final/arm_localize/README.md为准。 | 目录/格式与邻接文件 | 2 | 所在目录说明：data/evidence/2026-10-03-arm-localize-baseline/arm-board-final/arm_localize/README.md 同名配套文件：data/evidence/2026-10-03-arm-localize-baseline/arm-board-final/arm_localize/benchmark/run-1p9nq39b/720p_six/sample-03-crops-sf35kw5c/target_004.hex
data/evidence/2026-10-03-arm-localize-baseline/arm-board-final/arm_localize/benchmark/run-1p9nq39b/720p_six/sample-03-crops-sf35kw5c/target_005.hex | data-evidence | 十六进制数据 | 已纳入Git（含暂存） | 以十六进制数据形式保存target_005的目标ROI像素；由对应加载器/testbench读取，位宽、排布和端序按data/evidence/2026-10-03-arm-localize-baseline/arm-board-final/arm_localize/README.md核对。 | 目录/格式与邻接文件 | 2 | 所在目录说明：data/evidence/2026-10-03-arm-localize-baseline/arm-board-final/arm_localize/README.md 同名配套文件：data/evidence/2026-10-03-arm-localize-baseline/arm-board-final/arm_localize/benchmark/run-1p9nq39b/720p_six/sample-03-crops-sf35kw5c/target_005.pgm
data/evidence/2026-10-03-arm-localize-baseline/arm-board-final/arm_localize/benchmark/run-1p9nq39b/720p_six/sample-03-crops-sf35kw5c/target_005.pgm | data-evidence | 灰度像素图 | 已纳入Git（含暂存） | 保存target_005的目标ROI裁剪；其合成/文件/实机来源及框/标签含义以data/evidence/2026-10-03-arm-localize-baseline/arm-board-final/arm_localize/README.md为准。 | 目录/格式与邻接文件 | 2 | 所在目录说明：data/evidence/2026-10-03-arm-localize-baseline/arm-board-final/arm_localize/README.md 同名配套文件：data/evidence/2026-10-03-arm-localize-baseline/arm-board-final/arm_localize/benchmark/run-1p9nq39b/720p_six/sample-03-crops-sf35kw5c/target_005.hex
data/evidence/2026-10-03-arm-localize-baseline/arm-board-final/arm_localize/benchmark/run-1p9nq39b/720p_six/sample-03.json | data-evidence | 结构化结果/元数据 | 已纳入Git（含暂存） | 保存sample-03的实验结果或检查产物，字段包括frame_id、config_id、width、height、status、targets、schema_version；与data/evidence/2026-10-03-arm-localize-baseline/arm-board-final/arm_localize/README.md中的生成/校验流程一起使用。 | 目录/格式与邻接文件 | 2 | 所在目录说明：data/evidence/2026-10-03-arm-localize-baseline/arm-board-final/arm_localize/README.md 同目录输入/元数据：data/evidence/2026-10-03-arm-localize-baseline/arm-board-final/arm_localize/benchmark/run-1p9nq39b/720p_six/input.json
data/evidence/2026-10-03-arm-localize-baseline/arm-board-final/arm_localize/benchmark/run-1p9nq39b/720p_six/sample-04-crops-avmbv2uo/target_000.hex | data-evidence | 十六进制数据 | 已纳入Git（含暂存） | 以十六进制数据形式保存target_000的目标ROI像素；由对应加载器/testbench读取，位宽、排布和端序按data/evidence/2026-10-03-arm-localize-baseline/arm-board-final/arm_localize/README.md核对。 | 目录/格式与邻接文件 | 2 | 所在目录说明：data/evidence/2026-10-03-arm-localize-baseline/arm-board-final/arm_localize/README.md 同名配套文件：data/evidence/2026-10-03-arm-localize-baseline/arm-board-final/arm_localize/benchmark/run-1p9nq39b/720p_six/sample-04-crops-avmbv2uo/target_000.pgm
data/evidence/2026-10-03-arm-localize-baseline/arm-board-final/arm_localize/benchmark/run-1p9nq39b/720p_six/sample-04-crops-avmbv2uo/target_000.pgm | data-evidence | 灰度像素图 | 已纳入Git（含暂存） | 保存target_000的目标ROI裁剪；其合成/文件/实机来源及框/标签含义以data/evidence/2026-10-03-arm-localize-baseline/arm-board-final/arm_localize/README.md为准。 | 目录/格式与邻接文件 | 2 | 所在目录说明：data/evidence/2026-10-03-arm-localize-baseline/arm-board-final/arm_localize/README.md 同名配套文件：data/evidence/2026-10-03-arm-localize-baseline/arm-board-final/arm_localize/benchmark/run-1p9nq39b/720p_six/sample-04-crops-avmbv2uo/target_000.hex
data/evidence/2026-10-03-arm-localize-baseline/arm-board-final/arm_localize/benchmark/run-1p9nq39b/720p_six/sample-04-crops-avmbv2uo/target_001.hex | data-evidence | 十六进制数据 | 已纳入Git（含暂存） | 以十六进制数据形式保存target_001的目标ROI像素；由对应加载器/testbench读取，位宽、排布和端序按data/evidence/2026-10-03-arm-localize-baseline/arm-board-final/arm_localize/README.md核对。 | 目录/格式与邻接文件 | 2 | 所在目录说明：data/evidence/2026-10-03-arm-localize-baseline/arm-board-final/arm_localize/README.md 同名配套文件：data/evidence/2026-10-03-arm-localize-baseline/arm-board-final/arm_localize/benchmark/run-1p9nq39b/720p_six/sample-04-crops-avmbv2uo/target_001.pgm
data/evidence/2026-10-03-arm-localize-baseline/arm-board-final/arm_localize/benchmark/run-1p9nq39b/720p_six/sample-04-crops-avmbv2uo/target_001.pgm | data-evidence | 灰度像素图 | 已纳入Git（含暂存） | 保存target_001的目标ROI裁剪；其合成/文件/实机来源及框/标签含义以data/evidence/2026-10-03-arm-localize-baseline/arm-board-final/arm_localize/README.md为准。 | 目录/格式与邻接文件 | 2 | 所在目录说明：data/evidence/2026-10-03-arm-localize-baseline/arm-board-final/arm_localize/README.md 同名配套文件：data/evidence/2026-10-03-arm-localize-baseline/arm-board-final/arm_localize/benchmark/run-1p9nq39b/720p_six/sample-04-crops-avmbv2uo/target_001.hex
data/evidence/2026-10-03-arm-localize-baseline/arm-board-final/arm_localize/benchmark/run-1p9nq39b/720p_six/sample-04-crops-avmbv2uo/target_002.hex | data-evidence | 十六进制数据 | 已纳入Git（含暂存） | 以十六进制数据形式保存target_002的目标ROI像素；由对应加载器/testbench读取，位宽、排布和端序按data/evidence/2026-10-03-arm-localize-baseline/arm-board-final/arm_localize/README.md核对。 | 目录/格式与邻接文件 | 2 | 所在目录说明：data/evidence/2026-10-03-arm-localize-baseline/arm-board-final/arm_localize/README.md 同名配套文件：data/evidence/2026-10-03-arm-localize-baseline/arm-board-final/arm_localize/benchmark/run-1p9nq39b/720p_six/sample-04-crops-avmbv2uo/target_002.pgm
data/evidence/2026-10-03-arm-localize-baseline/arm-board-final/arm_localize/benchmark/run-1p9nq39b/720p_six/sample-04-crops-avmbv2uo/target_002.pgm | data-evidence | 灰度像素图 | 已纳入Git（含暂存） | 保存target_002的目标ROI裁剪；其合成/文件/实机来源及框/标签含义以data/evidence/2026-10-03-arm-localize-baseline/arm-board-final/arm_localize/README.md为准。 | 目录/格式与邻接文件 | 2 | 所在目录说明：data/evidence/2026-10-03-arm-localize-baseline/arm-board-final/arm_localize/README.md 同名配套文件：data/evidence/2026-10-03-arm-localize-baseline/arm-board-final/arm_localize/benchmark/run-1p9nq39b/720p_six/sample-04-crops-avmbv2uo/target_002.hex
data/evidence/2026-10-03-arm-localize-baseline/arm-board-final/arm_localize/benchmark/run-1p9nq39b/720p_six/sample-04-crops-avmbv2uo/target_003.hex | data-evidence | 十六进制数据 | 已纳入Git（含暂存） | 以十六进制数据形式保存target_003的目标ROI像素；由对应加载器/testbench读取，位宽、排布和端序按data/evidence/2026-10-03-arm-localize-baseline/arm-board-final/arm_localize/README.md核对。 | 目录/格式与邻接文件 | 2 | 所在目录说明：data/evidence/2026-10-03-arm-localize-baseline/arm-board-final/arm_localize/README.md 同名配套文件：data/evidence/2026-10-03-arm-localize-baseline/arm-board-final/arm_localize/benchmark/run-1p9nq39b/720p_six/sample-04-crops-avmbv2uo/target_003.pgm
data/evidence/2026-10-03-arm-localize-baseline/arm-board-final/arm_localize/benchmark/run-1p9nq39b/720p_six/sample-04-crops-avmbv2uo/target_003.pgm | data-evidence | 灰度像素图 | 已纳入Git（含暂存） | 保存target_003的目标ROI裁剪；其合成/文件/实机来源及框/标签含义以data/evidence/2026-10-03-arm-localize-baseline/arm-board-final/arm_localize/README.md为准。 | 目录/格式与邻接文件 | 2 | 所在目录说明：data/evidence/2026-10-03-arm-localize-baseline/arm-board-final/arm_localize/README.md 同名配套文件：data/evidence/2026-10-03-arm-localize-baseline/arm-board-final/arm_localize/benchmark/run-1p9nq39b/720p_six/sample-04-crops-avmbv2uo/target_003.hex
data/evidence/2026-10-03-arm-localize-baseline/arm-board-final/arm_localize/benchmark/run-1p9nq39b/720p_six/sample-04-crops-avmbv2uo/target_004.hex | data-evidence | 十六进制数据 | 已纳入Git（含暂存） | 以十六进制数据形式保存target_004的目标ROI像素；由对应加载器/testbench读取，位宽、排布和端序按data/evidence/2026-10-03-arm-localize-baseline/arm-board-final/arm_localize/README.md核对。 | 目录/格式与邻接文件 | 2 | 所在目录说明：data/evidence/2026-10-03-arm-localize-baseline/arm-board-final/arm_localize/README.md 同名配套文件：data/evidence/2026-10-03-arm-localize-baseline/arm-board-final/arm_localize/benchmark/run-1p9nq39b/720p_six/sample-04-crops-avmbv2uo/target_004.pgm
data/evidence/2026-10-03-arm-localize-baseline/arm-board-final/arm_localize/benchmark/run-1p9nq39b/720p_six/sample-04-crops-avmbv2uo/target_004.pgm | data-evidence | 灰度像素图 | 已纳入Git（含暂存） | 保存target_004的目标ROI裁剪；其合成/文件/实机来源及框/标签含义以data/evidence/2026-10-03-arm-localize-baseline/arm-board-final/arm_localize/README.md为准。 | 目录/格式与邻接文件 | 2 | 所在目录说明：data/evidence/2026-10-03-arm-localize-baseline/arm-board-final/arm_localize/README.md 同名配套文件：data/evidence/2026-10-03-arm-localize-baseline/arm-board-final/arm_localize/benchmark/run-1p9nq39b/720p_six/sample-04-crops-avmbv2uo/target_004.hex
data/evidence/2026-10-03-arm-localize-baseline/arm-board-final/arm_localize/benchmark/run-1p9nq39b/720p_six/sample-04-crops-avmbv2uo/target_005.hex | data-evidence | 十六进制数据 | 已纳入Git（含暂存） | 以十六进制数据形式保存target_005的目标ROI像素；由对应加载器/testbench读取，位宽、排布和端序按data/evidence/2026-10-03-arm-localize-baseline/arm-board-final/arm_localize/README.md核对。 | 目录/格式与邻接文件 | 2 | 所在目录说明：data/evidence/2026-10-03-arm-localize-baseline/arm-board-final/arm_localize/README.md 同名配套文件：data/evidence/2026-10-03-arm-localize-baseline/arm-board-final/arm_localize/benchmark/run-1p9nq39b/720p_six/sample-04-crops-avmbv2uo/target_005.pgm
data/evidence/2026-10-03-arm-localize-baseline/arm-board-final/arm_localize/benchmark/run-1p9nq39b/720p_six/sample-04-crops-avmbv2uo/target_005.pgm | data-evidence | 灰度像素图 | 已纳入Git（含暂存） | 保存target_005的目标ROI裁剪；其合成/文件/实机来源及框/标签含义以data/evidence/2026-10-03-arm-localize-baseline/arm-board-final/arm_localize/README.md为准。 | 目录/格式与邻接文件 | 2 | 所在目录说明：data/evidence/2026-10-03-arm-localize-baseline/arm-board-final/arm_localize/README.md 同名配套文件：data/evidence/2026-10-03-arm-localize-baseline/arm-board-final/arm_localize/benchmark/run-1p9nq39b/720p_six/sample-04-crops-avmbv2uo/target_005.hex
data/evidence/2026-10-03-arm-localize-baseline/arm-board-final/arm_localize/benchmark/run-1p9nq39b/720p_six/sample-04.json | data-evidence | 结构化结果/元数据 | 已纳入Git（含暂存） | 保存sample-04的实验结果或检查产物，字段包括frame_id、config_id、width、height、status、targets、schema_version；与data/evidence/2026-10-03-arm-localize-baseline/arm-board-final/arm_localize/README.md中的生成/校验流程一起使用。 | 目录/格式与邻接文件 | 2 | 所在目录说明：data/evidence/2026-10-03-arm-localize-baseline/arm-board-final/arm_localize/README.md 同目录输入/元数据：data/evidence/2026-10-03-arm-localize-baseline/arm-board-final/arm_localize/benchmark/run-1p9nq39b/720p_six/input.json
data/evidence/2026-10-03-arm-localize-baseline/arm-board-final/arm_localize/benchmark/run-1p9nq39b/720p_six/warmup-00-crops-ut4gj2zo/target_000.hex | data-evidence | 十六进制数据 | 已纳入Git（含暂存） | 以十六进制数据形式保存target_000的目标ROI像素；由对应加载器/testbench读取，位宽、排布和端序按data/evidence/2026-10-03-arm-localize-baseline/arm-board-final/arm_localize/README.md核对。 | 目录/格式与邻接文件 | 2 | 所在目录说明：data/evidence/2026-10-03-arm-localize-baseline/arm-board-final/arm_localize/README.md 同名配套文件：data/evidence/2026-10-03-arm-localize-baseline/arm-board-final/arm_localize/benchmark/run-1p9nq39b/720p_six/warmup-00-crops-ut4gj2zo/target_000.pgm
data/evidence/2026-10-03-arm-localize-baseline/arm-board-final/arm_localize/benchmark/run-1p9nq39b/720p_six/warmup-00-crops-ut4gj2zo/target_000.pgm | data-evidence | 灰度像素图 | 已纳入Git（含暂存） | 保存target_000的目标ROI裁剪；其合成/文件/实机来源及框/标签含义以data/evidence/2026-10-03-arm-localize-baseline/arm-board-final/arm_localize/README.md为准。 | 目录/格式与邻接文件 | 2 | 所在目录说明：data/evidence/2026-10-03-arm-localize-baseline/arm-board-final/arm_localize/README.md 同名配套文件：data/evidence/2026-10-03-arm-localize-baseline/arm-board-final/arm_localize/benchmark/run-1p9nq39b/720p_six/warmup-00-crops-ut4gj2zo/target_000.hex
data/evidence/2026-10-03-arm-localize-baseline/arm-board-final/arm_localize/benchmark/run-1p9nq39b/720p_six/warmup-00-crops-ut4gj2zo/target_001.hex | data-evidence | 十六进制数据 | 已纳入Git（含暂存） | 以十六进制数据形式保存target_001的目标ROI像素；由对应加载器/testbench读取，位宽、排布和端序按data/evidence/2026-10-03-arm-localize-baseline/arm-board-final/arm_localize/README.md核对。 | 目录/格式与邻接文件 | 2 | 所在目录说明：data/evidence/2026-10-03-arm-localize-baseline/arm-board-final/arm_localize/README.md 同名配套文件：data/evidence/2026-10-03-arm-localize-baseline/arm-board-final/arm_localize/benchmark/run-1p9nq39b/720p_six/warmup-00-crops-ut4gj2zo/target_001.pgm
data/evidence/2026-10-03-arm-localize-baseline/arm-board-final/arm_localize/benchmark/run-1p9nq39b/720p_six/warmup-00-crops-ut4gj2zo/target_001.pgm | data-evidence | 灰度像素图 | 已纳入Git（含暂存） | 保存target_001的目标ROI裁剪；其合成/文件/实机来源及框/标签含义以data/evidence/2026-10-03-arm-localize-baseline/arm-board-final/arm_localize/README.md为准。 | 目录/格式与邻接文件 | 2 | 所在目录说明：data/evidence/2026-10-03-arm-localize-baseline/arm-board-final/arm_localize/README.md 同名配套文件：data/evidence/2026-10-03-arm-localize-baseline/arm-board-final/arm_localize/benchmark/run-1p9nq39b/720p_six/warmup-00-crops-ut4gj2zo/target_001.hex
data/evidence/2026-10-03-arm-localize-baseline/arm-board-final/arm_localize/benchmark/run-1p9nq39b/720p_six/warmup-00-crops-ut4gj2zo/target_002.hex | data-evidence | 十六进制数据 | 已纳入Git（含暂存） | 以十六进制数据形式保存target_002的目标ROI像素；由对应加载器/testbench读取，位宽、排布和端序按data/evidence/2026-10-03-arm-localize-baseline/arm-board-final/arm_localize/README.md核对。 | 目录/格式与邻接文件 | 2 | 所在目录说明：data/evidence/2026-10-03-arm-localize-baseline/arm-board-final/arm_localize/README.md 同名配套文件：data/evidence/2026-10-03-arm-localize-baseline/arm-board-final/arm_localize/benchmark/run-1p9nq39b/720p_six/warmup-00-crops-ut4gj2zo/target_002.pgm
data/evidence/2026-10-03-arm-localize-baseline/arm-board-final/arm_localize/benchmark/run-1p9nq39b/720p_six/warmup-00-crops-ut4gj2zo/target_002.pgm | data-evidence | 灰度像素图 | 已纳入Git（含暂存） | 保存target_002的目标ROI裁剪；其合成/文件/实机来源及框/标签含义以data/evidence/2026-10-03-arm-localize-baseline/arm-board-final/arm_localize/README.md为准。 | 目录/格式与邻接文件 | 2 | 所在目录说明：data/evidence/2026-10-03-arm-localize-baseline/arm-board-final/arm_localize/README.md 同名配套文件：data/evidence/2026-10-03-arm-localize-baseline/arm-board-final/arm_localize/benchmark/run-1p9nq39b/720p_six/warmup-00-crops-ut4gj2zo/target_002.hex
data/evidence/2026-10-03-arm-localize-baseline/arm-board-final/arm_localize/benchmark/run-1p9nq39b/720p_six/warmup-00-crops-ut4gj2zo/target_003.hex | data-evidence | 十六进制数据 | 已纳入Git（含暂存） | 以十六进制数据形式保存target_003的目标ROI像素；由对应加载器/testbench读取，位宽、排布和端序按data/evidence/2026-10-03-arm-localize-baseline/arm-board-final/arm_localize/README.md核对。 | 目录/格式与邻接文件 | 2 | 所在目录说明：data/evidence/2026-10-03-arm-localize-baseline/arm-board-final/arm_localize/README.md 同名配套文件：data/evidence/2026-10-03-arm-localize-baseline/arm-board-final/arm_localize/benchmark/run-1p9nq39b/720p_six/warmup-00-crops-ut4gj2zo/target_003.pgm
data/evidence/2026-10-03-arm-localize-baseline/arm-board-final/arm_localize/benchmark/run-1p9nq39b/720p_six/warmup-00-crops-ut4gj2zo/target_003.pgm | data-evidence | 灰度像素图 | 已纳入Git（含暂存） | 保存target_003的目标ROI裁剪；其合成/文件/实机来源及框/标签含义以data/evidence/2026-10-03-arm-localize-baseline/arm-board-final/arm_localize/README.md为准。 | 目录/格式与邻接文件 | 2 | 所在目录说明：data/evidence/2026-10-03-arm-localize-baseline/arm-board-final/arm_localize/README.md 同名配套文件：data/evidence/2026-10-03-arm-localize-baseline/arm-board-final/arm_localize/benchmark/run-1p9nq39b/720p_six/warmup-00-crops-ut4gj2zo/target_003.hex
data/evidence/2026-10-03-arm-localize-baseline/arm-board-final/arm_localize/benchmark/run-1p9nq39b/720p_six/warmup-00-crops-ut4gj2zo/target_004.hex | data-evidence | 十六进制数据 | 已纳入Git（含暂存） | 以十六进制数据形式保存target_004的目标ROI像素；由对应加载器/testbench读取，位宽、排布和端序按data/evidence/2026-10-03-arm-localize-baseline/arm-board-final/arm_localize/README.md核对。 | 目录/格式与邻接文件 | 2 | 所在目录说明：data/evidence/2026-10-03-arm-localize-baseline/arm-board-final/arm_localize/README.md 同名配套文件：data/evidence/2026-10-03-arm-localize-baseline/arm-board-final/arm_localize/benchmark/run-1p9nq39b/720p_six/warmup-00-crops-ut4gj2zo/target_004.pgm
data/evidence/2026-10-03-arm-localize-baseline/arm-board-final/arm_localize/benchmark/run-1p9nq39b/720p_six/warmup-00-crops-ut4gj2zo/target_004.pgm | data-evidence | 灰度像素图 | 已纳入Git（含暂存） | 保存target_004的目标ROI裁剪；其合成/文件/实机来源及框/标签含义以data/evidence/2026-10-03-arm-localize-baseline/arm-board-final/arm_localize/README.md为准。 | 目录/格式与邻接文件 | 2 | 所在目录说明：data/evidence/2026-10-03-arm-localize-baseline/arm-board-final/arm_localize/README.md 同名配套文件：data/evidence/2026-10-03-arm-localize-baseline/arm-board-final/arm_localize/benchmark/run-1p9nq39b/720p_six/warmup-00-crops-ut4gj2zo/target_004.hex
data/evidence/2026-10-03-arm-localize-baseline/arm-board-final/arm_localize/benchmark/run-1p9nq39b/720p_six/warmup-00-crops-ut4gj2zo/target_005.hex | data-evidence | 十六进制数据 | 已纳入Git（含暂存） | 以十六进制数据形式保存target_005的目标ROI像素；由对应加载器/testbench读取，位宽、排布和端序按data/evidence/2026-10-03-arm-localize-baseline/arm-board-final/arm_localize/README.md核对。 | 目录/格式与邻接文件 | 2 | 所在目录说明：data/evidence/2026-10-03-arm-localize-baseline/arm-board-final/arm_localize/README.md 同名配套文件：data/evidence/2026-10-03-arm-localize-baseline/arm-board-final/arm_localize/benchmark/run-1p9nq39b/720p_six/warmup-00-crops-ut4gj2zo/target_005.pgm
data/evidence/2026-10-03-arm-localize-baseline/arm-board-final/arm_localize/benchmark/run-1p9nq39b/720p_six/warmup-00-crops-ut4gj2zo/target_005.pgm | data-evidence | 灰度像素图 | 已纳入Git（含暂存） | 保存target_005的目标ROI裁剪；其合成/文件/实机来源及框/标签含义以data/evidence/2026-10-03-arm-localize-baseline/arm-board-final/arm_localize/README.md为准。 | 目录/格式与邻接文件 | 2 | 所在目录说明：data/evidence/2026-10-03-arm-localize-baseline/arm-board-final/arm_localize/README.md 同名配套文件：data/evidence/2026-10-03-arm-localize-baseline/arm-board-final/arm_localize/benchmark/run-1p9nq39b/720p_six/warmup-00-crops-ut4gj2zo/target_005.hex
data/evidence/2026-10-03-arm-localize-baseline/arm-board-final/arm_localize/benchmark/run-1p9nq39b/720p_six/warmup-00.json | data-evidence | 结构化结果/元数据 | 已纳入Git（含暂存） | 保存warmup-00的实验结果或检查产物，字段包括frame_id、config_id、width、height、status、targets、schema_version；与data/evidence/2026-10-03-arm-localize-baseline/arm-board-final/arm_localize/README.md中的生成/校验流程一起使用。 | 目录/格式与邻接文件 | 2 | 所在目录说明：data/evidence/2026-10-03-arm-localize-baseline/arm-board-final/arm_localize/README.md 同目录输入/元数据：data/evidence/2026-10-03-arm-localize-baseline/arm-board-final/arm_localize/benchmark/run-1p9nq39b/720p_six/input.json
data/evidence/2026-10-03-arm-localize-baseline/arm-board-final/arm_localize/benchmark/run-1p9nq39b/tiny/input.json | data-evidence | 结构化结果/元数据 | 已纳入Git（含暂存） | 保存input的输入/设备/运行元数据，字段包括pixels；与data/evidence/2026-10-03-arm-localize-baseline/arm-board-final/arm_localize/README.md中的生成/校验流程一起使用。 | 目录/格式与邻接文件 | 1 | 所在目录说明：data/evidence/2026-10-03-arm-localize-baseline/arm-board-final/arm_localize/README.md
data/evidence/2026-10-03-arm-localize-baseline/arm-board-final/arm_localize/benchmark/run-1p9nq39b/tiny/sample-00-crops-8dln4fze/target_000.hex | data-evidence | 十六进制数据 | 已纳入Git（含暂存） | 以十六进制数据形式保存target_000的目标ROI像素；由对应加载器/testbench读取，位宽、排布和端序按data/evidence/2026-10-03-arm-localize-baseline/arm-board-final/arm_localize/README.md核对。 | 目录/格式与邻接文件 | 2 | 所在目录说明：data/evidence/2026-10-03-arm-localize-baseline/arm-board-final/arm_localize/README.md 同名配套文件：data/evidence/2026-10-03-arm-localize-baseline/arm-board-final/arm_localize/benchmark/run-1p9nq39b/tiny/sample-00-crops-8dln4fze/target_000.pgm
data/evidence/2026-10-03-arm-localize-baseline/arm-board-final/arm_localize/benchmark/run-1p9nq39b/tiny/sample-00-crops-8dln4fze/target_000.pgm | data-evidence | 灰度像素图 | 已纳入Git（含暂存） | 保存target_000的目标ROI裁剪；其合成/文件/实机来源及框/标签含义以data/evidence/2026-10-03-arm-localize-baseline/arm-board-final/arm_localize/README.md为准。 | 目录/格式与邻接文件 | 2 | 所在目录说明：data/evidence/2026-10-03-arm-localize-baseline/arm-board-final/arm_localize/README.md 同名配套文件：data/evidence/2026-10-03-arm-localize-baseline/arm-board-final/arm_localize/benchmark/run-1p9nq39b/tiny/sample-00-crops-8dln4fze/target_000.hex
data/evidence/2026-10-03-arm-localize-baseline/arm-board-final/arm_localize/benchmark/run-1p9nq39b/tiny/sample-00-crops-8dln4fze/target_001.hex | data-evidence | 十六进制数据 | 已纳入Git（含暂存） | 以十六进制数据形式保存target_001的目标ROI像素；由对应加载器/testbench读取，位宽、排布和端序按data/evidence/2026-10-03-arm-localize-baseline/arm-board-final/arm_localize/README.md核对。 | 目录/格式与邻接文件 | 2 | 所在目录说明：data/evidence/2026-10-03-arm-localize-baseline/arm-board-final/arm_localize/README.md 同名配套文件：data/evidence/2026-10-03-arm-localize-baseline/arm-board-final/arm_localize/benchmark/run-1p9nq39b/tiny/sample-00-crops-8dln4fze/target_001.pgm
data/evidence/2026-10-03-arm-localize-baseline/arm-board-final/arm_localize/benchmark/run-1p9nq39b/tiny/sample-00-crops-8dln4fze/target_001.pgm | data-evidence | 灰度像素图 | 已纳入Git（含暂存） | 保存target_001的目标ROI裁剪；其合成/文件/实机来源及框/标签含义以data/evidence/2026-10-03-arm-localize-baseline/arm-board-final/arm_localize/README.md为准。 | 目录/格式与邻接文件 | 2 | 所在目录说明：data/evidence/2026-10-03-arm-localize-baseline/arm-board-final/arm_localize/README.md 同名配套文件：data/evidence/2026-10-03-arm-localize-baseline/arm-board-final/arm_localize/benchmark/run-1p9nq39b/tiny/sample-00-crops-8dln4fze/target_001.hex
data/evidence/2026-10-03-arm-localize-baseline/arm-board-final/arm_localize/benchmark/run-1p9nq39b/tiny/sample-00.json | data-evidence | 结构化结果/元数据 | 已纳入Git（含暂存） | 保存sample-00的实验结果或检查产物，字段包括frame_id、config_id、width、height、status、targets、schema_version；与data/evidence/2026-10-03-arm-localize-baseline/arm-board-final/arm_localize/README.md中的生成/校验流程一起使用。 | 目录/格式与邻接文件 | 2 | 所在目录说明：data/evidence/2026-10-03-arm-localize-baseline/arm-board-final/arm_localize/README.md 同目录输入/元数据：data/evidence/2026-10-03-arm-localize-baseline/arm-board-final/arm_localize/benchmark/run-1p9nq39b/tiny/input.json
data/evidence/2026-10-03-arm-localize-baseline/arm-board-final/arm_localize/benchmark/run-1p9nq39b/tiny/sample-01-crops-95bg95k4/target_000.hex | data-evidence | 十六进制数据 | 已纳入Git（含暂存） | 以十六进制数据形式保存target_000的目标ROI像素；由对应加载器/testbench读取，位宽、排布和端序按data/evidence/2026-10-03-arm-localize-baseline/arm-board-final/arm_localize/README.md核对。 | 目录/格式与邻接文件 | 2 | 所在目录说明：data/evidence/2026-10-03-arm-localize-baseline/arm-board-final/arm_localize/README.md 同名配套文件：data/evidence/2026-10-03-arm-localize-baseline/arm-board-final/arm_localize/benchmark/run-1p9nq39b/tiny/sample-01-crops-95bg95k4/target_000.pgm
data/evidence/2026-10-03-arm-localize-baseline/arm-board-final/arm_localize/benchmark/run-1p9nq39b/tiny/sample-01-crops-95bg95k4/target_000.pgm | data-evidence | 灰度像素图 | 已纳入Git（含暂存） | 保存target_000的目标ROI裁剪；其合成/文件/实机来源及框/标签含义以data/evidence/2026-10-03-arm-localize-baseline/arm-board-final/arm_localize/README.md为准。 | 目录/格式与邻接文件 | 2 | 所在目录说明：data/evidence/2026-10-03-arm-localize-baseline/arm-board-final/arm_localize/README.md 同名配套文件：data/evidence/2026-10-03-arm-localize-baseline/arm-board-final/arm_localize/benchmark/run-1p9nq39b/tiny/sample-01-crops-95bg95k4/target_000.hex
data/evidence/2026-10-03-arm-localize-baseline/arm-board-final/arm_localize/benchmark/run-1p9nq39b/tiny/sample-01-crops-95bg95k4/target_001.hex | data-evidence | 十六进制数据 | 已纳入Git（含暂存） | 以十六进制数据形式保存target_001的目标ROI像素；由对应加载器/testbench读取，位宽、排布和端序按data/evidence/2026-10-03-arm-localize-baseline/arm-board-final/arm_localize/README.md核对。 | 目录/格式与邻接文件 | 2 | 所在目录说明：data/evidence/2026-10-03-arm-localize-baseline/arm-board-final/arm_localize/README.md 同名配套文件：data/evidence/2026-10-03-arm-localize-baseline/arm-board-final/arm_localize/benchmark/run-1p9nq39b/tiny/sample-01-crops-95bg95k4/target_001.pgm
data/evidence/2026-10-03-arm-localize-baseline/arm-board-final/arm_localize/benchmark/run-1p9nq39b/tiny/sample-01-crops-95bg95k4/target_001.pgm | data-evidence | 灰度像素图 | 已纳入Git（含暂存） | 保存target_001的目标ROI裁剪；其合成/文件/实机来源及框/标签含义以data/evidence/2026-10-03-arm-localize-baseline/arm-board-final/arm_localize/README.md为准。 | 目录/格式与邻接文件 | 2 | 所在目录说明：data/evidence/2026-10-03-arm-localize-baseline/arm-board-final/arm_localize/README.md 同名配套文件：data/evidence/2026-10-03-arm-localize-baseline/arm-board-final/arm_localize/benchmark/run-1p9nq39b/tiny/sample-01-crops-95bg95k4/target_001.hex
data/evidence/2026-10-03-arm-localize-baseline/arm-board-final/arm_localize/benchmark/run-1p9nq39b/tiny/sample-01.json | data-evidence | 结构化结果/元数据 | 已纳入Git（含暂存） | 保存sample-01的实验结果或检查产物，字段包括frame_id、config_id、width、height、status、targets、schema_version；与data/evidence/2026-10-03-arm-localize-baseline/arm-board-final/arm_localize/README.md中的生成/校验流程一起使用。 | 目录/格式与邻接文件 | 2 | 所在目录说明：data/evidence/2026-10-03-arm-localize-baseline/arm-board-final/arm_localize/README.md 同目录输入/元数据：data/evidence/2026-10-03-arm-localize-baseline/arm-board-final/arm_localize/benchmark/run-1p9nq39b/tiny/input.json
data/evidence/2026-10-03-arm-localize-baseline/arm-board-final/arm_localize/benchmark/run-1p9nq39b/tiny/sample-02-crops-3hpsyevo/target_000.hex | data-evidence | 十六进制数据 | 已纳入Git（含暂存） | 以十六进制数据形式保存target_000的目标ROI像素；由对应加载器/testbench读取，位宽、排布和端序按data/evidence/2026-10-03-arm-localize-baseline/arm-board-final/arm_localize/README.md核对。 | 目录/格式与邻接文件 | 2 | 所在目录说明：data/evidence/2026-10-03-arm-localize-baseline/arm-board-final/arm_localize/README.md 同名配套文件：data/evidence/2026-10-03-arm-localize-baseline/arm-board-final/arm_localize/benchmark/run-1p9nq39b/tiny/sample-02-crops-3hpsyevo/target_000.pgm
data/evidence/2026-10-03-arm-localize-baseline/arm-board-final/arm_localize/benchmark/run-1p9nq39b/tiny/sample-02-crops-3hpsyevo/target_000.pgm | data-evidence | 灰度像素图 | 已纳入Git（含暂存） | 保存target_000的目标ROI裁剪；其合成/文件/实机来源及框/标签含义以data/evidence/2026-10-03-arm-localize-baseline/arm-board-final/arm_localize/README.md为准。 | 目录/格式与邻接文件 | 2 | 所在目录说明：data/evidence/2026-10-03-arm-localize-baseline/arm-board-final/arm_localize/README.md 同名配套文件：data/evidence/2026-10-03-arm-localize-baseline/arm-board-final/arm_localize/benchmark/run-1p9nq39b/tiny/sample-02-crops-3hpsyevo/target_000.hex
data/evidence/2026-10-03-arm-localize-baseline/arm-board-final/arm_localize/benchmark/run-1p9nq39b/tiny/sample-02-crops-3hpsyevo/target_001.hex | data-evidence | 十六进制数据 | 已纳入Git（含暂存） | 以十六进制数据形式保存target_001的目标ROI像素；由对应加载器/testbench读取，位宽、排布和端序按data/evidence/2026-10-03-arm-localize-baseline/arm-board-final/arm_localize/README.md核对。 | 目录/格式与邻接文件 | 2 | 所在目录说明：data/evidence/2026-10-03-arm-localize-baseline/arm-board-final/arm_localize/README.md 同名配套文件：data/evidence/2026-10-03-arm-localize-baseline/arm-board-final/arm_localize/benchmark/run-1p9nq39b/tiny/sample-02-crops-3hpsyevo/target_001.pgm
data/evidence/2026-10-03-arm-localize-baseline/arm-board-final/arm_localize/benchmark/run-1p9nq39b/tiny/sample-02-crops-3hpsyevo/target_001.pgm | data-evidence | 灰度像素图 | 已纳入Git（含暂存） | 保存target_001的目标ROI裁剪；其合成/文件/实机来源及框/标签含义以data/evidence/2026-10-03-arm-localize-baseline/arm-board-final/arm_localize/README.md为准。 | 目录/格式与邻接文件 | 2 | 所在目录说明：data/evidence/2026-10-03-arm-localize-baseline/arm-board-final/arm_localize/README.md 同名配套文件：data/evidence/2026-10-03-arm-localize-baseline/arm-board-final/arm_localize/benchmark/run-1p9nq39b/tiny/sample-02-crops-3hpsyevo/target_001.hex
data/evidence/2026-10-03-arm-localize-baseline/arm-board-final/arm_localize/benchmark/run-1p9nq39b/tiny/sample-02.json | data-evidence | 结构化结果/元数据 | 已纳入Git（含暂存） | 保存sample-02的实验结果或检查产物，字段包括frame_id、config_id、width、height、status、targets、schema_version；与data/evidence/2026-10-03-arm-localize-baseline/arm-board-final/arm_localize/README.md中的生成/校验流程一起使用。 | 目录/格式与邻接文件 | 2 | 所在目录说明：data/evidence/2026-10-03-arm-localize-baseline/arm-board-final/arm_localize/README.md 同目录输入/元数据：data/evidence/2026-10-03-arm-localize-baseline/arm-board-final/arm_localize/benchmark/run-1p9nq39b/tiny/input.json
data/evidence/2026-10-03-arm-localize-baseline/arm-board-final/arm_localize/benchmark/run-1p9nq39b/tiny/sample-03-crops-laf5970y/target_000.hex | data-evidence | 十六进制数据 | 已纳入Git（含暂存） | 以十六进制数据形式保存target_000的目标ROI像素；由对应加载器/testbench读取，位宽、排布和端序按data/evidence/2026-10-03-arm-localize-baseline/arm-board-final/arm_localize/README.md核对。 | 目录/格式与邻接文件 | 2 | 所在目录说明：data/evidence/2026-10-03-arm-localize-baseline/arm-board-final/arm_localize/README.md 同名配套文件：data/evidence/2026-10-03-arm-localize-baseline/arm-board-final/arm_localize/benchmark/run-1p9nq39b/tiny/sample-03-crops-laf5970y/target_000.pgm
data/evidence/2026-10-03-arm-localize-baseline/arm-board-final/arm_localize/benchmark/run-1p9nq39b/tiny/sample-03-crops-laf5970y/target_000.pgm | data-evidence | 灰度像素图 | 已纳入Git（含暂存） | 保存target_000的目标ROI裁剪；其合成/文件/实机来源及框/标签含义以data/evidence/2026-10-03-arm-localize-baseline/arm-board-final/arm_localize/README.md为准。 | 目录/格式与邻接文件 | 2 | 所在目录说明：data/evidence/2026-10-03-arm-localize-baseline/arm-board-final/arm_localize/README.md 同名配套文件：data/evidence/2026-10-03-arm-localize-baseline/arm-board-final/arm_localize/benchmark/run-1p9nq39b/tiny/sample-03-crops-laf5970y/target_000.hex
data/evidence/2026-10-03-arm-localize-baseline/arm-board-final/arm_localize/benchmark/run-1p9nq39b/tiny/sample-03-crops-laf5970y/target_001.hex | data-evidence | 十六进制数据 | 已纳入Git（含暂存） | 以十六进制数据形式保存target_001的目标ROI像素；由对应加载器/testbench读取，位宽、排布和端序按data/evidence/2026-10-03-arm-localize-baseline/arm-board-final/arm_localize/README.md核对。 | 目录/格式与邻接文件 | 2 | 所在目录说明：data/evidence/2026-10-03-arm-localize-baseline/arm-board-final/arm_localize/README.md 同名配套文件：data/evidence/2026-10-03-arm-localize-baseline/arm-board-final/arm_localize/benchmark/run-1p9nq39b/tiny/sample-03-crops-laf5970y/target_001.pgm
data/evidence/2026-10-03-arm-localize-baseline/arm-board-final/arm_localize/benchmark/run-1p9nq39b/tiny/sample-03-crops-laf5970y/target_001.pgm | data-evidence | 灰度像素图 | 已纳入Git（含暂存） | 保存target_001的目标ROI裁剪；其合成/文件/实机来源及框/标签含义以data/evidence/2026-10-03-arm-localize-baseline/arm-board-final/arm_localize/README.md为准。 | 目录/格式与邻接文件 | 2 | 所在目录说明：data/evidence/2026-10-03-arm-localize-baseline/arm-board-final/arm_localize/README.md 同名配套文件：data/evidence/2026-10-03-arm-localize-baseline/arm-board-final/arm_localize/benchmark/run-1p9nq39b/tiny/sample-03-crops-laf5970y/target_001.hex
data/evidence/2026-10-03-arm-localize-baseline/arm-board-final/arm_localize/benchmark/run-1p9nq39b/tiny/sample-03.json | data-evidence | 结构化结果/元数据 | 已纳入Git（含暂存） | 保存sample-03的实验结果或检查产物，字段包括frame_id、config_id、width、height、status、targets、schema_version；与data/evidence/2026-10-03-arm-localize-baseline/arm-board-final/arm_localize/README.md中的生成/校验流程一起使用。 | 目录/格式与邻接文件 | 2 | 所在目录说明：data/evidence/2026-10-03-arm-localize-baseline/arm-board-final/arm_localize/README.md 同目录输入/元数据：data/evidence/2026-10-03-arm-localize-baseline/arm-board-final/arm_localize/benchmark/run-1p9nq39b/tiny/input.json
data/evidence/2026-10-03-arm-localize-baseline/arm-board-final/arm_localize/benchmark/run-1p9nq39b/tiny/sample-04-crops-38ox1uka/target_000.hex | data-evidence | 十六进制数据 | 已纳入Git（含暂存） | 以十六进制数据形式保存target_000的目标ROI像素；由对应加载器/testbench读取，位宽、排布和端序按data/evidence/2026-10-03-arm-localize-baseline/arm-board-final/arm_localize/README.md核对。 | 目录/格式与邻接文件 | 2 | 所在目录说明：data/evidence/2026-10-03-arm-localize-baseline/arm-board-final/arm_localize/README.md 同名配套文件：data/evidence/2026-10-03-arm-localize-baseline/arm-board-final/arm_localize/benchmark/run-1p9nq39b/tiny/sample-04-crops-38ox1uka/target_000.pgm
data/evidence/2026-10-03-arm-localize-baseline/arm-board-final/arm_localize/benchmark/run-1p9nq39b/tiny/sample-04-crops-38ox1uka/target_000.pgm | data-evidence | 灰度像素图 | 已纳入Git（含暂存） | 保存target_000的目标ROI裁剪；其合成/文件/实机来源及框/标签含义以data/evidence/2026-10-03-arm-localize-baseline/arm-board-final/arm_localize/README.md为准。 | 目录/格式与邻接文件 | 2 | 所在目录说明：data/evidence/2026-10-03-arm-localize-baseline/arm-board-final/arm_localize/README.md 同名配套文件：data/evidence/2026-10-03-arm-localize-baseline/arm-board-final/arm_localize/benchmark/run-1p9nq39b/tiny/sample-04-crops-38ox1uka/target_000.hex
data/evidence/2026-10-03-arm-localize-baseline/arm-board-final/arm_localize/benchmark/run-1p9nq39b/tiny/sample-04-crops-38ox1uka/target_001.hex | data-evidence | 十六进制数据 | 已纳入Git（含暂存） | 以十六进制数据形式保存target_001的目标ROI像素；由对应加载器/testbench读取，位宽、排布和端序按data/evidence/2026-10-03-arm-localize-baseline/arm-board-final/arm_localize/README.md核对。 | 目录/格式与邻接文件 | 2 | 所在目录说明：data/evidence/2026-10-03-arm-localize-baseline/arm-board-final/arm_localize/README.md 同名配套文件：data/evidence/2026-10-03-arm-localize-baseline/arm-board-final/arm_localize/benchmark/run-1p9nq39b/tiny/sample-04-crops-38ox1uka/target_001.pgm
data/evidence/2026-10-03-arm-localize-baseline/arm-board-final/arm_localize/benchmark/run-1p9nq39b/tiny/sample-04-crops-38ox1uka/target_001.pgm | data-evidence | 灰度像素图 | 已纳入Git（含暂存） | 保存target_001的目标ROI裁剪；其合成/文件/实机来源及框/标签含义以data/evidence/2026-10-03-arm-localize-baseline/arm-board-final/arm_localize/README.md为准。 | 目录/格式与邻接文件 | 2 | 所在目录说明：data/evidence/2026-10-03-arm-localize-baseline/arm-board-final/arm_localize/README.md 同名配套文件：data/evidence/2026-10-03-arm-localize-baseline/arm-board-final/arm_localize/benchmark/run-1p9nq39b/tiny/sample-04-crops-38ox1uka/target_001.hex
data/evidence/2026-10-03-arm-localize-baseline/arm-board-final/arm_localize/benchmark/run-1p9nq39b/tiny/sample-04.json | data-evidence | 结构化结果/元数据 | 已纳入Git（含暂存） | 保存sample-04的实验结果或检查产物，字段包括frame_id、config_id、width、height、status、targets、schema_version；与data/evidence/2026-10-03-arm-localize-baseline/arm-board-final/arm_localize/README.md中的生成/校验流程一起使用。 | 目录/格式与邻接文件 | 2 | 所在目录说明：data/evidence/2026-10-03-arm-localize-baseline/arm-board-final/arm_localize/README.md 同目录输入/元数据：data/evidence/2026-10-03-arm-localize-baseline/arm-board-final/arm_localize/benchmark/run-1p9nq39b/tiny/input.json
data/evidence/2026-10-03-arm-localize-baseline/arm-board-final/arm_localize/benchmark/run-1p9nq39b/tiny/warmup-00-crops-1a0nfp8a/target_000.hex | data-evidence | 十六进制数据 | 已纳入Git（含暂存） | 以十六进制数据形式保存target_000的目标ROI像素；由对应加载器/testbench读取，位宽、排布和端序按data/evidence/2026-10-03-arm-localize-baseline/arm-board-final/arm_localize/README.md核对。 | 目录/格式与邻接文件 | 2 | 所在目录说明：data/evidence/2026-10-03-arm-localize-baseline/arm-board-final/arm_localize/README.md 同名配套文件：data/evidence/2026-10-03-arm-localize-baseline/arm-board-final/arm_localize/benchmark/run-1p9nq39b/tiny/warmup-00-crops-1a0nfp8a/target_000.pgm
data/evidence/2026-10-03-arm-localize-baseline/arm-board-final/arm_localize/benchmark/run-1p9nq39b/tiny/warmup-00-crops-1a0nfp8a/target_000.pgm | data-evidence | 灰度像素图 | 已纳入Git（含暂存） | 保存target_000的目标ROI裁剪；其合成/文件/实机来源及框/标签含义以data/evidence/2026-10-03-arm-localize-baseline/arm-board-final/arm_localize/README.md为准。 | 目录/格式与邻接文件 | 2 | 所在目录说明：data/evidence/2026-10-03-arm-localize-baseline/arm-board-final/arm_localize/README.md 同名配套文件：data/evidence/2026-10-03-arm-localize-baseline/arm-board-final/arm_localize/benchmark/run-1p9nq39b/tiny/warmup-00-crops-1a0nfp8a/target_000.hex
data/evidence/2026-10-03-arm-localize-baseline/arm-board-final/arm_localize/benchmark/run-1p9nq39b/tiny/warmup-00-crops-1a0nfp8a/target_001.hex | data-evidence | 十六进制数据 | 已纳入Git（含暂存） | 以十六进制数据形式保存target_001的目标ROI像素；由对应加载器/testbench读取，位宽、排布和端序按data/evidence/2026-10-03-arm-localize-baseline/arm-board-final/arm_localize/README.md核对。 | 目录/格式与邻接文件 | 2 | 所在目录说明：data/evidence/2026-10-03-arm-localize-baseline/arm-board-final/arm_localize/README.md 同名配套文件：data/evidence/2026-10-03-arm-localize-baseline/arm-board-final/arm_localize/benchmark/run-1p9nq39b/tiny/warmup-00-crops-1a0nfp8a/target_001.pgm
data/evidence/2026-10-03-arm-localize-baseline/arm-board-final/arm_localize/benchmark/run-1p9nq39b/tiny/warmup-00-crops-1a0nfp8a/target_001.pgm | data-evidence | 灰度像素图 | 已纳入Git（含暂存） | 保存target_001的目标ROI裁剪；其合成/文件/实机来源及框/标签含义以data/evidence/2026-10-03-arm-localize-baseline/arm-board-final/arm_localize/README.md为准。 | 目录/格式与邻接文件 | 2 | 所在目录说明：data/evidence/2026-10-03-arm-localize-baseline/arm-board-final/arm_localize/README.md 同名配套文件：data/evidence/2026-10-03-arm-localize-baseline/arm-board-final/arm_localize/benchmark/run-1p9nq39b/tiny/warmup-00-crops-1a0nfp8a/target_001.hex
data/evidence/2026-10-03-arm-localize-baseline/arm-board-final/arm_localize/benchmark/run-1p9nq39b/tiny/warmup-00.json | data-evidence | 结构化结果/元数据 | 已纳入Git（含暂存） | 保存warmup-00的实验结果或检查产物，字段包括frame_id、config_id、width、height、status、targets、schema_version；与data/evidence/2026-10-03-arm-localize-baseline/arm-board-final/arm_localize/README.md中的生成/校验流程一起使用。 | 目录/格式与邻接文件 | 2 | 所在目录说明：data/evidence/2026-10-03-arm-localize-baseline/arm-board-final/arm_localize/README.md 同目录输入/元数据：data/evidence/2026-10-03-arm-localize-baseline/arm-board-final/arm_localize/benchmark/run-1p9nq39b/tiny/input.json
data/evidence/2026-10-03-arm-localize-baseline/arm-board-final/arm_localize/benchmark/summary.json | data-evidence | 结构化结果/元数据 | 已纳入Git（含暂存） | 保存summary的实验结果或检查产物，字段包括schema_version、mode、utc、warmup、repeats、crop_size、p95_method；与data/evidence/2026-10-03-arm-localize-baseline/arm-board-final/arm_localize/README.md中的生成/校验流程一起使用。 | 目录/格式与邻接文件 | 1 | 所在目录说明：data/evidence/2026-10-03-arm-localize-baseline/arm-board-final/arm_localize/README.md
data/evidence/2026-10-03-arm-localize-baseline/arm-board-final/arm_localize/final-result-crops-qq101pl5/target_000.hex | data-evidence | 十六进制数据 | 已纳入Git（含暂存） | 以十六进制数据形式保存target_000的目标ROI像素；由对应加载器/testbench读取，位宽、排布和端序按data/evidence/2026-10-03-arm-localize-baseline/arm-board-final/arm_localize/README.md核对。 | 目录/格式与邻接文件 | 2 | 所在目录说明：data/evidence/2026-10-03-arm-localize-baseline/arm-board-final/arm_localize/README.md 同名配套文件：data/evidence/2026-10-03-arm-localize-baseline/arm-board-final/arm_localize/final-result-crops-qq101pl5/target_000.pgm
data/evidence/2026-10-03-arm-localize-baseline/arm-board-final/arm_localize/final-result-crops-qq101pl5/target_000.pgm | data-evidence | 灰度像素图 | 已纳入Git（含暂存） | 保存target_000的目标ROI裁剪；其合成/文件/实机来源及框/标签含义以data/evidence/2026-10-03-arm-localize-baseline/arm-board-final/arm_localize/README.md为准。 | 目录/格式与邻接文件 | 2 | 所在目录说明：data/evidence/2026-10-03-arm-localize-baseline/arm-board-final/arm_localize/README.md 同名配套文件：data/evidence/2026-10-03-arm-localize-baseline/arm-board-final/arm_localize/final-result-crops-qq101pl5/target_000.hex
data/evidence/2026-10-03-arm-localize-baseline/arm-board-final/arm_localize/final-result-crops-qq101pl5/target_001.hex | data-evidence | 十六进制数据 | 已纳入Git（含暂存） | 以十六进制数据形式保存target_001的目标ROI像素；由对应加载器/testbench读取，位宽、排布和端序按data/evidence/2026-10-03-arm-localize-baseline/arm-board-final/arm_localize/README.md核对。 | 目录/格式与邻接文件 | 2 | 所在目录说明：data/evidence/2026-10-03-arm-localize-baseline/arm-board-final/arm_localize/README.md 同名配套文件：data/evidence/2026-10-03-arm-localize-baseline/arm-board-final/arm_localize/final-result-crops-qq101pl5/target_001.pgm
data/evidence/2026-10-03-arm-localize-baseline/arm-board-final/arm_localize/final-result-crops-qq101pl5/target_001.pgm | data-evidence | 灰度像素图 | 已纳入Git（含暂存） | 保存target_001的目标ROI裁剪；其合成/文件/实机来源及框/标签含义以data/evidence/2026-10-03-arm-localize-baseline/arm-board-final/arm_localize/README.md为准。 | 目录/格式与邻接文件 | 2 | 所在目录说明：data/evidence/2026-10-03-arm-localize-baseline/arm-board-final/arm_localize/README.md 同名配套文件：data/evidence/2026-10-03-arm-localize-baseline/arm-board-final/arm_localize/final-result-crops-qq101pl5/target_001.hex
data/evidence/2026-10-03-arm-localize-baseline/arm-board-final/arm_localize/final-result.json | data-evidence | 结构化结果/元数据 | 已纳入Git（含暂存） | 保存final-result的实验结果或检查产物，字段包括frame_id、config_id、width、height、status、targets、schema_version；与data/evidence/2026-10-03-arm-localize-baseline/arm-board-final/arm_localize/README.md中的生成/校验流程一起使用。 | 目录/格式与邻接文件 | 2 | 所在目录说明：data/evidence/2026-10-03-arm-localize-baseline/arm-board-final/arm_localize/README.md 同目录输入/元数据：data/evidence/2026-10-03-arm-localize-baseline/arm-board-final/arm_localize/manifest.json
data/evidence/2026-10-03-arm-localize-baseline/arm-board-final/arm_localize/manifest.json | data-evidence | 结构化结果/元数据 | 已纳入Git（含暂存） | 保存manifest的文件清单及完整性信息，字段包括schema_version、base_commit、files；与data/evidence/2026-10-03-arm-localize-baseline/arm-board-final/arm_localize/README.md中的生成/校验流程一起使用。 | 目录/格式与邻接文件 | 1 | 所在目录说明：data/evidence/2026-10-03-arm-localize-baseline/arm-board-final/arm_localize/README.md
data/evidence/2026-10-03-arm-localize-baseline/arm-board-final/arm_localize/reference.py | data-evidence | 归档源码/输入副本 | 已纳入Git（含暂存） | 这是该轮保存的源码/配置副本：实现/配置reference相关流程，定义locate、crop_resize、coord、prepare_targets；实际导入、例化和文本引用见关联栏，与data/evidence/2026-10-03-arm-localize-baseline/arm-board-final/arm_localize/README.md配套阅读；所属实验与当前入口以关联栏区分。 | 快照路径＋对应源码角色 | 2 | 所在目录说明：data/evidence/2026-10-03-arm-localize-baseline/arm-board-final/arm_localize/README.md 同目录输入/元数据：data/evidence/2026-10-03-arm-localize-baseline/arm-board-final/arm_localize/manifest.json
data/evidence/2026-10-03-arm-localize-baseline/arm-board-final/arm_localize/selftest-evidence/result-crops-txhvj155/target_000.hex | data-evidence | 十六进制数据 | 已纳入Git（含暂存） | 以十六进制数据形式保存target_000的目标ROI像素；由对应加载器/testbench读取，位宽、排布和端序按data/evidence/2026-10-03-arm-localize-baseline/arm-board-final/arm_localize/README.md核对。 | 目录/格式与邻接文件 | 2 | 所在目录说明：data/evidence/2026-10-03-arm-localize-baseline/arm-board-final/arm_localize/README.md 同名配套文件：data/evidence/2026-10-03-arm-localize-baseline/arm-board-final/arm_localize/selftest-evidence/result-crops-txhvj155/target_000.pgm
data/evidence/2026-10-03-arm-localize-baseline/arm-board-final/arm_localize/selftest-evidence/result-crops-txhvj155/target_000.pgm | data-evidence | 灰度像素图 | 已纳入Git（含暂存） | 保存target_000的目标ROI裁剪；其合成/文件/实机来源及框/标签含义以data/evidence/2026-10-03-arm-localize-baseline/arm-board-final/arm_localize/README.md为准。 | 目录/格式与邻接文件 | 2 | 所在目录说明：data/evidence/2026-10-03-arm-localize-baseline/arm-board-final/arm_localize/README.md 同名配套文件：data/evidence/2026-10-03-arm-localize-baseline/arm-board-final/arm_localize/selftest-evidence/result-crops-txhvj155/target_000.hex
data/evidence/2026-10-03-arm-localize-baseline/arm-board-final/arm_localize/selftest-evidence/result-crops-txhvj155/target_001.hex | data-evidence | 十六进制数据 | 已纳入Git（含暂存） | 以十六进制数据形式保存target_001的目标ROI像素；由对应加载器/testbench读取，位宽、排布和端序按data/evidence/2026-10-03-arm-localize-baseline/arm-board-final/arm_localize/README.md核对。 | 目录/格式与邻接文件 | 2 | 所在目录说明：data/evidence/2026-10-03-arm-localize-baseline/arm-board-final/arm_localize/README.md 同名配套文件：data/evidence/2026-10-03-arm-localize-baseline/arm-board-final/arm_localize/selftest-evidence/result-crops-txhvj155/target_001.pgm
data/evidence/2026-10-03-arm-localize-baseline/arm-board-final/arm_localize/selftest-evidence/result-crops-txhvj155/target_001.pgm | data-evidence | 灰度像素图 | 已纳入Git（含暂存） | 保存target_001的目标ROI裁剪；其合成/文件/实机来源及框/标签含义以data/evidence/2026-10-03-arm-localize-baseline/arm-board-final/arm_localize/README.md为准。 | 目录/格式与邻接文件 | 2 | 所在目录说明：data/evidence/2026-10-03-arm-localize-baseline/arm-board-final/arm_localize/README.md 同名配套文件：data/evidence/2026-10-03-arm-localize-baseline/arm-board-final/arm_localize/selftest-evidence/result-crops-txhvj155/target_001.hex
data/evidence/2026-10-03-arm-localize-baseline/arm-board-final/arm_localize/selftest-evidence/result.json | data-evidence | 结构化结果/元数据 | 已纳入Git（含暂存） | 保存result的实验结果或检查产物，字段包括frame_id、config_id、width、height、status、targets、schema_version；与data/evidence/2026-10-03-arm-localize-baseline/arm-board-final/arm_localize/README.md中的生成/校验流程一起使用。 | 目录/格式与邻接文件 | 1 | 所在目录说明：data/evidence/2026-10-03-arm-localize-baseline/arm-board-final/arm_localize/README.md
data/evidence/2026-10-03-arm-localize-baseline/arm-board-final/arm_localize/two_targets.json | data-evidence | 结构化结果/元数据 | 已纳入Git（含暂存） | 保存two_targets的实验结果或检查产物，字段包括pixels；与data/evidence/2026-10-03-arm-localize-baseline/arm-board-final/arm_localize/README.md中的生成/校验流程一起使用。 | 目录/格式与邻接文件 | 2 | 所在目录说明：data/evidence/2026-10-03-arm-localize-baseline/arm-board-final/arm_localize/README.md 同目录输入/元数据：data/evidence/2026-10-03-arm-localize-baseline/arm-board-final/arm_localize/manifest.json
data/evidence/2026-10-03-arm-localize-baseline/arm-board/arm_localize/README.md | data-evidence | 说明/计划/契约 | 已纳入Git（含暂存） | 说明《ARM 文件定位/裁剪便携包》的规则、过程或结果；其引用文件见关联栏，日期/候选/冻结边界按正文保留。 | 读取Markdown标题与链接 | 3 | 所在目录说明：data/evidence/2026-10-03-arm-localize-baseline/README.md 同目录输入/元数据：data/evidence/2026-10-03-arm-localize-baseline/arm-board/arm_localize/manifest.json 文本引用：sim/scripts/make_arm_localize_pkg.py
data/evidence/2026-10-03-arm-localize-baseline/arm-board/arm_localize/arm_localize.py | data-evidence | 归档源码/输入副本 | 已纳入Git（含暂存） | 这是该轮保存的源码/配置副本：标准库文件定位/裁剪运行器，记录纯计算耗时；它不从实时HDMI取帧；所属实验与当前入口以关联栏区分。 | 快照路径＋对应源码角色 | 3 | 所在目录说明：data/evidence/2026-10-03-arm-localize-baseline/arm-board/arm_localize/README.md 同目录输入/元数据：data/evidence/2026-10-03-arm-localize-baseline/arm-board/arm_localize/manifest.json Python导入：data/evidence/2026-10-03-arm-localize-baseline/arm-board/arm_localize/reference.py
data/evidence/2026-10-03-arm-localize-baseline/arm-board/arm_localize/arm_localize_bench.py | data-evidence | 归档源码/输入副本 | 已纳入Git（含暂存） | 这是该轮保存的源码/配置副本：在固定合成场景上重复测定位性能并保存每次结果；用于ARM与本机同负载对比；所属实验与当前入口以关联栏区分。 | 快照路径＋对应源码角色 | 4 | 所在目录说明：data/evidence/2026-10-03-arm-localize-baseline/arm-board/arm_localize/README.md Python导入：data/evidence/2026-10-03-arm-localize-baseline/arm-board/arm_localize/arm_localize.py 同目录输入/元数据：data/evidence/2026-10-03-arm-localize-baseline/arm-board/arm_localize/manifest.json 文本引用：data/evidence/2026-10-03-arm-localize-baseline/two_targets.json
data/evidence/2026-10-03-arm-localize-baseline/arm-board/arm_localize/arm_localize_selftest.py | data-evidence | 归档源码/输入副本 | 已纳入Git（含暂存） | 这是该轮保存的源码/配置副本：便携定位包自检，覆盖固定答案、非法输入、CLI和哈希；供打包/移交检查；所属实验与当前入口以关联栏区分。 | 快照路径＋对应源码角色 | 3 | 所在目录说明：data/evidence/2026-10-03-arm-localize-baseline/arm-board/arm_localize/README.md Python导入：data/evidence/2026-10-03-arm-localize-baseline/arm-board/arm_localize/arm_localize.py 同目录输入/元数据：data/evidence/2026-10-03-arm-localize-baseline/arm-board/arm_localize/manifest.json
data/evidence/2026-10-03-arm-localize-baseline/arm-board/arm_localize/benchmark/run-nph60lvw/720p_empty/input.json | data-evidence | 结构化结果/元数据 | 已纳入Git（含暂存） | 保存input的输入/设备/运行元数据，字段包括具体字段；与data/evidence/2026-10-03-arm-localize-baseline/arm-board/arm_localize/README.md中的生成/校验流程一起使用。 | 目录/格式与邻接文件 | 1 | 所在目录说明：data/evidence/2026-10-03-arm-localize-baseline/arm-board/arm_localize/README.md
data/evidence/2026-10-03-arm-localize-baseline/arm-board/arm_localize/benchmark/run-nph60lvw/720p_empty/sample-00.json | data-evidence | 结构化结果/元数据 | 已纳入Git（含暂存） | 保存sample-00的实验结果或检查产物，字段包括frame_id、config_id、width、height、status、targets、schema_version；与data/evidence/2026-10-03-arm-localize-baseline/arm-board/arm_localize/README.md中的生成/校验流程一起使用。 | 目录/格式与邻接文件 | 2 | 所在目录说明：data/evidence/2026-10-03-arm-localize-baseline/arm-board/arm_localize/README.md 同目录输入/元数据：data/evidence/2026-10-03-arm-localize-baseline/arm-board/arm_localize/benchmark/run-nph60lvw/720p_empty/input.json
data/evidence/2026-10-03-arm-localize-baseline/arm-board/arm_localize/benchmark/run-nph60lvw/720p_empty/sample-01.json | data-evidence | 结构化结果/元数据 | 已纳入Git（含暂存） | 保存sample-01的实验结果或检查产物，字段包括frame_id、config_id、width、height、status、targets、schema_version；与data/evidence/2026-10-03-arm-localize-baseline/arm-board/arm_localize/README.md中的生成/校验流程一起使用。 | 目录/格式与邻接文件 | 2 | 所在目录说明：data/evidence/2026-10-03-arm-localize-baseline/arm-board/arm_localize/README.md 同目录输入/元数据：data/evidence/2026-10-03-arm-localize-baseline/arm-board/arm_localize/benchmark/run-nph60lvw/720p_empty/input.json
data/evidence/2026-10-03-arm-localize-baseline/arm-board/arm_localize/benchmark/run-nph60lvw/720p_empty/sample-02.json | data-evidence | 结构化结果/元数据 | 已纳入Git（含暂存） | 保存sample-02的实验结果或检查产物，字段包括frame_id、config_id、width、height、status、targets、schema_version；与data/evidence/2026-10-03-arm-localize-baseline/arm-board/arm_localize/README.md中的生成/校验流程一起使用。 | 目录/格式与邻接文件 | 2 | 所在目录说明：data/evidence/2026-10-03-arm-localize-baseline/arm-board/arm_localize/README.md 同目录输入/元数据：data/evidence/2026-10-03-arm-localize-baseline/arm-board/arm_localize/benchmark/run-nph60lvw/720p_empty/input.json
data/evidence/2026-10-03-arm-localize-baseline/arm-board/arm_localize/benchmark/run-nph60lvw/720p_empty/sample-03.json | data-evidence | 结构化结果/元数据 | 已纳入Git（含暂存） | 保存sample-03的实验结果或检查产物，字段包括frame_id、config_id、width、height、status、targets、schema_version；与data/evidence/2026-10-03-arm-localize-baseline/arm-board/arm_localize/README.md中的生成/校验流程一起使用。 | 目录/格式与邻接文件 | 2 | 所在目录说明：data/evidence/2026-10-03-arm-localize-baseline/arm-board/arm_localize/README.md 同目录输入/元数据：data/evidence/2026-10-03-arm-localize-baseline/arm-board/arm_localize/benchmark/run-nph60lvw/720p_empty/input.json
data/evidence/2026-10-03-arm-localize-baseline/arm-board/arm_localize/benchmark/run-nph60lvw/720p_empty/sample-04.json | data-evidence | 结构化结果/元数据 | 已纳入Git（含暂存） | 保存sample-04的实验结果或检查产物，字段包括frame_id、config_id、width、height、status、targets、schema_version；与data/evidence/2026-10-03-arm-localize-baseline/arm-board/arm_localize/README.md中的生成/校验流程一起使用。 | 目录/格式与邻接文件 | 2 | 所在目录说明：data/evidence/2026-10-03-arm-localize-baseline/arm-board/arm_localize/README.md 同目录输入/元数据：data/evidence/2026-10-03-arm-localize-baseline/arm-board/arm_localize/benchmark/run-nph60lvw/720p_empty/input.json
data/evidence/2026-10-03-arm-localize-baseline/arm-board/arm_localize/benchmark/run-nph60lvw/720p_empty/warmup-00.json | data-evidence | 结构化结果/元数据 | 已纳入Git（含暂存） | 保存warmup-00的实验结果或检查产物，字段包括frame_id、config_id、width、height、status、targets、schema_version；与data/evidence/2026-10-03-arm-localize-baseline/arm-board/arm_localize/README.md中的生成/校验流程一起使用。 | 目录/格式与邻接文件 | 2 | 所在目录说明：data/evidence/2026-10-03-arm-localize-baseline/arm-board/arm_localize/README.md 同目录输入/元数据：data/evidence/2026-10-03-arm-localize-baseline/arm-board/arm_localize/benchmark/run-nph60lvw/720p_empty/input.json
data/evidence/2026-10-03-arm-localize-baseline/arm-board/arm_localize/benchmark/run-nph60lvw/720p_six/input.json | data-evidence | 结构化结果/元数据 | 已纳入Git（含暂存） | 保存input的输入/设备/运行元数据，字段包括具体字段；与data/evidence/2026-10-03-arm-localize-baseline/arm-board/arm_localize/README.md中的生成/校验流程一起使用。 | 目录/格式与邻接文件 | 1 | 所在目录说明：data/evidence/2026-10-03-arm-localize-baseline/arm-board/arm_localize/README.md
data/evidence/2026-10-03-arm-localize-baseline/arm-board/arm_localize/benchmark/run-nph60lvw/720p_six/sample-00-crops-e1pwoeec/target_000.hex | data-evidence | 十六进制数据 | 已纳入Git（含暂存） | 以十六进制数据形式保存target_000的目标ROI像素；由对应加载器/testbench读取，位宽、排布和端序按data/evidence/2026-10-03-arm-localize-baseline/arm-board/arm_localize/README.md核对。 | 目录/格式与邻接文件 | 2 | 所在目录说明：data/evidence/2026-10-03-arm-localize-baseline/arm-board/arm_localize/README.md 同名配套文件：data/evidence/2026-10-03-arm-localize-baseline/arm-board/arm_localize/benchmark/run-nph60lvw/720p_six/sample-00-crops-e1pwoeec/target_000.pgm
data/evidence/2026-10-03-arm-localize-baseline/arm-board/arm_localize/benchmark/run-nph60lvw/720p_six/sample-00-crops-e1pwoeec/target_000.pgm | data-evidence | 灰度像素图 | 已纳入Git（含暂存） | 保存target_000的目标ROI裁剪；其合成/文件/实机来源及框/标签含义以data/evidence/2026-10-03-arm-localize-baseline/arm-board/arm_localize/README.md为准。 | 目录/格式与邻接文件 | 2 | 所在目录说明：data/evidence/2026-10-03-arm-localize-baseline/arm-board/arm_localize/README.md 同名配套文件：data/evidence/2026-10-03-arm-localize-baseline/arm-board/arm_localize/benchmark/run-nph60lvw/720p_six/sample-00-crops-e1pwoeec/target_000.hex
data/evidence/2026-10-03-arm-localize-baseline/arm-board/arm_localize/benchmark/run-nph60lvw/720p_six/sample-00-crops-e1pwoeec/target_001.hex | data-evidence | 十六进制数据 | 已纳入Git（含暂存） | 以十六进制数据形式保存target_001的目标ROI像素；由对应加载器/testbench读取，位宽、排布和端序按data/evidence/2026-10-03-arm-localize-baseline/arm-board/arm_localize/README.md核对。 | 目录/格式与邻接文件 | 2 | 所在目录说明：data/evidence/2026-10-03-arm-localize-baseline/arm-board/arm_localize/README.md 同名配套文件：data/evidence/2026-10-03-arm-localize-baseline/arm-board/arm_localize/benchmark/run-nph60lvw/720p_six/sample-00-crops-e1pwoeec/target_001.pgm
data/evidence/2026-10-03-arm-localize-baseline/arm-board/arm_localize/benchmark/run-nph60lvw/720p_six/sample-00-crops-e1pwoeec/target_001.pgm | data-evidence | 灰度像素图 | 已纳入Git（含暂存） | 保存target_001的目标ROI裁剪；其合成/文件/实机来源及框/标签含义以data/evidence/2026-10-03-arm-localize-baseline/arm-board/arm_localize/README.md为准。 | 目录/格式与邻接文件 | 2 | 所在目录说明：data/evidence/2026-10-03-arm-localize-baseline/arm-board/arm_localize/README.md 同名配套文件：data/evidence/2026-10-03-arm-localize-baseline/arm-board/arm_localize/benchmark/run-nph60lvw/720p_six/sample-00-crops-e1pwoeec/target_001.hex
data/evidence/2026-10-03-arm-localize-baseline/arm-board/arm_localize/benchmark/run-nph60lvw/720p_six/sample-00-crops-e1pwoeec/target_002.hex | data-evidence | 十六进制数据 | 已纳入Git（含暂存） | 以十六进制数据形式保存target_002的目标ROI像素；由对应加载器/testbench读取，位宽、排布和端序按data/evidence/2026-10-03-arm-localize-baseline/arm-board/arm_localize/README.md核对。 | 目录/格式与邻接文件 | 2 | 所在目录说明：data/evidence/2026-10-03-arm-localize-baseline/arm-board/arm_localize/README.md 同名配套文件：data/evidence/2026-10-03-arm-localize-baseline/arm-board/arm_localize/benchmark/run-nph60lvw/720p_six/sample-00-crops-e1pwoeec/target_002.pgm
data/evidence/2026-10-03-arm-localize-baseline/arm-board/arm_localize/benchmark/run-nph60lvw/720p_six/sample-00-crops-e1pwoeec/target_002.pgm | data-evidence | 灰度像素图 | 已纳入Git（含暂存） | 保存target_002的目标ROI裁剪；其合成/文件/实机来源及框/标签含义以data/evidence/2026-10-03-arm-localize-baseline/arm-board/arm_localize/README.md为准。 | 目录/格式与邻接文件 | 2 | 所在目录说明：data/evidence/2026-10-03-arm-localize-baseline/arm-board/arm_localize/README.md 同名配套文件：data/evidence/2026-10-03-arm-localize-baseline/arm-board/arm_localize/benchmark/run-nph60lvw/720p_six/sample-00-crops-e1pwoeec/target_002.hex
data/evidence/2026-10-03-arm-localize-baseline/arm-board/arm_localize/benchmark/run-nph60lvw/720p_six/sample-00-crops-e1pwoeec/target_003.hex | data-evidence | 十六进制数据 | 已纳入Git（含暂存） | 以十六进制数据形式保存target_003的目标ROI像素；由对应加载器/testbench读取，位宽、排布和端序按data/evidence/2026-10-03-arm-localize-baseline/arm-board/arm_localize/README.md核对。 | 目录/格式与邻接文件 | 2 | 所在目录说明：data/evidence/2026-10-03-arm-localize-baseline/arm-board/arm_localize/README.md 同名配套文件：data/evidence/2026-10-03-arm-localize-baseline/arm-board/arm_localize/benchmark/run-nph60lvw/720p_six/sample-00-crops-e1pwoeec/target_003.pgm
data/evidence/2026-10-03-arm-localize-baseline/arm-board/arm_localize/benchmark/run-nph60lvw/720p_six/sample-00-crops-e1pwoeec/target_003.pgm | data-evidence | 灰度像素图 | 已纳入Git（含暂存） | 保存target_003的目标ROI裁剪；其合成/文件/实机来源及框/标签含义以data/evidence/2026-10-03-arm-localize-baseline/arm-board/arm_localize/README.md为准。 | 目录/格式与邻接文件 | 2 | 所在目录说明：data/evidence/2026-10-03-arm-localize-baseline/arm-board/arm_localize/README.md 同名配套文件：data/evidence/2026-10-03-arm-localize-baseline/arm-board/arm_localize/benchmark/run-nph60lvw/720p_six/sample-00-crops-e1pwoeec/target_003.hex
data/evidence/2026-10-03-arm-localize-baseline/arm-board/arm_localize/benchmark/run-nph60lvw/720p_six/sample-00-crops-e1pwoeec/target_004.hex | data-evidence | 十六进制数据 | 已纳入Git（含暂存） | 以十六进制数据形式保存target_004的目标ROI像素；由对应加载器/testbench读取，位宽、排布和端序按data/evidence/2026-10-03-arm-localize-baseline/arm-board/arm_localize/README.md核对。 | 目录/格式与邻接文件 | 2 | 所在目录说明：data/evidence/2026-10-03-arm-localize-baseline/arm-board/arm_localize/README.md 同名配套文件：data/evidence/2026-10-03-arm-localize-baseline/arm-board/arm_localize/benchmark/run-nph60lvw/720p_six/sample-00-crops-e1pwoeec/target_004.pgm
data/evidence/2026-10-03-arm-localize-baseline/arm-board/arm_localize/benchmark/run-nph60lvw/720p_six/sample-00-crops-e1pwoeec/target_004.pgm | data-evidence | 灰度像素图 | 已纳入Git（含暂存） | 保存target_004的目标ROI裁剪；其合成/文件/实机来源及框/标签含义以data/evidence/2026-10-03-arm-localize-baseline/arm-board/arm_localize/README.md为准。 | 目录/格式与邻接文件 | 2 | 所在目录说明：data/evidence/2026-10-03-arm-localize-baseline/arm-board/arm_localize/README.md 同名配套文件：data/evidence/2026-10-03-arm-localize-baseline/arm-board/arm_localize/benchmark/run-nph60lvw/720p_six/sample-00-crops-e1pwoeec/target_004.hex
data/evidence/2026-10-03-arm-localize-baseline/arm-board/arm_localize/benchmark/run-nph60lvw/720p_six/sample-00-crops-e1pwoeec/target_005.hex | data-evidence | 十六进制数据 | 已纳入Git（含暂存） | 以十六进制数据形式保存target_005的目标ROI像素；由对应加载器/testbench读取，位宽、排布和端序按data/evidence/2026-10-03-arm-localize-baseline/arm-board/arm_localize/README.md核对。 | 目录/格式与邻接文件 | 2 | 所在目录说明：data/evidence/2026-10-03-arm-localize-baseline/arm-board/arm_localize/README.md 同名配套文件：data/evidence/2026-10-03-arm-localize-baseline/arm-board/arm_localize/benchmark/run-nph60lvw/720p_six/sample-00-crops-e1pwoeec/target_005.pgm
data/evidence/2026-10-03-arm-localize-baseline/arm-board/arm_localize/benchmark/run-nph60lvw/720p_six/sample-00-crops-e1pwoeec/target_005.pgm | data-evidence | 灰度像素图 | 已纳入Git（含暂存） | 保存target_005的目标ROI裁剪；其合成/文件/实机来源及框/标签含义以data/evidence/2026-10-03-arm-localize-baseline/arm-board/arm_localize/README.md为准。 | 目录/格式与邻接文件 | 2 | 所在目录说明：data/evidence/2026-10-03-arm-localize-baseline/arm-board/arm_localize/README.md 同名配套文件：data/evidence/2026-10-03-arm-localize-baseline/arm-board/arm_localize/benchmark/run-nph60lvw/720p_six/sample-00-crops-e1pwoeec/target_005.hex
data/evidence/2026-10-03-arm-localize-baseline/arm-board/arm_localize/benchmark/run-nph60lvw/720p_six/sample-00.json | data-evidence | 结构化结果/元数据 | 已纳入Git（含暂存） | 保存sample-00的实验结果或检查产物，字段包括frame_id、config_id、width、height、status、targets、schema_version；与data/evidence/2026-10-03-arm-localize-baseline/arm-board/arm_localize/README.md中的生成/校验流程一起使用。 | 目录/格式与邻接文件 | 2 | 所在目录说明：data/evidence/2026-10-03-arm-localize-baseline/arm-board/arm_localize/README.md 同目录输入/元数据：data/evidence/2026-10-03-arm-localize-baseline/arm-board/arm_localize/benchmark/run-nph60lvw/720p_six/input.json
data/evidence/2026-10-03-arm-localize-baseline/arm-board/arm_localize/benchmark/run-nph60lvw/720p_six/sample-01-crops-opnj7fw1/target_000.hex | data-evidence | 十六进制数据 | 已纳入Git（含暂存） | 以十六进制数据形式保存target_000的目标ROI像素；由对应加载器/testbench读取，位宽、排布和端序按data/evidence/2026-10-03-arm-localize-baseline/arm-board/arm_localize/README.md核对。 | 目录/格式与邻接文件 | 2 | 所在目录说明：data/evidence/2026-10-03-arm-localize-baseline/arm-board/arm_localize/README.md 同名配套文件：data/evidence/2026-10-03-arm-localize-baseline/arm-board/arm_localize/benchmark/run-nph60lvw/720p_six/sample-01-crops-opnj7fw1/target_000.pgm
data/evidence/2026-10-03-arm-localize-baseline/arm-board/arm_localize/benchmark/run-nph60lvw/720p_six/sample-01-crops-opnj7fw1/target_000.pgm | data-evidence | 灰度像素图 | 已纳入Git（含暂存） | 保存target_000的目标ROI裁剪；其合成/文件/实机来源及框/标签含义以data/evidence/2026-10-03-arm-localize-baseline/arm-board/arm_localize/README.md为准。 | 目录/格式与邻接文件 | 2 | 所在目录说明：data/evidence/2026-10-03-arm-localize-baseline/arm-board/arm_localize/README.md 同名配套文件：data/evidence/2026-10-03-arm-localize-baseline/arm-board/arm_localize/benchmark/run-nph60lvw/720p_six/sample-01-crops-opnj7fw1/target_000.hex
data/evidence/2026-10-03-arm-localize-baseline/arm-board/arm_localize/benchmark/run-nph60lvw/720p_six/sample-01-crops-opnj7fw1/target_001.hex | data-evidence | 十六进制数据 | 已纳入Git（含暂存） | 以十六进制数据形式保存target_001的目标ROI像素；由对应加载器/testbench读取，位宽、排布和端序按data/evidence/2026-10-03-arm-localize-baseline/arm-board/arm_localize/README.md核对。 | 目录/格式与邻接文件 | 2 | 所在目录说明：data/evidence/2026-10-03-arm-localize-baseline/arm-board/arm_localize/README.md 同名配套文件：data/evidence/2026-10-03-arm-localize-baseline/arm-board/arm_localize/benchmark/run-nph60lvw/720p_six/sample-01-crops-opnj7fw1/target_001.pgm
data/evidence/2026-10-03-arm-localize-baseline/arm-board/arm_localize/benchmark/run-nph60lvw/720p_six/sample-01-crops-opnj7fw1/target_001.pgm | data-evidence | 灰度像素图 | 已纳入Git（含暂存） | 保存target_001的目标ROI裁剪；其合成/文件/实机来源及框/标签含义以data/evidence/2026-10-03-arm-localize-baseline/arm-board/arm_localize/README.md为准。 | 目录/格式与邻接文件 | 2 | 所在目录说明：data/evidence/2026-10-03-arm-localize-baseline/arm-board/arm_localize/README.md 同名配套文件：data/evidence/2026-10-03-arm-localize-baseline/arm-board/arm_localize/benchmark/run-nph60lvw/720p_six/sample-01-crops-opnj7fw1/target_001.hex
data/evidence/2026-10-03-arm-localize-baseline/arm-board/arm_localize/benchmark/run-nph60lvw/720p_six/sample-01-crops-opnj7fw1/target_002.hex | data-evidence | 十六进制数据 | 已纳入Git（含暂存） | 以十六进制数据形式保存target_002的目标ROI像素；由对应加载器/testbench读取，位宽、排布和端序按data/evidence/2026-10-03-arm-localize-baseline/arm-board/arm_localize/README.md核对。 | 目录/格式与邻接文件 | 2 | 所在目录说明：data/evidence/2026-10-03-arm-localize-baseline/arm-board/arm_localize/README.md 同名配套文件：data/evidence/2026-10-03-arm-localize-baseline/arm-board/arm_localize/benchmark/run-nph60lvw/720p_six/sample-01-crops-opnj7fw1/target_002.pgm
data/evidence/2026-10-03-arm-localize-baseline/arm-board/arm_localize/benchmark/run-nph60lvw/720p_six/sample-01-crops-opnj7fw1/target_002.pgm | data-evidence | 灰度像素图 | 已纳入Git（含暂存） | 保存target_002的目标ROI裁剪；其合成/文件/实机来源及框/标签含义以data/evidence/2026-10-03-arm-localize-baseline/arm-board/arm_localize/README.md为准。 | 目录/格式与邻接文件 | 2 | 所在目录说明：data/evidence/2026-10-03-arm-localize-baseline/arm-board/arm_localize/README.md 同名配套文件：data/evidence/2026-10-03-arm-localize-baseline/arm-board/arm_localize/benchmark/run-nph60lvw/720p_six/sample-01-crops-opnj7fw1/target_002.hex
data/evidence/2026-10-03-arm-localize-baseline/arm-board/arm_localize/benchmark/run-nph60lvw/720p_six/sample-01-crops-opnj7fw1/target_003.hex | data-evidence | 十六进制数据 | 已纳入Git（含暂存） | 以十六进制数据形式保存target_003的目标ROI像素；由对应加载器/testbench读取，位宽、排布和端序按data/evidence/2026-10-03-arm-localize-baseline/arm-board/arm_localize/README.md核对。 | 目录/格式与邻接文件 | 2 | 所在目录说明：data/evidence/2026-10-03-arm-localize-baseline/arm-board/arm_localize/README.md 同名配套文件：data/evidence/2026-10-03-arm-localize-baseline/arm-board/arm_localize/benchmark/run-nph60lvw/720p_six/sample-01-crops-opnj7fw1/target_003.pgm
data/evidence/2026-10-03-arm-localize-baseline/arm-board/arm_localize/benchmark/run-nph60lvw/720p_six/sample-01-crops-opnj7fw1/target_003.pgm | data-evidence | 灰度像素图 | 已纳入Git（含暂存） | 保存target_003的目标ROI裁剪；其合成/文件/实机来源及框/标签含义以data/evidence/2026-10-03-arm-localize-baseline/arm-board/arm_localize/README.md为准。 | 目录/格式与邻接文件 | 2 | 所在目录说明：data/evidence/2026-10-03-arm-localize-baseline/arm-board/arm_localize/README.md 同名配套文件：data/evidence/2026-10-03-arm-localize-baseline/arm-board/arm_localize/benchmark/run-nph60lvw/720p_six/sample-01-crops-opnj7fw1/target_003.hex
data/evidence/2026-10-03-arm-localize-baseline/arm-board/arm_localize/benchmark/run-nph60lvw/720p_six/sample-01-crops-opnj7fw1/target_004.hex | data-evidence | 十六进制数据 | 已纳入Git（含暂存） | 以十六进制数据形式保存target_004的目标ROI像素；由对应加载器/testbench读取，位宽、排布和端序按data/evidence/2026-10-03-arm-localize-baseline/arm-board/arm_localize/README.md核对。 | 目录/格式与邻接文件 | 2 | 所在目录说明：data/evidence/2026-10-03-arm-localize-baseline/arm-board/arm_localize/README.md 同名配套文件：data/evidence/2026-10-03-arm-localize-baseline/arm-board/arm_localize/benchmark/run-nph60lvw/720p_six/sample-01-crops-opnj7fw1/target_004.pgm
data/evidence/2026-10-03-arm-localize-baseline/arm-board/arm_localize/benchmark/run-nph60lvw/720p_six/sample-01-crops-opnj7fw1/target_004.pgm | data-evidence | 灰度像素图 | 已纳入Git（含暂存） | 保存target_004的目标ROI裁剪；其合成/文件/实机来源及框/标签含义以data/evidence/2026-10-03-arm-localize-baseline/arm-board/arm_localize/README.md为准。 | 目录/格式与邻接文件 | 2 | 所在目录说明：data/evidence/2026-10-03-arm-localize-baseline/arm-board/arm_localize/README.md 同名配套文件：data/evidence/2026-10-03-arm-localize-baseline/arm-board/arm_localize/benchmark/run-nph60lvw/720p_six/sample-01-crops-opnj7fw1/target_004.hex
data/evidence/2026-10-03-arm-localize-baseline/arm-board/arm_localize/benchmark/run-nph60lvw/720p_six/sample-01-crops-opnj7fw1/target_005.hex | data-evidence | 十六进制数据 | 已纳入Git（含暂存） | 以十六进制数据形式保存target_005的目标ROI像素；由对应加载器/testbench读取，位宽、排布和端序按data/evidence/2026-10-03-arm-localize-baseline/arm-board/arm_localize/README.md核对。 | 目录/格式与邻接文件 | 2 | 所在目录说明：data/evidence/2026-10-03-arm-localize-baseline/arm-board/arm_localize/README.md 同名配套文件：data/evidence/2026-10-03-arm-localize-baseline/arm-board/arm_localize/benchmark/run-nph60lvw/720p_six/sample-01-crops-opnj7fw1/target_005.pgm
data/evidence/2026-10-03-arm-localize-baseline/arm-board/arm_localize/benchmark/run-nph60lvw/720p_six/sample-01-crops-opnj7fw1/target_005.pgm | data-evidence | 灰度像素图 | 已纳入Git（含暂存） | 保存target_005的目标ROI裁剪；其合成/文件/实机来源及框/标签含义以data/evidence/2026-10-03-arm-localize-baseline/arm-board/arm_localize/README.md为准。 | 目录/格式与邻接文件 | 2 | 所在目录说明：data/evidence/2026-10-03-arm-localize-baseline/arm-board/arm_localize/README.md 同名配套文件：data/evidence/2026-10-03-arm-localize-baseline/arm-board/arm_localize/benchmark/run-nph60lvw/720p_six/sample-01-crops-opnj7fw1/target_005.hex
data/evidence/2026-10-03-arm-localize-baseline/arm-board/arm_localize/benchmark/run-nph60lvw/720p_six/sample-01.json | data-evidence | 结构化结果/元数据 | 已纳入Git（含暂存） | 保存sample-01的实验结果或检查产物，字段包括frame_id、config_id、width、height、status、targets、schema_version；与data/evidence/2026-10-03-arm-localize-baseline/arm-board/arm_localize/README.md中的生成/校验流程一起使用。 | 目录/格式与邻接文件 | 2 | 所在目录说明：data/evidence/2026-10-03-arm-localize-baseline/arm-board/arm_localize/README.md 同目录输入/元数据：data/evidence/2026-10-03-arm-localize-baseline/arm-board/arm_localize/benchmark/run-nph60lvw/720p_six/input.json
data/evidence/2026-10-03-arm-localize-baseline/arm-board/arm_localize/benchmark/run-nph60lvw/720p_six/sample-02-crops-6kj5yp92/target_000.hex | data-evidence | 十六进制数据 | 已纳入Git（含暂存） | 以十六进制数据形式保存target_000的目标ROI像素；由对应加载器/testbench读取，位宽、排布和端序按data/evidence/2026-10-03-arm-localize-baseline/arm-board/arm_localize/README.md核对。 | 目录/格式与邻接文件 | 2 | 所在目录说明：data/evidence/2026-10-03-arm-localize-baseline/arm-board/arm_localize/README.md 同名配套文件：data/evidence/2026-10-03-arm-localize-baseline/arm-board/arm_localize/benchmark/run-nph60lvw/720p_six/sample-02-crops-6kj5yp92/target_000.pgm
data/evidence/2026-10-03-arm-localize-baseline/arm-board/arm_localize/benchmark/run-nph60lvw/720p_six/sample-02-crops-6kj5yp92/target_000.pgm | data-evidence | 灰度像素图 | 已纳入Git（含暂存） | 保存target_000的目标ROI裁剪；其合成/文件/实机来源及框/标签含义以data/evidence/2026-10-03-arm-localize-baseline/arm-board/arm_localize/README.md为准。 | 目录/格式与邻接文件 | 2 | 所在目录说明：data/evidence/2026-10-03-arm-localize-baseline/arm-board/arm_localize/README.md 同名配套文件：data/evidence/2026-10-03-arm-localize-baseline/arm-board/arm_localize/benchmark/run-nph60lvw/720p_six/sample-02-crops-6kj5yp92/target_000.hex
data/evidence/2026-10-03-arm-localize-baseline/arm-board/arm_localize/benchmark/run-nph60lvw/720p_six/sample-02-crops-6kj5yp92/target_001.hex | data-evidence | 十六进制数据 | 已纳入Git（含暂存） | 以十六进制数据形式保存target_001的目标ROI像素；由对应加载器/testbench读取，位宽、排布和端序按data/evidence/2026-10-03-arm-localize-baseline/arm-board/arm_localize/README.md核对。 | 目录/格式与邻接文件 | 2 | 所在目录说明：data/evidence/2026-10-03-arm-localize-baseline/arm-board/arm_localize/README.md 同名配套文件：data/evidence/2026-10-03-arm-localize-baseline/arm-board/arm_localize/benchmark/run-nph60lvw/720p_six/sample-02-crops-6kj5yp92/target_001.pgm
data/evidence/2026-10-03-arm-localize-baseline/arm-board/arm_localize/benchmark/run-nph60lvw/720p_six/sample-02-crops-6kj5yp92/target_001.pgm | data-evidence | 灰度像素图 | 已纳入Git（含暂存） | 保存target_001的目标ROI裁剪；其合成/文件/实机来源及框/标签含义以data/evidence/2026-10-03-arm-localize-baseline/arm-board/arm_localize/README.md为准。 | 目录/格式与邻接文件 | 2 | 所在目录说明：data/evidence/2026-10-03-arm-localize-baseline/arm-board/arm_localize/README.md 同名配套文件：data/evidence/2026-10-03-arm-localize-baseline/arm-board/arm_localize/benchmark/run-nph60lvw/720p_six/sample-02-crops-6kj5yp92/target_001.hex
data/evidence/2026-10-03-arm-localize-baseline/arm-board/arm_localize/benchmark/run-nph60lvw/720p_six/sample-02-crops-6kj5yp92/target_002.hex | data-evidence | 十六进制数据 | 已纳入Git（含暂存） | 以十六进制数据形式保存target_002的目标ROI像素；由对应加载器/testbench读取，位宽、排布和端序按data/evidence/2026-10-03-arm-localize-baseline/arm-board/arm_localize/README.md核对。 | 目录/格式与邻接文件 | 2 | 所在目录说明：data/evidence/2026-10-03-arm-localize-baseline/arm-board/arm_localize/README.md 同名配套文件：data/evidence/2026-10-03-arm-localize-baseline/arm-board/arm_localize/benchmark/run-nph60lvw/720p_six/sample-02-crops-6kj5yp92/target_002.pgm
data/evidence/2026-10-03-arm-localize-baseline/arm-board/arm_localize/benchmark/run-nph60lvw/720p_six/sample-02-crops-6kj5yp92/target_002.pgm | data-evidence | 灰度像素图 | 已纳入Git（含暂存） | 保存target_002的目标ROI裁剪；其合成/文件/实机来源及框/标签含义以data/evidence/2026-10-03-arm-localize-baseline/arm-board/arm_localize/README.md为准。 | 目录/格式与邻接文件 | 2 | 所在目录说明：data/evidence/2026-10-03-arm-localize-baseline/arm-board/arm_localize/README.md 同名配套文件：data/evidence/2026-10-03-arm-localize-baseline/arm-board/arm_localize/benchmark/run-nph60lvw/720p_six/sample-02-crops-6kj5yp92/target_002.hex
data/evidence/2026-10-03-arm-localize-baseline/arm-board/arm_localize/benchmark/run-nph60lvw/720p_six/sample-02-crops-6kj5yp92/target_003.hex | data-evidence | 十六进制数据 | 已纳入Git（含暂存） | 以十六进制数据形式保存target_003的目标ROI像素；由对应加载器/testbench读取，位宽、排布和端序按data/evidence/2026-10-03-arm-localize-baseline/arm-board/arm_localize/README.md核对。 | 目录/格式与邻接文件 | 2 | 所在目录说明：data/evidence/2026-10-03-arm-localize-baseline/arm-board/arm_localize/README.md 同名配套文件：data/evidence/2026-10-03-arm-localize-baseline/arm-board/arm_localize/benchmark/run-nph60lvw/720p_six/sample-02-crops-6kj5yp92/target_003.pgm
data/evidence/2026-10-03-arm-localize-baseline/arm-board/arm_localize/benchmark/run-nph60lvw/720p_six/sample-02-crops-6kj5yp92/target_003.pgm | data-evidence | 灰度像素图 | 已纳入Git（含暂存） | 保存target_003的目标ROI裁剪；其合成/文件/实机来源及框/标签含义以data/evidence/2026-10-03-arm-localize-baseline/arm-board/arm_localize/README.md为准。 | 目录/格式与邻接文件 | 2 | 所在目录说明：data/evidence/2026-10-03-arm-localize-baseline/arm-board/arm_localize/README.md 同名配套文件：data/evidence/2026-10-03-arm-localize-baseline/arm-board/arm_localize/benchmark/run-nph60lvw/720p_six/sample-02-crops-6kj5yp92/target_003.hex
data/evidence/2026-10-03-arm-localize-baseline/arm-board/arm_localize/benchmark/run-nph60lvw/720p_six/sample-02-crops-6kj5yp92/target_004.hex | data-evidence | 十六进制数据 | 已纳入Git（含暂存） | 以十六进制数据形式保存target_004的目标ROI像素；由对应加载器/testbench读取，位宽、排布和端序按data/evidence/2026-10-03-arm-localize-baseline/arm-board/arm_localize/README.md核对。 | 目录/格式与邻接文件 | 2 | 所在目录说明：data/evidence/2026-10-03-arm-localize-baseline/arm-board/arm_localize/README.md 同名配套文件：data/evidence/2026-10-03-arm-localize-baseline/arm-board/arm_localize/benchmark/run-nph60lvw/720p_six/sample-02-crops-6kj5yp92/target_004.pgm
data/evidence/2026-10-03-arm-localize-baseline/arm-board/arm_localize/benchmark/run-nph60lvw/720p_six/sample-02-crops-6kj5yp92/target_004.pgm | data-evidence | 灰度像素图 | 已纳入Git（含暂存） | 保存target_004的目标ROI裁剪；其合成/文件/实机来源及框/标签含义以data/evidence/2026-10-03-arm-localize-baseline/arm-board/arm_localize/README.md为准。 | 目录/格式与邻接文件 | 2 | 所在目录说明：data/evidence/2026-10-03-arm-localize-baseline/arm-board/arm_localize/README.md 同名配套文件：data/evidence/2026-10-03-arm-localize-baseline/arm-board/arm_localize/benchmark/run-nph60lvw/720p_six/sample-02-crops-6kj5yp92/target_004.hex
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
