never-die-cold/FPGA-Alittle-Design/tight_setup_hold_pins.txt

+====================+===================+==============================+
| Launch Setup Clock | Launch Hold Clock | Pin                          |
+====================+===================+==============================+
| sys_clk            | sys_clk           | u_if_stage/pc_id_r_reg[15]/D |
| sys_clk            | sys_clk           | u_if_stage/pc_id_r_reg[21]/D |
| sys_clk            | sys_clk           | u_if_stage/pc_id_r_reg[28]/D |
| sys_clk            | sys_clk           | u_if_stage/pc_id_r_reg[20]/D |
| sys_clk            | sys_clk           | u_if_stage/pc_id_r_reg[14]/D |
| sys_clk            | sys_clk           | u_if_stage/pc_id_r_reg[8]/D  |
| sys_clk            | sys_clk           | u_if_stage/pc_id_r_reg[24]/D |
| sys_clk            | sys_clk           | u_if_stage/pc_id_r_reg[31]/D |
| sys_clk            | sys_clk           | u_if_stage/pc_id_r_reg[25]/D |
| sys_clk            | sys_clk           | u_if_stage/pc_id_r_reg[9]/D  |
| sys_clk            | sys_clk           | u_if_stage/pc_id_r_reg[30]/D |
| sys_clk            | sys_clk           | u_if_stage/pc_id_r_reg[29]/D |
| sys_clk            | sys_clk           | u_if_stage/pc_id_r_reg[12]/D |
| sys_clk            | sys_clk           | u_if_stage/pc_id_r_reg[19]/D |
| sys_clk            | sys_clk           | u_if_stage/pc_id_r_reg[23]/D |
| sys_clk            | sys_clk           | u_if_stage/pc_id_r_reg[4]/D  |
| sys_clk            | sys_clk           | u_if_stage/pc_id_r_reg[26]/D |
| sys_clk            | sys_clk           | u_if_stage/pc_id_r_reg[1]/D  |
| sys_clk            | sys_clk           | u_if_stage/pc_id_r_reg[5]/D  |
| sys_clk            | sys_clk           | u_if_stage/pc_id_r_reg[16]/D |
| sys_clk            | sys_clk           | u_if_stage/pc_id_r_reg[18]/D |
| sys_clk            | sys_clk           | u_if_stage/pc_id_r_reg[6]/D  |
| sys_clk            | sys_clk           | u_if_stage/pc_id_r_reg[27]/D |
| sys_clk            | sys_clk           | u_if_stage/pc_id_r_reg[22]/D |
+--------------------+-------------------+------------------------------+
