never-die-cold/FPGA-Alittle-Design/report/llm_log/2026-10-15-cnn-geometry-step1.md

# 2026-10-15 协作记录：CNN 输出尺寸位宽优化

> 标签：#coprocessor #时序优化；平台：Codex；基线：`dev/model@891cba2`；未提交。

## 任务与范围

用户要求“根据以上改进建议开工”。先从已核实的 CNN 宽位算术问题拆步，
当前只实现输出尺寸计算；后续超时比较、参数缓存和重量化复用分别交付。
跨目录改动已在开工回复列明：`src/coprocessor/`、`sim/coprocessor/`、`data/logs/`、本记录。

## 设计讲解

输出尺寸仍为 `(size+2*padding-kernel)/stride+1`；合法配置的分子非负，
stride 只允许 1 或 2，所以除以 2 可以写成无符号逻辑右移。
`size` 是 7 位、kernel/stride/padding 是 2 位；采用显式拼接扩展到 8 位再加减，
避免 integer 带入 32 位有符号中间值。即使输入端出现非法参数，最大正中间值也在 8 位内。
负 span 会在无符号减法中回绕，因此启动校验中的 `size+2*padding<kernel` 必须保留。
此函数没有增加寄存器；原有状态机、CE 暂停、外部一拍同步读和完成时序保持原设计。

tb 不调用待测函数计算期望，而用 integer 公式独立计算，并从真实 start 路径检查
接受/拒绝和锁存宽高。528 组同时覆盖宽高两条路径；完整计算由既有六组黄金继续检查。
与 C02 契约 §2 的逐层形状一致，不修改整数卷积或接口语义。

## 验证与失败留痕

原 RTL + 新 tb 的六组卷积/FC、528 组启动边界已经通过。
首次 Bash PATH 配置失败、沙箱 Vivado 许可证启动失败均保留原始输出；
正常用户环境 OOC 已通过：WNS +0.118ns（旧 +0.058）、WHS +0.051ns、
LUT 9,955（旧 10,100）、DSP 192、严重 DRC 0。六组卷积/FC 的逐元素结果、
读写次数和周期数与基线完全一致；两组整网逐元素及故障恢复通过，周期均为 1,123,109。
先交付专项/OOC 时总回归仍运行；用户答题后恢复会话，已核对最终退出码 0。
全量回归 PASS；CoreMark 四档周期为 19,057,438 / 17,114,141 / 16,335,562 / 16,232,079。
证据入口：`data/logs/2026-10-15-cnn-geometry-step1/README.md`。

## 理解门槛（已通过）

1. 输出尺寸公式为 `(size+2*padding-kernel)/stride+1`（整数除法）；
   size=64、padding=1、kernel=3、stride=2 时，输出尺寸是多少？
2. 本步把中间值改为无符号数后，为什么仍要拒绝 `size+2*padding<kernel` 的配置？
3. 本步 OOC 的 DSP 仍为 192/220，是否已经满足“至少保留 20% DSP 余量”的目标？

用户完整答案：

1. **输出尺寸 = 32。** (64 + 2×1 − 3)/2 + 1 = 63/2 + 1 = 31 + 1 = 32（整除向下取整）。

2. **因为改成无符号数恰恰会把这类非法配置"算成合法"，而不是拦住它。** 当 `size + 2×padding < kernel` 时分子为负，无符号中间值会发生回绕，变成一个极大的正数，再做整除后得到一个看似正常的巨大输出尺寸，错误被静默吞掉。所以无符号化只解决"中间值溢出/表示范围"，不能替代这个前置合法性判定——该判定必须保留（用有符号比较或直接在减法之前检查），让非法配置显式失败。

3. **不满足。** 220 的 20% 是 44，要求 DSP ≤ 176；当前 192 只剩 28 个，余量 28/220 ≈ 12.7%，低于 20% 的门槛。

判定：三题通过。第 2 题补充：回绕结果未必通过其他尺寸校验；但某些配置可能回绕到小值，
不能依赖输出上界检查替代减法前的合法性判断。用户已理解关键风险，允许进入第 2 步。
尚未请求或执行 commit；后续步骤仍需各自验证与理解确认。
