never-die-cold/FPGA-Alittle-Design/report/llm_log/2026-09-14-track-guides-alignment.md

# [2026-09-14] 协作记录：选题会议材料与项目文档对齐——交叉核验与归档

> 标签：#架构决策 #赛事情报 #文档
> 平台：OpenCode ｜ 模型：opencode-go/glm-5.3-flash
> 相关 commit：本次提交（track_guides_2026_summary.md 归档、amd_track_awards.md 双源核验标注、README 参考资料增链）

## 1. 任务与初始提示词

用户提供了选题讲解会议的整理稿（对 2026 官方 7 份选题指南 PDF 共 139 页的全量提取摘要），要求：

> "这是一个赛题讲解的会议记录，阅读项目库，把这个会议的一些要求和项目库的文档对齐一下"

## 2. 模型第一版方案

通读会议记录与仓库文档（README、docs/amd_track_awards.md、docs/proposal_upgrade.md、docs/prep_checklist.md、report/llm_log/、skill/、metrics/），逐项对照。

## 3. 失败现象（真实偏差）

1. **会议记录缺决赛考核细则**：会议稿只覆盖初赛选题层面，未提及决赛 Verilog 限时上机考核（时序/状态机/计数器，不过即失评奖资格）——若只按会议材料备赛会漏掉这项硬性要求；仓库 README/HDLBits 刷题计划已覆盖，不能删。
2. **赛制依据单源**：仓库 `docs/amd_track_awards.md` §6 的 2026 赛制要点此前只有第三方转录（Qian-Sai）单一来源，标注"建议核对官方 PDF"——会议记录恰好是官方 PDF 的直接提取，可作第二来源。
3. **文件写入两次受阻**：微信目录复制的文件带只读属性，Edit 工具与 PowerShell Set-Content 均被拒绝。

## 4. 纠错轨迹

| 轮次 | 喂回的信息 | 模型诊断 | 修改内容 | 验证结果 |
|:---|:---|:---|:---|:---|
| 1 | 逐项对照表：评分权重 30/20/20/15/15、7 企业 24 选题、初级组资格与 PYNQ 推荐、协作记录/技能包强制要求、推荐目录结构 | 会议记录与项目文档**零冲突**，且反向验证了既有依据 | 无需改设计，只做情报归档与可信度标注 | ✅ 对照表全绿 |
| 2 | 会议记录未归档，7 厂商全景对比是独有情报 | 归档进 docs/ 并加头部说明（来源/用途/以官网为准） | `docs/track_guides_2026_summary.md` + README 参考资料增链 | ✅ |
| 3 | amd_track_awards §6 单源问题 | 用会议记录交叉核验后升级可信度 | §6 顶部加"2026-09-14 交叉核验：双源一致"标注 | ✅ |

## 5. 最终结论

- 会议材料与项目文档对齐完毕：**零冲突**，项目选题（AMD 自主选题·初级组）与全部准备动作（llm_log/skill/目录对照/metrics 骨架/PYNQ-Z2 合规）均被官方 PDF 摘要反向验证
- 新增 `docs/track_guides_2026_summary.md`（7 企业 24 选题全量摘要 + 头部元信息），amd_track_awards §6 升级为双源一致
- 验证方式：对照表逐项核对；文件落库后经 Read 工具复核编码正常

## 6. 经验沉淀

- 触发条件：外部会议材料/转述稿 vs 仓库既有文档的对齐任务 #skill候选
- 排查步骤：
  1. 先建**逐项对照表**再下结论，不凭印象判断"一致"
  2. 区分三类结果：一致（标注双源）、冲突（以官方原文为准）、互补（会议稿缺的细则如决赛上机考核，以仓库既有调研为准）
  3. 外部材料落库必加元信息头（来源/日期/效力声明），并从权威文档反向互链
- 适用范围：换赛题、换材料来源均成立；另：微信等外部来源文件复制入仓库后先 `attrib -r` 去只读再编辑
