never-die-cold/FPGA-Alittle-Design/docs/file-guide/sections/data-metrics.csv.md

# data-metrics.csv：逐文件说明

1个文件；返回[主页](../README.md)，完整关系见[搜索页](../index.html)或[JSON](../files.json)。

| 文件 | 一两句话说明 | 关联文件（最多展示5项） |
| --- | --- | --- |
| **data** | | |
| [data/metrics.csv](../../../data/metrics.csv)<br>软件/脚本/项目入口 · 已纳入Git（含暂存） | 汇总核/视觉指标及其测量口径和证据链接；原始日志才是复算依据，工业闭环指标仍待实测。 | 文本引用：[build/reports/soc_timing_impl.rpt](../../../build/reports/soc_timing_impl.rpt)<br>文本引用：[build/reports/soc_utilization_impl.rpt](../../../build/reports/soc_utilization_impl.rpt)<br>文本引用：[build/reports/timing_impl.rpt](../../../build/reports/timing_impl.rpt)<br>文本引用：[build/reports/utilization_impl.rpt](../../../build/reports/utilization_impl.rpt)<br>所在目录说明：[data/README.md](../../../data/README.md)<br>另30项见搜索页 |
