never-die-cold/FPGA-Alittle-Design/results/README.md

# 历史软件实验结果

本目录保存原型模型的逐图评估与训练结果，用于说明模型开发过程。它不作为当前模型的独立精度报告。
当前 r6 的输入、模型和数值对照见 [CNN r6 包](../data/evidence/2026-10-28-cnn-r6/README.md)，验收状态见[主计划](../plan.md#31-当前状态)。
