never-die-cold/FPGA-Alittle-Design/data/evidence/2026-10-13-ddr-experiment-inputs/README.md

# 2026-10-13-ddr-experiment-inputs

> 状态：**PROVENANCE GAP**（整理时未找到该目录的原始 README；以下仅写可核实的目录事实，来源/结论/负责人待原执行人补充）。
> 日期：未知

## 目录事实

- 文件数：8
- 大小：45.7 KB
- 顶层条目（前 8 个）：
- `config-first/`
- `first/`
- `recover.py`

## 待补

- [ ] 这份证据要证明什么
- [ ] 来源（commit/外包包/本机工作区）
- [ ] 输入与 sha256
- [ ] 校验命令与结果
- [ ] 能证明什么、不能证明什么

> 补全后删除本目录的 `PROVENANCE GAP` 标记，并运行 `python sim/scripts/index_runs.py --write` 刷新索引。
