never-die-cold/FPGA-Alittle-Design/report/llm_log/2026-10-12-n02-n03-return-tests.md

# 2026-10-12 N02/N03 临时板端测试

用户在串口连通与原 vision 恢复后要求继续。本步重新阅读 workflow、三人清单、主计划和核计划/接口，确认 `dev/model@3e2e1c9`，保留已有暂存和未暂存改动。使用已有硬件入口，不修改 RTL 或脚本，不提交/推送。

原 vision 帧首监视三段各 240.1 秒，累计 720.3 秒，均正常结束且没有记录 NO_VIDEO/BUSY。六次间隔 UVC 读取各 24 帧并保存一张 PNG；同一位流重载和 smoke 均 PASS，重载后 UVC 再读 24 帧成功。boot_id 保持一致。完整原始命令和状态见 [N02 证据](../../data/logs/2026-10-12-n02-extended/README.md)。

随后运行已有 N03 base 共存入口：板端识别 1280×720×24bpp、报告模式 60fps；2 次 warmup、1 次完整 BGR 副本、6 次重复读取并释放。读取与副本耗时 24.352ms；20 秒 HDMI OUT 共存窗口内 UVC 采集完成，BOARD_EXIT/UVC_EXIT 均 0，HDMI IN/OUT 关闭完整。原 vision 恢复及 smoke 通过。原图传输、双哈希和最终状态见 [N03 证据](../../data/logs/2026-10-12-n03-base-return/README.md)。

用户明确纠正：这只是测试，距离、背景、光照等不作为最终标准。已按临时诊断保存，没有冻结 N04、写入正式数据集或代签采集条件。原图中出现紧固件也不自动成为正式训练/标定样本。

无代码修改；属于古法技能的数据/文档记录豁免。未执行提交。冷启动、断源/重连、长时间寿命、颜色和动态无混帧对拍仍待测；安全 custom DDR、CNN RTL、核工业固件及真实 LIVE 闭环仍未实现/未接入。
