never-die-cold/FPGA-Alittle-Design/report/llm_log/2026-10-10-q01-result-fields.md

# 2026-10-10 协作记录：Q01 结果报文字段校验

> 标签：#vision #bug修复 #验证
> 平台：Codex desktop
> 相关commit：基线aa23206；实现时未提交，首答及补测已通过。

## 1. 任务与初始提示词

用户无硬件，要求开始执行离板待办。第一步补Q01结果字段白名单及负例测试，单步不超过100行代码。
跨目录范围：src/pynq_host、sim/vision、docs、data/logs、report/llm_log，开工已说明。

## 2. 模型第一版方案

顶层字段按D6固定，目标字段仅target_id/bbox。新增非法对象与未知字段拒绝；既有类型、坐标和必填校验继续执行。
实现新增32行/删除2行（不含随后文档和证据）；测试已有统一回归入口，无需修改脚本。

## 3. 失败现象

新增负例对旧代码退出1：AssertionError: invalid packet fields accepted。
修复后沙箱运行字段测试PASS，但本地HTTP被WinError 10013阻止；该失败保留，不当作完整通过。

## 4. 纠错轨迹

授权环境通过既有仓库脚本复跑八组回归，退出0；3个合法/12个非法报文用例通过。
原始日志：data/logs/2026-10-10-q01-result-fields/。

## 5. 最终结论

本步结束时字段白名单工作区实现与离板回归完成，尚未提交。当时 LIVE、正式分类、共用ROI和工业闭环仍未实现。
用户要求继续离板工作后，共享 ROI 和 FP32 文件回放已实现/验证，见后续 offline-inspection 记录；其余正式/板端事项仍未完成。

## 理解门槛：逐段讲解

PACKET_FIELDS是顶层允许出现的字段名集合，TARGET_FIELDS是每个目标允许的字段名集合。
frozenset使这两份约定不可被运行时增删。set(packet)取得实际字段名，减去白名单后剩下的就是未知字段。
先检查是不是dict（JSON对象对应Python字典），再访问.get；用or短路避免对None、列表或字符串错误调用字典接口。
顶层与目标分开校验，避免合法的targets容器内夹带未约定信息。
白名单限制“可以出现什么”，不强迫所有允许字段都出现；trigger_ref仍可省略，空targets也合法。
现有必填字段、类型、uint32、时间戳、目标上限、重复编号与坐标边界校验继续执行。
未知class/verdict也被白名单拒绝，因此删除原先仅拒绝这两个名字的特殊分支。
测试先验证3个合法输入保持原对象，再测试顶层/目标的未知字段及非对象输入，要求抛出对应ValueError。
先对旧代码运行同一测试取得FAIL，再用修复代码取得PASS，证明负例能发现这次缺口。

## 理解门槛：题目与当前状态

1. 报文顶层完全合法，但targets[0]多出score字段，只检查顶层会怎样？本次哪一层会拦住它？
2. 为什么使用“实际字段减白名单”，而不是要求实际字段集合完全等于白名单？省略trigger_ref时会有什么区别？
3. 为什么先检查输入是dict？若输入为None且删除这项检查，会出现什么异常，与预期ValueError有什么区别？

用户此前明确要求“理解题等到最后一起出给我吧”，按此继续离板实现，题目在本轮末集中。
当前首轮已答：第1、2题通过；第3题在明确删除范围后的补测36通过，理解门槛已满足。
完整用户答案、判定和补测见[首轮理解核对](2026-10-10-offline-understanding-round1.md)。
提交门槛仍保留：未经理解确认不得提交。后续共享 ROI / 文件回放的实现、讲解与问题见当日 offline-inspection 记录。

## 6. 经验沉淀

请求字段校验不能替代响应字段校验；嵌套对象也须遵循各自字段契约。保留修复前FAIL与修复后PASS作为回归证据。
