never-die-cold/FPGA-Alittle-Design/report/llm_log/2026-10-08-exe-result-age-flap.md

# 2026-10-08 协作记录：时间戳"产生顺序/时钟域"错误——实机 flap（人工测试先于自动化发现）

> 标签：#vision #bug修复 #skill候选
> 平台：ZCode ｜ 模型：GLM-5.3-Flash
> 相关 commit：dev/exe 本批（received_at 新鲜度 + preview 取钟 + 回归断言）

## 1. 任务与初始提示词

① 人工按键验证（用户实操）：运行 mock 服务 + 打包 EXE，窗口内按 `c` 两次验证批次记录路径。

## 2. 第一版方案（有缺陷，已推送过 1809dc1）

D3 新鲜度：`0 <= now - packet["created_at"] <= max_age`；preview 在循环开头取一次 `now`，
`poll(now)` 与 `overlay(now)` 共用；`created_at` 由服务端在请求处理中盖章。

## 3. 失败现象（用户实操暴露，非自动化测试）

按键记录本身成功（2 条批次记录 ✓），但 `anomalies.jsonl` 在 ~2.5 分钟记录了 **576 条**
`overlay_stale`↔`overlay_ok` 往返：每轮自动轮询（0.5s）翻转一次。窗口模式下对应现象：
横幅每轮闪一帧"等待结果"。

## 4. 纠错轨迹

| 轮次 | 喂回的信息 | 模型诊断 | 修改内容 | 验证结果 |
|:---|:---|:---|:---|:---|
| 1 | 576 条 stale/ok 往返日志 + 时间戳链路复盘 | **时间戳产生顺序错**：`now` 在"请求前"取，`created_at` 在"请求中"盖章 → `age = now - created_at < 0` → 被判超龄；下一帧新取钟即恢复 → 翻转。更深层：跨机（板卡/Pi 与笔记本）时钟根本不同源，用服务端时间戳算新鲜度在架构上就是错的 | ① 新鲜度改按 **EXE 接收时刻**（poll 采纳报文时 `received_at = time.time()`，本地时钟自洽，无下界问题）；② preview 在 poll 后用**新取的时刻**调 overlay（与请求前节流钟分离）；③ 记录加 `created_at` 原始戳 + `result_age_s` 传 EXE 时基 | ✅ 单元回归（"请求前的 now 评估刚采纳报文不得判超龄"）；✅ 实机复核：同命令 22 轮仅 1 条初始事件、零 stale（before 576 → after 1） |

## 5. 最终结论

新鲜度 = EXE 本地接收时基；`created_at` 只作诊断字段。回归 7/7 + 打包重建三关 PASS；
证据 `data/logs/2026-10-08-exe-anomalies/manual-key-run/`（before/after 日志对照）。

## 6. 经验沉淀

#skill候选
- 触发条件：任何"比较两个时间戳"的判据（新鲜度/超时/排序），只要两个戳由不同代码位置、
  不同机器或不同请求阶段产生。
- 排查步骤：画一张"谁在什么时刻盖的章"时序图；**比较前先确认两者的产生顺序与时钟域**；
  跨机比较一律换成"本地观测时基"（收包时刻）；对共享的循环变量（如循环开头的 `now`）
  问一句"它在跨 I/O 后还成立吗"。
- 附加教训：日志/事件系统上线当天就会把潜伏缺陷显形——老代码同缺陷只表现为静默闪帧，
  没人发现；该类"日志卫生"也应作为回归断言（本次已加）。
- 适用范围：换题换板成立（分布式/联调系统通用）。
