never-die-cold/FPGA-Alittle-Design/results/images/empty_gradient-0.png

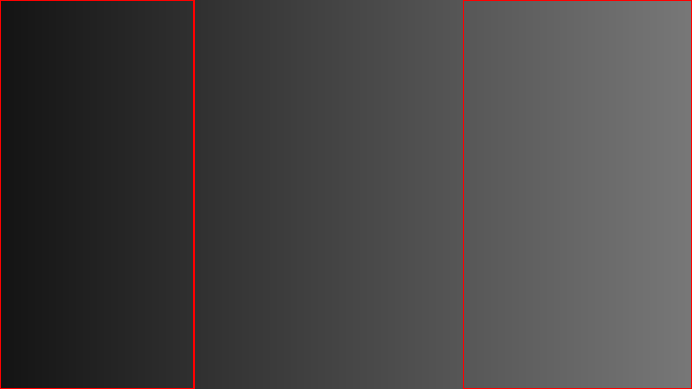
results/images/empty_gradient-0.png
