never-die-cold/FPGA-Alittle-Design/results/images/empty_gradient-1.png

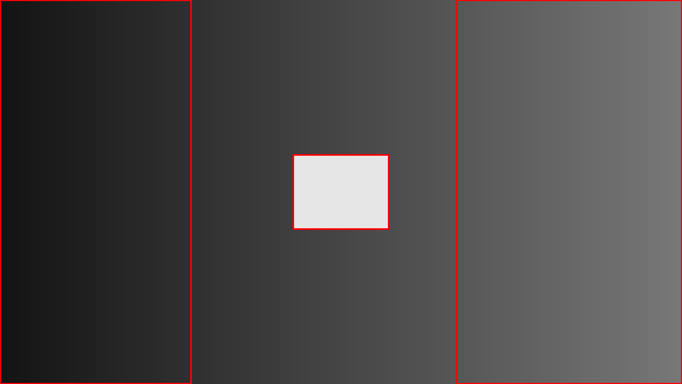
results/images/empty_gradient-1.png
