never-die-cold/FPGA-Alittle-Design/results/images/empty_uniform-1.png

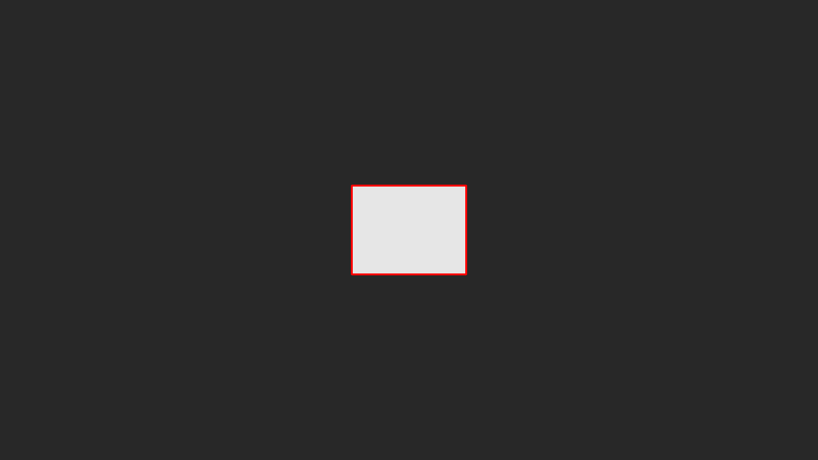
results/images/empty_uniform-1.png
