never-die-cold/FPGA-Alittle-Design/docs/closeout-todo.md

# 项目收口待办（无日期版）

> 用法：**全表不写日期**，只按依赖顺序排列。每完成一项，把 `⬜/🟡` 改成 `✅`，并在
> `data/logs/<主题>/` 留退出码 + 原始日志 + README 六要素。判据写"能从仓库内入口复现"，
> 不写"看起来对"。
> 口径：`✅` 已有仓库内证据；`🟡` 部分完成或只在离板环境成立；`⬜` 未开始；
> `⛔` 本轮冻结（无板卡/无真实数据），**不得改写成通过**。
> 与 [主计划](../plan.md) 的关系：本表只排"到收尾还剩什么"，不复制 M2–M4 排期与验收条款。

## 0. 当前基线（改状态前先核对）

| 事实 | 值 |
|:---|:---|
| 工作分支 | `main` @ `cfbded8`（PR #86–#89 已合并） |
| 协处理器状态 | J04a ✅ 实现/离板冒烟；J04b 🟡 影子 bank 与整机 40 MHz 综合实现门禁已过，任务描述表、结果 DMA 与板验未完成（[模块计划](../src/coprocessor/plan.md)） |
| 未决 OPEN | OPEN-2..11（OPEN-1 影子 bank 部分关闭、板验仍开；OPEN-12 的 100 MHz 卡点已关闭），见[交接单](runbooks/coprocessor-j04-handoff.md) §7 |
| 板卡 | ⛔ 受阻（2026-10-26 起 SD/mmc I/O 故障待恢复；10-23/10-25/10-26 上板与构建记录见 `data/logs/2026-10-23-board-bringup/`、`data/logs/2026-10-25-dma16-board/`、`data/logs/2026-10-26-board/`） |
| 真实数据 | ⛔ 无（`data/datasets/` 不存在） |
| 本机工具 | Vivado 2026.1、MSYS2 `riscv32-unknown-elf-gcc` 14.2、Icarus 13.0、Python 3.12.10 |

## A. 本轮可做（离板，不需要板卡/数据）

- [x] **A01 本表落库并挂到导航**：`docs/README.md` 与 `docs/runbooks/README.md` 能点进来。
- [x] **A02 离板回归（分段）**：核 20 个 TB + 协处理器 `all`、`run_coprocessor_python.sh all`、
      `run_vision_iverilog.sh all`、`run_vision_python.sh` 各自退出 0，证据在
      `data/logs/2026-10-19-j04-closeout/`。**未单次跑完** `run_iverilog.sh all`：它在 CoreMark
      四档基准处长仿真，本轮主动中止（核 RTL 未改动）。
- [x] **A03 J04 审查修复**：状态口径拆 J04a/J04b、交接单迁移并重算指纹、Windows 可移植性、
      `CFG_VALID` 撤销、固件 READY/RESULT_SEQ/超时门禁、连续两笔任务的 stale-`done` 竞态。
- [x] **A04 证据重建**：`data/logs/2026-10-19-j04-closeout/` 的 Windows 全量/单项日志与
      `cop_job.hex/dis` 指纹按修复后代码重算。
- [x] **A05 文档一致性扫尾**：`docs/`、`src/*/README.md`、`report/` 里不得再有"J04 已完成"
      或指向 `9fdd035` 等失效锚点的表述；`git grep` 一遍关键词收口。
- [ ] **A06 仓库卫生**（部分完成：`git diff --check` 干净、生成物不入库；日志索引仍需按 `repo-hygiene.md` 再扫一遍）：生成物不入库、`*.hex/*.dis` 只留证据类、日志 README 六要素齐全，
      按 [仓库卫生](repo-hygiene.md) 自查。
- [ ] **A07 PR 与基线**：PR [#86](https://github.com/never-die-cold/FPGA-Alittle-Design/pull/86) 已开，待评审合并；合并后在 `main` 打基线 tag 并回填本节。：`dev/riscv` → `main` 开 PR（不 force push），审完合并；合并后在
      `main` 打基线 tag，并把 tag 写进交接单 §2 锚点行。

## B. 硬件与综合（不都需要板卡）

> **B05/B06 现在就能做**：CDC/AXI 深测是纯仿真，综合/实现/时序/DRC 只要本机 Vivado（已装）。
> 其余项才等板卡。

- [ ] **B01 首个硬件网络**：J02 诊断权重在实体 BRAM 上跑通，结果对齐 `logits=04fd02 class=2 margin=2`。
- [ ] **B02 payload 物理 bank 适配**（OPEN-1）：DataMover → 各 bank 的地址/位宽适配，真实
      36,032 B payload 逐字节比对 + CRC 负例。
- [ ] **B03 结果外搬**（OPEN-2）：`RESULT_ADDR` 结果 DMA，16×16 B 窗口与 DMA 内容互校。
- [ ] **B04 SoC + 固件端到端**：`soc_top` 打开 `ENABLE_COP`，RISC-V 固件门禁（READY/CFG/MODEL/
      RESULT_SEQ）在真实总线上跑通；该路径已由 `firmware_e2e` TB 行为验证（START→ACCEPTED→终态→
      结果/PSCONSUME），板上连续作业仍未验证。
- [ ] **B05 CDC/AXI 深测**（OPEN-4/7）：AXI 面已补 AW/W 乱序、B/R 背压、SLVERR、单笔未完成与复位；
      仍欠 **CDC 异步相位扫描、复位中途、payload 稳定性**。**可离板**，纯仿真。
- [x] **B06 综合/实现/时序/DRC（cop_top OOC 部分）**：`build/build_cop.tcl` 已跑通，0 critical DRC；
      LUT 6,308、FF 7,256、DSP 136、BRAM 0；`cop_clk` 10 ns WNS **+0.165 ns**（≈101.7 MHz，达标）。
      中途发现并修掉 loader CRC32 的 13 级组合树（OPEN-12，证据 `data/logs/2026-10-19-cop-synth/`）。
      整机 40 MHz 综合实现门禁与位流已过（edge-fix bit `9341F7FA…`，见 `data/logs/2026-10-26-build/README.md`）；仍欠：整机 XSim 对拍与板级验收。
- [ ] **B07 上板复验**：位流/固件/模型 SHA256 与源码锚定，NC 执行、JL 不代签。

## C. 需要真实数据与模型（数据到货后）

- [ ] **C01 数据集与标注**：`data/datasets/` 落地，留出集与工位采集口径写进 manifest。
- [ ] **C02 正式 INT8 模型**（J05/J06）：PTQ/QAT、阈值、正式黄金；诊断网络不能当交付模型。
- [ ] **C03 首网硬件输出**（J07）：固定输入 → 硬件结果 = 模型黄金，误差口径写清。
- [ ] **C04 整机包**（J08）：算子诊断包 → 首网包 → 整机包，三包各自 SHA256 与可复现构建。
- [ ] **C05 真实精度报告**：留出集混淆矩阵、漏检/误检，禁止用 `prototype` 数字充验收。

## D. 软件与交付（可先离板推进）

- [ ] **D01 W04 后端适配**：取帧/MMIO/推理/配置/状态驱动；base 与 custom 后端差异显式。
- [ ] **D02 W05 正式 PS 服务**：capture/check 关联、幂等、原子落盘、版本、HTTP 异常。
- [ ] **D03 W06 EXE 差额**：LIVE 类别/分数/工单、PROTOTYPE 标识、检查快照；四种来源清晰区分。
- [ ] **D04 W07 记录与导出**：原 decision、来源、版本、时间、唯一轮次；重复/失败不增合法记录。
- [ ] **D05 W08 联合离板回归**：正常/缺多错料/复检/坏报文/旧结果/重启/断联全覆盖。
- [ ] **D06 W09 发布包**：Windows 包 + 板端包 + 依赖锁定 + 安装手册；干净机器能起。
- [ ] **D07 N01–N14 场景矩阵**：25 例只算起点，工业场景实测由 NC 在实机跑。

## E. 材料与验收

- [ ] **E01 演示与复现**：演示视频、一键复现脚本、Skill 提炼（`#skill候选` → `skill/`）。
- [ ] **E02 报告与提交材料**：技术报告、证据索引、参赛提交件对齐 AMD 3.3.3.1/3.3.5.3。
- [ ] **E03 三人签收**：[收口清单](project-closeout-three-person-checklist.md) 逐项签字，
      未验证项写进"未实现/未验收"清单。
- [ ] **E04 终局复验**：`main` 上重跑 A02 全量 + B06 报告核对，证据与 tag 对齐。

## F. 本轮冻结项（诚实收口，写进交付记录，不得宣称通过）

- ⛔ **F01 板端任何结论**：无板卡 → 不写"已上板""已联调""实机通过"。
- ⛔ **F02 真实识别精度**：无真实数据 → `prototype`/诊断黄金不得写成工业识别结果。
- ⛔ **F03 综合与时序**：除已有的控制器 OOC 历史证据外，不宣称整机 100 MHz 或资源结论。
- ⛔ **F04 正式模型包/位流**：J05–J08 未完成前，不发布"正式"包，不写"可交付 NC 上板"。

## 判定口径（避免伪通过）

1. 退出码 0 **且** 日志里有该用例的 `PASS:` 行；两者缺一不算。
2. 负向用例必须能"去掉修复就 FAIL"，否则只是没测到（见 `cop_top` 的 done 保护拍对照）。
3. 冒烟 PASS ≠ 完整验证；离板 PASS ≠ 板端通过；仿真 ≠ 综合。
4. 任何"已验证"都能由仓库内 tb/脚本一键复现，临时文件不算证据。
