never-die-cold/FPGA-Alittle-Design/report/llm_log/2026-09-21-narrative-architecture-fix.md

# [2026-09-21] 协作记录：README 架构自相矛盾 + 应用叙事穿帮 + 自研核论证缺失——三项修复与核对比计划立项

> 标签：#架构 #叙事 #riscv #指标
> 平台：OpenCode ｜ 模型：opencode-go/glm-5.3-flash
> 相关文件：README.md、board/hardware.md、docs/core_comparison.md（新增）、src/riscv/plan.md
> 用途：赛前文档体检发现的三处硬伤，评委答辩前必须修复

## 1. 任务与初始提示词

对项目做"挑错挑刺"式体检（对标往届国奖作品），随后针对发现的三个问题给出修复方案并执行：

1. README:87 宣传"行缓存直通、零 DDR 帧缓存依赖"（借鉴 Ultra-Vision），但 README:45-62 架构图画着 `PRE → AXI-Stream/DMA → DDR 帧缓冲 → SOC → OSD → HDMI OUT`——文档内部自相矛盾
2. 应用故事写"工业预检、智能门禁、桌面分拣"，但 board/hardware.md 承认 PYNQ-Z2 无 USB 主机口、实际源是笔记本 HDMI——答辩第一问"门禁现场从哪里接 HDMI"即穿帮
3. README:39 回答"为什么自研核"只有备赛叙事（"考察点有硬内容"），无可量化论证，且芯片上有双核 A9

## 2. 模型第一版方案

- 问题 1：重画架构图为"双路径"——显示/预处理路径零 DDR（行缓存直通），推理路径按需快照（RISC-V 发快照命令，缩放后 KB 级小图进片上 BRAM，CNN 在静态小图上推理，结果寄存器回 OSD）；"零 DDR 帧缓存依赖"精确化为"零逐帧 DDR 回写"
- 问题 2：三档修法（手机转 HDMI / 中档 HDMI 相机或树莓派源 / 纯改叙事）；应用定位改为"片上可交互视觉分析仪"；CNN 目标改为"HDMI 画面字符/数字识别"（与 MNIST 难度相当但演示闭环字面成立）
- 问题 3：给出同器件公开数据对比（PicoRV32 regular ~904 LUT 但 CPI 4–5 / E203 4153 LUT）+ EX 级协处理器耦合论证 + 裁剪代价分析，并立项 CoreMark 实测与 PicoRV32 同工具同器件 OOC 对比

## 3. 失败现象（初版方案的问题）

1. 初版架构图 mermaid 节点嵌套有误（SOC 节点同时当子图名与连线端点），连线语义混乱
2. 初版"为什么自研"段落引用了未实测的 CoreMark 数字——违反项目自身"禁止先写目标后凑数据"铁律；修正为标注"计划口径占位、数据入档后刷新"，并把风险预案写死（CoreMark/MHz < 0.5 则撤回性能话术）

## 4. 用户决策（2026-09-21 逐条确认）

| 决策点 | 结论 |
|:---|:---|
| 问题 1 修法 | 文档处理（双路径架构图 + 口径精确化） |
| 问题 2 修法 | **中档**：用已有板卡（树莓派/另一块 Zynq-7020/ESP32）+ 新购 HDMI 摄像头/相机作正式演示源；笔记本 HDMI 降级为开发调试源 |
| 问题 3 基准 | **只做 CoreMark**（不做 Dhrystone）；仿真跑分用 **iverilog**；PicoRV32 性能数据**引用官方公开口径**不重跑 |
| 排期 | dmem/imem 扩容 + SoC 计时计数器归 **Part A 收口（9/27 前，RTL 线）**；CoreMark 移植 9/28–10/4（基准线，与 Part B/C 并行）；PicoRV32 对比 **M1 收口后 10/5–10/8（验证线）** |

## 5. 最终结论与落盘清单

- README：架构图改双路径（直通显示 + 片上快照推理）、标题/一句话简介/背景定位改为"片上可交互视觉分析仪"、模块二/三口径同步（快照小图、HDMI 字符识别）、"为什么自研核"三段数据论证（占位标注）、指标表增 CoreMark 行
- board/hardware.md：演示链路改为"HDMI 摄像头/相机 = 正式源，笔记本 = 调试源"，采购清单增 HDMI 摄像头项与树莓派备选，已有板卡入清单
- docs/core_comparison.md（新增）：执行决策表、参照数据表（含口径警示）、指标定义（CoreMark/MHz、CoreMark/LUT、约束递减收敛法）、四项风险预案、产出物清单
- src/riscv/plan.md：Part A 收口增存储扩容 + 计时计数器两项（CoreMark 硬依赖）；基准线周 2 增 CoreMark 移植启动；Part C 增 CoreMark 四档实测；新增 §4.4 PicoRV32 对比（10/5–10/8，验证线）
- 待办：metrics.csv 增 CoreMark 骨架行；仓库卫生（backup.jou、skill/ 重复、IP 脱敏）

## 6. 经验沉淀

- 触发条件：对外宣传"架构 A 优于架构 B"时，自查架构图/接口描述是否仍按架构 B 画 #skill候选
- 排查步骤：
  1. 把 README 中每个"卖点形容词"（零 DDR、实时、可测）对照架构图与硬件清单逐一验证
  2. 应用叙事的演示链路要能在答辩现场用实物复原（谁提供画面、画面里是什么）
  3. 性能对比引用外部数据必须同时记录口径（综合 vs 实现、器件、速度级、约束方法）
- 适用范围：成立；所有"文档先行"的竞赛项目通用
