never-die-cold/FPGA-Alittle-Design/data/logs/2026-10-27-startup-clock-repair/uvc-after-service/raw.png

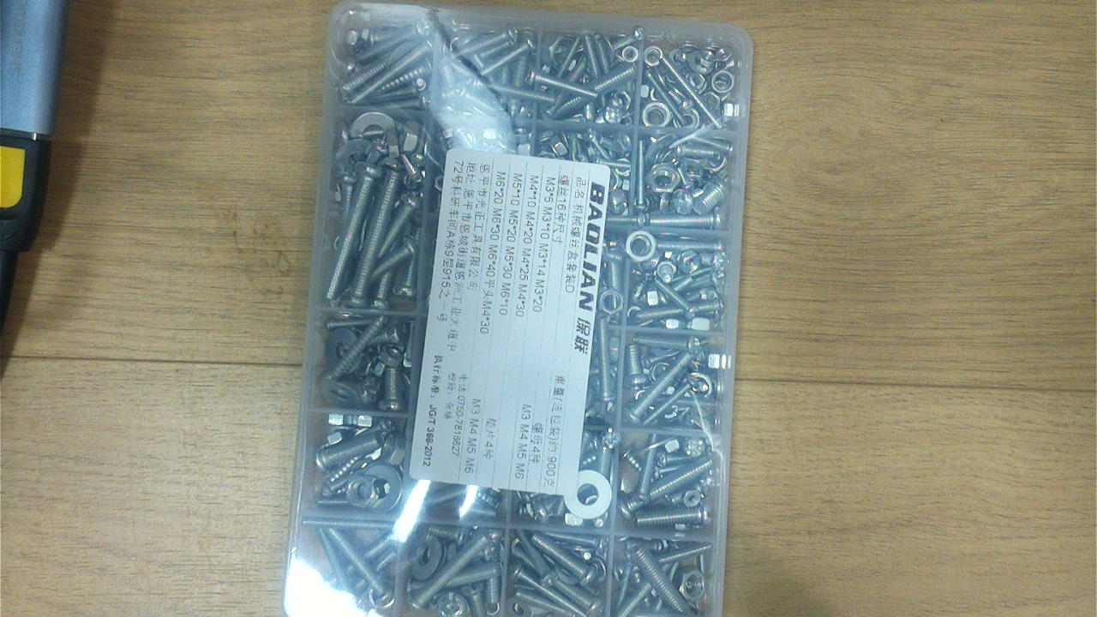
data/logs/2026-10-27-startup-clock-repair/uvc-after-service/raw.png
