never-die-cold/FPGA-Alittle-Design/data/logs/2026-10-15-onboard-n02-n03/exe-diff-stat.txt

 docs/c01-ddr-frame-ownership-v0.md                 |  26 +++
 docs/coprocessor-integration-v0.md                 |  23 ++
 docs/fastener-collection-handoff.md                |   3 +-
 docs/fastener-data-collection-protocol.md          |   4 +-
 docs/fastener-dataset-audit.md                     |  29 ++-
 docs/vision-live-semantics.md                      |  18 +-
 .../2026-10-12-w08-joint-regression-real-engine.md |  51 +++++
 report/llm_log/2026-10-13-nc-checklist-response.md |  49 +++++
 .../llm_log/2026-10-13-w02-audit-gt-orientation.md |  51 +++++
 .../llm_log/2026-10-13-w04-c01-capture-adapter.md  |  50 +++++
 sim/scripts/run_vision_python.sh                   |   2 +-
 sim/vision/generate_dataset_audit_fixture.py       |   8 +-
 sim/vision/test_base_captures.py                   | 134 ++++++++++++
 sim/vision/test_c01_backend.py                     | 241 +++++++++++++++++++++
 sim/vision/test_dataset_audit.py                   |  19 +-
 sim/vision/test_dataset_manifest.py                |  50 ++++-
 sim/vision/test_vision_export.py                   |   4 +-
 sim/vision/test_vision_live_service.py             |  24 +-
 sim/vision/test_vision_records.py                  |  26 ++-
 src/pynq_host/README.md                            |  17 ++
 src/pynq_host/base_captures.py                     |  52 +++++
 src/pynq_host/c01_backend.py                       |  49 +++++
 src/pynq_host/dataset_audit.py                     |  22 +-
 src/pynq_host/dataset_manifest.py                  |  59 ++++-
 src/pynq_host/round_artifacts.py                   |  71 ++++++
 src/pynq_host/vision_live_service.py               |  12 +-
 src/vision_client/README.md                        |   6 +-
 src/vision_client/export_records.py                |  14 +-
 src/vision_client/records.py                       |  25 ++-
 29 files changed, 1096 insertions(+), 43 deletions(-)
