never-die-cold/FPGA-Alittle-Design/data/logs/2026-10-13-ddr-single-frame/onboard-config-first.txt

HOST_STARTED_UTC=2026-10-12T17:16:52.9814349Z
PORT=COM12 BAUD=115200 8N1 NO_FLOW
COMMAND=sudo -n bash -c 'source /etc/profile.d/xrt_setup.sh && source /etc/profile.d/pynq_venv.sh && export C01_BIT=/home/xilinx/vision_m2/c01-ab75f5d26f8747418c4b6b0fd83995cd/capture.bit && python3 -u /home/xilinx/vision_m2/c01-38950ebeddc24b89ae0b76aeffd4369e/c01_ddr_onboard.py'
sudo -n bash -c 'source /etc/profile.d/xrt_setup.sh && source /etc/profile.d/pynq_venv.sh && export C01_BIT=/home/xilinx/vision_m2/c01-ab75f5d26f8747418c4b6b0fd83995cd/capture.bit && python3 -u /home/xilinx/vision_m2/c01-38950ebeddc24b89ae0b76aeffd4369e/c01_ddr_onboard.py'; printf '\n__PYNQ_RC_4939d09f2e93487eb34cb48f0d7bc3fa=%d\n' $?
[?2004l
STAGE: HWH metadata parse before programming
STAGE: HWH layout accepted; candidate download begins
STAGE: candidate download returned
R11 busy=0 R12 applied=0
NOVIDEO: commit 未在帧首确认——寄存器通路 OK 但无输入视频（查 HDMI IN 源/线材）
MAIN-FAIL: SystemExit(3)
ip_dict:
  pipe @ 0x40000000 range 0x10000
  ps7 @ 0x00000000 range 0x0
axi_regs 段: pipe @ 0x40000000
PASS: load
STAGE: original vision loaded; bounded settle before smoke
R11 busy=0 R12 applied=0
commit 配置号=1 status={'busy': False, 'applied_config_id': 1}
PASS: smoke（视频在位，帧首整组应用已确认）
RESULT: {"boot_before": "2d61ca6a-03dc-4628-88e3-1203ac8b0e3c", "bit_sha256": "86d2adb0343de1785270d207eee3c6b8fee2a6444bc64705bc068e3fc781d14f", "hwh_sha256": "eaaf68c3732f1a2bf85756fc0b3a8c6b07bb5cf5b36f32020882860a6aaebf5c", "driver_sha256": "0d250e3ad6940440934412acf02690fb8d9072dcfeb4c76517069f8d7aae1a7a", "kind": "CUSTOM_DDR_SINGLE_FRAME_EXPERIMENT_NOT_FORMAL_N03", "ok": false, "main_error": "SystemExit(3)", "restored": true, "boot_after": "2d61ca6a-03dc-4628-88e3-1203ac8b0e3c"}

__PYNQ_RC_4939d09f2e93487eb34cb48f0d7bc3fa=3
[?2004hxilinx@pynq:/$ 
HOST_EXIT_CODE=3
