never-die-cold/FPGA-Alittle-Design/data/logs/2026-10-13-ddr-single-frame/upload-config-first-c01_capture.py.txt

SOURCE=src/pynq_host/c01_capture.py
TARGET=/home/xilinx/vision_m2/c01-38950ebeddc24b89ae0b76aeffd4369e/c01_capture.py
SHA256=0d250e3ad6940440934412acf02690fb8d9072dcfeb4c76517069f8d7aae1a7a
BASE64_SENT=3576
saved=$(stty -g); (trap 'stty "$saved"' EXIT; stty raw -echo; timeout --foreground -k 3s 180s python3 -c 'import base64,gzip;exec(gzip.decompress(base64.b64decode("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")));receive(3576,8792,"0d250e3ad6940440934412acf02690fb8d9072dcfeb4c76517069f8d7aae1a7a","/home/xilinx/vision_m2/c01-38950ebeddc24b89ae0b76aeffd4369e/c01_capture.py","__UART_5f79ea9ab5fc4d348d91565a17e57f43")'); printf '\n__UART_5f79ea9ab5fc4d348d91565a17e57f43_EXIT=%d\n' $?
[?2004l
__UART_5f79ea9ab5fc4d348d91565a17e57f43_READY
PASS: UART file /home/xilinx/vision_m2/c01-38950ebeddc24b89ae0b76aeffd4369e/c01_capture.py 8792 0d250e3ad6940440934412acf02690fb8d9072dcfeb4c76517069f8d7aae1a7a

__UART_5f79ea9ab5fc4d348d91565a17e57f43_EXIT=0
[?2004hxilinx@pynq:/$ 
