never-die-cold/FPGA-Alittle-Design/src/riscv/soc_top.v

// soc_top.v —— PL 侧 SoC 顶层外壳：核 + 指令 BRAM + 数据 RAM + 计时计数器 + LED 驱动
// 接口与上板冒烟契约见 src/riscv/design_v0.md §5.8
module soc_top #(
    parameter IMEM_INIT_FILE = "src/riscv_fw/hello_v0.hex",
    parameter DMEM_INIT_FILE = "src/riscv_fw/hello_v0.hex",
    parameter ENABLE_FORWARDING = 1'b1,
    parameter [1:0] BHT_MODE = 2'd0,
    parameter ENABLE_COP = 1'b0,
    parameter [31:0] COP_BASE = 32'h8001_0000
) (
    input  wire       clk,
    input  wire       rst_n,
    output wire [3:0] led,
    input wire [31:0] cop_rdata_i,
    output wire cop_hit_o, cop_we_o,
    output wire [31:0] cop_addr_o, cop_wdata_o,
    output wire [3:0] cop_be_o
);

    localparam [31:0] TIMER_ADDR = 32'h8000_8000;

    wire [31:0] imem_addr;
    wire [31:0] imem_rdata;
    wire [31:0] dmem_addr;
    wire [31:0] dmem_wdata;
    wire [31:0] dmem_rdata;
    wire [31:0] dmem_rdata_ram;
    wire [3:0]  dmem_be;
    wire        dmem_we;
    wire        timer_hit;
    wire        cop_hit;
    reg  [31:0] cycle_cnt;
    reg  [3:0]  led_q;

    assign led = led_q;

    // MMIO 计时计数器（32KB 数据区间外）：同拍只读；写被忽略且不落 DMEM
    assign timer_hit  = (dmem_addr == TIMER_ADDR);
    assign cop_hit = ENABLE_COP && dmem_addr[31:12] == COP_BASE[31:12];
    assign cop_hit_o = cop_hit;
    assign cop_we_o = cop_hit && dmem_we;
    assign cop_addr_o = ENABLE_COP ? dmem_addr : 32'd0;
    assign cop_wdata_o = ENABLE_COP ? dmem_wdata : 32'd0;
    assign cop_be_o = ENABLE_COP ? dmem_be : 4'd0;
    assign dmem_rdata = timer_hit ? cycle_cnt : cop_hit ? cop_rdata_i : dmem_rdata_ram;

    core_top #(
        .ENABLE_FORWARDING(ENABLE_FORWARDING),
        .BHT_MODE(BHT_MODE)
    ) u_core (
        .clk(clk), .rst_n(rst_n),
        .imem_addr(imem_addr), .imem_rdata(imem_rdata),
        .dmem_addr(dmem_addr), .dmem_wdata(dmem_wdata),
        .dmem_be(dmem_be), .dmem_we(dmem_we), .dmem_rdata(dmem_rdata)
    );

    imem #(.INIT_FILE(IMEM_INIT_FILE)) u_imem (
        .clk(clk), .addr(imem_addr), .rdata(imem_rdata)
    );

    // 哈佛双口加载：DMEM 预载同一镜像（.data 初值 / .rodata），见 design_v0.md §5.8
    dmem #(.INIT_FILE(DMEM_INIT_FILE)) u_dmem (
        .clk(clk), .we(dmem_we && !timer_hit && !cop_hit), .be(dmem_be),
        .addr(dmem_addr), .wdata(dmem_wdata), .rdata(dmem_rdata_ram)
    );

    always @(posedge clk or negedge rst_n) begin
        if (!rst_n)
            cycle_cnt <= 32'd0;
        else
            cycle_cnt <= cycle_cnt + 32'd1;
    end

    always @(posedge clk or negedge rst_n) begin
        if (!rst_n)
            led_q <= 4'b0000;
        else if (dmem_we && (dmem_addr == 32'h8000_3FF0))
            led_q <= dmem_wdata[3:0];
    end

endmodule
