never-die-cold/FPGA-Alittle-Design/data/evidence/2026-10-13-soc-reset-ce/baseline/src/riscv/muldiv.v

// muldiv.v —— RV32M 多拍乘除单元：启动握手与操作数锁存
// 接口见 src/riscv/design_v0.md §5.6、§6.6
module muldiv (
    input  wire        clk,
    input  wire        rst_n,
    input  wire [2:0]  op,
    input  wire        start,
    input  wire [31:0] a,
    input  wire [31:0] b,
    output reg  [31:0] result,
    output reg         busy,
    output reg         done
);

    reg [2:0]  op_r;
    reg [31:0] a_r;
    reg [31:0] b_r;
    reg [4:0]  count;
    reg [63:0] product_acc;
    reg [63:0] multiplicand;
    reg [31:0] multiplier;
    reg        product_neg;
    reg [31:0] quotient_work;
    reg [32:0] remainder_work;
    reg [31:0] divisor_r;
    reg        quotient_neg;
    reg        remainder_neg;

    wire a_signed = (op == 3'b001) || (op == 3'b010);
    wire b_signed = (op == 3'b001);
    wire [31:0] a_magnitude = (a_signed && a[31]) ? (~a + 32'd1) : a;
    wire [31:0] b_magnitude = (b_signed && b[31]) ? (~b + 32'd1) : b;
    wire [63:0] product_addend = (multiplier[1:0] == 2'b00) ? 64'd0 :
                                 (multiplier[1:0] == 2'b01) ? multiplicand :
                                 (multiplier[1:0] == 2'b10) ? (multiplicand << 1) :
                                 (multiplicand + (multiplicand << 1));
    wire [63:0] product_sum = product_acc + product_addend;
    wire [63:0] final_product = product_neg ?
                                (~product_sum + 64'd1) : product_sum;
    wire div_signed = (op == 3'b100) || (op == 3'b110);
    wire [31:0] dividend_magnitude = (div_signed && a[31]) ?
                                     (~a + 32'd1) : a;
    wire [31:0] divisor_magnitude = (div_signed && b[31]) ?
                                    (~b + 32'd1) : b;
    wire [32:0] remainder_shift = {remainder_work[31:0], quotient_work[31]};
    wire quotient_bit = remainder_shift >= {1'b0, divisor_r};
    wire [32:0] remainder_next = quotient_bit ?
                                 (remainder_shift - {1'b0, divisor_r}) : remainder_shift;
    wire [31:0] quotient_next = {quotient_work[30:0], quotient_bit};
    wire [31:0] final_quotient = (divisor_r == 32'd0) ? 32'hFFFF_FFFF :
                                 (quotient_neg ? (~quotient_next + 32'd1) : quotient_next);
    wire [31:0] final_remainder = remainder_neg ?
                                  (~remainder_next[31:0] + 32'd1) : remainder_next[31:0];

    always @(posedge clk or negedge rst_n) begin
        if (!rst_n) begin
            op_r   <= 3'b000;
            a_r    <= 32'd0;
            b_r    <= 32'd0;
            count  <= 5'd0;
            product_acc <= 64'd0;
            multiplicand <= 64'd0;
            multiplier   <= 32'd0;
            product_neg  <= 1'b0;
            quotient_work <= 32'd0;
            remainder_work <= 33'd0;
            divisor_r     <= 32'd0;
            quotient_neg  <= 1'b0;
            remainder_neg <= 1'b0;
            result <= 32'd0;
            busy   <= 1'b0;
            done   <= 1'b0;
        end else begin
            done <= 1'b0;

            if (start && !busy) begin
                op_r  <= op;
                a_r   <= a;
                b_r   <= b;
                count <= 5'd0;
                busy  <= 1'b1;
                product_acc <= 64'd0;
                multiplicand <= {32'd0, a_magnitude};
                multiplier   <= b_magnitude;
                product_neg  <= (a_signed && a[31]) ^ (b_signed && b[31]);
                quotient_work <= dividend_magnitude;
                remainder_work <= 33'd0;
                divisor_r     <= divisor_magnitude;
                quotient_neg  <= div_signed && (a[31] ^ b[31]);
                remainder_neg <= div_signed && a[31];
            end else if (busy) begin
                if (op_r[2]) begin
                    quotient_work <= quotient_next;
                    remainder_work <= remainder_next;
                end else begin
                    product_acc <= product_sum;
                    multiplicand <= multiplicand << 2;
                    multiplier   <= multiplier >> 2;
                end
                if ((op_r[2] && count == 5'd31) ||
                    (!op_r[2] && count == 5'd15)) begin
                    if (!op_r[2])
                        result <= (op_r == 3'b000) ?
                                  final_product[31:0] : final_product[63:32];
                    else
                        result <= op_r[1] ? final_remainder : final_quotient;
                    busy   <= 1'b0;
                    done   <= 1'b1;
                end else begin
                    count <= count + 5'd1;
                end
            end
        end
    end

endmodule
