never-die-cold/FPGA-Alittle-Design/sim/coprocessor/tb_cnn_sequencer.v

`timescale 1ns/1ps
module tb_cnn_sequencer #(parameter USE_BRAM=0, parameter USE_PAYLOAD=0);
    reg clk=0,rst_n=0,ce=1,start=0,force_pause=0;
    reg [7:0] min_margin;
    reg [31:0] cycle_limit=2000000;
    wire ready,busy,done,error,low_conf;
    wire [2:0] error_layer;
    wire [31:0] cycles;
    wire [1:0] classification,read_bank,write_bank;
    wire [7:0] margin,parameter_address;
    wire [14:0] score;
    wire [23:0] logits;
    wire memory_enable,weight_enable,parameter_enable,write_enable;
    wire [15:0] read_address,weight_address,write_address;
    wire [63:0] write_data;
    reg [63:0] input_data;
    reg [1023:0] weight_data;
    reg [511:0] bias_data,multiplier_data;
    reg [95:0] shift_data;
    reg init_we=0; reg [2:0] init_kind=0; reg [15:0] init_address=0; reg [63:0] init_data=0;
    wire [63:0] bram_input; wire [1023:0] bram_weight;
    wire [511:0] bram_bias,bram_multiplier; wire [95:0] bram_shift;
    wire [1023:0] payload_weight; wire [511:0] payload_bias,payload_multiplier;
    wire [95:0] payload_shift;
    wire [63:0] selected_input=USE_BRAM ? bram_input : input_data;
    wire [1023:0] selected_weight=USE_PAYLOAD ? payload_weight : (USE_BRAM ? bram_weight : weight_data);
    wire [511:0] selected_bias=USE_PAYLOAD ? payload_bias : (USE_BRAM ? bram_bias : bias_data);
    wire [511:0] selected_multiplier=USE_PAYLOAD ? payload_multiplier : (USE_BRAM ? bram_multiplier : multiplier_data);
    wire [95:0] selected_shift=USE_PAYLOAD ? payload_shift : (USE_BRAM ? bram_shift : shift_data);
    reg [7:0] roi [0:4095];
    reg [63:0] ping [0:4095],pong [0:2047],gap [0:7];
    reg [1023:0] weights [0:268];
    reg [31:0] biases [0:159],multipliers [0:159];
    reg [5:0] shifts [0:159];
    reg [7:0] payload [0:36031];
    reg [63:0] golden [0:16392];
    reg visited [0:16392];
    integer written=0,reads=0,weight_reads=0,parameter_reads=0,tb_cycles=0,fault=0;
    integer lane,index,position,fd,fields,cls_expected,margin_expected,score_expected,low_expected,threshold;
    integer found,faults;
    integer payload_count,crc_expected;
    reg [4095:0] model_folder,folder,filename,payload_filename;
    reg payload_start=0,stream_valid=0,stream_last=0; reg [63:0] stream_data=0;
    wire stream_ready,dma_write,dma_done,dma_error,adapter_ready,adapter_init_we,adapter_init_bank;
    wire adapter_commit,adapter_error,adapter_loading,model_active,model_valid;
    wire [31:0] dma_addr,dma_bytes,dma_crc; wire [63:0] dma_store_data;
    wire [7:0] dma_strb; wire [2:0] adapter_init_kind; wire [15:0] adapter_init_address;
    wire [63:0] adapter_init_data;
    always #5 clk=~clk;
    always @(negedge clk) begin tb_cycles=tb_cycles+1; ce=!force_pause && (tb_cycles%7)!=3; end
    cnn_sequencer dut (.clk(clk),.rst_n(rst_n),.ce(ce),.start(start),.abort(1'b0),.min_margin(min_margin),
        .cycle_limit(cycle_limit),.ready(ready),.busy(busy),.done(done),.error(error),.error_layer(error_layer),
        .cycles(cycles),.result_class(classification),.result_margin(margin),.result_score(score),
        .result_low_conf(low_conf),.result_logits(logits),.memory_enable(memory_enable),.weight_enable(weight_enable),
        .parameter_enable(parameter_enable),.read_bank(read_bank),.read_address(read_address),
        .weight_address(weight_address),.parameter_address(parameter_address),.input_data(selected_input),
        .weight_data(selected_weight),.bias_data(selected_bias),.multiplier_data(selected_multiplier),.shift_data(selected_shift),
        .write_enable(write_enable),.write_bank(write_bank),.write_address(write_address),.write_data(write_data));
    cop_bram_storage bram(.clk(clk),.rst_n(rst_n),.init_we_i(init_we),.init_kind_i(init_kind),
        .init_address_i(init_address),.init_data_i(init_data),.read_enable_i(memory_enable),
        .read_bank_i(read_bank),.read_address_i(read_address),.weight_enable_i(weight_enable),
        .weight_address_i(weight_address),.parameter_enable_i(parameter_enable),
        .parameter_address_i(parameter_address),.write_enable_i(write_enable),.write_bank_i(write_bank),
        .write_address_i(write_address),.write_data_i(write_data),.input_data_o(bram_input),
        .weight_data_o(bram_weight),.bias_data_o(bram_bias),.multiplier_data_o(bram_multiplier),
        .shift_data_o(bram_shift));
    cop_dma_loader payload_loader(.clk(clk),.rst_n(rst_n),.start_i(payload_start),
        .expected_bytes_i(32'd36032),.stream_data_i(stream_data),.stream_keep_i(8'hff),
        .stream_valid_i(stream_valid),.stream_last_i(stream_last),.store_ready_i(adapter_ready),
        .stream_ready_o(stream_ready),.store_write_o(dma_write),.store_addr_o(dma_addr),
        .store_data_o(dma_store_data),.store_strb_o(dma_strb),.busy_o(),.done_o(dma_done),
        .error_o(dma_error),.short_o(),.bytes_received_o(dma_bytes),.crc32_o(dma_crc));
    cop_payload_adapter payload_adapter(.clk(clk),.rst_n(rst_n),.start_i(payload_start),
        .commit_i(dma_done && dma_crc==crc_expected),.abort_i(dma_error),
        .payload_base_i(32'd0),.payload_bytes_i(32'd36032),.store_write_i(dma_write),
        .store_addr_i(dma_addr),.store_data_i(dma_store_data),.store_strb_i(dma_strb),
        .active_bank_i(model_active),.store_ready_o(adapter_ready),.init_we_o(adapter_init_we),
        .init_bank_o(adapter_init_bank),.init_kind_o(adapter_init_kind),
        .init_address_o(adapter_init_address),.init_data_o(adapter_init_data),.shadow_bank_o(),
        .commit_o(adapter_commit),.error_o(adapter_error),.loading_o(adapter_loading));
    cop_model_storage model_store(.clk(clk),.rst_n(rst_n),.init_we_i(adapter_init_we),
        .init_bank_i(adapter_init_bank),.commit_i(adapter_commit),.commit_bank_i(adapter_init_bank),
        .init_kind_i(adapter_init_kind),.init_address_i(adapter_init_address),.init_data_i(adapter_init_data),
        .weight_enable_i(weight_enable),.parameter_enable_i(parameter_enable),
        .weight_address_i(weight_address),.parameter_address_i(parameter_address),
        .active_bank_o(model_active),.model_valid_o(model_valid),.weight_data_o(payload_weight),
        .bias_data_o(payload_bias),.multiplier_data_o(payload_multiplier),.shift_data_o(payload_shift));
    always @(posedge clk or negedge rst_n) begin
        if(!rst_n) begin input_data<=0; weight_data<=0; bias_data<=0; multiplier_data<=0; shift_data<=0; end
        else begin
            if(memory_enable) begin
                if(!USE_BRAM) case(read_bank)
                    0: begin if(read_address>=4096) $fatal(1); input_data<={56'd0,roi[read_address]}; end
                    1: begin if(read_address>=4096) $fatal(1); input_data<=ping[read_address]; end
                    2: begin if(read_address>=2048) $fatal(1); input_data<=pong[read_address]; end
                    3: begin if(read_address>=8) $fatal(1); input_data<=gap[read_address]; end
                endcase
                if(fault==3 && !weight_enable && read_bank==1) input_data<=64'h80;
                reads=reads+1;
            end
            if(weight_enable) begin
                if(weight_address>=269) $fatal(1);
                if(!USE_BRAM) weight_data<=weights[weight_address]; weight_reads=weight_reads+1;
            end
            if(parameter_enable) begin
                parameter_reads=parameter_reads+1;
                if(parameter_address+15>=160) $fatal(1);
                if(!USE_BRAM) for(lane=0;lane<16;lane=lane+1) begin
                    bias_data[lane*32 +: 32]<=biases[parameter_address+lane];
                    multiplier_data[lane*32 +: 32]<=fault==1 ? 0 : multipliers[parameter_address+lane];
                    shift_data[lane*6 +: 6]<=shifts[parameter_address+lane];
                end
            end
            if(write_enable) begin
                position=dut.layer*4096+write_address;
                if(write_bank==3) position=16384+write_address;
                else if(dut.layer==4) position=16392;
                if(position>16392 || visited[position] || fault==1
                    || write_data!==golden[position]) begin
                    $display("FAIL: network layer=%0d bank=%0d addr=%0d data=%h expected=%h",dut.layer,write_bank,write_address,write_data,golden[position]); $fatal(1);
                end
                if(!USE_BRAM) case(write_bank)
                    1: begin if(write_address>=4096) $fatal(1); ping[write_address]=write_data; end
                    2: begin if(write_address>=2048) $fatal(1); pong[write_address]=write_data; end
                    3: begin if(write_address>=8) $fatal(1); gap[write_address]=write_data; end
                    default: $fatal(1);
                endcase
                visited[position]=1; written=written+1;
            end
        end
    end
    task launch;
        begin
            written=0; reads=0; weight_reads=0; parameter_reads=0;
            for(index=0;index<=16392;index=index+1) visited[index]=0;
            @(negedge clk); #1; while(!ready) begin @(negedge clk); #1; end
            start=1; @(posedge clk); #1; start=0;
        end
    endtask
    task put_bram; input [2:0] kind; input [15:0] address; input [63:0] data;
        begin @(negedge clk); init_kind=kind; init_address=address; init_data=data; init_we=1;
            @(posedge clk); #1; end
    endtask
    task load_bram;
        begin
            for(index=0;index<512;index=index+1) begin
                for(lane=0;lane<8;lane=lane+1) init_data[lane*8 +: 8]=roi[index*8+lane];
                put_bram(0,index,init_data);
            end
            if(!USE_PAYLOAD) begin
                for(index=0;index<269;index=index+1)
                    for(lane=0;lane<16;lane=lane+1)
                        put_bram(1,index*16+lane,weights[index][lane*64 +: 64]);
                for(index=0;index<160;index=index+1) begin
                    put_bram(2,index,{32'd0,biases[index]});
                    put_bram(3,index,{32'd0,multipliers[index]}); put_bram(4,index,{58'd0,shifts[index]});
                end
            end
            @(negedge clk); init_we=0;
        end
    endtask
    task load_payload;
        begin
            fd=$fopen(payload_filename,"rb"); if(!fd) $fatal(1);
            payload_count=$fread(payload,fd); $fclose(fd); if(payload_count!=36032) $fatal(1);
            @(negedge clk); payload_start=1; @(posedge clk); #1; @(negedge clk); payload_start=0;
            for(index=0;index<36032;index=index+8) begin
                while(!stream_ready) @(negedge clk);
                for(lane=0;lane<8;lane=lane+1) stream_data[lane*8 +: 8]=payload[index+lane];
                stream_last=index==36024; stream_valid=1;
                @(posedge clk); #1; @(negedge clk); stream_valid=0; stream_last=0;
            end
            while(!model_valid && !dma_error && !adapter_error) @(posedge clk);
            #1; if(!model_valid || dma_bytes!=36032 || dma_crc!=crc_expected) $fatal(1);
            $display("PASS: payload_network manifest payload -> DMA -> shadow BRAM -> atomic activate; bytes=36032 crc32=%08x",dma_crc);
        end
    endtask
    task finish_run;
        input expect_error;
        begin
            while(busy) begin @(posedge clk); #1; end
            if(error!==expect_error || done!==!expect_error) $fatal(1);
            if(!expect_error) begin
                if(written!=9225 || reads!=103432 || weight_reads!=101384 || parameter_reads!=10
                    || logits!==golden[16392][23:0] || classification!==cls_expected[1:0]
                    || margin!==margin_expected[7:0] || score!==score_expected[14:0] || low_conf!==low_expected[0]) begin
                    $display("FAIL: final network writes=%0d reads=%0d weight_reads=%0d class=%0d margin=%0d logits=%h",
                        written,reads,weight_reads,classification,margin,logits); $fatal(1);
                end
            end
        end
    endtask
    task check_watchdog;
        integer budget, paused, elapsed;
        begin
            for(paused=0;paused<2;paused=paused+1)
            for(budget=0;budget<=40;budget=budget+1) begin
                cycle_limit=budget; launch; force_pause=paused; cycle_limit=0; elapsed=0;
                while(busy) begin
                    if(cycles==budget-1 && (memory_enable || weight_enable || parameter_enable || write_enable)) $fatal(1);
                    @(posedge clk); #1; elapsed=elapsed+1;
                end
                if(error!==1'b1 || done || elapsed!=budget || cycles!==budget || written
                    || (budget!=0 && error_layer!=7) || (paused && (reads || weight_reads))) begin
                    $display("FAIL: network watchdog budget=%0d paused=%0d elapsed=%0d cycles=%0d",budget,paused,elapsed,cycles); $fatal(1);
                end
                force_pause=0;
            end
            cycle_limit=2000000;
            $display("PASS: cnn_sequencer watchdog 82 exact-cycle cases; CE pause, latched budget and terminal strobes");
        end
    endtask
    initial begin
        found=$value$plusargs("model=%s",model_folder); if(!found) $fatal(1);
        found=$value$plusargs("case=%s",folder); if(!found) $fatal(1); faults=$test$plusargs("fault_tests");
        if(USE_PAYLOAD) begin
            found=$value$plusargs("payload=%s",payload_filename); if(!found) $fatal(1);
            found=$value$plusargs("crc=%h",crc_expected); if(!found) $fatal(1);
        end
        $sformat(filename,"%0s/weights.hex",model_folder); $readmemh(filename,weights,0,268);
        $sformat(filename,"%0s/bias.hex",model_folder); $readmemh(filename,biases,0,159);
        $sformat(filename,"%0s/multipliers.hex",model_folder); $readmemh(filename,multipliers,0,159);
        $sformat(filename,"%0s/shifts.hex",model_folder); $readmemh(filename,shifts,0,159);
        $sformat(filename,"%0s/input.hex",folder); $readmemh(filename,roi,0,4095);
        $sformat(filename,"%0s/conv1.hex",folder); $readmemh(filename,golden,0,2047);
        $sformat(filename,"%0s/conv2.hex",folder); $readmemh(filename,golden,4096,8191);
        $sformat(filename,"%0s/conv3.hex",folder); $readmemh(filename,golden,8192,9215);
        $sformat(filename,"%0s/conv4.hex",folder); $readmemh(filename,golden,12288,14335);
        $sformat(filename,"%0s/gap.hex",folder); $readmemh(filename,golden,16384,16391);
        $sformat(filename,"%0s/logits.hex",folder); $readmemh(filename,golden,16392,16392);
        $sformat(filename,"%0s/result.txt",folder); fd=$fopen(filename,"r"); if(!fd) $fatal(1);
        fields=$fscanf(fd,"%d %d %d %d %d\n",cls_expected,margin_expected,score_expected,low_expected,threshold);
        $fclose(fd); if(fields!=5) $fatal(1); min_margin=threshold;
        if(USE_BRAM) load_bram;
        repeat(3) @(negedge clk); rst_n=1;
        if(USE_PAYLOAD) load_payload;
        if($test$plusargs("watchdog_only")) begin check_watchdog; $finish; end
        launch; finish_run(0);
        $display("PASS: cnn_sequencer %0s all 9225 packed words/73795 elements match integer network; logits=%h class=%0d margin=%0d cycles=%0d",
            folder,logits,classification,margin,cycles);
        if(faults) begin
            check_watchdog;
            fault=1; launch; finish_run(1); if(written || error_layer!=0) $fatal(1);
            fault=0; cycle_limit=2; launch; finish_run(1); if(written || error_layer!=7) $fatal(1); cycle_limit=2000000;
            launch; repeat(15) @(negedge clk); rst_n=0; #1;
            if(busy || done || error || memory_enable || write_enable) $fatal(1);
            repeat(3) @(negedge clk); rst_n=1;
            fault=3; launch; finish_run(1); if(error_layer!=5 || written!=9216) $fatal(1);
            fault=0; launch; finish_run(0);
            $display("PASS: cnn_sequencer invalid parameters/watchdog/reset/invalid GAP and successful fresh run; no false DONE");
        end
        $finish;
    end
    initial begin #50000000; $display("FAIL: network test timeout"); $fatal(1); end
endmodule
