never-die-cold/FPGA-Alittle-Design/sim/vision/test_vision_rounds.py

"""轮次叠加状态机（src/vision_client/rounds.py）离线测试——D2/D3/D5 撤框与 D8 手动触发。

运行在真实 mock 服务（本地回环）上，不依赖 cv2/窗口：
触发节流、手动触发标记与防抖、超龄撤框、配置不符撤框、断联（连续失败）撤框且不崩溃、
服务重启（新会话）自动恢复。
"""
import sys
import threading
import time
import urllib.request
from pathlib import Path
from unittest.mock import patch

root = Path(__file__).resolve().parents[2]
sys.path.insert(0, str(root / "src/pynq_host"))
sys.path.insert(0, str(root / "src/vision_client"))
from vision_mock_service import make_server
from rounds import AsyncRemoteRounds, RemoteRounds, WAITING, http_json


def start_server(port):
    server = make_server(port=port)
    threading.Thread(target=server.serve_forever, daemon=True).start()
    return server


def main():
    server = start_server(0)
    port = server.server_port
    base = f"http://127.0.0.1:{port}"
    try:
        remote = RemoteRounds(base, max_age=1.0)
        status = remote.handshake()
        assert status["mode"] == "MOCK" and remote.expected_config == 1
        assert remote.overlay(time.time()) == (False, WAITING)
        now = time.time()
        # D2：到点触发一轮；新鲜结果叠加（MOCK 模式不受 hardware_connected=false 影响）
        remote.poll(now, 0.5)
        assert remote.packet["check_id"] == 1 and not remote.last_round_manual
        # 回归（2026-10-08 实机 flap）：用"请求前取的钟"评估刚采纳的报文不得误判超龄
        assert remote.overlay(now)[0]
        current, label = remote.overlay(time.time())
        assert current and label.startswith("ROUND 1 |") and "2 targets" in label
        # 节流：间隔内不重复触发；过间隔后触发（last_trigger 记"尝试"时刻）
        remote.poll(now + 0.1, 0.5)
        assert remote.packet["check_id"] == 1
        remote.poll(now + 0.6, 0.5)
        assert remote.packet["check_id"] == 2
        # D8：手动触发立即发起（不等间隔）、标记记录候选；防抖忽略高频重复
        assert remote.trigger(now + 0.65) is True
        assert remote.trigger(now + 0.7) is False
        remote.poll(now + 0.7, 0.5)
        assert remote.packet["check_id"] == 3 and remote.last_round_manual
        remote.poll(now + 1.2, 0.5)
        assert remote.packet["check_id"] == 4 and not remote.last_round_manual
        # D3：结果超龄撤框（新鲜度按 EXE 接收时刻计量）
        remote.received_at = time.time() - 1.5
        assert remote.overlay(time.time()) == (False, WAITING)
        # D3：服务端配置变化 → 新结果配置号不符撤框；重握手后恢复
        urllib.request.urlopen(urllib.request.Request(
            base + "/v1/config", b'{"control":3}', {"Content-Type": "application/json"}), timeout=2)
        remote.poll(now + 1.8, 0.5)
        assert remote.packet["config_id"] == remote.expected_config + 1
        assert remote.overlay(time.time()) == (False, WAITING)
        remote.handshake()
        remote.poll(now + 2.4, 0.5)
        assert remote.packet["config_id"] == remote.expected_config
        assert remote.overlay(time.time())[0]
        # D5：断联 → 连续失败达限撤框，且重握手失败不外泄异常
        server.shutdown()
        server.server_close()
        assert remote.trigger(now + 2.9) is True  # 断联中的手动触发
        remote.poll(now + 3.0, 0.5)  # 该手动轮失败（fails=1）
        assert not remote.last_round_manual  # 残留旧报文不得冒充手动轮结果（D8 采纳点语义）
        for step in (3.6, 4.2):
            remote.poll(now + step, 0.5)
        assert remote.fails >= 3
        assert remote.overlay(time.time()) == (False, WAITING)
        # D5：服务恢复（新会话）→ 自动重握手（本轮不采纳报文）→ 下轮恢复叠加
        server = start_server(port)
        remote.poll(now + 4.8, 0.5)
        assert remote.packet is None and remote.expected_config == 1
        remote.poll(now + 5.4, 0.5)
        current, label = remote.overlay(time.time())
        assert current and label.startswith("ROUND ") and "2 targets" in label
        # D11：异常事件队列覆盖 状态迁移/会话变化/重握手失败
        kinds = {event["kind"] for event in remote.drain_events()}
        assert {"overlay_stale", "overlay_config", "overlay_outage", "overlay_ok",
                "session_changed", "rehandshake_failed"} <= kinds
    finally:
        server.shutdown()
        server.server_close()
    print("PASS: round overlay trigger/throttle/manual/stale/config-change/outage/session-recovery/events")
    server = start_server(0)
    release, entered = threading.Event(), threading.Event()
    remote = AsyncRemoteRounds(f"http://127.0.0.1:{server.server_port}", max_age=1.0)
    calls = []
    def delayed(url, body=None):
        if url.endswith("/v1/check"):
            calls.append(body)
            entered.set()
            assert release.wait(3), "test worker was not released"
        return http_json(url, body)
    try:
        remote.handshake()
        with patch("rounds.http_json", side_effect=delayed):
            started = time.perf_counter()
            remote.poll(time.time(), 60)
            assert time.perf_counter() - started < .5
            assert entered.wait(1)
            assert remote.manual_in_flight is False  # 首轮为自动轮
            assert remote.trigger(time.time())
            assert remote.manual_pending is True
            for _ in range(30):
                remote.poll(time.time(), 60)
                remote.overlay(time.time())
            assert len(calls) == 1, "concurrent network checks"
            release.set()
            deadline = time.monotonic() + 3
            while remote.packet is None or remote.packet["check_id"] != 2:
                remote.poll(time.time(), 60)
                assert time.monotonic() < deadline
                time.sleep(.005)
            assert remote.last_round_manual and len(calls) == 2
            assert calls[0] == {} and "trigger_ref" in calls[1]  # 手动轮携唯一 trigger_ref
            assert remote.manual_in_flight is False  # 采纳后手动轮在飞标记清除
            entered.clear(); release.clear(); remote.last_trigger = 0
            remote.poll(time.time(), 60)
            assert entered.wait(1)
            remote.received_at = time.time() - 2
            assert remote.overlay(time.time()) == (False, WAITING)
            release.set()
            remote.close(wait=True)
    finally:
        release.set(); remote.close(wait=True)
        server.shutdown(); server.server_close()
    print("PASS: async GUI polling remains responsive, queues manual checks, expires stale overlays and closes")


if __name__ == "__main__":
    main()
