never-die-cold/FPGA-Alittle-Design/data/evidence/cnn-ddr-offline-cdfbf6823fe24cfe8015449a9b0da708/inputs/sim/coprocessor/tb_mac_array_pipeline.v

`timescale 1ns/1ps
module tb_mac_array_pipeline;
    reg clk=0,rst_n=0,ce=1,abort=0,in_valid=0;
    reg [63:0] activation_lanes=0;
    reg [1023:0] weight_lanes=0;
    reg [511:0] accumulator_lanes=0;
    wire [511:0] result_lanes;
    wire [15:0] overflow;
    wire out_valid;
    reg [511:0] expected[0:299],held_result;
    reg [15:0] expected_overflow[0:299],held_overflow;
    reg held_valid;
    reg signed [63:0] total;
    integer seed=32'h31a9,trial,i,o,sent=0,received=0;
    always #5 clk=~clk;
    mac_array_pipeline dut (.clk(clk),.rst_n(rst_n),.ce(ce),.abort(abort),.in_valid(in_valid),
        .activation_lanes(activation_lanes),.weight_lanes(weight_lanes),.accumulator_lanes(accumulator_lanes),
        .result_lanes(result_lanes),.overflow(overflow),.out_valid(out_valid));
    always @(posedge clk) if(rst_n && !abort) begin
        if(ce && in_valid) begin
            for(o=0;o<16;o=o+1) begin
                total=$signed(accumulator_lanes[o*32 +: 32]);
                for(i=0;i<8;i=i+1) total=total+$signed(activation_lanes[i*8 +: 8])*$signed(weight_lanes[(o*8+i)*8 +: 8]);
                expected[sent][o*32 +: 32]=total[31:0];
                expected_overflow[sent][o]=total>64'sd2147483647 || total < -64'sd2147483648;
            end
            sent=sent+1;
        end
        #1;
        if(ce && out_valid) begin
            if(received>=sent || result_lanes!==expected[received] || overflow!==expected_overflow[received]) begin
                $display("FAIL: MAC pipeline item=%0d",received); $fatal(1);
            end
            received=received+1;
        end
        if(!ce && {out_valid,overflow,result_lanes}!=={held_valid,held_overflow,held_result}) $fatal(1);
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
