never-die-cold/FPGA-Alittle-Design/(commit log)

2026-09-04 docs: 更新 README 为 EdgeSight 融合方案，新增大模型协作记录(llm_log)规范与模板
    - README: 三选题融合为 RISC-V SoC + HDMI 预处理 + CNN 协处理器，补充协作记录落地流程
    - report/llm_log: 新增记录规范 README 与单条记录模板 template.md（AMD 赛道 3.3.3.1 要求）
2026-09-04 docs: 新增分类资料清单 docs/resources.md，README 参考资料节链接并列出核心必读
2026-09-04 chore: 按 README 目录结构搭建仓库骨架（src/sim/sw/build/board/data/skill/report 占位 README）
2026-09-04 docs: 新增开工前准备清单 prep_checklist.md（环境/报名/刷题，可勾选分工）
2026-09-04 docs(llm_log): 第一条协作记录——选题决策与三方案融合的纠错轨迹（如实记录，无仿真类内容）
2026-09-04 docs: 新增新队友上手指南 onboarding.md（Git/Markdown/Agent/文档阅读顺序/本周学习任务），README 顶部加入口
2026-09-04 docs: onboarding 去掉本周学习任务节，先聚焦搞懂项目本身
2026-09-04 docs:添加LibJiang 的Git学习记录
2026-09-08 docs: 模块一 RISC-V 核三部分分工与学习路线（plan.md），resources 新增第 9 节学习路线资料清单
2026-09-08 docs(llm_log+resources): 野火 ZYNQ7020 前置验证板协作记录与 resources 第 10 节
    - llm_log: 2026-09-08 PYNQ-Z2 未到货期间评估野火板前置验证的完整纠错轨迹（含两轮纠偏：脱离项目上下文作答、工作区文档滞后于仓库）
    - resources 第 10 节: 两板差异速查、分模块适用性（模块一完全适用/模块二需接口抽象层/模块三无影响/PS 上位机过渡方案）、上板准备清单、参考链接
    - prompt 要点: 对比野火 ZYNQ7020 与 PYNQ-Z2 差异；先读项目文档再回答；模块一是否用到该板
2026-09-09 新建 idea1.md，项目初步结束后和机器人交叉融合的一个想法
2026-09-11 docs(riscv): 合并 Kimi 排期草稿入 plan.md（9/14-10/4 日粒度执行排期，替换里程碑对齐节；plan1 不保留）
2026-09-11 chore: 添加 .gitignore（Vivado/XSim 生成物，保留 report/ 原始日志与 hex/coe 预载文件）
2026-09-11 fix(docs): idea1 md 重命名为 idea1.md 并补齐行尾换行
2026-09-11 chore: 添加 MIT LICENSE（README 已引用）
2026-09-11 docs: README 开发计划 M1 对齐 plan.md 执行排期（9/14-10/4）并挂链接
2026-09-11 docs: 添加 GitHub Issue 模板（bug 报告 / 任务待办）
2026-09-11 docs(onboarding): 补充 Issue 使用约定与纪律（第五步：bug/卡点/待办）
2026-09-11 docs: 修正 idea1.md 降级策略表为合法 Markdown 表格
2026-09-11 feat(sim): 收录 RV32I 汇编码<->机器码自测脚本（修复 3 类编码 bug：U 型立即数、移位指令编解码；修正 10 条错误期望值，现 ALL OK）
2026-09-11 docs: 按赛题指南整理仓库结构（根目录两人 Git 记录移入 docs/git_learning/，README 补目录对照说明）
2026-09-11 docs(llm_log): 2026-09-11 plan1 合并、三仓库对账与仓库结构合规整理
2026-09-11 chore(metrics): 按赛题指南建立 metrics/ 骨架（metrics.csv 表头 + logs/scripts/evidence）
    [metrics.csv]
2026-09-11 docs(llm_log): 2026-09-11 Vivado 版本决策——2026.1 授权模式变化调研，选 2025.2（结论同步 issue #2）
2026-09-11 feat(sw): 收录 RV32IM 冒烟固件与 Makefile+bin2hex 构建流程（统一 MSYS2 riscv32-unknown-elf 工具链）
2026-09-11 docs(verify): 工具链统一 MSYS2 riscv32-unknown-elf 并记录验证（issue #4 闭环）
2026-09-11 docs(verify): 跳过野火板前置验证（issue #3 取消），M1 上板顺延至 PYNQ-Z2 到货
2026-09-11 docs(riscv): 冻结 v0 接口设计——RV32I 两级流水模块划分与信号/控制真值表
2026-09-11 feat(sim): iverilog 冒烟 tb 骨架与一键脚本（接口对齐 design_v0，暂不依赖 Vivado）
2026-09-11 docs: Vivado 统一 2025.2，prep_checklist 收敛（板子/Vivado 移交 issue，负责人挂 never-die-cold）
2026-09-11 docs(llm_log): 2026-09-11 v0 接口冻结与 iverilog 过渡仿真决策记录
2026-09-11 test(sw): 新增 v0 核 RV32I 冒烟固件 hello_v0（保留 RV32IM hello 待补 M）
2026-09-11 feat(riscv): pc 与 regfile 模块（复位向量 0x80000000，x0 恒 0）
2026-09-11 feat(riscv): alu 与 decode（RV32I 控制真值表 + M 扩展接口预留）
2026-09-11 fix(sw): tohost 结果值与 tohost_exit 退出码分离，避免 start.S 覆盖 main 结果
2026-09-11 feat(riscv): if_stage 与 core_top 两级流水连通，iverilog 冒烟 hello_v0 首次 PASS
2026-09-11 docs(riscv): 同步 v0 实现修正——if_stage pc/pc_id 语义、复位气泡与冒烟判据
2026-09-11 docs(llm_log): 2026-09-11 v0 RTL 落地——两级流水实现与 tohost 覆盖 bug 纠错记录
2026-09-11 test(sw): RV32I 逐指令自检汇编 hello_test（38 用例，失败返回编号；修正 lb 用例小端字节位置）
2026-09-11 test(sim): 逐指令自检 tb_core_test 与双 tb 一键脚本，RV32I 38 用例全过
2026-09-11 docs(riscv): 勾选逐指令冒烟 tb 待办并登记变更
2026-09-11 docs(llm_log): 2026-09-11 RV32I 逐指令自检与 lb 用例小端纠错记录
2026-09-14 docs(research): 往届嵌赛 AMD 赛道获奖作品与 2026 赛制调研，resources 挂链接
2026-09-14 docs(llm_log): 2026-09-11 AMD 赛道调研——搜索引擎受阻改走 GitHub API
2026-09-14 docs(proposal): 命题升级方案——借鉴国一/国二作品，A+B+C 组合阶梯（注册名不变，M1 零改动）
2026-09-14 docs: README 命题叙事升级——参数化直通/软硬切换/演示级指标/L3.5+L4 阶梯（注册名不变）
2026-09-14 chore(metrics): 增补演示级指标行（直通对比/端到端帧延迟/动效帧率）
    [metrics.csv]
2026-09-14 docs(riscv): M1 红线入排期纪律，vision/coprocessor 挂获奖作品设计参考
2026-09-14 docs(llm_log): 2026-09-11 命题升级决策——注册名约束、阶梯化与借鉴任务化
2026-09-14 docs: 归档 2026 七企业选题指南会议摘要，amd_track_awards 双源交叉核验
    track_guides_2026_summary.md：7 企业 24 选题全量摘要（官方 PDF 提取）+ 元信息头；amd_track_awards §6 标注双源一致；README 参考资料增链；llm_log 记录对齐过程
2026-09-14 docs: 决赛 Verilog 手写代码考核要求嵌入各阶段计划，新增 exam_prep.md
    exam_prep.md：考核细则（断网/波形验收/口头解释/旧版 Vivado）+ 真题题型清单（2019-2025 归纳）+ 全真模拟流程 + 进度跟踪表；plan.md 阶段0/A/B/C 验收各加限时真题（9/20、9/27、10/1、10/3）与 10/4 全真模拟，全程纪律加周日 1.5h 备考；README 里程碑表逐行补备考任务并扩写考核警告；prep_checklist 刷题条目对齐
2026-09-14 docs: 建立理解门槛流程——code_review_checklist 与 understand-gate skill，README/onboarding/llm_log 规则同步
    看不懂的代码不许入库：OpenCode 由 .opencode/skill/understand-gate 强制 commit 前'逐段讲解+3 道理解测试'，其他 agent 平台走 docs/code_review_checklist.md；讲解稿与测试全量落盘 report/llm_log/（答辩与决赛上机备考素材）
2026-09-14 chore(structure): metrics 并入 data（对齐指南 §3.3.5.4，data 定义即测试数据与参考结果）
    [metrics.csv]
2026-09-14 chore(structure): sw 并入 src（指南 src 定义含固件与 PS 侧软件），tb 相对路径同步，双冒烟 PASS
2026-09-14 docs(structure): README 目录树与对照表改为指南 §3.3.5.4 自主选题结构（编号更正 + docs 登记豁免）
2026-09-14 docs(llm_log): 2026-09-14 结构对齐 §3.3.5.4 决策记录；提交 understanding-gate.md 删除（已被 checklist 取代）
2026-09-14 fix(structure): 清理 soc/coprocessor README 残留的旧 sw/ 路径引用
2026-09-14 chore(structure): understand-gate skill 移入 skill/（正式技能包条目），引用同步，自动加载位移除说明
2026-09-14 docs(structure): 新增仓库结构说明（逐文件夹职责/现状/填充计划），README 挂链接
2026-09-14 docs(workflow): 三线并行分工与每周 PR 合并流程——plan.md 分工改写、分支教程、PR 模板
2026-09-14 chore(repo): 新增 .gitattributes 统一 LF 换行，根治 Windows 行尾 churn
2026-09-14 docs(riscv): plan.md 重构——三线分工 + 第一阶段逐人任务分配（9/14-9/27）
2026-09-14 docs(llm_log): 2026-09-14 三线并行工作流与分支保护落地决策记录
2026-09-14 docs(llm_log): Vivado 版本决议更新为 2026.1（BASIC 免费档），同步 README/获奖调研/结构说明，旧记录加取代横幅
2026-09-14 build(v0): Vivado 2026.1 验收入库——build.tcl/约束/综合基线报告（Fmax 86.8 MHz），XSim 复核对拍一致，指标落 metrics.csv
    [metrics.csv]
2026-09-14 docs(llm_log): 按决议删除 9/11 Vivado 调研旧记录，决议记录补删除说明，repo_structure 计数同步
2026-09-14 docs(llm_log): 决议记录补旧记录删除说明 + repo_structure 计数 13→16（补 9137fd8 遗漏）
2026-09-14 test(v0): 回归基线归档 data/logs/v0_baseline_2026-09-14（iverilog/XSim 双 PASS 对拍），.gitignore 放行 data/logs 日志
2026-09-14 chore(structure): src/soc 并入 src/riscv，SoC 外壳规划与引用同步
2026-09-14 docs(tasks): 三线逐人任务文档（9/14-9/27）落库，验证线归档边界放开
2026-09-14 docs(riscv): plan.md 第一阶段挂三线逐人任务文档链接
2026-09-15 docs(verify): v0 八模块验证观察点（sim/README）+ muldiv/soc_top 接口空壳 + muldiv 契约缺口记录
2026-09-20 test(board): add PYNQ-Z2 LED smoke test
2026-09-20 docs(verify): PYNQ-Z2 到货闭环——全库解除上板顺延、共用板约定、板卡到货协作记录
    issue #1 验收项闭环（联网/Jupyter/base overlay/点灯）：prep_checklist 唯一红项勾选；plan.md §1.3/§3.2/§3.6/§4.1 解除顺延；rtl_libjiang 任务卡恢复上板冒烟；design_v0 §10 新增上板时钟方案待拍板（125MHz vs 86.8MHz）；sim/repo_structure/resources 状态同步；board/README 补板卡信息与全队共用约定；新增 llm_log 2026-09-20 阻塞解除类记录
2026-09-20 docs(verify): PR #15 smoke test 独立复核——仿真/Vivado 证据归档 data/logs + llm_log 记录
    从 dev/rtl@93eeb97 worktree 复跑 iverilog 四组分频全 PASS；Vivado 2026.1 BUILD PASSED（WNS +4.094/WHS +0.052，DRC 0 Error）；XDC 官方 Master XDC SHA256 溯源一致；证据含 timing/utilization/drc 报告与 bitstream 哈希；新增 llm_log 2026-09-20-pynq-z2-smoke-verification；repo_structure 记录数 18→19
2026-09-20 docs(board): SD 卡烧录完毕、校园网 SSH 远程访问登记——board/README 等 5 处同步
2026-09-20 docs(riscv): CPI 口径重定义——v0 无数据停顿契约核对（README/plan 同步 + llm_log）
    转发专项 tb 动手前核对 design_v0 §2.2 与 RTL：v0 stall 恒 0、lw 异步读同拍写回，数据冒险零停顿，CPI≈1+分支代价；README 与 plan §1.1/§4.3/§6.1 的'相对 v0 降 25%'不可达，重定义为'v1+转发 相对 v1 无转发（同三级核）降 ≥25%，v0 作参考锚点'；新增 llm_log 契约级发现记录；repo_structure 记录数 19→20
2026-09-20 test(verify): 转发专项 tb + v0 对照基线——理解门槛全流程通过
    新增 sim/riscv/tb_core_fwd.v（标记快照法统计阶段气泡 + 结果自检 + plusargs 参数化期望）、sim/riscv/fwd/fwd_test.S/.hex/.dis（四阶段冒险序列，手写 RV32I）、sim/scripts/build_fwd.sh（只读复用 bench 线工具链）；run_iverilog.sh 升级 v0|fwd|all 两档；v0 实测：数据气泡 0/0，taken 分支 5，not-taken 0，全部结果字一致；证据归档 data/logs/2026-09-20-fwd-baseline（含 plusarg 机制演示）；理解门槛两轮补课通过，llm_log 全量落盘；repo_structure 记录数 20→21
2026-09-20 test(verify): riscv-arch-test 第三方套件接入——目标配置 + 双预载 tb + 签名比对，add-01/addi-01/and-01 全 PASS
2026-09-20 docs(skill): 新增古法编程技能包——AI 小步交付 + 每步出题审核（skill/ + README 索引）
2026-09-20 docs(llm_log): 2026-09-20 PYNQ-Z2 上板冒烟协作记录
2026-09-20 docs(board): 上板收尾——setup.md 复现指南 + logs 记录模板 + exam_prep 列名
    新增 board/setup.md（SD 烧录→启动→SSH/Jupyter→base overlay 验证，SSH 10.50.216.93 实测登记）；新增 board/logs/README.md 实测记录模板（日期/接线/bitstream commit/现象，只追加）；board/README 规划项勾选同步；docs/exam_prep.md 队友列名补全（LibJiang/waltercooper）；repo_structure board 现状同步。关联：issue #2 已评论关闭（Vivado 验收）
2026-09-20 docs(verify): arch-test 理解门槛补记——两轮问答通过 + repo_structure 计数 21→22
    新增 report/llm_log/2026-09-20-arch-test-integration.md：接入过程纠错轨迹（make 缺失/符号链接/双预载/宏告警）+ 逐段讲解 + 3 题问答（Q1 补课+追加小题通过、Q2/Q3 通过）+ 时间线如实说明（代码先由 643f258 提交，门槛事后补记）
2026-09-20 docs(process): M1 验收 gate issue 建链——plan/README/onboarding 回链 + llm_log（#19/#20/#21）
2026-09-20 docs(board): PYNQ-Z2 LED smoke test 上板实测记录（JTAG 下载 + 肉眼验收 PASS）
2026-09-20 docs(board): 演示硬件与 HDMI 接线定稿——hardware.md + setup 串口修正 + 清单/日志（prompt：笔记本HDMI源+采集卡显示落地）
2026-09-20 docs(registration): 题目定稿《边缘慧眼》——README 标题 + proposal_upgrade 红线同步 + 文案存档（prompt：题目简介修订）
2026-09-20 docs(board): 上板记录区分 SD 卡烧录(系统启动) 与 JTAG(PL 下载)
2026-09-20 docs(llm_log): 补 9/20 协作记录（JTAG 上板实做 + 日志精简/skill 盘点）并忽略本地精简稿
2026-09-20 docs(llm_log): 2026-09-20 Part A 古法编程起步协作记录（RV32M 契约/sb-sh 对齐/IF 停顿）
2026-09-20 feat(rtl): Part A 起步——RV32M 契约、sb/sh 数据对齐、IF 停顿保持（古法编程 1-3 步）
2026-09-21 docs: 9/21 叙事架构修复会话落盘（README 叙事收敛、core_comparison 新增、板卡信息脱敏）
    [metrics.csv]
2026-09-21 docs: 开源仓库瘦身——移除队内备考/排班/个人学习/扩展方案内容
    - 删除 exam_prep、git_learning/、tasks/、idea1.md 及纯备考 llm_log 记录
    - 全库清除 HDLBits 刷题任务、真题/备考条目、L4 EdgePilot 云台线
    - 裁撤野火板备查节（resources §10）与学习路线节（resources §9）
    - 被移除内容已转存队内本地私有目录（不入库不入远程）
    - 修复全部死链；llm_log 历史记录按'别后补'铁律保持原样
2026-09-21 docs: 排期极限压缩——M1 提前至 10/1 收口，M2/M3/M4 前移至 10/12/10/20/10/26 (prompt: 不砍验收只压日期, 降级红线 10/2→9/29, 备考日期不动; 决策记录 report/llm_log/2026-09-21-schedule-compression.md)
2026-09-21 feat(rtl): Part A muldiv 骨架 + 32 拍移位加法乘法（古法编程 4-5 步），附协作记录
2026-09-21 feat(rtl): Part A muldiv 32 拍恢复除法（古法编程 6 步），附协作记录
2026-09-21 docs(llm_log): 2026-09-21 Part A 接口契约对齐审计记录（审计证伪，无代码改动）
2026-09-21 feat(rtl): Part A 7A decode RV32M 译码 + RV32M 模块级 tb 与回归接入，附协作记录
2026-09-22 feat(rtl): Part A 7B muldiv 接入核 + RV32IM 整核冒烟；8A 冻结 32KB 存储契约；附协作记录与开工规范
2026-09-23 docs(riscv): 计划归档——阶段0/第一阶段/Part A 移入 done/，plan.md 收敛为剩余部分 (prompt: plan.md 拆分已完成/未完成, done 归档含完成证据与遗留清单, 保留 §4.2-4.4/§6 编号不断链)
2026-09-23 docs: 补 AMD 赛道官方仓库入口（Gitee fpgachina26-amd）——README / 资源清单 / 选题摘要三处交叉引用
2026-09-23 feat(bench): 通用固件 tb_core_coremark（8A 契约 8192x32 + plusarg 参数化）+ 理解门槛记录 (prompt: 通用 tb_core_coremark.v, 等 RTL 8B 改完 run_iverilog.sh 再加 coremark 模式避免同文件冲突; 7A/7B/8B 复跑)
2026-09-23 docs(bench): CoreMark 跑分工作包分条计划——契约收口/RTL 前置/vendor 构建/移植层/回归证据/四档数据 (prompt: 阅读项目库, 为 CoreMark 移植与跑分列出详细分条计划, 落盘 dev/bench 并推送)
2026-09-23 docs(bench): CoreMark tb 契约草案——接口/观测/判据三层冻结 + tb 挂接 + 协作记录 (prompt: 契约先行锚定既有 tb_core_coremark, 观测块+tohost=crcfinal, 32 迭代+golden, 计时计数器提案待 RTL 确认, 古法编程分步交付)
2026-09-23 feat(rtl): Part A 32KB 存储契约落地——固件重链接(8B)/tb 扩容(8C)/imem+dmеm RTL(9A/9B)，附协作记录
2026-09-23 feat(bench): CoreMark 移植与 v0 跑分落地——vendor/portme/32KB 链接/哈佛双口预载修复/golden (prompt: 固定 commit vendor 入库, 哈佛加载器语义修正并回写契约, 观测块判据接入 tb, 运行时 seeds 避 .data 依赖, v0 32 迭代 PASS CoreMark/MHz=1.506)
    [tb_core_coremark.v]
2026-09-24 feat(bench): CoreMark 一键回归接入——run_iverilog.sh 增 coremark 模式并纳入 all；评分解析与 metrics 入档 (prompt: 为 run_iverilog.sh 增加 coremark 模式, 删掉旧描述之后重新执行 test; arch-test 显式顶层去噪音; CoreMark/MHz=1.506/CPI=2.105 入 metr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
    [metrics.csv]
2026-09-24 docs(entry): 人读入口 docs/README.md + workflow 三合一——目录地图/信息归属规则/写作规范/旧路径对照；README/AGENTS/onboarding/skill/plan 引用同步 (prompt: 项目膨胀评估后按第2档整理, 新增唯一人类入口, kickoff+code_review+prep 三合一)
2026-09-24 docs(merge): track_research 二合一——往届 AMD 获奖调研 + 2026 七企业指南, 双源互证改节内引用 (prompt: 文档合并去重, 两篇调研合一)
2026-09-24 docs(merge): CoreMark 契约+计划合并为 docs/coremark.md——§1–§7 编号不变、计划转附录 A, 全库约 12 处注释路径更新 (prompt: coremark 两篇现在就合并, 契约编号保持, 引用方只换文件名)
2026-09-24 docs(cleanup): 删 repo_structure（目录地图并入 docs/README）+ 整理协作记录落盘 (prompt: 删除过期目录说明, 本步 llm_log)
2026-09-24 docs(fix): 修复 src/vision、src/coprocessor README 相对路径断链——../docs 应为 ../../docs（历史遗留, 全库链接体检发现） (prompt: 整理收尾做全库活文档链接体检)
2026-09-24 feat(rtl): 完成Part A SoC上板准备与40MHz时序收敛
    实现SoC外壳、PYNQ-Z2时钟复位、XDC、可复现仿真、Vivado构建及JTAG下载脚本，并归档WNS与资源报告。AI prompt要点：hello_v0 tohost驱动LED、40MHz安全核时钟、时钟/DRC门禁及真实上板证据边界。
2026-09-26 test(verify): Part A SoC 上板独立验证（XSim 对拍 + 构建 + JTAG 实测）与复位重跑缺口归档
2026-09-27 docs(riscv): Part B 启动——v1 三级流水+转发契约草案（design_v1.md），附协作记录
2026-09-28 feat(rtl): Part A 收口——SoC 计时计数器/DMEM 预载/软复位重跑落地（含 benchmark v0.1 与 CPI harness）
    soc_top：0x8000_8000 自由运行计时计数器（同拍组合读；写路径关门，防 addr[14:2] 撞 DMEM[0]）；dmem 增加 INIT_FILE，SoC 层 DMEM_INIT_FILE 与 IMEM 同 hex 双预载（design_v0.md §3.3/§5.8 冻结）。tb_soc_top 增加计时器分层检查、写别名保护与软复位第二次运行 tohost=65/LED=0001 判据；新增 soc_check 真实固件端到端 tb、benchmark v0.1 与 data/scripts/cpi_harness.py；run_iverilog.sh 增加 soc_check/bench 并纳入 all，Makefile 增加两目标。
    指标与文档：metrics.csv 补录 Fmax 83.8/WNS -1.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
    [metrics.csv]
2026-09-28 feat(rtl): Part B 契约冻结 + R1 decode 源操作数使用标志；Part A 收口口径同步，附协作记录
2026-09-28 test(verify): Part B 验收准备——转发/冒险单元 tb 预写 + 契约验收清单 + R1(fe80857) 独立复验归档
    - tb_forwarding.v / tb_hazard.v：按冻结契约 design_v1.md §8/§9/§13 端口表预写的验收 harness；
    已对契约参考模型 stub 做自一致性检查（25 例 / 16020 组合含 redirect&&front_stall 互斥
    穷举）通过；DUT 落地前不接入 run_iverilog.sh，不构成 RTL 验证结论。
    - docs/partB-verify-plan.md：Part B 门禁总表、tb 断言映射、CPI 口径（D14 主比 v1_fwd vs
    v1_nofwd）、XSim 对拍口径、上板负责人简报、10/3 执行单。
    - data/logs/2026-09-29-r1-verify/：dev/rtl fe80857（契约冻结+R1）全量回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
2026-09-28 docs: 模块三训练/量化前期调研 + docs 索引补 Part B 验收清单与训练文档入口
    - docs/module3-model-training.md：QAT/Brevitas 路线选型、训练侧交付物定义
    （定点模型/权重 hex 导出/精度报告/逐层黄金参考）、与 cop_top 契约的 5 个对齐点。
    - docs/README.md 找东西表补两行导航。
    - AI 产出，prompt 要点：训练侧前期准备（用户 9/29 授权），不约束 jianglibo 的
    cop_top RTL；hex 排布等协处理器契约冻结后回填。
2026-09-28 feat(vision): 模块二首批 RTL——rgb2gray/line_buffer/gaussian_3x3 落地并过黄金参考对拍
    - src/vision/rgb2gray.v：BT.601 定点 Y=(77R+150G+29B)>>8，1 拍延迟。
    - src/vision/line_buffer.v：参数化单行 RAM，同步读，同拍同址先读后写（gaussian 依赖）。
    - src/vision/gaussian_3x3.v：双行缓存奇偶轮替，输出行落后 1 行，末行 vblank 冲刷
    （底邻居钳位），列方向三级读链 + 左右边界中列钳位，全移位加。
    - sim/vision/tb_*.v + run_vision_iverilog.sh：模块二独立回归（不进模块一 all），
    bash sim/scripts/run_vision_iverilog.sh all = 3/3 PASS，黄金参考逐像素 0 错误。
    - data/golden/vision/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
2026-09-28 feat(vision): 模块二第二批——scaler/sobel 落地 + rgb2gray→gaussian 链式冒烟，6/6 PASS
    - src/vision/scaler.v：16.16 定点双线性缩放（契约同 gen_scaler.py），NLINES 行槽
    滑动缓存 + 2 拍/像素双相位随机列读，发射与源写入解耦（未就绪挂起、hs 续发）。
    约束：行槽数 2 的幂、行步进 ≤ NLINES-2；吞吐 1 像素/2 拍（缩小档充足）。
    - src/vision/sobel.v：窗口/冲刷与 gaussian 同构，|Gx|+|Gy| L1 幅值 8 位饱和。
    - sim/vision/tb_chain.v：rgb2gray→gaussian 级联冒烟，级间 vs/hs 标记同拍延迟传播
    （vision_top 集成约定）。
    - 黄金参考 data/golden/vision/{scaler,sobel}/（gen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
2026-09-28 feat(vision): 级间标记接口 + 全链冒烟 tb（rgb→gray→gauss→scaler），7/7 PASS
    - rgb2gray/gaussian/sobel 新增 out_vs/out_hs：每级自产输出标记与 out_de 同拍传播；
    直通行尾 hs 门控 y>=1（输入行 0 的 hs 不对应输出行，屏蔽防下游行计数错位）；
    gaussian/sobel 末行冲刷自产合成 hs（vblank 内，末像素后 1 拍）。
    - 冲刷窗口时序修正：eff_de 推迟 2 拍启动（fc∈[2,WIDTH+1]），避免直通行尾 hs 与
    冲刷首像素同拍到达下游（导致 wx 清零吃像素、行错位、末列 X——tb_fullchain
    调试实录，口径入 design_v0.md §3.2 级间标记约定 v0.2）。
    - tb_fullchain：三级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
    [gaussian_3x3.v, tb_fullchain.v]
2026-09-28 data(vision): 模块二 OOC 综合基线归档——gaussian/sobel/scaler ≈88MHz@10ns，资源+口径说明
    - Vivado 2026.1 OOC xc7z020clg400-1，10ns 约束：gaussian WNS -1.241 / sobel
    -1.439 / scaler -1.347（≈88MHz 通过，720p60 74.25MHz 裕量 >3ns）；
    rgb2gray WNS=NA 为口径正常（单级流水无 reg-to-reg 内部路径，README 说明）。
    - 单元级 BRAM=0（行深 16 为 LUTRAM），真实行宽参数放大后需重测——边界已写明。
    - 入口 sim/scripts/run_vivado_vision_ooc.sh；不上板，非验收数据（首批基线）。
    - AI 产出，prompt 要点：OOC 口径差异（单级模块无内部时序弧）如实归档不粉饰。
2026-09-29 feat(vision): 模块二全家福补完——osd_overlay + axi_regs，9/9 PASS
    - src/vision/osd_overlay.v：灰度流直通 + 双 1px 描边框（box/roi，重叠 box 优先）；
    参数帧首 vs 锁存（帧内变更不影响当前帧，A4 动效换帧生效语义），tb 双帧 golden
    验证锁存。
    - src/vision/axi_regs.v：AXI-Lite 从机寄存器堆（映射 v0.1：R0 控制开关/R1-R5 box/
    R6-R10 roi/R11-R15 保留）。要点：AW 默认 7 且必须 2^AW > NREG*4——AW=6 时地址
    空间被寄存器占满、越界判别永不触发（tb 实测教训入档 design_v0.md）；保留区写
    忽略读 0；wstrb 字节使能；序列化握手；复位全零防 X 传播。
    - tb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
2026-09-29 feat(vision): vision_top 顶层骨架 + scaler 自产输出标记，10/10 PASS
    - src/vision/scaler.v 新增 out_vs/out_hs：vs 首行发射前置脉冲；hs 行末像素 de
    后置 1 拍（last_px_out 判定——末像素 de 实际在行尾后一拍输出）。两处多帧
    复用缺陷修复（tb_top 暴露）：发射状态 out_row/y_acc/committed 未随帧 vs
    复位——单帧 tb 测不出，多帧时 out_row 涨满 DH 后发射器永久停摆、committed
    残留导致用上一帧槽内容发射。
    - src/vision/vision_top.v v0.1 骨架：rgb2gray 恒接 → [gaussian] → [scaler] →
    [osd]，R0 开关拓扑（bit0 gauss/bit1 scaler/bit2 osd/bit3 sobel 预留）；路径
    选择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
    [tb_fullchain.v, tb_scaler.v, tb_top.v]
2026-09-29 docs(repo): 仓库整理——超前完成规则入库 + 计划/入口文档同步 + tag 与忽略规则
    - plan.md：明确“超前完成允许”——提前交付不改变验收标准，结余时间计入最终验收容错；Part C 频率口径与 dev/rtl fe80857 对齐（实际最高通过频率/WNS 入档、125 MHz 为非阻塞加分）
    - plan_calendar.md 首次入库（每日任务/交接/风险；README 与 plan 已引用）
    - 模块 README 状态更新：riscv（v0 收口/v1 契约冻结/R1 落地）、vision（单元级 10/10 PASS）、coprocessor（训练侧调研完成、10/5 开工）
    - docs/README：现在到哪、目录地图、找东西表同步；README 目录结构与 build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
2026-09-29 docs(vision): 模块二 README 状态更新——单元级 8 模块落地、10/10 PASS，剩余项列明
    - 状态表替换“规划内容”：逐模块标注已实现与要点，指向 design_v0 §3.1/§3.2 实现口径
    - 未完成清单明确：HDMI 通路选型、缩放目标尺寸、sobel 接入、跨时钟、A2 对比、上板演示（10/12）
    - 契约仍为草案，10/5 评审后升格冻结
2026-09-29 feat(rtl): Part B R2-R5 v1 积木模块（forwarding/hazard/mem_wb/id_ex）模块级落地，附协作记录
2026-09-29 feat(vision): real 档 OOC 基线（720p 行宽）+ 多驱动 RTL 缺陷修复
    - sim/scripts/synth_vision_ooc.tcl 支持 variant=unit|real（real：WIDTH=1280/
    HEIGHT=720，scaler 目标 224x224 占位，NLINES=16）；入口脚本加 unit|real|both。
    - 修复 scaler committed 多驱动（两个 always 驱动同一 reg）：Vivado 报 20 个
    Critical Warning 而 iverilog 静默（后写贏、10/10 tb 全过）——已并入写侧单
    always，复跑无警告。教训：iverilog 干净 != 综合干净，关键模块必须过综合
    看 Critical Warning（README-real 入档）。
    - real 档结果：BRAM 推断全部正确（line_buffer 1xRAMB18 先读后写端口对 /
    gaussian+sobel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
2026-09-29 test(verify): R2-R5(522e819) 独立复验——预写 tb 首次闭环，15/15 PASS
    - tb_forwarding（25 例）/ tb_hazard（16020 组合穷举 + 互斥不变量）对 jianglibo
    真 DUT 一次通过：契约 -> verify tb 先行 -> RTL 落地的验收闭环首次走通。
    - RTL 线自写 tb_mem_wb_stage/tb_id_ex_stage PASS；既有 11 tb 零回归
    （CoreMark CPI 2.105 与基线一致；coremark 观测行 errors=1 与 9/28 基线
    逐字节相同，既有现象非回归）。
    - 源码评审附注：forwarding/hazard 与契约 §8/§9 逐条一致；mem_wb_stage 复位
    仅清 valid（§12.5 允许）；id_ex_stage 组合级 .* 连接。
    - docs/partB-verify-plan.md tb 状态更新为已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
2026-09-29 docs(vision): scaler 时序实测结论入档——主凶为 lerp 乘法进位链，NLINES 优化无效；720p30 首发选项提请 10/5 评审
    - real 档 OOC 复测 NLINES=8（WNS -7.508 vs 16 槽 -7.412）：槽 mux 非主凶，
    worst path 20 级中 9 个 CARRY4 为两级 lerp 乘法的进位实现。
    - 本日三次优化尝试（x-lerp 重排流水 ×2 变体、槽 mux 分组预选）均因 BRAM
    一拍滞后与行边界相位连环失配撤销，RTL 无残留改动（git checkout 回 HEAD）。
    - design_v0.md §5 新增开放问题 0：①720p30 演示（现状达标，推荐首发）
    ②预寻址重排（约半天，75+ MHz）③乘法形式/DSP——提请评审拍板。
    - OOC rea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
2026-09-29 test(bench): 模块三训练侧全链演练 PASS——训练/INT8/hex 导出链路打通
    - data/scripts/m3_train_drill.py：极简 CNN（8x8 两类合成数据）SGD 训练 → 手工
    per-tensor 对称 INT8（权重 amax/127，激活校准 amax 静态量化）→ 权重 hex 导出
    （默认排布：逐层扁平 INT8，cop 契约冻结后按契约重排）→ FP/INT8 精度对照。
    - 结果：acc_fp=1.00，INT8 与 FP argmax 100% 一致，max_out_diff=4.9；
    导出 2740 权重 + scales.txt + act_golden.txt（逐层前 16 值，供协处理器逐层
    比对）。torch 2.14 CPU，一键复现。
    - 接口细节入档 docs/module3-model-training.md：Sequential 参数名占位索引坑、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
2026-09-30 docs(vision): 10/5 评审决策单 v2 + 现状盘点协作记录
    - docs/vision-m2-review-1005.md：D1-D12 四段式决策单。D1 用户已拍板两段走
    （720p60 正式目标，WNS@10ns>=-3.47 验收，30fps 作 gate 保底）；D2/D4/D5
    用户预批（板上芯片+PS I2C / 模块三拍板尺寸 32-64 起步），条件与追认时点已注。
    - report/llm_log/2026-09-30-vision-status-review.md：盘点记录 + 二次会话追记，
    补 9/29-30 llm_log 断档。
    - AI 产出（ZCode/GLM）；内容经用户 2026-09-30 两次会话确认。纯文档改动。
2026-09-30 docs(plan): 主计划迁移到根目录，核计划按模块收敛
    按用户要求仅固定收口日期，全局目标、分工与交付看板统一到根目录，保留核技术验收及历史记录。
2026-09-30 docs(vision): 明确紧固件定位分类与 EXE 工业检查目标
    同步自由分散且互不遮挡、传统定位加 CNN、HDMI 采集卡视频与网口结果链路，EXE 主责 watercopper；明确目标、未实现项与同步验收。
2026-09-30 docs(workflow): 同步主计划入口与工业视觉决策记录
    导航与开工规则区分全局计划和核专项计划，归档用户决定、文档检查结果及提交合并授权。
2026-10-01 feat(vision): scaler 插值链切拍——错半拍预寻址，real 档 OOC 94.9 MHz 达标 720p60
    - 读调度错半拍：ph0 发当前像素 x1 地址、ph1 发下一像素 x0 地址，x 方向插值
    ph1 拍寄存，发射拍只剩 y 插值；发射时刻/输出标记一拍不变，逐像素位精确。
    - 行边界 x0 捕获用 pend 槽号（cap_y0/cap_y1）；冷启动修复：复位与 in_vs 时
    x_acc 置 INIT_X（缩小档下旧值 0 预取错列，单元档 INIT_X<0 碰巧掩盖）。
    - 实测：run_vision_iverilog.sh all 10/10 PASS 逐像素 0 错；OOC real 档
    WNS -0.534@10ns ≈ 94.9 MHz（验收线 -3.47 = 74.25 MHz，力争线 -1 亦过）。
    - 同步 design_v0 §3.1/§5.0/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
2026-10-01 feat(vision): sobel 接入 vision_top——gauss mux 后串接，R0 bit3 生效，6 帧 tb 1024px PASS
    - 拓扑：rgb2gray→[gaussian]→[sobel]→[scaler]→[osd]；sobel 串接于高斯旁路 mux 之后、
    scaler 之前（决策单 D7：全分辨率做边缘，缩放后小图边缘信息已损失）。
    R0 bit3=sobel_en，可与 bit0 自由组合（bit0=0&bit3=1 即对 raw gray 做边缘）；
    t_sobel 帧首锁存沿用拓扑锁存语义。
    - tb_top 扩至 6 帧（+gauss|sobel、+gray|sobel），1024 px 0 错；新增链路 golden
    fullchain/{expected_gauss_sobel,expected_gray_sobel}.hex + gen_top_sobel.py
    （自检：本脚本 sobel 参考逐位等于已归档 sobel golden）。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
2026-10-01 feat(vision): in_align 输入归一化模块——ADV7611 解码流归一到 §3.1 流约定，11/11 PASS
    - 新增 src/vision/in_align.v：raw hs/vs 极性归一 + 边沿检测单拍化；hs 重定时为
    行尾 de 拉低后第 HS_DLY 拍（默认 3，满足间隔 >=3 且距下行首 de >=1）；
    vs 边沿当拍单拍化；vs/hs 撞拍时 hs 让路顺延一拍不丢失。de/rgb 直通。
    - 约束入档：源行消隐 >= HS_DLY+2 拍、raw vs 在场消隐内不与 de 重叠（真实 HDMI 恒成立）。
    - tb_in_align：3 帧丑流（hs 搭行尾 de、vs 宽 3 拍、人为 vs/hs 撞拍），断言 §3.1 全部
    间隔规则 + RGB 逐像素直通。hs=24 证明撞拍 hs 顺延而非丢弃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
2026-10-01 docs(vision): real75 随访入档——gaussian/sobel 720p60 正裕量无需切拍 + llm_log 冲刺记录
    - OOC real75 档（74.25MHz 约束）实测：gaussian WNS +0.306、sobel +0.219、
    scaler ≈+2.9（由 real 档 10.534ns 路径推算）——三模块 720p60 OOC 全部达标，
    gaussian/sobel 切拍取消，系统级集成后随访（裕量 ~2% 偏薄）。
    - synth_vision_ooc.tcl 新增 real75 档；证据 data/logs/2026-10-01-vision-m2-sprint/
    （11/11 回归日志 + gaussian/sobel real75 全套 rpt）。
    - 决策单 D1 随访结果、D7 实施结果入档；design_v0 §2 拓扑图按 D7 更正 +
    §3.1 in_align/vision_top v0.2 口径；README 模块表同步。
    - llm_log 202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
2026-10-01 feat(vision): vision_top v0.3 双路径拓扑——显示全分辨率直通 + scaler 快照分支喂协处理器
    - 拓扑拍板依据：2026-09-21 叙事决策（llm_log 已档）'双路径：行缓存直通显示 +
    片上快照推理'；原 design_v0 §2 线性链会把 224 小图送上显示器，与 10/12
    直通演示相悖，§2 图随本提交更正。
    - 显示路径：rgb2gray→[gaussian]→[sobel]→[osd]→out_*（全分辨率）；快照分支：
    sobel 后分叉 →[scaler]→ cop_*（DW×DH，R0 bit1 使能，M3 接乒乓行组缓冲+cop_top）。
    scaler 不再串在显示路径；OSD 框坐标系恒为全分辨率（R1..R10 语义随之固定）。
    - tb_top 双通道检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
2026-10-01 feat(vision): vision_top 双时钟域——axi_regs 挂 s_axi_aclk，R0 开关位 2FF 同步进 pclk（D10 落地）
    - 像素流域 pclk 与配置域 s_axi_aclk 分离（板级 = PS AXI_GP 100MHz 级）；R0 bit3:0
    经 2FF 同步后在 pclk 域帧首锁存；box/roi 多字节参数沿用 D10 口径（帧首锁存 +
    帧边界生效吸收位偏差，论证随 D10 入决策单）。
    - tb 仿真双时钟同源（CDC 类缺陷仿真不可见，综合/上板阶段以 XDC 时钟组约束兜底）。
    - design_v0 §2 双路径图 + §3.1 vision_top v0.3 口径 + 变更记录；README 同步；
    回归日志 vision-all-11tb-v03.log 归档，11/11 PASS。
    - AI 产出（ZCode/GLM）。理解门槛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
2026-10-01 docs(vision): §5.3 阶段结论——M2 不设输出时序发生器（同格式直通，标记恒定延迟传递）
2026-10-01 feat(vision): A5 逐像素延迟实测入档 + 寄存器映射表 v1.0 草案 + XSim 口径启动
    - tb_top 新增延迟测量与断言：实测发现窗口级帧首像素延迟为「1 行结构滞后 + 常数拍」
    （3×3 窗口需下一行流入才能算当前行，双行缓存设计使然）——gray=1 / gauss=行周期+4 /
    gauss+sobel=2×行周期+7，与 §3.2 的稳态标记滞后（每级 3 拍）是两个口径，§4 已修正。
    - metrics.csv 图像预处理延迟行由占位填实（单元档实测 + 真实 720p 换算口径注明）。
    - design_v0 新增 §3.3 寄存器映射表 v1.0（草案，10/5 冻结）：R0 位定义 v0.2 +
    R1-R10 框参数 + R11-15 保留；M3 回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
    [metrics.csv]
2026-10-01 test(vision): XSim 对拍 11/11 同判据 PASS——一键脚本入库 + 证据归档
    - 新增 sim/scripts/run_vision_xsim.sh（xvlog/xelab/xsim 三步，单项+all 模式，
    CWD 约束注明）；全套在 XSim 下与 iverilog 同判据 PASS（Part B §6 口径闭环）。
    - 证据 data/logs/2026-10-01-vision-m2-sprint/xsim-all-11tb.log；
    design_v0 §6 与 README 验证表同步。
    - AI 产出（ZCode/GLM）。
2026-10-01 test(vision): 接手测试数据项——scaler 缩小档 golden + img2hex 工具 + 需求单闭环标注
    - 分工变更：用户确认 watercopper 的测试数据项由 never-die-cold 兜底（llm_log §6）。
    - scaler 第二尺寸档（缩小档 32x16->8x4，NLINES=8）：行槽滑动复用路径首次有 golden
    覆盖（放大档不触发该路径，而缩小档才是真实 720p->CNN 工作模式）；混合纹理图
    （斜线+棋盘+渐变）；自检定点 vs 浮点 max_err=1 LSB；iverilog+XSim 双口径 PASS。
    - tb_scaler_ds 接入两个 harness（scaler_ds 模式 + all），回归 12/12 PASS。
    - 新增 data/scripts/img2hex.py：任意图 -> 指定尺寸 BT.601 灰度 hex，真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
2026-10-01 feat(vision): cop_buf 乒乓帧缓冲 v0 + vision_top 全链 OOC + pynq_host 软件栈起步
    - cop_buf.v：快照帧双 BRAM 乒乓（cop_ready 整帧原子反压、读忙原地覆写丢帧保读安全、
    frame_done 中断源）；接口为 §7 占位，cop 契约冻结后仅换读侧封装。接入 vision_top
    （cop_ready 新端口），tb_cop_buf 双口径 PASS，回归 13 tb + A5 = 14 PASS。
    - 顶层综合闸门两轮实录：①mux 阵列写致 Synth 8-3391（401Kbit 散开失败）——单模块
    综合测不出，重构为每阵列独立 1W1R 块；②BRAM 化后 rd 滞后一拍致流错位，补 *_int
    决策级对齐。iverilog/XSim 干净但综合失败，再证顶层综合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
2026-10-01 feat(vision): cop_buf 帧所有权修复 + 帧/配置号元数据 + 压力 tb
    - writing 标志门控写使能：复位后无帧首的残余半帧不写、不发布
    - in_vs 覆写待消费帧先撤销 buf_valid 并计 drop_count；回放中/本拍启动回放的
    银行禁止成为写银行（读启动与写完成同拍的串帧路径）
    - 读启动即消费（原实现在回放尾清除），回放携带该银行的 frame/config id
    - tb_cop_buf_stress：不同帧内容定向复现同拍争用、长时间拒收、写快于读、
    复位半帧隔离；修复前失败证据 copbuf-before.log（门禁拒绝）
    AI 产出（codex 离板冲刺 + ZCode/GLM 接手收尾）；prompt 要点：按
    do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
    [cop_buf.v, tb_cop_buf.v, tb_cop_buf_stress.v]
2026-10-01 feat(vision): axi_regs AW/W 独立握手 + 整组原子提交 CDC 桥
    - axi_regs：aw_hold/w_hold 捕获先到通道，AW/W 任意顺序与响应反压可配对
    （tb_axi_split）；ATOMIC_CONFIG=1 时 R11 写 1 提交、读回 busy，busy 期间
    重复提交回 SLVERR 不覆盖在途快照，R12 返回已应用配置编号；=0 保留旧口径
    - config_bridge：src/dst 双时钟请求/确认 toggle 两级同步（ASYNC_REG），
    确认前 hold_data/hold_id 恒定；dst 在帧首整体应用并回送确认
    - reset_sync：每时钟域异步声明、同步释放
    - config_cdc.xdc：首级同步器 false_path + 稳定总线 max_delay datapath_only，
    不用异步 clock group 掩盖数据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
    [axi_regs.v, config_bridge.v, tb_axi_split.v, tb_config_bridge.v]
2026-10-01 feat(vision): vision_top 原子配置接入 + 彩色显示直通 + sobel 打拍
    - R0..R10 暂存区经 config_bridge 帧首整组应用，删除帧内二次拓扑锁存
    （bridge 已在帧首锁存，再锁会错误多延迟一帧）；开关位取自 active_cfg
    - display_* 新彩色原图直通口（恒定一拍延迟 + display_frame_id），分析开关/
    缩放/消费反压均不影响；out_* 灰度口降级为诊断流，不再当作 HDMI 显示
    - 双时钟域分别 reset_sync；cop_buf 接入 frame/config id 与 drop_count
    - sobel 算术和寄存一拍（gx/gy 分量先寄存再作差），gauss+sobel 首像素延迟
    49→50 拍，换更短组合路径
    - tb_top_async：不同频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
    [tb_top.v, tb_top_async.v, tb_top_color.v]
2026-10-01 feat(vision): video_pipeline 顶层 + vision_axi 物理封装 + 720p/图案 tb
    - video_pipeline：in_align 归一 + seen_frame 门控（首帧 vs 前不放行分析），
    显示路径原始同步/RGB 寄存直通；不实现 TMDS 电气收发，物理前端独立集成
    - vision_axi：Vivado AXI-Lite 封装，Digilent RBG↔内部 RGB 双向字节序转换，
    video_locked 参与复位，越界 AXI 地址折叠到 0x40 保留口；snapshot_debug 汇聚
    - tb_video_real：1650x750 总时序 720p 连续两帧，1,843,200 显示像素逐拍恒等
    + 100,352 快照像素帧/配置号精确、448 行、0 丢帧
    - tb_vision_axi：RBG/RGB 转换、lock-loss 复位、锁恢复后残帧不放行
    -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
2026-10-01 test(scripts): 仿真失败门禁 + 统一回归入口接入 vision/Python
    - vision_gate.sh：vision_run_checked 判据 = 进程退出 0 + 存在 ^PASS: +
    无行首 FAIL/FATAL/ERROR（修复 xsim 脚本 grep FAIL 也算成功的漏洞，
    补 pipefail）；vision_require_tb 拒绝缺失 tb
    - test_vision_gate.sh：8 例仓库内故障注入自检（PASS/tcl 注释/FAIL/混合/
    FATAL/无 PASS/非零退出/缺 tb），不依赖工作区外临时文件
    - run_iverilog.sh all 串联：核全量 + 门禁自检 + 视觉全量 + Python 测试；
    新增 vision/vision_gate/vision_python 子模式
    - run_vision_iverilog.sh / run_vision_xsim.sh：22 个 tb 模式化登记，
    Vivado 路径 VISION_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
2026-10-01 test(vision): PS 配置绑定 + 定位黄金参考 + mock 协议测试（Python 离板栈）
    - vision_regs.py：commit()/wait_applied()/status() 对齐 R11 提交/busy、
    R12 配置编号契约；设置函数不再隐式生效；epoch 回绕处理；无帧超时报错
    - vision_protocol.py：定位报文契约——version/mode=MOCK、session/frame/config
    关联、bbox 越界与重复 target 校验、显式拒绝分类/verdict 字段、新鲜度判断
    - vision_mock_service.py：本地 HTTP mock（/v1/latest|status|config），
    不伪装 MMIO 或板上行为
    - data/golden/vision/localize/reference.py：4 连通分割 + bbox/area +
    RECHECK_TARGET_LIMIT/RECHECK_BORDER 状态 + 逐目标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
2026-10-01 feat(client): Windows EXE 预览原型（MOCK 标注，不预支真实识别）
    - preview.py：mock 帧/HTTP mock 源渲染定位样例框（标注 MOCK ONLY +
    frame/config id）；UVC 模式只显示 UNASSOCIATED 原图，硬件帧关联完成前
    绝不把网络结果叠上采集画面；--selftest/headless/save 供打包验证
    - build_vision_client.ps1：依赖版本锁定 cv2 4.12.0 + PyInstaller 6.16.0，
    --onedir 打包 + 打包后自检 + HTTP 联调（client-build/client-http.log）
    - test_vision_client.py：临时起 mock 服务，验证 EXE/脚本拉取、过期拒绝与
    错误路由非零退出
    - README 声明：M2 交付为接口原型，不是物体检测或工单判定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
2026-10-01 build(vision): OOC post-route 门禁 + 物理 HDMI 工程构建链
    - impl_vision.tcl + run_vivado_vision_impl.sh：video_pipeline 并行像素边界
    OOC 布线；逐条核对 CDC 报告（仅允许稳定总线 max_delay 例外）、阻塞 DRC
    即失败、WNS/WHS 非负门禁 → WNS=+0.330/WHS=+0.027，复检 +0.629/+0.009
    - fetch_hdmi_ip.sh + prepare_hdmi_sources.py：Digilent vivado-library 钉在
    f4613fff，官方 PYNQ v3.0.1 XDC/PS 配置 SHA256 核对后取用
    - create_hdmi_bd.tcl：PS7 + dvi2rgb/rgb2dvi + vision_axi + AXI3→Lite 转换 +
    ILA 的 BD 组装；build_hdmi.tcl + run_vivado_hdmi.sh：全工程综合布线
    bitgen（不打开 Hardware Manager、不下载）
    - 实测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
2026-10-01 docs(vision): 契约/README 离板修订 + 板卡事实修正 + 全程证据归档
    - design_v0.md §4：原子配置提交协议（暂存/R11 提交/R12 编号、SLVERR、
    超时报错）、cop_ready 整帧许可语义、拥塞覆盖规则与完成边界
    - src/vision/README.md 重写：dvi2rgb/rgb2dvi 直连 PL、Digilent IP 钉版、
    RBG 字节序、22 tb 同判据、一键入口清单与验收边界（OOC 正余量≠上板闭环）
    - board/hardware.md + adv7611_init.py：修正 PYNQ-Z2 无 ADV7611 的事实，
    PL 直接收 TMDS；adv7611 脚本降级为外接接收器示例
    - docs/vision-offboard-next.md：补 §5 完成记录（12 步全部闭环 + 未实现清单）
    - data/logs/20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
2026-10-01 fix(vision): HDMI XSA 导出修复——bit 入 impl_1 run 目录后 write_hw_platform 成功
    - 症状：write_bitstream 写自定义路径后，工程模式 write_hw_platform 报
    Common 17-69（只认 impl_1 run 目录内的 bit）
    - 修复：build_hdmi.tcl 改走 launch_runs impl_1 -to_step write_bitstream，
    run 内 bit 复制到 $out；export_xsa.tcl 对既有布线工程按同流程补导出
    - 结果：vision.xsa 生成，内含 vision.bit + vision.hwh（PYNQ Overlay 所需）；
    证据 data/logs/.../hdmi/xsa-export.log，打包 EXE 自检与 HTTP 联调复验 PASS
    AI 产出（ZCode/GLM 接手收尾）；prompt 要点：用户复核离板完成度，XSA/.hwh
    属离板可修项，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
2026-10-01 docs: 全库文档口径一致性普查——状态/寄存器/时序/选型与离板实现对齐
    - plan.md：§1.3 分流口径（彩色直通已落地）、§3.1 当前状态三类清单、
    §3.2 视频链路看板行、§3.4 缩放时序风险关闭（94.9 MHz + post-route +0.330）
    - design_v0.md：状态行、§1 历史注、§2 拓扑图（dvi2rgb 前端 + display_* 三线）、
    §3.1 新模块口径（config_bridge/reset_sync/video_pipeline/vision_axi）、
    §3.3 寄存器映射 v1.1（R11/R12，废 2FF/帧首锁存口径）、§5 开放问题 1–3 定案、
    §6 XSim 22 tb、§8 变更记录
    - README.md / docs/README.md：vision 行与目录地图对齐离板收口
    - pynq_host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
    [metrics.csv]
2026-10-03 feat(vision): 上板部署一键脚本 + 冒烟 watch 断连重连观测（commit 心跳口径）
    - deploy_vision_onboard.sh：bit/hwh/PS 绑定脚本一键推板；authorized_keys 一次性串口前置，免密无人值守
    - onboard_smoke.py 新增 watch/watch-mock：R12 是配置提交确认号、无提交不自增（design_v0 §3.3），
    心跳 = 周期 commit 帧首确认（R12 达期望值），断流 = commit 超时；watch-mock 以时钟驱动假后端
    （2s 拔/4s 插，无 pending 不自增、应用即清 busy）离板复现 STREAM→STALL→STREAM，PC 侧 exit=0
    - 理解门槛：用户复核纠错——首版 watch 误将 R12 相邻读数当自增心跳（健康视频必误判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
2026-10-03 feat(m3): 训练侧 Brevitas QAT 演练 PASS + D5 拍板材料入库
    - data/scripts/m3_brevitas_drill.py：Brevitas 0.13.4 QAT 演练（与 9/30 手工 PTQ 演练同网络同数据可对照）——
    QAT acc 1.00，导出 2740 INT8 权重+scale 后按整数累加语义（int8×int8→int32→rescale→requant）
    独立复现 argmax 100% 一致；激活 scale 经 QuantIdentity 显式量化点持有（0.13 无 layer.quant_input_scale）
    - data/logs/2026-10-03-m3-brevitas-drill/：weights_hex + scales.txt + act_golden.txt 证据
    - docs/module3-model-training.md：§2 路线演练结论落档；新增 §3.5 D5 拍板材料——视觉链 OOC 实测 DSP 0/220
    （全 LUT 实现），候选首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
2026-10-03 docs(board): 演示源定案树莓派4B+CM3，采购清单拆分已购/待购，新增供电与上电顺序约束
    - §1 链路图具体化：CM3 --CSI--> Pi 4B --micro-HDMI(HDMI0)--> HDMI IN；补独立供电/上电顺序两条
    - §2 清单：相机行收敛为 CM3(75°/AF/日光版/720p60 RGB444)；新增 micro-HDMI->HDMI-A 线、Pi USB-C 5V/3A 电源；HDMI线x2/采集卡/12V 标已购；支架升建议
    - §3 新增第7条：Pi 不从 PYNQ USB host 取电（共享5V轨/HDMI完整性）+ PYNQ先起PL再上电Pi的EDID协商顺序
    - AI 产出 prompt 要点：购置模块三 HDMI 相机调研->定案 Pi4B+CM3 并更新清单与约束，未含型号链接与价格
2026-10-03 fix(vision): AXI 域复位与 video_locked 解耦——上板 PS 总线挂死修复
    上板实测（data/logs/2026-10-03-vision-onboard/）：拔 HDMI IN 瞬间 PS 总线挂死
    （串口/网口同死，断电可恢复，两次复现）。根因：vision_axi 将 video_locked 并入
    整个 rst_n，连带复位 axi_regs/config_bridge——PS 在途 AXI 事务的 BRESP/RRESP
    永不返回，内核冻结。tb_vision_axi 的 lock-loss 用例总线空闲，未覆盖在途并发。
    修复：vision_top/video_pipeline/vision_axi 新增独立 axi_rst_n（只随
    s_axi_aresetn）——在途响应照常完成、已提交配置保留、恢复后未确认提交在首帧
    生效（契约语义不变，见 des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
    [tb_axi_lock_reset.v, tb_patterns.v, tb_top.v, tb_top_async.v, tb_top_color.v, tb_video_pipeline.v, tb_video_real.v]
2026-10-03 feat(pynq_host): 板端四步自检 + commit 探测监视 + 上板 runbook/组包脚本
    - m2_onboard.py：env/load/smoke/demo 分步自检（smoke 短超时 commit 兼测视频在位）
    - watch_video.py：周期 commit 探测的视频在位监视器，nohup 脱离 SSH 可存续，
    输出状态翻转供断连/重连实测取证（口径与用户纠错后的 commit 确认语义一致）
    - ONBOARD.md：接线/步骤/证据归档 runbook + PYNQ 3.1 镜像环境坑（venv 解释器、
    root、render 组、load 后重锁竞争、bit 易失）
    - make_board_pkg.sh：从 XSA + src/pynq_host 组装板端部署包（sim/build/board_pkg）
    - run_vivado_hdmi.sh：证据目录 VISION_HDMI_EVDIR 可覆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
2026-10-03 docs(vision): 上板首验证据归档 + 复位拓扑契约条款 + 验收边界更新
    - data/logs/2026-10-03-vision-onboard/：load/smoke/demo 四日志、彩色直通与
    EXE 联调截屏、活性/延迟探针（125ms 上界含采集卡）、axi-lock 修复前后日志、
    修复后拔插实测 watch7.log 与重测抓帧、重建 HDMI 报告（WNS +0.956）
    - design_v0.md §vision_axi：复位拓扑条款（axi_rst_n 只随 s_axi_aresetn，
    挂死机理与 tb 覆盖）
    - README：上板实测结论与剩余边界（真实 HDMI 摄像头源/EDID 换源/DDR 对照）
    Prompt 要点：GLM-5.3-Flash 证据按可复现入口归档，口承接离板验收边界文档。
2026-10-03 feat(pynq_host): add file localization and atomic crop exports
    Add validated GRAY8 input, row-major PGM/hex artifacts, source hashes and atomic result publication. Cover stale manifests, RECHECK and failure preservation in the vision Python regression.
    AI prompt: finish the camera-free ARM localization baseline, preserve reproducible repository evidence, then split the reviewed changes into commits. User passed the three comprehension questions; full record: report/llm_log/2026-10-03-arm-localize-baseline.md.
    [arm_localize.py, test_arm_localize.py]
2026-10-03 feat(pynq_host): retain synthetic benchmark samples for PC ARM comparison
    Measure locate, crop and total_call separately with warmup, repeated samples and nearest-rank p95. Compare exact inputs, boxes, pixels, PGM/hex bytes and hashes while excluding timing and runtime from equality checks.
    Validation: three scenes and 15 retained PC/ARM samples passed exact comparison. AI prompt: establish a reproducible camera-free ARM performance baseline and keep measurement boundaries explicit; user comprehension gate passed.
2026-10-03 feat(pynq_host): package standalone ARM baseline with integrity selftest
    Build an explicit file whitelist with source hashes, provide portable selftest and runbook, and gate missing or tampered files before execution. Add isolated package and retained-sample coverage to the vision Python regression.
    Validation: PC and ARM package selftests passed; five vision Python test suites passed. AI prompt: deploy without a camera or full repository, exclude SSH credentials, and retain reproducible evidence. Final user comprehension answers passed and are archived in the session llm log.
    [arm_localize_selftest.py, test_arm_localize_package.py]
2026-10-03 docs(vision): archive ARM baseline results and complete understanding record
    Retain full PC/ARM samples, artifacts, logs, portable package and board archive, with historical attempts explicitly separated from final acceptance. Record the full walkthrough, user answers, passing gate and timing limitations. Preserve original evidence bytes with local Git attributes.
    Validation: five Python suites passed; 15 PC/ARM samples matched exactly. Git-index checkout also passed benchmark comparison and package selftest; archive and manifest hashes matched, and diff checks passed. AI prompt: complete the camera-free baseline, ask three consolidated questions, then split all reviewed work into commits.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
2026-10-03 docs(data): add fastener data collection protocol draft
    - New docs/fastener-data-collection-protocol.md (120 lines): camera
    position/distance calibration (40-80cm, 5-step mm/px procedure),
    lighting matrix L0-L3, background & minimum-spacing measurement via
    ARM localize baseline, capture batch matrix (class x light x
    orientation x count) with session-based anti-leakage split and
    data/datasets/fastener-v1 naming spec, shadow/reflection stress
    cases S1-S5, per-session audit checklist, and handoff order after
    board/hardware.md section-4 cable verification.
    - Board-side frame capture (hdmi_in.readframe) mandated so dataset
    pixels equal deployment pixels (M2 golden reference / M3 a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
2026-10-03 docs(riscv): add Part C verify plan with four-tier gates and tb stock list
    - Nine-section structure mirrors partB-verify-plan.md (roles / delivery
    prerequisites / acceptance gates / tb stock / CPI ladder / XSim
    cross-check / board brief / execution checklist)
    - Gates: gain_total >= 25% vs v1_nofwd (v0 anchor only, D14 ladder kept),
    BHT hit rate must be dual-source checkable, 125 MHz non-blocking bonus,
    L3 degradation must be labeled and never sold as full target pass
    - Contract status marked honestly: design_v1.md has no Part C chapter yet
    (checked dev/rtl too); unit-tb assertion points are plan-stage pending
    contract freeze
    - Part B lesson encoded: pre-written tb must not join r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
2026-10-03 refactor(pynq_host): watch_video 并入 onboard_smoke.py watch——BUSY 区分 + flush + end 判定修复
    - 用户拍板两套监视工具合一；watch 保留判据/存证职责（有 mock、有判定、有退出码）
    - 新增 BUSY 状态：在途提交被拒(R11 busy)非断流，saw_busy 单独计数存证
    - except Exception 收窄为 TimeoutError/RuntimeError：MMIO 硬故障不再伪装断流（挂死教训）
    - watch 路径 print 全 flush：重定向文件时块缓冲不落盘（watch.log/watch2.log 教训）
    - 修复 end 判定：last 改状态串后 not last 恒假，收尾停在 STALL/BUSY 误 PASS
    （理解门槛问答抓出；注入不恢复后端实测 FAIL 分支生效）
    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
2026-10-03 docs(board): 演示源硬件采购状态更新——CM3 相机/micro-HDMI 短线/Pi 电源已购
    到货待收，验线照 hardware.md §4 执行；负责人落 never-die-cold（2026-10-03）
2026-10-03 feat(verify): PicoRV32 vs v0 核 Fmax 对比实测——约束递减收敛同法对跑（M4 前置提前完成）
    - 上游 picorv32 固定 ef203c2；regular(默认参数)/large(README 面积表参数集) 经
    synth_area_top.v 包装，与 v0(partA-v0 tag 快照) 同器件 xc7z020clg400-1、
    同 Vivado 2026.1、同 OOC post-route、10ns→5ns→收敛 两边同法
    - 结果：regular ≈192-195 MHz(905 LUT)；large ≈134 MHz(2006 LUT)；
    v0 83.8 MHz@10ns WNS -1.935 与 2026-09-28 基线逐位一致（方法自洽）
    - 证据归档 data/logs/2026-10-03-picorv32-compare/（8 轮报告+日志+README）；
    core_comparison.md §2 增实测行
    - 新增 build/build_fmax.tcl（周期参数化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
2026-10-03 docs(riscv): 补勾 gate #19 复核签字——随 issue #19 关闭补记（2026-10-03，用户确认）
2026-10-03 chore(build): gitignore 核对比跑分产物目录（build/run、build/reports/fmax）
2026-10-03 docs: 项目总览与 7 幅 RTL 数据流图（ASD-STE100 口径）——理解门槛 3/3 过（2026-10-03，用户问答）
    - docs/project-overview.md：全项目讲解（系统/三模块/核与视觉数据流/CDC/乒乓/验证体系/未实现清单），按 ASD-STE100 中文对应口径书写（短句、主动语态、一句一事、术语唯一）
    - docs/img/make_project_diagrams.py：7 幅图一键生成脚本（系统总览/RTL 组成树/v0 通路/v1 流水转发/视觉三线/配置 CDC/cop_buf 乒乓），与 2026-10-03 RTL 现状对齐，RTL 改动须同步更新
    - 理解门槛：3 问 3 过（v0 拍序免转发与 v1 load-use interlock、R11/R12 commit 确认顺序、cop_buf choose_r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
2026-10-03 feat(pynq_host): vision_mock_service 支持 --host 远程绑定——Pi 作 EXE 联调 mock 宿主（R2）
    默认 127.0.0.1 不变；--host 0.0.0.0 供服务托管他机（Pi）时 EXE 远程联调用。
    打印地址对 0.0.0.0 回显 127.0.0.1（监听地址≠可访问地址）。docstring 注明
    mock 口径：仅供界面联调，不代表板上识别（plan.md §3.4）。AI 产出（ZCode/GLM）。
2026-10-03 feat(sim): 回放素材生成器 make_replay_scene.py——PGM 场景+concat 清单映射 M3 用例（R3）
    纯标准库生成 720p 灰底 PGM + ffmpeg concat 清单；序列 normal×2（共用同一
    PGM=逐像素相同重复帧段）/extra/normal/missing/empty 对应 M3 验收用例；零件
    纹理与 arm_localize_bench 同视觉语言。合成场景只验链路与验收动作，不用于
    训练/精度评价（数据集像素仍须经 PYNQ readframe 采集）。AI 产出（ZCode/GLM）。
2026-10-03 docs(pi): 树莓派 4B 开发期角色定案 R1–R4——红线五条 + runbook 入库
    docs/pi-dev-roles.md：Pi 不进分析路径/不产数据集像素/供电与上电顺序/mock
    标注「非板上识别」/项目专用 microSD 五条红线；R1 交叉基准、R2 mock 宿主、
    R3 回放源、R4 CM3 演示源 runbook。board/hardware.md §5 加开发期角色一行。
    llm_log 存方案批准与执行记录；理解门槛：10-03 出题、10-04 选择题重出未答，
    按用户指令提交（如实记录，非 3/3 过）。AI 产出（ZCode/GLM）。
2026-10-03 fix(rtl): make ID+EX Verilog-2001 synthesizable
    Expand implicit decode and testbench port connections, add the synthesis-language rule and reusable OOC Tcl, archive reproducible regression evidence, and document the D1-D3 execution plan.
    AI prompt: fix Vivado Synth 8-2716 without -sv dependence; scan all src implicit ports; require g2001/all validation; reread repository and plan three autonomous days.
    [id_ex_stage.v, tb_id_ex_stage.v]
2026-10-03 test(rtl): archive post-sync dev/rtl regression
    Record the full all-mode run and Verilog-2001 checks after landing the implicit-port fix on current dev/rtl.
    AI prompt: rerun validation on synchronized dev/rtl, preserve raw outputs, and stop before push on any gate failure.
2026-10-03 test(rtl): establish v1 pipeline red-light flow
    Add the reproducible v1 flow test and mode, archive the expected missing-interface failure, and preserve the passing baseline regression.
    AI prompt: continue locally on dev/rtl through D1-D3 in <=100-line steps, record understanding questions, and do not push.
    [tb_core_v1_flow.v]
2026-10-03 feat(rtl): Part B D1.3b 接入 ID+EX/转发/hazard 到 v1 core_top；附协作记录
2026-10-04 test(rtl): cover v1 memory widths and valid gating
    AI prompt: add a reproducible whole-core D1.2b test for sb/sh/sw, signed and unsigned loads, reset gating, and exactly-once stores; wire it into v1_mem and all, then record the understanding gate.
    [tb_core_v1_mem.v]
2026-10-04 test(rtl): verify v1 muldiv start and wait flow
    AI prompt: add a reproducible whole-core D1.4a monitor for single start, immediate front stall, 32 busy cycles, MEM+WB drain, one done pulse, and exactly-once older commit; record the understanding gate.
    [tb_core_v1_muldiv_flow.v]
2026-10-04 test(rtl): verify v1 muldiv commit and forwarding
    AI prompt: extend the D1.4 flow monitor to prove done only feeds MEM+WB, x3=21 and dependent x4=22 each commit once, and the forwarded consumer adds no data stall; record the understanding gate.
    [tb_core_v1_muldiv_flow.v]
2026-10-04 test(rtl): add reproducible v1 forwarding modes
    AI prompt: use one tb, one hex, and one RTL set with an elaboration-only ENABLE_FORWARDING switch; freeze v1_fwd/v1_nofwd commands, run both in all, verify identical results and distinct bubble counts, and record the understanding gate.
2026-10-04 test(rtl): add v1 whole-core hazard boundary tb (fwd/nofwd)；附协作记录
2026-10-04 docs(logs): 归档 PR #51 合并后 all 全量回归 48 PASS 证据（2026-10-03）
2026-10-04 test(rtl): verify v1 muldiv RAW in both modes
    AI prompt: parameterize the existing M-flow test, assert start suppression before operands are ready, and compare forwarding on/off without duplicating RTL
2026-10-04 test(rtl): add v1 arch-test forwarding modes
    AI prompt: preserve one tb and one reference signature, switch forwarding only through an elaboration parameter, isolate outputs, and support verified RV32 multilib tool prefixes
2026-10-04 test(rtl): D3.1b CoreMark 正式双档 CPI 矩阵（gain 8.14%，25% 门禁未过）；记录更新
2026-10-05 feat(rtl): close Part B radix-4 and dual-clock handoff; AI: gufa steps, reproducible dual-mode evidence
    [metrics.csv]
2026-10-05 chore(sim): vision python 解释器回退修复；补 3 条按模块拆分的协作记录（muldiv/ pynq_z2 双时钟/ vision 工具）
2026-10-05 test(verify): Part B v1 三级流水 Windows 复验与上板（XSim 对拍 + 双频构建 + 40MHz 实机 LED=1101）
2026-10-05 test(verify): 补 v1 核 Fmax 约束递减收敛（≈81 MHz，v0 基线 86.8 MHz）
2026-10-06 test(verify): 按复核意见修正 v1 证据（CPI 分类、Fmax 约束点/外推区分、OOC 报告入库、125 归因、主频门禁未决）
2026-10-06 perf(rtl): id_ex 分支比较解耦 ALU + core_top 转发接线简化（降深度，待 Vivado 复测）；按模块补 2 条记录
2026-10-06 test(verify): Part B T2 核 OOC Fmax 复测（11.52ns 过=达 v0 86.8；10ns 差 9ps 未达 100）
2026-10-06 test(verify): Part B T2 SoC 复验与上板（XSim 回归 + 40MHz 构建 WNS+7.388 + 实机 LED=1101）
2026-10-06 docs(vision): 视频/结果同步协议决策单——D1 轮次级拍板、D2-D6 推荐待评审、D7 提议定 NC
2026-10-06 docs(vision): 同步协议决策单收口——D2-D6 沿用推荐、D7 NC 本人确认接任板端服务
2026-10-06 feat(rtl): Part C 可切换 BHT（branch_predict 三档）+ 误预测恢复接入 core_top，四档 CoreMark 入口；按模块补 3 条记录
2026-10-06 feat(client): 同步协议 schema v1.1 契约层——check_id/trigger_ref + D3 判据修订 + mock /v1/check
2026-10-06 feat(client): EXE 轮次级叠加——握手/触发/撤框/重连与 interval<max-age 启动守卫
2026-10-06 feat(soc): 板级/构建按 Part C 档位参数化（ENABLE_FORWARDING/BHT_MODE 四档）；按模块补 3 条记录；附外包需求文档
2026-10-06 test(verify): Part C 可切换 BHT 验证（XSim 四档对拍 + 核 OOC 四档 + 主档 bht2 上板 LED=1101）
2026-10-06 test(verify): Part C 补 bht2 @86.8MHz 实点（WNS -0.334，确认真违反 v0 基线）
2026-10-06 test(verify): Part C 四档 iverilog 官方回归（装 Icarus Verilog 后复跑，与 XSim 逐位一致）
2026-10-06 test(verify): Part C 四档 arch-test 回归（补 BHT 档 tb/脚本；add/addi/and x4 档签名一致）
2026-10-06 perf(rtl): Part C PC/flush 降深度（if_stage valid-only flush、id_ex B 目标独立加法、core_top 掩码选择）；按模块补 3 条记录
2026-10-07 fix(rtl): core_top 声明顺序前移（采纳验证线 core_top_fix.diff）；Part C 优化后复验与上板证据入库
    - core_top.v 仅声明位置移动（bp_predict_taken/redirect_target），功能零改动：iverilog all 退出码 0、CoreMark 四档锚点逐位一致
    - data/logs/2026-10-07-partC-postopt/：核 OOC bht2@11.520ns WNS +0.538（优化前 -0.334，17→12 级）；四档@10ns nofwd 过 100MHz；SoC 40MHz bht2 WNS+3.618；上板 LED=1101/BTN0 0000→0001 与历史一致
    - 理解门槛 2 题通过；AI 产出记录 report/llm_log/2026-10-07-partC-postopt-board.md
    [core_top.v]
2026-10-07 docs(pi): Pi 4B 角色文档更新、KMS/相机预览 runbook 与启动/预览日志存档；一次性密码重置工具
    - pi-dev-roles.md：KMS cmdline video= 配置口径、Trixie 13 实机进展、中性 microSD 表述
    - data/logs/2026-10-06-pi-boot、2026-10-06/07-pi-pynq：启动、相机预览与采集卡排查原始记录
    - sim/scripts/prepare_pi_password_reset.py + pi_password_reset_once.sh：重置哈希仅在卡上生成，仓库无明文密码
    - AI 产出记录 report/llm_log/2026-10-06-pi-camera-service.md
    [display-config-before.txt]
2026-10-07 chore(vision): 并行视觉线 WIP 快照入库
    - sim/vision/：定位/分类数据生成、训练（HOG-SVM/CNN/bn 校准）、评测与显著性脚本共 16 个
    - docs/：数据集审计、实验结果、方案探索/修订与工作汇报（含中文文档 3 份）
    - models/（8MB 权重与配置）、results/（1.1MB 评测输出）
    注意：本 commit 为并行视觉线会话产出的 WIP 存档，未经本线理解门槛复核；
    该线续做时以自己的提交为准，如需改造请先 review。
2026-10-07 chore: 归档 40MHz bht2 SoC 实现报告至 build/reports；根目录 setup/hold 引脚清单导出
    - build/reports/soc_40mhz_bht2/：与 data/logs/2026-10-07-partC-postopt/ 的副本同源，按 build/README reports 入库惯例归档
    - tight_setup_hold_pins.txt：Vivado setup/hold 违例引脚清单临时导出（2KB）
2026-10-07 chore(riscv): 完成模块一四档验证与证据收口
    Prompt: 完成模块一全部收口；一次写完、理解题集中末尾。补测通过后提交。归档44次arch签名、四档XSim、八组工作负载、OOC时序及完整问答；保留100MHz失败和未实现边界。
    [diff-check.exit.txt, metrics.csv]
2026-10-07 chore(riscv): 保留模块一历史工具报告原始空白
2026-10-07 docs(riscv): 准备模块一发布稿并记录授权边界
    [pr-diff-check-final.exit.txt]
2026-10-07 docs(riscv): 回填模块一合并验收与检查点关闭记录
2026-10-08 docs: 记录 bench 复验与五分支整理规则（AI：按用户指定分支收口）
2026-10-08 fix(client): bbox 端点语义对齐半开区间 [x0,x1)x[y0,y1)，宽=x1-x0
    [test_vision_protocol.py, vision_protocol.py]
2026-10-08 test(client): 轮次状态机抽离 rounds.py + 撤框/断联/过期离线测试，修复三段恢复路径
    [test_vision_client.py, test_vision_rounds.py]
2026-10-08 feat(client): 批次记录 M3 起步——手动触发才记录/键去重/JSONL+截图，MOCK 带 mock_ 标识（D8-D10）
2026-10-08 fix+feat(client): 批次记录采纳点语义修复 + 异常事件日志 D11 + --trigger-frame 联调自检
    [test_vision_client.py, test_vision_records.py, test_vision_rounds.py]
2026-10-08 fix(client): 新鲜度改按 EXE 接收时刻计量——修复实机 flap（人工按键测试暴露）
    [test_vision_records.py, test_vision_rounds.py]
2026-10-08 fix(client): 横幅 REC 计数改常驻显示——修复按键反馈只闪一帧（人工实测未见反应）
2026-10-08 docs(evidence): 人工复验运行 2——REC 常驻计数反馈通过、flap 实机确认消失（3 条记录/1 条初始事件）
2026-10-08 docs(llm_log): 今日协作记录补全——REC 常驻计数修复 + UI 重设计三轮迭代；UI 设计定稿材料入库
2026-10-09 feat(client): HUD v3 实装——左状态框+右四格指标面板+实线绿框，四模式出图目检通过
2026-10-09 docs(evidence): HUD v3 实机目检运行——4 条批次记录 + REC4 截帧，flap 未复发（1 条初始事件）
2026-10-09 feat(client): HUD v3.1——删 AGE 格（噪声）+ 新鲜度条内嵌面板并加 FRESHNESS 标注（方案 A）
2026-10-09 docs(llm_log): 追加 v3.1 理解门槛问答（标签衬底原则）
2026-10-09 feat(client): HUD v4 Step 1——Pillow 文本引擎与布局定稿图（真实字体，待评审）
2026-10-09 feat(client): HUD v4 接入产品——EdgeSight 应用外壳（字体引擎/状态字典化/鼠标触发/字体打包）
2026-10-09 perf(client): HUD v4 渲染优化——实测 124.7→16.3 ms/帧（7.6×）
2026-10-09 fix(client): 高分屏 DPI 适配——声明 PerMonitorV2 + 按工作区等比缩放显示
2026-10-09 docs(evidence): DPI 修复实机复验——6 次触发全记录、窗口帧率 28（before 6）
2026-10-09 feat(client): 自主推进批次——CSV 记录导出 + 中文渲染能力（M3 预置）
    [records.csv]
2026-10-09 chore(rtl): 修复下载默认路径并按模块归档协作与收口证据
    同步模块一核、SoC与视觉链路的当前文档状态，保留M2未完成和历史失败数据。
    修复SoC默认位流路径与VIVADO环境回退，保持40MHz/fwd/BHT关闭默认及continue行为。
    按模板分别归档RISC-V、SoC、视觉与Git协作记录，保留完整理解门槛回答与纠错。
    附完整all exit=0、arch 44/44、静态检查和来源指纹；Windows执行仍待验证。
    AI prompt: 阅读本项目Codex/OpenCode未上传的协作历史，按模块独立记录并在template.md加索引；
    代码和记录一起提交到已有dev/rtl，不新建分支，给用户团队GitHub上传命令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
    [diff-check-final.exit.txt, diff-check.exit.txt, read-snapshot.tsv]
2026-10-10 docs(model): 归档紧固件外包原文与48项接收证据（AI：按类型拆分材料）
    [installed.csv, manifest.csv]
2026-10-10 docs(model): 对齐受控工位路线与模型交接边界（AI：区分原型与未验收项）
2026-10-10 docs(model): 保存检查V0取图与ROI预处理建议契约（AI：保留未冻结状态）
2026-10-10 test(evidence): 归档分支集成前八组回归（AI：复跑仓库入口）
2026-10-10 fix(vision): 拒绝结果报文的未知字段与非法对象（AI：逐层白名单和负例回归）
2026-10-10 feat(model): 增加共享ROI与可追溯离板检查（AI：保留FP32和复检边界）
    [installed.csv]
2026-10-10 feat(exe): 展示校验后的离线检查快照（AI：来源互斥与打包回放验证）
2026-10-10 feat(model): 导出独立逐层FP32参考与预算（AI：BN折叠和隔离复算）
2026-10-10 docs(evidence): 归档离板验证与完整理解门槛（AI：保留失败证据和未接入边界）
    [diff-check.exit.txt]
2026-10-10 feat(protocol): 报文契约 v1.2 冻结——LIVE 轮廓（WC+NC 现场确认）
2026-10-10 feat(model): 校验采集清单与原始PNG（AI：严格字段、半开框和空帧负例）
2026-10-10 feat(model): 增加集合泄漏与覆盖审计（AI：双摘要、实物隔离和原子报告）
2026-10-10 docs(evidence): 归档数据审计回归与理解门槛（AI：保留LF纠错和未验收边界）
    [diff-check.exit.txt, manifest.csv]
2026-10-10 docs(evidence): 归档协议整合后的双回归（AI：保留远端历史与LIVE界面缺口）
    [diff-check.exit.txt]
2026-10-10 docs(skill): 提炼 bug-fix-playbook 与 big-rewrite-playbook + llm_log 两项审计审注（追加式）
2026-10-10 docs(w01): C04 LIVE 语义契约设计稿 + NC 采集交接包（编号/采集表/验收矩阵）
    [fastener-collection-log-template.csv]
2026-10-10 feat(exe): W06 LIVE 显示与网络替身（PROTOTYPE 恒标/判定横幅/类别分数/实际工单）
2026-10-11 feat(exe): W07 批次记录 schema v2（decision/status/prototype 入记录 + proto_ 前缀 + CSV 扩展）
2026-10-11 feat(w05): LIVE 检查服务骨架（轮次/产物/幂等层 + 可插拔引擎）
2026-10-11 feat(vision): 新增原彩色捕获监测 RTL 与跨域约束（AI：流监测/故障CDC/只读状态AXI）
    - capture_stream_monitor：SOF/TLAST/宽高严格跟踪，故障胜过帧尾，完整帧计 stream_seq
    - capture_fault_cdc：overflow 请求/确认两级同步，源停钟保留 pending
    - capture_status_axi：只读 AXI-Lite CAP1，写/非法读 SLVERR，R,B,G→R,G,B 适配
    - capture_cdc.xdc 仅豁免 3 条首级 D；config_cdc.xdc 移除综合不支持的 Tcl if 断言
    - design_v0.md 增补 §9 捕获候选（未冻结）；新增两个捕获 tb
    - 回归：Icarus/XSim 25 项退出0（见 data/logs/2026-10-11-c01-capture-rtl/）
2026-10-11 feat(sim): C01 捕获链构建校验脚本与回归入口扩展（AI：BD生成/artifact检查/CDC断言）
    - create_capture_hdmi_bd：并联原显示支路 + Video In FIFO→VDMA S2MM→HP0，pipe/CAP1/VDMA 三地址
    - validate_capture_subsystem/probe_capture_ips：BD 断言与 IP 探测；validate_vision_cdc 接入 build_hdmi.tcl
    - check_c01_artifacts + test_c01_artifacts：XSA 内嵌 bit/hwh 逐字节、地址、复位极性 8 类负例检查
    - 回归入口：iverilog/xsim 增加 capture_monitor/capture_status 模式，python 入口扩到 11 组
    - XSim 改为仅对 tb 使用 -sv（修复全 tb 被当 Verilog 编译的问题）
2026-10-11 feat(board): PYNQ 串口传输与 C01/N03 上板诊断工具（AI：rawUART收发/状态探针/有界恢复）
    - pynq_serial_console/auth/command + send_pynq_file + pynq_file_receiver：免密钥串口登录、
    隐藏密码 sudo 认证、单行命令执行、gz/base64 rawUART 文件传输与 SHA 复读校验
    - c01_status_onboard：捕获状态诊断探针——起止 VDMA CR/SR 与 stream_seq 实值、
    MAIN-FAIL/RECOVERY-FAIL 异常分离、faulthandler 单次兜底、恢复有界单次重试
    - run_c01_status(_coexist)：65s 远端超时 runner 与 UVC 共存窗口包装器
    - n03_board_capture/stop_dma/recover_png + run_pynq_baseline：N03 base 取帧与守卫脚本
    - capture_uvc_raw/lis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
2026-10-11 docs(c01): 捕获基线/状态契约/三人收工清单与交接上下文（AI：stream_seq判据修正记录）
    - c01-capture-status-contract：CAP1 CSR/帧完整性故障规则/PS 使用边界（候选 v0.1）
    - c01-capture-implementation-baseline：连接图/内存颜色边界/构建验证/失败史，
    末节记录 stream_seq 疑点实测闭环（v6.3 FSYNC=2 halted dummy-tready，delta=1200=60fps×20s）
    - project-closeout-three-person-checklist：N01-N14/J01-J10/W01-W12 三人并行收工拆解
    - project-handoff-2026-10-11：换对话交接上下文（23:15 增补诊断 PASS 结论）
    - onboard-2026-10-11-c01-draft 与 N03 诊断 llm_log
2026-10-11 docs(evidence): 归档 2026-10-10/11 上板与 C01 捕获实机证据（AI：原始日志+SHA清单）
    - 2026-10-10-onboard-n01：板端基线 N01（bit/hwh 指纹、pipe 帧首、60秒在流）
    - 2026-10-10-onboard-bit-provenance：10/03 修复版 XSA 溯源
    - c01-capture-* 两轮构建输入快照与 2026-10-11-c01-capture-rtl：BD/实现日志、
    修复候选 bit/hwh/xsa SHA、实机失败与恢复全程（含 settled-script-archive 改前脚本）
    - 2026-10-11-c01-hdmi-* 三个构建报告（WNS+0.495/CDC 8 Critical 保留披露）
    - 2026-10-11-n03-buffer-guard、onboard-resume：N03 base 短测与 freebuffer 守卫
    - 2026-10-11-c01-probe-evidence：stream_seq 闭环证据（CR/SR 实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
2026-10-11 docs(evidence): 收录根目录 Vivado 会话日志抢救副本（AI：含10-03 PicoRV32 fmax 实测原始日志）
    - vivado_33648.backup.log：2026-10-03 build_fmax.tcl pico_large_7ns（PicoRV32 对比实测会话）
    - vivado_10748/11364/20000：2026-10-07 视觉综合会话日志
    - 根目录 *.log/*.jou 被 .gitignore 忽略，此目录为防丢失的逐字节原样副本
2026-10-11 feat(coprocessor): G0 契约冻结 + INT8 参考模型（C02/C03 + Python 黄金参考）；按模块补 3 条记录
2026-10-11 docs(skill): 按 3.3.5.2 官方要求全量精读 llm_log 113 条，成稿 5 项技能包
2026-10-12 docs(evidence): 保留初次沙箱N03测试退出记录
    AI：补录受限进程终止后的原始退出码；正常MSYS2入口两项均已PASS。
2026-10-12 test(w08): 服务×EXE 联合离板回归 + 工业场景黄金（栈内 11 组 / 打包 6 关）
2026-10-12 test(w05): 真引擎走通服务（service_engine）——file_engine 转正 + 检查链入口 13->14 组
2026-10-12 docs(evidence): G0 接口样例——v1.2 LIVE 样例报文与期望显示映射（给 NC/JL）
2026-10-12 docs: 记录重依赖检查链的仓库本地 venv 跑法（2026-10-12 实测 14/14）
2026-10-12 feat(coprocessor): J01 审计决策 + Conv/GAP/FC 与整网/结果 INT8 参考（8 项 Python 测试 PASS）；按模块补 3 条记录
2026-10-13 perf(riscv): mem_wb 复位与 payload 捕获分离，SoC 40MHz bht2 WNS 3.618→6.447
    - mem_wb_stage.v：mem_valid 保留异步复位；payload 移入无复位无使能时序块，
    消除复位派生 CE（291 个 CE 引脚）及其驱动的 SoC 高扇出慢路径（布线占 96.5%）
    - tb_mem_wb_stage.v：新增复位期 payload、释放、短脉冲边界检查（3→39 项捕获）
    - 证据 data/logs/2026-10-13-soc-reset-ce：28 模式回归全 PASS，四档 benchmark
    周期数逐拍不变（2850/2423/2380/2351），CoreMark 2K/32 金标准 PASS（CPI 1.693）；
    Vivado 同条件 A/B 基线复现归档 WNS 3.618，改后 6.447，端点 43808→43517（-291）
    - design_v1.md §12.5 契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
2026-10-13 fix(c01): 辅助复位缺陷修复与构建输入精确恢复包（NC 离板续工，理解门槛 3/3）
    - validate_capture_subsystem.tcl 把 aux_reset_in 从低常量修正为高常量；check_capture_reset_release.tcl 读取实际 BD 极性/常量/连线，6 个真实负例全部正确拒绝
    - audit_c01_build_inputs.py + test_c01_build_inputs.py 逐条 SHA256/字节数严格校验；98/98 构建输入精确恢复包入库（68 条 CRLF 恢复，定向 -text），旧归档不改写
    - run_vision_python.sh 接入 c01_build_inputs，14 组 Python 回归通过
    - 文档：c01-ddr-frame-ownership-v0、nc-offline-readiness-2026-10-12、三人收尾清单、vision-live-semantics
    - 证据：data/log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
2026-10-13 docs(evidence): 归档 10-12 离板记录与文档/采集准备
    - unattended-offline：离板续工原始输出与源快照核对；- implementation-document-audit + 审计记录：文档与实现一致性审查（无新代码变更）；- collection-readiness：采集规程/CSV/交接包同步记录；- NC 返场执行单（nc-return-checklist）
2026-10-13 docs(evidence): 归档 2026-10-12 上板 N02/N03 诊断与断源恢复记录
    - board-connect：原 vision 短基线与连接/身份记录；- n02-extended：三段 240s 在流观察 + 六次 UVC + 一次 Overlay 重载；- source-recovery-prep：采集卡连接下 Pi 软重启的断源/恢复观察；- n03-base-return：base 完整 BGR 副本、PNG 双哈希、20s HDMI OUT 共存与恢复；- real-frame-prototype：板端原图的主机 FILE_REPLAY 诊断（定位 36 候选 RECHECK）；- 对应三份 llm_log。均无 RTL/脚本源码改动
2026-10-13 feat(coprocessor): INT8 乘加原语与符号溢出检测（C02 首步）
    - int8_mac.v：16bit 有符号乘积、33bit 符号扩展累加、overflow=total[32]^total[31]，溢出置无效不饱和
    - tb 65035 向量并通过 cop_mac 入口；证据 data/logs/2026-10-12-cnn-mac-step1
    - llm_log 追加提交前理解题回答与判定 2/2
2026-10-13 feat(coprocessor): O16/I8 MAC 阵列与 requant/GAP/logits 算术算子
    - mac_array/mac_array_pipeline：128 乘法、八输入求和、五级 CE 流水、valid 随数据暂停、abort 清 valid
    - requant 四拍（ReLU→32x32→64bit 绝对值/舍入/移位/对称饱和）、GAP 256 求和、logits margin/score
    - Python 参考与向量生成器、独立 tb 期望
2026-10-13 feat(coprocessor): 卷积/FC 调度引擎与整网序列控制器
    - conv_engine：一拍同步 BRAM 读、分拍坐标/地址、padding/CI1/CO 尾 lane、bias、MAC 溢出与 requant 错误、watchdog
    - cnn_sequencer：四 Conv→GAP→FC 整网、ROI/ping-pong/权重银行接口、pause/reset/timeout 不虚假 DONE
    - Python 整网参考（固定 shape/dtype、禁 -128、正值 multiplier、INT32 累加界）与零权重常量网络黄金
2026-10-13 feat(sim): 协处理器回归接入 iverilog/Python 统一入口
    - run_iverilog.sh 增 cop_mac/cop_array/cop_conv/cop_network 档并并入 all
    - run_coprocessor_iverilog.sh / run_coprocessor_python.sh 一键入口
2026-10-13 feat(sim): 协处理器 OOC 综合脚本与首轮时序报告
    - synth_coprocessor_ooc.tcl / run_cnn_ooc.ps1：Vivado 2026.1 默认 Verilog OOC 一键入口
    - 首轮报告 data/logs/cnn-ooc-5c9bc74c/（含 DRC/时序/资源文本）
2026-10-13 docs(evidence): 归档 CNN 算术/整网/OOC 全量证据与离板源码包
    - data/logs/2026-10-13-cnn-arithmetic：算术/流水/卷积/整网/OOC 原始日志与 final-summary
    - data/evidence/2026-10-13-cnn-{ooc,address-ooc,pipeline-ooc}-inputs：三轮 OOC 输入快照
    - cnn-ddr-offline-{0635d33e,cdfbf682} 源码/黄金快照包 + archive 脚本
    - llm_log（含用户 B 组答案覆盖第 1/3 题、第 2 题待答）与离板交接文档
2026-10-13 docs(coprocessor): design_v0 §4.4 契约与 README 同步 10-13 实现进度
2026-10-13 feat(pynq_host): C01 custom DDR 单帧捕获驱动与所有权保护
    - src/pynq_host/c01_capture.py：四独立 DMA buffer、park0、一帧自动停止；IRQ+RS0+Halted+slot/描述符联合确认后 invalidate 并复制独立副本；未知停机隔离原生缓冲、幂等释放
    - sim/vision/test_c01_capture.py 七组离板异常测试；run_vision_python.sh 接入 c01_capture（视觉 Python 至 15 组）
    - 两次实验的输入快照 data/evidence/2026-10-13-ddr-experiment-inputs
2026-10-13 docs(evidence): custom DDR 单帧实机实验记录与帧槽/捕获文档更新
    - data/logs/2026-10-13-ddr-single-frame：两次实测均在启动 DMA 前失败（DMA reset/clear not clean、sticky 状态），释放与原 vision 恢复确认、boot_id 未变
    - c01-capture-implementation-baseline 状态同步至 10-12 基线并注明单帧所有权候选已实现未取到完整帧
    - c01-ddr-frame-ownership-v0 增补 10-13 实验边界
2026-10-13 feat(docs): 仓库逐文件说明索引工具与生成结果（file-guide）
    - docs/file-guide/：scan/describe/render 工具与 4599 文件逐条说明（README/index.html/files.csv/files.json/sections）
    - report/llm_log/2026-10-13-repository-file-guide.md：生成过程记录
    - 索引是导航，不替代验收报告与源码锚定
2026-10-13 docs: 10-13 项目状态同步（README/主计划/三人清单/pynq_host）
    - README/plan/三人清单同步 10-13 事实：CNN 算子与整网控制器、诊断整数黄金、控制器 100MHz OOC 通过；DDR 单帧离板测试；C03 MMIO/AXI4-Lite+DMA 冻结；新三人工分包
    - docs/README 增 file-guide 入口与模块三状态行
2026-10-13 docs: 10-12 文档与实现一致性审计的文档更新
    按 data/logs/2026-10-12-document-audit 审计结论修订 12 份文档的已实现/未实现口径（coprocessor、module3、riscv_fw、vision、vision_client、inspection-v0、onboard-draft、c01-status-contract、offline-inspection、project-overview、non-algorithm、vision-sync）
2026-10-13 docs: 采集规程/交接包口径同步与离板准备更新
    会话目录小写 l0..l3、light 列保持 L0..L3；CSV 示例补 washer-a；NC 离板准备引用候选哈希与检查入口
2026-10-13 chore(soc): 归档未采用的 SoC A/B 草稿与 A/B 源码快照证据
    check_soc_reset_ce.tcl 为上一会话草稿、从未运行，A/B 已由 build_soc_ab.tcl 取代（c3b6a1e）；data/evidence/2026-10-13-soc-reset-ce 为 A/B 输入快照
2026-10-13 docs(llm_log): 修正 CNN/DDR 线中间状态注记（门槛已补测通过、产出已提交）
    收口前追加的“第 2 题未答/未 commit”注记与同日 15:25 的『补测判定：通过』冲突；修正为以收口记录为准，并注明产出已随 f020d73 等提交推送（origin/dev/model=f81ad98）
2026-10-13 docs(evidence): 三分支合并后回归记录（Python 9/16/14 组 + RTL 123 项全 PASS）
    PR #72/#73 合并、dev/model 并入 origin/main（12fe250）后全量回归：coprocessor 9 组、vision 16 组、inspection 14 组、run_iverilog all 123 项 PASS；四档 CoreMark CPI 与黄金一致
2026-10-14 docs(nc): 归档离板验收与返板交付
    覆盖 C04 本人确认和 Q5 对齐、N03 精确脚本/产物审计、当前 Windows 候选验收及 N04–N14 执行件。AI prompt：扩展无板卡可做事项并快速完成，归档原始证据后 push；生产代码未改，按文档/data记录豁免理解题。
2026-10-14 docs(evidence): 记录 NC 交付推送与便携草稿附件
    上传远端附件为78,183,698字节，服务端SHA256与本机候选一致；更新上板入口。AI prompt：push当前离板产出，等待上板开工；仅上传记录与文档，无生产代码改动。
2026-10-14 fix(exe): 批次记录重启去重——从 records.jsonl 重建键与计数（NC 返场执行单点名）
2026-10-14 feat(w05): 快照读取与哈希核对（C04 2.3）+ 请求重试语义草案（2.4）
2026-10-14 feat(exe): CSV 增 reasons 列（C04 Q5 部分计数标识）
2026-10-14 docs(c04): Q5 边界补 C03 冻结口径（16 能力/10 策略不互替）
2026-10-14 feat(w04): C01 捕获后端适配 + 服务级离板替身（所有权租约/独立副本/失败隔离）
2026-10-15 feat(w02): 数据集审计扩展——GT×manifest 交叉核对 + 朝向覆盖统计（工具链预备）
2026-10-15 docs(llm_log): 补录 10-12/10-13 协作记录四条（W08+W05-2、NC 响应、W04、W02）
2026-10-15 feat(w04/n06): base overlay 捕获后端——诊断包接线补全（三类后端 prototype 结构性齐备）
2026-10-15 docs(c03): 增 WC(PS 侧)对接注记——接入形状与 J08 交付要求（不改变冻结项）
2026-10-15 perf: 降低 CNN 资源与周期并解耦软件轮询
    CNN 改用两路 requant、块参数缓存和重叠读/MAC 调度，
    将 DSP 从 192 降至 136，诊断整网从 1123109 降至 472593 周期。
    启动时锁存 watchdog 边界并收窄尺寸计算，保留整数与错误语义。
    JALR 使用独立加法器，cop_buf 用读列计数代替取模。
    定位保留半整数中值精度；FILE 原型自动检查在内存运行并复用模型，
    手动及非原型轮次保留归档；EXE 网络轮询移入单工作线程。
    增加显式 opt-in 的 C01 Park 离板候选及共享回归所需 C01 测试。
    验证：run_iverilog.sh all 退出 0，四档 CoreMark 周期不变；
    CNN 100 MHz OOC 13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
2026-10-15 feat(coprocessor): 在 origin 基线上补回本地独有的 mac_lane/dot8 单元与记录（J02 包因参考库 API 不兼容未并入）
2026-10-16 feat(c01): park 驱动按板端实测换代判据与暖机清除语义
    - cap 判据弃 0xC 全掩码（bit3=epoch 历史锁存，capture_status_axi.v:83），
    改 lock(bit0)+pending(bit2)+事件计数相对基线零增量
    - 暖机 W1C 规则 exact 0x4810 → errors & 0x4810 重复式（残留 0x810 曾致 v3 超时）
    - 启动瞬态在暖机批准点重定软件基线（吸收窗口边界与兜底见契约 §10/16）
    - 替身 5 用例重建模：瞬态/pending/bit3/double_transient/重复 W1C/未知属主
    板端证据：data/logs/2026-10-16-c01-park-first-board/（暖机批准→槽0→槽1保护→
    双副本字节级一致→净停恢复）。理解门槛 4/4（report/llm_log/2026-10-17-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
2026-10-16 docs(c01): 所有权契约增补 10/16 板端语义定性与判据换代
    - 停机 0x4810 电平型定性（W1C 无效）、启动瞬态自愈、批准延迟假象、停止瞬态
    - 暖机 W1C 交集重复式归因修正（bit14 已清+bit4/11 残留；bit12 本被掩码排除）
    - 已知边界：吸收窗口未强制单次瞬态，兜底与验收开放状态如实记录
    - 理解门槛 Q2/Q3 产出回写
2026-10-16 fix(client): LIVE 轮次超时按板上引擎实测放宽至 300s（owner 授权过渡）
    park LIVE 后端 numpy 引擎整轮实测 94-122s，原 2s（FILE 即时引擎口径）必超时。
    回收口径见 report/llm_log/2026-10-17-understanding-gate.md Q4：C03 硬件 CNN 后
    按完整轮次实测收紧，status/config 恢复短超时，复验断联/撤框。
2026-10-16 docs(evidence): 归档 C01 park 全链、CNN 上板与 EXE 环接通证据及理解门槛记录
    - 10-15 板启/N02-N03 联调/停机 SR 定性；10-16 park 驱动十轮板端实验与全链首跑；
    10-17 EXE 环网络接通与 LIVE 服务两轮 PASS
    - llm_log 四份协作记录 + 理解门槛 4/4（Q2 归因修正、Q3 边界、Q4 回收口径）
    - 并行会话未提交目录（cnn-*/improvements-fast 等）不在本包，各自会话处置
2026-10-16 test(c01): ordering 牙齿测试保留既有 PYTHONPATH（依赖在仓库 deps 目录的机器上变异体重跑不再误报）
2026-10-16 test(coprocessor): 把 mac_lane/dot8 接入协处理器 runner（单独模式 + all）；附协作记录
2026-10-16 feat(exe): HUD 交互改版——识别范围表（类别/勾选/计数）+ RUN 集成反馈（owner 评审稿）
2026-10-16 fix(exe): 识别范围表移入右侧栏顶部——视频画面不再被遮挡（owner 评审意见）
2026-10-16 docs(evidence): 归档 EXE 识别范围表改版评审（两轮布局 + 交互设计 + 一键出图脚本）
2026-10-16 docs(evidence): 归档 10-15 五组离板独立复核证据
    - C01 入口端到端替身 step2-3（main 不接板真实执行，11 条路径）
    - C01 停机期粘滞错误位含桩覆盖 step1（0x4810 判据缺口）
    - CNN 快批次声明第二人独立复核（472,593 周期等逐项一致）
    - CNN 几何位宽优化 step1 独立交叉复核（conv_engine 新旧哈希）
    - N03 实验包离板 SHA256/配对独立复算（6/6 OK）
    均为记录类归档，不改生产代码；AI 会话归档。
2026-10-16 docs(evidence): 归档 10-17 EXE 环 LIVE 全链接通与服务自愈记录
    - PS→EXE 环真实网络接通：板端 park 采集后端 + numpy CNN 引擎装入 W05 LIVE 服务骨架，
    PC 经 192.168.50.99:8765 消费 v1.2 包，/v1/status 与 /v1/check 两轮 PASS
    （round_seconds=121.6/94.2，合法四元组目标，RECHECK 属实：场景未构图+触边+超限）
    - 板子重启后服务挂掉全记录：death/service-down/uptime-OOM 探查、七版 park_live_server
    迭代原始日志、nohup 重拉与 pkill 自匹配教训
    - cron 自愈安装（pynq-live-cron）与上传/自愈验证
    - HDMI IN 断源诊断与恢复基线（restore-baseline-novideo / video-back-check）
    均为记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
2026-10-16 docs(enclosure): 三层亚克力工位容器结构概念图 v1 入库
    上层树莓派+CM3 镜头下视、中层开放识别区（承物板+可移除哑光底衬）、
    下层 PYNQ-Z2 绝缘支柱固定；侧后方 HDMI 走线、下层外部接线口。
    仅空间布局概念，非加工图；工作距离/视野/散热/刚度未验证，
    加工尺寸待实板实测后定。N04/N05 拍摄环境前置物料的概念锚点。
2026-10-16 docs(plan): M3（10/20）卡点报备与 10-15/10-17 状态同步
    - plan.md §3.1 新增 10-15/10-17 状态与 M3 报备条目（prototype 六环不入验收；
    C03 硬件 CNN、正式工位、N10-N12 实测预计顺延，§3.4 提前说明口径）
    - 三人清单 §2/§7 同步口径与证据链接
    - 纯文档提交，理解门槛豁免；AI 会话归档
2026-10-16 docs(enclosure): 壳体实测与物料检查单 v0
    把概念图 v1 落成三件事：先量实物（板卡占地/镜头工作距离/FOV/线缆净空）、
    再按推导链接尺寸、最后下采购单（板厚/支柱/底衬数量定、尺寸留空）。
    数值全部留空待实测；壳内工作距离若低于采集规程 40-80cm 档属条件变更，
    先报 WC/JL 评审。纯文档，理解门槛豁免；AI 会话归档。
2026-10-17 docs(coprocessor): record night-stage requirements audit
    Read and restated repository contracts, plans, active-vs-diagnostic datapath boundaries, and safe night scope. Validation: git diff --check
2026-10-17 docs(coprocessor): close J03 off-board acceptance
    Add the module J01-J10 plan, record reproducible J03 acceptance, and distinguish diagnostic mac_lane/dot8 from the active mac_array_pipeline path. Validation: repository all exit 0; git diff --check.
2026-10-18 feat(coprocessor): J04-9 assemble control-plane top
2026-10-18 feat(riscv_fw): 协处理器工单 cop_job 固件（MMIO 驱动 + 共用判定）；附协作记录
2026-10-19 docs: align counts and implementation status with code
    Correct Python entry counts (vision 21, inspection 14, INT8 9), CNN operator/controller RTL status, CoreMark SoC timer/metrics status, EXE cross-process dedupe, vision interface freeze status, and moved doc path labels. No code changes.
2026-10-19 docs(coprocessor): 按模块补 J04-20~28 协作记录（abort/reset、PS 权限/配置读回、DMA 错误锁存、交接/固件）
2026-10-19 fix(coprocessor): 撤销配置失效状态并修复连续任务的 stale-done 竞态
    - CFG_VALID 由 CFG_APPLIED==CFG_SEQ 组合得出；CFG_SEQ 变化即撤销 MODEL_VALID/ROI_VALID，
    CFG_COMMIT 后必须重新装载才置位（OPEN-3 的保守实现）。
    - ABORT 同拍清 DONE/RESULT_VALID，避免残留结果被当成新结果读走。
    - cop_task_ctrl 在发出 start 的当拍不消费 engine_done：引擎 done 会保持到下一次 start 才清零，
    原先第二笔任务会拿到上一笔 done，瞬间“完成”并回写旧结果。
    - TB：config 撤销、ctrl ABORT 清位、top 第二次 START 后 20 拍仍 busy、task_ctrl 遗留 done 零副作用。
    - 复现：bash sim/script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
2026-10-19 fix(riscv_fw): 工单固件按 READY/CFG/MODEL 与 RESULT_SEQ 门禁取结果
    - cop_wait_ready 轮询 READY|CFG_VALID|MODEL_VALID，遇 STATUS.ERROR/TIMEOUT 直接拒绝。
    - ROI_COUNT 为 0 或大于 16 返回 CONFIG；大于 10 返回 TARGET_LIMIT 且不读旧结果（检查 V0 策略）。
    - 取结果前后校验 DONE/RESULT_VALID/RESULT_SEQ 一致，轮询有上限，失败一律 RECHECK。
    - 重建 cop_job.hex/cop_job.dis（riscv32-unknown-elf-）。
    - 生成物固定 LF：bin2hex.py 用 newline="\n"，%.dis 规则过 tr -d '\r'；否则 Windows 默认
    换行转换会让入库指纹随平台变化（.gitattributes 是 * text=auto eol=lf）。
    - runner 支持 RISCV_CROSS/COPROCESSOR_PY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
2026-10-19 docs(coprocessor): J04 拆成 J04a/J04b 并把交接单迁入 runbooks
    - 模块计划/README/概览/契约索引统一口径：J04a 已实现与离板冒烟，J04b 完整验证未完成。
    - 交接单 git mv 到 docs/runbooks/ 并挂 4 处导航；锚点改为远端 7d6355b，旧哈希标注为 rebase 前记录。
    - §2 指纹按修复后代码重算（24 个文件行数 + SHA256）。
    - 新增 OPEN-9（VERSION/CAPABILITY/ERROR_CODE 读 0）与 OPEN-10（PS 空闲 ABORT 口径）。
    - 新增无日期收口待办 docs/closeout-todo.md，以及本次审查的协作记录。
2026-10-19 test(coprocessor): Windows 复跑证据与一键重跑脚本
    - windows-{all,cop_top,firmware,soc}.{log,exit_code}：修复后重跑，四项退出码均为 0。
    - windows-rerun.sh：一键重建这四份日志，也可只跑其中几项。
    - README 记录命令、环境、结果、失败与修复、固件产物指纹和边界（OPEN-9/10 未验证项）。
    - cop_job.hex/dis 指纹按固定 LF 的生成物重算。
2026-10-19 fix(sim): 修通 Windows 下的 Python 回归入口
    - run_coprocessor_python.sh 与 iverilog runner 同口径：python3 不可用就退回 python，
    否则 Windows 上 run_iverilog.sh all 会在 Python 段直接 exit 1。
    - make_arm_localize_pkg.py 的 README 源仍指向 docs/arm-localize-runbook.md，该文件已迁到
    docs/runbooks/，导致 run_vision_python.sh 打包用例必然失败；改路径。
    - 复现：run_coprocessor_python.sh all、run_vision_python.sh 均退出 0
    （vision 需 PATH 里有 git，打包用例会调 git rev-parse）。
2026-10-19 test(coprocessor): 补分段回归证据与 CoreMark 前置说明
    - 新增协处理器 Python、视觉 RTL、视觉 Python 三段日志，退出码均为 0。
    - 核 20 个 TB + 协处理器 all 的日志记为 partial：72 个 PASS、0 失败，之后进入 CoreMark
    四档基准的长仿真，本轮主动中止，不声称全仓单次跑完。
    - README 明确边界：未跑 Vivado/综合/实现/bitstream，未上板；CoreMark 与 v1_* 变体本轮未重跑。
2026-10-19 docs(closeout): 更新本轮收口待办完成状态
2026-10-19 docs(coprocessor): 锚点更新为 PR #86 的分支头 855b433
2026-10-19 docs(coprocessor): 交接单锚点改为 PR head，避免自我引用失效
2026-10-19 fix(coprocessor): 独立审查 R1–R5：遗留 error 误杀重试、脚本退出码与指纹
    R1 启动保护只挡了遗留 done，遗留 error 仍会在发出 start 的那一拍终止重试任务（引擎刚开始跑、
    任务层已报错）。WAIT_ENGINE 的 error 分支同样加 !engine_start_o；tb_cop_task_ctrl 增加
    “遗留 error 后重试仍能跑完”与“启动后真出错”两段，去掉保护即 $fatal。
    R2 记 OPEN-11：C03 §8 要求“有效空场景 → CHECK_FAIL”，但 v0 没有“本帧有效且零目标”的表达，
    cop_job.c 就地注释，避免把 ROI_COUNT=0 当成有效空帧。
    R3 windows-rerun.sh 保存被测命令退出码并在任一项失败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
2026-10-19 docs(review): 归档 Codex 独立审查报告与核查记录
    reviewer 未提交（原文注明“没有 commit、push”），这里按原样入库，便于 PR 里对照 R1–R5 的处置。
    - report/llm_log/2026-10-19-deepseek-independent-review.md：5 条 P2 与证据边界。
    - data/logs/2026-10-19-deepseek-independent-review/：指纹复算（FILES=24 MISMATCHES=1）、
    diff-check、两次短用例尝试的原始输出与退出码（工具环境失败，非用例失败）。
2026-10-19 test(coprocessor): 给 %.dis 规则补“失败必须暴露”的自测
    R4 之前只有“重新生成字节一致”这一层证据，证明不了 objdump 失败会被 make 捕获。新增
    sim/scripts/test_firmware_rules.sh：先正常构建一次取指纹，再用 OBJDUMP=false 构建，要求
    make 非零退出、cop_job.dis 未被改写、且不是空文件；接进 run_coprocessor_iverilog.sh 的
    firmware 入口，随固件回归一起跑。
    负向对照：把规则换回 objdump 直连 tr 后自测 FAIL，并且真的留下一个空 cop_job.dis
    （sha256 e3b0c442… 空文件），make 仍返回 0——R4 描述的后果实测复现。
2026-10-19 test(coprocessor): 补 AXI4-Lite 背压/乱序/SLVERR/复位用例（B05 第一步）
    OPEN-7 里 AXI 面只做了“正常一笔”，这次把能离板做的都补上：
    - AW/W 同拍，以及 W 先到、AW 后到（两笔收齐才发 launch）；
    - B 通道背压：bvalid 不被拉掉，未完成时拒收第二笔；
    - 写 / 读 SLVERR 分别回 2'b10；
    - R 通道背压：未消费时不再收 AR；
    - 复位清掉未消费的 B/R。
    复现：run_coprocessor_iverilog.sh axi_lite 与 all 均退出 0。
    仍未覆盖：多 outstanding / burst（有意不支持）、跨 AXI 时钟域复位序列、CDC 异步相位扫描。
2026-10-19 feat(build): cop_top OOC 综合/实现，顺带补 CDC 的 ASYNC_REG
    - 新增 build/build_cop.tcl：xc7z020clg400-1、out_of_context、core_clk 25 ns / cop_clk 10 ns、
    默认 Verilog-2001 读取（不加 -sv）、synth+opt+place+route，报告落 build/reports/cop/。
    - 结果：0 critical DRC；LUT 6,699 / FF 7,181 / DSP 136 / BRAM 0。
    - 时序：cop_clk WNS −2.743 ns（≈78.5 MHz），不达 100 MHz；前 10 条违例都在 cop_dma_loader
    的 CRC32（crc_state_reg → crc32_o_reg，13 级 LUT）。core_clk WNS +19.341 ns。
    - CDC：core_clk→cop_clk 45 端点，0 unsafe / 0 unknown；No ASYNC_REG 1→0，给 cop_cdc_mailbox
    的两级同步链补 (* ASYNC_REG = "TRUE" *)。
    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
2026-10-20 feat(coprocessor): CRC 逐字节折叠，cop_top OOC 过 100 MHz（关 OPEN-12）
    cop_dma_loader 原来把 8 字节 CRC 在一拍内折完，组合树 13 级 LUT，OOC 实测 cop_clk 10 ns
    WNS −2.743 ns（≈78.5 MHz），是 cop_top 过不了 100 MHz 的唯一卡点；CNN 阵列反而不是瓶颈。
    改成逐字节折叠：beat 先进 hold 寄存器，每拍折一个字节，折完才收下一拍；消化期间拉低
    stream_ready_o，上游 DataMover 按 AXI-Stream 协议等待。CRC 多项式/字节序/初末值不变，
    TB 用 cecee288 锚定；C03 §9 只要求背压正确、不丢字节不重复计数，没有锁吞吐。
    OOC 复跑（build/build_cop.tcl）：cop_clk WNS −2.743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
2026-10-20 chore(build): cop OOC 报告更新为 CRC 修复后的数字（WNS +0.165 ns）
2026-10-20 docs(repo): 收口卫生证据与三人分支协作
    AI-assisted: 按用户要求核对远端差异、合并 J04 PR 并同步三人分支；归档全量回归和卫生修复，明确返回 CDC 缺口，群内工单仅留本地。仅追加文档、配置与数据记录，按理解门槛对应豁免处理。
2026-10-20 fix(chain): Q5 策略/能力分层 + 未完整计数诚实展示 + 快照 ROI 哈希链（NC 10-14 评审三项）
2026-10-20 feat(coprocessor): C03 寄存器模拟器 + PS 驱动（提交/完成/结果/恢复）
    - cop_regs: C03 §4 offset/STATUS/CTRL、cop_judge 镜像、FW_DECISION 编解码
    - cop_mmio_sim: 配置原子提交、busy 拒 commit、sticky/W1C、结果窗、watchdog、ABORT/SOFT_RESET、故障注入
    - cop_driver: RESULT_SEQ 双读、FW_DECISION 复算、PS 不得更宽松、重复 JOB_ID、恢复重试；真实 DMA 面显式未实现
    - tests: test_cop_mmio / test_cop_driver（超时/旧结果/CRC/ABORT/复位）
    - docs: PS 使用档与 JL 阻断项（固件重复作业、预启动完成通知等）
    AI prompt 要点：用模拟硬件先跑通 PS 软件流程；错误/旧结果不得显示为 PASS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
2026-10-20 feat(chain): COP_SIM 服务引擎、cop_trace 追溯与失败撤框/重试
    - cop_engine: 定位→ROI→sim 提交→规则；border/低置信/目标错误/超 10/空场景门
    - vision_live_service: --engine cop-sim、/v1/status.engine、trigger_ref 16 条回放
    - round_artifacts: cop_trace 帧/ROI 哈希链核对，ROI 篡改拒绝
    - EXE: 手动失败立即撤旧 PASS；同 trigger_ref 重试；--image 静态图联调
    - tests: test_cop_engine/test_cop_service；inspection gate 新增 4 组
    AI prompt 要点：超时/重复请求/旧结果/失败不得显示成 CHECK_PASS。
2026-10-20 test(evidence): COP_SIM 服务+EXE 一轮与异常矩阵归档
    - run_cop_sim_round.sh + test_cop_exe_round.py：真实服务+EXE 无头一轮（显示/保存/追溯）
    - data/logs/2026-10-20-cop-sim-round：summary/screen/records/packet/cop_trace/ROI 哈希链、异常矩阵、inspection+vision gate 原始日志与退出码
    - inspection gate 19 组、vision gate 21 组，均 exit 0
    - llm_log 与 data 索引刷新；明确模拟/软件/板上边界
    AI prompt 要点：模拟跑通、软件跑通、板上跑通分开说，不用模拟结果冒充硬件。
2026-10-20 feat(coprocessor): K2 plan BRAM storage; 附协作记录
2026-10-20 fix(coprocessor): 对齐 JL K1 的正常轮写权限、PS 基址与旧 DONE 竞态
    - 正常轮 PS 不写 CLEAR_DONE/CLEAR_ERROR（C03 §3.2 归 RISC-V）；仅错误/超时/重启恢复清
    - 终态轮询只接受 RESULT_SEQ 已变化的 DONE；旧 DONE 持续超宽限即报错，不贴旧结果
    - PynqMmio 强制 Address Editor 的 PS AXI base，移除核侧 0x8001_0000 默认
    - 服务端忽略客户端正常断连的 BrokenPipe/ConnectionReset
    - 测试：正常第二笔无 CTRL 写；PynqMmio 缺 base 拒绝
    - 文档登记 READY 窗口与消费回执两项待 JL 确认
2026-10-20 test(evidence): 重新生成 K1 对齐后的 COP_SIM 一轮与 gate 日志
    - 新 session 2daf0ed0/check 1：CHECK_PASS 1/1/1；summary/screen/records/packet/cop_trace/ROI 链刷新
    - 异常矩阵与 CLI 冒烟按最终代码重跑；inspection 19 组、vision 21 组均 exit 0
    - 证据 README 记录正常轮不写 CTRL 与两项待 JL 确认
2026-10-21 fix(coprocessor): 裁决A-B冻结消费握手
2026-10-21 fix(coprocessor): 裁决B-结果序号按轮提交
2026-10-21 fix(coprocessor): 裁决A-实现消费状态寄存器
2026-10-21 fix(coprocessor): 裁决B-更新消费回归
2026-10-21 fix(coprocessor): 裁决A-固件改用回执看门狗
2026-10-21 fix(coprocessor): 裁决B-补齐T1至T7证据
2026-10-21 fix(coprocessor): K2-冻结未验证边界
2026-10-21 fix(coprocessor): K3-增加单拍BRAM存储
2026-10-21 feat(coprocessor): K3 bram_network runner; 附裁决 A/B、固件与 K3 记录
2026-10-21 fix(coprocessor): K3-固化BRAM一键对拍
2026-10-21 fix(coprocessor): wire firmware E2E runner
2026-10-21 feat(coprocessor): 对齐 C03 A1/A2 消费握手与两个软件看门狗
    - sim: READY=!BUSY、ACCEPTED/UNCONSUMED、互斥终态、CONSUME、ERROR_CODE 1/12/13、NO_ACK/HW_TIMEOUT 故障
    - driver: 等 CFG_APPLIED→ACCEPTED→终态；NO_ACK/HW_TIMEOUT 独立软件看门狗；期望 RESULT_SEQ；落盘后 CONSUME；STALE_RESULT
    - engine/service: packet/latest 落盘成功后 consume，trace 记录 consume；失败先写 trace 再消费
    - tests/docs: 19 组 inspection + 21 组 vision exit 0；JL decision_ab/cop_top/bram_network exit 0
    - 已知：本机无 host gcc，firmware 主机规则测试未跑；A2 后 cop_job.hex/dis 待 JL 重建
2026-10-21 test(evidence): C03 A1/A2 一轮、异常矩阵与 JL RTL 回归归档
    - 新 evidence：session 76d4d652/check1 CHECK_PASS 1/1/1，trace.consume status_after=97/unconsumed=false
    - inspection 19 组、vision 21 组 exit 0；JL decision_ab(T1-T7)/cop_top/bram_network exit 0
    - NO_ACK/HW_TIMEOUT/STALE_RESULT/重复 ref/失败重试矩阵与 CLI 冒烟归档
    - 2026-10-20 目录标注为 A1/A2 之前的历史语义
    - 边界：firmware 主机规则测试缺 host gcc；cop_job.hex/dis 待 JL 按 A2 重建
2026-10-21 docs(coprocessor): archive board-gate checkpoint
2026-10-21 docs(coprocessor): 按模块补 board-gate 收尾协作记录
2026-10-22 fix(coprocessor): 修复 Vivado XDC 条件语句
2026-10-22 fix(coprocessor): 推断实体同步 BRAM
2026-10-22 docs(coprocessor): 记录 40MHz OOC 门禁证据
2026-10-22 docs(coprocessor): 存档 OOC 门禁与板顶阻塞
2026-10-22 docs(coprocessor): checkpoint board-top phase one
2026-10-22 fix(coprocessor): bank sixteen ROI activation slots
2026-10-22 docs(coprocessor): archive board-top gate status
2026-10-22 fix(coprocessor): repair PYNQ block design wiring
2026-10-22 fix(coprocessor): reset AXI-Lite CDC payload chain
2026-10-22 fix(coprocessor): PYNQ MMIO 相对 offset 与只读板上预检
    - PynqMmio 不再二次加 base：PYNQ MMIO.read/write 已带 base，base 仅作 Address Editor 校验
    - 新增 probe()/CopDriver.probe() 只读 ID/version/status/error_code/result_seq
    - 新增 cop_board_preflight.py：板上只读预检，无 pynq 时退出 2，不碰 DMA
    - test_pynq_transport_round：4 KiB 窗口假 MMIO + 基址翻译跑通一笔提交/消费
    - 文档补 K4/K5 链接与 board-gate 状态；数据面仍不声称已接
2026-10-22 test(evidence): board-gate 同步、固件 E2E 与 PynqMmio 接缝归档
    - firmware_e2e PASS：CPU/固件/MMIO START-ACCEPTED-终态-结果-CONSUME，J02 zero=2/2/258/1
    - decision_ab T1-T7、cop_top、bram_network(K3-LATENCY) exit 0；inspection 19/vision 21 exit 0
    - PynqMmio 相对 offset/只读预检证据；无 pynq 时预检退出 2
    - 边界：无 Vivado/bitstream/板；firmware 主机规则测试缺 host gcc；数据面未实现
2026-10-22 fix(coprocessor): package gated board artifacts
2026-10-22 docs(coprocessor): 按模块补 board-top 整机门禁/CDC/NC 协作记录
2026-10-22 docs(coprocessor): board-top 同步与 Windows 复现性缺口
    - 记录整机 40MHz 门禁 PASS、bit/hwh/NC 包状态（板级仍 UNVERIFIED）
    - 登记 manifest v1/PROVISIONAL、OPEN-BT-4 恒等映射与板上交付到 PS 待办
    - 登记 Windows Icarus 缺口：manifest CRLF/sidecar、cop_axi_lite_cdc 先用后声明；未改 JL 文件
    - board-top 复跑日志/哈希对比归档在 data/logs/2026-10-22-board-top-sync/
2026-10-22 test(evidence): board-top 整机门禁同步与 Windows/Icarus 缺口归档
    - WC 19/21 门禁 exit 0；JL payload_adapter/activation_storage/axis_fifo_random/firmware_e2e PASS
    - manifest_v1/payload_network FAIL：Windows manifest CRLF 212 处 vs sidecar LF 哈希
    - pynq_top/axi_lite_cdc FAIL：Icarus 13 w_ack/r_ack 先用后声明（Vivado 不受影响）
    - 原始日志/退出码/哈希对比/建议修复；未修改 JL 的 RTL/生成器
2026-10-23 docs(coprocessor): pin rebuilt gate artifacts
2026-10-23 docs(coprocessor): 补跨平台门禁输入与 NC 重打包协作记录
2026-10-23 test(evidence): board bring-up BLOCKED（交接包/板卡均未就绪）
    - 包 dist/cop-board-gate-21c4e751bbe8.tar.gz 与 .sha256 不存在；远端可见 dev/riscv=7c6cc40
    - 无 192.168.50.x/板卡、无 Xilinx/Digilent JTAG/hw_server；Vivado 2026.1 已装但 program_soc.bat 默认路径不符
    - 未校验/未解包/未烧写/未预检/未推理；不伪造 STATUS/ERROR_CODE/SEQ/class/score/logits/温度
    - 恢复条件、命令与记录模板已写入 data/logs/2026-10-23-board-bringup/README.md
2026-10-23 test(evidence): 跨平台门禁修复复验 8/8，更新板上阻塞记录
    - JL 23e8aef：manifest write_bytes + CDC 声明前移；8/8 board-top 模式 exit 0
    - WC inspection 19/vision 21 exit 0；包源 21c4e75 与交接 bit/tar 哈希一致
    - 本机仍无交接 tar/板卡；BLOCKED 记录补硬件清单与恢复顺序
    - 上轮两个 Windows/Icarus 缺口关闭
2026-10-23 test(evidence): 板卡/串口/JTAG 就绪，交接包仍缺
    - COM4 xilinx@pynq：Linux 6.6.10、PYNQ 3.1、XADC 空载约 62.4-62.8C
    - Vivado hw_server 只读检测到 arm_dap_0 + xc7z020_1；当前 PL 为旧 base.bin
    - 板上无 cop bit/hwh/包；仍无 STATUS/ERROR_CODE/推理数据
    - 新增 sim/scripts/serial_board.ps1（无网口 fallback）；未烧写
2026-10-23 test(evidence): 首次上板：包/烧写/只读预检通过；FCLK/loader 阻塞
    - tar d74189…/106/106、bit 7e1e34…、hwh cba4d1… 全验；JTAG PROGRAM PASSED 两次
    - 只读预检：IP_ID=0x434F5030、STATUS=0x1、ERROR_CODE=0、RESULT_SEQ=0、无 UNCONSUMED
    - 阻塞：板卡 FCLK1=142.857MHz（设计 40MHz）；包内无 payload/ROI loader；无 pattern/zero 推理
    - 首次烧写后未复位读 AXI 挂起；xsdb rst -system 恢复；首读 STATUS 偶发 0x0 已记录
2026-10-24 docs(coprocessor): add board clock and loader runbooks
2026-10-24 docs(coprocessor): archive board runtime blockers
2026-10-24 feat(tools): 保存逐帧 UVC 证据并归档 NC 相机诊断
    - 增加逐帧无损取证、SSH 完成状态保护与有界相机诊断入口
    - 将 348 个原始取证文件压缩为三个带 SHA256 清单的归档，保留失败边界
    - 归档完整回归原始输出、405 个源文件指纹和理解门槛 3/3 问答
    验证：run_iverilog.sh all exit 0（172 PASS、9 项预期失败文本、0 未预期失败）；检查链 19 组、视觉 Python 21 组、SSH 2 项通过；索引/卫生/差异检查通过。
    边界：BOARD=UNVERIFIED；正式模型、PS loader、真实相机恢复和整机硬件推理验收未完成；既有仓库预算债未消除。
    AI Prompt 要点：看看有没有需要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
2026-10-24 fix(coprocessor): widen DMA direct length gate
2026-10-24 docs(coprocessor): archive board rework round one
2026-10-25 docs(coprocessor): 补上板预检/loader、DMA16 与干净门禁包记录
2026-10-25 test(evidence): DMA16+驻留固件合并复验 6/6；tools 入根白名单
    - 合并 origin/dev/riscv 0aecf97（DMA16/驻留固件/loader/干净门禁包记录）
    - firmware_e2e/decision_ab/pynq_top/manifest_v1/payload_network/bram_network 均 exit 0
    - 旧包 21c4e751bbe8 已作废（DMA-14/一次性固件）；当前有效包 759744b99891
    - 卫生检查根目录白名单加 tools/（JL 新增 loader 目录）
2026-10-25 test(evidence): DMA16 上板——40MHz 时钟门禁 PASS；NO_ACK 根因=CPU 未执行固件
    - 新包 759744b99891：tar/111 文件全验；8 个 loader 依赖文件串口上板，板上 sha256 与包一致（含 4MB bit）
    - 时钟门禁：measured_fclk1_mhz=40.000000 + 20 次首读 0x1；前提=改钟后必须重配 PL（旧 cop 域全 0x0，超频假设被否）
    - NO_ACK：配置/DMA 全 GO 但 ACCEPTED 不到；fresh 下载后 6.5s FW_DECISION 恒 0（guard 必超时）→ CPU 未执行固件
    - 最可能 IMEM readmemh 相对路径在 Vivado 综合未命中；交 JL，含修复建议
    - 工具：serial_send_v2（cat+Ctrl+D 防 tty 溢出）；serial_recover/ctrlc；bootprobe
2026-10-26 test(coprocessor): cover board reload guards
2026-10-26 test(coprocessor): wire IMEM gate into regressions
2026-10-26 docs(coprocessor): correct board clock recovery flow
2026-10-26 fix(coprocessor): enforce exact board preflight evidence
2026-10-26 feat(coprocessor): summarize NC board-run evidence
2026-10-26 test(coprocessor): gate board-run summaries
2026-10-26 docs(coprocessor): close J07 and package ledgers
2026-10-26 fix(coprocessor): edge-detect PS DMA start; harden IMEM gate python env; archive edge build evidence
2026-10-26 docs: correct cold-boot clock sequence; record board mmc blocker
2026-10-26 docs: record 2026-10-26 final status and board blocker
2026-10-27 fix(coprocessor): stabilize CDC and preserve multi-target result slots
    Keep payload stable ahead of three-stage control synchronization, hold the result slot through the synchronous write, and let firmware process successive configurations. Add reproducing CDC, three-target and two-job tests. AI-assisted; user requested fast integration and deferred comprehension review.
2026-10-27 feat(build): integrate raw HDMI capture with the MMCM coprocessor
    Pin PS address windows, bound CDC payload paths and distinguish raw_capture pruning from the full vision CDC profile. Resume routed checkpoints into fresh output directories with exact IMEM checks. Multitarget repaired bit remains unverified after a Vivado child-process startup failure. AI-assisted consolidation requested by user.
2026-10-27 feat(tools): bind board loading and payload packages to HWH topology
    Verify MMCM input clocks before MMIO, reject reused package directories and retain hashes. Add permanent board diagnostics, payload export, SSH transfer and same-ROI integer comparison. Replace the unsafe legacy clock assumption with explicit matching-HWH validation. AI-assisted consolidation requested by user.
2026-10-27 feat(pynq): connect raw capture and hardware inference to the LIVE API
    Commit configuration before DMA, reload the model after validity is cleared, and wait for the matching firmware decision. Record actual COP_HW provenance and support local background compensation. Recognition quality, the repaired multi-target bit and manual EXE/CSV acceptance remain pending. AI-assisted; user deferred training and requested integration.
2026-10-27 fix(board): order vision startup after stock PL initialization
    Back up cron configuration, remove competing overlay/server startup jobs and retain the IP setup. Load vision in a systemd dependency chain and wait for one outstanding configuration to reach a frame boundary. AI-assisted repair with recorded reboot evidence.
2026-10-27 docs(integration): archive PYNQ recovery evidence and acceptance boundaries
    Record concurrent-agent audit, startup recovery, standalone and coexistence measurements, the reproduced multi-target failure, and EXE connection evidence. Keep model accuracy, repaired-bit deployment, manual button and CSV checks pending. Ignore generated board packages; preserve local probes. User explicitly requested split commits, PR merge and active-branch synchronization; comprehension questions remain deferred under fast mode.
2026-10-27 docs(coprocessor): invalidate pre-merge board packages
2026-10-27 test(coprocessor): pin commit-state cycle cost
2026-10-27 docs(coprocessor): 补 J07 工具、IMEM/DMA、PYNQ 集成与 A 变体记录
2026-10-27 docs(poster): add A1 display poster prototype
2026-10-27 test(board): validate 2fc2bdd4 zero/pattern and archive clock/preflight evidence
2026-10-27 docs(exe-web-hud): add EXE HUD v4 web prototype (single-file HTML)
2026-10-27 fix(docs): 对齐协处理器状态描述与 main@cfbded8 证据
    - src/coprocessor/README.md：J04b OPEN 改为描述表/结果 DMA/深测收尾/板验；影子 bank 与生产板顶已落地（payload_network TB 入 all）；SoC 集成已过 40MHz 整机综合实现门禁（板验未完成）
    - docs/runbooks/coprocessor-j04-handoff.md：J04b 口径、未验证矩阵整机行、OPEN-1 标注部分关闭、§8 收尾清单对齐
    - docs/closeout-todo.md：基线分支改 main@cfbded8（PR #86-#89 已合并）；协处理器状态/OPEN 台账/板卡受阻行对齐；B04 补 firmware_e2e 行为验证事实；B06 整机门禁事实
    依据 main@cfbded8 的证据：src/coprocessor/plan.md L21/L45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
2026-10-27 docs: 统一交接索引三态口径与历史时点标注
    - docs/contracts/coprocessor-handoff-v0.md：当前状态 J04b 口径对齐模块计划；af53fe2 条目加历史时点限定；J07/J08 与 NC 对接边界改为三态（综合实现门禁 PASS / 板上 UNVERIFIED）；下一门槛更新
    - docs/coprocessor-board-clock-runbook.md：新源码尚待重跑改为已随 2026-10-26 复跑整机门禁 PASS（edge-fix bit 9341F7FA…，WNS +3.062 ns），保持 BOARD UNVERIFIED
    依据 main@cfbded8 的证据：docs/coprocessor-vivado-checklist.md 2026-10-26 段、docs/coprocessor-nc-handoff.md 三态表、data/logs/2026-10-26-build/README.md。未包含 dev/riscv 独有内容。
2026-10-27 fix(exe-web-hud): make toggle switches clickable; archive review shots
2026-10-27 docs: 归档收尾审计/项目简介/海报溯源并补协作记录
2026-10-27 chore(repo): retire YOLO experiments to local-only
    User confirmed the FPGA-compatible CNN as the only line. Untrack the YOLO training entry, probe results and reference JSON, ignore local YOLO paths, and drop the YOLO engine from the mixed evaluators. Original files stay on disk; the handoff doc records the historical 48/48 scope.
2026-10-27 fix(sim): harden UVC device decoding and board-round comparison
    capture_uvc_raw decodes PowerShell output as UTF-8 with GBK fallback; compare_cop_rois gains a reference-package mode, checks valid/error flags per ROI and fails closed on any hardware/integer mismatch.
2026-10-27 feat(sim): add real-ROI CNN training and quantization CLI
    Collect/calibrate/fine-tune/quantize entry points for the real captured ROIs, plus board-vector preparation and scene-model checkers used to produce the r6 package.
2026-10-27 docs(plan): record 10-27/10-28 board recovery and CNN r6 status
    plan.md gains the multitarget r6 board validation, holdout and mixed-layout outcomes and the YOLO retirement decision; the coexist handoff and the morning runbook are updated accordingly.
2026-10-27 chore(build): archive board probe and one-shot scripts
    Probe/one-shot shell and Tcl entry points used during the 10-26/10-27 board recovery sessions, plus the Vivado project-init probe.
2026-10-27 docs(evidence): archive 10-26/10-27 board recovery and real-data rounds
    Camera enumeration, gate rebuild logs, trained payload vectors, fresh board start, product coexist EXE rounds, real-data layouts, reboard status, startup clock repair and the real-ROI adapt evidence.
2026-10-27 docs(evidence): archive CNN r6 training and multitarget board validation
    CNN r6 package, washer collection and standing-nut diagnostics, mixed standing layout, the 12-round multitarget board validation, holdout layout04 and the 10-28 sync self-test outputs.
2026-10-28 refactor(frontend): 移除 EXE 形态，前端定为 HTML 网页端并全仓文档清理
    - 删除 src/vision_client/、构建脚本与 5 个客户端测试（源码备份于仓库外本地）
    - rounds/records/export_records 移入 src/pynq_host/；字体随 src/web_client 自持
    - 网页端定名 src/web_client（官方骨架 src=设计源码），评审截图入 data/evidence
    - README/plan 等全仓口径改网页端；删除排期/分工/看板等管理性内容（plan.md 瘦身）
    - 文档清理：死链清零、状态滞后修正、10 篇历史横幅、closeout-todo 收敛到 10-28
    - 本地产物归入 gitignore 的 others/（刷板包路径变为 others/build/board-package-*）
    - 验证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
2026-10-29 docs: 收编工作区遗留收尾（模块 plan.md 移出、引用同步）— 另一会话 2026-10-28/29 成果，经 owner 批准单独基线化
2026-10-29 chore(submission): trim judge-facing repo for competition submission
    - 删除 4003 个过程产物文件（data/logs 非引用会话、evidence 未外包包、docs 过程文档、build 一次性探针、sim 运维脚本、src v0 遗留/plan.js、ISSUE 模板）
    - 复活被冻结契约/收口报告/board 存证引用的目标（6 runbook+2 research+2 archive+11 log 会话）
    - 断链 76→0：引用方以 git 历史指针收口，docs/README.md 与 project-map.md 重写
    - index_runs 重建 logs/evidence 索引；check_repo_hygiene PASS 0 ERROR；diff --check 干净
    - 删除集完整备份 others/submission-slim-backup-20261029.tar.gz（gitignore）
    - 新增 llm_log 2026-10-29-submission-slim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
2026-10-29 refactor(coprocessor): 退役逐步构建诊断原语组，砍未例化 MAC/requant 变体
    - 删除 mac_lane/dot8/int8_mac/mac_array/int8_requant 五件及 tb（不在出厂链路，仅单测引用）
    - 冻结契约 design_v0.md §4.4 改历史演进记录：首步语义由 pipeline 变体承载，源码见 git 历史
    - README 同步计算链描述；run_iverilog/run_coprocessor_iverilog 双驱动删 8 个入口与 usage
    - 门禁：run_coprocessor_iverilog.sh all 全绿（MMCM/payload/固件/整网黄金/TRW），run_coprocessor_python.sh all 全绿
    - 经 owner 确认（用户选择「连契约一起改」），MOCK 服务保留
2026-10-29 docs(runbook): pi-dev-roles R1 组包脚本与基线包改 git 历史指针（10-29 瘦身后口径）
2026-10-29 fix(evidence): 恢复 arm-localize 最小回归依赖（two_targets.json 439B + 组包脚本 + 武装 runbook + 目录 README）
    - 瘦身连根砍误伤了 test_arm_localize/test_arm_localize_package 两个回归组的依赖
    - 精确最小集恢复：fixture、make_arm_localize_pkg.py、arm-localize-runbook.md；45M 原始大包不动（tar 备份+git 历史双在线）
    - 复跑 vision python 全 20 组 exit 0 全绿；hygiene PASS
2026-10-29 chore(index): index_runs 重建 evidence 索引（恢复 arm-localize 最小子集后）
2026-10-29 docs(llm_log): 补记 PR B 裁决、fixture 折返教训与最终门禁
2026-10-30 fix(submission): restore reproducible inputs and trim redundant tooling
    Restore the two firmware C sources, the frozen r3 initialization checkpoint,
    and nine training ROIs needed to reproduce r6. Consolidate package/OOC
    entry points, remove one-shot diagnostics, a mutation meta-test and the HOG
    branch, deduplicate numbered images, and align current documentation.
    Validation: baseline full all exit 0; post-change cop RTL all plus Python
    19/17/10 groups pass; seven rebuilt firmware images match word-for-word;
    r6 retraining tensors and quantized payload match the frozen originals;
    package preflight, snapshot recovery, hygiene and diff checks pass.
    No RTL, accepted image or interface semantics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
2026-11-03 feat(web): apply user-entered work orders before inspection
    Remove the product service default order and block checks until configured. Add web count inputs, matching order/config ACK validation, draft preservation, automatic-check gating, and synchronized engine/driver updates. Keep firmware CFG_APPLIED checks on each job.
    Validation: offboard software suite exits 0; 21 Node tests pass; HTTP/CopSim order transition and failed-ACK checks pass. Real PYNQ deployment has no preset order, valid C01/COP_HW health, and rejects an unconfigured check with HTTP 400. USB capture reads 24 real 720p frames. User-applied real rounds and continuous stability remain pending.
    AI prompt: continue final boa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
2026-11-03 fix(cop): fence stale MODEL_VALID before DMA commit; add local-fast path
    - cop_driver: publish a guard ROI_COUNT whose byte count cannot match the
    previous DMA_BYTES, wait for STATUS_MODEL_VALID to clear, then commit the
    real descriptors. A stale valid bit can no longer launch the new job with
    the old plane. _commit_config() split out for the two-phase sequence.
    - localization: local-fast background (1/8 area resize, 15px median) plus a
    byte absdiff + square-LUT distance, cutting full-frame int16/float work on
    the Cortex-A9. Parity with local holds on the r6 holdout frame
    (9 boxes, 9 TP, mean IoU > 0.97).
    - cop_product_service / vision_live_service: capture_round() hands the
    de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
